gefgu/integration-workshop-3/docs/bench-protocol.md

# Protocolo app do professor ⇄ bancada

Este protocolo define como o app do professor no celular conversa com a bancada.
Ele cobre os requisitos SFR41, SFR43, SFR44, SFR45, SFR56, SFR57, SFR59 e SNFR8.

O código fica em dois lugares, com o mesmo enquadramento e as mesmas mensagens:

- [`protocol/bench.ts`](../protocol/bench.ts), em TypeScript, usado pelo app e pela UI da bancada.
- [`bench/service/protocol.py`](../bench/service/protocol.py), em Python, usado pelo serviço da bancada.

## Transportes

| Transporte | Onde | Status |
|---|---|---|
| **BLE GATT**: serviço `7e1d0001-7ed7-4b1c-9a6e-0c1e5f7a0000` | Bancada real (Raspberry Pi, BlueZ) | Pronto: periférico em [`bench_service/ble.py`](../bench/service/bench_service/ble.py) com `bless`; cliente no app com `react-native-ble-plx` (build de desenvolvimento). |
| **WebSocket** `ws://<bancada>:8765/ble` | Bancada simulada (`bench/service`) | Pronto. Usado no Expo Go e nos testes. |

As características do serviço GATT são estas:

| Característica | UUID | Direção | Propriedade |
|---|---|---|---|
| RX | `7e1d0002-…` | app → bancada | write (com resposta) |
| TX | `7e1d0003-…` | bancada → app | notify |

O nome anunciado é `TedTronics-<bench_id>`, e o anúncio traz o UUID do serviço (o app filtra a busca por ele).
Mantenha o `bench_id` curto (até ~18 caracteres): o nome vai na resposta de varredura, que tem 31 bytes.

Para ligar o BLE junto com o HTTP/WebSocket, no Raspberry Pi:

```
pip install -e '.[ble]'
python -m bench_service --db bench.sqlite3 --ble [--adapter hci0]
```

Os dois transportes rodam no mesmo processo e usam o mesmo `BenchStore`. Um `HELLO` por Bluetooth libera a tela da bancada, e os eventos são os mesmos nos dois caminhos.
Se o adaptador ou o BlueZ falharem, o serviço inteiro para com o erro, em vez de ficar no ar sem Bluetooth.

## Câmera (visão computacional)

O serviço também lê a placa pela câmera com o pacote [`visao/`](../visao/README.md) da Julia. A visão roda numa thread do próprio serviço, a 5 quadros por segundo:

```
pip install -e '.[vision]'
python -m bench_service --db bench.sqlite3 --camera 0            # câmera real
python -m bench_service --db bench.sqlite3 --vision-image foto.jpg  # demonstração com uma foto
```

| Rota | O que devolve |
|---|---|
| `GET /vision/state` | `available`, `valid`/`reason` (último quadro aproveitado ou por que foi descartado), `version` (sobe quando o circuito estável muda), `pieces` no formato de peças das lições e `unknown` (peças que a lição não consegue usar, com o motivo). |
| `GET /vision/frame.jpg` | O quadro da câmera com o desenho de depuração da visão (grade encontrada e peças lidas). |
| `POST /vision/recalibrate` | Recalibra a grade do zero. |

Com a visão ligada, a tela da bancada usa a placa real: o tabuleiro da lição mostra o que a câmera vê, sem a bandeja de peças, e cada mudança é validada como antes.
A tela **Câmera** mostra o quadro anotado e a lista de peças. Sem a visão, ela volta para a prévia da câmera do navegador.

A conversão da visão para as peças das lições fica em [`bench_service/vision.py`](../bench/service/bench_service/vision.py) (`to_pieces`). Limitações atuais:
- o resistor vira `resistor_220`, porque a câmera não lê o valor. Passos que conferem valores não passam;
- a peça vermelha de 2 furos vira a bateria, com o `+` na coluna da esquerda, porque a câmera não lê a polaridade;
- `led_ou_buzzer`, `resistor_ou_capacitor`, o potenciômetro de 3 furos e cores desconhecidas ficam em `unknown`.

## Quadros

Uma mensagem JSON pode passar do MTU. Por isso ela é dividida em quadros de texto ASCII:

```
<msgId>|<índice>|<total>|<fatia do JSON>
```

O JSON é serializado só com ASCII: todo caractere fora do ASCII vira `\uXXXX` (`ensure_ascii=True` no Python, `asciiJson()` no TypeScript).
Assim um caractere é um byte, e cada quadro carrega até 150 caracteres do JSON, o que cabe num MTU de 185 bytes (182 bytes úteis) junto com o cabeçalho.
Sem isso, um texto com acentos passaria de 182 bytes: a notificação seria cortada, e a escrita viraria uma escrita longa, que o `bless` não remonta.

No BLE, cada quadro do app é uma escrita com resposta na RX. A bancada responde com uma notificação na TX por quadro, na ordem.
O app pede MTU 185 ao conectar (`requestMTU`, no Android).
O WebSocket usa exatamente os mesmos quadros, então a demo exercita o mesmo código do BLE.
O receptor remonta a mensagem pelo `msgId`, e quadros de mensagens diferentes podem chegar intercalados.

## Mensagens

Toda mensagem do app traz um `id`. A resposta da bancada repete esse valor em `re`.

| App → bancada | Resposta | O que faz |
|---|---|---|
| `HELLO {token, protocol}` | `WELCOME {...status}` ou `ERROR bad_token` | O `token` vem de `POST /bench/session`: um HMAC assinado pelo servidor com o segredo compartilhado `TEDTRONICS_BENCH_SECRET`. A bancada confere a assinatura e a validade **offline**. Se estiver tudo certo, desbloqueia a sessão (SFR43, SFR57). |
| `STATUS` | `STATUS {...}` | Devolve `bench_id`, se a bancada está desbloqueada, o pacote carregado e quantos eventos estão pendentes. |
| `LOAD_PACKAGE {package}` | `PACKAGE_OK {version_id}` | Recebe o pacote de `GET /bench/package/{módulo}?class_id=`: módulo, documentos das lições com `lessonVersion` e alunos com tag. O pacote novo substitui o anterior. Sessões já abertas continuam na versão em que começaram (SFR58). |
| `PULL_EVENTS {max, after_seq?}` | `EVENTS {events, remaining}` | Devolve até `max` eventos pendentes com `seq > after_seq`, em ordem de `seq` (SFR44). Para paginar, o app envia como `after_seq` o `seq` do último evento recebido. |
| `ACK_EVENTS {event_ids}` | `ACKED {deleted, pending_events}` | A bancada apaga os eventos que o servidor já confirmou. |

Qualquer mensagem que não seja `HELLO`, enviada antes de um `HELLO` válido, recebe `ERROR locked`.

## Evento

```json
{"event_id": "uuid", "student_id": 3, "nfc_code": "TAG-1", "kind": "step_done",
 "seq": 17, "at": "2026-10-20T13:02:11Z", "lesson_id": "l1", "module_id": 2,
 "lesson_version": "a1b2…", "step_idx": 3, "score": null, "duration_s": null}
```

`kind` pode ser um destes valores:

| `kind` | Quando acontece |
|---|---|
| `session` | O aluno saiu. Traz `duration_s`. |
| `step_done` | Um passo foi concluído. |
| `lesson_done` | A lição foi concluída. Traz `duration_s`. |
| `quiz_answer` | O aluno respondeu um quiz. |
| `challenge_score` | O desafio terminou. Traz `score` e `duration_s`. |

Todo evento leva `student_id` **e** `nfc_code` juntos, nunca só a tag (SNFR8).

## Ciclo de sincronização

1. No app, o professor faz login. O app chama `POST /bench/session` e recebe o token da bancada.
2. O app conecta na bancada e envia `HELLO`. A bancada se desbloqueia.
3. O app envia `PULL_EVENTS` e guarda os eventos recebidos na fila local.
4. Com internet, o app envia a fila para `POST /bench/sync`. O servidor responde `acked`.
5. O app envia `ACK_EVENTS` com os ids confirmados. A bancada apaga esses eventos.
6. Sem internet, a fila fica marcada como "pendente" e o app tenta de novo quando a rede voltar (SFR45, SNFR9).
   A bancada só apaga um evento depois do `ACK_EVENTS`. Se a conexão cair no meio, o pior que acontece é reenviar eventos, e o servidor descarta as duplicatas pelo `event_id` (SFR59).
7. Se quiser, o professor escolhe um módulo e uma turma, e o app envia `LOAD_PACKAGE`.

## Physical controls on the bench screen

The student never touches the 7" screen: they build on the real protoboard (read by the camera, see above) and use
the bench's physical controls: an analog joystick (KY-023) and an Energizar push button, both on an ESP32 that talks
to the Pi over the GPIO serial port (`/dev/serial0`, 115200 8N1). The firmware is
[`firmware/esp32/bench_controls`](../firmware/esp32/bench_controls/README.md); the bench service reads the port
(`--controls /dev/serial0`, `bench_service/controls.py`) and pushes each press to the screen on
`ws://<bench>:8765/controls`, where it is replayed as a key press:

The screen is played like a game console (`teacher_authoring_app/src/bench/pad.ts`): each control is tagged
with what it means (`data-pad="item" | "next" | "back" | "step-back" | "energize"`), and the joystick acts on that
meaning instead of walking through every button. Screens only show Voltar, Próximo/Continuar, Pular and their
choices; sound, help, ranking, camera and leaving live in a game menu.

| Physical control | Serial line | Key | What it does on screen |
|---|---|---|---|
| Joystick right / up | `KEY <id> RIGHT` / `UP` | `ArrowRight` / `ArrowUp` | Forward: next step, or the next choice in a list |
| Joystick left / down | `KEY <id> LEFT` / `DOWN` | `ArrowLeft` / `ArrowDown` | Back: previous step (left also leaves the screen), or the previous choice |
| Joystick click | `KEY <id> OK` | Space | Confirm the selected choice (inside a lesson only the quiz uses it) |
| Joystick click held 0.8 s | `KEY <id> MENU` | `Escape` | Open / close the game menu (sound, help, ranking, camera, leave) |
| Energizar button | `KEY <id> ENERGIZAR` | `Enter` | Power the board on or off; for now the PC keyboard's Enter |

The Pi answers every `KEY` with `ACK <id>` and checks the link with `PING <n>` / `PONG <n>` every 2 s. A keyboard
still works the same way, so the screen can be tested without the hardware (`POST /dev/controls/<name>` in demo mode
simulates a serial line).

With the camera on, the lesson board only mirrors the real board (no dragging) and the tray lists the parts the
current step asks for; the other parts are greyed out. Without a camera the board falls back to on-screen dragging
(demo mode).
