gefgu/integration-workshop-3/docs/Budget.md

# BOM 💵

Bill of materials for TedTronics. Prices in BRL.

# Budget — Workshop 3

## Items

| Item | Quantity | Unit Price (R$) | Total Price (R$) | Description | Link |
| :--- | :---: | ---: | ---: | :--- | :--- |
| PLA 3D Prints | 2 | 75.00 | 150.00 | Material used to manufacture the modules, supports, and structural parts of the bench. | In-house fabrication |
| Raspberry Pi 3B | 1 | 136.87 | 136.87 | Main computer of the bench, responsible for the interface, processing, and execution of the system applications. | [AliExpress](https://pt.aliexpress.com/item/32947198819.html) |
| ESP32 38-Pin | 1 | 10.13 | 10.13 | Microcontroller responsible for controlling the switching matrix and communicating with the electronic circuits. | [AliExpress](https://pt.aliexpress.com/item/1005006984793820.html) |
| 7-Inch Display | 1 | 157.34 | 157.34 | Display used to show lessons, challenges, simulations, and information from the virtual tutor. | [AliExpress](https://pt.aliexpress.com/item/1005007432461342.html) |
| 1080p Webcam | 1 | 36.98 | 36.98 | Camera used to capture the student's assembly and enable visual identification of components and connections. | [Mercado Livre](https://www.mercadolivre.com.br/webcam-camera-full-hd-zoom-1080p-360-graus-videoconferencia-streamcam-web-cam-entrada-usb-20-com-microfone-goodvision/p/MLB46220824) |
| Push Buttons | 2 | 8.44 | 16.88 | Physical buttons used in the bench control interface. | [AliExpress](https://pt.aliexpress.com/item/1005006787416121.html) |
| Joystick | 1 | 8.44 | 8.44 | Navigation device used by the student to interact with the bench interface. | [AliExpress](https://pt.aliexpress.com/item/1005008093342854.html) |
| CH446Q | 5 | 7.83 | 39.15 | Analog switch matrix used to electronically create connections between the bench nodes. | [AliExpress](https://pt.aliexpress.com/item/1005009485681569.html) |
| Mini 3 W Speaker SP-301BK | 1 | 31.90 | Audio output used by the virtual tutor and the bench interface. | [Kalunga](https://www.kalunga.com.br/prod/caixa-de-som-3w-mini-sp-301bk-3040206201-c3tech-cx-1-un/145898) |
| PCB | 2 | 200.00 | 400.00 | Printed circuit boards for the bench contacts and for the electronic control and routing system. | - |
| Real Electronic Components | 1 | 50.00 | 50.00 | Set of LEDs, capacitors, buttons, buzzers, resistors, and other components used in the educational modules. | - |
| LM2596 Step-Down Voltage Regulator Module | 1 | 8.90 | 8.90 | Converter responsible for reducing 12 V to 5 V for the educational circuit. | [Eletrogate](https://www.eletrogate.com/modulo-regulador-de-tensao-step-down-lm2596) |
| MF-R050 Polyfuse | 1 | 1.26 | 1.26 | Resettable fuse used to protect the board against overcurrent. | [Mouser](https://br.mouser.com/pt/ProductDetail/Bourns/MF-R050?qs=A6omU7D3gEWzJRzbTsuTwA%3D%3D) |
| SS34 Schottky Diode | 1 | 9.60 | 9.60 | Diode used to protect the power input against reverse polarity. | [Mercado Livre](https://www.mercadolivre.com.br/10x-diodo-schottky-ss34-s4-14-smd-3amp-40v-smc-do214ab/p/MLB2062650491) |
| 100 nF Capacitor | 3 | 0.13 | 0.39 | Decoupling capacitors placed near integrated circuits to reduce power-supply noise. | [Baú da Eletrônica](https://www.baudaeletronica.com.br/produto/capacitor-ceramico-100nf-50v.html) |
| 1 µF Capacitor | 3 | 0.17 | 0.51 | Capacitors used for local filtering of the integrated circuits' power supply. | [Proesi](https://www.proesi.com.br/capacitor-ceramico-1uf-50v-0805-smd) |
| 100 µF / 25 V Capacitor | 1 | 0.20 | 0.20 | Capacitor used for main filtering of the 12 V power input. | [Baú da Eletrônica](https://www.baudaeletronica.com.br/produto/capacitor-eletrolitico-100uf-25v-105c.html) |
| 12 V Power Supply | 1 | 7.33 | 7.33 | Power supply used to power the CH446Q chips and the educational circuit power stage. | [Mercado Livre](https://www.mercadolivre.com.br/fonte-de-fita-led-alimentacao-2a-12v-bivolt/p/MLB2071189997) |
| DC-005 Female P4 Jack Connector | 1 | 0.60 | 0.60 | Input connector used to connect the external 12 V power supply to the electronic board. | [Eletrogate](https://www.eletrogate.com/conector-jack-p4-femea-j4-21mm) |
| **Total** |  |  | **1,066.48** |  |  |

---

## Budget Summary

| Metric | Amount (R$) |
| :--- | ---: |
| **Total Expenses** | **1,066.48** |
| **Available Budget** | **1,200.00** |
| **Remaining Available Budget** | **133.52** |
| **Maximum Budget** | **1,500.00** |
| **Remaining Margin to Maximum Budget** | **433.52** |
