gefgu/integration-workshop-3/eletronics/perfboard/cp00-first-light.md

# Historical checkpoint filename

New builds follow the [guided sequence](cp00.md) in the [assembly app](tscircuit/README.md). Existing project catalogs retain their old checkpoint meaning; this filename does not migrate their progress.
