gefgu/integration-workshop-3/eletronics/perfboard/cp00.md

# CP00 — First light

**Win:** ESP32 switches the real four-column LED loop.

Build the assigned functional groups in the [assembly app](tscircuit/README.md). Earlier soldered wiring stays fixed. Removable links and top-side kit arrangements may change.

## Link positions

- Prototype source only: positive C2 / ground C1; final supply and matrix disconnected.
- OLED uses ESP1 GPIO4 SDA / GPIO16 SCL at 3.3V. Remove diagnostic probes before ordinary operation.

## Guided actions

1. **Disconnect power and prepare:** Unplug USB and all educational sources before construction. Prototype source only: positive C2 / ground C1; final supply and matrix disconnected. OLED uses ESP1 GPIO4 SDA / GPIO16 SCL at 3.3V. Remove diagnostic probes before ordinary operation.
2. **Identify your hardware:** Confirm ESP32 DevKit model and labelled USB5V/3V3/GND/GPIO32 terminals. Identify the breadboard’s a–e / f–j connected rows and any broken supply rails. Measure actual pogo and adapter fit before permanent soldering.
3. **Place NODE00 — all 6 contacts:** Place every contact in this column at the TOP coordinates listed below. These contacts form one electrical node; keep neighbouring columns isolated.
4. **Inspect J_NODE00:** Power OFF: inspect every terminal, polarity, seating and solder joint. J_NODE00: node00; NODE00 — six contacts. Part of Educational contacts — one node per column. Mount on the top side; red pad identifies pin 1. Actual purchased dimensions must be measured before release.
5. **Place NODE01 — all 6 contacts:** Place every contact in this column at the TOP coordinates listed below. These contacts form one electrical node; keep neighbouring columns isolated.
6. **Inspect J_NODE01:** Power OFF: inspect every terminal, polarity, seating and solder joint. J_NODE01: node01; NODE01 — six contacts. Part of Educational contacts — one node per column. Mount on the top side; red pad identifies pin 1. Actual purchased dimensions must be measured before release.
7. **Place NODE02 — all 6 contacts:** Place every contact in this column at the TOP coordinates listed below. These contacts form one electrical node; keep neighbouring columns isolated.
8. **Inspect J_NODE02:** Power OFF: inspect every terminal, polarity, seating and solder joint. J_NODE02: node02; NODE02 — six contacts. Part of Educational contacts — one node per column. Mount on the top side; red pad identifies pin 1. Actual purchased dimensions must be measured before release.
9. **Place NODE03 — all 6 contacts:** Place every contact in this column at the TOP coordinates listed below. These contacts form one electrical node; keep neighbouring columns isolated.
10. **Inspect J_NODE03:** Power OFF: inspect every terminal, polarity, seating and solder joint. J_NODE03: node03; NODE03 — six contacts. Part of Educational contacts — one node per column. Mount on the top side; red pad identifies pin 1. Actual purchased dimensions must be measured before release.
11. **Place J_NODE:** J_NODE: node; NODE cable → matrix. Part of Capsule OLED service. Mount on the bottom side; red pad identifies pin 1. 
12. **Inspect J_NODE:** Power OFF: inspect every terminal, polarity, seating and solder joint. J_NODE: node; NODE cable → matrix. Part of Capsule OLED service. Mount on the bottom side; red pad identifies pin 1. 
13. **Connect W1 · NODE00:** Educational contact or routing bus; the wire joins only its listed terminals, not crossing wires. Connect J_NODE00.1 → J_NODE00.2. Hole path (4,9) → (4,13). Bare strap joins only this column.
14. **Verify W1 · NODE00:** Power disconnected: Educational contact or routing bus; the wire joins only its listed terminals, not crossing wires. Connect J_NODE00.1 → J_NODE00.2. Hole path (4,9) → (4,13). Bare strap joins only this column. Confirm endpoint continuity (<1Ω for a wire) and no adjacent-net bridge; isolate parallel paths before measuring.
15. **Connect W2 · NODE00:** Educational contact or routing bus; the wire joins only its listed terminals, not crossing wires. Connect J_NODE00.2 → J_NODE00.3. Hole path (4,13) → (4,17). Bare strap joins only this column.
16. **Verify W2 · NODE00:** Power disconnected: Educational contact or routing bus; the wire joins only its listed terminals, not crossing wires. Connect J_NODE00.2 → J_NODE00.3. Hole path (4,13) → (4,17). Bare strap joins only this column. Confirm endpoint continuity (<1Ω for a wire) and no adjacent-net bridge; isolate parallel paths before measuring.
17. **Connect W3 · NODE00:** Educational contact or routing bus; the wire joins only its listed terminals, not crossing wires. Connect J_NODE00.3 → J_NODE00.4. Hole path (4,17) → (4,21). Bare strap joins only this column.
18. **Verify W3 · NODE00:** Power disconnected: Educational contact or routing bus; the wire joins only its listed terminals, not crossing wires. Connect J_NODE00.3 → J_NODE00.4. Hole path (4,17) → (4,21). Bare strap joins only this column. Confirm endpoint continuity (<1Ω for a wire) and no adjacent-net bridge; isolate parallel paths before measuring.
19. **Connect W4 · NODE00:** Educational contact or routing bus; the wire joins only its listed terminals, not crossing wires. Connect J_NODE00.4 → J_NODE00.5. Hole path (4,21) → (4,25). Bare strap joins only this column.
20. **Verify W4 · NODE00:** Power disconnected: Educational contact or routing bus; the wire joins only its listed terminals, not crossing wires. Connect J_NODE00.4 → J_NODE00.5. Hole path (4,21) → (4,25). Bare strap joins only this column. Confirm endpoint continuity (<1Ω for a wire) and no adjacent-net bridge; isolate parallel paths before measuring.
21. **Connect W5 · NODE00:** Educational contact or routing bus; the wire joins only its listed terminals, not crossing wires. Connect J_NODE00.5 → J_NODE00.6. Hole path (4,25) → (4,29). Bare strap joins only this column.
22. **Verify W5 · NODE00:** Power disconnected: Educational contact or routing bus; the wire joins only its listed terminals, not crossing wires. Connect J_NODE00.5 → J_NODE00.6. Hole path (4,25) → (4,29). Bare strap joins only this column. Confirm endpoint continuity (<1Ω for a wire) and no adjacent-net bridge; isolate parallel paths before measuring.
23. **Connect W6 · NODE00:** Educational contact or routing bus; the wire joins only its listed terminals, not crossing wires. Connect J_NODE00.1 → J_NODE.1. Hole path (4,9) → (4,8.5) → (3.5,8.5) → (3.5,33.5) → (3,33.5) → (3,33). Insulate every crossing; solder only the two endpoints.
24. **Verify W6 · NODE00:** Power disconnected: Educational contact or routing bus; the wire joins only its listed terminals, not crossing wires. Connect J_NODE00.1 → J_NODE.1. Hole path (4,9) → (4,8.5) → (3.5,8.5) → (3.5,33.5) → (3,33.5) → (3,33). Insulate every crossing; solder only the two endpoints. Confirm endpoint continuity (<1Ω for a wire) and no adjacent-net bridge; isolate parallel paths before measuring.
25. **Connect W8 · NODE01:** Educational contact or routing bus; the wire joins only its listed terminals, not crossing wires. Connect J_NODE01.1 → J_NODE01.2. Hole path (11,9) → (11,13). Bare strap joins only this column.
26. **Verify W8 · NODE01:** Power disconnected: Educational contact or routing bus; the wire joins only its listed terminals, not crossing wires. Connect J_NODE01.1 → J_NODE01.2. Hole path (11,9) → (11,13). Bare strap joins only this column. Confirm endpoint continuity (<1Ω for a wire) and no adjacent-net bridge; isolate parallel paths before measuring.
27. **Connect W9 · NODE01:** Educational contact or routing bus; the wire joins only its listed terminals, not crossing wires. Connect J_NODE01.2 → J_NODE01.3. Hole path (11,13) → (11,17). Bare strap joins only this column.
28. **Verify W9 · NODE01:** Power disconnected: Educational contact or routing bus; the wire joins only its listed terminals, not crossing wires. Connect J_NODE01.2 → J_NODE01.3. Hole path (11,13) → (11,17). Bare strap joins only this column. Confirm endpoint continuity (<1Ω for a wire) and no adjacent-net bridge; isolate parallel paths before measuring.
29. **Connect W10 · NODE01:** Educational contact or routing bus; the wire joins only its listed terminals, not crossing wires. Connect J_NODE01.3 → J_NODE01.4. Hole path (11,17) → (11,21). Bare strap joins only this column.
30. **Verify W10 · NODE01:** Power disconnected: Educational contact or routing bus; the wire joins only its listed terminals, not crossing wires. Connect J_NODE01.3 → J_NODE01.4. Hole path (11,17) → (11,21). Bare strap joins only this column. Confirm endpoint continuity (<1Ω for a wire) and no adjacent-net bridge; isolate parallel paths before measuring.
31. **Connect W11 · NODE01:** Educational contact or routing bus; the wire joins only its listed terminals, not crossing wires. Connect J_NODE01.4 → J_NODE01.5. Hole path (11,21) → (11,25). Bare strap joins only this column.
32. **Verify W11 · NODE01:** Power disconnected: Educational contact or routing bus; the wire joins only its listed terminals, not crossing wires. Connect J_NODE01.4 → J_NODE01.5. Hole path (11,21) → (11,25). Bare strap joins only this column. Confirm endpoint continuity (<1Ω for a wire) and no adjacent-net bridge; isolate parallel paths before measuring.
33. **Connect W12 · NODE01:** Educational contact or routing bus; the wire joins only its listed terminals, not crossing wires. Connect J_NODE01.5 → J_NODE01.6. Hole path (11,25) → (11,29). Bare strap joins only this column.
34. **Verify W12 · NODE01:** Power disconnected: Educational contact or routing bus; the wire joins only its listed terminals, not crossing wires. Connect J_NODE01.5 → J_NODE01.6. Hole path (11,25) → (11,29). Bare strap joins only this column. Confirm endpoint continuity (<1Ω for a wire) and no adjacent-net bridge; isolate parallel paths before measuring.
35. **Connect W13 · NODE01:** Educational contact or routing bus; the wire joins only its listed terminals, not crossing wires. Connect J_NODE01.1 → J_NODE.3. Hole path (11,9) → (11,8.5) → (8,8.5) → (8,33.5) → (4,33.5) → (4,33). Insulate every crossing; solder only the two endpoints.
36. **Verify W13 · NODE01:** Power disconnected: Educational contact or routing bus; the wire joins only its listed terminals, not crossing wires. Connect J_NODE01.1 → J_NODE.3. Hole path (11,9) → (11,8.5) → (8,8.5) → (8,33.5) → (4,33.5) → (4,33). Insulate every crossing; solder only the two endpoints. Confirm endpoint continuity (<1Ω for a wire) and no adjacent-net bridge; isolate parallel paths before measuring.
37. **Connect W15 · NODE02:** Educational contact or routing bus; the wire joins only its listed terminals, not crossing wires. Connect J_NODE02.1 → J_NODE02.2. Hole path (18,9) → (18,13). Bare strap joins only this column.
38. **Verify W15 · NODE02:** Power disconnected: Educational contact or routing bus; the wire joins only its listed terminals, not crossing wires. Connect J_NODE02.1 → J_NODE02.2. Hole path (18,9) → (18,13). Bare strap joins only this column. Confirm endpoint continuity (<1Ω for a wire) and no adjacent-net bridge; isolate parallel paths before measuring.
39. **Connect W16 · NODE02:** Educational contact or routing bus; the wire joins only its listed terminals, not crossing wires. Connect J_NODE02.2 → J_NODE02.3. Hole path (18,13) → (18,17). Bare strap joins only this column.
40. **Verify W16 · NODE02:** Power disconnected: Educational contact or routing bus; the wire joins only its listed terminals, not crossing wires. Connect J_NODE02.2 → J_NODE02.3. Hole path (18,13) → (18,17). Bare strap joins only this column. Confirm endpoint continuity (<1Ω for a wire) and no adjacent-net bridge; isolate parallel paths before measuring.
41. **Connect W17 · NODE02:** Educational contact or routing bus; the wire joins only its listed terminals, not crossing wires. Connect J_NODE02.3 → J_NODE02.4. Hole path (18,17) → (18,21). Bare strap joins only this column.
42. **Verify W17 · NODE02:** Power disconnected: Educational contact or routing bus; the wire joins only its listed terminals, not crossing wires. Connect J_NODE02.3 → J_NODE02.4. Hole path (18,17) → (18,21). Bare strap joins only this column. Confirm endpoint continuity (<1Ω for a wire) and no adjacent-net bridge; isolate parallel paths before measuring.
43. **Connect W18 · NODE02:** Educational contact or routing bus; the wire joins only its listed terminals, not crossing wires. Connect J_NODE02.4 → J_NODE02.5. Hole path (18,21) → (18,25). Bare strap joins only this column.
44. **Verify W18 · NODE02:** Power disconnected: Educational contact or routing bus; the wire joins only its listed terminals, not crossing wires. Connect J_NODE02.4 → J_NODE02.5. Hole path (18,21) → (18,25). Bare strap joins only this column. Confirm endpoint continuity (<1Ω for a wire) and no adjacent-net bridge; isolate parallel paths before measuring.
45. **Connect W19 · NODE02:** Educational contact or routing bus; the wire joins only its listed terminals, not crossing wires. Connect J_NODE02.5 → J_NODE02.6. Hole path (18,25) → (18,29). Bare strap joins only this column.
46. **Verify W19 · NODE02:** Power disconnected: Educational contact or routing bus; the wire joins only its listed terminals, not crossing wires. Connect J_NODE02.5 → J_NODE02.6. Hole path (18,25) → (18,29). Bare strap joins only this column. Confirm endpoint continuity (<1Ω for a wire) and no adjacent-net bridge; isolate parallel paths before measuring.
47. **Connect W20 · NODE02:** Educational contact or routing bus; the wire joins only its listed terminals, not crossing wires. Connect J_NODE02.1 → J_NODE.5. Hole path (18,9) → (18,8.5) → (12.5,8.5) → (12.5,33.5) → (5,33.5) → (5,33). Insulate every crossing; solder only the two endpoints.
48. **Verify W20 · NODE02:** Power disconnected: Educational contact or routing bus; the wire joins only its listed terminals, not crossing wires. Connect J_NODE02.1 → J_NODE.5. Hole path (18,9) → (18,8.5) → (12.5,8.5) → (12.5,33.5) → (5,33.5) → (5,33). Insulate every crossing; solder only the two endpoints. Confirm endpoint continuity (<1Ω for a wire) and no adjacent-net bridge; isolate parallel paths before measuring.
49. **Connect W22 · NODE03:** Educational contact or routing bus; the wire joins only its listed terminals, not crossing wires. Connect J_NODE03.1 → J_NODE03.2. Hole path (25,9) → (25,13). Bare strap joins only this column.
50. **Verify W22 · NODE03:** Power disconnected: Educational contact or routing bus; the wire joins only its listed terminals, not crossing wires. Connect J_NODE03.1 → J_NODE03.2. Hole path (25,9) → (25,13). Bare strap joins only this column. Confirm endpoint continuity (<1Ω for a wire) and no adjacent-net bridge; isolate parallel paths before measuring.
51. **Connect W23 · NODE03:** Educational contact or routing bus; the wire joins only its listed terminals, not crossing wires. Connect J_NODE03.2 → J_NODE03.3. Hole path (25,13) → (25,17). Bare strap joins only this column.
52. **Verify W23 · NODE03:** Power disconnected: Educational contact or routing bus; the wire joins only its listed terminals, not crossing wires. Connect J_NODE03.2 → J_NODE03.3. Hole path (25,13) → (25,17). Bare strap joins only this column. Confirm endpoint continuity (<1Ω for a wire) and no adjacent-net bridge; isolate parallel paths before measuring.
53. **Connect W24 · NODE03:** Educational contact or routing bus; the wire joins only its listed terminals, not crossing wires. Connect J_NODE03.3 → J_NODE03.4. Hole path (25,17) → (25,21). Bare strap joins only this column.
54. **Verify W24 · NODE03:** Power disconnected: Educational contact or routing bus; the wire joins only its listed terminals, not crossing wires. Connect J_NODE03.3 → J_NODE03.4. Hole path (25,17) → (25,21). Bare strap joins only this column. Confirm endpoint continuity (<1Ω for a wire) and no adjacent-net bridge; isolate parallel paths before measuring.
55. **Connect W25 · NODE03:** Educational contact or routing bus; the wire joins only its listed terminals, not crossing wires. Connect J_NODE03.4 → J_NODE03.5. Hole path (25,21) → (25,25). Bare strap joins only this column.
56. **Verify W25 · NODE03:** Power disconnected: Educational contact or routing bus; the wire joins only its listed terminals, not crossing wires. Connect J_NODE03.4 → J_NODE03.5. Hole path (25,21) → (25,25). Bare strap joins only this column. Confirm endpoint continuity (<1Ω for a wire) and no adjacent-net bridge; isolate parallel paths before measuring.
57. **Connect W26 · NODE03:** Educational contact or routing bus; the wire joins only its listed terminals, not crossing wires. Connect J_NODE03.5 → J_NODE03.6. Hole path (25,25) → (25,29). Bare strap joins only this column.
58. **Verify W26 · NODE03:** Power disconnected: Educational contact or routing bus; the wire joins only its listed terminals, not crossing wires. Connect J_NODE03.5 → J_NODE03.6. Hole path (25,25) → (25,29). Bare strap joins only this column. Confirm endpoint continuity (<1Ω for a wire) and no adjacent-net bridge; isolate parallel paths before measuring.
59. **Connect W27 · NODE03:** Educational contact or routing bus; the wire joins only its listed terminals, not crossing wires. Connect J_NODE03.1 → J_NODE.7. Hole path (25,9) → (25,8.5) → (15.5,8.5) → (15.5,33.5) → (6,33.5) → (6,33). Insulate every crossing; solder only the two endpoints.
60. **Verify W27 · NODE03:** Power disconnected: Educational contact or routing bus; the wire joins only its listed terminals, not crossing wires. Connect J_NODE03.1 → J_NODE.7. Hole path (25,9) → (25,8.5) → (15.5,8.5) → (15.5,33.5) → (6,33.5) → (6,33). Insulate every crossing; solder only the two endpoints. Confirm endpoint continuity (<1Ω for a wire) and no adjacent-net bridge; isolate parallel paths before measuring.
61. **Place U_ESP1:** U_ESP1: esp1; ESP32 DevKitC-38 — router. Part of ESP1 and safe default routing control. Mount on the top side; red pad identifies pin 1. Actual purchased dimensions must be measured before release.
62. **Inspect U_ESP1:** Power OFF: inspect every terminal, polarity, seating and solder joint. U_ESP1: esp1; ESP32 DevKitC-38 — router. Part of ESP1 and safe default routing control. Mount on the top side; red pad identifies pin 1. Actual purchased dimensions must be measured before release.
63. **Place J_FIXTURE:** J_FIXTURE: fixture; manual continuity fixture; ESP1 GPIO4 SDA / GPIO16 SCL / GPIO25 stimulus. Part of ESP1 and safe default routing control. Mount on the top side; red pad identifies pin 1. 
64. **Inspect J_FIXTURE:** Power OFF: inspect every terminal, polarity, seating and solder joint. J_FIXTURE: fixture; manual continuity fixture; ESP1 GPIO4 SDA / GPIO16 SCL / GPIO25 stimulus. Part of ESP1 and safe default routing control. Mount on the top side; red pad identifies pin 1. 
65. **Place J_PROTOTYPE:** J_PROTOTYPE: prototype; USB breadboard prototype; remove before final rail connection. Part of ESP1 and safe default routing control. Mount on the top side; red pad identifies pin 1. 
66. **Inspect J_PROTOTYPE:** Power OFF: inspect every terminal, polarity, seating and solder joint. J_PROTOTYPE: prototype; USB breadboard prototype; remove before final rail connection. Part of ESP1 and safe default routing control. Mount on the top side; red pad identifies pin 1. 
67. **Connect W1 · USB_3V3:** 3.3-V electronics supply. USB and bench supply domains must not be bridged. Connect J_FIXTURE.1 → J_PROTOTYPE.2. Hole path (30,6) → (30,5.5) → (33.5,5.5) → (33.5,6.5) → (38,6.5) → (38,6). Insulate every crossing; solder only the two endpoints.
68. **Verify W1 · USB_3V3:** Power disconnected: 3.3-V electronics supply. USB and bench supply domains must not be bridged. Connect J_FIXTURE.1 → J_PROTOTYPE.2. Hole path (30,6) → (30,5.5) → (33.5,5.5) → (33.5,6.5) → (38,6.5) → (38,6). Insulate every crossing; solder only the two endpoints. Confirm endpoint continuity (<1Ω for a wire) and no adjacent-net bridge; isolate parallel paths before measuring.
69. **Connect W2 · USB_3V3:** 3.3-V electronics supply. USB and bench supply domains must not be bridged. Connect J_FIXTURE.1 → U_ESP1.1. Hole path (30,6) → (30,5.5) → (17.5,5.5) → (17.5,7.5) → (6,7.5) → (6,7). Insulate every crossing; solder only the two endpoints.
70. **Verify W2 · USB_3V3:** Power disconnected: 3.3-V electronics supply. USB and bench supply domains must not be bridged. Connect J_FIXTURE.1 → U_ESP1.1. Hole path (30,6) → (30,5.5) → (17.5,5.5) → (17.5,7.5) → (6,7.5) → (6,7). Insulate every crossing; solder only the two endpoints. Confirm endpoint continuity (<1Ω for a wire) and no adjacent-net bridge; isolate parallel paths before measuring.
71. **Connect W13 · GND:** Common electrical reference and return; keep student, USB and service ground identities consistent. Connect J_FIXTURE.2 → J_PROTOTYPE.3. Hole path (31,6) → (31,5.5) → (35,5.5) → (35,6.5) → (39,6.5) → (39,6). Insulate every crossing; solder only the two endpoints.
72. **Verify W13 · GND:** Power disconnected: Common electrical reference and return; keep student, USB and service ground identities consistent. Connect J_FIXTURE.2 → J_PROTOTYPE.3. Hole path (31,6) → (31,5.5) → (35,5.5) → (35,6.5) → (39,6.5) → (39,6). Insulate every crossing; solder only the two endpoints. Confirm endpoint continuity (<1Ω for a wire) and no adjacent-net bridge; isolate parallel paths before measuring.
73. **Connect W14 · GND:** Common electrical reference and return; keep student, USB and service ground identities consistent. Connect J_FIXTURE.2 → U_ESP1.14. Hole path (31,6) → (31,5.5) → (19,5.5) → (19,20.5) → (6,20.5) → (6,20). Insulate every crossing; solder only the two endpoints.
74. **Verify W14 · GND:** Power disconnected: Common electrical reference and return; keep student, USB and service ground identities consistent. Connect J_FIXTURE.2 → U_ESP1.14. Hole path (31,6) → (31,5.5) → (19,5.5) → (19,20.5) → (6,20.5) → (6,20). Insulate every crossing; solder only the two endpoints. Confirm endpoint continuity (<1Ω for a wire) and no adjacent-net bridge; isolate parallel paths before measuring.
75. **Connect W15 · GND:** Common electrical reference and return; keep student, USB and service ground identities consistent. Connect J_FIXTURE.2 → U_ESP1.20. Hole path (31,6) → (31,5.5) → (24,5.5) → (24,7.5) → (16,7.5) → (16,7). Insulate every crossing; solder only the two endpoints.
76. **Verify W15 · GND:** Power disconnected: Common electrical reference and return; keep student, USB and service ground identities consistent. Connect J_FIXTURE.2 → U_ESP1.20. Hole path (31,6) → (31,5.5) → (24,5.5) → (24,7.5) → (16,7.5) → (16,7). Insulate every crossing; solder only the two endpoints. Confirm endpoint continuity (<1Ω for a wire) and no adjacent-net bridge; isolate parallel paths before measuring.
77. **Connect W16 · GND:** Common electrical reference and return; keep student, USB and service ground identities consistent. Connect J_FIXTURE.2 → U_ESP1.26. Hole path (31,6) → (31,5.5) → (24,5.5) → (24,13.5) → (16,13.5) → (16,13). Insulate every crossing; solder only the two endpoints.
78. **Verify W16 · GND:** Power disconnected: Common electrical reference and return; keep student, USB and service ground identities consistent. Connect J_FIXTURE.2 → U_ESP1.26. Hole path (31,6) → (31,5.5) → (24,5.5) → (24,13.5) → (16,13.5) → (16,13). Insulate every crossing; solder only the two endpoints. Confirm endpoint continuity (<1Ω for a wire) and no adjacent-net bridge; isolate parallel paths before measuring.
79. **Connect W78 · EDU_PWR_EN:** Protection, reset or readiness control; its defined polarity must preserve OFF at startup and on faults. Connect J_PROTOTYPE.4 → U_ESP1.7. Hole path (40,6) → (40,5.5) → (22.5,5.5) → (22.5,13.5) → (6,13.5) → (6,13). Insulate every crossing; solder only the two endpoints.
80. **Verify W78 · EDU_PWR_EN:** Power disconnected: Protection, reset or readiness control; its defined polarity must preserve OFF at startup and on faults. Connect J_PROTOTYPE.4 → U_ESP1.7. Hole path (40,6) → (40,5.5) → (22.5,5.5) → (22.5,13.5) → (6,13.5) → (6,13). Insulate every crossing; solder only the two endpoints. Confirm endpoint continuity (<1Ω for a wire) and no adjacent-net bridge; isolate parallel paths before measuring.
81. **Connect W85 · FIX_SDA:** I2C service signal. Maintain separate per-position SDA paths and do not join buffer B sides. Connect J_FIXTURE.3 → U_ESP1.32. Hole path (32,6) → (32,5.5) → (24.5,5.5) → (24.5,19.5) → (16,19.5) → (16,19). Insulate every crossing; solder only the two endpoints.
82. **Verify W85 · FIX_SDA:** Power disconnected: I2C service signal. Maintain separate per-position SDA paths and do not join buffer B sides. Connect J_FIXTURE.3 → U_ESP1.32. Hole path (32,6) → (32,5.5) → (24.5,5.5) → (24.5,19.5) → (16,19.5) → (16,19). Insulate every crossing; solder only the two endpoints. Confirm endpoint continuity (<1Ω for a wire) and no adjacent-net bridge; isolate parallel paths before measuring.
83. **Connect W86 · FIX_SCL:** I2C service signal. Maintain separate per-position SDA paths and do not join buffer B sides. Connect J_FIXTURE.4 → U_ESP1.31. Hole path (33,6) → (33,5.5) → (24.5,5.5) → (24.5,18.5) → (16,18.5) → (16,18). Insulate every crossing; solder only the two endpoints.
84. **Verify W86 · FIX_SCL:** Power disconnected: I2C service signal. Maintain separate per-position SDA paths and do not join buffer B sides. Connect J_FIXTURE.4 → U_ESP1.31. Hole path (33,6) → (33,5.5) → (24.5,5.5) → (24.5,18.5) → (16,18.5) → (16,18). Insulate every crossing; solder only the two endpoints. Confirm endpoint continuity (<1Ω for a wire) and no adjacent-net bridge; isolate parallel paths before measuring.
85. **Connect W87 · FIX_STIM:** Manual continuity fixture connection; use only with student power OFF and disconnect stimulus before operation. Connect J_FIXTURE.5 → U_ESP1.9. Hole path (34,6) → (34,5.5) → (20,5.5) → (20,15.5) → (6,15.5) → (6,15). Insulate every crossing; solder only the two endpoints.
86. **Verify W87 · FIX_STIM:** Power disconnected: Manual continuity fixture connection; use only with student power OFF and disconnect stimulus before operation. Connect J_FIXTURE.5 → U_ESP1.9. Hole path (34,6) → (34,5.5) → (20,5.5) → (20,15.5) → (6,15.5) → (6,15). Insulate every crossing; solder only the two endpoints. Confirm endpoint continuity (<1Ω for a wire) and no adjacent-net bridge; isolate parallel paths before measuring.
87. **Connect W88 · USB_5V:** Logic supply or current-protection path; verify the named supply domain and current direction. Connect J_PROTOTYPE.1 → U_ESP1.19. Hole path (37,6) → (37,5.5) → (22.5,5.5) → (22.5,25.5) → (6,25.5) → (6,25). Insulate every crossing; solder only the two endpoints.
88. **Verify W88 · USB_5V:** Power disconnected: Logic supply or current-protection path; verify the named supply domain and current direction. Connect J_PROTOTYPE.1 → U_ESP1.19. Hole path (37,6) → (37,5.5) → (22.5,5.5) → (22.5,25.5) → (6,25.5) → (6,25). Insulate every crossing; solder only the two endpoints. Confirm endpoint continuity (<1Ω for a wire) and no adjacent-net bridge; isolate parallel paths before measuring.
89. **Place J_CONTROL:** J_CONTROL: control; Four individual flying leads from ESP1 prototype header. Part of Default-OFF USB switch and bounded LED test source. Mount on the top side; red pad identifies pin 1. Actual purchased dimensions must be measured before release. Breadboard terminals: USB_5V=j2, USB_3V3=j3, GND=j4, EDU_PWR_EN=j5. These are individual flying leads for headers, not a rigid plug.
90. **Inspect J_CONTROL:** Power OFF: inspect every terminal, polarity, seating and solder joint. J_CONTROL: control; Four individual flying leads from ESP1 prototype header. Part of Default-OFF USB switch and bounded LED test source. Mount on the top side; red pad identifies pin 1. Actual purchased dimensions must be measured before release. Breadboard terminals: USB_5V=j2, USB_3V3=j3, GND=j4, EDU_PWR_EN=j5. These are individual flying leads for headers, not a rigid plug.
91. **Place Q_PASS:** Q_PASS: pass; USB high-side switch. Part of Default-OFF USB switch and bounded LED test source. Mount on the top side; red pad identifies pin 1.  Breadboard terminals: G=a10, D=a11, S=a12. These are individual flying leads for headers, not a rigid plug.
92. **Inspect Q_PASS:** Power OFF: inspect every terminal, polarity, seating and solder joint. Q_PASS: pass; USB high-side switch. Part of Default-OFF USB switch and bounded LED test source. Mount on the top side; red pad identifies pin 1.  Breadboard terminals: G=a10, D=a11, S=a12. These are individual flying leads for headers, not a rigid plug.
93. **Place Q_ENABLE:** Q_ENABLE: enable; 3.3V gate-control transistor. Part of Default-OFF USB switch and bounded LED test source. Mount on the top side; red pad identifies pin 1.  Breadboard terminals: S=a17, G=a18, D=a19. These are individual flying leads for headers, not a rigid plug.
94. **Inspect Q_ENABLE:** Power OFF: inspect every terminal, polarity, seating and solder joint. Q_ENABLE: enable; 3.3V gate-control transistor. Part of Default-OFF USB switch and bounded LED test source. Mount on the top side; red pad identifies pin 1.  Breadboard terminals: S=a17, G=a18, D=a19. These are individual flying leads for headers, not a rigid plug.
95. **Place R_GATE_OFF:** R_GATE_OFF: gate off; 10kΩ makes the P-channel switch OFF. Part of Default-OFF USB switch and bounded LED test source. Mount on the top side; red pad identifies pin 1.  Breadboard terminals: 1=c10, 2=c14. These are individual flying leads for headers, not a rigid plug.
96. **Inspect R_GATE_OFF:** Power OFF: inspect every terminal, polarity, seating and solder joint. R_GATE_OFF: gate off; 10kΩ makes the P-channel switch OFF. Part of Default-OFF USB switch and bounded LED test source. Mount on the top side; red pad identifies pin 1.  Breadboard terminals: 1=c10, 2=c14. These are individual flying leads for headers, not a rigid plug.
97. **Place R_ENABLE_OFF:** R_ENABLE_OFF: enable off; 100kΩ holds enable LOW. Part of Default-OFF USB switch and bounded LED test source. Mount on the top side; red pad identifies pin 1.  Breadboard terminals: 1=e18, 2=e22. These are individual flying leads for headers, not a rigid plug.
98. **Inspect R_ENABLE_OFF:** Power OFF: inspect every terminal, polarity, seating and solder joint. R_ENABLE_OFF: enable off; 100kΩ holds enable LOW. Part of Default-OFF USB switch and bounded LED test source. Mount on the top side; red pad identifies pin 1.  Breadboard terminals: 1=e18, 2=e22. These are individual flying leads for headers, not a rigid plug.
99. **Place R_LIMIT:** R_LIMIT: limit; 560Ω ±1%, 0.25W; bounds every educational-source path. Part of Default-OFF USB switch and bounded LED test source. Mount on the top side; red pad identifies pin 1.  Breadboard terminals: 1=e11, 2=f11. These are individual flying leads for headers, not a rigid plug.
100. **Inspect R_LIMIT:** Power OFF: inspect every terminal, polarity, seating and solder joint. R_LIMIT: limit; 560Ω ±1%, 0.25W; bounds every educational-source path. Part of Default-OFF USB switch and bounded LED test source. Mount on the top side; red pad identifies pin 1.  Breadboard terminals: 1=e11, 2=f11. These are individual flying leads for headers, not a rigid plug.
101. **Place J_OUTPUT:** J_OUTPUT: output; Two flying leads: C2 positive / C1 return. Part of Default-OFF USB switch and bounded LED test source. Mount on the top side; red pad identifies pin 1. Actual purchased dimensions must be measured before release. Breadboard terminals: USB_TEST_LIMITED=j11, GND=j24. These are individual flying leads for headers, not a rigid plug.
102. **Inspect J_OUTPUT:** Power OFF: inspect every terminal, polarity, seating and solder joint. J_OUTPUT: output; Two flying leads: C2 positive / C1 return. Part of Default-OFF USB switch and bounded LED test source. Mount on the top side; red pad identifies pin 1. Actual purchased dimensions must be measured before release. Breadboard terminals: USB_TEST_LIMITED=j11, GND=j24. These are individual flying leads for headers, not a rigid plug.
103. **Place C_USB:** C_USB: usb; USB3V3 fixture decoupling. Part of Default-OFF USB switch and bounded LED test source. Mount on the top side; red pad identifies pin 1.  Breadboard terminals: 1=f3, 2=f4. These are individual flying leads for headers, not a rigid plug.
104. **Inspect C_USB:** Power OFF: inspect every terminal, polarity, seating and solder joint. C_USB: usb; USB3V3 fixture decoupling. Part of Default-OFF USB switch and bounded LED test source. Mount on the top side; red pad identifies pin 1.  Breadboard terminals: 1=f3, 2=f4. These are individual flying leads for headers, not a rigid plug.
105. **Connect W1 · USB_5V:** Logic supply or current-protection path; verify the named supply domain and current direction. Connect J_CONTROL.1 → Q_PASS.3. Use a removable jumper between j2 and a12; same-side row holes are already connected.
106. **Verify W1 · USB_5V:** Power disconnected: Logic supply or current-protection path; verify the named supply domain and current direction. Connect J_CONTROL.1 → Q_PASS.3. Use a removable jumper between j2 and a12; same-side row holes are already connected. Confirm endpoint continuity (<1Ω for a wire) and no adjacent-net bridge; isolate parallel paths before measuring.
107. **Connect W2 · USB_5V:** Logic supply or current-protection path; verify the named supply domain and current direction. Connect J_CONTROL.1 → R_GATE_OFF.2. Use a removable jumper between j2 and c14; same-side row holes are already connected.
108. **Verify W2 · USB_5V:** Power disconnected: Logic supply or current-protection path; verify the named supply domain and current direction. Connect J_CONTROL.1 → R_GATE_OFF.2. Use a removable jumper between j2 and c14; same-side row holes are already connected. Confirm endpoint continuity (<1Ω for a wire) and no adjacent-net bridge; isolate parallel paths before measuring.
109. **Verify W3 · USB_3V3:** Power disconnected: Inspect the built-in breadboard row connection C_USB.1 → J_CONTROL.2. No jumper is needed; confirm <1Ω with USB disconnected. Confirm endpoint continuity (<1Ω for a wire) and no adjacent-net bridge; isolate parallel paths before measuring.
110. **Verify W4 · GND:** Power disconnected: Inspect the built-in breadboard row connection C_USB.2 → J_CONTROL.3. No jumper is needed; confirm <1Ω with USB disconnected. Confirm endpoint continuity (<1Ω for a wire) and no adjacent-net bridge; isolate parallel paths before measuring.
111. **Connect W5 · GND:** Common electrical reference and return; keep student, USB and service ground identities consistent. Connect C_USB.2 → J_OUTPUT.2. Use a removable jumper between f4 and j24; same-side row holes are already connected.
112. **Verify W5 · GND:** Power disconnected: Common electrical reference and return; keep student, USB and service ground identities consistent. Connect C_USB.2 → J_OUTPUT.2. Use a removable jumper between f4 and j24; same-side row holes are already connected. Confirm endpoint continuity (<1Ω for a wire) and no adjacent-net bridge; isolate parallel paths before measuring.
113. **Connect W6 · GND:** Common electrical reference and return; keep student, USB and service ground identities consistent. Connect C_USB.2 → Q_ENABLE.1. Use a removable jumper between f4 and a17; same-side row holes are already connected.
114. **Verify W6 · GND:** Power disconnected: Common electrical reference and return; keep student, USB and service ground identities consistent. Connect C_USB.2 → Q_ENABLE.1. Use a removable jumper between f4 and a17; same-side row holes are already connected. Confirm endpoint continuity (<1Ω for a wire) and no adjacent-net bridge; isolate parallel paths before measuring.
115. **Connect W7 · GND:** Common electrical reference and return; keep student, USB and service ground identities consistent. Connect C_USB.2 → R_ENABLE_OFF.2. Use a removable jumper between f4 and e22; same-side row holes are already connected.
116. **Verify W7 · GND:** Power disconnected: Common electrical reference and return; keep student, USB and service ground identities consistent. Connect C_USB.2 → R_ENABLE_OFF.2. Use a removable jumper between f4 and e22; same-side row holes are already connected. Confirm endpoint continuity (<1Ω for a wire) and no adjacent-net bridge; isolate parallel paths before measuring.
117. **Connect W8 · EDU_PWR_EN:** Protection, reset or readiness control; its defined polarity must preserve OFF at startup and on faults. Connect J_CONTROL.4 → Q_ENABLE.2. Use a removable jumper between j5 and a18; same-side row holes are already connected.
118. **Verify W8 · EDU_PWR_EN:** Power disconnected: Protection, reset or readiness control; its defined polarity must preserve OFF at startup and on faults. Connect J_CONTROL.4 → Q_ENABLE.2. Use a removable jumper between j5 and a18; same-side row holes are already connected. Confirm endpoint continuity (<1Ω for a wire) and no adjacent-net bridge; isolate parallel paths before measuring.
119. **Connect W9 · EDU_PWR_EN:** Protection, reset or readiness control; its defined polarity must preserve OFF at startup and on faults. Connect J_CONTROL.4 → R_ENABLE_OFF.1. Use a removable jumper between j5 and e18; same-side row holes are already connected.
120. **Verify W9 · EDU_PWR_EN:** Power disconnected: Protection, reset or readiness control; its defined polarity must preserve OFF at startup and on faults. Connect J_CONTROL.4 → R_ENABLE_OFF.1. Use a removable jumper between j5 and e18; same-side row holes are already connected. Confirm endpoint continuity (<1Ω for a wire) and no adjacent-net bridge; isolate parallel paths before measuring.
121. **Connect W10 · PROTO_GATE:** Output switching or current-limiting control; default OFF and mutually exclusive source/sink states are required. Connect Q_ENABLE.3 → Q_PASS.1. Use a removable jumper between a19 and a10; same-side row holes are already connected.
122. **Verify W10 · PROTO_GATE:** Power disconnected: Output switching or current-limiting control; default OFF and mutually exclusive source/sink states are required. Connect Q_ENABLE.3 → Q_PASS.1. Use a removable jumper between a19 and a10; same-side row holes are already connected. Confirm endpoint continuity (<1Ω for a wire) and no adjacent-net bridge; isolate parallel paths before measuring.
123. **Connect W11 · PROTO_GATE:** Output switching or current-limiting control; default OFF and mutually exclusive source/sink states are required. Connect Q_ENABLE.3 → R_GATE_OFF.1. Use a removable jumper between a19 and c10; same-side row holes are already connected.
124. **Verify W11 · PROTO_GATE:** Power disconnected: Output switching or current-limiting control; default OFF and mutually exclusive source/sink states are required. Connect Q_ENABLE.3 → R_GATE_OFF.1. Use a removable jumper between a19 and c10; same-side row holes are already connected. Confirm endpoint continuity (<1Ω for a wire) and no adjacent-net bridge; isolate parallel paths before measuring.
125. **Verify W12 · PROTO_DRAIN:** Power disconnected: Inspect the built-in breadboard row connection Q_PASS.2 → R_LIMIT.1. No jumper is needed; confirm <1Ω with USB disconnected. Confirm endpoint continuity (<1Ω for a wire) and no adjacent-net bridge; isolate parallel paths before measuring.
126. **Verify W13 · USB_TEST_LIMITED:** Power disconnected: Inspect the built-in breadboard row connection J_OUTPUT.1 → R_LIMIT.2. No jumper is needed; confirm <1Ω with USB disconnected. Confirm endpoint continuity (<1Ω for a wire) and no adjacent-net bridge; isolate parallel paths before measuring.
127. **Fit USB_PROTOTYPE:** matrix.J_PROTOTYPE → usb-prototype.J_CONTROL; verify each conductor and pin1 with power OFF. Four individual flying leads, not an IDC cable. Disconnect before final supply operation.
128. **Inspect USB_PROTOTYPE:** Power OFF: matrix.J_PROTOTYPE → usb-prototype.J_CONTROL; verify each conductor and pin1 with power OFF. Four individual flying leads, not an IDC cable. Disconnect before final supply operation.
129. **Fit battery:** Proposed fake-battery contact row1 (TOP y9): negative C1 / positive C2; measure real body fit first; represents the external test source, not a GPIO supply.
130. **Inspect battery:** Power OFF: Proposed fake-battery contact row1 (TOP y9): negative C1 / positive C2; measure real body fit first; represents the external test source, not a GPIO supply.
131. **Fit kit-resistor:** Place the real 1kΩ resistor between C2 and C3 on contact row2 (TOP y13). Confirm its measured resistance before power.
132. **Inspect kit-resistor:** Power OFF: Place the real 1kΩ resistor between C2 and C3 on contact row2 (TOP y13). Confirm its measured resistance before power.
133. **Fit kit-led:** Place LED anode at C3 and cathode at C4 on contact row3 (TOP y17); inspect actual polarity.
134. **Inspect kit-led:** Power OFF: Place LED anode at C3 and cathode at C4 on contact row3 (TOP y17); inspect actual polarity.
135. **Fit kit-jumper:** Place the three-gap jumper C4→C1 on contact row4 (TOP y21).
136. **Inspect kit-jumper:** Power OFF: Place the three-gap jumper C4→C1 on contact row4 (TOP y21).
137. **Fit fixed-links:** USB prototype J_OUTPUT pin1→A1 J_NODE pin3 / C2; pin2→pin1 / C1. Final supply and matrix are disconnected.
138. **Inspect fixed-links:** Power OFF: USB prototype J_OUTPUT pin1→A1 J_NODE pin3 / C2; pin2→pin1 / C1. Final supply and matrix are disconnected.
139. **Check the firmware contract:** factory LED: GPIO32 defaults LOW; explicit enable/disable; GPIO25 stimulus LOW; all future routing/output controls LOW
140. **Measure and record:** Identify the exact classic ESP32 DevKit pinout, the USB-powered 5V output and 3V3 output. Identify actual pogo and adapter dimensions before soldering. Confirm the four kit pieces fit the selected rows.
141. **Measure and record:** Unpowered A1: all six contacts within each column <1Ω; different columns >10MΩ with external links isolated. Inspect pin1 and the NODE header mapping.
142. **Measure and record:** Prototype disconnected from A1: measure USB 5V ≤5.25V and 3V3 3.20–3.38V. R_LIMIT is 560Ω ±1%, ≥0.25W. With its output shorted, source current ≤9.5mA; remove short before connecting the kit.
143. **Measure and record:** Place fake battery negative C1 / positive C2, 1kΩ resistor C2–C3, LED anode C3 / cathode C4, and kit jumper C4–C1. Prototype J_OUTPUT pin1→A1 J_NODE pin3 and pin2→pin1. No final-power or matrix cable connected.
144. **Measure and record:** Compatible factory firmware: GPIO32 LOW/reset makes LED OFF; explicit enable lights LED; disable turns it OFF. Record USB-test-source voltage at C2 under load; it is intentionally unregulated and must not be called the final 5V rail.
145. **Film the win:** ESP32 switches the real four-column LED loop.
146. **Accept this checkpoint:** Verify the readings and construction, then accept CP00.

## Firmware contract (implementation pending)

factory LED: GPIO32 defaults LOW; explicit enable/disable; GPIO25 stimulus LOW; all future routing/output controls LOW

## Acceptance tests

1. Identify the exact classic ESP32 DevKit pinout, the USB-powered 5V output and 3V3 output. Identify actual pogo and adapter dimensions before soldering. Confirm the four kit pieces fit the selected rows.
2. Unpowered A1: all six contacts within each column <1Ω; different columns >10MΩ with external links isolated. Inspect pin1 and the NODE header mapping.
3. Prototype disconnected from A1: measure USB 5V ≤5.25V and 3V3 3.20–3.38V. R_LIMIT is 560Ω ±1%, ≥0.25W. With its output shorted, source current ≤9.5mA; remove short before connecting the kit.
4. Place fake battery negative C1 / positive C2, 1kΩ resistor C2–C3, LED anode C3 / cathode C4, and kit jumper C4–C1. Prototype J_OUTPUT pin1→A1 J_NODE pin3 and pin2→pin1. No final-power or matrix cable connected.
5. Compatible factory firmware: GPIO32 LOW/reset makes LED OFF; explicit enable lights LED; disable turns it OFF. Record USB-test-source voltage at C2 under load; it is intentionally unregulated and must not be called the final 5V rail.

## Film the win

Prototype source only: positive C2 / ground C1; final supply and matrix disconnected. OLED uses ESP1 GPIO4 SDA / GPIO16 SCL at 3.3V. Remove diagnostic probes before ordinary operation.

1. Show first light setup with power OFF and display firmware revision.
2. Demonstrate: ESP32 switches the real four-column LED loop.
3. Show the documented negative test and actual recorded readings.

**Negative example:** Disable or reset the ESP32: the LED must go dark without touching the kit.

Record readings and units, equipment, link positions, firmware revision and outcome. Firmware is a contract only; never film simulated readings as measured hardware evidence.
