gefgu/integration-workshop-3/eletronics/perfboard/cp01.md

# CP01 — Reject an open contact

**Win:** A lifted jumper contact is electronically rejected.

Build the assigned functional groups in the [assembly app](tscircuit/README.md). Earlier soldered wiring stays fixed. Removable links and top-side kit arrangements may change.

## Link positions

- USB test-source positive lead unplugged; final supply and matrix leads absent.
- TEST_A→A1 C4, TEST_B→C1; JP_RETURN fitted only during diagnostic test.
- Before LED enable: stimulus OFF, JP_RETURN/probes removed, prototype positive restored with power OFF.

## Guided actions

1. **Disconnect power and prepare:** Unplug USB and all educational sources before construction. USB test-source positive lead unplugged; final supply and matrix leads absent. TEST_A→A1 C4, TEST_B→C1; JP_RETURN fitted only during diagnostic test. Before LED enable: stimulus OFF, JP_RETURN/probes removed, prototype positive restored with power OFF.
2. **Place J_CONTROL:** J_CONTROL: control; from router J_FIXTURE. Part of USB-powered ESP1 interface and fixed test endpoints. Mount on the top side; red pad identifies pin 1. 
3. **Inspect J_CONTROL:** Power OFF: inspect every terminal, polarity, seating and solder joint. J_CONTROL: control; from router J_FIXTURE. Part of USB-powered ESP1 interface and fixed test endpoints. Mount on the top side; red pad identifies pin 1. 
4. **Place J_TEST:** J_TEST: test; removable sense leads: C4 / C1. Part of USB-powered ESP1 interface and fixed test endpoints. Mount on the top side; red pad identifies pin 1. 
5. **Inspect J_TEST:** Power OFF: inspect every terminal, polarity, seating and solder joint. J_TEST: test; removable sense leads: C4 / C1. Part of USB-powered ESP1 interface and fixed test endpoints. Mount on the top side; red pad identifies pin 1. 
6. **Place JP_RETURN:** JP_RETURN: return; fit only during supervised continuity test. Part of USB-powered ESP1 interface and fixed test endpoints. Mount on the top side; red pad identifies pin 1. 
7. **Inspect JP_RETURN:** Power OFF: inspect every terminal, polarity, seating and solder joint. JP_RETURN: return; fit only during supervised continuity test. Part of USB-powered ESP1 interface and fixed test endpoints. Mount on the top side; red pad identifies pin 1. 
8. **Place R_SDA:** R_SDA: sda; 4.7k. Part of USB-powered ESP1 interface and fixed test endpoints. Mount on the top side; red pad identifies pin 1. 
9. **Inspect R_SDA:** Power OFF: inspect every terminal, polarity, seating and solder joint. R_SDA: sda; 4.7k. Part of USB-powered ESP1 interface and fixed test endpoints. Mount on the top side; red pad identifies pin 1. 
10. **Place R_SCL:** R_SCL: scl; 4.7k. Part of USB-powered ESP1 interface and fixed test endpoints. Mount on the top side; red pad identifies pin 1. 
11. **Inspect R_SCL:** Power OFF: inspect every terminal, polarity, seating and solder joint. R_SCL: scl; 4.7k. Part of USB-powered ESP1 interface and fixed test endpoints. Mount on the top side; red pad identifies pin 1. 
12. **Place D_STIM:** D_STIM: stim; BAT85. Part of Default-off limited continuity stimulus. Mount on the top side; red pad identifies pin 1. 
13. **Inspect D_STIM:** Power OFF: inspect every terminal, polarity, seating and solder joint. D_STIM: stim; BAT85. Part of Default-off limited continuity stimulus. Mount on the top side; red pad identifies pin 1. 
14. **Place R_STIM:** R_STIM: stim; 10k. Part of Default-off limited continuity stimulus. Mount on the top side; red pad identifies pin 1. 
15. **Inspect R_STIM:** Power OFF: inspect every terminal, polarity, seating and solder joint. R_STIM: stim; 10k. Part of Default-off limited continuity stimulus. Mount on the top side; red pad identifies pin 1. 
16. **Place K_STIM:** K_STIM: stim; AQY212EH. Part of Default-off limited continuity stimulus. Mount on the top side; red pad identifies pin 1. 
17. **Inspect K_STIM:** Power OFF: inspect every terminal, polarity, seating and solder joint. K_STIM: stim; AQY212EH. Part of Default-off limited continuity stimulus. Mount on the top side; red pad identifies pin 1. 
18. **Place R_LED:** R_LED: led; 560. Part of Default-off limited continuity stimulus. Mount on the top side; red pad identifies pin 1. 
19. **Inspect R_LED:** Power OFF: inspect every terminal, polarity, seating and solder joint. R_LED: led; 560. Part of Default-off limited continuity stimulus. Mount on the top side; red pad identifies pin 1. 
20. **Place R_OFF:** R_OFF: off; 100k. Part of Default-off limited continuity stimulus. Mount on the top side; red pad identifies pin 1. 
21. **Inspect R_OFF:** Power OFF: inspect every terminal, polarity, seating and solder joint. R_OFF: off; 100k. Part of Default-off limited continuity stimulus. Mount on the top side; red pad identifies pin 1. 
22. **Place Q_STIM:** Q_STIM: stim; 2N7000. Part of Default-off limited continuity stimulus. Mount on the top side; red pad identifies pin 1. 
23. **Inspect Q_STIM:** Power OFF: inspect every terminal, polarity, seating and solder joint. Q_STIM: stim; 2N7000. Part of Default-off limited continuity stimulus. Mount on the top side; red pad identifies pin 1. 
24. **Place R_A_TOP:** R_A_TOP: a top; 1M. Part of Buffered fixed-pair differential measurement. Mount on the top side; red pad identifies pin 1. 
25. **Inspect R_A_TOP:** Power OFF: inspect every terminal, polarity, seating and solder joint. R_A_TOP: a top; 1M. Part of Buffered fixed-pair differential measurement. Mount on the top side; red pad identifies pin 1. 
26. **Place R_A_BOTTOM:** R_A_BOTTOM: a bottom; 1M. Part of Buffered fixed-pair differential measurement. Mount on the top side; red pad identifies pin 1. 
27. **Inspect R_A_BOTTOM:** Power OFF: inspect every terminal, polarity, seating and solder joint. R_A_BOTTOM: a bottom; 1M. Part of Buffered fixed-pair differential measurement. Mount on the top side; red pad identifies pin 1. 
28. **Place C_A:** C_A: a; 1nF. Part of Buffered fixed-pair differential measurement. Mount on the top side; red pad identifies pin 1. 
29. **Inspect C_A:** Power OFF: inspect every terminal, polarity, seating and solder joint. C_A: a; 1nF. Part of Buffered fixed-pair differential measurement. Mount on the top side; red pad identifies pin 1. 
30. **Place R_ADC_A:** R_ADC_A: adc a; 1k. Part of Buffered fixed-pair differential measurement. Mount on the top side; red pad identifies pin 1. 
31. **Inspect R_ADC_A:** Power OFF: inspect every terminal, polarity, seating and solder joint. R_ADC_A: adc a; 1k. Part of Buffered fixed-pair differential measurement. Mount on the top side; red pad identifies pin 1. 
32. **Place R_B_TOP:** R_B_TOP: b top; 1M. Part of Buffered fixed-pair differential measurement. Mount on the top side; red pad identifies pin 1. 
33. **Inspect R_B_TOP:** Power OFF: inspect every terminal, polarity, seating and solder joint. R_B_TOP: b top; 1M. Part of Buffered fixed-pair differential measurement. Mount on the top side; red pad identifies pin 1. 
34. **Place R_B_BOTTOM:** R_B_BOTTOM: b bottom; 1M. Part of Buffered fixed-pair differential measurement. Mount on the top side; red pad identifies pin 1. 
35. **Inspect R_B_BOTTOM:** Power OFF: inspect every terminal, polarity, seating and solder joint. R_B_BOTTOM: b bottom; 1M. Part of Buffered fixed-pair differential measurement. Mount on the top side; red pad identifies pin 1. 
36. **Place C_B:** C_B: b; 1nF. Part of Buffered fixed-pair differential measurement. Mount on the top side; red pad identifies pin 1. 
37. **Inspect C_B:** Power OFF: inspect every terminal, polarity, seating and solder joint. C_B: b; 1nF. Part of Buffered fixed-pair differential measurement. Mount on the top side; red pad identifies pin 1. 
38. **Place R_ADC_B:** R_ADC_B: adc b; 1k. Part of Buffered fixed-pair differential measurement. Mount on the top side; red pad identifies pin 1. 
39. **Inspect R_ADC_B:** Power OFF: inspect every terminal, polarity, seating and solder joint. R_ADC_B: adc b; 1k. Part of Buffered fixed-pair differential measurement. Mount on the top side; red pad identifies pin 1. 
40. **Place U_BUFFER:** U_BUFFER: buffer; OPA2333AID. Part of Buffered fixed-pair differential measurement. Install on SOIC8 to DIP8; verify manufacturer pin numbering. Mount on the top side; red pad identifies pin 1. 
41. **Inspect U_BUFFER:** Power OFF: inspect every terminal, polarity, seating and solder joint. U_BUFFER: buffer; OPA2333AID. Part of Buffered fixed-pair differential measurement. Install on SOIC8 to DIP8; verify manufacturer pin numbering. Mount on the top side; red pad identifies pin 1. 
42. **Place C_BUFFER:** C_BUFFER: buffer; 100nF. Part of Buffered fixed-pair differential measurement. Mount on the top side; red pad identifies pin 1. 
43. **Inspect C_BUFFER:** Power OFF: inspect every terminal, polarity, seating and solder joint. C_BUFFER: buffer; 100nF. Part of Buffered fixed-pair differential measurement. Mount on the top side; red pad identifies pin 1. 
44. **Place U_ADC:** U_ADC: adc; ADS1115IDGSR. Part of Buffered fixed-pair differential measurement. Install on VSSOP10 to numbered DIP10; verify manufacturer pin numbering. Mount on the top side; red pad identifies pin 1. 
45. **Inspect U_ADC:** Power OFF: inspect every terminal, polarity, seating and solder joint. U_ADC: adc; ADS1115IDGSR. Part of Buffered fixed-pair differential measurement. Install on VSSOP10 to numbered DIP10; verify manufacturer pin numbering. Mount on the top side; red pad identifies pin 1. 
46. **Place C_ADC:** C_ADC: adc; 100nF. Part of Buffered fixed-pair differential measurement. Mount on the top side; red pad identifies pin 1. 
47. **Inspect C_ADC:** Power OFF: inspect every terminal, polarity, seating and solder joint. C_ADC: adc; 100nF. Part of Buffered fixed-pair differential measurement. Mount on the top side; red pad identifies pin 1. 
48. **Connect W1 · USB_3V3:** 3.3-V electronics supply. USB and bench supply domains must not be bridged. Connect C_ADC.1 → C_BUFFER.1. Hole path (20,24) → (20,23.5) → (17.5,23.5) → (17.5,24.5) → (15,24.5) → (15,24). Insulate every crossing; solder only the two endpoints.
49. **Verify W1 · USB_3V3:** Power disconnected: 3.3-V electronics supply. USB and bench supply domains must not be bridged. Connect C_ADC.1 → C_BUFFER.1. Hole path (20,24) → (20,23.5) → (17.5,23.5) → (17.5,24.5) → (15,24.5) → (15,24). Insulate every crossing; solder only the two endpoints. Confirm endpoint continuity (<1Ω for a wire) and no adjacent-net bridge; isolate parallel paths before measuring.
50. **Connect W2 · USB_3V3:** 3.3-V electronics supply. USB and bench supply domains must not be bridged. Connect C_ADC.1 → D_STIM.1. Hole path (20,24) → (20,23.5) → (11.5,23.5) → (11.5,9.5) → (4,9.5) → (4,9). Insulate every crossing; solder only the two endpoints.
51. **Verify W2 · USB_3V3:** Power disconnected: 3.3-V electronics supply. USB and bench supply domains must not be bridged. Connect C_ADC.1 → D_STIM.1. Hole path (20,24) → (20,23.5) → (11.5,23.5) → (11.5,9.5) → (4,9.5) → (4,9). Insulate every crossing; solder only the two endpoints. Confirm endpoint continuity (<1Ω for a wire) and no adjacent-net bridge; isolate parallel paths before measuring.
52. **Connect W3 · USB_3V3:** 3.3-V electronics supply. USB and bench supply domains must not be bridged. Connect C_ADC.1 → J_CONTROL.1. Hole path (20,24) → (20,23.5) → (12.5,23.5) → (12.5,3.5) → (5,3.5) → (5,3). Insulate every crossing; solder only the two endpoints.
53. **Verify W3 · USB_3V3:** Power disconnected: 3.3-V electronics supply. USB and bench supply domains must not be bridged. Connect C_ADC.1 → J_CONTROL.1. Hole path (20,24) → (20,23.5) → (12.5,23.5) → (12.5,3.5) → (5,3.5) → (5,3). Insulate every crossing; solder only the two endpoints. Confirm endpoint continuity (<1Ω for a wire) and no adjacent-net bridge; isolate parallel paths before measuring.
54. **Connect W4 · USB_3V3:** 3.3-V electronics supply. USB and bench supply domains must not be bridged. Connect C_ADC.1 → R_LED.1. Hole path (20,24) → (20,23.5) → (22.5,23.5) → (22.5,9.5) → (25,9.5) → (25,9). Insulate every crossing; solder only the two endpoints.
55. **Verify W4 · USB_3V3:** Power disconnected: 3.3-V electronics supply. USB and bench supply domains must not be bridged. Connect C_ADC.1 → R_LED.1. Hole path (20,24) → (20,23.5) → (22.5,23.5) → (22.5,9.5) → (25,9.5) → (25,9). Insulate every crossing; solder only the two endpoints. Confirm endpoint continuity (<1Ω for a wire) and no adjacent-net bridge; isolate parallel paths before measuring.
56. **Connect W5 · USB_3V3:** 3.3-V electronics supply. USB and bench supply domains must not be bridged. Connect C_ADC.1 → R_SCL.1. Hole path (20,24) → (20,23.5) → (23.5,23.5) → (23.5,3.5) → (28,3.5) → (28,3). Insulate every crossing; solder only the two endpoints.
57. **Verify W5 · USB_3V3:** Power disconnected: 3.3-V electronics supply. USB and bench supply domains must not be bridged. Connect C_ADC.1 → R_SCL.1. Hole path (20,24) → (20,23.5) → (23.5,23.5) → (23.5,3.5) → (28,3.5) → (28,3). Insulate every crossing; solder only the two endpoints. Confirm endpoint continuity (<1Ω for a wire) and no adjacent-net bridge; isolate parallel paths before measuring.
58. **Connect W6 · USB_3V3:** 3.3-V electronics supply. USB and bench supply domains must not be bridged. Connect C_ADC.1 → R_SDA.1. Hole path (20,24) → (20,23.5) → (20.5,23.5) → (20.5,3.5) → (21,3.5) → (21,3). Insulate every crossing; solder only the two endpoints.
59. **Verify W6 · USB_3V3:** Power disconnected: 3.3-V electronics supply. USB and bench supply domains must not be bridged. Connect C_ADC.1 → R_SDA.1. Hole path (20,24) → (20,23.5) → (20.5,23.5) → (20.5,3.5) → (21,3.5) → (21,3). Insulate every crossing; solder only the two endpoints. Confirm endpoint continuity (<1Ω for a wire) and no adjacent-net bridge; isolate parallel paths before measuring.
60. **Connect W7 · USB_3V3:** 3.3-V electronics supply. USB and bench supply domains must not be bridged. Connect C_ADC.1 → U_ADC.8. Hole path (20,24) → (20,23.5) → (13.5,23.5) → (13.5,33.5) → (7,33.5) → (7,33). Insulate every crossing; solder only the two endpoints.
61. **Verify W7 · USB_3V3:** Power disconnected: 3.3-V electronics supply. USB and bench supply domains must not be bridged. Connect C_ADC.1 → U_ADC.8. Hole path (20,24) → (20,23.5) → (13.5,23.5) → (13.5,33.5) → (7,33.5) → (7,33). Insulate every crossing; solder only the two endpoints. Confirm endpoint continuity (<1Ω for a wire) and no adjacent-net bridge; isolate parallel paths before measuring.
62. **Connect W8 · USB_3V3:** 3.3-V electronics supply. USB and bench supply domains must not be bridged. Connect C_ADC.1 → U_BUFFER.8. Hole path (20,24) → (20,23.5) → (26.5,23.5) → (26.5,24.5) → (34,24.5) → (34,24). Insulate every crossing; solder only the two endpoints.
63. **Verify W8 · USB_3V3:** Power disconnected: 3.3-V electronics supply. USB and bench supply domains must not be bridged. Connect C_ADC.1 → U_BUFFER.8. Hole path (20,24) → (20,23.5) → (26.5,23.5) → (26.5,24.5) → (34,24.5) → (34,24). Insulate every crossing; solder only the two endpoints. Confirm endpoint continuity (<1Ω for a wire) and no adjacent-net bridge; isolate parallel paths before measuring.
64. **Connect W9 · GND:** Common electrical reference and return; keep student, USB and service ground identities consistent. Connect C_A.2 → C_ADC.2. Hole path (36,3) → (36,2.5) → (29,2.5) → (29,24.5) → (21,24.5) → (21,24). Insulate every crossing; solder only the two endpoints.
65. **Verify W9 · GND:** Power disconnected: Common electrical reference and return; keep student, USB and service ground identities consistent. Connect C_A.2 → C_ADC.2. Hole path (36,3) → (36,2.5) → (29,2.5) → (29,24.5) → (21,24.5) → (21,24). Insulate every crossing; solder only the two endpoints. Confirm endpoint continuity (<1Ω for a wire) and no adjacent-net bridge; isolate parallel paths before measuring.
66. **Connect W10 · GND:** Common electrical reference and return; keep student, USB and service ground identities consistent. Connect C_A.2 → C_B.2. Hole path (36,3) → (36,2.5) → (24,2.5) → (24,22.5) → (12,22.5) → (12,22). Insulate every crossing; solder only the two endpoints.
67. **Verify W10 · GND:** Power disconnected: Common electrical reference and return; keep student, USB and service ground identities consistent. Connect C_A.2 → C_B.2. Hole path (36,3) → (36,2.5) → (24,2.5) → (24,22.5) → (12,22.5) → (12,22). Insulate every crossing; solder only the two endpoints. Confirm endpoint continuity (<1Ω for a wire) and no adjacent-net bridge; isolate parallel paths before measuring.
68. **Connect W11 · GND:** Common electrical reference and return; keep student, USB and service ground identities consistent. Connect C_A.2 → C_BUFFER.2. Hole path (36,3) → (36,2.5) → (26,2.5) → (26,24.5) → (16,24.5) → (16,24). Insulate every crossing; solder only the two endpoints.
69. **Verify W11 · GND:** Power disconnected: Common electrical reference and return; keep student, USB and service ground identities consistent. Connect C_A.2 → C_BUFFER.2. Hole path (36,3) → (36,2.5) → (26,2.5) → (26,24.5) → (16,24.5) → (16,24). Insulate every crossing; solder only the two endpoints. Confirm endpoint continuity (<1Ω for a wire) and no adjacent-net bridge; isolate parallel paths before measuring.
70. **Connect W12 · GND:** Common electrical reference and return; keep student, USB and service ground identities consistent. Connect C_A.2 → J_CONTROL.2. Hole path (36,3) → (36,2.5) → (21,2.5) → (21,3.5) → (6,3.5) → (6,3). Insulate every crossing; solder only the two endpoints.
71. **Verify W12 · GND:** Power disconnected: Common electrical reference and return; keep student, USB and service ground identities consistent. Connect C_A.2 → J_CONTROL.2. Hole path (36,3) → (36,2.5) → (21,2.5) → (21,3.5) → (6,3.5) → (6,3). Insulate every crossing; solder only the two endpoints. Confirm endpoint continuity (<1Ω for a wire) and no adjacent-net bridge; isolate parallel paths before measuring.
72. **Connect W13 · GND:** Common electrical reference and return; keep student, USB and service ground identities consistent. Connect C_A.2 → JP_RETURN.2. Hole path (36,3) → (36,2.5) → (27,2.5) → (27,3.5) → (17,3.5) → (17,3). Insulate every crossing; solder only the two endpoints.
73. **Verify W13 · GND:** Power disconnected: Common electrical reference and return; keep student, USB and service ground identities consistent. Connect C_A.2 → JP_RETURN.2. Hole path (36,3) → (36,2.5) → (27,2.5) → (27,3.5) → (17,3.5) → (17,3). Insulate every crossing; solder only the two endpoints. Confirm endpoint continuity (<1Ω for a wire) and no adjacent-net bridge; isolate parallel paths before measuring.
74. **Connect W14 · GND:** Common electrical reference and return; keep student, USB and service ground identities consistent. Connect C_A.2 → Q_STIM.1. Hole path (36,3) → (36,2.5) → (20,2.5) → (20,16.5) → (4,16.5) → (4,16). Insulate every crossing; solder only the two endpoints.
75. **Verify W14 · GND:** Power disconnected: Common electrical reference and return; keep student, USB and service ground identities consistent. Connect C_A.2 → Q_STIM.1. Hole path (36,3) → (36,2.5) → (20,2.5) → (20,16.5) → (4,16.5) → (4,16). Insulate every crossing; solder only the two endpoints. Confirm endpoint continuity (<1Ω for a wire) and no adjacent-net bridge; isolate parallel paths before measuring.
76. **Connect W15 · GND:** Common electrical reference and return; keep student, USB and service ground identities consistent. Connect C_A.2 → R_A_BOTTOM.2. Hole path (36,3) → (36,2.5) → (33,2.5) → (33,16.5) → (29,16.5) → (29,16). Insulate every crossing; solder only the two endpoints.
77. **Verify W15 · GND:** Power disconnected: Common electrical reference and return; keep student, USB and service ground identities consistent. Connect C_A.2 → R_A_BOTTOM.2. Hole path (36,3) → (36,2.5) → (33,2.5) → (33,16.5) → (29,16.5) → (29,16). Insulate every crossing; solder only the two endpoints. Confirm endpoint continuity (<1Ω for a wire) and no adjacent-net bridge; isolate parallel paths before measuring.
78. **Connect W16 · GND:** Common electrical reference and return; keep student, USB and service ground identities consistent. Connect C_A.2 → R_B_BOTTOM.2. Hole path (36,3) → (36,2.5) → (22,2.5) → (22,22.5) → (8,22.5) → (8,22). Insulate every crossing; solder only the two endpoints.
79. **Verify W16 · GND:** Power disconnected: Common electrical reference and return; keep student, USB and service ground identities consistent. Connect C_A.2 → R_B_BOTTOM.2. Hole path (36,3) → (36,2.5) → (22,2.5) → (22,22.5) → (8,22.5) → (8,22). Insulate every crossing; solder only the two endpoints. Confirm endpoint continuity (<1Ω for a wire) and no adjacent-net bridge; isolate parallel paths before measuring.
80. **Connect W17 · GND:** Common electrical reference and return; keep student, USB and service ground identities consistent. Connect C_A.2 → R_OFF.2. Hole path (36,3) → (36,2.5) → (36,9.5) → (36,9). Insulate every crossing; solder only the two endpoints.
81. **Verify W17 · GND:** Power disconnected: Common electrical reference and return; keep student, USB and service ground identities consistent. Connect C_A.2 → R_OFF.2. Hole path (36,3) → (36,2.5) → (36,9.5) → (36,9). Insulate every crossing; solder only the two endpoints. Confirm endpoint continuity (<1Ω for a wire) and no adjacent-net bridge; isolate parallel paths before measuring.
82. **Connect W18 · GND:** Common electrical reference and return; keep student, USB and service ground identities consistent. Connect C_A.2 → U_ADC.1. Hole path (36,3) → (36,2.5) → (20,2.5) → (20,31.5) → (4,31.5) → (4,31). Insulate every crossing; solder only the two endpoints.
83. **Verify W18 · GND:** Power disconnected: Common electrical reference and return; keep student, USB and service ground identities consistent. Connect C_A.2 → U_ADC.1. Hole path (36,3) → (36,2.5) → (20,2.5) → (20,31.5) → (4,31.5) → (4,31). Insulate every crossing; solder only the two endpoints. Confirm endpoint continuity (<1Ω for a wire) and no adjacent-net bridge; isolate parallel paths before measuring.
84. **Connect W19 · GND:** Common electrical reference and return; keep student, USB and service ground identities consistent. Connect C_A.2 → U_ADC.3. Hole path (36,3) → (36,2.5) → (20,2.5) → (20,33.5) → (4,33.5) → (4,33). Insulate every crossing; solder only the two endpoints.
85. **Verify W19 · GND:** Power disconnected: Common electrical reference and return; keep student, USB and service ground identities consistent. Connect C_A.2 → U_ADC.3. Hole path (36,3) → (36,2.5) → (20,2.5) → (20,33.5) → (4,33.5) → (4,33). Insulate every crossing; solder only the two endpoints. Confirm endpoint continuity (<1Ω for a wire) and no adjacent-net bridge; isolate parallel paths before measuring.
86. **Connect W20 · GND:** Common electrical reference and return; keep student, USB and service ground identities consistent. Connect C_A.2 → U_ADC.6. Hole path (36,3) → (36,2.5) → (22,2.5) → (22,35.5) → (7,35.5) → (7,35). Insulate every crossing; solder only the two endpoints.
87. **Verify W20 · GND:** Power disconnected: Common electrical reference and return; keep student, USB and service ground identities consistent. Connect C_A.2 → U_ADC.6. Hole path (36,3) → (36,2.5) → (22,2.5) → (22,35.5) → (7,35.5) → (7,35). Insulate every crossing; solder only the two endpoints. Confirm endpoint continuity (<1Ω for a wire) and no adjacent-net bridge; isolate parallel paths before measuring.
88. **Connect W21 · GND:** Common electrical reference and return; keep student, USB and service ground identities consistent. Connect C_A.2 → U_ADC.7. Hole path (36,3) → (36,2.5) → (22,2.5) → (22,34.5) → (7,34.5) → (7,34). Insulate every crossing; solder only the two endpoints.
89. **Verify W21 · GND:** Power disconnected: Common electrical reference and return; keep student, USB and service ground identities consistent. Connect C_A.2 → U_ADC.7. Hole path (36,3) → (36,2.5) → (22,2.5) → (22,34.5) → (7,34.5) → (7,34). Insulate every crossing; solder only the two endpoints. Confirm endpoint continuity (<1Ω for a wire) and no adjacent-net bridge; isolate parallel paths before measuring.
90. **Connect W22 · GND:** Common electrical reference and return; keep student, USB and service ground identities consistent. Connect C_A.2 → U_BUFFER.4. Hole path (36,3) → (36,2.5) → (34,2.5) → (34,27.5) → (31,27.5) → (31,27). Insulate every crossing; solder only the two endpoints.
91. **Verify W22 · GND:** Power disconnected: Common electrical reference and return; keep student, USB and service ground identities consistent. Connect C_A.2 → U_BUFFER.4. Hole path (36,3) → (36,2.5) → (34,2.5) → (34,27.5) → (31,27.5) → (31,27). Insulate every crossing; solder only the two endpoints. Confirm endpoint continuity (<1Ω for a wire) and no adjacent-net bridge; isolate parallel paths before measuring.
92. **Connect W23 · FIX_SDA:** I2C service signal. Maintain separate per-position SDA paths and do not join buffer B sides. Connect J_CONTROL.3 → R_SDA.2. Hole path (7,3) → (7,2.5) → (16.5,2.5) → (16.5,3.5) → (25,3.5) → (25,3). Insulate every crossing; solder only the two endpoints.
93. **Verify W23 · FIX_SDA:** Power disconnected: I2C service signal. Maintain separate per-position SDA paths and do not join buffer B sides. Connect J_CONTROL.3 → R_SDA.2. Hole path (7,3) → (7,2.5) → (16.5,2.5) → (16.5,3.5) → (25,3.5) → (25,3). Insulate every crossing; solder only the two endpoints. Confirm endpoint continuity (<1Ω for a wire) and no adjacent-net bridge; isolate parallel paths before measuring.
94. **Connect W24 · FIX_SDA:** I2C service signal. Maintain separate per-position SDA paths and do not join buffer B sides. Connect J_CONTROL.3 → U_ADC.9. Hole path (7,3) → (7,2.5) → (7.5,2.5) → (7.5,32.5) → (7,32.5) → (7,32). Insulate every crossing; solder only the two endpoints.
95. **Verify W24 · FIX_SDA:** Power disconnected: I2C service signal. Maintain separate per-position SDA paths and do not join buffer B sides. Connect J_CONTROL.3 → U_ADC.9. Hole path (7,3) → (7,2.5) → (7.5,2.5) → (7.5,32.5) → (7,32.5) → (7,32). Insulate every crossing; solder only the two endpoints. Confirm endpoint continuity (<1Ω for a wire) and no adjacent-net bridge; isolate parallel paths before measuring.
96. **Connect W25 · FIX_SCL:** I2C service signal. Maintain separate per-position SDA paths and do not join buffer B sides. Connect J_CONTROL.4 → R_SCL.2. Hole path (8,3) → (8,2.5) → (19.5,2.5) → (19.5,3.5) → (32,3.5) → (32,3). Insulate every crossing; solder only the two endpoints.
97. **Verify W25 · FIX_SCL:** Power disconnected: I2C service signal. Maintain separate per-position SDA paths and do not join buffer B sides. Connect J_CONTROL.4 → R_SCL.2. Hole path (8,3) → (8,2.5) → (19.5,2.5) → (19.5,3.5) → (32,3.5) → (32,3). Insulate every crossing; solder only the two endpoints. Confirm endpoint continuity (<1Ω for a wire) and no adjacent-net bridge; isolate parallel paths before measuring.
98. **Connect W26 · FIX_SCL:** I2C service signal. Maintain separate per-position SDA paths and do not join buffer B sides. Connect J_CONTROL.4 → U_ADC.10. Hole path (8,3) → (8,2.5) → (7.5,2.5) → (7.5,31.5) → (7,31.5) → (7,31). Insulate every crossing; solder only the two endpoints.
99. **Verify W26 · FIX_SCL:** Power disconnected: I2C service signal. Maintain separate per-position SDA paths and do not join buffer B sides. Connect J_CONTROL.4 → U_ADC.10. Hole path (8,3) → (8,2.5) → (7.5,2.5) → (7.5,31.5) → (7,31.5) → (7,31). Insulate every crossing; solder only the two endpoints. Confirm endpoint continuity (<1Ω for a wire) and no adjacent-net bridge; isolate parallel paths before measuring.
100. **Connect W27 · FIX_STIM:** Manual continuity fixture connection; use only with student power OFF and disconnect stimulus before operation. Connect J_CONTROL.5 → Q_STIM.2. Hole path (9,3) → (9,2.5) → (7,2.5) → (7,16.5) → (5,16.5) → (5,16). Insulate every crossing; solder only the two endpoints.
101. **Verify W27 · FIX_STIM:** Power disconnected: Manual continuity fixture connection; use only with student power OFF and disconnect stimulus before operation. Connect J_CONTROL.5 → Q_STIM.2. Hole path (9,3) → (9,2.5) → (7,2.5) → (7,16.5) → (5,16.5) → (5,16). Insulate every crossing; solder only the two endpoints. Confirm endpoint continuity (<1Ω for a wire) and no adjacent-net bridge; isolate parallel paths before measuring.
102. **Connect W28 · FIX_STIM:** Manual continuity fixture connection; use only with student power OFF and disconnect stimulus before operation. Connect J_CONTROL.5 → R_OFF.1. Hole path (9,3) → (9,2.5) → (21,2.5) → (21,9.5) → (32,9.5) → (32,9). Insulate every crossing; solder only the two endpoints.
103. **Verify W28 · FIX_STIM:** Power disconnected: Manual continuity fixture connection; use only with student power OFF and disconnect stimulus before operation. Connect J_CONTROL.5 → R_OFF.1. Hole path (9,3) → (9,2.5) → (21,2.5) → (21,9.5) → (32,9.5) → (32,9). Insulate every crossing; solder only the two endpoints. Confirm endpoint continuity (<1Ω for a wire) and no adjacent-net bridge; isolate parallel paths before measuring.
104. **Connect W29 · TEST_A:** Manual continuity fixture connection; use only with student power OFF and disconnect stimulus before operation. Connect J_TEST.1 → K_STIM.4. Hole path (12,3) → (12,2.5) → (17.5,2.5) → (17.5,10.5) → (22,10.5) → (22,10). Insulate every crossing; solder only the two endpoints.
105. **Verify W29 · TEST_A:** Power disconnected: Manual continuity fixture connection; use only with student power OFF and disconnect stimulus before operation. Connect J_TEST.1 → K_STIM.4. Hole path (12,3) → (12,2.5) → (17.5,2.5) → (17.5,10.5) → (22,10.5) → (22,10). Insulate every crossing; solder only the two endpoints. Confirm endpoint continuity (<1Ω for a wire) and no adjacent-net bridge; isolate parallel paths before measuring.
106. **Connect W30 · TEST_A:** Manual continuity fixture connection; use only with student power OFF and disconnect stimulus before operation. Connect J_TEST.1 → R_A_TOP.1. Hole path (12,3) → (12,2.5) → (11.5,2.5) → (11.5,16.5) → (9,16.5) → (9,16). Insulate every crossing; solder only the two endpoints.
107. **Verify W30 · TEST_A:** Power disconnected: Manual continuity fixture connection; use only with student power OFF and disconnect stimulus before operation. Connect J_TEST.1 → R_A_TOP.1. Hole path (12,3) → (12,2.5) → (11.5,2.5) → (11.5,16.5) → (9,16.5) → (9,16). Insulate every crossing; solder only the two endpoints. Confirm endpoint continuity (<1Ω for a wire) and no adjacent-net bridge; isolate parallel paths before measuring.
108. **Connect W31 · TEST_B:** Manual continuity fixture connection; use only with student power OFF and disconnect stimulus before operation. Connect J_TEST.2 → JP_RETURN.1. Hole path (13,3) → (13,2.5) → (14.5,2.5) → (14.5,3.5) → (16,3.5) → (16,3). Insulate every crossing; solder only the two endpoints.
109. **Verify W31 · TEST_B:** Power disconnected: Manual continuity fixture connection; use only with student power OFF and disconnect stimulus before operation. Connect J_TEST.2 → JP_RETURN.1. Hole path (13,3) → (13,2.5) → (14.5,2.5) → (14.5,3.5) → (16,3.5) → (16,3). Insulate every crossing; solder only the two endpoints. Confirm endpoint continuity (<1Ω for a wire) and no adjacent-net bridge; isolate parallel paths before measuring.
110. **Connect W32 · TEST_B:** Manual continuity fixture connection; use only with student power OFF and disconnect stimulus before operation. Connect J_TEST.2 → R_B_TOP.1. Hole path (13,3) → (13,2.5) → (14.5,2.5) → (14.5,18.5) → (16,18.5) → (16,18). Insulate every crossing; solder only the two endpoints.
111. **Verify W32 · TEST_B:** Power disconnected: Manual continuity fixture connection; use only with student power OFF and disconnect stimulus before operation. Connect J_TEST.2 → R_B_TOP.1. Hole path (13,3) → (13,2.5) → (14.5,2.5) → (14.5,18.5) → (16,18.5) → (16,18). Insulate every crossing; solder only the two endpoints. Confirm endpoint continuity (<1Ω for a wire) and no adjacent-net bridge; isolate parallel paths before measuring.
112. **Connect W33 · STIM_FEED:** Manual continuity fixture connection; use only with student power OFF and disconnect stimulus before operation. Connect D_STIM.2 → R_STIM.1. Hole path (8,9) → (8,8.5) → (10,8.5) → (10,9.5) → (11,9.5) → (11,9). Insulate every crossing; solder only the two endpoints.
113. **Verify W33 · STIM_FEED:** Power disconnected: Manual continuity fixture connection; use only with student power OFF and disconnect stimulus before operation. Connect D_STIM.2 → R_STIM.1. Hole path (8,9) → (8,8.5) → (10,8.5) → (10,9.5) → (11,9.5) → (11,9). Insulate every crossing; solder only the two endpoints. Confirm endpoint continuity (<1Ω for a wire) and no adjacent-net bridge; isolate parallel paths before measuring.
114. **Connect W34 · STIM_LIMIT:** Manual continuity fixture connection; use only with student power OFF and disconnect stimulus before operation. Connect K_STIM.3 → R_STIM.2. Hole path (22,11) → (22,10.5) → (19.5,10.5) → (19.5,9.5) → (15,9.5) → (15,9). Insulate every crossing; solder only the two endpoints.
115. **Verify W34 · STIM_LIMIT:** Power disconnected: Manual continuity fixture connection; use only with student power OFF and disconnect stimulus before operation. Connect K_STIM.3 → R_STIM.2. Hole path (22,11) → (22,10.5) → (19.5,10.5) → (19.5,9.5) → (15,9.5) → (15,9). Insulate every crossing; solder only the two endpoints. Confirm endpoint continuity (<1Ω for a wire) and no adjacent-net bridge; isolate parallel paths before measuring.
116. **Connect W35 · STIM_LED_A:** Manual continuity fixture connection; use only with student power OFF and disconnect stimulus before operation. Connect K_STIM.1 → R_LED.2. Hole path (19,10) → (19,9.5) → (23.5,9.5) → (29,9.5) → (29,9). Insulate every crossing; solder only the two endpoints.
117. **Verify W35 · STIM_LED_A:** Power disconnected: Manual continuity fixture connection; use only with student power OFF and disconnect stimulus before operation. Connect K_STIM.1 → R_LED.2. Hole path (19,10) → (19,9.5) → (23.5,9.5) → (29,9.5) → (29,9). Insulate every crossing; solder only the two endpoints. Confirm endpoint continuity (<1Ω for a wire) and no adjacent-net bridge; isolate parallel paths before measuring.
118. **Connect W36 · STIM_LED_K:** Manual continuity fixture connection; use only with student power OFF and disconnect stimulus before operation. Connect K_STIM.2 → Q_STIM.3. Hole path (19,11) → (19,10.5) → (13,10.5) → (13,16.5) → (6,16.5) → (6,16). Insulate every crossing; solder only the two endpoints.
119. **Verify W36 · STIM_LED_K:** Power disconnected: Manual continuity fixture connection; use only with student power OFF and disconnect stimulus before operation. Connect K_STIM.2 → Q_STIM.3. Hole path (19,11) → (19,10.5) → (13,10.5) → (13,16.5) → (6,16.5) → (6,16). Insulate every crossing; solder only the two endpoints. Confirm endpoint continuity (<1Ω for a wire) and no adjacent-net bridge; isolate parallel paths before measuring.
120. **Connect W37 · DIV_A:** Analog measurement, feedback or reference path; inspect polarity and compare with the specified calibration. Connect C_A.1 → R_A_BOTTOM.1. Hole path (35,3) → (35,16) → (25,16). Insulate every crossing; solder only the two endpoints.
121. **Verify W37 · DIV_A:** Power disconnected: Analog measurement, feedback or reference path; inspect polarity and compare with the specified calibration. Connect C_A.1 → R_A_BOTTOM.1. Hole path (35,3) → (35,16) → (25,16). Insulate every crossing; solder only the two endpoints. Confirm endpoint continuity (<1Ω for a wire) and no adjacent-net bridge; isolate parallel paths before measuring.
122. **Connect W38 · DIV_A:** Analog measurement, feedback or reference path; inspect polarity and compare with the specified calibration. Connect C_A.1 → R_A_TOP.2. Hole path (35,3) → (35,16) → (13,16). Insulate every crossing; solder only the two endpoints.
123. **Verify W38 · DIV_A:** Power disconnected: Analog measurement, feedback or reference path; inspect polarity and compare with the specified calibration. Connect C_A.1 → R_A_TOP.2. Hole path (35,3) → (35,16) → (13,16). Insulate every crossing; solder only the two endpoints. Confirm endpoint continuity (<1Ω for a wire) and no adjacent-net bridge; isolate parallel paths before measuring.
124. **Connect W39 · DIV_A:** Analog measurement, feedback or reference path; inspect polarity and compare with the specified calibration. Connect C_A.1 → U_BUFFER.3. Hole path (35,3) → (35,26) → (31,26). Insulate every crossing; solder only the two endpoints.
125. **Verify W39 · DIV_A:** Power disconnected: Analog measurement, feedback or reference path; inspect polarity and compare with the specified calibration. Connect C_A.1 → U_BUFFER.3. Hole path (35,3) → (35,26) → (31,26). Insulate every crossing; solder only the two endpoints. Confirm endpoint continuity (<1Ω for a wire) and no adjacent-net bridge; isolate parallel paths before measuring.
126. **Connect W40 · BUF_A:** Analog measurement, feedback or reference path; inspect polarity and compare with the specified calibration. Connect R_ADC_A.1 → U_BUFFER.1. Hole path (32,16) → (32,24) → (31,24). Insulate every crossing; solder only the two endpoints.
127. **Verify W40 · BUF_A:** Power disconnected: Analog measurement, feedback or reference path; inspect polarity and compare with the specified calibration. Connect R_ADC_A.1 → U_BUFFER.1. Hole path (32,16) → (32,24) → (31,24). Insulate every crossing; solder only the two endpoints. Confirm endpoint continuity (<1Ω for a wire) and no adjacent-net bridge; isolate parallel paths before measuring.
128. **Connect W41 · BUF_A:** Analog measurement, feedback or reference path; inspect polarity and compare with the specified calibration. Connect R_ADC_A.1 → U_BUFFER.2. Hole path (32,16) → (32,25) → (31,25). Insulate every crossing; solder only the two endpoints.
129. **Verify W41 · BUF_A:** Power disconnected: Analog measurement, feedback or reference path; inspect polarity and compare with the specified calibration. Connect R_ADC_A.1 → U_BUFFER.2. Hole path (32,16) → (32,25) → (31,25). Insulate every crossing; solder only the two endpoints. Confirm endpoint continuity (<1Ω for a wire) and no adjacent-net bridge; isolate parallel paths before measuring.
130. **Connect W42 · ADC_A:** Analog measurement, feedback or reference path; inspect polarity and compare with the specified calibration. Connect R_ADC_A.2 → U_ADC.4. Hole path (36,16) → (36,34) → (4,34). Insulate every crossing; solder only the two endpoints.
131. **Verify W42 · ADC_A:** Power disconnected: Analog measurement, feedback or reference path; inspect polarity and compare with the specified calibration. Connect R_ADC_A.2 → U_ADC.4. Hole path (36,16) → (36,34) → (4,34). Insulate every crossing; solder only the two endpoints. Confirm endpoint continuity (<1Ω for a wire) and no adjacent-net bridge; isolate parallel paths before measuring.
132. **Connect W43 · DIV_B:** Analog measurement, feedback or reference path; inspect polarity and compare with the specified calibration. Connect C_B.1 → R_B_BOTTOM.1. Hole path (11,22) → (4,22). Insulate every crossing; solder only the two endpoints.
133. **Verify W43 · DIV_B:** Power disconnected: Analog measurement, feedback or reference path; inspect polarity and compare with the specified calibration. Connect C_B.1 → R_B_BOTTOM.1. Hole path (11,22) → (4,22). Insulate every crossing; solder only the two endpoints. Confirm endpoint continuity (<1Ω for a wire) and no adjacent-net bridge; isolate parallel paths before measuring.
134. **Connect W44 · DIV_B:** Analog measurement, feedback or reference path; inspect polarity and compare with the specified calibration. Connect C_B.1 → R_B_TOP.2. Hole path (11,22) → (11,18) → (20,18). Insulate every crossing; solder only the two endpoints.
135. **Verify W44 · DIV_B:** Power disconnected: Analog measurement, feedback or reference path; inspect polarity and compare with the specified calibration. Connect C_B.1 → R_B_TOP.2. Hole path (11,22) → (11,18) → (20,18). Insulate every crossing; solder only the two endpoints. Confirm endpoint continuity (<1Ω for a wire) and no adjacent-net bridge; isolate parallel paths before measuring.
136. **Connect W45 · DIV_B:** Analog measurement, feedback or reference path; inspect polarity and compare with the specified calibration. Connect C_B.1 → U_BUFFER.5. Hole path (11,22) → (11,27) → (34,27). Insulate every crossing; solder only the two endpoints.
137. **Verify W45 · DIV_B:** Power disconnected: Analog measurement, feedback or reference path; inspect polarity and compare with the specified calibration. Connect C_B.1 → U_BUFFER.5. Hole path (11,22) → (11,27) → (34,27). Insulate every crossing; solder only the two endpoints. Confirm endpoint continuity (<1Ω for a wire) and no adjacent-net bridge; isolate parallel paths before measuring.
138. **Connect W46 · BUF_B:** Analog measurement, feedback or reference path; inspect polarity and compare with the specified calibration. Connect R_ADC_B.1 → U_BUFFER.6. Hole path (24,22) → (24,26) → (34,26). Insulate every crossing; solder only the two endpoints.
139. **Verify W46 · BUF_B:** Power disconnected: Analog measurement, feedback or reference path; inspect polarity and compare with the specified calibration. Connect R_ADC_B.1 → U_BUFFER.6. Hole path (24,22) → (24,26) → (34,26). Insulate every crossing; solder only the two endpoints. Confirm endpoint continuity (<1Ω for a wire) and no adjacent-net bridge; isolate parallel paths before measuring.
140. **Connect W47 · BUF_B:** Analog measurement, feedback or reference path; inspect polarity and compare with the specified calibration. Connect R_ADC_B.1 → U_BUFFER.7. Hole path (24,22) → (24,25) → (34,25). Insulate every crossing; solder only the two endpoints.
141. **Verify W47 · BUF_B:** Power disconnected: Analog measurement, feedback or reference path; inspect polarity and compare with the specified calibration. Connect R_ADC_B.1 → U_BUFFER.7. Hole path (24,22) → (24,25) → (34,25). Insulate every crossing; solder only the two endpoints. Confirm endpoint continuity (<1Ω for a wire) and no adjacent-net bridge; isolate parallel paths before measuring.
142. **Connect W48 · ADC_B:** Analog measurement, feedback or reference path; inspect polarity and compare with the specified calibration. Connect R_ADC_B.2 → U_ADC.5. Hole path (28,22) → (28,35) → (4,35). Insulate every crossing; solder only the two endpoints.
143. **Verify W48 · ADC_B:** Power disconnected: Analog measurement, feedback or reference path; inspect polarity and compare with the specified calibration. Connect R_ADC_B.2 → U_ADC.5. Hole path (28,22) → (28,35) → (4,35). Insulate every crossing; solder only the two endpoints. Confirm endpoint continuity (<1Ω for a wire) and no adjacent-net bridge; isolate parallel paths before measuring.
144. **Fit FIXTURE_CONTROL:** matrix.J_FIXTURE → continuity-fixture.J_CONTROL; verify each conductor and pin1 with power OFF. Keep unused supply and signal pins isolated until their consumers are installed.
145. **Inspect FIXTURE_CONTROL:** Power OFF: matrix.J_FIXTURE → continuity-fixture.J_CONTROL; verify each conductor and pin1 with power OFF. Keep unused supply and signal pins isolated until their consumers are installed.
146. **Fit test-links:** Unplug prototype positive; TEST_A→C4 / TEST_B→C1; JP_RETURN only during test. Remove both probes and return link before enabling.
147. **Inspect test-links:** Power OFF: Unplug prototype positive; TEST_A→C4 / TEST_B→C1; JP_RETURN only during test. Remove both probes and return link before enabling.
148. **Check the firmware contract:** factory fixed-pair continuity: GPIO4 SDA,16 SCL,25 stimulus; ADS1115 0x48; manual source isolation; reject open/wrong/inconclusive, fresh test + explicit enable
149. **Measure and record:** Student supply OFF and positive fixed-battery lead unplugged. TEST_A→C4, TEST_B→C1; fit JP_RETURN only during test. Check stimulus current ≤0.34mA and educational contact voltages 0–5.25V.
150. **Measure and record:** Calibrate open, a known short and 1kΩ. Measure open stimulus voltage Vs with DMM; infer R=10k×V/(Vs−V), accounting for divider gain and input loading. Known short ≤20Ω; ≥100Ω rejected; 20–100Ω or saturated/unstable readings inconclusive and OFF. Compare inferred short with DMM continuity <1Ω.
151. **Measure and record:** Test the actual four-piece scene: correct C4–C1 kit jumper passes; one lifted contact and wrong-node placements fail. Include alternate paths through LED/resistor in calibration; no false pass through a component.
152. **Film the win:** A lifted jumper contact is electronically rejected.
153. **Accept this checkpoint:** Verify the readings and construction, then accept CP01.

## Firmware contract (implementation pending)

factory fixed-pair continuity: GPIO4 SDA,16 SCL,25 stimulus; ADS1115 0x48; manual source isolation; reject open/wrong/inconclusive, fresh test + explicit enable

## Acceptance tests

1. Student supply OFF and positive fixed-battery lead unplugged. TEST_A→C4, TEST_B→C1; fit JP_RETURN only during test. Check stimulus current ≤0.34mA and educational contact voltages 0–5.25V.
2. Calibrate open, a known short and 1kΩ. Measure open stimulus voltage Vs with DMM; infer R=10k×V/(Vs−V), accounting for divider gain and input loading. Known short ≤20Ω; ≥100Ω rejected; 20–100Ω or saturated/unstable readings inconclusive and OFF. Compare inferred short with DMM continuity <1Ω.
3. Test the actual four-piece scene: correct C4–C1 kit jumper passes; one lifted contact and wrong-node placements fail. Include alternate paths through LED/resistor in calibration; no false pass through a component.

## Film the win

USB test-source positive lead unplugged; final supply and matrix leads absent. TEST_A→A1 C4, TEST_B→C1; JP_RETURN fitted only during diagnostic test. Before LED enable: stimulus OFF, JP_RETURN/probes removed, prototype positive restored with power OFF.

1. Show reject an open contact setup with power OFF and display firmware revision.
2. Demonstrate: A lifted jumper contact is electronically rejected.
3. Show the documented negative test and actual recorded readings.

**Negative example:** Lift the return jumper while retaining its convincing visual position: the electronic test rejects it.

Record readings and units, equipment, link positions, firmware revision and outcome. Firmware is a contract only; never film simulated readings as measured hardware evidence.
