gefgu/integration-workshop-3/eletronics/perfboard/cp03.md

# CP03 — Correction needs a fresh test

**Win:** Correcting the jumper requires a fresh pass and a separate enable request.

Build the assigned functional groups in the [assembly app](tscircuit/README.md). Earlier soldered wiring stays fixed. Removable links and top-side kit arrangements may change.

## Link positions

- USB test-source positive lead unplugged; final supply and matrix leads absent.
- TEST_A→A1 C4, TEST_B→C1; JP_RETURN fitted only during diagnostic test.
- Before LED enable: stimulus OFF, JP_RETURN/probes removed, prototype positive restored with power OFF.

## Guided actions

1. **Disconnect power and prepare:** Unplug USB and all educational sources before construction. USB test-source positive lead unplugged; final supply and matrix leads absent. TEST_A→A1 C4, TEST_B→C1; JP_RETURN fitted only during diagnostic test. Before LED enable: stimulus OFF, JP_RETURN/probes removed, prototype positive restored with power OFF.
2. **Check the firmware contract:** factory fixed-pair continuity: GPIO4 SDA,16 SCL,25 stimulus; ADS1115 0x48; manual source isolation; reject open/wrong/inconclusive, fresh test + explicit enable
3. **Measure and record:** Before enable: stimulus OFF, JP_RETURN removed, test leads disconnected, fixed battery lead restored with power off. No automatic enable after a passing test.
4. **Measure and record:** Simulated camera approval + failed/inconclusive electrical result keeps student supply OFF. Correction requires a fresh electrical test and separate enable request.
5. **Film the win:** Correcting the jumper requires a fresh pass and a separate enable request.
6. **Accept this checkpoint:** Verify the readings and construction, then accept CP03.

## Firmware contract (implementation pending)

factory fixed-pair continuity: GPIO4 SDA,16 SCL,25 stimulus; ADS1115 0x48; manual source isolation; reject open/wrong/inconclusive, fresh test + explicit enable

## Acceptance tests

1. Before enable: stimulus OFF, JP_RETURN removed, test leads disconnected, fixed battery lead restored with power off. No automatic enable after a passing test.
2. Simulated camera approval + failed/inconclusive electrical result keeps student supply OFF. Correction requires a fresh electrical test and separate enable request.

## Film the win

USB test-source positive lead unplugged; final supply and matrix leads absent. TEST_A→A1 C4, TEST_B→C1; JP_RETURN fitted only during diagnostic test. Before LED enable: stimulus OFF, JP_RETURN/probes removed, prototype positive restored with power OFF.

1. Show correction needs a fresh test setup with power OFF and display firmware revision.
2. Demonstrate: Correcting the jumper requires a fresh pass and a separate enable request.
3. Show the documented negative test and actual recorded readings.

**Negative example:** Refit the correct jumper without a new test: it must remain OFF until a fresh pass and separate enable request.

Record readings and units, equipment, link positions, firmware revision and outcome. Firmware is a contract only; never film simulated readings as measured hardware evidence.
