gefgu/integration-workshop-3/eletronics/perfboard/cp05-matrix-board.md

# Historical checkpoint filename

New builds follow the [guided sequence](cp24.md) in the [assembly app](tscircuit/README.md). Existing project catalogs retain their old checkpoint meaning; this filename does not migrate their progress.
