gefgu/integration-workshop-3/eletronics/perfboard/cp07-modules-a2-a3.md

# Historical checkpoint filename

New builds follow the [guided sequence](cp27.md) in the [assembly app](tscircuit/README.md). Existing project catalogs retain their old checkpoint meaning; this filename does not migrate their progress.
