gefgu/integration-workshop-3/eletronics/perfboard/cp09.md

# CP09 — Regulated rails

**Win:** The isolated final regulators produce their specified voltages.

Build the assigned functional groups in the [assembly app](tscircuit/README.md). Earlier soldered wiring stays fixed. Removable links and top-side kit arrangements may change.

## Link positions

- USB prototype source and prototype 3V3 links removed before final supplies connect.
- Use checkpoint-specific bounded test loads; stop and isolate power before changing any link.

## Guided actions

1. **Disconnect power and prepare:** Unplug USB and all educational sources before construction. USB prototype source and prototype 3V3 links removed before final supplies connect. Use checkpoint-specific bounded test loads; stop and isolate power before changing any link.
2. **Place J_INPUT:** J_INPUT: input; 5.5x2.1 mm barrel pigtail, centre positive. Part of 12-V input and separately isolated regulator outputs. Mount on the top side; red pad identifies pin 1. 
3. **Inspect J_INPUT:** Power OFF: inspect every terminal, polarity, seating and solder joint. J_INPUT: input; 5.5x2.1 mm barrel pigtail, centre positive. Part of 12-V input and separately isolated regulator outputs. Mount on the top side; red pad identifies pin 1. 
4. **Place F_INPUT:** F_INPUT: input; 2A slow fuse. Part of 12-V input and separately isolated regulator outputs. Mount on the top side; red pad identifies pin 1. 
5. **Inspect F_INPUT:** Power OFF: inspect every terminal, polarity, seating and solder joint. F_INPUT: input; 2A slow fuse. Part of 12-V input and separately isolated regulator outputs. Mount on the top side; red pad identifies pin 1. 
6. **Place J_SW_MAIN:** J_SW_MAIN: sw main; latching switch, 3A at 12V DC. Part of 12-V input and separately isolated regulator outputs. Mount on the top side; red pad identifies pin 1. 
7. **Inspect J_SW_MAIN:** Power OFF: inspect every terminal, polarity, seating and solder joint. J_SW_MAIN: sw main; latching switch, 3A at 12V DC. Part of 12-V input and separately isolated regulator outputs. Mount on the top side; red pad identifies pin 1. 
8. **Place D_REVERSE:** D_REVERSE: reverse; 1N5822. Part of 12-V input and separately isolated regulator outputs. Mount on the top side; red pad identifies pin 1. 
9. **Inspect D_REVERSE:** Power OFF: inspect every terminal, polarity, seating and solder joint. D_REVERSE: reverse; 1N5822. Part of 12-V input and separately isolated regulator outputs. Mount on the top side; red pad identifies pin 1. 
10. **Place C_INPUT:** C_INPUT: input; 470uF. Part of 12-V input and separately isolated regulator outputs. Mount on the top side; red pad identifies pin 1. Polarized: verify POS/NEG. 
11. **Inspect C_INPUT:** Power OFF: inspect every terminal, polarity, seating and solder joint. C_INPUT: input; 470uF. Part of 12-V input and separately isolated regulator outputs. Mount on the top side; red pad identifies pin 1. Polarized: verify POS/NEG. 
12. **Place C_INPUT_HF:** C_INPUT_HF: input hf; 100nF. Part of 12-V input and separately isolated regulator outputs. Mount on the top side; red pad identifies pin 1. 
13. **Inspect C_INPUT_HF:** Power OFF: inspect every terminal, polarity, seating and solder joint. C_INPUT_HF: input hf; 100nF. Part of 12-V input and separately isolated regulator outputs. Mount on the top side; red pad identifies pin 1. 
14. **Place J_BUCK_5V:** J_BUCK_5V: buck 5v; Pigtail → external Pololu D24V22F5, fixed 5V. Part of 12-V input and separately isolated regulator outputs. Mount on the top side; red pad identifies pin 1. Actual purchased dimensions must be measured before release.
15. **Inspect J_BUCK_5V:** Power OFF: inspect every terminal, polarity, seating and solder joint. J_BUCK_5V: buck 5v; Pigtail → external Pololu D24V22F5, fixed 5V. Part of 12-V input and separately isolated regulator outputs. Mount on the top side; red pad identifies pin 1. Actual purchased dimensions must be measured before release.
16. **Place J_BUCK_3V3:** J_BUCK_3V3: buck 3v3; Pigtail → external Pololu D24V22F3, fixed 3.3V. Part of 12-V input and separately isolated regulator outputs. Mount on the top side; red pad identifies pin 1. Actual purchased dimensions must be measured before release.
17. **Inspect J_BUCK_3V3:** Power OFF: inspect every terminal, polarity, seating and solder joint. J_BUCK_3V3: buck 3v3; Pigtail → external Pololu D24V22F3, fixed 3.3V. Part of 12-V input and separately isolated regulator outputs. Mount on the top side; red pad identifies pin 1. Actual purchased dimensions must be measured before release.
18. **Place JP_LOGIC:** JP_LOGIC: logic; removable 5-V consumer link. Part of 12-V input and separately isolated regulator outputs. Mount on the top side; red pad identifies pin 1. 
19. **Inspect JP_LOGIC:** Power OFF: inspect every terminal, polarity, seating and solder joint. JP_LOGIC: logic; removable 5-V consumer link. Part of 12-V input and separately isolated regulator outputs. Mount on the top side; red pad identifies pin 1. 
20. **Place JP_3V3:** JP_3V3: 3v3; removable 3.3-V consumer link. Part of 12-V input and separately isolated regulator outputs. Mount on the top side; red pad identifies pin 1. 
21. **Inspect JP_3V3:** Power OFF: inspect every terminal, polarity, seating and solder joint. JP_3V3: 3v3; removable 3.3-V consumer link. Part of 12-V input and separately isolated regulator outputs. Mount on the top side; red pad identifies pin 1. 
22. **Place J_MATRIX:** J_MATRIX: matrix; POWER_MATRIX v2. Part of Keyed power/control cables and test points. Mount on the top side; red pad identifies pin 1. 
23. **Inspect J_MATRIX:** Power OFF: inspect every terminal, polarity, seating and solder joint. J_MATRIX: matrix; POWER_MATRIX v2. Part of Keyed power/control cables and test points. Mount on the top side; red pad identifies pin 1. 
24. **Place J_SMART:** J_SMART: smart; POWER_SMART v2. Part of Keyed power/control cables and test points. Mount on the top side; red pad identifies pin 1. 
25. **Inspect J_SMART:** Power OFF: inspect every terminal, polarity, seating and solder joint. J_SMART: smart; POWER_SMART v2. Part of Keyed power/control cables and test points. Mount on the top side; red pad identifies pin 1. 
26. **Place J_FIXED_BATTERY:** J_FIXED_BATTERY: fixed battery; fixed battery patch lead: C2 positive, C1 ground; unplug before matrix mode. Part of Keyed power/control cables and test points. Mount on the top side; red pad identifies pin 1. 
27. **Inspect J_FIXED_BATTERY:** Power OFF: inspect every terminal, polarity, seating and solder joint. J_FIXED_BATTERY: fixed battery; fixed battery patch lead: C2 positive, C1 ground; unplug before matrix mode. Part of Keyed power/control cables and test points. Mount on the top side; red pad identifies pin 1. 
28. **Place J_TEST:** J_TEST: test; scope / known load fixture. Part of Keyed power/control cables and test points. Mount on the top side; red pad identifies pin 1. 
29. **Inspect J_TEST:** Power OFF: inspect every terminal, polarity, seating and solder joint. J_TEST: test; scope / known load fixture. Part of Keyed power/control cables and test points. Mount on the top side; red pad identifies pin 1. 
30. **Connect W1 · 12V_IN:** Bench input or matrix supply; observe polarity and keep it away from educational contacts. Connect F_INPUT.1 → J_INPUT.1. Hole path (10,3) → (10,2.5) → (7.5,2.5) → (7.5,3.5) → (6,3.5) → (6,3). Insulate every crossing; solder only the two endpoints.
31. **Verify W1 · 12V_IN:** Power disconnected: Bench input or matrix supply; observe polarity and keep it away from educational contacts. Connect F_INPUT.1 → J_INPUT.1. Hole path (10,3) → (10,2.5) → (7.5,2.5) → (7.5,3.5) → (6,3.5) → (6,3). Insulate every crossing; solder only the two endpoints. Confirm endpoint continuity (<1Ω for a wire) and no adjacent-net bridge; isolate parallel paths before measuring.
32. **Connect W2 · GND:** Common electrical reference and return; keep student, USB and service ground identities consistent. Connect C_INPUT_HF.2 → C_INPUT.2. Hole path (34,3) → (34,2.5) → (32,2.5) → (32,3.5) → (30,3.5) → (30,3). Insulate every crossing; solder only the two endpoints.
33. **Verify W2 · GND:** Power disconnected: Common electrical reference and return; keep student, USB and service ground identities consistent. Connect C_INPUT_HF.2 → C_INPUT.2. Hole path (34,3) → (34,2.5) → (32,2.5) → (32,3.5) → (30,3.5) → (30,3). Insulate every crossing; solder only the two endpoints. Confirm endpoint continuity (<1Ω for a wire) and no adjacent-net bridge; isolate parallel paths before measuring.
34. **Connect W3 · GND:** Common electrical reference and return; keep student, USB and service ground identities consistent. Connect C_INPUT_HF.2 → J_BUCK_3V3.4. Hole path (34,3) → (34,2.5) → (25,2.5) → (25,8.5) → (15,8.5) → (15,8). Insulate every crossing; solder only the two endpoints.
35. **Verify W3 · GND:** Power disconnected: Common electrical reference and return; keep student, USB and service ground identities consistent. Connect C_INPUT_HF.2 → J_BUCK_3V3.4. Hole path (34,3) → (34,2.5) → (25,2.5) → (25,8.5) → (15,8.5) → (15,8). Insulate every crossing; solder only the two endpoints. Confirm endpoint continuity (<1Ω for a wire) and no adjacent-net bridge; isolate parallel paths before measuring.
36. **Connect W4 · GND:** Common electrical reference and return; keep student, USB and service ground identities consistent. Connect C_INPUT_HF.2 → J_BUCK_5V.4. Hole path (34,3) → (34,2.5) → (21,2.5) → (21,8.5) → (8,8.5) → (8,8). Insulate every crossing; solder only the two endpoints.
37. **Verify W4 · GND:** Power disconnected: Common electrical reference and return; keep student, USB and service ground identities consistent. Connect C_INPUT_HF.2 → J_BUCK_5V.4. Hole path (34,3) → (34,2.5) → (21,2.5) → (21,8.5) → (8,8.5) → (8,8). Insulate every crossing; solder only the two endpoints. Confirm endpoint continuity (<1Ω for a wire) and no adjacent-net bridge; isolate parallel paths before measuring.
38. **Connect W5 · GND:** Common electrical reference and return; keep student, USB and service ground identities consistent. Connect C_INPUT_HF.2 → J_FIXED_BATTERY.2. Hole path (34,3) → (34,2.5) → (36,2.5) → (36,66.5) → (37,66.5) → (37,66). Insulate every crossing; solder only the two endpoints.
39. **Verify W5 · GND:** Power disconnected: Common electrical reference and return; keep student, USB and service ground identities consistent. Connect C_INPUT_HF.2 → J_FIXED_BATTERY.2. Hole path (34,3) → (34,2.5) → (36,2.5) → (36,66.5) → (37,66.5) → (37,66). Insulate every crossing; solder only the two endpoints. Confirm endpoint continuity (<1Ω for a wire) and no adjacent-net bridge; isolate parallel paths before measuring.
40. **Connect W6 · GND:** Common electrical reference and return; keep student, USB and service ground identities consistent. Connect C_INPUT_HF.2 → J_INPUT.2. Hole path (34,3) → (34,2.5) → (21,2.5) → (21,3.5) → (7,3.5) → (7,3). Insulate every crossing; solder only the two endpoints.
41. **Verify W6 · GND:** Power disconnected: Common electrical reference and return; keep student, USB and service ground identities consistent. Connect C_INPUT_HF.2 → J_INPUT.2. Hole path (34,3) → (34,2.5) → (21,2.5) → (21,3.5) → (7,3.5) → (7,3). Insulate every crossing; solder only the two endpoints. Confirm endpoint continuity (<1Ω for a wire) and no adjacent-net bridge; isolate parallel paths before measuring.
42. **Connect W7 · GND:** Common electrical reference and return; keep student, USB and service ground identities consistent. Connect C_INPUT_HF.2 → J_MATRIX.2. Hole path (34,3) → (34,2.5) → (20,2.5) → (20,72.5) → (5,72.5) → (5,72). Insulate every crossing; solder only the two endpoints.
43. **Verify W7 · GND:** Power disconnected: Common electrical reference and return; keep student, USB and service ground identities consistent. Connect C_INPUT_HF.2 → J_MATRIX.2. Hole path (34,3) → (34,2.5) → (20,2.5) → (20,72.5) → (5,72.5) → (5,72). Insulate every crossing; solder only the two endpoints. Confirm endpoint continuity (<1Ω for a wire) and no adjacent-net bridge; isolate parallel paths before measuring.
44. **Connect W8 · GND:** Common electrical reference and return; keep student, USB and service ground identities consistent. Connect C_INPUT_HF.2 → J_SMART.2. Hole path (34,3) → (34,2.5) → (33,2.5) → (33,74.5) → (31,74.5) → (31,74). Insulate every crossing; solder only the two endpoints.
45. **Verify W8 · GND:** Power disconnected: Common electrical reference and return; keep student, USB and service ground identities consistent. Connect C_INPUT_HF.2 → J_SMART.2. Hole path (34,3) → (34,2.5) → (33,2.5) → (33,74.5) → (31,74.5) → (31,74). Insulate every crossing; solder only the two endpoints. Confirm endpoint continuity (<1Ω for a wire) and no adjacent-net bridge; isolate parallel paths before measuring.
46. **Connect W9 · GND:** Common electrical reference and return; keep student, USB and service ground identities consistent. Connect C_INPUT_HF.2 → J_SMART.4. Hole path (34,3) → (34,2.5) → (33,2.5) → (33,74.5) → (32,74.5) → (32,74). Insulate every crossing; solder only the two endpoints.
47. **Verify W9 · GND:** Power disconnected: Common electrical reference and return; keep student, USB and service ground identities consistent. Connect C_INPUT_HF.2 → J_SMART.4. Hole path (34,3) → (34,2.5) → (33,2.5) → (33,74.5) → (32,74.5) → (32,74). Insulate every crossing; solder only the two endpoints. Confirm endpoint continuity (<1Ω for a wire) and no adjacent-net bridge; isolate parallel paths before measuring.
48. **Connect W10 · GND:** Common electrical reference and return; keep student, USB and service ground identities consistent. Connect C_INPUT_HF.2 → J_SMART.6. Hole path (34,3) → (34,2.5) → (34,74.5) → (33,74.5) → (33,74). Insulate every crossing; solder only the two endpoints.
49. **Verify W10 · GND:** Power disconnected: Common electrical reference and return; keep student, USB and service ground identities consistent. Connect C_INPUT_HF.2 → J_SMART.6. Hole path (34,3) → (34,2.5) → (34,74.5) → (33,74.5) → (33,74). Insulate every crossing; solder only the two endpoints. Confirm endpoint continuity (<1Ω for a wire) and no adjacent-net bridge; isolate parallel paths before measuring.
50. **Connect W11 · GND:** Common electrical reference and return; keep student, USB and service ground identities consistent. Connect C_INPUT_HF.2 → J_TEST.2. Hole path (34,3) → (34,2.5) → (25,2.5) → (25,71.5) → (15,71.5) → (15,71). Insulate every crossing; solder only the two endpoints.
51. **Verify W11 · GND:** Power disconnected: Common electrical reference and return; keep student, USB and service ground identities consistent. Connect C_INPUT_HF.2 → J_TEST.2. Hole path (34,3) → (34,2.5) → (25,2.5) → (25,71.5) → (15,71.5) → (15,71). Insulate every crossing; solder only the two endpoints. Confirm endpoint continuity (<1Ω for a wire) and no adjacent-net bridge; isolate parallel paths before measuring.
52. **Connect W57 · 12V_FUSED:** Bench input or matrix supply; observe polarity and keep it away from educational contacts. Connect F_INPUT.2 → J_SW_MAIN.1. Hole path (14,3) → (14,2.5) → (16.5,2.5) → (16.5,3.5) → (17,3.5) → (17,3). Insulate every crossing; solder only the two endpoints.
53. **Verify W57 · 12V_FUSED:** Power disconnected: Bench input or matrix supply; observe polarity and keep it away from educational contacts. Connect F_INPUT.2 → J_SW_MAIN.1. Hole path (14,3) → (14,2.5) → (16.5,2.5) → (16.5,3.5) → (17,3.5) → (17,3). Insulate every crossing; solder only the two endpoints. Confirm endpoint continuity (<1Ω for a wire) and no adjacent-net bridge; isolate parallel paths before measuring.
54. **Connect W58 · 12V_SWITCHED:** Bench input or matrix supply; observe polarity and keep it away from educational contacts. Connect D_REVERSE.1 → J_SW_MAIN.2. Hole path (21,3) → (21,2.5) → (19.5,2.5) → (19.5,3.5) → (18,3.5) → (18,3). Insulate every crossing; solder only the two endpoints.
55. **Verify W58 · 12V_SWITCHED:** Power disconnected: Bench input or matrix supply; observe polarity and keep it away from educational contacts. Connect D_REVERSE.1 → J_SW_MAIN.2. Hole path (21,3) → (21,2.5) → (19.5,2.5) → (19.5,3.5) → (18,3.5) → (18,3). Insulate every crossing; solder only the two endpoints. Confirm endpoint continuity (<1Ω for a wire) and no adjacent-net bridge; isolate parallel paths before measuring.
56. **Connect W59 · 12V_SYS:** Bench input or matrix supply; observe polarity and keep it away from educational contacts. Connect C_INPUT_HF.1 → C_INPUT.1. Hole path (33,3) → (33,2.5) → (31,2.5) → (31,3.5) → (28,3.5) → (28,3). Insulate every crossing; solder only the two endpoints.
57. **Verify W59 · 12V_SYS:** Power disconnected: Bench input or matrix supply; observe polarity and keep it away from educational contacts. Connect C_INPUT_HF.1 → C_INPUT.1. Hole path (33,3) → (33,2.5) → (31,2.5) → (31,3.5) → (28,3.5) → (28,3). Insulate every crossing; solder only the two endpoints. Confirm endpoint continuity (<1Ω for a wire) and no adjacent-net bridge; isolate parallel paths before measuring.
58. **Connect W60 · 12V_SYS:** Bench input or matrix supply; observe polarity and keep it away from educational contacts. Connect C_INPUT_HF.1 → D_REVERSE.2. Hole path (33,3) → (33,2.5) → (29,2.5) → (29,3.5) → (25,3.5) → (25,3). Insulate every crossing; solder only the two endpoints.
59. **Verify W60 · 12V_SYS:** Power disconnected: Bench input or matrix supply; observe polarity and keep it away from educational contacts. Connect C_INPUT_HF.1 → D_REVERSE.2. Hole path (33,3) → (33,2.5) → (29,2.5) → (29,3.5) → (25,3.5) → (25,3). Insulate every crossing; solder only the two endpoints. Confirm endpoint continuity (<1Ω for a wire) and no adjacent-net bridge; isolate parallel paths before measuring.
60. **Connect W61 · 12V_SYS:** Bench input or matrix supply; observe polarity and keep it away from educational contacts. Connect C_INPUT_HF.1 → J_BUCK_3V3.3. Hole path (33,3) → (33,2.5) → (24,2.5) → (24,8.5) → (14,8.5) → (14,8). Insulate every crossing; solder only the two endpoints.
61. **Verify W61 · 12V_SYS:** Power disconnected: Bench input or matrix supply; observe polarity and keep it away from educational contacts. Connect C_INPUT_HF.1 → J_BUCK_3V3.3. Hole path (33,3) → (33,2.5) → (24,2.5) → (24,8.5) → (14,8.5) → (14,8). Insulate every crossing; solder only the two endpoints. Confirm endpoint continuity (<1Ω for a wire) and no adjacent-net bridge; isolate parallel paths before measuring.
62. **Connect W62 · 12V_SYS:** Bench input or matrix supply; observe polarity and keep it away from educational contacts. Connect C_INPUT_HF.1 → J_BUCK_5V.3. Hole path (33,3) → (33,2.5) → (20,2.5) → (20,8.5) → (7,8.5) → (7,8). Insulate every crossing; solder only the two endpoints.
63. **Verify W62 · 12V_SYS:** Power disconnected: Bench input or matrix supply; observe polarity and keep it away from educational contacts. Connect C_INPUT_HF.1 → J_BUCK_5V.3. Hole path (33,3) → (33,2.5) → (20,2.5) → (20,8.5) → (7,8.5) → (7,8). Insulate every crossing; solder only the two endpoints. Confirm endpoint continuity (<1Ω for a wire) and no adjacent-net bridge; isolate parallel paths before measuring.
64. **Connect W63 · 12V_SYS:** Bench input or matrix supply; observe polarity and keep it away from educational contacts. Connect C_INPUT_HF.1 → J_MATRIX.10. Hole path (33,3) → (33,2.5) → (21,2.5) → (21,72.5) → (9,72.5) → (9,72). Insulate every crossing; solder only the two endpoints.
65. **Verify W63 · 12V_SYS:** Power disconnected: Bench input or matrix supply; observe polarity and keep it away from educational contacts. Connect C_INPUT_HF.1 → J_MATRIX.10. Hole path (33,3) → (33,2.5) → (21,2.5) → (21,72.5) → (9,72.5) → (9,72). Insulate every crossing; solder only the two endpoints. Confirm endpoint continuity (<1Ω for a wire) and no adjacent-net bridge; isolate parallel paths before measuring.
66. **Connect W79 · 5V_SYS:** Logic supply or current-protection path; verify the named supply domain and current direction. Connect J_MATRIX.4 → J_SMART.1. Hole path (6,72) → (6,71.5) → (19.5,71.5) → (19.5,73.5) → (31,73.5) → (31,73). Insulate every crossing; solder only the two endpoints.
67. **Verify W79 · 5V_SYS:** Power disconnected: Logic supply or current-protection path; verify the named supply domain and current direction. Connect J_MATRIX.4 → J_SMART.1. Hole path (6,72) → (6,71.5) → (19.5,71.5) → (19.5,73.5) → (31,73.5) → (31,73). Insulate every crossing; solder only the two endpoints. Confirm endpoint continuity (<1Ω for a wire) and no adjacent-net bridge; isolate parallel paths before measuring.
68. **Connect W80 · 5V_SYS:** Logic supply or current-protection path; verify the named supply domain and current direction. Connect J_MATRIX.4 → JP_LOGIC.2. Hole path (6,72) → (6,71.5) → (13.5,71.5) → (13.5,8.5) → (20,8.5) → (20,8). Insulate every crossing; solder only the two endpoints.
69. **Verify W80 · 5V_SYS:** Power disconnected: Logic supply or current-protection path; verify the named supply domain and current direction. Connect J_MATRIX.4 → JP_LOGIC.2. Hole path (6,72) → (6,71.5) → (13.5,71.5) → (13.5,8.5) → (20,8.5) → (20,8). Insulate every crossing; solder only the two endpoints. Confirm endpoint continuity (<1Ω for a wire) and no adjacent-net bridge; isolate parallel paths before measuring.
70. **Connect W89 · 3V3_SYS:** 3.3-V electronics supply. USB and bench supply domains must not be bridged. Connect J_MATRIX.3 → J_SMART.5. Hole path (6,71) → (6,70.5) → (20,70.5) → (20,73.5) → (33,73.5) → (33,73). Insulate every crossing; solder only the two endpoints.
71. **Verify W89 · 3V3_SYS:** Power disconnected: 3.3-V electronics supply. USB and bench supply domains must not be bridged. Connect J_MATRIX.3 → J_SMART.5. Hole path (6,71) → (6,70.5) → (20,70.5) → (20,73.5) → (33,73.5) → (33,73). Insulate every crossing; solder only the two endpoints. Confirm endpoint continuity (<1Ω for a wire) and no adjacent-net bridge; isolate parallel paths before measuring.
72. **Connect W90 · 3V3_SYS:** 3.3-V electronics supply. USB and bench supply domains must not be bridged. Connect J_MATRIX.3 → JP_3V3.2. Hole path (6,71) → (6,70.5) → (15,70.5) → (15,8.5) → (24,8.5) → (24,8). Insulate every crossing; solder only the two endpoints.
73. **Verify W90 · 3V3_SYS:** Power disconnected: 3.3-V electronics supply. USB and bench supply domains must not be bridged. Connect J_MATRIX.3 → JP_3V3.2. Hole path (6,71) → (6,70.5) → (15,70.5) → (15,8.5) → (24,8.5) → (24,8). Insulate every crossing; solder only the two endpoints. Confirm endpoint continuity (<1Ω for a wire) and no adjacent-net bridge; isolate parallel paths before measuring.
74. **Connect W132 · 5V_EDU:** Protected student supply, enabled only by the fault latch, watchdog and an explicit valid request. Connect J_FIXED_BATTERY.1 → J_MATRIX.1. Hole path (36,66) → (36,65.5) → (20.5,65.5) → (20.5,71.5) → (5,71.5) → (5,71). Insulate every crossing; solder only the two endpoints.
75. **Verify W132 · 5V_EDU:** Power disconnected: Protected student supply, enabled only by the fault latch, watchdog and an explicit valid request. Connect J_FIXED_BATTERY.1 → J_MATRIX.1. Hole path (36,66) → (36,65.5) → (20.5,65.5) → (20.5,71.5) → (5,71.5) → (5,71). Insulate every crossing; solder only the two endpoints. Confirm endpoint continuity (<1Ω for a wire) and no adjacent-net bridge; isolate parallel paths before measuring.
76. **Connect W133 · 5V_EDU:** Protected student supply, enabled only by the fault latch, watchdog and an explicit valid request. Connect J_FIXED_BATTERY.1 → J_SMART.3. Hole path (36,66) → (36,65.5) → (33.5,65.5) → (33.5,73.5) → (32,73.5) → (32,73). Insulate every crossing; solder only the two endpoints.
77. **Verify W133 · 5V_EDU:** Power disconnected: Protected student supply, enabled only by the fault latch, watchdog and an explicit valid request. Connect J_FIXED_BATTERY.1 → J_SMART.3. Hole path (36,66) → (36,65.5) → (33.5,65.5) → (33.5,73.5) → (32,73.5) → (32,73). Insulate every crossing; solder only the two endpoints. Confirm endpoint continuity (<1Ω for a wire) and no adjacent-net bridge; isolate parallel paths before measuring.
78. **Connect W134 · 5V_EDU:** Protected student supply, enabled only by the fault latch, watchdog and an explicit valid request. Connect J_FIXED_BATTERY.1 → J_TEST.1. Hole path (36,66) → (36,65.5) → (24.5,65.5) → (24.5,71.5) → (14,71.5) → (14,71). Insulate every crossing; solder only the two endpoints.
79. **Verify W134 · 5V_EDU:** Power disconnected: Protected student supply, enabled only by the fault latch, watchdog and an explicit valid request. Connect J_FIXED_BATTERY.1 → J_TEST.1. Hole path (36,66) → (36,65.5) → (24.5,65.5) → (24.5,71.5) → (14,71.5) → (14,71). Insulate every crossing; solder only the two endpoints. Confirm endpoint continuity (<1Ω for a wire) and no adjacent-net bridge; isolate parallel paths before measuring.
80. **Connect W139 · CURRENT_SENSE:** Analog measurement, feedback or reference path; inspect polarity and compare with the specified calibration. Connect J_MATRIX.8 → J_TEST.4. Hole path (8,72) → (8,71) → (17,71). Insulate every crossing; solder only the two endpoints.
81. **Verify W139 · CURRENT_SENSE:** Power disconnected: Analog measurement, feedback or reference path; inspect polarity and compare with the specified calibration. Connect J_MATRIX.8 → J_TEST.4. Hole path (8,72) → (8,71) → (17,71). Insulate every crossing; solder only the two endpoints. Confirm endpoint continuity (<1Ω for a wire) and no adjacent-net bridge; isolate parallel paths before measuring.
82. **Connect W156 · EDU_FAULT:** Protection, reset or readiness control; its defined polarity must preserve OFF at startup and on faults. Connect J_MATRIX.6 → J_TEST.6. Hole path (7,72) → (7,71.5) → (13,71.5) → (19,71.5) → (19,71). Insulate every crossing; solder only the two endpoints.
83. **Verify W156 · EDU_FAULT:** Power disconnected: Protection, reset or readiness control; its defined polarity must preserve OFF at startup and on faults. Connect J_MATRIX.6 → J_TEST.6. Hole path (7,72) → (7,71.5) → (13,71.5) → (19,71.5) → (19,71). Insulate every crossing; solder only the two endpoints. Confirm endpoint continuity (<1Ω for a wire) and no adjacent-net bridge; isolate parallel paths before measuring.
84. **Fit buck5:** Pololu D24V22F5, external 12V source, consumer links open; measured fit and voltage required.
85. **Inspect buck5:** Power OFF: Pololu D24V22F5, external 12V source, consumer links open; measured fit and voltage required.
86. **Fit buck3:** Pololu D24V22F3, consumer links open; qualify source before connecting consumers.
87. **Inspect buck3:** Power OFF: Pololu D24V22F3, consumer links open; qualify source before connecting consumers.
88. **Check the firmware contract:** factory final-power qualification: explicit enable/reset; supervised ALIVE link only before CP13; no production authorization
89. **Measure and record:** Unpowered: every rail >1kΩ to GND after capacitor charging; no accidental node/service connection.
90. **Measure and record:** With links open: 5V buck 4.90–5.04V; 3.3V buck 3.20–3.38V. Current-limited 12V supply, 100mA initially.
91. **Film the win:** The isolated final regulators produce their specified voltages.
92. **Accept this checkpoint:** Verify the readings and construction, then accept CP09.

## Firmware contract (implementation pending)

factory final-power qualification: explicit enable/reset; supervised ALIVE link only before CP13; no production authorization

## Acceptance tests

1. Unpowered: every rail >1kΩ to GND after capacitor charging; no accidental node/service connection.
2. With links open: 5V buck 4.90–5.04V; 3.3V buck 3.20–3.38V. Current-limited 12V supply, 100mA initially.

## Film the win

USB prototype source and prototype 3V3 links removed before final supplies connect. Use checkpoint-specific bounded test loads; stop and isolate power before changing any link.

1. Show regulated rails setup with power OFF and display firmware revision.
2. Demonstrate: The isolated final regulators produce their specified voltages.
3. Show the documented negative test and actual recorded readings.

**Negative example:** Apply no input: outputs remain unpowered; never invent a regulator reading.

Record readings and units, equipment, link positions, firmware revision and outcome. Firmware is a contract only; never film simulated readings as measured hardware evidence.
