gefgu/integration-workshop-3/eletronics/perfboard/cp11.md

# CP11 — OFF at startup and reset

**Win:** The final student rail remains OFF at startup and reset.

Build the assigned functional groups in the [assembly app](tscircuit/README.md). Earlier soldered wiring stays fixed. Removable links and top-side kit arrangements may change.

## Link positions

- USB prototype source and prototype 3V3 links removed before final supplies connect.
- Use checkpoint-specific bounded test loads; stop and isolate power before changing any link.
- Factory ALIVE fixture is temporary: J_PROTOTYPE pin2 USB3V3→J_POWER pin9 only during supervised load qualification. LOW/open for startup/reset; remove permanently before CP13.

## Guided actions

1. **Disconnect power and prepare:** Unplug USB and all educational sources before construction. USB prototype source and prototype 3V3 links removed before final supplies connect. Use checkpoint-specific bounded test loads; stop and isolate power before changing any link. Factory ALIVE fixture is temporary: J_PROTOTYPE pin2 USB3V3→J_POWER pin9 only during supervised load qualification. LOW/open for startup/reset; remove permanently before CP13.
2. **Place F_EDU:** F_EDU: edu; MF-R050. Part of PTC, MOSFET and current sense. Mount on the top side; red pad identifies pin 1. 
3. **Inspect F_EDU:** Power OFF: inspect every terminal, polarity, seating and solder joint. F_EDU: edu; MF-R050. Part of PTC, MOSFET and current sense. Mount on the top side; red pad identifies pin 1. 
4. **Place Q_PASS:** Q_PASS: pass; NDP6020P. Part of PTC, MOSFET and current sense. Mount on the top side; red pad identifies pin 1. 
5. **Inspect Q_PASS:** Power OFF: inspect every terminal, polarity, seating and solder joint. Q_PASS: pass; NDP6020P. Part of PTC, MOSFET and current sense. Mount on the top side; red pad identifies pin 1. 
6. **Place R_GATE_OFF:** R_GATE_OFF: gate off; 10k. Part of PTC, MOSFET and current sense. Mount on the top side; red pad identifies pin 1. 
7. **Inspect R_GATE_OFF:** Power OFF: inspect every terminal, polarity, seating and solder joint. R_GATE_OFF: gate off; 10k. Part of PTC, MOSFET and current sense. Mount on the top side; red pad identifies pin 1. 
8. **Place Q_ENABLE:** Q_ENABLE: enable; 2N7000. Part of PTC, MOSFET and current sense. Mount on the top side; red pad identifies pin 1. 
9. **Inspect Q_ENABLE:** Power OFF: inspect every terminal, polarity, seating and solder joint. Q_ENABLE: enable; 2N7000. Part of PTC, MOSFET and current sense. Mount on the top side; red pad identifies pin 1. 
10. **Place R_SHUNT:** R_SHUNT: shunt; 10. Part of PTC, MOSFET and current sense. Mount on the top side; red pad identifies pin 1. 
11. **Inspect R_SHUNT:** Power OFF: inspect every terminal, polarity, seating and solder joint. R_SHUNT: shunt; 10. Part of PTC, MOSFET and current sense. Mount on the top side; red pad identifies pin 1. 
12. **Place C_EDU:** C_EDU: edu; 100nF. Part of PTC, MOSFET and current sense. Mount on the top side; red pad identifies pin 1. 
13. **Inspect C_EDU:** Power OFF: inspect every terminal, polarity, seating and solder joint. C_EDU: edu; 100nF. Part of PTC, MOSFET and current sense. Mount on the top side; red pad identifies pin 1. 
14. **Place U_SENSE:** U_SENSE: sense; INA180A1IDBVR. Part of PTC, MOSFET and current sense. Install on SOT23-5 to numbered single-row adapter; verify manufacturer pin numbering. Mount on the top side; red pad identifies pin 1. 
15. **Inspect U_SENSE:** Power OFF: inspect every terminal, polarity, seating and solder joint. U_SENSE: sense; INA180A1IDBVR. Part of PTC, MOSFET and current sense. Install on SOT23-5 to numbered single-row adapter; verify manufacturer pin numbering. Mount on the top side; red pad identifies pin 1. 
16. **Place C_SENSE:** C_SENSE: sense; 100nF. Part of PTC, MOSFET and current sense. Mount on the top side; red pad identifies pin 1. 
17. **Inspect C_SENSE:** Power OFF: inspect every terminal, polarity, seating and solder joint. C_SENSE: sense; 100nF. Part of PTC, MOSFET and current sense. Mount on the top side; red pad identifies pin 1. 
18. **Place U_REF:** U_REF: ref; TL431ACLP. Part of Precision trip reference and actual rail detection. Mount on the top side; red pad identifies pin 1. 
19. **Inspect U_REF:** Power OFF: inspect every terminal, polarity, seating and solder joint. U_REF: ref; TL431ACLP. Part of Precision trip reference and actual rail detection. Mount on the top side; red pad identifies pin 1. 
20. **Place R_REF_FEED:** R_REF_FEED: ref feed; 1k. Part of Precision trip reference and actual rail detection. Mount on the top side; red pad identifies pin 1. 
21. **Inspect R_REF_FEED:** Power OFF: inspect every terminal, polarity, seating and solder joint. R_REF_FEED: ref feed; 1k. Part of Precision trip reference and actual rail detection. Mount on the top side; red pad identifies pin 1. 
22. **Place R_TRIP_TOP:** R_TRIP_TOP: trip top; 5.11k. Part of Precision trip reference and actual rail detection. Mount on the top side; red pad identifies pin 1. 
23. **Inspect R_TRIP_TOP:** Power OFF: inspect every terminal, polarity, seating and solder joint. R_TRIP_TOP: trip top; 5.11k. Part of Precision trip reference and actual rail detection. Mount on the top side; red pad identifies pin 1. 
24. **Place R_TRIP_BOTTOM:** R_TRIP_BOTTOM: trip bottom; 46.4k. Part of Precision trip reference and actual rail detection. Mount on the top side; red pad identifies pin 1. 
25. **Inspect R_TRIP_BOTTOM:** Power OFF: inspect every terminal, polarity, seating and solder joint. R_TRIP_BOTTOM: trip bottom; 46.4k. Part of Precision trip reference and actual rail detection. Mount on the top side; red pad identifies pin 1. 
26. **Place R_EDU_TOP:** R_EDU_TOP: edu top; 47k. Part of Precision trip reference and actual rail detection. Mount on the top side; red pad identifies pin 1. 
27. **Inspect R_EDU_TOP:** Power OFF: inspect every terminal, polarity, seating and solder joint. R_EDU_TOP: edu top; 47k. Part of Precision trip reference and actual rail detection. Mount on the top side; red pad identifies pin 1. 
28. **Place R_EDU_BOTTOM:** R_EDU_BOTTOM: edu bottom; 47k. Part of Precision trip reference and actual rail detection. Mount on the top side; red pad identifies pin 1. 
29. **Inspect R_EDU_BOTTOM:** Power OFF: inspect every terminal, polarity, seating and solder joint. R_EDU_BOTTOM: edu bottom; 47k. Part of Precision trip reference and actual rail detection. Mount on the top side; red pad identifies pin 1. 
30. **Place U_TRIP:** U_TRIP: trip; LM393P. Part of Precision trip reference and actual rail detection. Mount on the top side; red pad identifies pin 1. 
31. **Inspect U_TRIP:** Power OFF: inspect every terminal, polarity, seating and solder joint. U_TRIP: trip; LM393P. Part of Precision trip reference and actual rail detection. Mount on the top side; red pad identifies pin 1. 
32. **Place C_TRIP:** C_TRIP: trip; 100nF. Part of Precision trip reference and actual rail detection. Mount on the top side; red pad identifies pin 1. 
33. **Inspect C_TRIP:** Power OFF: inspect every terminal, polarity, seating and solder joint. C_TRIP: trip; 100nF. Part of Precision trip reference and actual rail detection. Mount on the top side; red pad identifies pin 1. 
34. **Place R_PRESET:** R_PRESET: preset; 10k. Part of Precision trip reference and actual rail detection. Mount on the top side; red pad identifies pin 1. 
35. **Inspect R_PRESET:** Power OFF: inspect every terminal, polarity, seating and solder joint. R_PRESET: preset; 10k. Part of Precision trip reference and actual rail detection. Mount on the top side; red pad identifies pin 1. 
36. **Place R_EDU_ON:** R_EDU_ON: edu on; 10k. Part of Precision trip reference and actual rail detection. Mount on the top side; red pad identifies pin 1. 
37. **Inspect R_EDU_ON:** Power OFF: inspect every terminal, polarity, seating and solder joint. R_EDU_ON: edu on; 10k. Part of Precision trip reference and actual rail detection. Mount on the top side; red pad identifies pin 1. 
38. **Place U_POR:** U_POR: por; MCP130-300DI/TO. Part of Fault latch and simultaneous-reset interlock. Mount on the top side; red pad identifies pin 1. 
39. **Inspect U_POR:** Power OFF: inspect every terminal, polarity, seating and solder joint. U_POR: por; MCP130-300DI/TO. Part of Fault latch and simultaneous-reset interlock. Mount on the top side; red pad identifies pin 1. 
40. **Place U_FAULT:** U_FAULT: fault; SN74HC74N. Part of Fault latch and simultaneous-reset interlock. Mount on the top side; red pad identifies pin 1. 
41. **Inspect U_FAULT:** Power OFF: inspect every terminal, polarity, seating and solder joint. U_FAULT: fault; SN74HC74N. Part of Fault latch and simultaneous-reset interlock. Mount on the top side; red pad identifies pin 1. 
42. **Place C_FAULT:** C_FAULT: fault; 100nF. Part of Fault latch and simultaneous-reset interlock. Mount on the top side; red pad identifies pin 1. 
43. **Inspect C_FAULT:** Power OFF: inspect every terminal, polarity, seating and solder joint. C_FAULT: fault; 100nF. Part of Fault latch and simultaneous-reset interlock. Mount on the top side; red pad identifies pin 1. 
44. **Place U_RESET:** U_RESET: reset; SN74HC00N. Part of Fault latch and simultaneous-reset interlock. Mount on the top side; red pad identifies pin 1. 
45. **Inspect U_RESET:** Power OFF: inspect every terminal, polarity, seating and solder joint. U_RESET: reset; SN74HC00N. Part of Fault latch and simultaneous-reset interlock. Mount on the top side; red pad identifies pin 1. 
46. **Place C_RESET:** C_RESET: reset; 100nF. Part of Fault latch and simultaneous-reset interlock. Mount on the top side; red pad identifies pin 1. 
47. **Inspect C_RESET:** Power OFF: inspect every terminal, polarity, seating and solder joint. C_RESET: reset; 100nF. Part of Fault latch and simultaneous-reset interlock. Mount on the top side; red pad identifies pin 1. 
48. **Place U_ALLOW:** U_ALLOW: allow; SN74HC08N. Part of Fault latch and simultaneous-reset interlock. Mount on the top side; red pad identifies pin 1. 
49. **Inspect U_ALLOW:** Power OFF: inspect every terminal, polarity, seating and solder joint. U_ALLOW: allow; SN74HC08N. Part of Fault latch and simultaneous-reset interlock. Mount on the top side; red pad identifies pin 1. 
50. **Place C_ALLOW:** C_ALLOW: allow; 100nF. Part of Fault latch and simultaneous-reset interlock. Mount on the top side; red pad identifies pin 1. 
51. **Inspect C_ALLOW:** Power OFF: inspect every terminal, polarity, seating and solder joint. C_ALLOW: allow; 100nF. Part of Fault latch and simultaneous-reset interlock. Mount on the top side; red pad identifies pin 1. 
52. **Place R_EDU_PWR_EN_OFF:** R_EDU_PWR_EN_OFF: edu pwr en off; 100k. Part of Fault latch and simultaneous-reset interlock. Mount on the top side; red pad identifies pin 1. 
53. **Inspect R_EDU_PWR_EN_OFF:** Power OFF: inspect every terminal, polarity, seating and solder joint. R_EDU_PWR_EN_OFF: edu pwr en off; 100k. Part of Fault latch and simultaneous-reset interlock. Mount on the top side; red pad identifies pin 1. 
54. **Place R_EDU_FAULT_RESET_OFF:** R_EDU_FAULT_RESET_OFF: edu fault reset off; 100k. Part of Fault latch and simultaneous-reset interlock. Mount on the top side; red pad identifies pin 1. 
55. **Inspect R_EDU_FAULT_RESET_OFF:** Power OFF: inspect every terminal, polarity, seating and solder joint. R_EDU_FAULT_RESET_OFF: edu fault reset off; 100k. Part of Fault latch and simultaneous-reset interlock. Mount on the top side; red pad identifies pin 1. 
56. **Place R_ROUTER_ALIVE_OFF:** R_ROUTER_ALIVE_OFF: router alive off; 100k. Part of Fault latch and simultaneous-reset interlock. Mount on the top side; red pad identifies pin 1. 
57. **Inspect R_ROUTER_ALIVE_OFF:** Power OFF: inspect every terminal, polarity, seating and solder joint. R_ROUTER_ALIVE_OFF: router alive off; 100k. Part of Fault latch and simultaneous-reset interlock. Mount on the top side; red pad identifies pin 1. 
58. **Place R_BATTERY_LED:** R_BATTERY_LED: battery led; 2.2k. Part of Visible student battery state. Mount on the top side; red pad identifies pin 1. 
59. **Inspect R_BATTERY_LED:** Power OFF: inspect every terminal, polarity, seating and solder joint. R_BATTERY_LED: battery led; 2.2k. Part of Visible student battery state. Mount on the top side; red pad identifies pin 1. 
60. **Place LED_BATTERY:** LED_BATTERY: battery; red LED — actual student rail on. Part of Visible student battery state. Mount on the top side; red pad identifies pin 1. 
61. **Inspect LED_BATTERY:** Power OFF: inspect every terminal, polarity, seating and solder joint. LED_BATTERY: battery; red LED — actual student rail on. Part of Visible student battery state. Mount on the top side; red pad identifies pin 1. 
62. **Place Q_BATTERY_LED:** Q_BATTERY_LED: battery led; 2N7000. Part of Visible student battery state. Mount on the top side; red pad identifies pin 1. 
63. **Inspect Q_BATTERY_LED:** Power OFF: inspect every terminal, polarity, seating and solder joint. Q_BATTERY_LED: battery led; 2N7000. Part of Visible student battery state. Mount on the top side; red pad identifies pin 1. 
64. **Place R_LED_GATE_OFF:** R_LED_GATE_OFF: led gate off; 100k. Part of Visible student battery state. Mount on the top side; red pad identifies pin 1. 
65. **Inspect R_LED_GATE_OFF:** Power OFF: inspect every terminal, polarity, seating and solder joint. R_LED_GATE_OFF: led gate off; 100k. Part of Visible student battery state. Mount on the top side; red pad identifies pin 1. 
66. **Connect W22 · GND:** Common electrical reference and return; keep student, USB and service ground identities consistent. Connect C_INPUT_HF.2 → C_ALLOW.2. Hole path (34,3) → (34,2.5) → (20,2.5) → (20,55.5) → (6,55.5) → (6,55). Insulate every crossing; solder only the two endpoints.
67. **Verify W22 · GND:** Power disconnected: Common electrical reference and return; keep student, USB and service ground identities consistent. Connect C_INPUT_HF.2 → C_ALLOW.2. Hole path (34,3) → (34,2.5) → (20,2.5) → (20,55.5) → (6,55.5) → (6,55). Insulate every crossing; solder only the two endpoints. Confirm endpoint continuity (<1Ω for a wire) and no adjacent-net bridge; isolate parallel paths before measuring.
68. **Connect W23 · GND:** Common electrical reference and return; keep student, USB and service ground identities consistent. Connect C_INPUT_HF.2 → C_EDU.2. Hole path (34,3) → (34,2.5) → (35,2.5) → (35,29.5) → (35,29). Insulate every crossing; solder only the two endpoints.
69. **Verify W23 · GND:** Power disconnected: Common electrical reference and return; keep student, USB and service ground identities consistent. Connect C_INPUT_HF.2 → C_EDU.2. Hole path (34,3) → (34,2.5) → (35,2.5) → (35,29.5) → (35,29). Insulate every crossing; solder only the two endpoints. Confirm endpoint continuity (<1Ω for a wire) and no adjacent-net bridge; isolate parallel paths before measuring.
70. **Connect W24 · GND:** Common electrical reference and return; keep student, USB and service ground identities consistent. Connect C_INPUT_HF.2 → C_FAULT.2. Hole path (34,3) → (34,2.5) → (20,2.5) → (20,50.5) → (6,50.5) → (6,50). Insulate every crossing; solder only the two endpoints.
71. **Verify W24 · GND:** Power disconnected: Common electrical reference and return; keep student, USB and service ground identities consistent. Connect C_INPUT_HF.2 → C_FAULT.2. Hole path (34,3) → (34,2.5) → (20,2.5) → (20,50.5) → (6,50.5) → (6,50). Insulate every crossing; solder only the two endpoints. Confirm endpoint continuity (<1Ω for a wire) and no adjacent-net bridge; isolate parallel paths before measuring.
72. **Connect W25 · GND:** Common electrical reference and return; keep student, USB and service ground identities consistent. Connect C_INPUT_HF.2 → C_RESET.2. Hole path (34,3) → (34,2.5) → (30,2.5) → (30,52.5) → (25,52.5) → (25,52). Insulate every crossing; solder only the two endpoints.
73. **Verify W25 · GND:** Power disconnected: Common electrical reference and return; keep student, USB and service ground identities consistent. Connect C_INPUT_HF.2 → C_RESET.2. Hole path (34,3) → (34,2.5) → (30,2.5) → (30,52.5) → (25,52.5) → (25,52). Insulate every crossing; solder only the two endpoints. Confirm endpoint continuity (<1Ω for a wire) and no adjacent-net bridge; isolate parallel paths before measuring.
74. **Connect W26 · GND:** Common electrical reference and return; keep student, USB and service ground identities consistent. Connect C_INPUT_HF.2 → C_SENSE.2. Hole path (34,3) → (34,2.5) → (27,2.5) → (27,34.5) → (19,34.5) → (19,34). Insulate every crossing; solder only the two endpoints.
75. **Verify W26 · GND:** Power disconnected: Common electrical reference and return; keep student, USB and service ground identities consistent. Connect C_INPUT_HF.2 → C_SENSE.2. Hole path (34,3) → (34,2.5) → (27,2.5) → (27,34.5) → (19,34.5) → (19,34). Insulate every crossing; solder only the two endpoints. Confirm endpoint continuity (<1Ω for a wire) and no adjacent-net bridge; isolate parallel paths before measuring.
76. **Connect W27 · GND:** Common electrical reference and return; keep student, USB and service ground identities consistent. Connect C_INPUT_HF.2 → C_TRIP.2. Hole path (34,3) → (34,2.5) → (35,2.5) → (35,34.5) → (35,34). Insulate every crossing; solder only the two endpoints.
77. **Verify W27 · GND:** Power disconnected: Common electrical reference and return; keep student, USB and service ground identities consistent. Connect C_INPUT_HF.2 → C_TRIP.2. Hole path (34,3) → (34,2.5) → (35,2.5) → (35,34.5) → (35,34). Insulate every crossing; solder only the two endpoints. Confirm endpoint continuity (<1Ω for a wire) and no adjacent-net bridge; isolate parallel paths before measuring.
78. **Connect W28 · GND:** Common electrical reference and return; keep student, USB and service ground identities consistent. Connect C_INPUT_HF.2 → Q_BATTERY_LED.1. Hole path (34,3) → (34,2.5) → (33,2.5) → (33,66.5) → (31,66.5) → (31,66). Insulate every crossing; solder only the two endpoints.
79. **Verify W28 · GND:** Power disconnected: Common electrical reference and return; keep student, USB and service ground identities consistent. Connect C_INPUT_HF.2 → Q_BATTERY_LED.1. Hole path (34,3) → (34,2.5) → (33,2.5) → (33,66.5) → (31,66.5) → (31,66). Insulate every crossing; solder only the two endpoints. Confirm endpoint continuity (<1Ω for a wire) and no adjacent-net bridge; isolate parallel paths before measuring.
80. **Connect W29 · GND:** Common electrical reference and return; keep student, USB and service ground identities consistent. Connect C_INPUT_HF.2 → Q_ENABLE.1. Hole path (34,3) → (34,2.5) → (32,2.5) → (32,29.5) → (29,29.5) → (29,29). Insulate every crossing; solder only the two endpoints.
81. **Verify W29 · GND:** Power disconnected: Common electrical reference and return; keep student, USB and service ground identities consistent. Connect C_INPUT_HF.2 → Q_ENABLE.1. Hole path (34,3) → (34,2.5) → (32,2.5) → (32,29.5) → (29,29.5) → (29,29). Insulate every crossing; solder only the two endpoints. Confirm endpoint continuity (<1Ω for a wire) and no adjacent-net bridge; isolate parallel paths before measuring.
82. **Connect W30 · GND:** Common electrical reference and return; keep student, USB and service ground identities consistent. Connect C_INPUT_HF.2 → R_EDU_BOTTOM.2. Hole path (34,3) → (34,2.5) → (35,2.5) → (35,40.5) → (36,40.5) → (36,40). Insulate every crossing; solder only the two endpoints.
83. **Verify W30 · GND:** Power disconnected: Common electrical reference and return; keep student, USB and service ground identities consistent. Connect C_INPUT_HF.2 → R_EDU_BOTTOM.2. Hole path (34,3) → (34,2.5) → (35,2.5) → (35,40.5) → (36,40.5) → (36,40). Insulate every crossing; solder only the two endpoints. Confirm endpoint continuity (<1Ω for a wire) and no adjacent-net bridge; isolate parallel paths before measuring.
84. **Connect W31 · GND:** Common electrical reference and return; keep student, USB and service ground identities consistent. Connect C_INPUT_HF.2 → R_EDU_FAULT_RESET_OFF.2. Hole path (34,3) → (34,2.5) → (35,2.5) → (35,60.5) → (35,60). Insulate every crossing; solder only the two endpoints.
85. **Verify W31 · GND:** Power disconnected: Common electrical reference and return; keep student, USB and service ground identities consistent. Connect C_INPUT_HF.2 → R_EDU_FAULT_RESET_OFF.2. Hole path (34,3) → (34,2.5) → (35,2.5) → (35,60.5) → (35,60). Insulate every crossing; solder only the two endpoints. Confirm endpoint continuity (<1Ω for a wire) and no adjacent-net bridge; isolate parallel paths before measuring.
86. **Connect W32 · GND:** Common electrical reference and return; keep student, USB and service ground identities consistent. Connect C_INPUT_HF.2 → R_EDU_PWR_EN_OFF.2. Hole path (34,3) → (34,2.5) → (31,2.5) → (31,57.5) → (28,57.5) → (28,57). Insulate every crossing; solder only the two endpoints.
87. **Verify W32 · GND:** Power disconnected: Common electrical reference and return; keep student, USB and service ground identities consistent. Connect C_INPUT_HF.2 → R_EDU_PWR_EN_OFF.2. Hole path (34,3) → (34,2.5) → (31,2.5) → (31,57.5) → (28,57.5) → (28,57). Insulate every crossing; solder only the two endpoints. Confirm endpoint continuity (<1Ω for a wire) and no adjacent-net bridge; isolate parallel paths before measuring.
88. **Connect W33 · GND:** Common electrical reference and return; keep student, USB and service ground identities consistent. Connect C_INPUT_HF.2 → R_LED_GATE_OFF.2. Hole path (34,3) → (34,2.5) → (30,2.5) → (30,67.5) → (26,67.5) → (26,67). Insulate every crossing; solder only the two endpoints.
89. **Verify W33 · GND:** Power disconnected: Common electrical reference and return; keep student, USB and service ground identities consistent. Connect C_INPUT_HF.2 → R_LED_GATE_OFF.2. Hole path (34,3) → (34,2.5) → (30,2.5) → (30,67.5) → (26,67.5) → (26,67). Insulate every crossing; solder only the two endpoints. Confirm endpoint continuity (<1Ω for a wire) and no adjacent-net bridge; isolate parallel paths before measuring.
90. **Connect W34 · GND:** Common electrical reference and return; keep student, USB and service ground identities consistent. Connect C_INPUT_HF.2 → R_ROUTER_ALIVE_OFF.2. Hole path (34,3) → (34,2.5) → (31,2.5) → (31,62.5) → (28,62.5) → (28,62). Insulate every crossing; solder only the two endpoints.
91. **Verify W34 · GND:** Power disconnected: Common electrical reference and return; keep student, USB and service ground identities consistent. Connect C_INPUT_HF.2 → R_ROUTER_ALIVE_OFF.2. Hole path (34,3) → (34,2.5) → (31,2.5) → (31,62.5) → (28,62.5) → (28,62). Insulate every crossing; solder only the two endpoints. Confirm endpoint continuity (<1Ω for a wire) and no adjacent-net bridge; isolate parallel paths before measuring.
92. **Connect W35 · GND:** Common electrical reference and return; keep student, USB and service ground identities consistent. Connect C_INPUT_HF.2 → R_TRIP_BOTTOM.2. Hole path (34,3) → (34,2.5) → (28,2.5) → (28,40.5) → (22,40.5) → (22,40). Insulate every crossing; solder only the two endpoints.
93. **Verify W35 · GND:** Power disconnected: Common electrical reference and return; keep student, USB and service ground identities consistent. Connect C_INPUT_HF.2 → R_TRIP_BOTTOM.2. Hole path (34,3) → (34,2.5) → (28,2.5) → (28,40.5) → (22,40.5) → (22,40). Insulate every crossing; solder only the two endpoints. Confirm endpoint continuity (<1Ω for a wire) and no adjacent-net bridge; isolate parallel paths before measuring.
94. **Connect W36 · GND:** Common electrical reference and return; keep student, USB and service ground identities consistent. Connect C_INPUT_HF.2 → U_ALLOW.7. Hole path (34,3) → (34,2.5) → (22,2.5) → (22,62.5) → (9,62.5) → (9,62). Insulate every crossing; solder only the two endpoints.
95. **Verify W36 · GND:** Power disconnected: Common electrical reference and return; keep student, USB and service ground identities consistent. Connect C_INPUT_HF.2 → U_ALLOW.7. Hole path (34,3) → (34,2.5) → (22,2.5) → (22,62.5) → (9,62.5) → (9,62). Insulate every crossing; solder only the two endpoints. Confirm endpoint continuity (<1Ω for a wire) and no adjacent-net bridge; isolate parallel paths before measuring.
96. **Connect W37 · GND:** Common electrical reference and return; keep student, USB and service ground identities consistent. Connect C_INPUT_HF.2 → U_ALLOW.9. Hole path (34,3) → (34,2.5) → (23,2.5) → (23,61.5) → (12,61.5) → (12,61). Insulate every crossing; solder only the two endpoints.
97. **Verify W37 · GND:** Power disconnected: Common electrical reference and return; keep student, USB and service ground identities consistent. Connect C_INPUT_HF.2 → U_ALLOW.9. Hole path (34,3) → (34,2.5) → (23,2.5) → (23,61.5) → (12,61.5) → (12,61). Insulate every crossing; solder only the two endpoints. Confirm endpoint continuity (<1Ω for a wire) and no adjacent-net bridge; isolate parallel paths before measuring.
98. **Connect W38 · GND:** Common electrical reference and return; keep student, USB and service ground identities consistent. Connect C_INPUT_HF.2 → U_ALLOW.10. Hole path (34,3) → (34,2.5) → (23,2.5) → (23,60.5) → (12,60.5) → (12,60). Insulate every crossing; solder only the two endpoints.
99. **Verify W38 · GND:** Power disconnected: Common electrical reference and return; keep student, USB and service ground identities consistent. Connect C_INPUT_HF.2 → U_ALLOW.10. Hole path (34,3) → (34,2.5) → (23,2.5) → (23,60.5) → (12,60.5) → (12,60). Insulate every crossing; solder only the two endpoints. Confirm endpoint continuity (<1Ω for a wire) and no adjacent-net bridge; isolate parallel paths before measuring.
100. **Connect W39 · GND:** Common electrical reference and return; keep student, USB and service ground identities consistent. Connect C_INPUT_HF.2 → U_ALLOW.12. Hole path (34,3) → (34,2.5) → (23,2.5) → (23,58.5) → (12,58.5) → (12,58). Insulate every crossing; solder only the two endpoints.
101. **Verify W39 · GND:** Power disconnected: Common electrical reference and return; keep student, USB and service ground identities consistent. Connect C_INPUT_HF.2 → U_ALLOW.12. Hole path (34,3) → (34,2.5) → (23,2.5) → (23,58.5) → (12,58.5) → (12,58). Insulate every crossing; solder only the two endpoints. Confirm endpoint continuity (<1Ω for a wire) and no adjacent-net bridge; isolate parallel paths before measuring.
102. **Connect W40 · GND:** Common electrical reference and return; keep student, USB and service ground identities consistent. Connect C_INPUT_HF.2 → U_ALLOW.13. Hole path (34,3) → (34,2.5) → (23,2.5) → (23,57.5) → (12,57.5) → (12,57). Insulate every crossing; solder only the two endpoints.
103. **Verify W40 · GND:** Power disconnected: Common electrical reference and return; keep student, USB and service ground identities consistent. Connect C_INPUT_HF.2 → U_ALLOW.13. Hole path (34,3) → (34,2.5) → (23,2.5) → (23,57.5) → (12,57.5) → (12,57). Insulate every crossing; solder only the two endpoints. Confirm endpoint continuity (<1Ω for a wire) and no adjacent-net bridge; isolate parallel paths before measuring.
104. **Connect W41 · GND:** Common electrical reference and return; keep student, USB and service ground identities consistent. Connect C_INPUT_HF.2 → U_FAULT.2. Hole path (34,3) → (34,2.5) → (33,2.5) → (33,48.5) → (31,48.5) → (31,48). Insulate every crossing; solder only the two endpoints.
105. **Verify W41 · GND:** Power disconnected: Common electrical reference and return; keep student, USB and service ground identities consistent. Connect C_INPUT_HF.2 → U_FAULT.2. Hole path (34,3) → (34,2.5) → (33,2.5) → (33,48.5) → (31,48.5) → (31,48). Insulate every crossing; solder only the two endpoints. Confirm endpoint continuity (<1Ω for a wire) and no adjacent-net bridge; isolate parallel paths before measuring.
106. **Connect W42 · GND:** Common electrical reference and return; keep student, USB and service ground identities consistent. Connect C_INPUT_HF.2 → U_FAULT.3. Hole path (34,3) → (34,2.5) → (33,2.5) → (33,49.5) → (31,49.5) → (31,49). Insulate every crossing; solder only the two endpoints.
107. **Verify W42 · GND:** Power disconnected: Common electrical reference and return; keep student, USB and service ground identities consistent. Connect C_INPUT_HF.2 → U_FAULT.3. Hole path (34,3) → (34,2.5) → (33,2.5) → (33,49.5) → (31,49.5) → (31,49). Insulate every crossing; solder only the two endpoints. Confirm endpoint continuity (<1Ω for a wire) and no adjacent-net bridge; isolate parallel paths before measuring.
108. **Connect W43 · GND:** Common electrical reference and return; keep student, USB and service ground identities consistent. Connect C_INPUT_HF.2 → U_FAULT.7. Hole path (34,3) → (34,2.5) → (33,2.5) → (33,53.5) → (31,53.5) → (31,53). Insulate every crossing; solder only the two endpoints.
109. **Verify W43 · GND:** Power disconnected: Common electrical reference and return; keep student, USB and service ground identities consistent. Connect C_INPUT_HF.2 → U_FAULT.7. Hole path (34,3) → (34,2.5) → (33,2.5) → (33,53.5) → (31,53.5) → (31,53). Insulate every crossing; solder only the two endpoints. Confirm endpoint continuity (<1Ω for a wire) and no adjacent-net bridge; isolate parallel paths before measuring.
110. **Connect W44 · GND:** Common electrical reference and return; keep student, USB and service ground identities consistent. Connect C_INPUT_HF.2 → U_FAULT.11. Hole path (34,3) → (34,2.5) → (34,50.5) → (34,50). Insulate every crossing; solder only the two endpoints.
111. **Verify W44 · GND:** Power disconnected: Common electrical reference and return; keep student, USB and service ground identities consistent. Connect C_INPUT_HF.2 → U_FAULT.11. Hole path (34,3) → (34,2.5) → (34,50.5) → (34,50). Insulate every crossing; solder only the two endpoints. Confirm endpoint continuity (<1Ω for a wire) and no adjacent-net bridge; isolate parallel paths before measuring.
112. **Connect W45 · GND:** Common electrical reference and return; keep student, USB and service ground identities consistent. Connect C_INPUT_HF.2 → U_FAULT.12. Hole path (34,3) → (34,2.5) → (34,49.5) → (34,49). Insulate every crossing; solder only the two endpoints.
113. **Verify W45 · GND:** Power disconnected: Common electrical reference and return; keep student, USB and service ground identities consistent. Connect C_INPUT_HF.2 → U_FAULT.12. Hole path (34,3) → (34,2.5) → (34,49.5) → (34,49). Insulate every crossing; solder only the two endpoints. Confirm endpoint continuity (<1Ω for a wire) and no adjacent-net bridge; isolate parallel paths before measuring.
114. **Connect W46 · GND:** Common electrical reference and return; keep student, USB and service ground identities consistent. Connect C_INPUT_HF.2 → U_POR.3. Hole path (34,3) → (34,2.5) → (31,2.5) → (31,45.5) → (28,45.5) → (28,45). Insulate every crossing; solder only the two endpoints.
115. **Verify W46 · GND:** Power disconnected: Common electrical reference and return; keep student, USB and service ground identities consistent. Connect C_INPUT_HF.2 → U_POR.3. Hole path (34,3) → (34,2.5) → (31,2.5) → (31,45.5) → (28,45.5) → (28,45). Insulate every crossing; solder only the two endpoints. Confirm endpoint continuity (<1Ω for a wire) and no adjacent-net bridge; isolate parallel paths before measuring.
116. **Connect W47 · GND:** Common electrical reference and return; keep student, USB and service ground identities consistent. Connect C_INPUT_HF.2 → U_REF.2. Hole path (34,3) → (34,2.5) → (29,2.5) → (29,34.5) → (23,34.5) → (23,34). Insulate every crossing; solder only the two endpoints.
117. **Verify W47 · GND:** Power disconnected: Common electrical reference and return; keep student, USB and service ground identities consistent. Connect C_INPUT_HF.2 → U_REF.2. Hole path (34,3) → (34,2.5) → (29,2.5) → (29,34.5) → (23,34.5) → (23,34). Insulate every crossing; solder only the two endpoints. Confirm endpoint continuity (<1Ω for a wire) and no adjacent-net bridge; isolate parallel paths before measuring.
118. **Connect W48 · GND:** Common electrical reference and return; keep student, USB and service ground identities consistent. Connect C_INPUT_HF.2 → U_RESET.4. Hole path (34,3) → (34,2.5) → (26,2.5) → (26,55.5) → (18,55.5) → (18,55). Insulate every crossing; solder only the two endpoints.
119. **Verify W48 · GND:** Power disconnected: Common electrical reference and return; keep student, USB and service ground identities consistent. Connect C_INPUT_HF.2 → U_RESET.4. Hole path (34,3) → (34,2.5) → (26,2.5) → (26,55.5) → (18,55.5) → (18,55). Insulate every crossing; solder only the two endpoints. Confirm endpoint continuity (<1Ω for a wire) and no adjacent-net bridge; isolate parallel paths before measuring.
120. **Connect W49 · GND:** Common electrical reference and return; keep student, USB and service ground identities consistent. Connect C_INPUT_HF.2 → U_RESET.5. Hole path (34,3) → (34,2.5) → (26,2.5) → (26,56.5) → (18,56.5) → (18,56). Insulate every crossing; solder only the two endpoints.
121. **Verify W49 · GND:** Power disconnected: Common electrical reference and return; keep student, USB and service ground identities consistent. Connect C_INPUT_HF.2 → U_RESET.5. Hole path (34,3) → (34,2.5) → (26,2.5) → (26,56.5) → (18,56.5) → (18,56). Insulate every crossing; solder only the two endpoints. Confirm endpoint continuity (<1Ω for a wire) and no adjacent-net bridge; isolate parallel paths before measuring.
122. **Connect W50 · GND:** Common electrical reference and return; keep student, USB and service ground identities consistent. Connect C_INPUT_HF.2 → U_RESET.7. Hole path (34,3) → (34,2.5) → (26,2.5) → (26,58.5) → (18,58.5) → (18,58). Insulate every crossing; solder only the two endpoints.
123. **Verify W50 · GND:** Power disconnected: Common electrical reference and return; keep student, USB and service ground identities consistent. Connect C_INPUT_HF.2 → U_RESET.7. Hole path (34,3) → (34,2.5) → (26,2.5) → (26,58.5) → (18,58.5) → (18,58). Insulate every crossing; solder only the two endpoints. Confirm endpoint continuity (<1Ω for a wire) and no adjacent-net bridge; isolate parallel paths before measuring.
124. **Connect W51 · GND:** Common electrical reference and return; keep student, USB and service ground identities consistent. Connect C_INPUT_HF.2 → U_RESET.9. Hole path (34,3) → (34,2.5) → (28,2.5) → (28,57.5) → (21,57.5) → (21,57). Insulate every crossing; solder only the two endpoints.
125. **Verify W51 · GND:** Power disconnected: Common electrical reference and return; keep student, USB and service ground identities consistent. Connect C_INPUT_HF.2 → U_RESET.9. Hole path (34,3) → (34,2.5) → (28,2.5) → (28,57.5) → (21,57.5) → (21,57). Insulate every crossing; solder only the two endpoints. Confirm endpoint continuity (<1Ω for a wire) and no adjacent-net bridge; isolate parallel paths before measuring.
126. **Connect W52 · GND:** Common electrical reference and return; keep student, USB and service ground identities consistent. Connect C_INPUT_HF.2 → U_RESET.10. Hole path (34,3) → (34,2.5) → (28,2.5) → (28,56.5) → (21,56.5) → (21,56). Insulate every crossing; solder only the two endpoints.
127. **Verify W52 · GND:** Power disconnected: Common electrical reference and return; keep student, USB and service ground identities consistent. Connect C_INPUT_HF.2 → U_RESET.10. Hole path (34,3) → (34,2.5) → (28,2.5) → (28,56.5) → (21,56.5) → (21,56). Insulate every crossing; solder only the two endpoints. Confirm endpoint continuity (<1Ω for a wire) and no adjacent-net bridge; isolate parallel paths before measuring.
128. **Connect W53 · GND:** Common electrical reference and return; keep student, USB and service ground identities consistent. Connect C_INPUT_HF.2 → U_RESET.12. Hole path (34,3) → (34,2.5) → (28,2.5) → (28,54.5) → (21,54.5) → (21,54). Insulate every crossing; solder only the two endpoints.
129. **Verify W53 · GND:** Power disconnected: Common electrical reference and return; keep student, USB and service ground identities consistent. Connect C_INPUT_HF.2 → U_RESET.12. Hole path (34,3) → (34,2.5) → (28,2.5) → (28,54.5) → (21,54.5) → (21,54). Insulate every crossing; solder only the two endpoints. Confirm endpoint continuity (<1Ω for a wire) and no adjacent-net bridge; isolate parallel paths before measuring.
130. **Connect W54 · GND:** Common electrical reference and return; keep student, USB and service ground identities consistent. Connect C_INPUT_HF.2 → U_RESET.13. Hole path (34,3) → (34,2.5) → (28,2.5) → (28,53.5) → (21,53.5) → (21,53). Insulate every crossing; solder only the two endpoints.
131. **Verify W54 · GND:** Power disconnected: Common electrical reference and return; keep student, USB and service ground identities consistent. Connect C_INPUT_HF.2 → U_RESET.13. Hole path (34,3) → (34,2.5) → (28,2.5) → (28,53.5) → (21,53.5) → (21,53). Insulate every crossing; solder only the two endpoints. Confirm endpoint continuity (<1Ω for a wire) and no adjacent-net bridge; isolate parallel paths before measuring.
132. **Connect W55 · GND:** Common electrical reference and return; keep student, USB and service ground identities consistent. Connect C_INPUT_HF.2 → U_SENSE.2. Hole path (34,3) → (34,2.5) → (23,2.5) → (23,36.5) → (12,36.5) → (12,36). Insulate every crossing; solder only the two endpoints.
133. **Verify W55 · GND:** Power disconnected: Common electrical reference and return; keep student, USB and service ground identities consistent. Connect C_INPUT_HF.2 → U_SENSE.2. Hole path (34,3) → (34,2.5) → (23,2.5) → (23,36.5) → (12,36.5) → (12,36). Insulate every crossing; solder only the two endpoints. Confirm endpoint continuity (<1Ω for a wire) and no adjacent-net bridge; isolate parallel paths before measuring.
134. **Connect W56 · GND:** Common electrical reference and return; keep student, USB and service ground identities consistent. Connect C_INPUT_HF.2 → U_TRIP.4. Hole path (34,3) → (34,2.5) → (23,2.5) → (23,47.5) → (12,47.5) → (12,47). Insulate every crossing; solder only the two endpoints.
135. **Verify W56 · GND:** Power disconnected: Common electrical reference and return; keep student, USB and service ground identities consistent. Connect C_INPUT_HF.2 → U_TRIP.4. Hole path (34,3) → (34,2.5) → (23,2.5) → (23,47.5) → (12,47.5) → (12,47). Insulate every crossing; solder only the two endpoints. Confirm endpoint continuity (<1Ω for a wire) and no adjacent-net bridge; isolate parallel paths before measuring.
136. **Connect W81 · 5V_SYS:** Logic supply or current-protection path; verify the named supply domain and current direction. Connect J_MATRIX.4 → C_TRIP.1. Hole path (6,72) → (6,71.5) → (20.5,71.5) → (20.5,34.5) → (34,34.5) → (34,34). Insulate every crossing; solder only the two endpoints.
137. **Verify W81 · 5V_SYS:** Power disconnected: Logic supply or current-protection path; verify the named supply domain and current direction. Connect J_MATRIX.4 → C_TRIP.1. Hole path (6,72) → (6,71.5) → (20.5,71.5) → (20.5,34.5) → (34,34.5) → (34,34). Insulate every crossing; solder only the two endpoints. Confirm endpoint continuity (<1Ω for a wire) and no adjacent-net bridge; isolate parallel paths before measuring.
138. **Connect W82 · 5V_SYS:** Logic supply or current-protection path; verify the named supply domain and current direction. Connect J_MATRIX.4 → F_EDU.1. Hole path (6,72) → (6,71.5) → (8.5,71.5) → (8.5,29.5) → (10,29.5) → (10,29). Insulate every crossing; solder only the two endpoints.
139. **Verify W82 · 5V_SYS:** Power disconnected: Logic supply or current-protection path; verify the named supply domain and current direction. Connect J_MATRIX.4 → F_EDU.1. Hole path (6,72) → (6,71.5) → (8.5,71.5) → (8.5,29.5) → (10,29.5) → (10,29). Insulate every crossing; solder only the two endpoints. Confirm endpoint continuity (<1Ω for a wire) and no adjacent-net bridge; isolate parallel paths before measuring.
140. **Connect W83 · 5V_SYS:** Logic supply or current-protection path; verify the named supply domain and current direction. Connect J_MATRIX.4 → R_BATTERY_LED.1. Hole path (6,72) → (6,71.5) → (11.5,71.5) → (11.5,66.5) → (15,66.5) → (15,66). Insulate every crossing; solder only the two endpoints.
141. **Verify W83 · 5V_SYS:** Power disconnected: Logic supply or current-protection path; verify the named supply domain and current direction. Connect J_MATRIX.4 → R_BATTERY_LED.1. Hole path (6,72) → (6,71.5) → (11.5,71.5) → (11.5,66.5) → (15,66.5) → (15,66). Insulate every crossing; solder only the two endpoints. Confirm endpoint continuity (<1Ω for a wire) and no adjacent-net bridge; isolate parallel paths before measuring.
142. **Connect W84 · 5V_SYS:** Logic supply or current-protection path; verify the named supply domain and current direction. Connect J_MATRIX.4 → R_REF_FEED.1. Hole path (6,72) → (6,71.5) → (17.5,71.5) → (17.5,34.5) → (27,34.5) → (27,34). Insulate every crossing; solder only the two endpoints.
143. **Verify W84 · 5V_SYS:** Power disconnected: Logic supply or current-protection path; verify the named supply domain and current direction. Connect J_MATRIX.4 → R_REF_FEED.1. Hole path (6,72) → (6,71.5) → (17.5,71.5) → (17.5,34.5) → (27,34.5) → (27,34). Insulate every crossing; solder only the two endpoints. Confirm endpoint continuity (<1Ω for a wire) and no adjacent-net bridge; isolate parallel paths before measuring.
144. **Connect W85 · 5V_SYS:** Logic supply or current-protection path; verify the named supply domain and current direction. Connect J_MATRIX.4 → U_TRIP.8. Hole path (6,72) → (6,71.5) → (11.5,71.5) → (11.5,44.5) → (15,44.5) → (15,44). Insulate every crossing; solder only the two endpoints.
145. **Verify W85 · 5V_SYS:** Power disconnected: Logic supply or current-protection path; verify the named supply domain and current direction. Connect J_MATRIX.4 → U_TRIP.8. Hole path (6,72) → (6,71.5) → (11.5,71.5) → (11.5,44.5) → (15,44.5) → (15,44). Insulate every crossing; solder only the two endpoints. Confirm endpoint continuity (<1Ω for a wire) and no adjacent-net bridge; isolate parallel paths before measuring.
146. **Connect W91 · 3V3_SYS:** 3.3-V electronics supply. USB and bench supply domains must not be bridged. Connect J_MATRIX.3 → C_ALLOW.1. Hole path (6,71) → (6,70.5) → (6,55.5) → (5,55.5) → (5,55). Insulate every crossing; solder only the two endpoints.
147. **Verify W91 · 3V3_SYS:** Power disconnected: 3.3-V electronics supply. USB and bench supply domains must not be bridged. Connect J_MATRIX.3 → C_ALLOW.1. Hole path (6,71) → (6,70.5) → (6,55.5) → (5,55.5) → (5,55). Insulate every crossing; solder only the two endpoints. Confirm endpoint continuity (<1Ω for a wire) and no adjacent-net bridge; isolate parallel paths before measuring.
148. **Connect W92 · 3V3_SYS:** 3.3-V electronics supply. USB and bench supply domains must not be bridged. Connect J_MATRIX.3 → C_FAULT.1. Hole path (6,71) → (6,70.5) → (6,50.5) → (5,50.5) → (5,50). Insulate every crossing; solder only the two endpoints.
149. **Verify W92 · 3V3_SYS:** Power disconnected: 3.3-V electronics supply. USB and bench supply domains must not be bridged. Connect J_MATRIX.3 → C_FAULT.1. Hole path (6,71) → (6,70.5) → (6,50.5) → (5,50.5) → (5,50). Insulate every crossing; solder only the two endpoints. Confirm endpoint continuity (<1Ω for a wire) and no adjacent-net bridge; isolate parallel paths before measuring.
150. **Connect W93 · 3V3_SYS:** 3.3-V electronics supply. USB and bench supply domains must not be bridged. Connect J_MATRIX.3 → C_RESET.1. Hole path (6,71) → (6,70.5) → (15,70.5) → (15,52.5) → (24,52.5) → (24,52). Insulate every crossing; solder only the two endpoints.
151. **Verify W93 · 3V3_SYS:** Power disconnected: 3.3-V electronics supply. USB and bench supply domains must not be bridged. Connect J_MATRIX.3 → C_RESET.1. Hole path (6,71) → (6,70.5) → (15,70.5) → (15,52.5) → (24,52.5) → (24,52). Insulate every crossing; solder only the two endpoints. Confirm endpoint continuity (<1Ω for a wire) and no adjacent-net bridge; isolate parallel paths before measuring.
152. **Connect W94 · 3V3_SYS:** 3.3-V electronics supply. USB and bench supply domains must not be bridged. Connect J_MATRIX.3 → C_SENSE.1. Hole path (6,71) → (6,70.5) → (12,70.5) → (12,34.5) → (18,34.5) → (18,34). Insulate every crossing; solder only the two endpoints.
153. **Verify W94 · 3V3_SYS:** Power disconnected: 3.3-V electronics supply. USB and bench supply domains must not be bridged. Connect J_MATRIX.3 → C_SENSE.1. Hole path (6,71) → (6,70.5) → (12,70.5) → (12,34.5) → (18,34.5) → (18,34). Insulate every crossing; solder only the two endpoints. Confirm endpoint continuity (<1Ω for a wire) and no adjacent-net bridge; isolate parallel paths before measuring.
154. **Connect W95 · 3V3_SYS:** 3.3-V electronics supply. USB and bench supply domains must not be bridged. Connect J_MATRIX.3 → R_EDU_ON.1. Hole path (6,71) → (6,70.5) → (12,70.5) → (12,45.5) → (18,45.5) → (18,45). Insulate every crossing; solder only the two endpoints.
155. **Verify W95 · 3V3_SYS:** Power disconnected: 3.3-V electronics supply. USB and bench supply domains must not be bridged. Connect J_MATRIX.3 → R_EDU_ON.1. Hole path (6,71) → (6,70.5) → (12,70.5) → (12,45.5) → (18,45.5) → (18,45). Insulate every crossing; solder only the two endpoints. Confirm endpoint continuity (<1Ω for a wire) and no adjacent-net bridge; isolate parallel paths before measuring.
156. **Connect W96 · 3V3_SYS:** 3.3-V electronics supply. USB and bench supply domains must not be bridged. Connect J_MATRIX.3 → R_PRESET.1. Hole path (6,71) → (6,70.5) → (6,45.5) → (5,45.5) → (5,45). Insulate every crossing; solder only the two endpoints.
157. **Verify W96 · 3V3_SYS:** Power disconnected: 3.3-V electronics supply. USB and bench supply domains must not be bridged. Connect J_MATRIX.3 → R_PRESET.1. Hole path (6,71) → (6,70.5) → (6,45.5) → (5,45.5) → (5,45). Insulate every crossing; solder only the two endpoints. Confirm endpoint continuity (<1Ω for a wire) and no adjacent-net bridge; isolate parallel paths before measuring.
158. **Connect W97 · 3V3_SYS:** 3.3-V electronics supply. USB and bench supply domains must not be bridged. Connect J_MATRIX.3 → U_ALLOW.14. Hole path (6,71) → (6,70.5) → (9,70.5) → (9,56.5) → (12,56.5) → (12,56). Insulate every crossing; solder only the two endpoints.
159. **Verify W97 · 3V3_SYS:** Power disconnected: 3.3-V electronics supply. USB and bench supply domains must not be bridged. Connect J_MATRIX.3 → U_ALLOW.14. Hole path (6,71) → (6,70.5) → (9,70.5) → (9,56.5) → (12,56.5) → (12,56). Insulate every crossing; solder only the two endpoints. Confirm endpoint continuity (<1Ω for a wire) and no adjacent-net bridge; isolate parallel paths before measuring.
160. **Connect W98 · 3V3_SYS:** 3.3-V electronics supply. USB and bench supply domains must not be bridged. Connect J_MATRIX.3 → U_FAULT.10. Hole path (6,71) → (6,70.5) → (20,70.5) → (20,51.5) → (34,51.5) → (34,51). Insulate every crossing; solder only the two endpoints.
161. **Verify W98 · 3V3_SYS:** Power disconnected: 3.3-V electronics supply. USB and bench supply domains must not be bridged. Connect J_MATRIX.3 → U_FAULT.10. Hole path (6,71) → (6,70.5) → (20,70.5) → (20,51.5) → (34,51.5) → (34,51). Insulate every crossing; solder only the two endpoints. Confirm endpoint continuity (<1Ω for a wire) and no adjacent-net bridge; isolate parallel paths before measuring.
162. **Connect W99 · 3V3_SYS:** 3.3-V electronics supply. USB and bench supply domains must not be bridged. Connect J_MATRIX.3 → U_FAULT.13. Hole path (6,71) → (6,70.5) → (20,70.5) → (20,48.5) → (34,48.5) → (34,48). Insulate every crossing; solder only the two endpoints.
163. **Verify W99 · 3V3_SYS:** Power disconnected: 3.3-V electronics supply. USB and bench supply domains must not be bridged. Connect J_MATRIX.3 → U_FAULT.13. Hole path (6,71) → (6,70.5) → (20,70.5) → (20,48.5) → (34,48.5) → (34,48). Insulate every crossing; solder only the two endpoints. Confirm endpoint continuity (<1Ω for a wire) and no adjacent-net bridge; isolate parallel paths before measuring.
164. **Connect W100 · 3V3_SYS:** 3.3-V electronics supply. USB and bench supply domains must not be bridged. Connect J_MATRIX.3 → U_FAULT.14. Hole path (6,71) → (6,70.5) → (20,70.5) → (20,47.5) → (34,47.5) → (34,47). Insulate every crossing; solder only the two endpoints.
165. **Verify W100 · 3V3_SYS:** Power disconnected: 3.3-V electronics supply. USB and bench supply domains must not be bridged. Connect J_MATRIX.3 → U_FAULT.14. Hole path (6,71) → (6,70.5) → (20,70.5) → (20,47.5) → (34,47.5) → (34,47). Insulate every crossing; solder only the two endpoints. Confirm endpoint continuity (<1Ω for a wire) and no adjacent-net bridge; isolate parallel paths before measuring.
166. **Connect W101 · 3V3_SYS:** 3.3-V electronics supply. USB and bench supply domains must not be bridged. Connect J_MATRIX.3 → U_POR.2. Hole path (6,71) → (6,70.5) → (16,70.5) → (16,46.5) → (25,46.5) → (25,46). Insulate every crossing; solder only the two endpoints.
167. **Verify W101 · 3V3_SYS:** Power disconnected: 3.3-V electronics supply. USB and bench supply domains must not be bridged. Connect J_MATRIX.3 → U_POR.2. Hole path (6,71) → (6,70.5) → (16,70.5) → (16,46.5) → (25,46.5) → (25,46). Insulate every crossing; solder only the two endpoints. Confirm endpoint continuity (<1Ω for a wire) and no adjacent-net bridge; isolate parallel paths before measuring.
168. **Connect W102 · 3V3_SYS:** 3.3-V electronics supply. USB and bench supply domains must not be bridged. Connect J_MATRIX.3 → U_RESET.14. Hole path (6,71) → (6,70.5) → (14,70.5) → (14,52.5) → (21,52.5) → (21,52). Insulate every crossing; solder only the two endpoints.
169. **Verify W102 · 3V3_SYS:** Power disconnected: 3.3-V electronics supply. USB and bench supply domains must not be bridged. Connect J_MATRIX.3 → U_RESET.14. Hole path (6,71) → (6,70.5) → (14,70.5) → (14,52.5) → (21,52.5) → (21,52). Insulate every crossing; solder only the two endpoints. Confirm endpoint continuity (<1Ω for a wire) and no adjacent-net bridge; isolate parallel paths before measuring.
170. **Connect W103 · 3V3_SYS:** 3.3-V electronics supply. USB and bench supply domains must not be bridged. Connect J_MATRIX.3 → U_SENSE.5. Hole path (6,71) → (6,70.5) → (11,70.5) → (11,35.5) → (15,35.5) → (15,35). Insulate every crossing; solder only the two endpoints.
171. **Verify W103 · 3V3_SYS:** Power disconnected: 3.3-V electronics supply. USB and bench supply domains must not be bridged. Connect J_MATRIX.3 → U_SENSE.5. Hole path (6,71) → (6,70.5) → (11,70.5) → (11,35.5) → (15,35.5) → (15,35). Insulate every crossing; solder only the two endpoints. Confirm endpoint continuity (<1Ω for a wire) and no adjacent-net bridge; isolate parallel paths before measuring.
172. **Connect W110 · PRESET_N:** Protection, reset or readiness control; its defined polarity must preserve OFF at startup and on faults. Connect J_TEST.5 → R_PRESET.2. Hole path (18,71) → (18,70.5) → (14,70.5) → (14,45.5) → (9,45.5) → (9,45). Insulate every crossing; solder only the two endpoints.
173. **Verify W110 · PRESET_N:** Power disconnected: Protection, reset or readiness control; its defined polarity must preserve OFF at startup and on faults. Connect J_TEST.5 → R_PRESET.2. Hole path (18,71) → (18,70.5) → (14,70.5) → (14,45.5) → (9,45.5) → (9,45). Insulate every crossing; solder only the two endpoints. Confirm endpoint continuity (<1Ω for a wire) and no adjacent-net bridge; isolate parallel paths before measuring.
174. **Connect W111 · PRESET_N:** Protection, reset or readiness control; its defined polarity must preserve OFF at startup and on faults. Connect J_TEST.5 → U_FAULT.4. Hole path (18,71) → (18,70.5) → (25,70.5) → (25,50.5) → (31,50.5) → (31,50). Insulate every crossing; solder only the two endpoints.
175. **Verify W111 · PRESET_N:** Power disconnected: Protection, reset or readiness control; its defined polarity must preserve OFF at startup and on faults. Connect J_TEST.5 → U_FAULT.4. Hole path (18,71) → (18,70.5) → (25,70.5) → (25,50.5) → (31,50.5) → (31,50). Insulate every crossing; solder only the two endpoints. Confirm endpoint continuity (<1Ω for a wire) and no adjacent-net bridge; isolate parallel paths before measuring.
176. **Connect W112 · PRESET_N:** Protection, reset or readiness control; its defined polarity must preserve OFF at startup and on faults. Connect J_TEST.5 → U_POR.1. Hole path (18,71) → (18,70.5) → (22,70.5) → (22,45.5) → (25,45.5) → (25,45). Insulate every crossing; solder only the two endpoints.
177. **Verify W112 · PRESET_N:** Power disconnected: Protection, reset or readiness control; its defined polarity must preserve OFF at startup and on faults. Connect J_TEST.5 → U_POR.1. Hole path (18,71) → (18,70.5) → (22,70.5) → (22,45.5) → (25,45.5) → (25,45). Insulate every crossing; solder only the two endpoints. Confirm endpoint continuity (<1Ω for a wire) and no adjacent-net bridge; isolate parallel paths before measuring.
178. **Connect W113 · PRESET_N:** Protection, reset or readiness control; its defined polarity must preserve OFF at startup and on faults. Connect J_TEST.5 → U_RESET.2. Hole path (18,71) → (18,70.5) → (18,53.5) → (18,53). Insulate every crossing; solder only the two endpoints.
179. **Verify W113 · PRESET_N:** Power disconnected: Protection, reset or readiness control; its defined polarity must preserve OFF at startup and on faults. Connect J_TEST.5 → U_RESET.2. Hole path (18,71) → (18,70.5) → (18,53.5) → (18,53). Insulate every crossing; solder only the two endpoints. Confirm endpoint continuity (<1Ω for a wire) and no adjacent-net bridge; isolate parallel paths before measuring.
180. **Connect W114 · PRESET_N:** Protection, reset or readiness control; its defined polarity must preserve OFF at startup and on faults. Connect J_TEST.5 → U_TRIP.1. Hole path (18,71) → (18,70.5) → (15,70.5) → (15,44.5) → (12,44.5) → (12,44). Insulate every crossing; solder only the two endpoints.
181. **Verify W114 · PRESET_N:** Power disconnected: Protection, reset or readiness control; its defined polarity must preserve OFF at startup and on faults. Connect J_TEST.5 → U_TRIP.1. Hole path (18,71) → (18,70.5) → (15,70.5) → (15,44.5) → (12,44.5) → (12,44). Insulate every crossing; solder only the two endpoints. Confirm endpoint continuity (<1Ω for a wire) and no adjacent-net bridge; isolate parallel paths before measuring.
182. **Connect W125 · PTC_OUT:** Logic supply or current-protection path; verify the named supply domain and current direction. Connect F_EDU.2 → Q_PASS.3. Hole path (14,29) → (14,28.5) → (17.5,28.5) → (17.5,29.5) → (19,29.5) → (19,29). Insulate every crossing; solder only the two endpoints.
183. **Verify W125 · PTC_OUT:** Power disconnected: Logic supply or current-protection path; verify the named supply domain and current direction. Connect F_EDU.2 → Q_PASS.3. Hole path (14,29) → (14,28.5) → (17.5,28.5) → (17.5,29.5) → (19,29.5) → (19,29). Insulate every crossing; solder only the two endpoints. Confirm endpoint continuity (<1Ω for a wire) and no adjacent-net bridge; isolate parallel paths before measuring.
184. **Connect W126 · PTC_OUT:** Logic supply or current-protection path; verify the named supply domain and current direction. Connect F_EDU.2 → R_GATE_OFF.1. Hole path (14,29) → (14,28.5) → (18.5,28.5) → (18.5,29.5) → (22,29.5) → (22,29). Insulate every crossing; solder only the two endpoints.
185. **Verify W126 · PTC_OUT:** Power disconnected: Logic supply or current-protection path; verify the named supply domain and current direction. Connect F_EDU.2 → R_GATE_OFF.1. Hole path (14,29) → (14,28.5) → (18.5,28.5) → (18.5,29.5) → (22,29.5) → (22,29). Insulate every crossing; solder only the two endpoints. Confirm endpoint continuity (<1Ω for a wire) and no adjacent-net bridge; isolate parallel paths before measuring.
186. **Connect W127 · PASS_GATE:** Output switching or current-limiting control; default OFF and mutually exclusive source/sink states are required. Connect Q_ENABLE.3 → Q_PASS.1. Hole path (31,29) → (17,29). Insulate every crossing; solder only the two endpoints.
187. **Verify W127 · PASS_GATE:** Power disconnected: Output switching or current-limiting control; default OFF and mutually exclusive source/sink states are required. Connect Q_ENABLE.3 → Q_PASS.1. Hole path (31,29) → (17,29). Insulate every crossing; solder only the two endpoints. Confirm endpoint continuity (<1Ω for a wire) and no adjacent-net bridge; isolate parallel paths before measuring.
188. **Connect W128 · PASS_GATE:** Output switching or current-limiting control; default OFF and mutually exclusive source/sink states are required. Connect Q_ENABLE.3 → R_GATE_OFF.2. Hole path (31,29) → (26,29). Insulate every crossing; solder only the two endpoints.
189. **Verify W128 · PASS_GATE:** Power disconnected: Output switching or current-limiting control; default OFF and mutually exclusive source/sink states are required. Connect Q_ENABLE.3 → R_GATE_OFF.2. Hole path (31,29) → (26,29). Insulate every crossing; solder only the two endpoints. Confirm endpoint continuity (<1Ω for a wire) and no adjacent-net bridge; isolate parallel paths before measuring.
190. **Connect W129 · SHUNT_P:** Logic supply or current-protection path; verify the named supply domain and current direction. Connect Q_PASS.2 → R_SHUNT.1. Hole path (18,29) → (18,34) → (5,34). Insulate every crossing; solder only the two endpoints.
191. **Verify W129 · SHUNT_P:** Power disconnected: Logic supply or current-protection path; verify the named supply domain and current direction. Connect Q_PASS.2 → R_SHUNT.1. Hole path (18,29) → (18,34) → (5,34). Insulate every crossing; solder only the two endpoints. Confirm endpoint continuity (<1Ω for a wire) and no adjacent-net bridge; isolate parallel paths before measuring.
192. **Connect W130 · SHUNT_P:** Logic supply or current-protection path; verify the named supply domain and current direction. Connect Q_PASS.2 → U_SENSE.3. Hole path (18,29) → (18,37) → (12,37). Insulate every crossing; solder only the two endpoints.
193. **Verify W130 · SHUNT_P:** Power disconnected: Logic supply or current-protection path; verify the named supply domain and current direction. Connect Q_PASS.2 → U_SENSE.3. Hole path (18,29) → (18,37) → (12,37). Insulate every crossing; solder only the two endpoints. Confirm endpoint continuity (<1Ω for a wire) and no adjacent-net bridge; isolate parallel paths before measuring.
194. **Connect W131 · ALLOW_RAIL:** Protection, reset or readiness control; its defined polarity must preserve OFF at startup and on faults. Connect Q_ENABLE.2 → U_ALLOW.6. Hole path (30,29) → (30,28.5) → (20.5,28.5) → (20.5,61.5) → (9,61.5) → (9,61). Insulate every crossing; solder only the two endpoints.
195. **Verify W131 · ALLOW_RAIL:** Power disconnected: Protection, reset or readiness control; its defined polarity must preserve OFF at startup and on faults. Connect Q_ENABLE.2 → U_ALLOW.6. Hole path (30,29) → (30,28.5) → (20.5,28.5) → (20.5,61.5) → (9,61.5) → (9,61). Insulate every crossing; solder only the two endpoints. Confirm endpoint continuity (<1Ω for a wire) and no adjacent-net bridge; isolate parallel paths before measuring.
196. **Connect W135 · 5V_EDU:** Protected student supply, enabled only by the fault latch, watchdog and an explicit valid request. Connect J_FIXED_BATTERY.1 → C_EDU.1. Hole path (36,66) → (36,65.5) → (34.5,65.5) → (34.5,29.5) → (34,29.5) → (34,29). Insulate every crossing; solder only the two endpoints.
197. **Verify W135 · 5V_EDU:** Power disconnected: Protected student supply, enabled only by the fault latch, watchdog and an explicit valid request. Connect J_FIXED_BATTERY.1 → C_EDU.1. Hole path (36,66) → (36,65.5) → (34.5,65.5) → (34.5,29.5) → (34,29.5) → (34,29). Insulate every crossing; solder only the two endpoints. Confirm endpoint continuity (<1Ω for a wire) and no adjacent-net bridge; isolate parallel paths before measuring.
198. **Connect W136 · 5V_EDU:** Protected student supply, enabled only by the fault latch, watchdog and an explicit valid request. Connect J_FIXED_BATTERY.1 → R_EDU_TOP.1. Hole path (36,66) → (36,65.5) → (30.5,65.5) → (30.5,40.5) → (25,40.5) → (25,40). Insulate every crossing; solder only the two endpoints.
199. **Verify W136 · 5V_EDU:** Power disconnected: Protected student supply, enabled only by the fault latch, watchdog and an explicit valid request. Connect J_FIXED_BATTERY.1 → R_EDU_TOP.1. Hole path (36,66) → (36,65.5) → (30.5,65.5) → (30.5,40.5) → (25,40.5) → (25,40). Insulate every crossing; solder only the two endpoints. Confirm endpoint continuity (<1Ω for a wire) and no adjacent-net bridge; isolate parallel paths before measuring.
200. **Connect W137 · 5V_EDU:** Protected student supply, enabled only by the fault latch, watchdog and an explicit valid request. Connect J_FIXED_BATTERY.1 → R_SHUNT.2. Hole path (36,66) → (36,65.5) → (22.5,65.5) → (22.5,34.5) → (9,34.5) → (9,34). Insulate every crossing; solder only the two endpoints.
201. **Verify W137 · 5V_EDU:** Power disconnected: Protected student supply, enabled only by the fault latch, watchdog and an explicit valid request. Connect J_FIXED_BATTERY.1 → R_SHUNT.2. Hole path (36,66) → (36,65.5) → (22.5,65.5) → (22.5,34.5) → (9,34.5) → (9,34). Insulate every crossing; solder only the two endpoints. Confirm endpoint continuity (<1Ω for a wire) and no adjacent-net bridge; isolate parallel paths before measuring.
202. **Connect W138 · 5V_EDU:** Protected student supply, enabled only by the fault latch, watchdog and an explicit valid request. Connect J_FIXED_BATTERY.1 → U_SENSE.4. Hole path (36,66) → (36,65.5) → (25.5,65.5) → (25.5,36.5) → (15,36.5) → (15,36). Insulate every crossing; solder only the two endpoints.
203. **Verify W138 · 5V_EDU:** Power disconnected: Protected student supply, enabled only by the fault latch, watchdog and an explicit valid request. Connect J_FIXED_BATTERY.1 → U_SENSE.4. Hole path (36,66) → (36,65.5) → (25.5,65.5) → (25.5,36.5) → (15,36.5) → (15,36). Insulate every crossing; solder only the two endpoints. Confirm endpoint continuity (<1Ω for a wire) and no adjacent-net bridge; isolate parallel paths before measuring.
204. **Connect W140 · CURRENT_SENSE:** Analog measurement, feedback or reference path; inspect polarity and compare with the specified calibration. Connect J_MATRIX.8 → U_SENSE.1. Hole path (8,72) → (8,35) → (12,35). Insulate every crossing; solder only the two endpoints.
205. **Verify W140 · CURRENT_SENSE:** Power disconnected: Analog measurement, feedback or reference path; inspect polarity and compare with the specified calibration. Connect J_MATRIX.8 → U_SENSE.1. Hole path (8,72) → (8,35) → (12,35). Insulate every crossing; solder only the two endpoints. Confirm endpoint continuity (<1Ω for a wire) and no adjacent-net bridge; isolate parallel paths before measuring.
206. **Connect W141 · CURRENT_SENSE:** Analog measurement, feedback or reference path; inspect polarity and compare with the specified calibration. Connect J_MATRIX.8 → U_TRIP.2. Hole path (8,72) → (8,45) → (12,45). Insulate every crossing; solder only the two endpoints.
207. **Verify W141 · CURRENT_SENSE:** Power disconnected: Analog measurement, feedback or reference path; inspect polarity and compare with the specified calibration. Connect J_MATRIX.8 → U_TRIP.2. Hole path (8,72) → (8,45) → (12,45). Insulate every crossing; solder only the two endpoints. Confirm endpoint continuity (<1Ω for a wire) and no adjacent-net bridge; isolate parallel paths before measuring.
208. **Connect W142 · REF_2V495:** Analog measurement, feedback or reference path; inspect polarity and compare with the specified calibration. Connect R_REF_FEED.2 → R_TRIP_TOP.1. Hole path (31,34) → (31,40) → (5,40). Insulate every crossing; solder only the two endpoints.
209. **Verify W142 · REF_2V495:** Power disconnected: Analog measurement, feedback or reference path; inspect polarity and compare with the specified calibration. Connect R_REF_FEED.2 → R_TRIP_TOP.1. Hole path (31,34) → (31,40) → (5,40). Insulate every crossing; solder only the two endpoints. Confirm endpoint continuity (<1Ω for a wire) and no adjacent-net bridge; isolate parallel paths before measuring.
210. **Connect W143 · REF_2V495:** Analog measurement, feedback or reference path; inspect polarity and compare with the specified calibration. Connect R_REF_FEED.2 → U_REF.1. Hole path (31,34) → (22,34). Insulate every crossing; solder only the two endpoints.
211. **Verify W143 · REF_2V495:** Power disconnected: Analog measurement, feedback or reference path; inspect polarity and compare with the specified calibration. Connect R_REF_FEED.2 → U_REF.1. Hole path (31,34) → (22,34). Insulate every crossing; solder only the two endpoints. Confirm endpoint continuity (<1Ω for a wire) and no adjacent-net bridge; isolate parallel paths before measuring.
212. **Connect W144 · REF_2V495:** Analog measurement, feedback or reference path; inspect polarity and compare with the specified calibration. Connect R_REF_FEED.2 → U_REF.3. Hole path (31,34) → (24,34). Insulate every crossing; solder only the two endpoints.
213. **Verify W144 · REF_2V495:** Power disconnected: Analog measurement, feedback or reference path; inspect polarity and compare with the specified calibration. Connect R_REF_FEED.2 → U_REF.3. Hole path (31,34) → (24,34). Insulate every crossing; solder only the two endpoints. Confirm endpoint continuity (<1Ω for a wire) and no adjacent-net bridge; isolate parallel paths before measuring.
214. **Connect W145 · REF_TRIP:** Analog measurement, feedback or reference path; inspect polarity and compare with the specified calibration. Connect J_TEST.3 → R_TRIP_BOTTOM.1. Hole path (16,71) → (16,40) → (18,40). Insulate every crossing; solder only the two endpoints.
215. **Verify W145 · REF_TRIP:** Power disconnected: Analog measurement, feedback or reference path; inspect polarity and compare with the specified calibration. Connect J_TEST.3 → R_TRIP_BOTTOM.1. Hole path (16,71) → (16,40) → (18,40). Insulate every crossing; solder only the two endpoints. Confirm endpoint continuity (<1Ω for a wire) and no adjacent-net bridge; isolate parallel paths before measuring.
216. **Connect W146 · REF_TRIP:** Analog measurement, feedback or reference path; inspect polarity and compare with the specified calibration. Connect J_TEST.3 → R_TRIP_TOP.2. Hole path (16,71) → (16,40) → (9,40). Insulate every crossing; solder only the two endpoints.
217. **Verify W146 · REF_TRIP:** Power disconnected: Analog measurement, feedback or reference path; inspect polarity and compare with the specified calibration. Connect J_TEST.3 → R_TRIP_TOP.2. Hole path (16,71) → (16,40) → (9,40). Insulate every crossing; solder only the two endpoints. Confirm endpoint continuity (<1Ω for a wire) and no adjacent-net bridge; isolate parallel paths before measuring.
218. **Connect W147 · REF_TRIP:** Analog measurement, feedback or reference path; inspect polarity and compare with the specified calibration. Connect J_TEST.3 → U_TRIP.3. Hole path (16,71) → (16,46) → (12,46). Insulate every crossing; solder only the two endpoints.
219. **Verify W147 · REF_TRIP:** Power disconnected: Analog measurement, feedback or reference path; inspect polarity and compare with the specified calibration. Connect J_TEST.3 → U_TRIP.3. Hole path (16,71) → (16,46) → (12,46). Insulate every crossing; solder only the two endpoints. Confirm endpoint continuity (<1Ω for a wire) and no adjacent-net bridge; isolate parallel paths before measuring.
220. **Connect W148 · REF_TRIP:** Analog measurement, feedback or reference path; inspect polarity and compare with the specified calibration. Connect J_TEST.3 → U_TRIP.6. Hole path (16,71) → (16,46) → (15,46). Insulate every crossing; solder only the two endpoints.
221. **Verify W148 · REF_TRIP:** Power disconnected: Analog measurement, feedback or reference path; inspect polarity and compare with the specified calibration. Connect J_TEST.3 → U_TRIP.6. Hole path (16,71) → (16,46) → (15,46). Insulate every crossing; solder only the two endpoints. Confirm endpoint continuity (<1Ω for a wire) and no adjacent-net bridge; isolate parallel paths before measuring.
222. **Connect W149 · EDU_DIV:** Analog measurement, feedback or reference path; inspect polarity and compare with the specified calibration. Connect R_EDU_BOTTOM.1 → R_EDU_TOP.2. Hole path (32,40) → (29,40). Insulate every crossing; solder only the two endpoints.
223. **Verify W149 · EDU_DIV:** Power disconnected: Analog measurement, feedback or reference path; inspect polarity and compare with the specified calibration. Connect R_EDU_BOTTOM.1 → R_EDU_TOP.2. Hole path (32,40) → (29,40). Insulate every crossing; solder only the two endpoints. Confirm endpoint continuity (<1Ω for a wire) and no adjacent-net bridge; isolate parallel paths before measuring.
224. **Connect W150 · EDU_DIV:** Analog measurement, feedback or reference path; inspect polarity and compare with the specified calibration. Connect R_EDU_BOTTOM.1 → U_TRIP.5. Hole path (32,40) → (32,47) → (15,47). Insulate every crossing; solder only the two endpoints.
225. **Verify W150 · EDU_DIV:** Power disconnected: Analog measurement, feedback or reference path; inspect polarity and compare with the specified calibration. Connect R_EDU_BOTTOM.1 → U_TRIP.5. Hole path (32,40) → (32,47) → (15,47). Insulate every crossing; solder only the two endpoints. Confirm endpoint continuity (<1Ω for a wire) and no adjacent-net bridge; isolate parallel paths before measuring.
226. **Connect W151 · EDU_ON:** Named control/interconnect for edu on. Verify both pin functions against the schematic before soldering. Connect J_SMART.7 → Q_BATTERY_LED.2. Hole path (34,73) → (34,72.5) → (33.5,72.5) → (33.5,66.5) → (32,66.5) → (32,66). Insulate every crossing; solder only the two endpoints.
227. **Verify W151 · EDU_ON:** Power disconnected: Named control/interconnect for edu on. Verify both pin functions against the schematic before soldering. Connect J_SMART.7 → Q_BATTERY_LED.2. Hole path (34,73) → (34,72.5) → (33.5,72.5) → (33.5,66.5) → (32,66.5) → (32,66). Insulate every crossing; solder only the two endpoints. Confirm endpoint continuity (<1Ω for a wire) and no adjacent-net bridge; isolate parallel paths before measuring.
228. **Connect W152 · EDU_ON:** Named control/interconnect for edu on. Verify both pin functions against the schematic before soldering. Connect J_SMART.7 → R_EDU_ON.2. Hole path (34,73) → (34,72.5) → (28.5,72.5) → (28.5,45.5) → (22,45.5) → (22,45). Insulate every crossing; solder only the two endpoints.
229. **Verify W152 · EDU_ON:** Power disconnected: Named control/interconnect for edu on. Verify both pin functions against the schematic before soldering. Connect J_SMART.7 → R_EDU_ON.2. Hole path (34,73) → (34,72.5) → (28.5,72.5) → (28.5,45.5) → (22,45.5) → (22,45). Insulate every crossing; solder only the two endpoints. Confirm endpoint continuity (<1Ω for a wire) and no adjacent-net bridge; isolate parallel paths before measuring.
230. **Connect W153 · EDU_ON:** Named control/interconnect for edu on. Verify both pin functions against the schematic before soldering. Connect J_SMART.7 → R_LED_GATE_OFF.1. Hole path (34,73) → (34,72.5) → (28.5,72.5) → (28.5,67.5) → (22,67.5) → (22,67). Insulate every crossing; solder only the two endpoints.
231. **Verify W153 · EDU_ON:** Power disconnected: Named control/interconnect for edu on. Verify both pin functions against the schematic before soldering. Connect J_SMART.7 → R_LED_GATE_OFF.1. Hole path (34,73) → (34,72.5) → (28.5,72.5) → (28.5,67.5) → (22,67.5) → (22,67). Insulate every crossing; solder only the two endpoints. Confirm endpoint continuity (<1Ω for a wire) and no adjacent-net bridge; isolate parallel paths before measuring.
232. **Connect W154 · EDU_ON:** Named control/interconnect for edu on. Verify both pin functions against the schematic before soldering. Connect J_SMART.7 → U_TRIP.7. Hole path (34,73) → (34,72.5) → (25.5,72.5) → (25.5,45.5) → (15,45.5) → (15,45). Insulate every crossing; solder only the two endpoints.
233. **Verify W154 · EDU_ON:** Power disconnected: Named control/interconnect for edu on. Verify both pin functions against the schematic before soldering. Connect J_SMART.7 → U_TRIP.7. Hole path (34,73) → (34,72.5) → (25.5,72.5) → (25.5,45.5) → (15,45.5) → (15,45). Insulate every crossing; solder only the two endpoints. Confirm endpoint continuity (<1Ω for a wire) and no adjacent-net bridge; isolate parallel paths before measuring.
234. **Connect W155 · CLEAR_N:** Protection, reset or readiness control; its defined polarity must preserve OFF at startup and on faults. Connect U_FAULT.1 → U_RESET.3. Hole path (31,47) → (31,46.5) → (24.5,46.5) → (24.5,54.5) → (18,54.5) → (18,54). Insulate every crossing; solder only the two endpoints.
235. **Verify W155 · CLEAR_N:** Power disconnected: Protection, reset or readiness control; its defined polarity must preserve OFF at startup and on faults. Connect U_FAULT.1 → U_RESET.3. Hole path (31,47) → (31,46.5) → (24.5,46.5) → (24.5,54.5) → (18,54.5) → (18,54). Insulate every crossing; solder only the two endpoints. Confirm endpoint continuity (<1Ω for a wire) and no adjacent-net bridge; isolate parallel paths before measuring.
236. **Connect W157 · EDU_FAULT:** Protection, reset or readiness control; its defined polarity must preserve OFF at startup and on faults. Connect J_MATRIX.6 → U_FAULT.5. Hole path (7,72) → (7,71.5) → (19,71.5) → (19,51.5) → (31,51.5) → (31,51). Insulate every crossing; solder only the two endpoints.
237. **Verify W157 · EDU_FAULT:** Power disconnected: Protection, reset or readiness control; its defined polarity must preserve OFF at startup and on faults. Connect J_MATRIX.6 → U_FAULT.5. Hole path (7,72) → (7,71.5) → (19,71.5) → (19,51.5) → (31,51.5) → (31,51). Insulate every crossing; solder only the two endpoints. Confirm endpoint continuity (<1Ω for a wire) and no adjacent-net bridge; isolate parallel paths before measuring.
238. **Connect W158 · NOT_FAULT:** Protection, reset or readiness control; its defined polarity must preserve OFF at startup and on faults. Connect U_ALLOW.2 → U_FAULT.6. Hole path (9,57) → (9,56.5) → (20.5,56.5) → (20.5,52.5) → (31,52.5) → (31,52). Insulate every crossing; solder only the two endpoints.
239. **Verify W158 · NOT_FAULT:** Power disconnected: Protection, reset or readiness control; its defined polarity must preserve OFF at startup and on faults. Connect U_ALLOW.2 → U_FAULT.6. Hole path (9,57) → (9,56.5) → (20.5,56.5) → (20.5,52.5) → (31,52.5) → (31,52). Insulate every crossing; solder only the two endpoints. Confirm endpoint continuity (<1Ω for a wire) and no adjacent-net bridge; isolate parallel paths before measuring.
240. **Connect W159 · EDU_FAULT_RESET:** Protection, reset or readiness control; its defined polarity must preserve OFF at startup and on faults. Connect J_MATRIX.7 → R_EDU_FAULT_RESET_OFF.1. Hole path (8,71) → (8,70.5) → (19.5,70.5) → (19.5,60.5) → (31,60.5) → (31,60). Insulate every crossing; solder only the two endpoints.
241. **Verify W159 · EDU_FAULT_RESET:** Power disconnected: Protection, reset or readiness control; its defined polarity must preserve OFF at startup and on faults. Connect J_MATRIX.7 → R_EDU_FAULT_RESET_OFF.1. Hole path (8,71) → (8,70.5) → (19.5,70.5) → (19.5,60.5) → (31,60.5) → (31,60). Insulate every crossing; solder only the two endpoints. Confirm endpoint continuity (<1Ω for a wire) and no adjacent-net bridge; isolate parallel paths before measuring.
242. **Connect W160 · EDU_FAULT_RESET:** Protection, reset or readiness control; its defined polarity must preserve OFF at startup and on faults. Connect J_MATRIX.7 → U_RESET.1. Hole path (8,71) → (8,70.5) → (12.5,70.5) → (12.5,52.5) → (18,52.5) → (18,52). Insulate every crossing; solder only the two endpoints.
243. **Verify W160 · EDU_FAULT_RESET:** Power disconnected: Protection, reset or readiness control; its defined polarity must preserve OFF at startup and on faults. Connect J_MATRIX.7 → U_RESET.1. Hole path (8,71) → (8,70.5) → (12.5,70.5) → (12.5,52.5) → (18,52.5) → (18,52). Insulate every crossing; solder only the two endpoints. Confirm endpoint continuity (<1Ω for a wire) and no adjacent-net bridge; isolate parallel paths before measuring.
244. **Connect W161 · EDU_PWR_EN:** Protection, reset or readiness control; its defined polarity must preserve OFF at startup and on faults. Connect J_MATRIX.5 → R_EDU_PWR_EN_OFF.1. Hole path (7,71) → (7,70.5) → (16,70.5) → (16,57.5) → (24,57.5) → (24,57). Insulate every crossing; solder only the two endpoints.
245. **Verify W161 · EDU_PWR_EN:** Power disconnected: Protection, reset or readiness control; its defined polarity must preserve OFF at startup and on faults. Connect J_MATRIX.5 → R_EDU_PWR_EN_OFF.1. Hole path (7,71) → (7,70.5) → (16,70.5) → (16,57.5) → (24,57.5) → (24,57). Insulate every crossing; solder only the two endpoints. Confirm endpoint continuity (<1Ω for a wire) and no adjacent-net bridge; isolate parallel paths before measuring.
246. **Connect W162 · EDU_PWR_EN:** Protection, reset or readiness control; its defined polarity must preserve OFF at startup and on faults. Connect J_MATRIX.5 → U_ALLOW.1. Hole path (7,71) → (7,70.5) → (8,70.5) → (8,56.5) → (9,56.5) → (9,56). Insulate every crossing; solder only the two endpoints.
247. **Verify W162 · EDU_PWR_EN:** Power disconnected: Protection, reset or readiness control; its defined polarity must preserve OFF at startup and on faults. Connect J_MATRIX.5 → U_ALLOW.1. Hole path (7,71) → (7,70.5) → (8,70.5) → (8,56.5) → (9,56.5) → (9,56). Insulate every crossing; solder only the two endpoints. Confirm endpoint continuity (<1Ω for a wire) and no adjacent-net bridge; isolate parallel paths before measuring.
248. **Connect W163 · ENABLE_NO_FAULT:** Protection, reset or readiness control; its defined polarity must preserve OFF at startup and on faults. Connect U_ALLOW.3 → U_ALLOW.4. Hole path (9,58) → (9,57.5) → (9.5,57.5) → (9.5,59.5) → (9,59.5) → (9,59). Insulate every crossing; solder only the two endpoints.
249. **Verify W163 · ENABLE_NO_FAULT:** Power disconnected: Protection, reset or readiness control; its defined polarity must preserve OFF at startup and on faults. Connect U_ALLOW.3 → U_ALLOW.4. Hole path (9,58) → (9,57.5) → (9.5,57.5) → (9.5,59.5) → (9,59.5) → (9,59). Insulate every crossing; solder only the two endpoints. Confirm endpoint continuity (<1Ω for a wire) and no adjacent-net bridge; isolate parallel paths before measuring.
250. **Connect W164 · ROUTER_ALIVE:** Output switching or current-limiting control; default OFF and mutually exclusive source/sink states are required. Connect J_MATRIX.9 → R_ROUTER_ALIVE_OFF.1. Hole path (9,71) → (9,70.5) → (16.5,70.5) → (16.5,62.5) → (24,62.5) → (24,62). Insulate every crossing; solder only the two endpoints.
251. **Verify W164 · ROUTER_ALIVE:** Power disconnected: Output switching or current-limiting control; default OFF and mutually exclusive source/sink states are required. Connect J_MATRIX.9 → R_ROUTER_ALIVE_OFF.1. Hole path (9,71) → (9,70.5) → (16.5,70.5) → (16.5,62.5) → (24,62.5) → (24,62). Insulate every crossing; solder only the two endpoints. Confirm endpoint continuity (<1Ω for a wire) and no adjacent-net bridge; isolate parallel paths before measuring.
252. **Connect W165 · ROUTER_ALIVE:** Output switching or current-limiting control; default OFF and mutually exclusive source/sink states are required. Connect J_MATRIX.9 → U_ALLOW.5. Hole path (9,71) → (9,70.5) → (8.5,70.5) → (8.5,60.5) → (9,60.5) → (9,60). Insulate every crossing; solder only the two endpoints.
253. **Verify W165 · ROUTER_ALIVE:** Power disconnected: Output switching or current-limiting control; default OFF and mutually exclusive source/sink states are required. Connect J_MATRIX.9 → U_ALLOW.5. Hole path (9,71) → (9,70.5) → (8.5,70.5) → (8.5,60.5) → (9,60.5) → (9,60). Insulate every crossing; solder only the two endpoints. Confirm endpoint continuity (<1Ω for a wire) and no adjacent-net bridge; isolate parallel paths before measuring.
254. **Connect W166 · BATTERY_LED_A:** Named control/interconnect for battery led a. Verify both pin functions against the schematic before soldering. Connect LED_BATTERY.1 → R_BATTERY_LED.2. Hole path (5,60) → (5,59.5) → (12,59.5) → (12,66.5) → (19,66.5) → (19,66). Insulate every crossing; solder only the two endpoints.
255. **Verify W166 · BATTERY_LED_A:** Power disconnected: Named control/interconnect for battery led a. Verify both pin functions against the schematic before soldering. Connect LED_BATTERY.1 → R_BATTERY_LED.2. Hole path (5,60) → (5,59.5) → (12,59.5) → (12,66.5) → (19,66.5) → (19,66). Insulate every crossing; solder only the two endpoints. Confirm endpoint continuity (<1Ω for a wire) and no adjacent-net bridge; isolate parallel paths before measuring.
256. **Connect W167 · BATTERY_LED_K:** Named control/interconnect for battery led k. Verify both pin functions against the schematic before soldering. Connect LED_BATTERY.2 → Q_BATTERY_LED.3. Hole path (6,60) → (6,59.5) → (20.5,59.5) → (20.5,66.5) → (33,66.5) → (33,66). Insulate every crossing; solder only the two endpoints.
257. **Verify W167 · BATTERY_LED_K:** Power disconnected: Named control/interconnect for battery led k. Verify both pin functions against the schematic before soldering. Connect LED_BATTERY.2 → Q_BATTERY_LED.3. Hole path (6,60) → (6,59.5) → (20.5,59.5) → (20.5,66.5) → (33,66.5) → (33,66). Insulate every crossing; solder only the two endpoints. Confirm endpoint continuity (<1Ω for a wire) and no adjacent-net bridge; isolate parallel paths before measuring.
258. **Place J_POWER:** J_POWER: power; POWER_MATRIX v2. Part of ESP1 and safe default routing control. Mount on the top side; red pad identifies pin 1. 
259. **Inspect J_POWER:** Power OFF: inspect every terminal, polarity, seating and solder joint. J_POWER: power; POWER_MATRIX v2. Part of ESP1 and safe default routing control. Mount on the top side; red pad identifies pin 1. 
260. **Place U_FAULT_RETURN:** U_FAULT_RETURN: fault return; SN74LVC1G125DBVR. Part of Power-off isolated fault and current returns. Install on SOT23-5 to numbered adapter; verify manufacturer pin numbering. Mount on the top side; red pad identifies pin 1. 
261. **Inspect U_FAULT_RETURN:** Power OFF: inspect every terminal, polarity, seating and solder joint. U_FAULT_RETURN: fault return; SN74LVC1G125DBVR. Part of Power-off isolated fault and current returns. Install on SOT23-5 to numbered adapter; verify manufacturer pin numbering. Mount on the top side; red pad identifies pin 1. 
262. **Place C_RETURN:** C_RETURN: return; 100nF. Part of Power-off isolated fault and current returns. Mount on the top side; red pad identifies pin 1. 
263. **Inspect C_RETURN:** Power OFF: inspect every terminal, polarity, seating and solder joint. C_RETURN: return; 100nF. Part of Power-off isolated fault and current returns. Mount on the top side; red pad identifies pin 1. 
264. **Place K_ADC:** K_ADC: adc; AQY212EH. Part of Power-off isolated fault and current returns. Mount on the top side; red pad identifies pin 1. 
265. **Inspect K_ADC:** Power OFF: inspect every terminal, polarity, seating and solder joint. K_ADC: adc; AQY212EH. Part of Power-off isolated fault and current returns. Mount on the top side; red pad identifies pin 1. 
266. **Place R_KADC_LED:** R_KADC_LED: kadc led; 330. Part of Power-off isolated fault and current returns. Mount on the top side; red pad identifies pin 1. 
267. **Inspect R_KADC_LED:** Power OFF: inspect every terminal, polarity, seating and solder joint. R_KADC_LED: kadc led; 330. Part of Power-off isolated fault and current returns. Mount on the top side; red pad identifies pin 1. 
268. **Connect W3 · USB_3V3:** 3.3-V electronics supply. USB and bench supply domains must not be bridged. Connect J_FIXTURE.1 → C_RETURN.1. Hole path (30,6) → (30,5.5) → (28.5,5.5) → (28.5,34.5) → (28,34.5) → (28,34). Insulate every crossing; solder only the two endpoints.
269. **Verify W3 · USB_3V3:** Power disconnected: 3.3-V electronics supply. USB and bench supply domains must not be bridged. Connect J_FIXTURE.1 → C_RETURN.1. Hole path (30,6) → (30,5.5) → (28.5,5.5) → (28.5,34.5) → (28,34.5) → (28,34). Insulate every crossing; solder only the two endpoints. Confirm endpoint continuity (<1Ω for a wire) and no adjacent-net bridge; isolate parallel paths before measuring.
270. **Connect W4 · USB_3V3:** 3.3-V electronics supply. USB and bench supply domains must not be bridged. Connect J_FIXTURE.1 → R_KADC_LED.1. Hole path (30,6) → (30,5.5) → (26.5,5.5) → (26.5,53.5) → (23,53.5) → (23,53). Insulate every crossing; solder only the two endpoints.
271. **Verify W4 · USB_3V3:** Power disconnected: 3.3-V electronics supply. USB and bench supply domains must not be bridged. Connect J_FIXTURE.1 → R_KADC_LED.1. Hole path (30,6) → (30,5.5) → (26.5,5.5) → (26.5,53.5) → (23,53.5) → (23,53). Insulate every crossing; solder only the two endpoints. Confirm endpoint continuity (<1Ω for a wire) and no adjacent-net bridge; isolate parallel paths before measuring.
272. **Connect W5 · USB_3V3:** 3.3-V electronics supply. USB and bench supply domains must not be bridged. Connect J_FIXTURE.1 → U_FAULT_RETURN.5. Hole path (30,6) → (30,5.5) → (21.5,5.5) → (21.5,53.5) → (14,53.5) → (14,53). Insulate every crossing; solder only the two endpoints.
273. **Verify W5 · USB_3V3:** Power disconnected: 3.3-V electronics supply. USB and bench supply domains must not be bridged. Connect J_FIXTURE.1 → U_FAULT_RETURN.5. Hole path (30,6) → (30,5.5) → (21.5,5.5) → (21.5,53.5) → (14,53.5) → (14,53). Insulate every crossing; solder only the two endpoints. Confirm endpoint continuity (<1Ω for a wire) and no adjacent-net bridge; isolate parallel paths before measuring.
274. **Connect W17 · GND:** Common electrical reference and return; keep student, USB and service ground identities consistent. Connect J_FIXTURE.2 → C_RETURN.2. Hole path (31,6) → (31,5.5) → (30,5.5) → (30,34.5) → (29,34.5) → (29,34). Insulate every crossing; solder only the two endpoints.
275. **Verify W17 · GND:** Power disconnected: Common electrical reference and return; keep student, USB and service ground identities consistent. Connect J_FIXTURE.2 → C_RETURN.2. Hole path (31,6) → (31,5.5) → (30,5.5) → (30,34.5) → (29,34.5) → (29,34). Insulate every crossing; solder only the two endpoints. Confirm endpoint continuity (<1Ω for a wire) and no adjacent-net bridge; isolate parallel paths before measuring.
276. **Connect W18 · GND:** Common electrical reference and return; keep student, USB and service ground identities consistent. Connect J_FIXTURE.2 → J_POWER.2. Hole path (31,6) → (31,5.5) → (26,5.5) → (26,7.5) → (21,7.5) → (21,7). Insulate every crossing; solder only the two endpoints.
277. **Verify W18 · GND:** Power disconnected: Common electrical reference and return; keep student, USB and service ground identities consistent. Connect J_FIXTURE.2 → J_POWER.2. Hole path (31,6) → (31,5.5) → (26,5.5) → (26,7.5) → (21,7.5) → (21,7). Insulate every crossing; solder only the two endpoints. Confirm endpoint continuity (<1Ω for a wire) and no adjacent-net bridge; isolate parallel paths before measuring.
278. **Connect W19 · GND:** Common electrical reference and return; keep student, USB and service ground identities consistent. Connect J_FIXTURE.2 → K_ADC.2. Hole path (31,6) → (31,5.5) → (24,5.5) → (24,54.5) → (17,54.5) → (17,54). Insulate every crossing; solder only the two endpoints.
279. **Verify W19 · GND:** Power disconnected: Common electrical reference and return; keep student, USB and service ground identities consistent. Connect J_FIXTURE.2 → K_ADC.2. Hole path (31,6) → (31,5.5) → (24,5.5) → (24,54.5) → (17,54.5) → (17,54). Insulate every crossing; solder only the two endpoints. Confirm endpoint continuity (<1Ω for a wire) and no adjacent-net bridge; isolate parallel paths before measuring.
280. **Connect W20 · GND:** Common electrical reference and return; keep student, USB and service ground identities consistent. Connect J_FIXTURE.2 → U_FAULT_RETURN.1. Hole path (31,6) → (31,5.5) → (21,5.5) → (21,53.5) → (11,53.5) → (11,53). Insulate every crossing; solder only the two endpoints.
281. **Verify W20 · GND:** Power disconnected: Common electrical reference and return; keep student, USB and service ground identities consistent. Connect J_FIXTURE.2 → U_FAULT_RETURN.1. Hole path (31,6) → (31,5.5) → (21,5.5) → (21,53.5) → (11,53.5) → (11,53). Insulate every crossing; solder only the two endpoints. Confirm endpoint continuity (<1Ω for a wire) and no adjacent-net bridge; isolate parallel paths before measuring.
282. **Connect W21 · GND:** Common electrical reference and return; keep student, USB and service ground identities consistent. Connect J_FIXTURE.2 → U_FAULT_RETURN.3. Hole path (31,6) → (31,5.5) → (21,5.5) → (21,55.5) → (11,55.5) → (11,55). Insulate every crossing; solder only the two endpoints.
283. **Verify W21 · GND:** Power disconnected: Common electrical reference and return; keep student, USB and service ground identities consistent. Connect J_FIXTURE.2 → U_FAULT_RETURN.3. Hole path (31,6) → (31,5.5) → (21,5.5) → (21,55.5) → (11,55.5) → (11,55). Insulate every crossing; solder only the two endpoints. Confirm endpoint continuity (<1Ω for a wire) and no adjacent-net bridge; isolate parallel paths before measuring.
284. **Connect W79 · EDU_PWR_EN:** Protection, reset or readiness control; its defined polarity must preserve OFF at startup and on faults. Connect J_PROTOTYPE.4 → J_POWER.5. Hole path (40,6) → (40,5.5) → (31.5,5.5) → (31.5,6.5) → (23,6.5) → (23,6). Insulate every crossing; solder only the two endpoints.
285. **Verify W79 · EDU_PWR_EN:** Power disconnected: Protection, reset or readiness control; its defined polarity must preserve OFF at startup and on faults. Connect J_PROTOTYPE.4 → J_POWER.5. Hole path (40,6) → (40,5.5) → (31.5,5.5) → (31.5,6.5) → (23,6.5) → (23,6). Insulate every crossing; solder only the two endpoints. Confirm endpoint continuity (<1Ω for a wire) and no adjacent-net bridge; isolate parallel paths before measuring.
286. **Connect W80 · FAULT_USB:** Protection, reset or readiness control; its defined polarity must preserve OFF at startup and on faults. Connect U_ESP1.6 → U_FAULT_RETURN.4. Hole path (6,12) → (6,11.5) → (10,11.5) → (10,54.5) → (14,54.5) → (14,54). Insulate every crossing; solder only the two endpoints.
287. **Verify W80 · FAULT_USB:** Power disconnected: Protection, reset or readiness control; its defined polarity must preserve OFF at startup and on faults. Connect U_ESP1.6 → U_FAULT_RETURN.4. Hole path (6,12) → (6,11.5) → (10,11.5) → (10,54.5) → (14,54.5) → (14,54). Insulate every crossing; solder only the two endpoints. Confirm endpoint continuity (<1Ω for a wire) and no adjacent-net bridge; isolate parallel paths before measuring.
288. **Connect W81 · EDU_FAULT_RESET:** Protection, reset or readiness control; its defined polarity must preserve OFF at startup and on faults. Connect U_ESP1.30 → J_POWER.7. Hole path (16,17) → (16,16.5) → (20.5,16.5) → (20.5,6.5) → (24,6.5) → (24,6). Insulate every crossing; solder only the two endpoints.
289. **Verify W81 · EDU_FAULT_RESET:** Power disconnected: Protection, reset or readiness control; its defined polarity must preserve OFF at startup and on faults. Connect U_ESP1.30 → J_POWER.7. Hole path (16,17) → (16,16.5) → (20.5,16.5) → (20.5,6.5) → (24,6.5) → (24,6). Insulate every crossing; solder only the two endpoints. Confirm endpoint continuity (<1Ω for a wire) and no adjacent-net bridge; isolate parallel paths before measuring.
290. **Connect W82 · CURRENT_USB:** Protection, reset or readiness control; its defined polarity must preserve OFF at startup and on faults. Connect U_ESP1.5 → K_ADC.4. Hole path (6,11) → (6,10.5) → (12.5,10.5) → (12.5,53.5) → (20,53.5) → (20,53). Insulate every crossing; solder only the two endpoints.
291. **Verify W82 · CURRENT_USB:** Power disconnected: Protection, reset or readiness control; its defined polarity must preserve OFF at startup and on faults. Connect U_ESP1.5 → K_ADC.4. Hole path (6,11) → (6,10.5) → (12.5,10.5) → (12.5,53.5) → (20,53.5) → (20,53). Insulate every crossing; solder only the two endpoints. Confirm endpoint continuity (<1Ω for a wire) and no adjacent-net bridge; isolate parallel paths before measuring.
292. **Connect W102 · EDU_FAULT:** Protection, reset or readiness control; its defined polarity must preserve OFF at startup and on faults. Connect J_POWER.6 → U_FAULT_RETURN.2. Hole path (23,7) → (23,6.5) → (16.5,6.5) → (16.5,54.5) → (11,54.5) → (11,54). Insulate every crossing; solder only the two endpoints.
293. **Verify W102 · EDU_FAULT:** Power disconnected: Protection, reset or readiness control; its defined polarity must preserve OFF at startup and on faults. Connect J_POWER.6 → U_FAULT_RETURN.2. Hole path (23,7) → (23,6.5) → (16.5,6.5) → (16.5,54.5) → (11,54.5) → (11,54). Insulate every crossing; solder only the two endpoints. Confirm endpoint continuity (<1Ω for a wire) and no adjacent-net bridge; isolate parallel paths before measuring.
294. **Connect W103 · CURRENT_SENSE:** Analog measurement, feedback or reference path; inspect polarity and compare with the specified calibration. Connect J_POWER.8 → K_ADC.3. Hole path (24,7) → (24,54) → (20,54). Insulate every crossing; solder only the two endpoints.
295. **Verify W103 · CURRENT_SENSE:** Power disconnected: Analog measurement, feedback or reference path; inspect polarity and compare with the specified calibration. Connect J_POWER.8 → K_ADC.3. Hole path (24,7) → (24,54) → (20,54). Insulate every crossing; solder only the two endpoints. Confirm endpoint continuity (<1Ω for a wire) and no adjacent-net bridge; isolate parallel paths before measuring.
296. **Connect W187 · K_ADC_LED:** Analog measurement, feedback or reference path; inspect polarity and compare with the specified calibration. Connect K_ADC.1 → R_KADC_LED.2. Hole path (17,53) → (27,53). Insulate every crossing; solder only the two endpoints.
297. **Verify W187 · K_ADC_LED:** Power disconnected: Analog measurement, feedback or reference path; inspect polarity and compare with the specified calibration. Connect K_ADC.1 → R_KADC_LED.2. Hole path (17,53) → (27,53). Insulate every crossing; solder only the two endpoints. Confirm endpoint continuity (<1Ω for a wire) and no adjacent-net bridge; isolate parallel paths before measuring.
298. **Fit POWER_MATRIX:** power.J_MATRIX → matrix.J_POWER; verify each conductor and pin1 with power OFF. Keep unused supply and signal pins isolated until their consumers are installed.
299. **Inspect POWER_MATRIX:** Power OFF: power.J_MATRIX → matrix.J_POWER; verify each conductor and pin1 with power OFF. Keep unused supply and signal pins isolated until their consumers are installed.
300. **Fit final-source-transition:** USB prototype positive and both prototype 3V3 bridges removed. Final fixed source J_FIXED_BATTERY pin1→C2, pin2→C1. Never parallel sources.
301. **Inspect final-source-transition:** Power OFF: USB prototype positive and both prototype 3V3 bridges removed. Final fixed source J_FIXED_BATTERY pin1→C2, pin2→C1. Never parallel sources.
302. **Check the firmware contract:** factory final-power qualification: explicit enable/reset; supervised ALIVE link only before CP13; no production authorization
303. **Measure and record:** Prototype USB positive and 3V3 supply links are removed before connecting final consumer links. Only one educational source may be connected. Inspect all power-board blocks before enabling; the student latch must not be powered as an incomplete circuit.
304. **Measure and record:** Supervised factory qualification only: ALIVE is held LOW for startup/reset tests. All consumer links remain open until voltage guards pass. USB removal, held reset and a power cycle leave 5V_EDU OFF.
305. **Film the win:** The final student rail remains OFF at startup and reset.
306. **Accept this checkpoint:** Verify the readings and construction, then accept CP11.

## Firmware contract (implementation pending)

factory final-power qualification: explicit enable/reset; supervised ALIVE link only before CP13; no production authorization

## Acceptance tests

1. Prototype USB positive and 3V3 supply links are removed before connecting final consumer links. Only one educational source may be connected. Inspect all power-board blocks before enabling; the student latch must not be powered as an incomplete circuit.
2. Supervised factory qualification only: ALIVE is held LOW for startup/reset tests. All consumer links remain open until voltage guards pass. USB removal, held reset and a power cycle leave 5V_EDU OFF.

## Film the win

USB prototype source and prototype 3V3 links removed before final supplies connect. Use checkpoint-specific bounded test loads; stop and isolate power before changing any link. Factory ALIVE fixture is temporary: J_PROTOTYPE pin2 USB3V3→J_POWER pin9 only during supervised load qualification. LOW/open for startup/reset; remove permanently before CP13.

1. Show off at startup and reset setup with power OFF and display firmware revision.
2. Demonstrate: The final student rail remains OFF at startup and reset.
3. Show the documented negative test and actual recorded readings.

**Negative example:** Reset or reconnect USB with enable previously requested: startup remains OFF.

Record readings and units, equipment, link positions, firmware revision and outcome. Firmware is a contract only; never film simulated readings as measured hardware evidence.
