gefgu/integration-workshop-3/eletronics/perfboard/cp12.md

# CP12 — Overload trip and latch

**Win:** An overload shuts down and stays latched until a valid reset.

Build the assigned functional groups in the [assembly app](tscircuit/README.md). Earlier soldered wiring stays fixed. Removable links and top-side kit arrangements may change.

## Link positions

- USB prototype source and prototype 3V3 links removed before final supplies connect.
- Use checkpoint-specific bounded test loads; stop and isolate power before changing any link.
- Factory ALIVE fixture is temporary: J_PROTOTYPE pin2 USB3V3→J_POWER pin9 only during supervised load qualification. LOW/open for startup/reset; remove permanently before CP13.

## Guided actions

1. **Disconnect power and prepare:** Unplug USB and all educational sources before construction. USB prototype source and prototype 3V3 links removed before final supplies connect. Use checkpoint-specific bounded test loads; stop and isolate power before changing any link. Factory ALIVE fixture is temporary: J_PROTOTYPE pin2 USB3V3→J_POWER pin9 only during supervised load qualification. LOW/open for startup/reset; remove permanently before CP13.
2. **Check the firmware contract:** factory final-power qualification: explicit enable/reset; supervised ALIVE link only before CP13; no production authorization
3. **Measure and record:** 1kΩ and 470Ω rail loads remain enabled; 330Ω or 100Ω load trips and remains latched. At 10mA: 5V_EDU 4.75–5.25V.
4. **Measure and record:** Sweep load: trip threshold must be >10.6mA and ≤12mA; record REF_TRIP and CURRENT_SENSE.
5. **Measure and record:** Supervised factory load test only: with power OFF, USB3V3→matrix J_POWER pin9 holds ALIVE high until CP13 watchdog exists. Explicit enable applies the bounded load; reset under overload must not release the latch. Remove the factory ALIVE link or hold it LOW to simulate heartbeat loss and prove OFF. Remove this link permanently at CP13.
6. **Film the win:** An overload shuts down and stays latched until a valid reset.
7. **Accept this checkpoint:** Verify the readings and construction, then accept CP12.

## Firmware contract (implementation pending)

factory final-power qualification: explicit enable/reset; supervised ALIVE link only before CP13; no production authorization

## Acceptance tests

1. 1kΩ and 470Ω rail loads remain enabled; 330Ω or 100Ω load trips and remains latched. At 10mA: 5V_EDU 4.75–5.25V.
2. Sweep load: trip threshold must be >10.6mA and ≤12mA; record REF_TRIP and CURRENT_SENSE.
3. Supervised factory load test only: with power OFF, USB3V3→matrix J_POWER pin9 holds ALIVE high until CP13 watchdog exists. Explicit enable applies the bounded load; reset under overload must not release the latch. Remove the factory ALIVE link or hold it LOW to simulate heartbeat loss and prove OFF. Remove this link permanently at CP13.

## Film the win

USB prototype source and prototype 3V3 links removed before final supplies connect. Use checkpoint-specific bounded test loads; stop and isolate power before changing any link. Factory ALIVE fixture is temporary: J_PROTOTYPE pin2 USB3V3→J_POWER pin9 only during supervised load qualification. LOW/open for startup/reset; remove permanently before CP13.

1. Show overload trip and latch setup with power OFF and display firmware revision.
2. Demonstrate: An overload shuts down and stays latched until a valid reset.
3. Show the documented negative test and actual recorded readings.

**Negative example:** Apply the qualified overload: shutdown latches; clearing the fault does not re-enable.

Record readings and units, equipment, link positions, firmware revision and outcome. Firmware is a contract only; never film simulated readings as measured hardware evidence.
