gefgu/integration-workshop-3/eletronics/perfboard/cp15.md

# CP15 — Bounded source and sink

**Win:** Smart output drives valid levels and limits short-circuit current.

Build the assigned functional groups in the [assembly app](tscircuit/README.md). Earlier soldered wiring stays fixed. Removable links and top-side kit arrangements may change.

## Link positions

- USB prototype source and prototype 3V3 links removed before final supplies connect.
- Use checkpoint-specific bounded test loads; stop and isolate power before changing any link.
- For smart-mode bench fixtures, disconnect both fixed battery leads and remove the initial kit loop. Output load: P3→1kΩ→LED anode, LED cathode→GND through removable leads. Logic inputs: HIGH=qualified3V3_SYS through1kΩ; LOW=GND through1kΩ. AND/OR exercise00,01,10,11; NOT exercise0,1. Never parallel another source with P3. Current tests use a documented series path, never an ammeter across the supply.

## Guided actions

1. **Disconnect power and prepare:** Unplug USB and all educational sources before construction. USB prototype source and prototype 3V3 links removed before final supplies connect. Use checkpoint-specific bounded test loads; stop and isolate power before changing any link. For smart-mode bench fixtures, disconnect both fixed battery leads and remove the initial kit loop. Output load: P3→1kΩ→LED anode, LED cathode→GND through removable leads. Logic inputs: HIGH=qualified3V3_SYS through1kΩ; LOW=GND through1kΩ. AND/OR exercise00,01,10,11; NOT exercise0,1. Never parallel another source with P3. Current tests use a documented series path, never an ammeter across the supply.
2. **Place U_ESP2:** U_ESP2: esp2; ESP32 DevKitC-38 — smart controller. Part of ESP2 and USB supply. Mount on the top side; red pad identifies pin 1. Actual purchased dimensions must be measured before release.
3. **Inspect U_ESP2:** Power OFF: inspect every terminal, polarity, seating and solder joint. U_ESP2: esp2; ESP32 DevKitC-38 — smart controller. Part of ESP2 and USB supply. Mount on the top side; red pad identifies pin 1. Actual purchased dimensions must be measured before release.
4. **Place J_POWER:** J_POWER: power; J_POWER. Part of ESP2 and USB supply. Mount on the top side; red pad identifies pin 1. 
5. **Inspect J_POWER:** Power OFF: inspect every terminal, polarity, seating and solder joint. J_POWER: power; J_POWER. Part of ESP2 and USB supply. Mount on the top side; red pad identifies pin 1. 
6. **Place R_SCL_A:** R_SCL_A: scl a; 4.7k. Part of ESP2 and USB supply. Mount on the top side; red pad identifies pin 1. 
7. **Inspect R_SCL_A:** Power OFF: inspect every terminal, polarity, seating and solder joint. R_SCL_A: scl a; 4.7k. Part of ESP2 and USB supply. Mount on the top side; red pad identifies pin 1. 
8. **Place R_SDA_0:** R_SDA_0: sda 0; 4.7k. Part of ESP2 and USB supply. Mount on the top side; red pad identifies pin 1. 
9. **Inspect R_SDA_0:** Power OFF: inspect every terminal, polarity, seating and solder joint. R_SDA_0: sda 0; 4.7k. Part of ESP2 and USB supply. Mount on the top side; red pad identifies pin 1. 
10. **Place R_SDA_1:** R_SDA_1: sda 1; 4.7k. Part of ESP2 and USB supply. Mount on the top side; red pad identifies pin 1. 
11. **Inspect R_SDA_1:** Power OFF: inspect every terminal, polarity, seating and solder joint. R_SDA_1: sda 1; 4.7k. Part of ESP2 and USB supply. Mount on the top side; red pad identifies pin 1. 
12. **Place R_SDA_2:** R_SDA_2: sda 2; 4.7k. Part of ESP2 and USB supply. Mount on the top side; red pad identifies pin 1. 
13. **Inspect R_SDA_2:** Power OFF: inspect every terminal, polarity, seating and solder joint. R_SDA_2: sda 2; 4.7k. Part of ESP2 and USB supply. Mount on the top side; red pad identifies pin 1. 
14. **Place R_SDA_3:** R_SDA_3: sda 3; 4.7k. Part of ESP2 and USB supply. Mount on the top side; red pad identifies pin 1. 
15. **Inspect R_SDA_3:** Power OFF: inspect every terminal, polarity, seating and solder joint. R_SDA_3: sda 3; 4.7k. Part of ESP2 and USB supply. Mount on the top side; red pad identifies pin 1. 
16. **Place R_SDA_4:** R_SDA_4: sda 4; 4.7k. Part of ESP2 and USB supply. Mount on the top side; red pad identifies pin 1. 
17. **Inspect R_SDA_4:** Power OFF: inspect every terminal, polarity, seating and solder joint. R_SDA_4: sda 4; 4.7k. Part of ESP2 and USB supply. Mount on the top side; red pad identifies pin 1. 
18. **Place R_SDA_5:** R_SDA_5: sda 5; 4.7k. Part of ESP2 and USB supply. Mount on the top side; red pad identifies pin 1. 
19. **Inspect R_SDA_5:** Power OFF: inspect every terminal, polarity, seating and solder joint. R_SDA_5: sda 5; 4.7k. Part of ESP2 and USB supply. Mount on the top side; red pad identifies pin 1. 
20. **Place U_WATCH:** U_WATCH: watch; SN74HC123N. Part of Hardware expiry of valid configuration heartbeat. Mount on the top side; red pad identifies pin 1. 
21. **Inspect U_WATCH:** Power OFF: inspect every terminal, polarity, seating and solder joint. U_WATCH: watch; SN74HC123N. Part of Hardware expiry of valid configuration heartbeat. Mount on the top side; red pad identifies pin 1. 
22. **Place R_WATCH:** R_WATCH: watch; 680k. Part of Hardware expiry of valid configuration heartbeat. Mount on the top side; red pad identifies pin 1. 
23. **Inspect R_WATCH:** Power OFF: inspect every terminal, polarity, seating and solder joint. R_WATCH: watch; 680k. Part of Hardware expiry of valid configuration heartbeat. Mount on the top side; red pad identifies pin 1. 
24. **Place C_WATCH:** C_WATCH: watch; 1uF. Part of Hardware expiry of valid configuration heartbeat. Mount on the top side; red pad identifies pin 1. 
25. **Inspect C_WATCH:** Power OFF: inspect every terminal, polarity, seating and solder joint. C_WATCH: watch; 1uF. Part of Hardware expiry of valid configuration heartbeat. Mount on the top side; red pad identifies pin 1. 
26. **Place C_WATCH_VCC:** C_WATCH_VCC: watch vcc; 100nF. Part of Hardware expiry of valid configuration heartbeat. Mount on the top side; red pad identifies pin 1. 
27. **Inspect C_WATCH_VCC:** Power OFF: inspect every terminal, polarity, seating and solder joint. C_WATCH_VCC: watch vcc; 100nF. Part of Hardware expiry of valid configuration heartbeat. Mount on the top side; red pad identifies pin 1. 
28. **Place R_HEART:** R_HEART: heart; 100k. Part of Hardware expiry of valid configuration heartbeat. Mount on the top side; red pad identifies pin 1. 
29. **Inspect R_HEART:** Power OFF: inspect every terminal, polarity, seating and solder joint. R_HEART: heart; 100k. Part of Hardware expiry of valid configuration heartbeat. Mount on the top side; red pad identifies pin 1. 
30. **Place U_USB_POR:** U_USB_POR: usb por; MCP130-300DI/TO. Part of Hardware expiry of valid configuration heartbeat. Mount on the top side; red pad identifies pin 1. 
31. **Inspect U_USB_POR:** Power OFF: inspect every terminal, polarity, seating and solder joint. U_USB_POR: usb por; MCP130-300DI/TO. Part of Hardware expiry of valid configuration heartbeat. Mount on the top side; red pad identifies pin 1. 
32. **Place R_USB_POR:** R_USB_POR: usb por; 10k. Part of Hardware expiry of valid configuration heartbeat. Mount on the top side; red pad identifies pin 1. 
33. **Inspect R_USB_POR:** Power OFF: inspect every terminal, polarity, seating and solder joint. R_USB_POR: usb por; 10k. Part of Hardware expiry of valid configuration heartbeat. Mount on the top side; red pad identifies pin 1. 
34. **Place R_OE:** R_OE: oe; 10k. Part of Hardware expiry of valid configuration heartbeat. Mount on the top side; red pad identifies pin 1. 
35. **Inspect R_OE:** Power OFF: inspect every terminal, polarity, seating and solder joint. R_OE: oe; 10k. Part of Hardware expiry of valid configuration heartbeat. Mount on the top side; red pad identifies pin 1. 
36. **Place Q_ALIVE:** Q_ALIVE: alive; 2N7000. Part of Hardware expiry of valid configuration heartbeat. Mount on the top side; red pad identifies pin 1. 
37. **Inspect Q_ALIVE:** Power OFF: inspect every terminal, polarity, seating and solder joint. Q_ALIVE: alive; 2N7000. Part of Hardware expiry of valid configuration heartbeat. Mount on the top side; red pad identifies pin 1. 
38. **Place Q_RAIL:** Q_RAIL: rail; 2N7000. Part of Hardware expiry of valid configuration heartbeat. Mount on the top side; red pad identifies pin 1. 
39. **Inspect Q_RAIL:** Power OFF: inspect every terminal, polarity, seating and solder joint. Q_RAIL: rail; 2N7000. Part of Hardware expiry of valid configuration heartbeat. Mount on the top side; red pad identifies pin 1. 
40. **Place R_ALIVE_OFF:** R_ALIVE_OFF: alive off; 100k. Part of Hardware expiry of valid configuration heartbeat. Mount on the top side; red pad identifies pin 1. 
41. **Inspect R_ALIVE_OFF:** Power OFF: inspect every terminal, polarity, seating and solder joint. R_ALIVE_OFF: alive off; 100k. Part of Hardware expiry of valid configuration heartbeat. Mount on the top side; red pad identifies pin 1. 
42. **Place R_RAIL_OFF:** R_RAIL_OFF: rail off; 100k. Part of Hardware expiry of valid configuration heartbeat. Mount on the top side; red pad identifies pin 1. 
43. **Inspect R_RAIL_OFF:** Power OFF: inspect every terminal, polarity, seating and solder joint. R_RAIL_OFF: rail off; 100k. Part of Hardware expiry of valid configuration heartbeat. Mount on the top side; red pad identifies pin 1. 
44. **Place U_SR0:** U_SR0: sr0; SN74HCT595N. Part of 18 default-off relay requests. Mount on the top side; red pad identifies pin 1. 
45. **Inspect U_SR0:** Power OFF: inspect every terminal, polarity, seating and solder joint. U_SR0: sr0; SN74HCT595N. Part of 18 default-off relay requests. Mount on the top side; red pad identifies pin 1. 
46. **Place C_SR0:** C_SR0: sr0; 100nF. Part of 18 default-off relay requests. Mount on the top side; red pad identifies pin 1. 
47. **Inspect C_SR0:** Power OFF: inspect every terminal, polarity, seating and solder joint. C_SR0: sr0; 100nF. Part of 18 default-off relay requests. Mount on the top side; red pad identifies pin 1. 
48. **Place U_SR1:** U_SR1: sr1; SN74HCT595N. Part of 18 default-off relay requests. Mount on the top side; red pad identifies pin 1. 
49. **Inspect U_SR1:** Power OFF: inspect every terminal, polarity, seating and solder joint. U_SR1: sr1; SN74HCT595N. Part of 18 default-off relay requests. Mount on the top side; red pad identifies pin 1. 
50. **Place C_SR1:** C_SR1: sr1; 100nF. Part of 18 default-off relay requests. Mount on the top side; red pad identifies pin 1. 
51. **Inspect C_SR1:** Power OFF: inspect every terminal, polarity, seating and solder joint. C_SR1: sr1; 100nF. Part of 18 default-off relay requests. Mount on the top side; red pad identifies pin 1. 
52. **Place U_SR2:** U_SR2: sr2; SN74HCT595N. Part of 18 default-off relay requests. Mount on the top side; red pad identifies pin 1. 
53. **Inspect U_SR2:** Power OFF: inspect every terminal, polarity, seating and solder joint. U_SR2: sr2; SN74HCT595N. Part of 18 default-off relay requests. Mount on the top side; red pad identifies pin 1. 
54. **Place C_SR2:** C_SR2: sr2; 100nF. Part of 18 default-off relay requests. Mount on the top side; red pad identifies pin 1. 
55. **Inspect C_SR2:** Power OFF: inspect every terminal, polarity, seating and solder joint. C_SR2: sr2; 100nF. Part of 18 default-off relay requests. Mount on the top side; red pad identifies pin 1. 
56. **Place R_SR_SER_OFF:** R_SR_SER_OFF: sr ser off; 100k. Part of 18 default-off relay requests. Mount on the top side; red pad identifies pin 1. 
57. **Inspect R_SR_SER_OFF:** Power OFF: inspect every terminal, polarity, seating and solder joint. R_SR_SER_OFF: sr ser off; 100k. Part of 18 default-off relay requests. Mount on the top side; red pad identifies pin 1. 
58. **Place R_SR_SRCLK_OFF:** R_SR_SRCLK_OFF: sr srclk off; 100k. Part of 18 default-off relay requests. Mount on the top side; red pad identifies pin 1. 
59. **Inspect R_SR_SRCLK_OFF:** Power OFF: inspect every terminal, polarity, seating and solder joint. R_SR_SRCLK_OFF: sr srclk off; 100k. Part of 18 default-off relay requests. Mount on the top side; red pad identifies pin 1. 
60. **Place R_SR_RCLK_OFF:** R_SR_RCLK_OFF: sr rclk off; 100k. Part of 18 default-off relay requests. Mount on the top side; red pad identifies pin 1. 
61. **Inspect R_SR_RCLK_OFF:** Power OFF: inspect every terminal, polarity, seating and solder joint. R_SR_RCLK_OFF: sr rclk off; 100k. Part of 18 default-off relay requests. Mount on the top side; red pad identifies pin 1. 
62. **Place J_CH0:** J_CH0: ch0; CTRL v2 → channel 0. Part of Six identical smart cards. Mount on the top side; red pad identifies pin 1. 
63. **Inspect J_CH0:** Power OFF: inspect every terminal, polarity, seating and solder joint. J_CH0: ch0; CTRL v2 → channel 0. Part of Six identical smart cards. Mount on the top side; red pad identifies pin 1. 
64. **Place J_CH1:** J_CH1: ch1; CTRL v2 → channel 1. Part of Six identical smart cards. Mount on the top side; red pad identifies pin 1. 
65. **Inspect J_CH1:** Power OFF: inspect every terminal, polarity, seating and solder joint. J_CH1: ch1; CTRL v2 → channel 1. Part of Six identical smart cards. Mount on the top side; red pad identifies pin 1. 
66. **Place J_CH2:** J_CH2: ch2; CTRL v2 → channel 2. Part of Six identical smart cards. Mount on the top side; red pad identifies pin 1. 
67. **Inspect J_CH2:** Power OFF: inspect every terminal, polarity, seating and solder joint. J_CH2: ch2; CTRL v2 → channel 2. Part of Six identical smart cards. Mount on the top side; red pad identifies pin 1. 
68. **Place J_CH3:** J_CH3: ch3; CTRL v2 → channel 3. Part of Six identical smart cards. Mount on the top side; red pad identifies pin 1. 
69. **Inspect J_CH3:** Power OFF: inspect every terminal, polarity, seating and solder joint. J_CH3: ch3; CTRL v2 → channel 3. Part of Six identical smart cards. Mount on the top side; red pad identifies pin 1. 
70. **Place J_CH4:** J_CH4: ch4; CTRL v2 → channel 4. Part of Six identical smart cards. Mount on the top side; red pad identifies pin 1. 
71. **Inspect J_CH4:** Power OFF: inspect every terminal, polarity, seating and solder joint. J_CH4: ch4; CTRL v2 → channel 4. Part of Six identical smart cards. Mount on the top side; red pad identifies pin 1. 
72. **Place J_CH5:** J_CH5: ch5; CTRL v2 → channel 5. Part of Six identical smart cards. Mount on the top side; red pad identifies pin 1. 
73. **Inspect J_CH5:** Power OFF: inspect every terminal, polarity, seating and solder joint. J_CH5: ch5; CTRL v2 → channel 5. Part of Six identical smart cards. Mount on the top side; red pad identifies pin 1. 
74. **Connect W1 · USB_3V3:** 3.3-V electronics supply. USB and bench supply domains must not be bridged. Connect C_WATCH_VCC.1 → J_CH0.8. Hole path (19,28) → (19,27.5) → (19.5,27.5) → (19.5,63.5) → (20,63.5) → (20,63). Insulate every crossing; solder only the two endpoints.
75. **Verify W1 · USB_3V3:** Power disconnected: 3.3-V electronics supply. USB and bench supply domains must not be bridged. Connect C_WATCH_VCC.1 → J_CH0.8. Hole path (19,28) → (19,27.5) → (19.5,27.5) → (19.5,63.5) → (20,63.5) → (20,63). Insulate every crossing; solder only the two endpoints. Confirm endpoint continuity (<1Ω for a wire) and no adjacent-net bridge; isolate parallel paths before measuring.
76. **Connect W2 · USB_3V3:** 3.3-V electronics supply. USB and bench supply domains must not be bridged. Connect C_WATCH_VCC.1 → J_CH1.8. Hole path (19,28) → (19,27.5) → (13.5,27.5) → (13.5,64.5) → (8,64.5) → (8,64). Insulate every crossing; solder only the two endpoints.
77. **Verify W2 · USB_3V3:** Power disconnected: 3.3-V electronics supply. USB and bench supply domains must not be bridged. Connect C_WATCH_VCC.1 → J_CH1.8. Hole path (19,28) → (19,27.5) → (13.5,27.5) → (13.5,64.5) → (8,64.5) → (8,64). Insulate every crossing; solder only the two endpoints. Confirm endpoint continuity (<1Ω for a wire) and no adjacent-net bridge; isolate parallel paths before measuring.
78. **Connect W3 · USB_3V3:** 3.3-V electronics supply. USB and bench supply domains must not be bridged. Connect C_WATCH_VCC.1 → J_CH2.8. Hole path (19,28) → (19,27.5) → (24.5,27.5) → (24.5,64.5) → (30,64.5) → (30,64). Insulate every crossing; solder only the two endpoints.
79. **Verify W3 · USB_3V3:** Power disconnected: 3.3-V electronics supply. USB and bench supply domains must not be bridged. Connect C_WATCH_VCC.1 → J_CH2.8. Hole path (19,28) → (19,27.5) → (24.5,27.5) → (24.5,64.5) → (30,64.5) → (30,64). Insulate every crossing; solder only the two endpoints. Confirm endpoint continuity (<1Ω for a wire) and no adjacent-net bridge; isolate parallel paths before measuring.
80. **Connect W4 · USB_3V3:** 3.3-V electronics supply. USB and bench supply domains must not be bridged. Connect C_WATCH_VCC.1 → J_CH3.8. Hole path (19,28) → (19,27.5) → (18.5,27.5) → (18.5,72.5) → (18,72.5) → (18,72). Insulate every crossing; solder only the two endpoints.
81. **Verify W4 · USB_3V3:** Power disconnected: 3.3-V electronics supply. USB and bench supply domains must not be bridged. Connect C_WATCH_VCC.1 → J_CH3.8. Hole path (19,28) → (19,27.5) → (18.5,27.5) → (18.5,72.5) → (18,72.5) → (18,72). Insulate every crossing; solder only the two endpoints. Confirm endpoint continuity (<1Ω for a wire) and no adjacent-net bridge; isolate parallel paths before measuring.
82. **Connect W5 · USB_3V3:** 3.3-V electronics supply. USB and bench supply domains must not be bridged. Connect C_WATCH_VCC.1 → J_CH4.8. Hole path (19,28) → (19,27.5) → (13.5,27.5) → (13.5,74.5) → (8,74.5) → (8,74). Insulate every crossing; solder only the two endpoints.
83. **Verify W5 · USB_3V3:** Power disconnected: 3.3-V electronics supply. USB and bench supply domains must not be bridged. Connect C_WATCH_VCC.1 → J_CH4.8. Hole path (19,28) → (19,27.5) → (13.5,27.5) → (13.5,74.5) → (8,74.5) → (8,74). Insulate every crossing; solder only the two endpoints. Confirm endpoint continuity (<1Ω for a wire) and no adjacent-net bridge; isolate parallel paths before measuring.
84. **Connect W6 · USB_3V3:** 3.3-V electronics supply. USB and bench supply domains must not be bridged. Connect C_WATCH_VCC.1 → J_CH5.8. Hole path (19,28) → (19,27.5) → (23.5,27.5) → (23.5,74.5) → (28,74.5) → (28,74). Insulate every crossing; solder only the two endpoints.
85. **Verify W6 · USB_3V3:** Power disconnected: 3.3-V electronics supply. USB and bench supply domains must not be bridged. Connect C_WATCH_VCC.1 → J_CH5.8. Hole path (19,28) → (19,27.5) → (23.5,27.5) → (23.5,74.5) → (28,74.5) → (28,74). Insulate every crossing; solder only the two endpoints. Confirm endpoint continuity (<1Ω for a wire) and no adjacent-net bridge; isolate parallel paths before measuring.
86. **Connect W7 · USB_3V3:** 3.3-V electronics supply. USB and bench supply domains must not be bridged. Connect C_WATCH_VCC.1 → R_SCL_A.1. Hole path (19,28) → (19,27.5) → (24.5,27.5) → (24.5,6.5) → (30,6.5) → (30,6). Insulate every crossing; solder only the two endpoints.
87. **Verify W7 · USB_3V3:** Power disconnected: 3.3-V electronics supply. USB and bench supply domains must not be bridged. Connect C_WATCH_VCC.1 → R_SCL_A.1. Hole path (19,28) → (19,27.5) → (24.5,27.5) → (24.5,6.5) → (30,6.5) → (30,6). Insulate every crossing; solder only the two endpoints. Confirm endpoint continuity (<1Ω for a wire) and no adjacent-net bridge; isolate parallel paths before measuring.
88. **Connect W8 · USB_3V3:** 3.3-V electronics supply. USB and bench supply domains must not be bridged. Connect C_WATCH_VCC.1 → R_SDA_0.1. Hole path (19,28) → (19,27.5) → (24.5,27.5) → (24.5,11.5) → (30,11.5) → (30,11). Insulate every crossing; solder only the two endpoints.
89. **Verify W8 · USB_3V3:** Power disconnected: 3.3-V electronics supply. USB and bench supply domains must not be bridged. Connect C_WATCH_VCC.1 → R_SDA_0.1. Hole path (19,28) → (19,27.5) → (24.5,27.5) → (24.5,11.5) → (30,11.5) → (30,11). Insulate every crossing; solder only the two endpoints. Confirm endpoint continuity (<1Ω for a wire) and no adjacent-net bridge; isolate parallel paths before measuring.
90. **Connect W9 · USB_3V3:** 3.3-V electronics supply. USB and bench supply domains must not be bridged. Connect C_WATCH_VCC.1 → R_SDA_1.1. Hole path (19,28) → (19,27.5) → (18.5,27.5) → (18.5,14.5) → (19,14.5) → (19,14). Insulate every crossing; solder only the two endpoints.
91. **Verify W9 · USB_3V3:** Power disconnected: 3.3-V electronics supply. USB and bench supply domains must not be bridged. Connect C_WATCH_VCC.1 → R_SDA_1.1. Hole path (19,28) → (19,27.5) → (18.5,27.5) → (18.5,14.5) → (19,14.5) → (19,14). Insulate every crossing; solder only the two endpoints. Confirm endpoint continuity (<1Ω for a wire) and no adjacent-net bridge; isolate parallel paths before measuring.
92. **Connect W10 · USB_3V3:** 3.3-V electronics supply. USB and bench supply domains must not be bridged. Connect C_WATCH_VCC.1 → R_SDA_2.1. Hole path (19,28) → (19,27.5) → (22.5,27.5) → (22.5,15.5) → (26,15.5) → (26,15). Insulate every crossing; solder only the two endpoints.
93. **Verify W10 · USB_3V3:** Power disconnected: 3.3-V electronics supply. USB and bench supply domains must not be bridged. Connect C_WATCH_VCC.1 → R_SDA_2.1. Hole path (19,28) → (19,27.5) → (22.5,27.5) → (22.5,15.5) → (26,15.5) → (26,15). Insulate every crossing; solder only the two endpoints. Confirm endpoint continuity (<1Ω for a wire) and no adjacent-net bridge; isolate parallel paths before measuring.
94. **Connect W11 · USB_3V3:** 3.3-V electronics supply. USB and bench supply domains must not be bridged. Connect C_WATCH_VCC.1 → R_SDA_3.1. Hole path (19,28) → (19,27.5) → (25.5,27.5) → (25.5,15.5) → (33,15.5) → (33,15). Insulate every crossing; solder only the two endpoints.
95. **Verify W11 · USB_3V3:** Power disconnected: 3.3-V electronics supply. USB and bench supply domains must not be bridged. Connect C_WATCH_VCC.1 → R_SDA_3.1. Hole path (19,28) → (19,27.5) → (25.5,27.5) → (25.5,15.5) → (33,15.5) → (33,15). Insulate every crossing; solder only the two endpoints. Confirm endpoint continuity (<1Ω for a wire) and no adjacent-net bridge; isolate parallel paths before measuring.
96. **Connect W12 · USB_3V3:** 3.3-V electronics supply. USB and bench supply domains must not be bridged. Connect C_WATCH_VCC.1 → R_SDA_4.1. Hole path (19,28) → (19,27.5) → (18.5,27.5) → (18.5,19.5) → (19,19.5) → (19,19). Insulate every crossing; solder only the two endpoints.
97. **Verify W12 · USB_3V3:** Power disconnected: 3.3-V electronics supply. USB and bench supply domains must not be bridged. Connect C_WATCH_VCC.1 → R_SDA_4.1. Hole path (19,28) → (19,27.5) → (18.5,27.5) → (18.5,19.5) → (19,19.5) → (19,19). Insulate every crossing; solder only the two endpoints. Confirm endpoint continuity (<1Ω for a wire) and no adjacent-net bridge; isolate parallel paths before measuring.
98. **Connect W13 · USB_3V3:** 3.3-V electronics supply. USB and bench supply domains must not be bridged. Connect C_WATCH_VCC.1 → R_SDA_5.1. Hole path (19,28) → (19,27.5) → (22.5,27.5) → (22.5,20.5) → (26,20.5) → (26,20). Insulate every crossing; solder only the two endpoints.
99. **Verify W13 · USB_3V3:** Power disconnected: 3.3-V electronics supply. USB and bench supply domains must not be bridged. Connect C_WATCH_VCC.1 → R_SDA_5.1. Hole path (19,28) → (19,27.5) → (22.5,27.5) → (22.5,20.5) → (26,20.5) → (26,20). Insulate every crossing; solder only the two endpoints. Confirm endpoint continuity (<1Ω for a wire) and no adjacent-net bridge; isolate parallel paths before measuring.
100. **Connect W14 · USB_3V3:** 3.3-V electronics supply. USB and bench supply domains must not be bridged. Connect C_WATCH_VCC.1 → R_USB_POR.1. Hole path (19,28) → (19,27.5) → (21.5,27.5) → (21.5,34.5) → (25,34.5) → (25,34). Insulate every crossing; solder only the two endpoints.
101. **Verify W14 · USB_3V3:** Power disconnected: 3.3-V electronics supply. USB and bench supply domains must not be bridged. Connect C_WATCH_VCC.1 → R_USB_POR.1. Hole path (19,28) → (19,27.5) → (21.5,27.5) → (21.5,34.5) → (25,34.5) → (25,34). Insulate every crossing; solder only the two endpoints. Confirm endpoint continuity (<1Ω for a wire) and no adjacent-net bridge; isolate parallel paths before measuring.
102. **Connect W15 · USB_3V3:** 3.3-V electronics supply. USB and bench supply domains must not be bridged. Connect C_WATCH_VCC.1 → R_WATCH.1. Hole path (19,28) → (19,27.5) → (18.5,27.5) → (18.5,23.5) → (19,23.5) → (19,23). Insulate every crossing; solder only the two endpoints.
103. **Verify W15 · USB_3V3:** Power disconnected: 3.3-V electronics supply. USB and bench supply domains must not be bridged. Connect C_WATCH_VCC.1 → R_WATCH.1. Hole path (19,28) → (19,27.5) → (18.5,27.5) → (18.5,23.5) → (19,23.5) → (19,23). Insulate every crossing; solder only the two endpoints. Confirm endpoint continuity (<1Ω for a wire) and no adjacent-net bridge; isolate parallel paths before measuring.
104. **Connect W16 · USB_3V3:** 3.3-V electronics supply. USB and bench supply domains must not be bridged. Connect C_WATCH_VCC.1 → U_ESP2.1. Hole path (19,28) → (19,27.5) → (12.5,27.5) → (12.5,11.5) → (6,11.5) → (6,11). Insulate every crossing; solder only the two endpoints.
105. **Verify W16 · USB_3V3:** Power disconnected: 3.3-V electronics supply. USB and bench supply domains must not be bridged. Connect C_WATCH_VCC.1 → U_ESP2.1. Hole path (19,28) → (19,27.5) → (12.5,27.5) → (12.5,11.5) → (6,11.5) → (6,11). Insulate every crossing; solder only the two endpoints. Confirm endpoint continuity (<1Ω for a wire) and no adjacent-net bridge; isolate parallel paths before measuring.
106. **Connect W17 · USB_3V3:** 3.3-V electronics supply. USB and bench supply domains must not be bridged. Connect C_WATCH_VCC.1 → U_USB_POR.2. Hole path (19,28) → (19,27.5) → (18.5,27.5) → (18.5,36.5) → (19,36.5) → (19,36). Insulate every crossing; solder only the two endpoints.
107. **Verify W17 · USB_3V3:** Power disconnected: 3.3-V electronics supply. USB and bench supply domains must not be bridged. Connect C_WATCH_VCC.1 → U_USB_POR.2. Hole path (19,28) → (19,27.5) → (18.5,27.5) → (18.5,36.5) → (19,36.5) → (19,36). Insulate every crossing; solder only the two endpoints. Confirm endpoint continuity (<1Ω for a wire) and no adjacent-net bridge; isolate parallel paths before measuring.
108. **Connect W18 · USB_3V3:** 3.3-V electronics supply. USB and bench supply domains must not be bridged. Connect C_WATCH_VCC.1 → U_WATCH.16. Hole path (19,28) → (19,27.5) → (27.5,27.5) → (27.5,22.5) → (36,22.5) → (36,22). Insulate every crossing; solder only the two endpoints.
109. **Verify W18 · USB_3V3:** Power disconnected: 3.3-V electronics supply. USB and bench supply domains must not be bridged. Connect C_WATCH_VCC.1 → U_WATCH.16. Hole path (19,28) → (19,27.5) → (27.5,27.5) → (27.5,22.5) → (36,22.5) → (36,22). Insulate every crossing; solder only the two endpoints. Confirm endpoint continuity (<1Ω for a wire) and no adjacent-net bridge; isolate parallel paths before measuring.
110. **Connect W19 · GND:** Common electrical reference and return; keep student, USB and service ground identities consistent. Connect C_SR0.2 → C_SR1.2. Hole path (37,41) → (37,40.5) → (22,40.5) → (22,46.5) → (6,46.5) → (6,46). Insulate every crossing; solder only the two endpoints.
111. **Verify W19 · GND:** Power disconnected: Common electrical reference and return; keep student, USB and service ground identities consistent. Connect C_SR0.2 → C_SR1.2. Hole path (37,41) → (37,40.5) → (22,40.5) → (22,46.5) → (6,46.5) → (6,46). Insulate every crossing; solder only the two endpoints. Confirm endpoint continuity (<1Ω for a wire) and no adjacent-net bridge; isolate parallel paths before measuring.
112. **Connect W20 · GND:** Common electrical reference and return; keep student, USB and service ground identities consistent. Connect C_SR0.2 → C_SR2.2. Hole path (37,41) → (37,40.5) → (27,40.5) → (27,46.5) → (16,46.5) → (16,46). Insulate every crossing; solder only the two endpoints.
113. **Verify W20 · GND:** Power disconnected: Common electrical reference and return; keep student, USB and service ground identities consistent. Connect C_SR0.2 → C_SR2.2. Hole path (37,41) → (37,40.5) → (27,40.5) → (27,46.5) → (16,46.5) → (16,46). Insulate every crossing; solder only the two endpoints. Confirm endpoint continuity (<1Ω for a wire) and no adjacent-net bridge; isolate parallel paths before measuring.
114. **Connect W21 · GND:** Common electrical reference and return; keep student, USB and service ground identities consistent. Connect C_SR0.2 → C_WATCH_VCC.2. Hole path (37,41) → (37,40.5) → (29,40.5) → (29,28.5) → (20,28.5) → (20,28). Insulate every crossing; solder only the two endpoints.
115. **Verify W21 · GND:** Power disconnected: Common electrical reference and return; keep student, USB and service ground identities consistent. Connect C_SR0.2 → C_WATCH_VCC.2. Hole path (37,41) → (37,40.5) → (29,40.5) → (29,28.5) → (20,28.5) → (20,28). Insulate every crossing; solder only the two endpoints. Confirm endpoint continuity (<1Ω for a wire) and no adjacent-net bridge; isolate parallel paths before measuring.
116. **Connect W22 · GND:** Common electrical reference and return; keep student, USB and service ground identities consistent. Connect C_SR0.2 → J_CH0.4. Hole path (37,41) → (37,40.5) → (28,40.5) → (28,63.5) → (18,63.5) → (18,63). Insulate every crossing; solder only the two endpoints.
117. **Verify W22 · GND:** Power disconnected: Common electrical reference and return; keep student, USB and service ground identities consistent. Connect C_SR0.2 → J_CH0.4. Hole path (37,41) → (37,40.5) → (28,40.5) → (28,63.5) → (18,63.5) → (18,63). Insulate every crossing; solder only the two endpoints. Confirm endpoint continuity (<1Ω for a wire) and no adjacent-net bridge; isolate parallel paths before measuring.
118. **Connect W23 · GND:** Common electrical reference and return; keep student, USB and service ground identities consistent. Connect C_SR0.2 → J_CH1.4. Hole path (37,41) → (37,40.5) → (22,40.5) → (22,64.5) → (6,64.5) → (6,64). Insulate every crossing; solder only the two endpoints.
119. **Verify W23 · GND:** Power disconnected: Common electrical reference and return; keep student, USB and service ground identities consistent. Connect C_SR0.2 → J_CH1.4. Hole path (37,41) → (37,40.5) → (22,40.5) → (22,64.5) → (6,64.5) → (6,64). Insulate every crossing; solder only the two endpoints. Confirm endpoint continuity (<1Ω for a wire) and no adjacent-net bridge; isolate parallel paths before measuring.
120. **Connect W24 · GND:** Common electrical reference and return; keep student, USB and service ground identities consistent. Connect C_SR0.2 → J_CH2.4. Hole path (37,41) → (37,40.5) → (33,40.5) → (33,64.5) → (28,64.5) → (28,64). Insulate every crossing; solder only the two endpoints.
121. **Verify W24 · GND:** Power disconnected: Common electrical reference and return; keep student, USB and service ground identities consistent. Connect C_SR0.2 → J_CH2.4. Hole path (37,41) → (37,40.5) → (33,40.5) → (33,64.5) → (28,64.5) → (28,64). Insulate every crossing; solder only the two endpoints. Confirm endpoint continuity (<1Ω for a wire) and no adjacent-net bridge; isolate parallel paths before measuring.
122. **Connect W25 · GND:** Common electrical reference and return; keep student, USB and service ground identities consistent. Connect C_SR0.2 → J_CH3.4. Hole path (37,41) → (37,40.5) → (27,40.5) → (27,72.5) → (16,72.5) → (16,72). Insulate every crossing; solder only the two endpoints.
123. **Verify W25 · GND:** Power disconnected: Common electrical reference and return; keep student, USB and service ground identities consistent. Connect C_SR0.2 → J_CH3.4. Hole path (37,41) → (37,40.5) → (27,40.5) → (27,72.5) → (16,72.5) → (16,72). Insulate every crossing; solder only the two endpoints. Confirm endpoint continuity (<1Ω for a wire) and no adjacent-net bridge; isolate parallel paths before measuring.
124. **Connect W26 · GND:** Common electrical reference and return; keep student, USB and service ground identities consistent. Connect C_SR0.2 → J_CH4.4. Hole path (37,41) → (37,40.5) → (22,40.5) → (22,74.5) → (6,74.5) → (6,74). Insulate every crossing; solder only the two endpoints.
125. **Verify W26 · GND:** Power disconnected: Common electrical reference and return; keep student, USB and service ground identities consistent. Connect C_SR0.2 → J_CH4.4. Hole path (37,41) → (37,40.5) → (22,40.5) → (22,74.5) → (6,74.5) → (6,74). Insulate every crossing; solder only the two endpoints. Confirm endpoint continuity (<1Ω for a wire) and no adjacent-net bridge; isolate parallel paths before measuring.
126. **Connect W27 · GND:** Common electrical reference and return; keep student, USB and service ground identities consistent. Connect C_SR0.2 → J_CH5.4. Hole path (37,41) → (37,40.5) → (32,40.5) → (32,74.5) → (26,74.5) → (26,74). Insulate every crossing; solder only the two endpoints.
127. **Verify W27 · GND:** Power disconnected: Common electrical reference and return; keep student, USB and service ground identities consistent. Connect C_SR0.2 → J_CH5.4. Hole path (37,41) → (37,40.5) → (32,40.5) → (32,74.5) → (26,74.5) → (26,74). Insulate every crossing; solder only the two endpoints. Confirm endpoint continuity (<1Ω for a wire) and no adjacent-net bridge; isolate parallel paths before measuring.
128. **Connect W28 · GND:** Common electrical reference and return; keep student, USB and service ground identities consistent. Connect C_SR0.2 → J_POWER.2. Hole path (37,41) → (37,40.5) → (29,40.5) → (29,7.5) → (21,7.5) → (21,7). Insulate every crossing; solder only the two endpoints.
129. **Verify W28 · GND:** Power disconnected: Common electrical reference and return; keep student, USB and service ground identities consistent. Connect C_SR0.2 → J_POWER.2. Hole path (37,41) → (37,40.5) → (29,40.5) → (29,7.5) → (21,7.5) → (21,7). Insulate every crossing; solder only the two endpoints. Confirm endpoint continuity (<1Ω for a wire) and no adjacent-net bridge; isolate parallel paths before measuring.
130. **Connect W29 · GND:** Common electrical reference and return; keep student, USB and service ground identities consistent. Connect C_SR0.2 → J_POWER.4. Hole path (37,41) → (37,40.5) → (30,40.5) → (30,7.5) → (22,7.5) → (22,7). Insulate every crossing; solder only the two endpoints.
131. **Verify W29 · GND:** Power disconnected: Common electrical reference and return; keep student, USB and service ground identities consistent. Connect C_SR0.2 → J_POWER.4. Hole path (37,41) → (37,40.5) → (30,40.5) → (30,7.5) → (22,7.5) → (22,7). Insulate every crossing; solder only the two endpoints. Confirm endpoint continuity (<1Ω for a wire) and no adjacent-net bridge; isolate parallel paths before measuring.
132. **Connect W30 · GND:** Common electrical reference and return; keep student, USB and service ground identities consistent. Connect C_SR0.2 → J_POWER.6. Hole path (37,41) → (37,40.5) → (30,40.5) → (30,7.5) → (23,7.5) → (23,7). Insulate every crossing; solder only the two endpoints.
133. **Verify W30 · GND:** Power disconnected: Common electrical reference and return; keep student, USB and service ground identities consistent. Connect C_SR0.2 → J_POWER.6. Hole path (37,41) → (37,40.5) → (30,40.5) → (30,7.5) → (23,7.5) → (23,7). Insulate every crossing; solder only the two endpoints. Confirm endpoint continuity (<1Ω for a wire) and no adjacent-net bridge; isolate parallel paths before measuring.
134. **Connect W31 · GND:** Common electrical reference and return; keep student, USB and service ground identities consistent. Connect C_SR0.2 → Q_RAIL.1. Hole path (37,41) → (37,40.5) → (21,40.5) → (21,41.5) → (5,41.5) → (5,41). Insulate every crossing; solder only the two endpoints.
135. **Verify W31 · GND:** Power disconnected: Common electrical reference and return; keep student, USB and service ground identities consistent. Connect C_SR0.2 → Q_RAIL.1. Hole path (37,41) → (37,40.5) → (21,40.5) → (21,41.5) → (5,41.5) → (5,41). Insulate every crossing; solder only the two endpoints. Confirm endpoint continuity (<1Ω for a wire) and no adjacent-net bridge; isolate parallel paths before measuring.
136. **Connect W32 · GND:** Common electrical reference and return; keep student, USB and service ground identities consistent. Connect C_SR0.2 → R_ALIVE_OFF.2. Hole path (37,41) → (37,40.5) → (26,40.5) → (26,41.5) → (14,41.5) → (14,41). Insulate every crossing; solder only the two endpoints.
137. **Verify W32 · GND:** Power disconnected: Common electrical reference and return; keep student, USB and service ground identities consistent. Connect C_SR0.2 → R_ALIVE_OFF.2. Hole path (37,41) → (37,40.5) → (26,40.5) → (26,41.5) → (14,41.5) → (14,41). Insulate every crossing; solder only the two endpoints. Confirm endpoint continuity (<1Ω for a wire) and no adjacent-net bridge; isolate parallel paths before measuring.
138. **Connect W33 · GND:** Common electrical reference and return; keep student, USB and service ground identities consistent. Connect C_SR0.2 → R_HEART.2. Hole path (37,41) → (37,40.5) → (32,40.5) → (32,30.5) → (27,30.5) → (27,30). Insulate every crossing; solder only the two endpoints.
139. **Verify W33 · GND:** Power disconnected: Common electrical reference and return; keep student, USB and service ground identities consistent. Connect C_SR0.2 → R_HEART.2. Hole path (37,41) → (37,40.5) → (32,40.5) → (32,30.5) → (27,30.5) → (27,30). Insulate every crossing; solder only the two endpoints. Confirm endpoint continuity (<1Ω for a wire) and no adjacent-net bridge; isolate parallel paths before measuring.
140. **Connect W34 · GND:** Common electrical reference and return; keep student, USB and service ground identities consistent. Connect C_SR0.2 → R_RAIL_OFF.2. Hole path (37,41) → (37,40.5) → (29,40.5) → (29,41.5) → (21,41.5) → (21,41). Insulate every crossing; solder only the two endpoints.
141. **Verify W34 · GND:** Power disconnected: Common electrical reference and return; keep student, USB and service ground identities consistent. Connect C_SR0.2 → R_RAIL_OFF.2. Hole path (37,41) → (37,40.5) → (29,40.5) → (29,41.5) → (21,41.5) → (21,41). Insulate every crossing; solder only the two endpoints. Confirm endpoint continuity (<1Ω for a wire) and no adjacent-net bridge; isolate parallel paths before measuring.
142. **Connect W35 · GND:** Common electrical reference and return; keep student, USB and service ground identities consistent. Connect C_SR0.2 → R_SR_RCLK_OFF.2. Hole path (37,41) → (37,40.5) → (36,40.5) → (36,57.5) → (34,57.5) → (34,57). Insulate every crossing; solder only the two endpoints.
143. **Verify W35 · GND:** Power disconnected: Common electrical reference and return; keep student, USB and service ground identities consistent. Connect C_SR0.2 → R_SR_RCLK_OFF.2. Hole path (37,41) → (37,40.5) → (36,40.5) → (36,57.5) → (34,57.5) → (34,57). Insulate every crossing; solder only the two endpoints. Confirm endpoint continuity (<1Ω for a wire) and no adjacent-net bridge; isolate parallel paths before measuring.
144. **Connect W36 · GND:** Common electrical reference and return; keep student, USB and service ground identities consistent. Connect C_SR0.2 → R_SR_SER_OFF.2. Hole path (37,41) → (37,40.5) → (28,40.5) → (28,50.5) → (19,50.5) → (19,50). Insulate every crossing; solder only the two endpoints.
145. **Verify W36 · GND:** Power disconnected: Common electrical reference and return; keep student, USB and service ground identities consistent. Connect C_SR0.2 → R_SR_SER_OFF.2. Hole path (37,41) → (37,40.5) → (28,40.5) → (28,50.5) → (19,50.5) → (19,50). Insulate every crossing; solder only the two endpoints. Confirm endpoint continuity (<1Ω for a wire) and no adjacent-net bridge; isolate parallel paths before measuring.
146. **Connect W37 · GND:** Common electrical reference and return; keep student, USB and service ground identities consistent. Connect C_SR0.2 → R_SR_SRCLK_OFF.2. Hole path (37,41) → (37,40.5) → (28,40.5) → (28,55.5) → (19,55.5) → (19,55). Insulate every crossing; solder only the two endpoints.
147. **Verify W37 · GND:** Power disconnected: Common electrical reference and return; keep student, USB and service ground identities consistent. Connect C_SR0.2 → R_SR_SRCLK_OFF.2. Hole path (37,41) → (37,40.5) → (28,40.5) → (28,55.5) → (19,55.5) → (19,55). Insulate every crossing; solder only the two endpoints. Confirm endpoint continuity (<1Ω for a wire) and no adjacent-net bridge; isolate parallel paths before measuring.
148. **Connect W38 · GND:** Common electrical reference and return; keep student, USB and service ground identities consistent. Connect C_SR0.2 → U_ESP2.14. Hole path (37,41) → (37,40.5) → (22,40.5) → (22,24.5) → (6,24.5) → (6,24). Insulate every crossing; solder only the two endpoints.
149. **Verify W38 · GND:** Power disconnected: Common electrical reference and return; keep student, USB and service ground identities consistent. Connect C_SR0.2 → U_ESP2.14. Hole path (37,41) → (37,40.5) → (22,40.5) → (22,24.5) → (6,24.5) → (6,24). Insulate every crossing; solder only the two endpoints. Confirm endpoint continuity (<1Ω for a wire) and no adjacent-net bridge; isolate parallel paths before measuring.
150. **Connect W39 · GND:** Common electrical reference and return; keep student, USB and service ground identities consistent. Connect C_SR0.2 → U_ESP2.20. Hole path (37,41) → (37,40.5) → (27,40.5) → (27,11.5) → (16,11.5) → (16,11). Insulate every crossing; solder only the two endpoints.
151. **Verify W39 · GND:** Power disconnected: Common electrical reference and return; keep student, USB and service ground identities consistent. Connect C_SR0.2 → U_ESP2.20. Hole path (37,41) → (37,40.5) → (27,40.5) → (27,11.5) → (16,11.5) → (16,11). Insulate every crossing; solder only the two endpoints. Confirm endpoint continuity (<1Ω for a wire) and no adjacent-net bridge; isolate parallel paths before measuring.
152. **Connect W40 · GND:** Common electrical reference and return; keep student, USB and service ground identities consistent. Connect C_SR0.2 → U_ESP2.26. Hole path (37,41) → (37,40.5) → (27,40.5) → (27,17.5) → (16,17.5) → (16,17). Insulate every crossing; solder only the two endpoints.
153. **Verify W40 · GND:** Power disconnected: Common electrical reference and return; keep student, USB and service ground identities consistent. Connect C_SR0.2 → U_ESP2.26. Hole path (37,41) → (37,40.5) → (27,40.5) → (27,17.5) → (16,17.5) → (16,17). Insulate every crossing; solder only the two endpoints. Confirm endpoint continuity (<1Ω for a wire) and no adjacent-net bridge; isolate parallel paths before measuring.
154. **Connect W41 · GND:** Common electrical reference and return; keep student, USB and service ground identities consistent. Connect C_SR0.2 → U_SR0.8. Hole path (37,41) → (37,40.5) → (34,40.5) → (34,50.5) → (30,50.5) → (30,50). Insulate every crossing; solder only the two endpoints.
155. **Verify W41 · GND:** Power disconnected: Common electrical reference and return; keep student, USB and service ground identities consistent. Connect C_SR0.2 → U_SR0.8. Hole path (37,41) → (37,40.5) → (34,40.5) → (34,50.5) → (30,50.5) → (30,50). Insulate every crossing; solder only the two endpoints. Confirm endpoint continuity (<1Ω for a wire) and no adjacent-net bridge; isolate parallel paths before measuring.
156. **Connect W42 · GND:** Common electrical reference and return; keep student, USB and service ground identities consistent. Connect C_SR0.2 → U_SR1.8. Hole path (37,41) → (37,40.5) → (31,40.5) → (31,53.5) → (24,53.5) → (24,53). Insulate every crossing; solder only the two endpoints.
157. **Verify W42 · GND:** Power disconnected: Common electrical reference and return; keep student, USB and service ground identities consistent. Connect C_SR0.2 → U_SR1.8. Hole path (37,41) → (37,40.5) → (31,40.5) → (31,53.5) → (24,53.5) → (24,53). Insulate every crossing; solder only the two endpoints. Confirm endpoint continuity (<1Ω for a wire) and no adjacent-net bridge; isolate parallel paths before measuring.
158. **Connect W43 · GND:** Common electrical reference and return; keep student, USB and service ground identities consistent. Connect C_SR0.2 → U_SR2.8. Hole path (37,41) → (37,40.5) → (23,40.5) → (23,55.5) → (9,55.5) → (9,55). Insulate every crossing; solder only the two endpoints.
159. **Verify W43 · GND:** Power disconnected: Common electrical reference and return; keep student, USB and service ground identities consistent. Connect C_SR0.2 → U_SR2.8. Hole path (37,41) → (37,40.5) → (23,40.5) → (23,55.5) → (9,55.5) → (9,55). Insulate every crossing; solder only the two endpoints. Confirm endpoint continuity (<1Ω for a wire) and no adjacent-net bridge; isolate parallel paths before measuring.
160. **Connect W44 · GND:** Common electrical reference and return; keep student, USB and service ground identities consistent. Connect C_SR0.2 → U_USB_POR.3. Hole path (37,41) → (37,40.5) → (30,40.5) → (30,35.5) → (22,35.5) → (22,35). Insulate every crossing; solder only the two endpoints.
161. **Verify W44 · GND:** Power disconnected: Common electrical reference and return; keep student, USB and service ground identities consistent. Connect C_SR0.2 → U_USB_POR.3. Hole path (37,41) → (37,40.5) → (30,40.5) → (30,35.5) → (22,35.5) → (22,35). Insulate every crossing; solder only the two endpoints. Confirm endpoint continuity (<1Ω for a wire) and no adjacent-net bridge; isolate parallel paths before measuring.
162. **Connect W45 · GND:** Common electrical reference and return; keep student, USB and service ground identities consistent. Connect C_SR0.2 → U_WATCH.1. Hole path (37,41) → (37,40.5) → (35,40.5) → (35,22.5) → (33,22.5) → (33,22). Insulate every crossing; solder only the two endpoints.
163. **Verify W45 · GND:** Power disconnected: Common electrical reference and return; keep student, USB and service ground identities consistent. Connect C_SR0.2 → U_WATCH.1. Hole path (37,41) → (37,40.5) → (35,40.5) → (35,22.5) → (33,22.5) → (33,22). Insulate every crossing; solder only the two endpoints. Confirm endpoint continuity (<1Ω for a wire) and no adjacent-net bridge; isolate parallel paths before measuring.
164. **Connect W46 · GND:** Common electrical reference and return; keep student, USB and service ground identities consistent. Connect C_SR0.2 → U_WATCH.8. Hole path (37,41) → (37,40.5) → (35,40.5) → (35,29.5) → (33,29.5) → (33,29). Insulate every crossing; solder only the two endpoints.
165. **Verify W46 · GND:** Power disconnected: Common electrical reference and return; keep student, USB and service ground identities consistent. Connect C_SR0.2 → U_WATCH.8. Hole path (37,41) → (37,40.5) → (35,40.5) → (35,29.5) → (33,29.5) → (33,29). Insulate every crossing; solder only the two endpoints. Confirm endpoint continuity (<1Ω for a wire) and no adjacent-net bridge; isolate parallel paths before measuring.
166. **Connect W47 · GND:** Common electrical reference and return; keep student, USB and service ground identities consistent. Connect C_SR0.2 → U_WATCH.9. Hole path (37,41) → (37,40.5) → (37,29.5) → (36,29.5) → (36,29). Insulate every crossing; solder only the two endpoints.
167. **Verify W47 · GND:** Power disconnected: Common electrical reference and return; keep student, USB and service ground identities consistent. Connect C_SR0.2 → U_WATCH.9. Hole path (37,41) → (37,40.5) → (37,29.5) → (36,29.5) → (36,29). Insulate every crossing; solder only the two endpoints. Confirm endpoint continuity (<1Ω for a wire) and no adjacent-net bridge; isolate parallel paths before measuring.
168. **Connect W48 · GND:** Common electrical reference and return; keep student, USB and service ground identities consistent. Connect C_SR0.2 → U_WATCH.10. Hole path (37,41) → (37,40.5) → (37,28.5) → (36,28.5) → (36,28). Insulate every crossing; solder only the two endpoints.
169. **Verify W48 · GND:** Power disconnected: Common electrical reference and return; keep student, USB and service ground identities consistent. Connect C_SR0.2 → U_WATCH.10. Hole path (37,41) → (37,40.5) → (37,28.5) → (36,28.5) → (36,28). Insulate every crossing; solder only the two endpoints. Confirm endpoint continuity (<1Ω for a wire) and no adjacent-net bridge; isolate parallel paths before measuring.
170. **Connect W49 · GND:** Common electrical reference and return; keep student, USB and service ground identities consistent. Connect C_SR0.2 → U_WATCH.11. Hole path (37,41) → (37,40.5) → (37,27.5) → (36,27.5) → (36,27). Insulate every crossing; solder only the two endpoints.
171. **Verify W49 · GND:** Power disconnected: Common electrical reference and return; keep student, USB and service ground identities consistent. Connect C_SR0.2 → U_WATCH.11. Hole path (37,41) → (37,40.5) → (37,27.5) → (36,27.5) → (36,27). Insulate every crossing; solder only the two endpoints. Confirm endpoint continuity (<1Ω for a wire) and no adjacent-net bridge; isolate parallel paths before measuring.
172. **Connect W50 · SR_SRCLK:** Named control/interconnect for sr srclk. Verify both pin functions against the schematic before soldering. Connect R_SR_SRCLK_OFF.1 → U_ESP2.9. Hole path (15,55) → (15,54.5) → (11.5,54.5) → (11.5,19.5) → (6,19.5) → (6,19). Insulate every crossing; solder only the two endpoints.
173. **Verify W50 · SR_SRCLK:** Power disconnected: Named control/interconnect for sr srclk. Verify both pin functions against the schematic before soldering. Connect R_SR_SRCLK_OFF.1 → U_ESP2.9. Hole path (15,55) → (15,54.5) → (11.5,54.5) → (11.5,19.5) → (6,19.5) → (6,19). Insulate every crossing; solder only the two endpoints. Confirm endpoint continuity (<1Ω for a wire) and no adjacent-net bridge; isolate parallel paths before measuring.
174. **Connect W51 · SR_SRCLK:** Named control/interconnect for sr srclk. Verify both pin functions against the schematic before soldering. Connect R_SR_SRCLK_OFF.1 → U_SR0.11. Hole path (15,55) → (15,54.5) → (24.5,54.5) → (24.5,48.5) → (33,48.5) → (33,48). Insulate every crossing; solder only the two endpoints.
175. **Verify W51 · SR_SRCLK:** Power disconnected: Named control/interconnect for sr srclk. Verify both pin functions against the schematic before soldering. Connect R_SR_SRCLK_OFF.1 → U_SR0.11. Hole path (15,55) → (15,54.5) → (24.5,54.5) → (24.5,48.5) → (33,48.5) → (33,48). Insulate every crossing; solder only the two endpoints. Confirm endpoint continuity (<1Ω for a wire) and no adjacent-net bridge; isolate parallel paths before measuring.
176. **Connect W52 · SR_SRCLK:** Named control/interconnect for sr srclk. Verify both pin functions against the schematic before soldering. Connect R_SR_SRCLK_OFF.1 → U_SR1.11. Hole path (15,55) → (15,54.5) → (21.5,54.5) → (21.5,51.5) → (27,51.5) → (27,51). Insulate every crossing; solder only the two endpoints.
177. **Verify W52 · SR_SRCLK:** Power disconnected: Named control/interconnect for sr srclk. Verify both pin functions against the schematic before soldering. Connect R_SR_SRCLK_OFF.1 → U_SR1.11. Hole path (15,55) → (15,54.5) → (21.5,54.5) → (21.5,51.5) → (27,51.5) → (27,51). Insulate every crossing; solder only the two endpoints. Confirm endpoint continuity (<1Ω for a wire) and no adjacent-net bridge; isolate parallel paths before measuring.
178. **Connect W53 · SR_SRCLK:** Named control/interconnect for sr srclk. Verify both pin functions against the schematic before soldering. Connect R_SR_SRCLK_OFF.1 → U_SR2.11. Hole path (15,55) → (15,54.5) → (14.5,54.5) → (14.5,53.5) → (12,53.5) → (12,53). Insulate every crossing; solder only the two endpoints.
179. **Verify W53 · SR_SRCLK:** Power disconnected: Named control/interconnect for sr srclk. Verify both pin functions against the schematic before soldering. Connect R_SR_SRCLK_OFF.1 → U_SR2.11. Hole path (15,55) → (15,54.5) → (14.5,54.5) → (14.5,53.5) → (12,53.5) → (12,53). Insulate every crossing; solder only the two endpoints. Confirm endpoint continuity (<1Ω for a wire) and no adjacent-net bridge; isolate parallel paths before measuring.
180. **Connect W54 · SR_RCLK:** Named control/interconnect for sr rclk. Verify both pin functions against the schematic before soldering. Connect R_SR_RCLK_OFF.1 → U_ESP2.10. Hole path (30,57) → (30,56.5) → (17.5,56.5) → (17.5,20.5) → (6,20.5) → (6,20). Insulate every crossing; solder only the two endpoints.
181. **Verify W54 · SR_RCLK:** Power disconnected: Named control/interconnect for sr rclk. Verify both pin functions against the schematic before soldering. Connect R_SR_RCLK_OFF.1 → U_ESP2.10. Hole path (30,57) → (30,56.5) → (17.5,56.5) → (17.5,20.5) → (6,20.5) → (6,20). Insulate every crossing; solder only the two endpoints. Confirm endpoint continuity (<1Ω for a wire) and no adjacent-net bridge; isolate parallel paths before measuring.
182. **Connect W55 · SR_RCLK:** Named control/interconnect for sr rclk. Verify both pin functions against the schematic before soldering. Connect R_SR_RCLK_OFF.1 → U_SR0.12. Hole path (30,57) → (30,56.5) → (31.5,56.5) → (31.5,47.5) → (33,47.5) → (33,47). Insulate every crossing; solder only the two endpoints.
183. **Verify W55 · SR_RCLK:** Power disconnected: Named control/interconnect for sr rclk. Verify both pin functions against the schematic before soldering. Connect R_SR_RCLK_OFF.1 → U_SR0.12. Hole path (30,57) → (30,56.5) → (31.5,56.5) → (31.5,47.5) → (33,47.5) → (33,47). Insulate every crossing; solder only the two endpoints. Confirm endpoint continuity (<1Ω for a wire) and no adjacent-net bridge; isolate parallel paths before measuring.
184. **Connect W56 · SR_RCLK:** Named control/interconnect for sr rclk. Verify both pin functions against the schematic before soldering. Connect R_SR_RCLK_OFF.1 → U_SR1.12. Hole path (30,57) → (30,56.5) → (28.5,56.5) → (28.5,50.5) → (27,50.5) → (27,50). Insulate every crossing; solder only the two endpoints.
185. **Verify W56 · SR_RCLK:** Power disconnected: Named control/interconnect for sr rclk. Verify both pin functions against the schematic before soldering. Connect R_SR_RCLK_OFF.1 → U_SR1.12. Hole path (30,57) → (30,56.5) → (28.5,56.5) → (28.5,50.5) → (27,50.5) → (27,50). Insulate every crossing; solder only the two endpoints. Confirm endpoint continuity (<1Ω for a wire) and no adjacent-net bridge; isolate parallel paths before measuring.
186. **Connect W57 · SR_RCLK:** Named control/interconnect for sr rclk. Verify both pin functions against the schematic before soldering. Connect R_SR_RCLK_OFF.1 → U_SR2.12. Hole path (30,57) → (30,56.5) → (20.5,56.5) → (20.5,52.5) → (12,52.5) → (12,52). Insulate every crossing; solder only the two endpoints.
187. **Verify W57 · SR_RCLK:** Power disconnected: Named control/interconnect for sr rclk. Verify both pin functions against the schematic before soldering. Connect R_SR_RCLK_OFF.1 → U_SR2.12. Hole path (30,57) → (30,56.5) → (20.5,56.5) → (20.5,52.5) → (12,52.5) → (12,52). Insulate every crossing; solder only the two endpoints. Confirm endpoint continuity (<1Ω for a wire) and no adjacent-net bridge; isolate parallel paths before measuring.
188. **Connect W58 · SR_SER:** Named control/interconnect for sr ser. Verify both pin functions against the schematic before soldering. Connect R_SR_SER_OFF.1 → U_ESP2.11. Hole path (15,50) → (15,49.5) → (11,49.5) → (11,21.5) → (6,21.5) → (6,21). Insulate every crossing; solder only the two endpoints.
189. **Verify W58 · SR_SER:** Power disconnected: Named control/interconnect for sr ser. Verify both pin functions against the schematic before soldering. Connect R_SR_SER_OFF.1 → U_ESP2.11. Hole path (15,50) → (15,49.5) → (11,49.5) → (11,21.5) → (6,21.5) → (6,21). Insulate every crossing; solder only the two endpoints. Confirm endpoint continuity (<1Ω for a wire) and no adjacent-net bridge; isolate parallel paths before measuring.
190. **Connect W59 · SR_SER:** Named control/interconnect for sr ser. Verify both pin functions against the schematic before soldering. Connect R_SR_SER_OFF.1 → U_SR0.14. Hole path (15,50) → (15,49.5) → (24,49.5) → (24,45.5) → (33,45.5) → (33,45). Insulate every crossing; solder only the two endpoints.
191. **Verify W59 · SR_SER:** Power disconnected: Named control/interconnect for sr ser. Verify both pin functions against the schematic before soldering. Connect R_SR_SER_OFF.1 → U_SR0.14. Hole path (15,50) → (15,49.5) → (24,49.5) → (24,45.5) → (33,45.5) → (33,45). Insulate every crossing; solder only the two endpoints. Confirm endpoint continuity (<1Ω for a wire) and no adjacent-net bridge; isolate parallel paths before measuring.
192. **Connect W60 · HEARTBEAT:** Protection, reset or readiness control; its defined polarity must preserve OFF at startup and on faults. Connect R_HEART.1 → U_ESP2.15. Hole path (23,30) → (23,29.5) → (15.5,29.5) → (15.5,25.5) → (6,25.5) → (6,25). Insulate every crossing; solder only the two endpoints.
193. **Verify W60 · HEARTBEAT:** Power disconnected: Protection, reset or readiness control; its defined polarity must preserve OFF at startup and on faults. Connect R_HEART.1 → U_ESP2.15. Hole path (23,30) → (23,29.5) → (15.5,29.5) → (15.5,25.5) → (6,25.5) → (6,25). Insulate every crossing; solder only the two endpoints. Confirm endpoint continuity (<1Ω for a wire) and no adjacent-net bridge; isolate parallel paths before measuring.
194. **Connect W61 · HEARTBEAT:** Protection, reset or readiness control; its defined polarity must preserve OFF at startup and on faults. Connect R_HEART.1 → U_WATCH.2. Hole path (23,30) → (23,29.5) → (28.5,29.5) → (28.5,23.5) → (33,23.5) → (33,23). Insulate every crossing; solder only the two endpoints.
195. **Verify W61 · HEARTBEAT:** Power disconnected: Protection, reset or readiness control; its defined polarity must preserve OFF at startup and on faults. Connect R_HEART.1 → U_WATCH.2. Hole path (23,30) → (23,29.5) → (28.5,29.5) → (28.5,23.5) → (33,23.5) → (33,23). Insulate every crossing; solder only the two endpoints. Confirm endpoint continuity (<1Ω for a wire) and no adjacent-net bridge; isolate parallel paths before measuring.
196. **Connect W62 · SCL_A:** I2C service signal. Maintain separate per-position SDA paths and do not join buffer B sides. Connect J_CH0.9 → J_CH1.9. Hole path (21,62) → (21,61.5) → (14.5,61.5) → (14.5,63.5) → (9,63.5) → (9,63). Insulate every crossing; solder only the two endpoints.
197. **Verify W62 · SCL_A:** Power disconnected: I2C service signal. Maintain separate per-position SDA paths and do not join buffer B sides. Connect J_CH0.9 → J_CH1.9. Hole path (21,62) → (21,61.5) → (14.5,61.5) → (14.5,63.5) → (9,63.5) → (9,63). Insulate every crossing; solder only the two endpoints. Confirm endpoint continuity (<1Ω for a wire) and no adjacent-net bridge; isolate parallel paths before measuring.
198. **Connect W63 · SCL_A:** I2C service signal. Maintain separate per-position SDA paths and do not join buffer B sides. Connect J_CH0.9 → J_CH2.9. Hole path (21,62) → (21,61.5) → (25.5,61.5) → (25.5,63.5) → (31,63.5) → (31,63). Insulate every crossing; solder only the two endpoints.
199. **Verify W63 · SCL_A:** Power disconnected: I2C service signal. Maintain separate per-position SDA paths and do not join buffer B sides. Connect J_CH0.9 → J_CH2.9. Hole path (21,62) → (21,61.5) → (25.5,61.5) → (25.5,63.5) → (31,63.5) → (31,63). Insulate every crossing; solder only the two endpoints. Confirm endpoint continuity (<1Ω for a wire) and no adjacent-net bridge; isolate parallel paths before measuring.
200. **Connect W64 · SCL_A:** I2C service signal. Maintain separate per-position SDA paths and do not join buffer B sides. Connect J_CH0.9 → J_CH3.9. Hole path (21,62) → (21,61.5) → (19.5,61.5) → (19.5,71.5) → (19,71.5) → (19,71). Insulate every crossing; solder only the two endpoints.
201. **Verify W64 · SCL_A:** Power disconnected: I2C service signal. Maintain separate per-position SDA paths and do not join buffer B sides. Connect J_CH0.9 → J_CH3.9. Hole path (21,62) → (21,61.5) → (19.5,61.5) → (19.5,71.5) → (19,71.5) → (19,71). Insulate every crossing; solder only the two endpoints. Confirm endpoint continuity (<1Ω for a wire) and no adjacent-net bridge; isolate parallel paths before measuring.
202. **Connect W65 · SCL_A:** I2C service signal. Maintain separate per-position SDA paths and do not join buffer B sides. Connect J_CH0.9 → J_CH4.9. Hole path (21,62) → (21,61.5) → (14.5,61.5) → (14.5,73.5) → (9,73.5) → (9,73). Insulate every crossing; solder only the two endpoints.
203. **Verify W65 · SCL_A:** Power disconnected: I2C service signal. Maintain separate per-position SDA paths and do not join buffer B sides. Connect J_CH0.9 → J_CH4.9. Hole path (21,62) → (21,61.5) → (14.5,61.5) → (14.5,73.5) → (9,73.5) → (9,73). Insulate every crossing; solder only the two endpoints. Confirm endpoint continuity (<1Ω for a wire) and no adjacent-net bridge; isolate parallel paths before measuring.
204. **Connect W66 · SCL_A:** I2C service signal. Maintain separate per-position SDA paths and do not join buffer B sides. Connect J_CH0.9 → J_CH5.9. Hole path (21,62) → (21,61.5) → (24.5,61.5) → (24.5,73.5) → (29,73.5) → (29,73). Insulate every crossing; solder only the two endpoints.
205. **Verify W66 · SCL_A:** Power disconnected: I2C service signal. Maintain separate per-position SDA paths and do not join buffer B sides. Connect J_CH0.9 → J_CH5.9. Hole path (21,62) → (21,61.5) → (24.5,61.5) → (24.5,73.5) → (29,73.5) → (29,73). Insulate every crossing; solder only the two endpoints. Confirm endpoint continuity (<1Ω for a wire) and no adjacent-net bridge; isolate parallel paths before measuring.
206. **Connect W67 · SCL_A:** I2C service signal. Maintain separate per-position SDA paths and do not join buffer B sides. Connect J_CH0.9 → R_SCL_A.2. Hole path (21,62) → (21,61.5) → (27.5,61.5) → (27.5,6.5) → (34,6.5) → (34,6). Insulate every crossing; solder only the two endpoints.
207. **Verify W67 · SCL_A:** Power disconnected: I2C service signal. Maintain separate per-position SDA paths and do not join buffer B sides. Connect J_CH0.9 → R_SCL_A.2. Hole path (21,62) → (21,61.5) → (27.5,61.5) → (27.5,6.5) → (34,6.5) → (34,6). Insulate every crossing; solder only the two endpoints. Confirm endpoint continuity (<1Ω for a wire) and no adjacent-net bridge; isolate parallel paths before measuring.
208. **Connect W68 · SCL_A:** I2C service signal. Maintain separate per-position SDA paths and do not join buffer B sides. Connect J_CH0.9 → U_ESP2.22. Hole path (21,62) → (21,61.5) → (18.5,61.5) → (18.5,13.5) → (16,13.5) → (16,13). Insulate every crossing; solder only the two endpoints.
209. **Verify W68 · SCL_A:** Power disconnected: I2C service signal. Maintain separate per-position SDA paths and do not join buffer B sides. Connect J_CH0.9 → U_ESP2.22. Hole path (21,62) → (21,61.5) → (18.5,61.5) → (18.5,13.5) → (16,13.5) → (16,13). Insulate every crossing; solder only the two endpoints. Confirm endpoint continuity (<1Ω for a wire) and no adjacent-net bridge; isolate parallel paths before measuring.
210. **Connect W69 · SDA_0:** I2C service signal. Maintain separate per-position SDA paths and do not join buffer B sides. Connect J_CH0.7 → R_SDA_0.2. Hole path (20,62) → (20,61.5) → (27,61.5) → (27,11.5) → (34,11.5) → (34,11). Insulate every crossing; solder only the two endpoints.
211. **Verify W69 · SDA_0:** Power disconnected: I2C service signal. Maintain separate per-position SDA paths and do not join buffer B sides. Connect J_CH0.7 → R_SDA_0.2. Hole path (20,62) → (20,61.5) → (27,61.5) → (27,11.5) → (34,11.5) → (34,11). Insulate every crossing; solder only the two endpoints. Confirm endpoint continuity (<1Ω for a wire) and no adjacent-net bridge; isolate parallel paths before measuring.
212. **Connect W70 · SDA_0:** I2C service signal. Maintain separate per-position SDA paths and do not join buffer B sides. Connect J_CH0.7 → U_ESP2.32. Hole path (20,62) → (20,61.5) → (18,61.5) → (18,23.5) → (16,23.5) → (16,23). Insulate every crossing; solder only the two endpoints.
213. **Verify W70 · SDA_0:** Power disconnected: I2C service signal. Maintain separate per-position SDA paths and do not join buffer B sides. Connect J_CH0.7 → U_ESP2.32. Hole path (20,62) → (20,61.5) → (18,61.5) → (18,23.5) → (16,23.5) → (16,23). Insulate every crossing; solder only the two endpoints. Confirm endpoint continuity (<1Ω for a wire) and no adjacent-net bridge; isolate parallel paths before measuring.
214. **Connect W71 · SDA_1:** I2C service signal. Maintain separate per-position SDA paths and do not join buffer B sides. Connect J_CH1.7 → R_SDA_1.2. Hole path (8,63) → (8,62.5) → (16.5,62.5) → (16.5,14.5) → (23,14.5) → (23,14). Insulate every crossing; solder only the two endpoints.
215. **Verify W71 · SDA_1:** Power disconnected: I2C service signal. Maintain separate per-position SDA paths and do not join buffer B sides. Connect J_CH1.7 → R_SDA_1.2. Hole path (8,63) → (8,62.5) → (16.5,62.5) → (16.5,14.5) → (23,14.5) → (23,14). Insulate every crossing; solder only the two endpoints. Confirm endpoint continuity (<1Ω for a wire) and no adjacent-net bridge; isolate parallel paths before measuring.
216. **Connect W72 · SDA_1:** I2C service signal. Maintain separate per-position SDA paths and do not join buffer B sides. Connect J_CH1.7 → U_ESP2.25. Hole path (8,63) → (8,62.5) → (12.5,62.5) → (12.5,16.5) → (16,16.5) → (16,16). Insulate every crossing; solder only the two endpoints.
217. **Verify W72 · SDA_1:** Power disconnected: I2C service signal. Maintain separate per-position SDA paths and do not join buffer B sides. Connect J_CH1.7 → U_ESP2.25. Hole path (8,63) → (8,62.5) → (12.5,62.5) → (12.5,16.5) → (16,16.5) → (16,16). Insulate every crossing; solder only the two endpoints. Confirm endpoint continuity (<1Ω for a wire) and no adjacent-net bridge; isolate parallel paths before measuring.
218. **Connect W73 · SDA_2:** I2C service signal. Maintain separate per-position SDA paths and do not join buffer B sides. Connect J_CH2.7 → R_SDA_2.2. Hole path (30,63) → (30,62.5) → (29.5,62.5) → (29.5,15.5) → (30,15.5) → (30,15). Insulate every crossing; solder only the two endpoints.
219. **Verify W73 · SDA_2:** Power disconnected: I2C service signal. Maintain separate per-position SDA paths and do not join buffer B sides. Connect J_CH2.7 → R_SDA_2.2. Hole path (30,63) → (30,62.5) → (29.5,62.5) → (29.5,15.5) → (30,15.5) → (30,15). Insulate every crossing; solder only the two endpoints. Confirm endpoint continuity (<1Ω for a wire) and no adjacent-net bridge; isolate parallel paths before measuring.
220. **Connect W74 · SDA_2:** I2C service signal. Maintain separate per-position SDA paths and do not join buffer B sides. Connect J_CH2.7 → U_ESP2.27. Hole path (30,63) → (30,62.5) → (22.5,62.5) → (22.5,18.5) → (16,18.5) → (16,18). Insulate every crossing; solder only the two endpoints.
221. **Verify W74 · SDA_2:** Power disconnected: I2C service signal. Maintain separate per-position SDA paths and do not join buffer B sides. Connect J_CH2.7 → U_ESP2.27. Hole path (30,63) → (30,62.5) → (22.5,62.5) → (22.5,18.5) → (16,18.5) → (16,18). Insulate every crossing; solder only the two endpoints. Confirm endpoint continuity (<1Ω for a wire) and no adjacent-net bridge; isolate parallel paths before measuring.
222. **Connect W75 · SDA_3:** I2C service signal. Maintain separate per-position SDA paths and do not join buffer B sides. Connect J_CH3.7 → R_SDA_3.2. Hole path (18,71) → (18,70.5) → (28,70.5) → (28,15.5) → (37,15.5) → (37,15). Insulate every crossing; solder only the two endpoints.
223. **Verify W75 · SDA_3:** Power disconnected: I2C service signal. Maintain separate per-position SDA paths and do not join buffer B sides. Connect J_CH3.7 → R_SDA_3.2. Hole path (18,71) → (18,70.5) → (28,70.5) → (28,15.5) → (37,15.5) → (37,15). Insulate every crossing; solder only the two endpoints. Confirm endpoint continuity (<1Ω for a wire) and no adjacent-net bridge; isolate parallel paths before measuring.
224. **Connect W76 · SDA_3:** I2C service signal. Maintain separate per-position SDA paths and do not join buffer B sides. Connect J_CH3.7 → U_ESP2.28. Hole path (18,71) → (18,70.5) → (17,70.5) → (17,19.5) → (16,19.5) → (16,19). Insulate every crossing; solder only the two endpoints.
225. **Verify W76 · SDA_3:** Power disconnected: I2C service signal. Maintain separate per-position SDA paths and do not join buffer B sides. Connect J_CH3.7 → U_ESP2.28. Hole path (18,71) → (18,70.5) → (17,70.5) → (17,19.5) → (16,19.5) → (16,19). Insulate every crossing; solder only the two endpoints. Confirm endpoint continuity (<1Ω for a wire) and no adjacent-net bridge; isolate parallel paths before measuring.
226. **Connect W77 · SDA_4:** I2C service signal. Maintain separate per-position SDA paths and do not join buffer B sides. Connect J_CH4.7 → R_SDA_4.2. Hole path (8,73) → (8,72.5) → (16.5,72.5) → (16.5,19.5) → (23,19.5) → (23,19). Insulate every crossing; solder only the two endpoints.
227. **Verify W77 · SDA_4:** Power disconnected: I2C service signal. Maintain separate per-position SDA paths and do not join buffer B sides. Connect J_CH4.7 → R_SDA_4.2. Hole path (8,73) → (8,72.5) → (16.5,72.5) → (16.5,19.5) → (23,19.5) → (23,19). Insulate every crossing; solder only the two endpoints. Confirm endpoint continuity (<1Ω for a wire) and no adjacent-net bridge; isolate parallel paths before measuring.
228. **Connect W78 · SDA_4:** I2C service signal. Maintain separate per-position SDA paths and do not join buffer B sides. Connect J_CH4.7 → U_ESP2.30. Hole path (8,73) → (8,72.5) → (12.5,72.5) → (12.5,21.5) → (16,21.5) → (16,21). Insulate every crossing; solder only the two endpoints.
229. **Verify W78 · SDA_4:** Power disconnected: I2C service signal. Maintain separate per-position SDA paths and do not join buffer B sides. Connect J_CH4.7 → U_ESP2.30. Hole path (8,73) → (8,72.5) → (12.5,72.5) → (12.5,21.5) → (16,21.5) → (16,21). Insulate every crossing; solder only the two endpoints. Confirm endpoint continuity (<1Ω for a wire) and no adjacent-net bridge; isolate parallel paths before measuring.
230. **Connect W79 · SDA_5:** I2C service signal. Maintain separate per-position SDA paths and do not join buffer B sides. Connect J_CH5.7 → R_SDA_5.2. Hole path (28,73) → (28,72.5) → (28.5,72.5) → (28.5,20.5) → (30,20.5) → (30,20). Insulate every crossing; solder only the two endpoints.
231. **Verify W79 · SDA_5:** Power disconnected: I2C service signal. Maintain separate per-position SDA paths and do not join buffer B sides. Connect J_CH5.7 → R_SDA_5.2. Hole path (28,73) → (28,72.5) → (28.5,72.5) → (28.5,20.5) → (30,20.5) → (30,20). Insulate every crossing; solder only the two endpoints. Confirm endpoint continuity (<1Ω for a wire) and no adjacent-net bridge; isolate parallel paths before measuring.
232. **Connect W80 · SDA_5:** I2C service signal. Maintain separate per-position SDA paths and do not join buffer B sides. Connect J_CH5.7 → U_ESP2.31. Hole path (28,73) → (28,72.5) → (21.5,72.5) → (21.5,22.5) → (16,22.5) → (16,22). Insulate every crossing; solder only the two endpoints.
233. **Verify W80 · SDA_5:** Power disconnected: I2C service signal. Maintain separate per-position SDA paths and do not join buffer B sides. Connect J_CH5.7 → U_ESP2.31. Hole path (28,73) → (28,72.5) → (21.5,72.5) → (21.5,22.5) → (16,22.5) → (16,22). Insulate every crossing; solder only the two endpoints. Confirm endpoint continuity (<1Ω for a wire) and no adjacent-net bridge; isolate parallel paths before measuring.
234. **Connect W81 · 5V_SYS:** Logic supply or current-protection path; verify the named supply domain and current direction. Connect C_SR0.1 → C_SR1.1. Hole path (36,41) → (36,40.5) → (21,40.5) → (21,46.5) → (5,46.5) → (5,46). Insulate every crossing; solder only the two endpoints.
235. **Verify W81 · 5V_SYS:** Power disconnected: Logic supply or current-protection path; verify the named supply domain and current direction. Connect C_SR0.1 → C_SR1.1. Hole path (36,41) → (36,40.5) → (21,40.5) → (21,46.5) → (5,46.5) → (5,46). Insulate every crossing; solder only the two endpoints. Confirm endpoint continuity (<1Ω for a wire) and no adjacent-net bridge; isolate parallel paths before measuring.
236. **Connect W82 · 5V_SYS:** Logic supply or current-protection path; verify the named supply domain and current direction. Connect C_SR0.1 → C_SR2.1. Hole path (36,41) → (36,40.5) → (26,40.5) → (26,46.5) → (15,46.5) → (15,46). Insulate every crossing; solder only the two endpoints.
237. **Verify W82 · 5V_SYS:** Power disconnected: Logic supply or current-protection path; verify the named supply domain and current direction. Connect C_SR0.1 → C_SR2.1. Hole path (36,41) → (36,40.5) → (26,40.5) → (26,46.5) → (15,46.5) → (15,46). Insulate every crossing; solder only the two endpoints. Confirm endpoint continuity (<1Ω for a wire) and no adjacent-net bridge; isolate parallel paths before measuring.
238. **Connect W83 · 5V_SYS:** Logic supply or current-protection path; verify the named supply domain and current direction. Connect C_SR0.1 → J_CH0.5. Hole path (36,41) → (36,40.5) → (28,40.5) → (28,62.5) → (19,62.5) → (19,62). Insulate every crossing; solder only the two endpoints.
239. **Verify W83 · 5V_SYS:** Power disconnected: Logic supply or current-protection path; verify the named supply domain and current direction. Connect C_SR0.1 → J_CH0.5. Hole path (36,41) → (36,40.5) → (28,40.5) → (28,62.5) → (19,62.5) → (19,62). Insulate every crossing; solder only the two endpoints. Confirm endpoint continuity (<1Ω for a wire) and no adjacent-net bridge; isolate parallel paths before measuring.
240. **Connect W84 · 5V_SYS:** Logic supply or current-protection path; verify the named supply domain and current direction. Connect C_SR0.1 → J_CH1.5. Hole path (36,41) → (36,40.5) → (22,40.5) → (22,63.5) → (7,63.5) → (7,63). Insulate every crossing; solder only the two endpoints.
241. **Verify W84 · 5V_SYS:** Power disconnected: Logic supply or current-protection path; verify the named supply domain and current direction. Connect C_SR0.1 → J_CH1.5. Hole path (36,41) → (36,40.5) → (22,40.5) → (22,63.5) → (7,63.5) → (7,63). Insulate every crossing; solder only the two endpoints. Confirm endpoint continuity (<1Ω for a wire) and no adjacent-net bridge; isolate parallel paths before measuring.
242. **Connect W85 · 5V_SYS:** Logic supply or current-protection path; verify the named supply domain and current direction. Connect C_SR0.1 → J_CH2.5. Hole path (36,41) → (36,40.5) → (33,40.5) → (33,63.5) → (29,63.5) → (29,63). Insulate every crossing; solder only the two endpoints.
243. **Verify W85 · 5V_SYS:** Power disconnected: Logic supply or current-protection path; verify the named supply domain and current direction. Connect C_SR0.1 → J_CH2.5. Hole path (36,41) → (36,40.5) → (33,40.5) → (33,63.5) → (29,63.5) → (29,63). Insulate every crossing; solder only the two endpoints. Confirm endpoint continuity (<1Ω for a wire) and no adjacent-net bridge; isolate parallel paths before measuring.
244. **Connect W86 · 5V_SYS:** Logic supply or current-protection path; verify the named supply domain and current direction. Connect C_SR0.1 → J_CH3.5. Hole path (36,41) → (36,40.5) → (27,40.5) → (27,71.5) → (17,71.5) → (17,71). Insulate every crossing; solder only the two endpoints.
245. **Verify W86 · 5V_SYS:** Power disconnected: Logic supply or current-protection path; verify the named supply domain and current direction. Connect C_SR0.1 → J_CH3.5. Hole path (36,41) → (36,40.5) → (27,40.5) → (27,71.5) → (17,71.5) → (17,71). Insulate every crossing; solder only the two endpoints. Confirm endpoint continuity (<1Ω for a wire) and no adjacent-net bridge; isolate parallel paths before measuring.
246. **Connect W87 · 5V_SYS:** Logic supply or current-protection path; verify the named supply domain and current direction. Connect C_SR0.1 → J_CH4.5. Hole path (36,41) → (36,40.5) → (22,40.5) → (22,73.5) → (7,73.5) → (7,73). Insulate every crossing; solder only the two endpoints.
247. **Verify W87 · 5V_SYS:** Power disconnected: Logic supply or current-protection path; verify the named supply domain and current direction. Connect C_SR0.1 → J_CH4.5. Hole path (36,41) → (36,40.5) → (22,40.5) → (22,73.5) → (7,73.5) → (7,73). Insulate every crossing; solder only the two endpoints. Confirm endpoint continuity (<1Ω for a wire) and no adjacent-net bridge; isolate parallel paths before measuring.
248. **Connect W88 · 5V_SYS:** Logic supply or current-protection path; verify the named supply domain and current direction. Connect C_SR0.1 → J_CH5.5. Hole path (36,41) → (36,40.5) → (32,40.5) → (32,73.5) → (27,73.5) → (27,73). Insulate every crossing; solder only the two endpoints.
249. **Verify W88 · 5V_SYS:** Power disconnected: Logic supply or current-protection path; verify the named supply domain and current direction. Connect C_SR0.1 → J_CH5.5. Hole path (36,41) → (36,40.5) → (32,40.5) → (32,73.5) → (27,73.5) → (27,73). Insulate every crossing; solder only the two endpoints. Confirm endpoint continuity (<1Ω for a wire) and no adjacent-net bridge; isolate parallel paths before measuring.
250. **Connect W89 · 5V_SYS:** Logic supply or current-protection path; verify the named supply domain and current direction. Connect C_SR0.1 → J_POWER.1. Hole path (36,41) → (36,40.5) → (29,40.5) → (29,6.5) → (21,6.5) → (21,6). Insulate every crossing; solder only the two endpoints.
251. **Verify W89 · 5V_SYS:** Power disconnected: Logic supply or current-protection path; verify the named supply domain and current direction. Connect C_SR0.1 → J_POWER.1. Hole path (36,41) → (36,40.5) → (29,40.5) → (29,6.5) → (21,6.5) → (21,6). Insulate every crossing; solder only the two endpoints. Confirm endpoint continuity (<1Ω for a wire) and no adjacent-net bridge; isolate parallel paths before measuring.
252. **Connect W90 · 5V_SYS:** Logic supply or current-protection path; verify the named supply domain and current direction. Connect C_SR0.1 → R_OE.1. Hole path (36,41) → (36,40.5) → (34,40.5) → (34,36.5) → (32,36.5) → (32,36). Insulate every crossing; solder only the two endpoints.
253. **Verify W90 · 5V_SYS:** Power disconnected: Logic supply or current-protection path; verify the named supply domain and current direction. Connect C_SR0.1 → R_OE.1. Hole path (36,41) → (36,40.5) → (34,40.5) → (34,36.5) → (32,36.5) → (32,36). Insulate every crossing; solder only the two endpoints. Confirm endpoint continuity (<1Ω for a wire) and no adjacent-net bridge; isolate parallel paths before measuring.
254. **Connect W91 · 5V_SYS:** Logic supply or current-protection path; verify the named supply domain and current direction. Connect C_SR0.1 → U_SR0.10. Hole path (36,41) → (36,40.5) → (35,40.5) → (35,49.5) → (33,49.5) → (33,49). Insulate every crossing; solder only the two endpoints.
255. **Verify W91 · 5V_SYS:** Power disconnected: Logic supply or current-protection path; verify the named supply domain and current direction. Connect C_SR0.1 → U_SR0.10. Hole path (36,41) → (36,40.5) → (35,40.5) → (35,49.5) → (33,49.5) → (33,49). Insulate every crossing; solder only the two endpoints. Confirm endpoint continuity (<1Ω for a wire) and no adjacent-net bridge; isolate parallel paths before measuring.
256. **Connect W92 · 5V_SYS:** Logic supply or current-protection path; verify the named supply domain and current direction. Connect C_SR0.1 → U_SR0.16. Hole path (36,41) → (36,40.5) → (35,40.5) → (35,43.5) → (33,43.5) → (33,43). Insulate every crossing; solder only the two endpoints.
257. **Verify W92 · 5V_SYS:** Power disconnected: Logic supply or current-protection path; verify the named supply domain and current direction. Connect C_SR0.1 → U_SR0.16. Hole path (36,41) → (36,40.5) → (35,40.5) → (35,43.5) → (33,43.5) → (33,43). Insulate every crossing; solder only the two endpoints. Confirm endpoint continuity (<1Ω for a wire) and no adjacent-net bridge; isolate parallel paths before measuring.
258. **Connect W93 · 5V_SYS:** Logic supply or current-protection path; verify the named supply domain and current direction. Connect C_SR0.1 → U_SR1.10. Hole path (36,41) → (36,40.5) → (32,40.5) → (32,52.5) → (27,52.5) → (27,52). Insulate every crossing; solder only the two endpoints.
259. **Verify W93 · 5V_SYS:** Power disconnected: Logic supply or current-protection path; verify the named supply domain and current direction. Connect C_SR0.1 → U_SR1.10. Hole path (36,41) → (36,40.5) → (32,40.5) → (32,52.5) → (27,52.5) → (27,52). Insulate every crossing; solder only the two endpoints. Confirm endpoint continuity (<1Ω for a wire) and no adjacent-net bridge; isolate parallel paths before measuring.
260. **Connect W94 · 5V_SYS:** Logic supply or current-protection path; verify the named supply domain and current direction. Connect C_SR0.1 → U_SR1.16. Hole path (36,41) → (36,40.5) → (32,40.5) → (32,46.5) → (27,46.5) → (27,46). Insulate every crossing; solder only the two endpoints.
261. **Verify W94 · 5V_SYS:** Power disconnected: Logic supply or current-protection path; verify the named supply domain and current direction. Connect C_SR0.1 → U_SR1.16. Hole path (36,41) → (36,40.5) → (32,40.5) → (32,46.5) → (27,46.5) → (27,46). Insulate every crossing; solder only the two endpoints. Confirm endpoint continuity (<1Ω for a wire) and no adjacent-net bridge; isolate parallel paths before measuring.
262. **Connect W95 · 5V_SYS:** Logic supply or current-protection path; verify the named supply domain and current direction. Connect C_SR0.1 → U_SR2.10. Hole path (36,41) → (36,40.5) → (24,40.5) → (24,54.5) → (12,54.5) → (12,54). Insulate every crossing; solder only the two endpoints.
263. **Verify W95 · 5V_SYS:** Power disconnected: Logic supply or current-protection path; verify the named supply domain and current direction. Connect C_SR0.1 → U_SR2.10. Hole path (36,41) → (36,40.5) → (24,40.5) → (24,54.5) → (12,54.5) → (12,54). Insulate every crossing; solder only the two endpoints. Confirm endpoint continuity (<1Ω for a wire) and no adjacent-net bridge; isolate parallel paths before measuring.
264. **Connect W96 · 5V_SYS:** Logic supply or current-protection path; verify the named supply domain and current direction. Connect C_SR0.1 → U_SR2.16. Hole path (36,41) → (36,40.5) → (24,40.5) → (24,48.5) → (12,48.5) → (12,48). Insulate every crossing; solder only the two endpoints.
265. **Verify W96 · 5V_SYS:** Power disconnected: Logic supply or current-protection path; verify the named supply domain and current direction. Connect C_SR0.1 → U_SR2.16. Hole path (36,41) → (36,40.5) → (24,40.5) → (24,48.5) → (12,48.5) → (12,48). Insulate every crossing; solder only the two endpoints. Confirm endpoint continuity (<1Ω for a wire) and no adjacent-net bridge; isolate parallel paths before measuring.
266. **Connect W97 · 5V_EDU:** Protected student supply, enabled only by the fault latch, watchdog and an explicit valid request. Connect J_CH0.10 → J_CH1.10. Hole path (21,63) → (21,62.5) → (15.5,62.5) → (15.5,64.5) → (9,64.5) → (9,64). Insulate every crossing; solder only the two endpoints.
267. **Verify W97 · 5V_EDU:** Power disconnected: Protected student supply, enabled only by the fault latch, watchdog and an explicit valid request. Connect J_CH0.10 → J_CH1.10. Hole path (21,63) → (21,62.5) → (15.5,62.5) → (15.5,64.5) → (9,64.5) → (9,64). Insulate every crossing; solder only the two endpoints. Confirm endpoint continuity (<1Ω for a wire) and no adjacent-net bridge; isolate parallel paths before measuring.
268. **Connect W98 · 5V_EDU:** Protected student supply, enabled only by the fault latch, watchdog and an explicit valid request. Connect J_CH0.10 → J_CH2.10. Hole path (21,63) → (21,62.5) → (26.5,62.5) → (26.5,64.5) → (31,64.5) → (31,64). Insulate every crossing; solder only the two endpoints.
269. **Verify W98 · 5V_EDU:** Power disconnected: Protected student supply, enabled only by the fault latch, watchdog and an explicit valid request. Connect J_CH0.10 → J_CH2.10. Hole path (21,63) → (21,62.5) → (26.5,62.5) → (26.5,64.5) → (31,64.5) → (31,64). Insulate every crossing; solder only the two endpoints. Confirm endpoint continuity (<1Ω for a wire) and no adjacent-net bridge; isolate parallel paths before measuring.
270. **Connect W99 · 5V_EDU:** Protected student supply, enabled only by the fault latch, watchdog and an explicit valid request. Connect J_CH0.10 → J_CH3.10. Hole path (21,63) → (21,62.5) → (20.5,62.5) → (20.5,72.5) → (19,72.5) → (19,72). Insulate every crossing; solder only the two endpoints.
271. **Verify W99 · 5V_EDU:** Power disconnected: Protected student supply, enabled only by the fault latch, watchdog and an explicit valid request. Connect J_CH0.10 → J_CH3.10. Hole path (21,63) → (21,62.5) → (20.5,62.5) → (20.5,72.5) → (19,72.5) → (19,72). Insulate every crossing; solder only the two endpoints. Confirm endpoint continuity (<1Ω for a wire) and no adjacent-net bridge; isolate parallel paths before measuring.
272. **Connect W100 · 5V_EDU:** Protected student supply, enabled only by the fault latch, watchdog and an explicit valid request. Connect J_CH0.10 → J_CH4.10. Hole path (21,63) → (21,62.5) → (15.5,62.5) → (15.5,74.5) → (9,74.5) → (9,74). Insulate every crossing; solder only the two endpoints.
273. **Verify W100 · 5V_EDU:** Power disconnected: Protected student supply, enabled only by the fault latch, watchdog and an explicit valid request. Connect J_CH0.10 → J_CH4.10. Hole path (21,63) → (21,62.5) → (15.5,62.5) → (15.5,74.5) → (9,74.5) → (9,74). Insulate every crossing; solder only the two endpoints. Confirm endpoint continuity (<1Ω for a wire) and no adjacent-net bridge; isolate parallel paths before measuring.
274. **Connect W101 · 5V_EDU:** Protected student supply, enabled only by the fault latch, watchdog and an explicit valid request. Connect J_CH0.10 → J_CH5.10. Hole path (21,63) → (21,62.5) → (25.5,62.5) → (25.5,74.5) → (29,74.5) → (29,74). Insulate every crossing; solder only the two endpoints.
275. **Verify W101 · 5V_EDU:** Power disconnected: Protected student supply, enabled only by the fault latch, watchdog and an explicit valid request. Connect J_CH0.10 → J_CH5.10. Hole path (21,63) → (21,62.5) → (25.5,62.5) → (25.5,74.5) → (29,74.5) → (29,74). Insulate every crossing; solder only the two endpoints. Confirm endpoint continuity (<1Ω for a wire) and no adjacent-net bridge; isolate parallel paths before measuring.
276. **Connect W102 · 5V_EDU:** Protected student supply, enabled only by the fault latch, watchdog and an explicit valid request. Connect J_CH0.10 → J_POWER.3. Hole path (21,63) → (21,62.5) → (22.5,62.5) → (22.5,6.5) → (22,6.5) → (22,6). Insulate every crossing; solder only the two endpoints.
277. **Verify W102 · 5V_EDU:** Power disconnected: Protected student supply, enabled only by the fault latch, watchdog and an explicit valid request. Connect J_CH0.10 → J_POWER.3. Hole path (21,63) → (21,62.5) → (22.5,62.5) → (22.5,6.5) → (22,6.5) → (22,6). Insulate every crossing; solder only the two endpoints. Confirm endpoint continuity (<1Ω for a wire) and no adjacent-net bridge; isolate parallel paths before measuring.
278. **Connect W103 · 3V3_SYS:** 3.3-V electronics supply. USB and bench supply domains must not be bridged. Connect J_CH0.6 → J_CH1.6. Hole path (19,63) → (19,62.5) → (12.5,62.5) → (12.5,64.5) → (7,64.5) → (7,64). Insulate every crossing; solder only the two endpoints.
279. **Verify W103 · 3V3_SYS:** Power disconnected: 3.3-V electronics supply. USB and bench supply domains must not be bridged. Connect J_CH0.6 → J_CH1.6. Hole path (19,63) → (19,62.5) → (12.5,62.5) → (12.5,64.5) → (7,64.5) → (7,64). Insulate every crossing; solder only the two endpoints. Confirm endpoint continuity (<1Ω for a wire) and no adjacent-net bridge; isolate parallel paths before measuring.
280. **Connect W104 · 3V3_SYS:** 3.3-V electronics supply. USB and bench supply domains must not be bridged. Connect J_CH0.6 → J_CH2.6. Hole path (19,63) → (19,62.5) → (23.5,62.5) → (23.5,64.5) → (29,64.5) → (29,64). Insulate every crossing; solder only the two endpoints.
281. **Verify W104 · 3V3_SYS:** Power disconnected: 3.3-V electronics supply. USB and bench supply domains must not be bridged. Connect J_CH0.6 → J_CH2.6. Hole path (19,63) → (19,62.5) → (23.5,62.5) → (23.5,64.5) → (29,64.5) → (29,64). Insulate every crossing; solder only the two endpoints. Confirm endpoint continuity (<1Ω for a wire) and no adjacent-net bridge; isolate parallel paths before measuring.
282. **Connect W105 · 3V3_SYS:** 3.3-V electronics supply. USB and bench supply domains must not be bridged. Connect J_CH0.6 → J_CH3.6. Hole path (19,63) → (19,62.5) → (17.5,62.5) → (17.5,72.5) → (17,72.5) → (17,72). Insulate every crossing; solder only the two endpoints.
283. **Verify W105 · 3V3_SYS:** Power disconnected: 3.3-V electronics supply. USB and bench supply domains must not be bridged. Connect J_CH0.6 → J_CH3.6. Hole path (19,63) → (19,62.5) → (17.5,62.5) → (17.5,72.5) → (17,72.5) → (17,72). Insulate every crossing; solder only the two endpoints. Confirm endpoint continuity (<1Ω for a wire) and no adjacent-net bridge; isolate parallel paths before measuring.
284. **Connect W106 · 3V3_SYS:** 3.3-V electronics supply. USB and bench supply domains must not be bridged. Connect J_CH0.6 → J_CH4.6. Hole path (19,63) → (19,62.5) → (12.5,62.5) → (12.5,74.5) → (7,74.5) → (7,74). Insulate every crossing; solder only the two endpoints.
285. **Verify W106 · 3V3_SYS:** Power disconnected: 3.3-V electronics supply. USB and bench supply domains must not be bridged. Connect J_CH0.6 → J_CH4.6. Hole path (19,63) → (19,62.5) → (12.5,62.5) → (12.5,74.5) → (7,74.5) → (7,74). Insulate every crossing; solder only the two endpoints. Confirm endpoint continuity (<1Ω for a wire) and no adjacent-net bridge; isolate parallel paths before measuring.
286. **Connect W107 · 3V3_SYS:** 3.3-V electronics supply. USB and bench supply domains must not be bridged. Connect J_CH0.6 → J_CH5.6. Hole path (19,63) → (19,62.5) → (22.5,62.5) → (22.5,74.5) → (27,74.5) → (27,74). Insulate every crossing; solder only the two endpoints.
287. **Verify W107 · 3V3_SYS:** Power disconnected: 3.3-V electronics supply. USB and bench supply domains must not be bridged. Connect J_CH0.6 → J_CH5.6. Hole path (19,63) → (19,62.5) → (22.5,62.5) → (22.5,74.5) → (27,74.5) → (27,74). Insulate every crossing; solder only the two endpoints. Confirm endpoint continuity (<1Ω for a wire) and no adjacent-net bridge; isolate parallel paths before measuring.
288. **Connect W108 · 3V3_SYS:** 3.3-V electronics supply. USB and bench supply domains must not be bridged. Connect J_CH0.6 → J_POWER.5. Hole path (19,63) → (19,62.5) → (20.5,62.5) → (20.5,6.5) → (23,6.5) → (23,6). Insulate every crossing; solder only the two endpoints.
289. **Verify W108 · 3V3_SYS:** Power disconnected: 3.3-V electronics supply. USB and bench supply domains must not be bridged. Connect J_CH0.6 → J_POWER.5. Hole path (19,63) → (19,62.5) → (20.5,62.5) → (20.5,6.5) → (23,6.5) → (23,6). Insulate every crossing; solder only the two endpoints. Confirm endpoint continuity (<1Ω for a wire) and no adjacent-net bridge; isolate parallel paths before measuring.
290. **Connect W109 · EDU_ON:** Named control/interconnect for edu on. Verify both pin functions against the schematic before soldering. Connect J_POWER.7 → Q_RAIL.2. Hole path (24,6) → (24,5.5) → (15,5.5) → (15,41.5) → (6,41.5) → (6,41). Insulate every crossing; solder only the two endpoints.
291. **Verify W109 · EDU_ON:** Power disconnected: Named control/interconnect for edu on. Verify both pin functions against the schematic before soldering. Connect J_POWER.7 → Q_RAIL.2. Hole path (24,6) → (24,5.5) → (15,5.5) → (15,41.5) → (6,41.5) → (6,41). Insulate every crossing; solder only the two endpoints. Confirm endpoint continuity (<1Ω for a wire) and no adjacent-net bridge; isolate parallel paths before measuring.
292. **Connect W110 · EDU_ON:** Named control/interconnect for edu on. Verify both pin functions against the schematic before soldering. Connect J_POWER.7 → R_RAIL_OFF.1. Hole path (24,6) → (24,5.5) → (21,5.5) → (21,41.5) → (17,41.5) → (17,41). Insulate every crossing; solder only the two endpoints.
293. **Verify W110 · EDU_ON:** Power disconnected: Named control/interconnect for edu on. Verify both pin functions against the schematic before soldering. Connect J_POWER.7 → R_RAIL_OFF.1. Hole path (24,6) → (24,5.5) → (21,5.5) → (21,41.5) → (17,41.5) → (17,41). Insulate every crossing; solder only the two endpoints. Confirm endpoint continuity (<1Ω for a wire) and no adjacent-net bridge; isolate parallel paths before measuring.
294. **Connect W111 · USB_RESET_N:** Protection, reset or readiness control; its defined polarity must preserve OFF at startup and on faults. Connect R_USB_POR.2 → U_USB_POR.1. Hole path (29,34) → (29,33.5) → (24.5,33.5) → (24.5,35.5) → (19,35.5) → (19,35). Insulate every crossing; solder only the two endpoints.
295. **Verify W111 · USB_RESET_N:** Power disconnected: Protection, reset or readiness control; its defined polarity must preserve OFF at startup and on faults. Connect R_USB_POR.2 → U_USB_POR.1. Hole path (29,34) → (29,33.5) → (24.5,33.5) → (24.5,35.5) → (19,35.5) → (19,35). Insulate every crossing; solder only the two endpoints. Confirm endpoint continuity (<1Ω for a wire) and no adjacent-net bridge; isolate parallel paths before measuring.
296. **Connect W112 · USB_RESET_N:** Protection, reset or readiness control; its defined polarity must preserve OFF at startup and on faults. Connect R_USB_POR.2 → U_WATCH.3. Hole path (29,34) → (29,33.5) → (31.5,33.5) → (31.5,24.5) → (33,24.5) → (33,24). Insulate every crossing; solder only the two endpoints.
297. **Verify W112 · USB_RESET_N:** Power disconnected: Protection, reset or readiness control; its defined polarity must preserve OFF at startup and on faults. Connect R_USB_POR.2 → U_WATCH.3. Hole path (29,34) → (29,33.5) → (31.5,33.5) → (31.5,24.5) → (33,24.5) → (33,24). Insulate every crossing; solder only the two endpoints. Confirm endpoint continuity (<1Ω for a wire) and no adjacent-net bridge; isolate parallel paths before measuring.
298. **Connect W113 · ALIVE:** Protection, reset or readiness control; its defined polarity must preserve OFF at startup and on faults. Connect Q_ALIVE.2 → R_ALIVE_OFF.1. Hole path (26,39) → (26,38.5) → (17.5,38.5) → (17.5,41.5) → (10,41.5) → (10,41). Insulate every crossing; solder only the two endpoints.
299. **Verify W113 · ALIVE:** Power disconnected: Protection, reset or readiness control; its defined polarity must preserve OFF at startup and on faults. Connect Q_ALIVE.2 → R_ALIVE_OFF.1. Hole path (26,39) → (26,38.5) → (17.5,38.5) → (17.5,41.5) → (10,41.5) → (10,41). Insulate every crossing; solder only the two endpoints. Confirm endpoint continuity (<1Ω for a wire) and no adjacent-net bridge; isolate parallel paths before measuring.
300. **Connect W114 · ALIVE:** Protection, reset or readiness control; its defined polarity must preserve OFF at startup and on faults. Connect Q_ALIVE.2 → U_WATCH.13. Hole path (26,39) → (26,38.5) → (30.5,38.5) → (30.5,25.5) → (36,25.5) → (36,25). Insulate every crossing; solder only the two endpoints.
301. **Verify W114 · ALIVE:** Power disconnected: Protection, reset or readiness control; its defined polarity must preserve OFF at startup and on faults. Connect Q_ALIVE.2 → U_WATCH.13. Hole path (26,39) → (26,38.5) → (30.5,38.5) → (30.5,25.5) → (36,25.5) → (36,25). Insulate every crossing; solder only the two endpoints. Confirm endpoint continuity (<1Ω for a wire) and no adjacent-net bridge; isolate parallel paths before measuring.
302. **Connect W115 · WATCH_CX:** Named control/interconnect for watch cx. Verify both pin functions against the schematic before soldering. Connect C_WATCH.2 → U_WATCH.14. Hole path (27,25) → (27,24.5) → (32,24.5) → (36,24.5) → (36,24). Insulate every crossing; solder only the two endpoints.
303. **Verify W115 · WATCH_CX:** Power disconnected: Named control/interconnect for watch cx. Verify both pin functions against the schematic before soldering. Connect C_WATCH.2 → U_WATCH.14. Hole path (27,25) → (27,24.5) → (32,24.5) → (36,24.5) → (36,24). Insulate every crossing; solder only the two endpoints. Confirm endpoint continuity (<1Ω for a wire) and no adjacent-net bridge; isolate parallel paths before measuring.
304. **Connect W116 · WATCH_RX:** Named control/interconnect for watch rx. Verify both pin functions against the schematic before soldering. Connect C_WATCH.1 → R_WATCH.2. Hole path (26,25) → (26,24.5) → (25.5,24.5) → (25.5,23.5) → (23,23.5) → (23,23). Insulate every crossing; solder only the two endpoints.
305. **Verify W116 · WATCH_RX:** Power disconnected: Named control/interconnect for watch rx. Verify both pin functions against the schematic before soldering. Connect C_WATCH.1 → R_WATCH.2. Hole path (26,25) → (26,24.5) → (25.5,24.5) → (25.5,23.5) → (23,23.5) → (23,23). Insulate every crossing; solder only the two endpoints. Confirm endpoint continuity (<1Ω for a wire) and no adjacent-net bridge; isolate parallel paths before measuring.
306. **Connect W117 · WATCH_RX:** Named control/interconnect for watch rx. Verify both pin functions against the schematic before soldering. Connect C_WATCH.1 → U_WATCH.15. Hole path (26,25) → (26,24.5) → (31.5,24.5) → (31.5,23.5) → (36,23.5) → (36,23). Insulate every crossing; solder only the two endpoints.
307. **Verify W117 · WATCH_RX:** Power disconnected: Named control/interconnect for watch rx. Verify both pin functions against the schematic before soldering. Connect C_WATCH.1 → U_WATCH.15. Hole path (26,25) → (26,24.5) → (31.5,24.5) → (31.5,23.5) → (36,23.5) → (36,23). Insulate every crossing; solder only the two endpoints. Confirm endpoint continuity (<1Ω for a wire) and no adjacent-net bridge; isolate parallel paths before measuring.
308. **Connect W118 · SR_OE_N:** Named control/interconnect for sr oe n. Verify both pin functions against the schematic before soldering. Connect Q_ALIVE.3 → R_OE.2. Hole path (27,39) → (27,38.5) → (31.5,38.5) → (31.5,36.5) → (36,36.5) → (36,36). Insulate every crossing; solder only the two endpoints.
309. **Verify W118 · SR_OE_N:** Power disconnected: Named control/interconnect for sr oe n. Verify both pin functions against the schematic before soldering. Connect Q_ALIVE.3 → R_OE.2. Hole path (27,39) → (27,38.5) → (31.5,38.5) → (31.5,36.5) → (36,36.5) → (36,36). Insulate every crossing; solder only the two endpoints. Confirm endpoint continuity (<1Ω for a wire) and no adjacent-net bridge; isolate parallel paths before measuring.
310. **Connect W119 · SR_OE_N:** Named control/interconnect for sr oe n. Verify both pin functions against the schematic before soldering. Connect Q_ALIVE.3 → U_SR0.13. Hole path (27,39) → (27,38.5) → (29.5,38.5) → (29.5,46.5) → (33,46.5) → (33,46). Insulate every crossing; solder only the two endpoints.
311. **Verify W119 · SR_OE_N:** Power disconnected: Named control/interconnect for sr oe n. Verify both pin functions against the schematic before soldering. Connect Q_ALIVE.3 → U_SR0.13. Hole path (27,39) → (27,38.5) → (29.5,38.5) → (29.5,46.5) → (33,46.5) → (33,46). Insulate every crossing; solder only the two endpoints. Confirm endpoint continuity (<1Ω for a wire) and no adjacent-net bridge; isolate parallel paths before measuring.
312. **Connect W120 · SR_OE_N:** Named control/interconnect for sr oe n. Verify both pin functions against the schematic before soldering. Connect Q_ALIVE.3 → U_SR1.13. Hole path (27,39) → (27,38.5) → (26.5,38.5) → (26.5,49.5) → (27,49.5) → (27,49). Insulate every crossing; solder only the two endpoints.
313. **Verify W120 · SR_OE_N:** Power disconnected: Named control/interconnect for sr oe n. Verify both pin functions against the schematic before soldering. Connect Q_ALIVE.3 → U_SR1.13. Hole path (27,39) → (27,38.5) → (26.5,38.5) → (26.5,49.5) → (27,49.5) → (27,49). Insulate every crossing; solder only the two endpoints. Confirm endpoint continuity (<1Ω for a wire) and no adjacent-net bridge; isolate parallel paths before measuring.
314. **Connect W121 · SR_OE_N:** Named control/interconnect for sr oe n. Verify both pin functions against the schematic before soldering. Connect Q_ALIVE.3 → U_SR2.13. Hole path (27,39) → (27,38.5) → (19.5,38.5) → (19.5,51.5) → (12,51.5) → (12,51). Insulate every crossing; solder only the two endpoints.
315. **Verify W121 · SR_OE_N:** Power disconnected: Named control/interconnect for sr oe n. Verify both pin functions against the schematic before soldering. Connect Q_ALIVE.3 → U_SR2.13. Hole path (27,39) → (27,38.5) → (19.5,38.5) → (19.5,51.5) → (12,51.5) → (12,51). Insulate every crossing; solder only the two endpoints. Confirm endpoint continuity (<1Ω for a wire) and no adjacent-net bridge; isolate parallel paths before measuring.
316. **Connect W122 · OE_MID:** Named control/interconnect for oe mid. Verify both pin functions against the schematic before soldering. Connect Q_ALIVE.1 → Q_RAIL.3. Hole path (25,39) → (25,38.5) → (16,38.5) → (16,41.5) → (7,41.5) → (7,41). Insulate every crossing; solder only the two endpoints.
317. **Verify W122 · OE_MID:** Power disconnected: Named control/interconnect for oe mid. Verify both pin functions against the schematic before soldering. Connect Q_ALIVE.1 → Q_RAIL.3. Hole path (25,39) → (25,38.5) → (16,38.5) → (16,41.5) → (7,41.5) → (7,41). Insulate every crossing; solder only the two endpoints. Confirm endpoint continuity (<1Ω for a wire) and no adjacent-net bridge; isolate parallel paths before measuring.
318. **Connect W123 · SR_CHAIN_1:** Named control/interconnect for sr chain 1. Verify both pin functions against the schematic before soldering. Connect U_SR0.9 → U_SR1.14. Hole path (33,50) → (33,49.5) → (30.5,49.5) → (30.5,48.5) → (27,48.5) → (27,48). Insulate every crossing; solder only the two endpoints.
319. **Verify W123 · SR_CHAIN_1:** Power disconnected: Named control/interconnect for sr chain 1. Verify both pin functions against the schematic before soldering. Connect U_SR0.9 → U_SR1.14. Hole path (33,50) → (33,49.5) → (30.5,49.5) → (30.5,48.5) → (27,48.5) → (27,48). Insulate every crossing; solder only the two endpoints. Confirm endpoint continuity (<1Ω for a wire) and no adjacent-net bridge; isolate parallel paths before measuring.
320. **Connect W124 · RELAY_0:** Output switching or current-limiting control; default OFF and mutually exclusive source/sink states are required. Connect J_CH0.1 → U_SR0.15. Hole path (17,62) → (17,61.5) → (24.5,61.5) → (24.5,44.5) → (33,44.5) → (33,44). Insulate every crossing; solder only the two endpoints.
321. **Verify W124 · RELAY_0:** Power disconnected: Output switching or current-limiting control; default OFF and mutually exclusive source/sink states are required. Connect J_CH0.1 → U_SR0.15. Hole path (17,62) → (17,61.5) → (24.5,61.5) → (24.5,44.5) → (33,44.5) → (33,44). Insulate every crossing; solder only the two endpoints. Confirm endpoint continuity (<1Ω for a wire) and no adjacent-net bridge; isolate parallel paths before measuring.
322. **Connect W125 · RELAY_1:** Output switching or current-limiting control; default OFF and mutually exclusive source/sink states are required. Connect J_CH0.2 → U_SR0.1. Hole path (17,63) → (17,62.5) → (24,62.5) → (24,43.5) → (30,43.5) → (30,43). Insulate every crossing; solder only the two endpoints.
323. **Verify W125 · RELAY_1:** Power disconnected: Output switching or current-limiting control; default OFF and mutually exclusive source/sink states are required. Connect J_CH0.2 → U_SR0.1. Hole path (17,63) → (17,62.5) → (24,62.5) → (24,43.5) → (30,43.5) → (30,43). Insulate every crossing; solder only the two endpoints. Confirm endpoint continuity (<1Ω for a wire) and no adjacent-net bridge; isolate parallel paths before measuring.
324. **Connect W126 · RELAY_2:** Output switching or current-limiting control; default OFF and mutually exclusive source/sink states are required. Connect J_CH0.3 → U_SR0.2. Hole path (18,62) → (18,61.5) → (24.5,61.5) → (24.5,44.5) → (30,44.5) → (30,44). Insulate every crossing; solder only the two endpoints.
325. **Verify W126 · RELAY_2:** Power disconnected: Output switching or current-limiting control; default OFF and mutually exclusive source/sink states are required. Connect J_CH0.3 → U_SR0.2. Hole path (18,62) → (18,61.5) → (24.5,61.5) → (24.5,44.5) → (30,44.5) → (30,44). Insulate every crossing; solder only the two endpoints. Confirm endpoint continuity (<1Ω for a wire) and no adjacent-net bridge; isolate parallel paths before measuring.
326. **Connect W127 · RELAY_3:** Output switching or current-limiting control; default OFF and mutually exclusive source/sink states are required. Connect J_CH1.1 → U_SR0.3. Hole path (5,63) → (5,62.5) → (17.5,62.5) → (17.5,45.5) → (30,45.5) → (30,45). Insulate every crossing; solder only the two endpoints.
327. **Verify W127 · RELAY_3:** Power disconnected: Output switching or current-limiting control; default OFF and mutually exclusive source/sink states are required. Connect J_CH1.1 → U_SR0.3. Hole path (5,63) → (5,62.5) → (17.5,62.5) → (17.5,45.5) → (30,45.5) → (30,45). Insulate every crossing; solder only the two endpoints. Confirm endpoint continuity (<1Ω for a wire) and no adjacent-net bridge; isolate parallel paths before measuring.
328. **Connect W128 · RELAY_4:** Output switching or current-limiting control; default OFF and mutually exclusive source/sink states are required. Connect J_CH1.2 → U_SR0.4. Hole path (5,64) → (5,63.5) → (18,63.5) → (18,46.5) → (30,46.5) → (30,46). Insulate every crossing; solder only the two endpoints.
329. **Verify W128 · RELAY_4:** Power disconnected: Output switching or current-limiting control; default OFF and mutually exclusive source/sink states are required. Connect J_CH1.2 → U_SR0.4. Hole path (5,64) → (5,63.5) → (18,63.5) → (18,46.5) → (30,46.5) → (30,46). Insulate every crossing; solder only the two endpoints. Confirm endpoint continuity (<1Ω for a wire) and no adjacent-net bridge; isolate parallel paths before measuring.
330. **Connect W129 · RELAY_5:** Output switching or current-limiting control; default OFF and mutually exclusive source/sink states are required. Connect J_CH1.3 → U_SR0.5. Hole path (6,63) → (6,62.5) → (18.5,62.5) → (18.5,47.5) → (30,47.5) → (30,47). Insulate every crossing; solder only the two endpoints.
331. **Verify W129 · RELAY_5:** Power disconnected: Output switching or current-limiting control; default OFF and mutually exclusive source/sink states are required. Connect J_CH1.3 → U_SR0.5. Hole path (6,63) → (6,62.5) → (18.5,62.5) → (18.5,47.5) → (30,47.5) → (30,47). Insulate every crossing; solder only the two endpoints. Confirm endpoint continuity (<1Ω for a wire) and no adjacent-net bridge; isolate parallel paths before measuring.
332. **Connect W130 · RELAY_6:** Output switching or current-limiting control; default OFF and mutually exclusive source/sink states are required. Connect J_CH2.1 → U_SR0.6. Hole path (27,63) → (27,62.5) → (28.5,62.5) → (28.5,48.5) → (30,48.5) → (30,48). Insulate every crossing; solder only the two endpoints.
333. **Verify W130 · RELAY_6:** Power disconnected: Output switching or current-limiting control; default OFF and mutually exclusive source/sink states are required. Connect J_CH2.1 → U_SR0.6. Hole path (27,63) → (27,62.5) → (28.5,62.5) → (28.5,48.5) → (30,48.5) → (30,48). Insulate every crossing; solder only the two endpoints. Confirm endpoint continuity (<1Ω for a wire) and no adjacent-net bridge; isolate parallel paths before measuring.
334. **Connect W131 · RELAY_7:** Output switching or current-limiting control; default OFF and mutually exclusive source/sink states are required. Connect J_CH2.2 → U_SR0.7. Hole path (27,64) → (27,63.5) → (29,63.5) → (29,49.5) → (30,49.5) → (30,49). Insulate every crossing; solder only the two endpoints.
335. **Verify W131 · RELAY_7:** Power disconnected: Output switching or current-limiting control; default OFF and mutually exclusive source/sink states are required. Connect J_CH2.2 → U_SR0.7. Hole path (27,64) → (27,63.5) → (29,63.5) → (29,49.5) → (30,49.5) → (30,49). Insulate every crossing; solder only the two endpoints. Confirm endpoint continuity (<1Ω for a wire) and no adjacent-net bridge; isolate parallel paths before measuring.
336. **Connect W132 · SR_CHAIN_2:** Named control/interconnect for sr chain 2. Verify both pin functions against the schematic before soldering. Connect U_SR1.9 → U_SR2.14. Hole path (27,53) → (27,52.5) → (20.5,52.5) → (20.5,50.5) → (12,50.5) → (12,50). Insulate every crossing; solder only the two endpoints.
337. **Verify W132 · SR_CHAIN_2:** Power disconnected: Named control/interconnect for sr chain 2. Verify both pin functions against the schematic before soldering. Connect U_SR1.9 → U_SR2.14. Hole path (27,53) → (27,52.5) → (20.5,52.5) → (20.5,50.5) → (12,50.5) → (12,50). Insulate every crossing; solder only the two endpoints. Confirm endpoint continuity (<1Ω for a wire) and no adjacent-net bridge; isolate parallel paths before measuring.
338. **Connect W133 · RELAY_8:** Output switching or current-limiting control; default OFF and mutually exclusive source/sink states are required. Connect J_CH2.3 → U_SR1.15. Hole path (28,63) → (28,62.5) → (27.5,62.5) → (27.5,47.5) → (27,47.5) → (27,47). Insulate every crossing; solder only the two endpoints.
339. **Verify W133 · RELAY_8:** Power disconnected: Output switching or current-limiting control; default OFF and mutually exclusive source/sink states are required. Connect J_CH2.3 → U_SR1.15. Hole path (28,63) → (28,62.5) → (27.5,62.5) → (27.5,47.5) → (27,47.5) → (27,47). Insulate every crossing; solder only the two endpoints. Confirm endpoint continuity (<1Ω for a wire) and no adjacent-net bridge; isolate parallel paths before measuring.
340. **Connect W134 · RELAY_9:** Output switching or current-limiting control; default OFF and mutually exclusive source/sink states are required. Connect J_CH3.1 → U_SR1.1. Hole path (15,71) → (15,70.5) → (20,70.5) → (20,46.5) → (24,46.5) → (24,46). Insulate every crossing; solder only the two endpoints.
341. **Verify W134 · RELAY_9:** Power disconnected: Output switching or current-limiting control; default OFF and mutually exclusive source/sink states are required. Connect J_CH3.1 → U_SR1.1. Hole path (15,71) → (15,70.5) → (20,70.5) → (20,46.5) → (24,46.5) → (24,46). Insulate every crossing; solder only the two endpoints. Confirm endpoint continuity (<1Ω for a wire) and no adjacent-net bridge; isolate parallel paths before measuring.
342. **Connect W135 · RELAY_10:** Output switching or current-limiting control; default OFF and mutually exclusive source/sink states are required. Connect J_CH3.2 → U_SR1.2. Hole path (15,72) → (15,71.5) → (20.5,71.5) → (20.5,47.5) → (24,47.5) → (24,47). Insulate every crossing; solder only the two endpoints.
343. **Verify W135 · RELAY_10:** Power disconnected: Output switching or current-limiting control; default OFF and mutually exclusive source/sink states are required. Connect J_CH3.2 → U_SR1.2. Hole path (15,72) → (15,71.5) → (20.5,71.5) → (20.5,47.5) → (24,47.5) → (24,47). Insulate every crossing; solder only the two endpoints. Confirm endpoint continuity (<1Ω for a wire) and no adjacent-net bridge; isolate parallel paths before measuring.
344. **Connect W136 · RELAY_11:** Output switching or current-limiting control; default OFF and mutually exclusive source/sink states are required. Connect J_CH3.3 → U_SR1.3. Hole path (16,71) → (16,70.5) → (19.5,70.5) → (19.5,48.5) → (24,48.5) → (24,48). Insulate every crossing; solder only the two endpoints.
345. **Verify W136 · RELAY_11:** Power disconnected: Output switching or current-limiting control; default OFF and mutually exclusive source/sink states are required. Connect J_CH3.3 → U_SR1.3. Hole path (16,71) → (16,70.5) → (19.5,70.5) → (19.5,48.5) → (24,48.5) → (24,48). Insulate every crossing; solder only the two endpoints. Confirm endpoint continuity (<1Ω for a wire) and no adjacent-net bridge; isolate parallel paths before measuring.
346. **Connect W137 · RELAY_12:** Output switching or current-limiting control; default OFF and mutually exclusive source/sink states are required. Connect J_CH4.1 → U_SR1.4. Hole path (5,73) → (5,72.5) → (15,72.5) → (15,49.5) → (24,49.5) → (24,49). Insulate every crossing; solder only the two endpoints.
347. **Verify W137 · RELAY_12:** Power disconnected: Output switching or current-limiting control; default OFF and mutually exclusive source/sink states are required. Connect J_CH4.1 → U_SR1.4. Hole path (5,73) → (5,72.5) → (15,72.5) → (15,49.5) → (24,49.5) → (24,49). Insulate every crossing; solder only the two endpoints. Confirm endpoint continuity (<1Ω for a wire) and no adjacent-net bridge; isolate parallel paths before measuring.
348. **Connect W138 · RELAY_13:** Output switching or current-limiting control; default OFF and mutually exclusive source/sink states are required. Connect J_CH4.2 → U_SR1.5. Hole path (5,74) → (5,73.5) → (15.5,73.5) → (15.5,50.5) → (24,50.5) → (24,50). Insulate every crossing; solder only the two endpoints.
349. **Verify W138 · RELAY_13:** Power disconnected: Output switching or current-limiting control; default OFF and mutually exclusive source/sink states are required. Connect J_CH4.2 → U_SR1.5. Hole path (5,74) → (5,73.5) → (15.5,73.5) → (15.5,50.5) → (24,50.5) → (24,50). Insulate every crossing; solder only the two endpoints. Confirm endpoint continuity (<1Ω for a wire) and no adjacent-net bridge; isolate parallel paths before measuring.
350. **Connect W139 · RELAY_14:** Output switching or current-limiting control; default OFF and mutually exclusive source/sink states are required. Connect J_CH4.3 → U_SR1.6. Hole path (6,73) → (6,72.5) → (14.5,72.5) → (14.5,51.5) → (24,51.5) → (24,51). Insulate every crossing; solder only the two endpoints.
351. **Verify W139 · RELAY_14:** Power disconnected: Output switching or current-limiting control; default OFF and mutually exclusive source/sink states are required. Connect J_CH4.3 → U_SR1.6. Hole path (6,73) → (6,72.5) → (14.5,72.5) → (14.5,51.5) → (24,51.5) → (24,51). Insulate every crossing; solder only the two endpoints. Confirm endpoint continuity (<1Ω for a wire) and no adjacent-net bridge; isolate parallel paths before measuring.
352. **Connect W140 · RELAY_15:** Output switching or current-limiting control; default OFF and mutually exclusive source/sink states are required. Connect J_CH5.1 → U_SR1.7. Hole path (25,73) → (25,72.5) → (25,52.5) → (24,52.5) → (24,52). Insulate every crossing; solder only the two endpoints.
353. **Verify W140 · RELAY_15:** Power disconnected: Output switching or current-limiting control; default OFF and mutually exclusive source/sink states are required. Connect J_CH5.1 → U_SR1.7. Hole path (25,73) → (25,72.5) → (25,52.5) → (24,52.5) → (24,52). Insulate every crossing; solder only the two endpoints. Confirm endpoint continuity (<1Ω for a wire) and no adjacent-net bridge; isolate parallel paths before measuring.
354. **Connect W141 · RELAY_16:** Output switching or current-limiting control; default OFF and mutually exclusive source/sink states are required. Connect J_CH5.2 → U_SR2.15. Hole path (25,74) → (25,73.5) → (18.5,73.5) → (18.5,49.5) → (12,49.5) → (12,49). Insulate every crossing; solder only the two endpoints.
355. **Verify W141 · RELAY_16:** Power disconnected: Output switching or current-limiting control; default OFF and mutually exclusive source/sink states are required. Connect J_CH5.2 → U_SR2.15. Hole path (25,74) → (25,73.5) → (18.5,73.5) → (18.5,49.5) → (12,49.5) → (12,49). Insulate every crossing; solder only the two endpoints. Confirm endpoint continuity (<1Ω for a wire) and no adjacent-net bridge; isolate parallel paths before measuring.
356. **Connect W142 · RELAY_17:** Output switching or current-limiting control; default OFF and mutually exclusive source/sink states are required. Connect J_CH5.3 → U_SR2.1. Hole path (26,73) → (26,72.5) → (18,72.5) → (18,48.5) → (9,48.5) → (9,48). Insulate every crossing; solder only the two endpoints.
357. **Verify W142 · RELAY_17:** Power disconnected: Output switching or current-limiting control; default OFF and mutually exclusive source/sink states are required. Connect J_CH5.3 → U_SR2.1. Hole path (26,73) → (26,72.5) → (18,72.5) → (18,48.5) → (9,48.5) → (9,48). Insulate every crossing; solder only the two endpoints. Confirm endpoint continuity (<1Ω for a wire) and no adjacent-net bridge; isolate parallel paths before measuring.
358. **Place R_HI_TOP:** R_HI_TOP: hi top; 1k. Part of Precision source and sink current regulators. Mount on the top side; red pad identifies pin 1. 
359. **Inspect R_HI_TOP:** Power OFF: inspect every terminal, polarity, seating and solder joint. R_HI_TOP: hi top; 1k. Part of Precision source and sink current regulators. Mount on the top side; red pad identifies pin 1. 
360. **Place R_HI_BOTTOM:** R_HI_BOTTOM: hi bottom; 49.9k. Part of Precision source and sink current regulators. Mount on the top side; red pad identifies pin 1. 
361. **Inspect R_HI_BOTTOM:** Power OFF: inspect every terminal, polarity, seating and solder joint. R_HI_BOTTOM: hi bottom; 49.9k. Part of Precision source and sink current regulators. Mount on the top side; red pad identifies pin 1. 
362. **Place R_LO_TOP:** R_LO_TOP: lo top; 49.9k. Part of Precision source and sink current regulators. Mount on the top side; red pad identifies pin 1. 
363. **Inspect R_LO_TOP:** Power OFF: inspect every terminal, polarity, seating and solder joint. R_LO_TOP: lo top; 49.9k. Part of Precision source and sink current regulators. Mount on the top side; red pad identifies pin 1. 
364. **Place R_LO_BOTTOM:** R_LO_BOTTOM: lo bottom; 1k. Part of Precision source and sink current regulators. Mount on the top side; red pad identifies pin 1. 
365. **Inspect R_LO_BOTTOM:** Power OFF: inspect every terminal, polarity, seating and solder joint. R_LO_BOTTOM: lo bottom; 1k. Part of Precision source and sink current regulators. Mount on the top side; red pad identifies pin 1. 
366. **Place C_REFHI:** C_REFHI: refhi; 100nF. Part of Precision source and sink current regulators. Mount on the top side; red pad identifies pin 1. 
367. **Inspect C_REFHI:** Power OFF: inspect every terminal, polarity, seating and solder joint. C_REFHI: refhi; 100nF. Part of Precision source and sink current regulators. Mount on the top side; red pad identifies pin 1. 
368. **Place C_REFLO:** C_REFLO: reflo; 100nF. Part of Precision source and sink current regulators. Mount on the top side; red pad identifies pin 1. 
369. **Inspect C_REFLO:** Power OFF: inspect every terminal, polarity, seating and solder joint. C_REFLO: reflo; 100nF. Part of Precision source and sink current regulators. Mount on the top side; red pad identifies pin 1. 
370. **Place R_SOURCE_SENSE:** R_SOURCE_SENSE: source sense; 10. Part of Precision source and sink current regulators. Mount on the top side; red pad identifies pin 1. 
371. **Inspect R_SOURCE_SENSE:** Power OFF: inspect every terminal, polarity, seating and solder joint. R_SOURCE_SENSE: source sense; 10. Part of Precision source and sink current regulators. Mount on the top side; red pad identifies pin 1. 
372. **Place R_SINK_SENSE:** R_SINK_SENSE: sink sense; 10. Part of Precision source and sink current regulators. Mount on the top side; red pad identifies pin 1. 
373. **Inspect R_SINK_SENSE:** Power OFF: inspect every terminal, polarity, seating and solder joint. R_SINK_SENSE: sink sense; 10. Part of Precision source and sink current regulators. Mount on the top side; red pad identifies pin 1. 
374. **Place U_LIMIT:** U_LIMIT: limit; OPA2333AID. Part of Precision source and sink current regulators. Install on SOIC8 to DIP8; verify manufacturer pin numbering. Mount on the top side; red pad identifies pin 1. 
375. **Inspect U_LIMIT:** Power OFF: inspect every terminal, polarity, seating and solder joint. U_LIMIT: limit; OPA2333AID. Part of Precision source and sink current regulators. Install on SOIC8 to DIP8; verify manufacturer pin numbering. Mount on the top side; red pad identifies pin 1. 
376. **Place C_LIMIT:** C_LIMIT: limit; 100nF. Part of Precision source and sink current regulators. Mount on the top side; red pad identifies pin 1. 
377. **Inspect C_LIMIT:** Power OFF: inspect every terminal, polarity, seating and solder joint. C_LIMIT: limit; 100nF. Part of Precision source and sink current regulators. Mount on the top side; red pad identifies pin 1. 
378. **Place R_HI_GATE:** R_HI_GATE: hi gate; 1k. Part of Precision source and sink current regulators. Mount on the top side; red pad identifies pin 1. 
379. **Inspect R_HI_GATE:** Power OFF: inspect every terminal, polarity, seating and solder joint. R_HI_GATE: hi gate; 1k. Part of Precision source and sink current regulators. Mount on the top side; red pad identifies pin 1. 
380. **Place R_LO_GATE:** R_LO_GATE: lo gate; 1k. Part of Precision source and sink current regulators. Mount on the top side; red pad identifies pin 1. 
381. **Inspect R_LO_GATE:** Power OFF: inspect every terminal, polarity, seating and solder joint. R_LO_GATE: lo gate; 1k. Part of Precision source and sink current regulators. Mount on the top side; red pad identifies pin 1. 
382. **Place C_HI_COMP:** C_HI_COMP: hi comp; 1nF. Part of Precision source and sink current regulators. Mount on the top side; red pad identifies pin 1. 
383. **Inspect C_HI_COMP:** Power OFF: inspect every terminal, polarity, seating and solder joint. C_HI_COMP: hi comp; 1nF. Part of Precision source and sink current regulators. Mount on the top side; red pad identifies pin 1. 
384. **Place C_LO_COMP:** C_LO_COMP: lo comp; 1nF. Part of Precision source and sink current regulators. Mount on the top side; red pad identifies pin 1. 
385. **Inspect C_LO_COMP:** Power OFF: inspect every terminal, polarity, seating and solder joint. C_LO_COMP: lo comp; 1nF. Part of Precision source and sink current regulators. Mount on the top side; red pad identifies pin 1. 
386. **Place Q_HIGH:** Q_HIGH: high; BSS84. Part of Precision source and sink current regulators. Install on SOT23 to numbered 3-pin adapter; verify manufacturer pin numbering. Mount on the top side; red pad identifies pin 1. 
387. **Inspect Q_HIGH:** Power OFF: inspect every terminal, polarity, seating and solder joint. Q_HIGH: high; BSS84. Part of Precision source and sink current regulators. Install on SOT23 to numbered 3-pin adapter; verify manufacturer pin numbering. Mount on the top side; red pad identifies pin 1. 
388. **Place Q_LOW:** Q_LOW: low; 2N7000. Part of Precision source and sink current regulators. Mount on the top side; red pad identifies pin 1. 
389. **Inspect Q_LOW:** Power OFF: inspect every terminal, polarity, seating and solder joint. Q_LOW: low; 2N7000. Part of Precision source and sink current regulators. Mount on the top side; red pad identifies pin 1. 
390. **Place K_HIGH:** K_HIGH: high; AQY212EH. Part of P3 switched source/sink — both off means high impedance. Mount on the top side; red pad identifies pin 1. 
391. **Inspect K_HIGH:** Power OFF: inspect every terminal, polarity, seating and solder joint. K_HIGH: high; AQY212EH. Part of P3 switched source/sink — both off means high impedance. Mount on the top side; red pad identifies pin 1. 
392. **Place R_K_HIGH_LED:** R_K_HIGH_LED: k high led; 560. Part of P3 switched source/sink — both off means high impedance. Mount on the top side; red pad identifies pin 1. 
393. **Inspect R_K_HIGH_LED:** Power OFF: inspect every terminal, polarity, seating and solder joint. R_K_HIGH_LED: k high led; 560. Part of P3 switched source/sink — both off means high impedance. Mount on the top side; red pad identifies pin 1. 
394. **Place R_K_HIGH_OFF:** R_K_HIGH_OFF: k high off; 100k. Part of P3 switched source/sink — both off means high impedance. Mount on the top side; red pad identifies pin 1. 
395. **Inspect R_K_HIGH_OFF:** Power OFF: inspect every terminal, polarity, seating and solder joint. R_K_HIGH_OFF: k high off; 100k. Part of P3 switched source/sink — both off means high impedance. Mount on the top side; red pad identifies pin 1. 
396. **Place Q_K_HIGH:** Q_K_HIGH: k high; 2N7000. Part of P3 switched source/sink — both off means high impedance. Mount on the top side; red pad identifies pin 1. 
397. **Inspect Q_K_HIGH:** Power OFF: inspect every terminal, polarity, seating and solder joint. Q_K_HIGH: k high; 2N7000. Part of P3 switched source/sink — both off means high impedance. Mount on the top side; red pad identifies pin 1. 
398. **Place K_LOW:** K_LOW: low; AQY212EH. Part of P3 switched source/sink — both off means high impedance. Mount on the top side; red pad identifies pin 1. 
399. **Inspect K_LOW:** Power OFF: inspect every terminal, polarity, seating and solder joint. K_LOW: low; AQY212EH. Part of P3 switched source/sink — both off means high impedance. Mount on the top side; red pad identifies pin 1. 
400. **Place R_K_LOW_LED:** R_K_LOW_LED: k low led; 560. Part of P3 switched source/sink — both off means high impedance. Mount on the top side; red pad identifies pin 1. 
401. **Inspect R_K_LOW_LED:** Power OFF: inspect every terminal, polarity, seating and solder joint. R_K_LOW_LED: k low led; 560. Part of P3 switched source/sink — both off means high impedance. Mount on the top side; red pad identifies pin 1. 
402. **Place R_K_LOW_OFF:** R_K_LOW_OFF: k low off; 100k. Part of P3 switched source/sink — both off means high impedance. Mount on the top side; red pad identifies pin 1. 
403. **Inspect R_K_LOW_OFF:** Power OFF: inspect every terminal, polarity, seating and solder joint. R_K_LOW_OFF: k low off; 100k. Part of P3 switched source/sink — both off means high impedance. Mount on the top side; red pad identifies pin 1. 
404. **Place Q_K_LOW:** Q_K_LOW: k low; 2N7000. Part of P3 switched source/sink — both off means high impedance. Mount on the top side; red pad identifies pin 1. 
405. **Inspect Q_K_LOW:** Power OFF: inspect every terminal, polarity, seating and solder joint. Q_K_LOW: k low; 2N7000. Part of P3 switched source/sink — both off means high impedance. Mount on the top side; red pad identifies pin 1. 
406. **Connect W20 · GND:** Common electrical reference and return; keep student, USB and service ground identities consistent. Connect C_ADC.2 → C_LIMIT.2. Hole path (26,22) → (26,21.5) → (30,21.5) → (30,41.5) → (33,41.5) → (33,41). Insulate every crossing; solder only the two endpoints.
407. **Verify W20 · GND:** Power disconnected: Common electrical reference and return; keep student, USB and service ground identities consistent. Connect C_ADC.2 → C_LIMIT.2. Hole path (26,22) → (26,21.5) → (30,21.5) → (30,41.5) → (33,41.5) → (33,41). Insulate every crossing; solder only the two endpoints. Confirm endpoint continuity (<1Ω for a wire) and no adjacent-net bridge; isolate parallel paths before measuring.
408. **Connect W21 · GND:** Common electrical reference and return; keep student, USB and service ground identities consistent. Connect C_ADC.2 → C_REFHI.2. Hole path (26,22) → (26,21.5) → (16,21.5) → (16,39.5) → (5,39.5) → (5,39). Insulate every crossing; solder only the two endpoints.
409. **Verify W21 · GND:** Power disconnected: Common electrical reference and return; keep student, USB and service ground identities consistent. Connect C_ADC.2 → C_REFHI.2. Hole path (26,22) → (26,21.5) → (16,21.5) → (16,39.5) → (5,39.5) → (5,39). Insulate every crossing; solder only the two endpoints. Confirm endpoint continuity (<1Ω for a wire) and no adjacent-net bridge; isolate parallel paths before measuring.
410. **Connect W22 · GND:** Common electrical reference and return; keep student, USB and service ground identities consistent. Connect C_ADC.2 → C_REFLO.2. Hole path (26,22) → (26,21.5) → (18,21.5) → (18,41.5) → (9,41.5) → (9,41). Insulate every crossing; solder only the two endpoints.
411. **Verify W22 · GND:** Power disconnected: Common electrical reference and return; keep student, USB and service ground identities consistent. Connect C_ADC.2 → C_REFLO.2. Hole path (26,22) → (26,21.5) → (18,21.5) → (18,41.5) → (9,41.5) → (9,41). Insulate every crossing; solder only the two endpoints. Confirm endpoint continuity (<1Ω for a wire) and no adjacent-net bridge; isolate parallel paths before measuring.
412. **Connect W23 · GND:** Common electrical reference and return; keep student, USB and service ground identities consistent. Connect C_ADC.2 → Q_K_HIGH.1. Hole path (26,22) → (26,21.5) → (28,21.5) → (28,49.5) → (29,49.5) → (29,49). Insulate every crossing; solder only the two endpoints.
413. **Verify W23 · GND:** Power disconnected: Common electrical reference and return; keep student, USB and service ground identities consistent. Connect C_ADC.2 → Q_K_HIGH.1. Hole path (26,22) → (26,21.5) → (28,21.5) → (28,49.5) → (29,49.5) → (29,49). Insulate every crossing; solder only the two endpoints. Confirm endpoint continuity (<1Ω for a wire) and no adjacent-net bridge; isolate parallel paths before measuring.
414. **Connect W24 · GND:** Common electrical reference and return; keep student, USB and service ground identities consistent. Connect C_ADC.2 → Q_K_LOW.1. Hole path (26,22) → (26,21.5) → (30,21.5) → (30,49.5) → (34,49.5) → (34,49). Insulate every crossing; solder only the two endpoints.
415. **Verify W24 · GND:** Power disconnected: Common electrical reference and return; keep student, USB and service ground identities consistent. Connect C_ADC.2 → Q_K_LOW.1. Hole path (26,22) → (26,21.5) → (30,21.5) → (30,49.5) → (34,49.5) → (34,49). Insulate every crossing; solder only the two endpoints. Confirm endpoint continuity (<1Ω for a wire) and no adjacent-net bridge; isolate parallel paths before measuring.
416. **Connect W25 · GND:** Common electrical reference and return; keep student, USB and service ground identities consistent. Connect C_ADC.2 → R_HI_BOTTOM.2. Hole path (26,22) → (26,21.5) → (24,21.5) → (24,37.5) → (22,37.5) → (22,37). Insulate every crossing; solder only the two endpoints.
417. **Verify W25 · GND:** Power disconnected: Common electrical reference and return; keep student, USB and service ground identities consistent. Connect C_ADC.2 → R_HI_BOTTOM.2. Hole path (26,22) → (26,21.5) → (24,21.5) → (24,37.5) → (22,37.5) → (22,37). Insulate every crossing; solder only the two endpoints. Confirm endpoint continuity (<1Ω for a wire) and no adjacent-net bridge; isolate parallel paths before measuring.
418. **Connect W26 · GND:** Common electrical reference and return; keep student, USB and service ground identities consistent. Connect C_ADC.2 → R_K_HIGH_OFF.2. Hole path (26,22) → (26,21.5) → (26,49.5) → (26,49). Insulate every crossing; solder only the two endpoints.
419. **Verify W26 · GND:** Power disconnected: Common electrical reference and return; keep student, USB and service ground identities consistent. Connect C_ADC.2 → R_K_HIGH_OFF.2. Hole path (26,22) → (26,21.5) → (26,49.5) → (26,49). Insulate every crossing; solder only the two endpoints. Confirm endpoint continuity (<1Ω for a wire) and no adjacent-net bridge; isolate parallel paths before measuring.
420. **Connect W27 · GND:** Common electrical reference and return; keep student, USB and service ground identities consistent. Connect C_ADC.2 → R_K_LOW_OFF.2. Hole path (26,22) → (26,21.5) → (29,21.5) → (29,54.5) → (32,54.5) → (32,54). Insulate every crossing; solder only the two endpoints.
421. **Verify W27 · GND:** Power disconnected: Common electrical reference and return; keep student, USB and service ground identities consistent. Connect C_ADC.2 → R_K_LOW_OFF.2. Hole path (26,22) → (26,21.5) → (29,21.5) → (29,54.5) → (32,54.5) → (32,54). Insulate every crossing; solder only the two endpoints. Confirm endpoint continuity (<1Ω for a wire) and no adjacent-net bridge; isolate parallel paths before measuring.
422. **Connect W28 · GND:** Common electrical reference and return; keep student, USB and service ground identities consistent. Connect C_ADC.2 → R_LO_BOTTOM.2. Hole path (26,22) → (26,21.5) → (31,21.5) → (31,37.5) → (36,37.5) → (36,37). Insulate every crossing; solder only the two endpoints.
423. **Verify W28 · GND:** Power disconnected: Common electrical reference and return; keep student, USB and service ground identities consistent. Connect C_ADC.2 → R_LO_BOTTOM.2. Hole path (26,22) → (26,21.5) → (31,21.5) → (31,37.5) → (36,37.5) → (36,37). Insulate every crossing; solder only the two endpoints. Confirm endpoint continuity (<1Ω for a wire) and no adjacent-net bridge; isolate parallel paths before measuring.
424. **Connect W29 · GND:** Common electrical reference and return; keep student, USB and service ground identities consistent. Connect C_ADC.2 → R_SINK_SENSE.2. Hole path (26,22) → (26,21.5) → (25,21.5) → (25,41.5) → (23,41.5) → (23,41). Insulate every crossing; solder only the two endpoints.
425. **Verify W29 · GND:** Power disconnected: Common electrical reference and return; keep student, USB and service ground identities consistent. Connect C_ADC.2 → R_SINK_SENSE.2. Hole path (26,22) → (26,21.5) → (25,21.5) → (25,41.5) → (23,41.5) → (23,41). Insulate every crossing; solder only the two endpoints. Confirm endpoint continuity (<1Ω for a wire) and no adjacent-net bridge; isolate parallel paths before measuring.
426. **Connect W30 · GND:** Common electrical reference and return; keep student, USB and service ground identities consistent. Connect C_ADC.2 → U_LIMIT.4. Hole path (26,22) → (26,21.5) → (26,44.5) → (26,44). Insulate every crossing; solder only the two endpoints.
427. **Verify W30 · GND:** Power disconnected: Common electrical reference and return; keep student, USB and service ground identities consistent. Connect C_ADC.2 → U_LIMIT.4. Hole path (26,22) → (26,21.5) → (26,44.5) → (26,44). Insulate every crossing; solder only the two endpoints. Confirm endpoint continuity (<1Ω for a wire) and no adjacent-net bridge; isolate parallel paths before measuring.
428. **Connect W41 · P3_RAW:** Educational contact or routing bus; the wire joins only its listed terminals, not crossing wires. Connect J_MODULE.5 → K_HIGH.4. Hole path (9,6) → (9,5.5) → (10.5,5.5) → (10.5,50.5) → (12,50.5) → (12,50). Insulate every crossing; solder only the two endpoints.
429. **Verify W41 · P3_RAW:** Power disconnected: Educational contact or routing bus; the wire joins only its listed terminals, not crossing wires. Connect J_MODULE.5 → K_HIGH.4. Hole path (9,6) → (9,5.5) → (10.5,5.5) → (10.5,50.5) → (12,50.5) → (12,50). Insulate every crossing; solder only the two endpoints. Confirm endpoint continuity (<1Ω for a wire) and no adjacent-net bridge; isolate parallel paths before measuring.
430. **Connect W42 · P3_RAW:** Educational contact or routing bus; the wire joins only its listed terminals, not crossing wires. Connect J_MODULE.5 → K_LOW.3. Hole path (9,6) → (9,5.5) → (13.5,5.5) → (13.5,55.5) → (18,55.5) → (18,55). Insulate every crossing; solder only the two endpoints.
431. **Verify W42 · P3_RAW:** Power disconnected: Educational contact or routing bus; the wire joins only its listed terminals, not crossing wires. Connect J_MODULE.5 → K_LOW.3. Hole path (9,6) → (9,5.5) → (13.5,5.5) → (13.5,55.5) → (18,55.5) → (18,55). Insulate every crossing; solder only the two endpoints. Confirm endpoint continuity (<1Ω for a wire) and no adjacent-net bridge; isolate parallel paths before measuring.
432. **Connect W62 · HIGH_REQ:** Output switching or current-limiting control; default OFF and mutually exclusive source/sink states are required. Connect J_CONTROL.1 → Q_K_HIGH.2. Hole path (17,6) → (17,5.5) → (24,5.5) → (24,49.5) → (30,49.5) → (30,49). Insulate every crossing; solder only the two endpoints.
433. **Verify W62 · HIGH_REQ:** Power disconnected: Output switching or current-limiting control; default OFF and mutually exclusive source/sink states are required. Connect J_CONTROL.1 → Q_K_HIGH.2. Hole path (17,6) → (17,5.5) → (24,5.5) → (24,49.5) → (30,49.5) → (30,49). Insulate every crossing; solder only the two endpoints. Confirm endpoint continuity (<1Ω for a wire) and no adjacent-net bridge; isolate parallel paths before measuring.
434. **Connect W63 · HIGH_REQ:** Output switching or current-limiting control; default OFF and mutually exclusive source/sink states are required. Connect J_CONTROL.1 → R_K_HIGH_OFF.1. Hole path (17,6) → (17,5.5) → (20,5.5) → (20,49.5) → (22,49.5) → (22,49). Insulate every crossing; solder only the two endpoints.
435. **Verify W63 · HIGH_REQ:** Power disconnected: Output switching or current-limiting control; default OFF and mutually exclusive source/sink states are required. Connect J_CONTROL.1 → R_K_HIGH_OFF.1. Hole path (17,6) → (17,5.5) → (20,5.5) → (20,49.5) → (22,49.5) → (22,49). Insulate every crossing; solder only the two endpoints. Confirm endpoint continuity (<1Ω for a wire) and no adjacent-net bridge; isolate parallel paths before measuring.
436. **Connect W64 · LOW_REQ:** Output switching or current-limiting control; default OFF and mutually exclusive source/sink states are required. Connect J_CONTROL.2 → Q_K_LOW.2. Hole path (17,7) → (17,6.5) → (26.5,6.5) → (26.5,49.5) → (35,49.5) → (35,49). Insulate every crossing; solder only the two endpoints.
437. **Verify W64 · LOW_REQ:** Power disconnected: Output switching or current-limiting control; default OFF and mutually exclusive source/sink states are required. Connect J_CONTROL.2 → Q_K_LOW.2. Hole path (17,7) → (17,6.5) → (26.5,6.5) → (26.5,49.5) → (35,49.5) → (35,49). Insulate every crossing; solder only the two endpoints. Confirm endpoint continuity (<1Ω for a wire) and no adjacent-net bridge; isolate parallel paths before measuring.
438. **Connect W65 · LOW_REQ:** Output switching or current-limiting control; default OFF and mutually exclusive source/sink states are required. Connect J_CONTROL.2 → R_K_LOW_OFF.1. Hole path (17,7) → (17,6.5) → (23.5,6.5) → (23.5,54.5) → (28,54.5) → (28,54). Insulate every crossing; solder only the two endpoints.
439. **Verify W65 · LOW_REQ:** Power disconnected: Output switching or current-limiting control; default OFF and mutually exclusive source/sink states are required. Connect J_CONTROL.2 → R_K_LOW_OFF.1. Hole path (17,7) → (17,6.5) → (23.5,6.5) → (23.5,54.5) → (28,54.5) → (28,54). Insulate every crossing; solder only the two endpoints. Confirm endpoint continuity (<1Ω for a wire) and no adjacent-net bridge; isolate parallel paths before measuring.
440. **Connect W70 · 5V_SYS:** Logic supply or current-protection path; verify the named supply domain and current direction. Connect J_CONTROL.5 → C_LIMIT.1. Hole path (19,6) → (19,5.5) → (26,5.5) → (26,41.5) → (32,41.5) → (32,41). Insulate every crossing; solder only the two endpoints.
441. **Verify W70 · 5V_SYS:** Power disconnected: Logic supply or current-protection path; verify the named supply domain and current direction. Connect J_CONTROL.5 → C_LIMIT.1. Hole path (19,6) → (19,5.5) → (26,5.5) → (26,41.5) → (32,41.5) → (32,41). Insulate every crossing; solder only the two endpoints. Confirm endpoint continuity (<1Ω for a wire) and no adjacent-net bridge; isolate parallel paths before measuring.
442. **Connect W71 · 5V_SYS:** Logic supply or current-protection path; verify the named supply domain and current direction. Connect J_CONTROL.5 → R_K_HIGH_LED.1. Hole path (19,6) → (19,5.5) → (17,5.5) → (17,49.5) → (15,49.5) → (15,49). Insulate every crossing; solder only the two endpoints.
443. **Verify W71 · 5V_SYS:** Power disconnected: Logic supply or current-protection path; verify the named supply domain and current direction. Connect J_CONTROL.5 → R_K_HIGH_LED.1. Hole path (19,6) → (19,5.5) → (17,5.5) → (17,49.5) → (15,49.5) → (15,49). Insulate every crossing; solder only the two endpoints. Confirm endpoint continuity (<1Ω for a wire) and no adjacent-net bridge; isolate parallel paths before measuring.
444. **Connect W72 · 5V_SYS:** Logic supply or current-protection path; verify the named supply domain and current direction. Connect J_CONTROL.5 → R_K_LOW_LED.1. Hole path (19,6) → (19,5.5) → (20,5.5) → (20,54.5) → (21,54.5) → (21,54). Insulate every crossing; solder only the two endpoints.
445. **Verify W72 · 5V_SYS:** Power disconnected: Logic supply or current-protection path; verify the named supply domain and current direction. Connect J_CONTROL.5 → R_K_LOW_LED.1. Hole path (19,6) → (19,5.5) → (20,5.5) → (20,54.5) → (21,54.5) → (21,54). Insulate every crossing; solder only the two endpoints. Confirm endpoint continuity (<1Ω for a wire) and no adjacent-net bridge; isolate parallel paths before measuring.
446. **Connect W73 · 5V_SYS:** Logic supply or current-protection path; verify the named supply domain and current direction. Connect J_CONTROL.5 → U_LIMIT.8. Hole path (19,6) → (19,5.5) → (24,5.5) → (24,41.5) → (29,41.5) → (29,41). Insulate every crossing; solder only the two endpoints.
447. **Verify W73 · 5V_SYS:** Power disconnected: Logic supply or current-protection path; verify the named supply domain and current direction. Connect J_CONTROL.5 → U_LIMIT.8. Hole path (19,6) → (19,5.5) → (24,5.5) → (24,41.5) → (29,41.5) → (29,41). Insulate every crossing; solder only the two endpoints. Confirm endpoint continuity (<1Ω for a wire) and no adjacent-net bridge; isolate parallel paths before measuring.
448. **Connect W81 · 5V_EDU:** Protected student supply, enabled only by the fault latch, watchdog and an explicit valid request. Connect J_CONTROL.10 → R_HI_TOP.1. Hole path (21,7) → (21,6.5) → (16.5,6.5) → (16.5,37.5) → (11,37.5) → (11,37). Insulate every crossing; solder only the two endpoints.
449. **Verify W81 · 5V_EDU:** Power disconnected: Protected student supply, enabled only by the fault latch, watchdog and an explicit valid request. Connect J_CONTROL.10 → R_HI_TOP.1. Hole path (21,7) → (21,6.5) → (16.5,6.5) → (16.5,37.5) → (11,37.5) → (11,37). Insulate every crossing; solder only the two endpoints. Confirm endpoint continuity (<1Ω for a wire) and no adjacent-net bridge; isolate parallel paths before measuring.
450. **Connect W82 · 5V_EDU:** Protected student supply, enabled only by the fault latch, watchdog and an explicit valid request. Connect J_CONTROL.10 → R_LO_TOP.1. Hole path (21,7) → (21,6.5) → (23.5,6.5) → (23.5,37.5) → (25,37.5) → (25,37). Insulate every crossing; solder only the two endpoints.
451. **Verify W82 · 5V_EDU:** Power disconnected: Protected student supply, enabled only by the fault latch, watchdog and an explicit valid request. Connect J_CONTROL.10 → R_LO_TOP.1. Hole path (21,7) → (21,6.5) → (23.5,6.5) → (23.5,37.5) → (25,37.5) → (25,37). Insulate every crossing; solder only the two endpoints. Confirm endpoint continuity (<1Ω for a wire) and no adjacent-net bridge; isolate parallel paths before measuring.
452. **Connect W83 · 5V_EDU:** Protected student supply, enabled only by the fault latch, watchdog and an explicit valid request. Connect J_CONTROL.10 → R_SOURCE_SENSE.1. Hole path (21,7) → (21,6.5) → (17.5,6.5) → (17.5,41.5) → (12,41.5) → (12,41). Insulate every crossing; solder only the two endpoints.
453. **Verify W83 · 5V_EDU:** Power disconnected: Protected student supply, enabled only by the fault latch, watchdog and an explicit valid request. Connect J_CONTROL.10 → R_SOURCE_SENSE.1. Hole path (21,7) → (21,6.5) → (17.5,6.5) → (17.5,41.5) → (12,41.5) → (12,41). Insulate every crossing; solder only the two endpoints. Confirm endpoint continuity (<1Ω for a wire) and no adjacent-net bridge; isolate parallel paths before measuring.
454. **Connect W104 · REF_HI:** Analog measurement, feedback or reference path; inspect polarity and compare with the specified calibration. Connect C_REFHI.1 → R_HI_BOTTOM.1. Hole path (4,39) → (4,37) → (18,37). Insulate every crossing; solder only the two endpoints.
455. **Verify W104 · REF_HI:** Power disconnected: Analog measurement, feedback or reference path; inspect polarity and compare with the specified calibration. Connect C_REFHI.1 → R_HI_BOTTOM.1. Hole path (4,39) → (4,37) → (18,37). Insulate every crossing; solder only the two endpoints. Confirm endpoint continuity (<1Ω for a wire) and no adjacent-net bridge; isolate parallel paths before measuring.
456. **Connect W105 · REF_HI:** Analog measurement, feedback or reference path; inspect polarity and compare with the specified calibration. Connect C_REFHI.1 → R_HI_TOP.2. Hole path (4,39) → (4,37) → (15,37). Insulate every crossing; solder only the two endpoints.
457. **Verify W105 · REF_HI:** Power disconnected: Analog measurement, feedback or reference path; inspect polarity and compare with the specified calibration. Connect C_REFHI.1 → R_HI_TOP.2. Hole path (4,39) → (4,37) → (15,37). Insulate every crossing; solder only the two endpoints. Confirm endpoint continuity (<1Ω for a wire) and no adjacent-net bridge; isolate parallel paths before measuring.
458. **Connect W106 · REF_HI:** Analog measurement, feedback or reference path; inspect polarity and compare with the specified calibration. Connect C_REFHI.1 → U_LIMIT.3. Hole path (4,39) → (4,43) → (26,43). Insulate every crossing; solder only the two endpoints.
459. **Verify W106 · REF_HI:** Power disconnected: Analog measurement, feedback or reference path; inspect polarity and compare with the specified calibration. Connect C_REFHI.1 → U_LIMIT.3. Hole path (4,39) → (4,43) → (26,43). Insulate every crossing; solder only the two endpoints. Confirm endpoint continuity (<1Ω for a wire) and no adjacent-net bridge; isolate parallel paths before measuring.
460. **Connect W107 · REF_LO:** Analog measurement, feedback or reference path; inspect polarity and compare with the specified calibration. Connect C_REFLO.1 → R_LO_BOTTOM.1. Hole path (8,41) → (8,37) → (32,37). Insulate every crossing; solder only the two endpoints.
461. **Verify W107 · REF_LO:** Power disconnected: Analog measurement, feedback or reference path; inspect polarity and compare with the specified calibration. Connect C_REFLO.1 → R_LO_BOTTOM.1. Hole path (8,41) → (8,37) → (32,37). Insulate every crossing; solder only the two endpoints. Confirm endpoint continuity (<1Ω for a wire) and no adjacent-net bridge; isolate parallel paths before measuring.
462. **Connect W108 · REF_LO:** Analog measurement, feedback or reference path; inspect polarity and compare with the specified calibration. Connect C_REFLO.1 → R_LO_TOP.2. Hole path (8,41) → (8,37) → (29,37). Insulate every crossing; solder only the two endpoints.
463. **Verify W108 · REF_LO:** Power disconnected: Analog measurement, feedback or reference path; inspect polarity and compare with the specified calibration. Connect C_REFLO.1 → R_LO_TOP.2. Hole path (8,41) → (8,37) → (29,37). Insulate every crossing; solder only the two endpoints. Confirm endpoint continuity (<1Ω for a wire) and no adjacent-net bridge; isolate parallel paths before measuring.
464. **Connect W109 · REF_LO:** Analog measurement, feedback or reference path; inspect polarity and compare with the specified calibration. Connect C_REFLO.1 → U_LIMIT.5. Hole path (8,41) → (8,44) → (29,44). Insulate every crossing; solder only the two endpoints.
465. **Verify W109 · REF_LO:** Power disconnected: Analog measurement, feedback or reference path; inspect polarity and compare with the specified calibration. Connect C_REFLO.1 → U_LIMIT.5. Hole path (8,41) → (8,44) → (29,44). Insulate every crossing; solder only the two endpoints. Confirm endpoint continuity (<1Ω for a wire) and no adjacent-net bridge; isolate parallel paths before measuring.
466. **Connect W110 · SOURCE_SENSE:** Analog measurement, feedback or reference path; inspect polarity and compare with the specified calibration. Connect C_HI_COMP.2 → Q_HIGH.2. Hole path (19,45) → (33,45). Insulate every crossing; solder only the two endpoints.
467. **Verify W110 · SOURCE_SENSE:** Power disconnected: Analog measurement, feedback or reference path; inspect polarity and compare with the specified calibration. Connect C_HI_COMP.2 → Q_HIGH.2. Hole path (19,45) → (33,45). Insulate every crossing; solder only the two endpoints. Confirm endpoint continuity (<1Ω for a wire) and no adjacent-net bridge; isolate parallel paths before measuring.
468. **Connect W111 · SOURCE_SENSE:** Analog measurement, feedback or reference path; inspect polarity and compare with the specified calibration. Connect C_HI_COMP.2 → R_SOURCE_SENSE.2. Hole path (19,45) → (19,41) → (16,41). Insulate every crossing; solder only the two endpoints.
469. **Verify W111 · SOURCE_SENSE:** Power disconnected: Analog measurement, feedback or reference path; inspect polarity and compare with the specified calibration. Connect C_HI_COMP.2 → R_SOURCE_SENSE.2. Hole path (19,45) → (19,41) → (16,41). Insulate every crossing; solder only the two endpoints. Confirm endpoint continuity (<1Ω for a wire) and no adjacent-net bridge; isolate parallel paths before measuring.
470. **Connect W112 · SOURCE_SENSE:** Analog measurement, feedback or reference path; inspect polarity and compare with the specified calibration. Connect C_HI_COMP.2 → U_LIMIT.2. Hole path (19,45) → (19,42) → (26,42). Insulate every crossing; solder only the two endpoints.
471. **Verify W112 · SOURCE_SENSE:** Power disconnected: Analog measurement, feedback or reference path; inspect polarity and compare with the specified calibration. Connect C_HI_COMP.2 → U_LIMIT.2. Hole path (19,45) → (19,42) → (26,42). Insulate every crossing; solder only the two endpoints. Confirm endpoint continuity (<1Ω for a wire) and no adjacent-net bridge; isolate parallel paths before measuring.
472. **Connect W113 · SINK_SENSE:** Analog measurement, feedback or reference path; inspect polarity and compare with the specified calibration. Connect C_LO_COMP.2 → Q_LOW.1. Hole path (23,45) → (23,49) → (4,49). Insulate every crossing; solder only the two endpoints.
473. **Verify W113 · SINK_SENSE:** Power disconnected: Analog measurement, feedback or reference path; inspect polarity and compare with the specified calibration. Connect C_LO_COMP.2 → Q_LOW.1. Hole path (23,45) → (23,49) → (4,49). Insulate every crossing; solder only the two endpoints. Confirm endpoint continuity (<1Ω for a wire) and no adjacent-net bridge; isolate parallel paths before measuring.
474. **Connect W114 · SINK_SENSE:** Analog measurement, feedback or reference path; inspect polarity and compare with the specified calibration. Connect C_LO_COMP.2 → R_SINK_SENSE.1. Hole path (23,45) → (23,41) → (19,41). Insulate every crossing; solder only the two endpoints.
475. **Verify W114 · SINK_SENSE:** Power disconnected: Analog measurement, feedback or reference path; inspect polarity and compare with the specified calibration. Connect C_LO_COMP.2 → R_SINK_SENSE.1. Hole path (23,45) → (23,41) → (19,41). Insulate every crossing; solder only the two endpoints. Confirm endpoint continuity (<1Ω for a wire) and no adjacent-net bridge; isolate parallel paths before measuring.
476. **Connect W115 · SINK_SENSE:** Analog measurement, feedback or reference path; inspect polarity and compare with the specified calibration. Connect C_LO_COMP.2 → U_LIMIT.6. Hole path (23,45) → (23,43) → (29,43). Insulate every crossing; solder only the two endpoints.
477. **Verify W115 · SINK_SENSE:** Power disconnected: Analog measurement, feedback or reference path; inspect polarity and compare with the specified calibration. Connect C_LO_COMP.2 → U_LIMIT.6. Hole path (23,45) → (23,43) → (29,43). Insulate every crossing; solder only the two endpoints. Confirm endpoint continuity (<1Ω for a wire) and no adjacent-net bridge; isolate parallel paths before measuring.
478. **Connect W116 · HI_GATE_DRIVE:** Output switching or current-limiting control; default OFF and mutually exclusive source/sink states are required. Connect C_HI_COMP.1 → R_HI_GATE.1. Hole path (18,45) → (4,45). Insulate every crossing; solder only the two endpoints.
479. **Verify W116 · HI_GATE_DRIVE:** Power disconnected: Output switching or current-limiting control; default OFF and mutually exclusive source/sink states are required. Connect C_HI_COMP.1 → R_HI_GATE.1. Hole path (18,45) → (4,45). Insulate every crossing; solder only the two endpoints. Confirm endpoint continuity (<1Ω for a wire) and no adjacent-net bridge; isolate parallel paths before measuring.
480. **Connect W117 · HI_GATE_DRIVE:** Output switching or current-limiting control; default OFF and mutually exclusive source/sink states are required. Connect C_HI_COMP.1 → U_LIMIT.1. Hole path (18,45) → (18,41) → (26,41). Insulate every crossing; solder only the two endpoints.
481. **Verify W117 · HI_GATE_DRIVE:** Power disconnected: Output switching or current-limiting control; default OFF and mutually exclusive source/sink states are required. Connect C_HI_COMP.1 → U_LIMIT.1. Hole path (18,45) → (18,41) → (26,41). Insulate every crossing; solder only the two endpoints. Confirm endpoint continuity (<1Ω for a wire) and no adjacent-net bridge; isolate parallel paths before measuring.
482. **Connect W118 · LO_GATE_DRIVE:** Output switching or current-limiting control; default OFF and mutually exclusive source/sink states are required. Connect C_LO_COMP.1 → R_LO_GATE.1. Hole path (22,45) → (11,45). Insulate every crossing; solder only the two endpoints.
483. **Verify W118 · LO_GATE_DRIVE:** Power disconnected: Output switching or current-limiting control; default OFF and mutually exclusive source/sink states are required. Connect C_LO_COMP.1 → R_LO_GATE.1. Hole path (22,45) → (11,45). Insulate every crossing; solder only the two endpoints. Confirm endpoint continuity (<1Ω for a wire) and no adjacent-net bridge; isolate parallel paths before measuring.
484. **Connect W119 · LO_GATE_DRIVE:** Output switching or current-limiting control; default OFF and mutually exclusive source/sink states are required. Connect C_LO_COMP.1 → U_LIMIT.7. Hole path (22,45) → (22,42) → (29,42). Insulate every crossing; solder only the two endpoints.
485. **Verify W119 · LO_GATE_DRIVE:** Power disconnected: Output switching or current-limiting control; default OFF and mutually exclusive source/sink states are required. Connect C_LO_COMP.1 → U_LIMIT.7. Hole path (22,45) → (22,42) → (29,42). Insulate every crossing; solder only the two endpoints. Confirm endpoint continuity (<1Ω for a wire) and no adjacent-net bridge; isolate parallel paths before measuring.
486. **Connect W120 · HI_GATE:** Output switching or current-limiting control; default OFF and mutually exclusive source/sink states are required. Connect Q_HIGH.1 → R_HI_GATE.2. Hole path (32,45) → (8,45). Insulate every crossing; solder only the two endpoints.
487. **Verify W120 · HI_GATE:** Power disconnected: Output switching or current-limiting control; default OFF and mutually exclusive source/sink states are required. Connect Q_HIGH.1 → R_HI_GATE.2. Hole path (32,45) → (8,45). Insulate every crossing; solder only the two endpoints. Confirm endpoint continuity (<1Ω for a wire) and no adjacent-net bridge; isolate parallel paths before measuring.
488. **Connect W121 · LO_GATE:** Output switching or current-limiting control; default OFF and mutually exclusive source/sink states are required. Connect Q_LOW.2 → R_LO_GATE.2. Hole path (5,49) → (5,45) → (15,45). Insulate every crossing; solder only the two endpoints.
489. **Verify W121 · LO_GATE:** Power disconnected: Output switching or current-limiting control; default OFF and mutually exclusive source/sink states are required. Connect Q_LOW.2 → R_LO_GATE.2. Hole path (5,49) → (5,45) → (15,45). Insulate every crossing; solder only the two endpoints. Confirm endpoint continuity (<1Ω for a wire) and no adjacent-net bridge; isolate parallel paths before measuring.
490. **Connect W122 · SOURCE_OUT:** Output switching or current-limiting control; default OFF and mutually exclusive source/sink states are required. Connect K_HIGH.3 → Q_HIGH.3. Hole path (12,51) → (12,50.5) → (23.5,50.5) → (23.5,45.5) → (34,45.5) → (34,45). Insulate every crossing; solder only the two endpoints.
491. **Verify W122 · SOURCE_OUT:** Power disconnected: Output switching or current-limiting control; default OFF and mutually exclusive source/sink states are required. Connect K_HIGH.3 → Q_HIGH.3. Hole path (12,51) → (12,50.5) → (23.5,50.5) → (23.5,45.5) → (34,45.5) → (34,45). Insulate every crossing; solder only the two endpoints. Confirm endpoint continuity (<1Ω for a wire) and no adjacent-net bridge; isolate parallel paths before measuring.
492. **Connect W123 · SINK_IN:** Named control/interconnect for sink in. Verify both pin functions against the schematic before soldering. Connect K_LOW.4 → Q_LOW.3. Hole path (18,54) → (18,53.5) → (11.5,53.5) → (11.5,49.5) → (6,49.5) → (6,49). Insulate every crossing; solder only the two endpoints.
493. **Verify W123 · SINK_IN:** Power disconnected: Named control/interconnect for sink in. Verify both pin functions against the schematic before soldering. Connect K_LOW.4 → Q_LOW.3. Hole path (18,54) → (18,53.5) → (11.5,53.5) → (11.5,49.5) → (6,49.5) → (6,49). Insulate every crossing; solder only the two endpoints. Confirm endpoint continuity (<1Ω for a wire) and no adjacent-net bridge; isolate parallel paths before measuring.
494. **Connect W124 · K_HIGH_LED:** Named control/interconnect for k high led. Verify both pin functions against the schematic before soldering. Connect K_HIGH.1 → R_K_HIGH_LED.2. Hole path (9,50) → (9,49.5) → (14,49.5) → (19,49.5) → (19,49). Insulate every crossing; solder only the two endpoints.
495. **Verify W124 · K_HIGH_LED:** Power disconnected: Named control/interconnect for k high led. Verify both pin functions against the schematic before soldering. Connect K_HIGH.1 → R_K_HIGH_LED.2. Hole path (9,50) → (9,49.5) → (14,49.5) → (19,49.5) → (19,49). Insulate every crossing; solder only the two endpoints. Confirm endpoint continuity (<1Ω for a wire) and no adjacent-net bridge; isolate parallel paths before measuring.
496. **Connect W125 · K_HIGH_CATHODE:** Named control/interconnect for k high cathode. Verify both pin functions against the schematic before soldering. Connect K_HIGH.2 → Q_K_HIGH.3. Hole path (9,51) → (9,50.5) → (20.5,50.5) → (20.5,49.5) → (31,49.5) → (31,49). Insulate every crossing; solder only the two endpoints.
497. **Verify W125 · K_HIGH_CATHODE:** Power disconnected: Named control/interconnect for k high cathode. Verify both pin functions against the schematic before soldering. Connect K_HIGH.2 → Q_K_HIGH.3. Hole path (9,51) → (9,50.5) → (20.5,50.5) → (20.5,49.5) → (31,49.5) → (31,49). Insulate every crossing; solder only the two endpoints. Confirm endpoint continuity (<1Ω for a wire) and no adjacent-net bridge; isolate parallel paths before measuring.
498. **Connect W126 · K_LOW_LED:** Named control/interconnect for k low led. Verify both pin functions against the schematic before soldering. Connect K_LOW.1 → R_K_LOW_LED.2. Hole path (15,54) → (15,53.5) → (19.5,53.5) → (19.5,54.5) → (25,54.5) → (25,54). Insulate every crossing; solder only the two endpoints.
499. **Verify W126 · K_LOW_LED:** Power disconnected: Named control/interconnect for k low led. Verify both pin functions against the schematic before soldering. Connect K_LOW.1 → R_K_LOW_LED.2. Hole path (15,54) → (15,53.5) → (19.5,53.5) → (19.5,54.5) → (25,54.5) → (25,54). Insulate every crossing; solder only the two endpoints. Confirm endpoint continuity (<1Ω for a wire) and no adjacent-net bridge; isolate parallel paths before measuring.
500. **Connect W127 · K_LOW_CATHODE:** Named control/interconnect for k low cathode. Verify both pin functions against the schematic before soldering. Connect K_LOW.2 → Q_K_LOW.3. Hole path (15,55) → (15,54.5) → (26,54.5) → (26,49.5) → (36,49.5) → (36,49). Insulate every crossing; solder only the two endpoints.
501. **Verify W127 · K_LOW_CATHODE:** Power disconnected: Named control/interconnect for k low cathode. Verify both pin functions against the schematic before soldering. Connect K_LOW.2 → Q_K_LOW.3. Hole path (15,55) → (15,54.5) → (26,54.5) → (26,49.5) → (36,49.5) → (36,49). Insulate every crossing; solder only the two endpoints. Confirm endpoint continuity (<1Ω for a wire) and no adjacent-net bridge; isolate parallel paths before measuring.
502. **Fit CTRL_0:** smart-controller.J_CH0 → smart-channel:0.J_CONTROL; verify each conductor and pin1 with power OFF. Keep unused supply and signal pins isolated until their consumers are installed.
503. **Inspect CTRL_0:** Power OFF: smart-controller.J_CH0 → smart-channel:0.J_CONTROL; verify each conductor and pin1 with power OFF. Keep unused supply and signal pins isolated until their consumers are installed.
504. **Fit POWER_SMART:** power.J_SMART → smart-controller.J_POWER; verify each conductor and pin1 with power OFF. Keep unused supply and signal pins isolated until their consumers are installed.
505. **Inspect POWER_SMART:** Power OFF: power.J_SMART → smart-controller.J_POWER; verify each conductor and pin1 with power OFF. Keep unused supply and signal pins isolated until their consumers are installed.
506. **Fit final-smart-transition:** Remove ESP1 temporary smart-card bus/power bridges. Attach qualified POWER_SMART and CTRL_0; OLED/ADC now operate on ESP2 isolated A1 service bus.
507. **Inspect final-smart-transition:** Power OFF: Remove ESP1 temporary smart-card bus/power bridges. Attach qualified POWER_SMART and CTRL_0; OLED/ADC now operate on ESP2 isolated A1 service bus.
508. **Check the firmware contract:** smart factory mode on ESP2: migrate OLED/ADC service to its isolated position bus; register outputs OFF until qualified; valid heartbeat required
509. **Measure and record:** P3 low ≤0.5V and high ≥3.5V with measured 2mA load. Short to GND and separately to 5.25V: ≤12mA; scope transient and regulator oscillation.
510. **Measure and record:** Pulse 0.5/1/10Hz and duty 25/50/75%: frequency ±5%; duty ±5 percentage points; measure at the physical node.
511. **Film the win:** Smart output drives valid levels and limits short-circuit current.
512. **Accept this checkpoint:** Verify the readings and construction, then accept CP15.

## Firmware contract (implementation pending)

smart factory mode on ESP2: migrate OLED/ADC service to its isolated position bus; register outputs OFF until qualified; valid heartbeat required

## Acceptance tests

1. P3 low ≤0.5V and high ≥3.5V with measured 2mA load. Short to GND and separately to 5.25V: ≤12mA; scope transient and regulator oscillation.
2. Pulse 0.5/1/10Hz and duty 25/50/75%: frequency ±5%; duty ±5 percentage points; measure at the physical node.

## Film the win

USB prototype source and prototype 3V3 links removed before final supplies connect. Use checkpoint-specific bounded test loads; stop and isolate power before changing any link. For smart-mode bench fixtures, disconnect both fixed battery leads and remove the initial kit loop. Output load: P3→1kΩ→LED anode, LED cathode→GND through removable leads. Logic inputs: HIGH=qualified3V3_SYS through1kΩ; LOW=GND through1kΩ. AND/OR exercise00,01,10,11; NOT exercise0,1. Never parallel another source with P3. Current tests use a documented series path, never an ammeter across the supply.

1. Show bounded source and sink setup with power OFF and display firmware revision.
2. Demonstrate: Smart output drives valid levels and limits short-circuit current.
3. Show the documented negative test and actual recorded readings.

**Negative example:** Use the qualified bounded short test: hardware clamps current and remains within limits.

Record readings and units, equipment, link positions, firmware revision and outcome. Firmware is a contract only; never film simulated readings as measured hardware evidence.
