gefgu/integration-workshop-3/eletronics/perfboard/cp18.md

# CP18 — AND gate

**Win:** The LED follows the AND truth table.

Build the assigned functional groups in the [assembly app](tscircuit/README.md). Earlier soldered wiring stays fixed. Removable links and top-side kit arrangements may change.

## Link positions

- USB prototype source and prototype 3V3 links removed before final supplies connect.
- Use checkpoint-specific bounded test loads; stop and isolate power before changing any link.
- For smart-mode bench fixtures, disconnect both fixed battery leads and remove the initial kit loop. Output load: P3→1kΩ→LED anode, LED cathode→GND through removable leads. Logic inputs: HIGH=qualified3V3_SYS through1kΩ; LOW=GND through1kΩ. AND/OR exercise00,01,10,11; NOT exercise0,1. Never parallel another source with P3. Current tests use a documented series path, never an ammeter across the supply.

## Guided actions

1. **Disconnect power and prepare:** Unplug USB and all educational sources before construction. USB prototype source and prototype 3V3 links removed before final supplies connect. Use checkpoint-specific bounded test loads; stop and isolate power before changing any link. For smart-mode bench fixtures, disconnect both fixed battery leads and remove the initial kit loop. Output load: P3→1kΩ→LED anode, LED cathode→GND through removable leads. Logic inputs: HIGH=qualified3V3_SYS through1kΩ; LOW=GND through1kΩ. AND/OR exercise00,01,10,11; NOT exercise0,1. Never parallel another source with P3. Current tests use a documented series path, never an ammeter across the supply.
2. **Check the firmware contract:** smart factory mode on ESP2: migrate OLED/ADC service to its isolated position bus; register outputs OFF until qualified; valid heartbeat required
3. **Measure and record:** Test each selected gate truth table using protected input levels. Require 20ms stable input and ≤100ms output response. Confirm open inputs read LOW.
4. **Measure and record:** Record all four AND input combinations using bounded removable links and DMM-confirmed input levels.
5. **Film the win:** The LED follows the AND truth table.
6. **Accept this checkpoint:** Verify the readings and construction, then accept CP18.

## Firmware contract (implementation pending)

smart factory mode on ESP2: migrate OLED/ADC service to its isolated position bus; register outputs OFF until qualified; valid heartbeat required

## Acceptance tests

1. Test each selected gate truth table using protected input levels. Require 20ms stable input and ≤100ms output response. Confirm open inputs read LOW.
2. Record all four AND input combinations using bounded removable links and DMM-confirmed input levels.

## Film the win

USB prototype source and prototype 3V3 links removed before final supplies connect. Use checkpoint-specific bounded test loads; stop and isolate power before changing any link. For smart-mode bench fixtures, disconnect both fixed battery leads and remove the initial kit loop. Output load: P3→1kΩ→LED anode, LED cathode→GND through removable leads. Logic inputs: HIGH=qualified3V3_SYS through1kΩ; LOW=GND through1kΩ. AND/OR exercise00,01,10,11; NOT exercise0,1. Never parallel another source with P3. Current tests use a documented series path, never an ammeter across the supply.

1. Show and gate setup with power OFF and display firmware revision.
2. Demonstrate: The LED follows the AND truth table.
3. Show the documented negative test and actual recorded readings.

**Negative example:** AND inputs01,10 and00 must remain LOW; only11 may be HIGH.

Record readings and units, equipment, link positions, firmware revision and outcome. Firmware is a contract only; never film simulated readings as measured hardware evidence.
