gefgu/integration-workshop-3/eletronics/perfboard/cp21.md

# CP21 — SR memory

**Win:** Set persists, and reset wins.

Build the assigned functional groups in the [assembly app](tscircuit/README.md). Earlier soldered wiring stays fixed. Removable links and top-side kit arrangements may change.

## Link positions

- USB prototype source and prototype 3V3 links removed before final supplies connect.
- Use checkpoint-specific bounded test loads; stop and isolate power before changing any link.
- For smart-mode bench fixtures, disconnect both fixed battery leads and remove the initial kit loop. Output load: P3→1kΩ→LED anode, LED cathode→GND through removable leads. Logic inputs: HIGH=qualified3V3_SYS through1kΩ; LOW=GND through1kΩ. AND/OR exercise00,01,10,11; NOT exercise0,1. Never parallel another source with P3. Current tests use a documented series path, never an ammeter across the supply.

## Guided actions

1. **Disconnect power and prepare:** Unplug USB and all educational sources before construction. USB prototype source and prototype 3V3 links removed before final supplies connect. Use checkpoint-specific bounded test loads; stop and isolate power before changing any link. For smart-mode bench fixtures, disconnect both fixed battery leads and remove the initial kit loop. Output load: P3→1kΩ→LED anode, LED cathode→GND through removable leads. Logic inputs: HIGH=qualified3V3_SYS through1kΩ; LOW=GND through1kΩ. AND/OR exercise00,01,10,11; NOT exercise0,1. Never parallel another source with P3. Current tests use a documented series path, never an ammeter across the supply.
2. **Check the firmware contract:** smart factory mode on ESP2: migrate OLED/ADC service to its isolated position bus; register outputs OFF until qualified; valid heartbeat required
3. **Measure and record:** Set output, remove the set input and verify retained state. Reset clears it. Simultaneous set/reset resolves to zero.
4. **Measure and record:** Restart, rail OFF or configuration loss clears memory and leaves output disabled.
5. **Film the win:** Set persists, and reset wins.
6. **Accept this checkpoint:** Verify the readings and construction, then accept CP21.

## Firmware contract (implementation pending)

smart factory mode on ESP2: migrate OLED/ADC service to its isolated position bus; register outputs OFF until qualified; valid heartbeat required

## Acceptance tests

1. Set output, remove the set input and verify retained state. Reset clears it. Simultaneous set/reset resolves to zero.
2. Restart, rail OFF or configuration loss clears memory and leaves output disabled.

## Film the win

USB prototype source and prototype 3V3 links removed before final supplies connect. Use checkpoint-specific bounded test loads; stop and isolate power before changing any link. For smart-mode bench fixtures, disconnect both fixed battery leads and remove the initial kit loop. Output load: P3→1kΩ→LED anode, LED cathode→GND through removable leads. Logic inputs: HIGH=qualified3V3_SYS through1kΩ; LOW=GND through1kΩ. AND/OR exercise00,01,10,11; NOT exercise0,1. Never parallel another source with P3. Current tests use a documented series path, never an ammeter across the supply.

1. Show sr memory setup with power OFF and display firmware revision.
2. Demonstrate: Set persists, and reset wins.
3. Show the documented negative test and actual recorded readings.

**Negative example:** Assert set and reset together: reset wins; rail-off loses the stored state.

Record readings and units, equipment, link positions, firmware revision and outcome. Firmware is a contract only; never film simulated readings as measured hardware evidence.
