gefgu/integration-workshop-3/eletronics/perfboard/cp24.md

# CP24 — Route one LED loop

**Win:** The matrix completes one bounded LED loop.

Build the assigned functional groups in the [assembly app](tscircuit/README.md). Earlier soldered wiring stays fixed. Removable links and top-side kit arrangements may change.

## Link positions

- USB prototype source and prototype 3V3 links removed before final supplies connect.
- Use checkpoint-specific bounded test loads; stop and isolate power before changing any link.
- Remove all fixed source patch leads before matrix routing. Source node selection now belongs to the qualified matrix topology.

## Guided actions

1. **Disconnect power and prepare:** Unplug USB and all educational sources before construction. USB prototype source and prototype 3V3 links removed before final supplies connect. Use checkpoint-specific bounded test loads; stop and isolate power before changing any link. Remove all fixed source patch leads before matrix routing. Source node selection now belongs to the qualified matrix topology.
2. **Place U_ADDR:** U_ADDR: addr; SN74HCT595N. Part of 5-V serial address latch and tri-state strobes. Mount on the top side; red pad identifies pin 1. 
3. **Inspect U_ADDR:** Power OFF: inspect every terminal, polarity, seating and solder joint. U_ADDR: addr; SN74HCT595N. Part of 5-V serial address latch and tri-state strobes. Mount on the top side; red pad identifies pin 1. 
4. **Place C_ADDR:** C_ADDR: addr; 100nF. Part of 5-V serial address latch and tri-state strobes. Mount on the top side; red pad identifies pin 1. 
5. **Inspect C_ADDR:** Power OFF: inspect every terminal, polarity, seating and solder joint. C_ADDR: addr; 100nF. Part of 5-V serial address latch and tri-state strobes. Mount on the top side; red pad identifies pin 1. 
6. **Place U_BUFFER:** U_BUFFER: buffer; SN74HCT125N. Part of 5-V serial address latch and tri-state strobes. Mount on the top side; red pad identifies pin 1. 
7. **Inspect U_BUFFER:** Power OFF: inspect every terminal, polarity, seating and solder joint. U_BUFFER: buffer; SN74HCT125N. Part of 5-V serial address latch and tri-state strobes. Mount on the top side; red pad identifies pin 1. 
8. **Place C_BUFFER:** C_BUFFER: buffer; 100nF. Part of 5-V serial address latch and tri-state strobes. Mount on the top side; red pad identifies pin 1. 
9. **Inspect C_BUFFER:** Power OFF: inspect every terminal, polarity, seating and solder joint. C_BUFFER: buffer; 100nF. Part of 5-V serial address latch and tri-state strobes. Mount on the top side; red pad identifies pin 1.
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
