gefgu/integration-workshop-3/docs/d5-figuras/app-02-tour.png

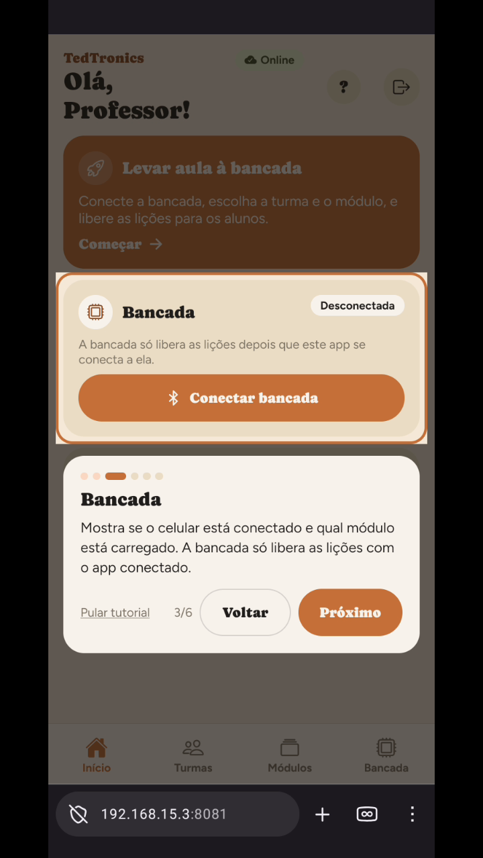
docs/d5-figuras/app-02-tour.png
