gefgu/integration-workshop-3/docs/d5-figuras/app-03-modulos.png

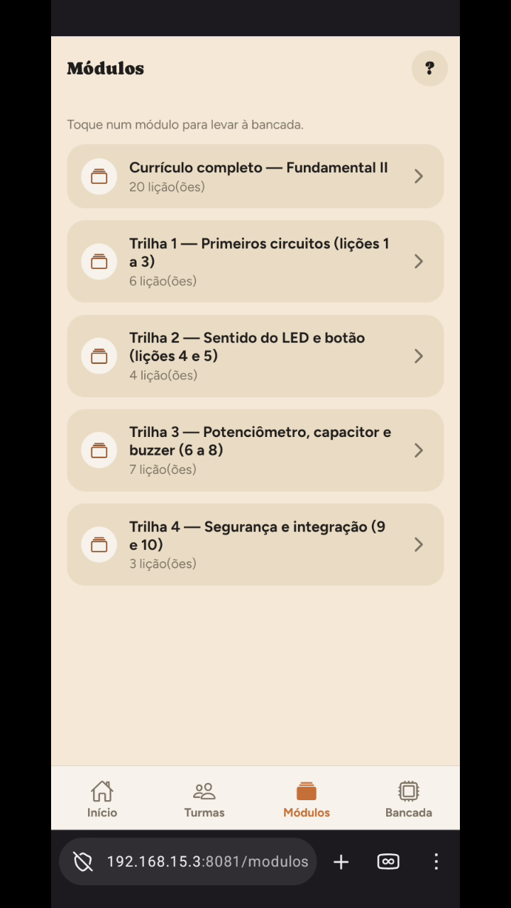
docs/d5-figuras/app-03-modulos.png
