gefgu/integration-workshop-3/docs/d5-figuras/app-04-turma.png

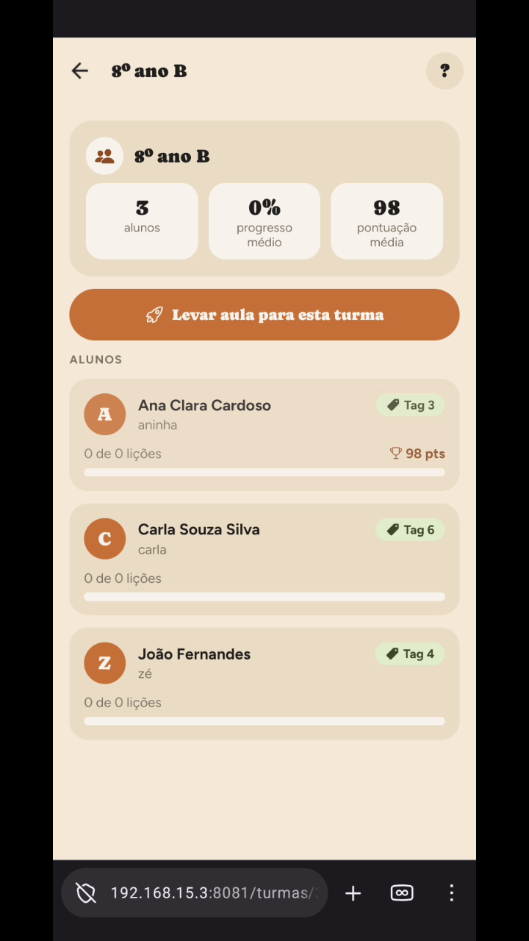
docs/d5-figuras/app-04-turma.png
