gefgu/integration-workshop-3/docs/d5-figuras/app-05-conectar.png

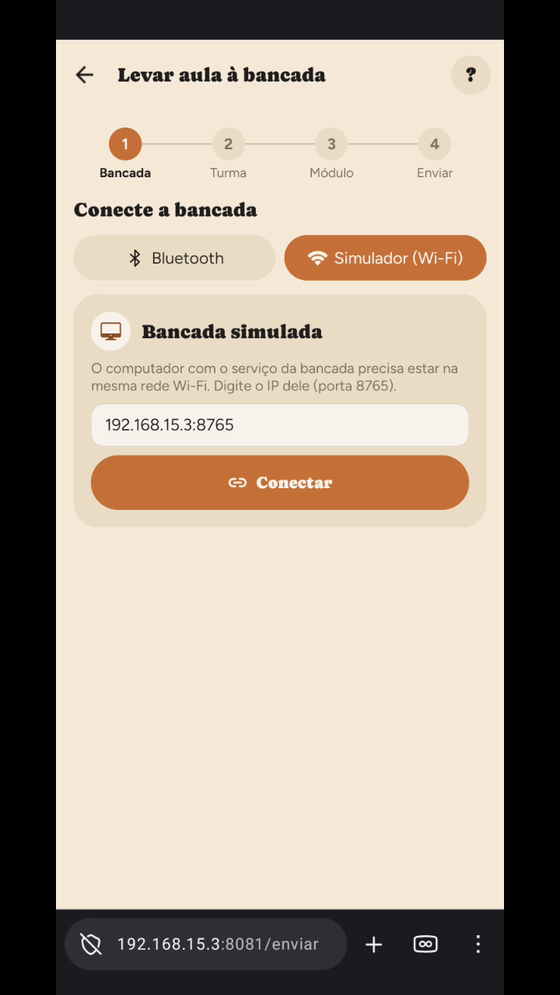
docs/d5-figuras/app-05-conectar.png
