gefgu/integration-workshop-3/docs/d5-figuras/app-08-sincronizado.png

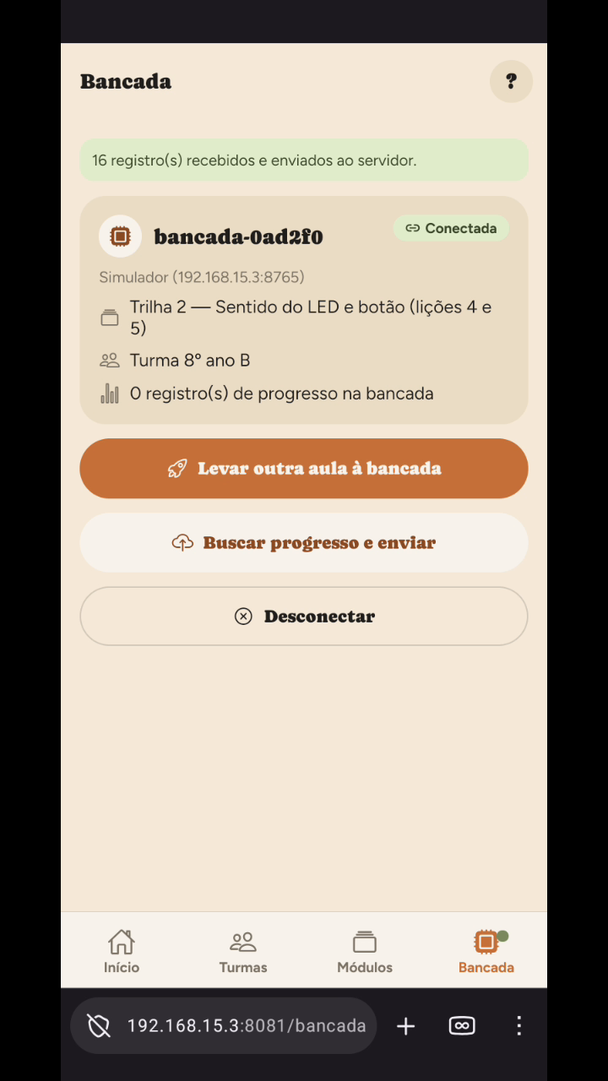
docs/d5-figuras/app-08-sincronizado.png
