gefgu/integration-workshop-3/docs/d5-figuras/bancada-01-bloqueada.png

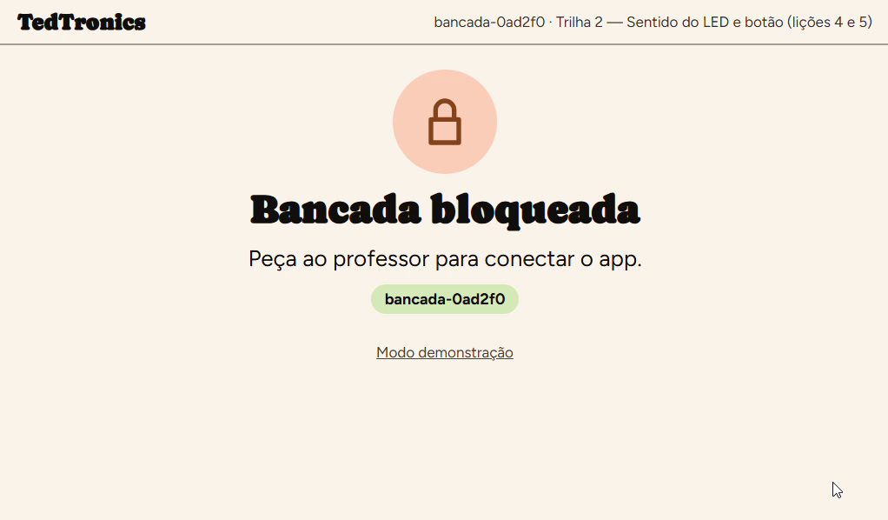
docs/d5-figuras/bancada-01-bloqueada.png
