gefgu/integration-workshop-3/docs/d5-figuras/bancada-02-tag.png

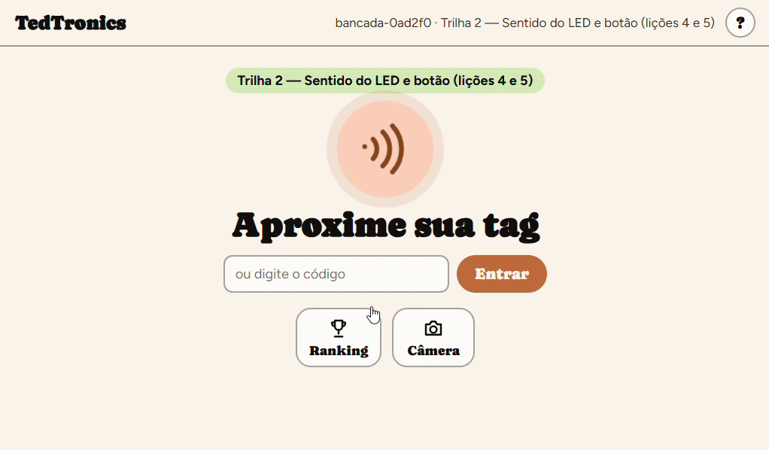
docs/d5-figuras/bancada-02-tag.png
