gefgu/integration-workshop-3/docs/d5-figuras/bancada-04-abertura-licao.png

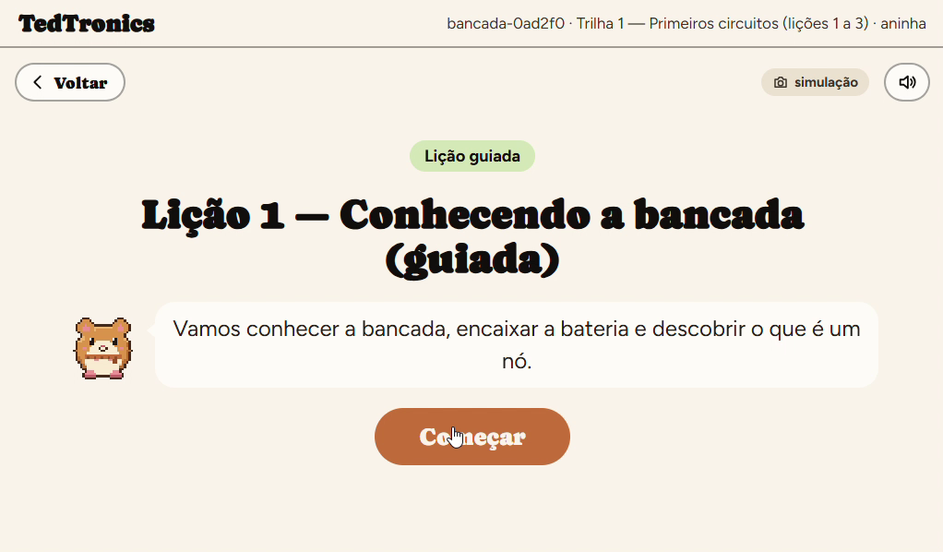
docs/d5-figuras/bancada-04-abertura-licao.png
