gefgu/integration-workshop-3/docs/d5-figuras/bancada-10-pontuacao.png

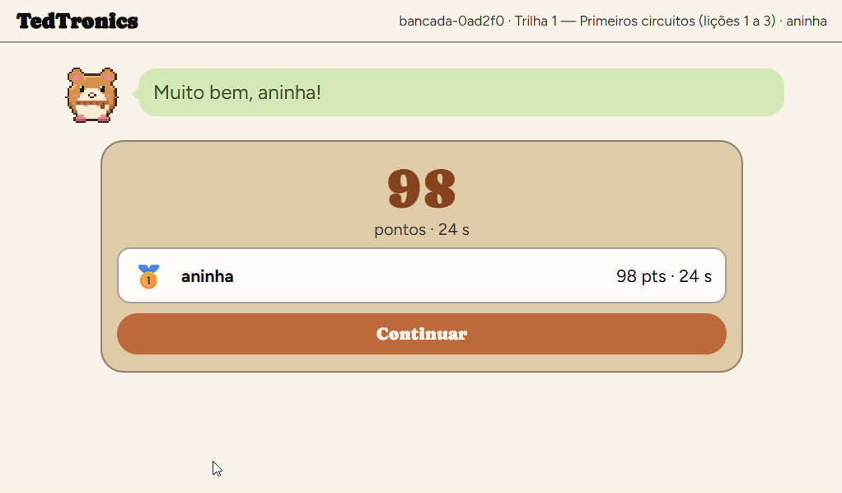
docs/d5-figuras/bancada-10-pontuacao.png
