gefgu/integration-workshop-3/docs/d5-figuras/bancada-11-ranking.png

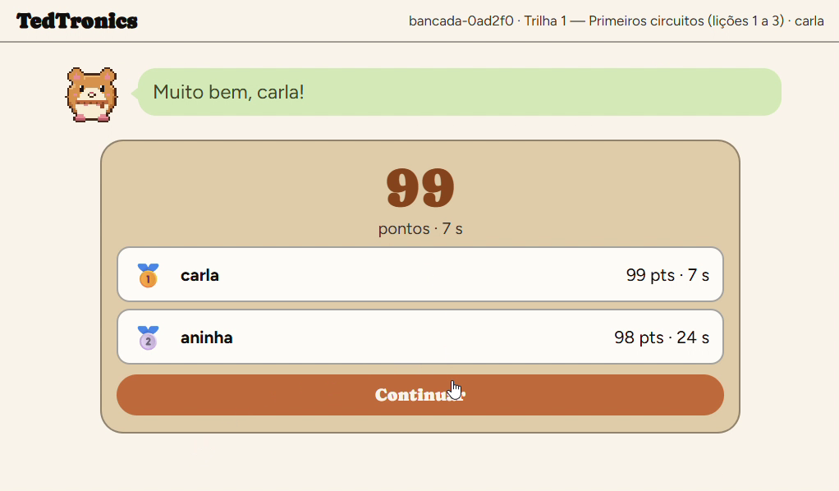
docs/d5-figuras/bancada-11-ranking.png
