gefgu/integration-workshop-3/docs/d5-figuras/bancada-12-licao4.png

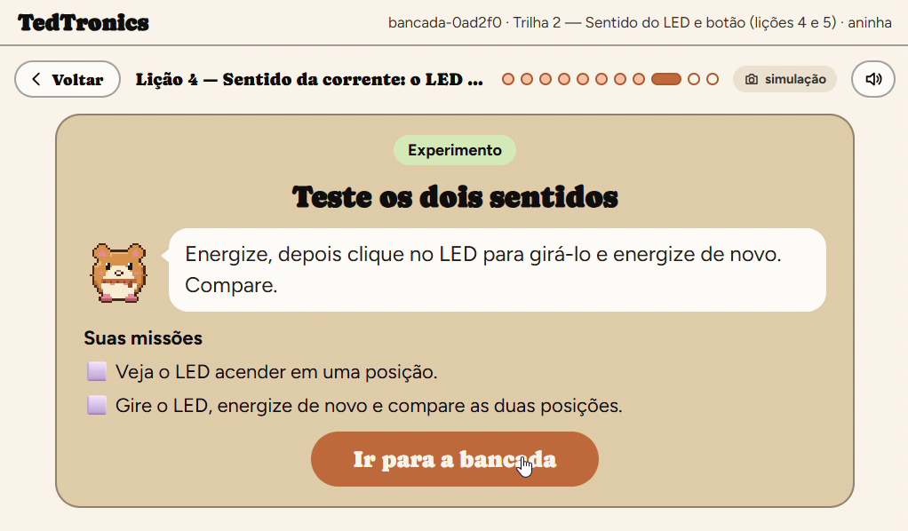
docs/d5-figuras/bancada-12-licao4.png
