gefgu/integration-workshop-3/docs/d5-figuras/site-02-editor-protoboard.png

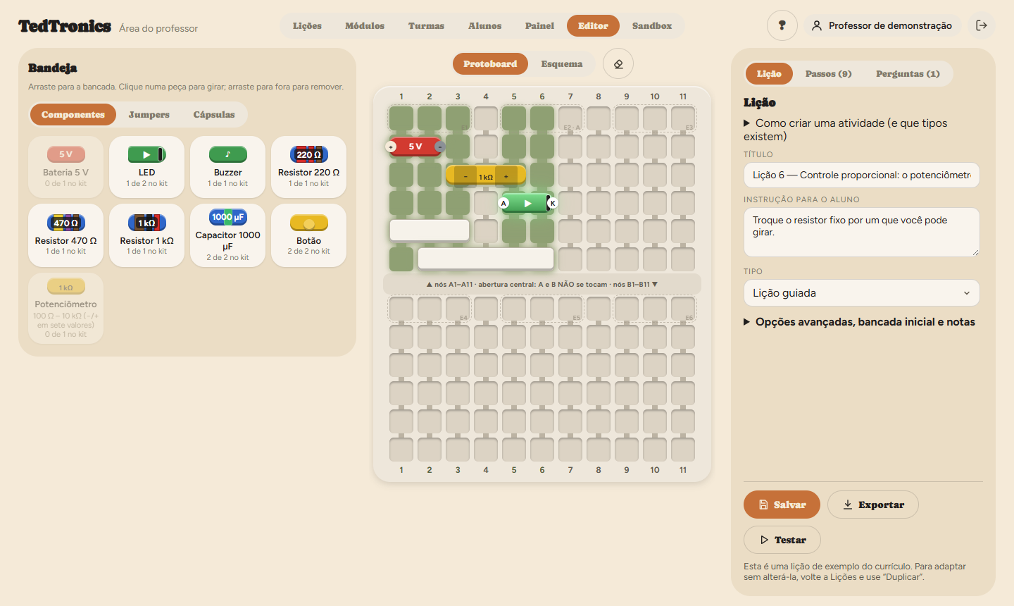
docs/d5-figuras/site-02-editor-protoboard.png
