gefgu/integration-workshop-3/docs/d5-figuras/site-06-turma.png

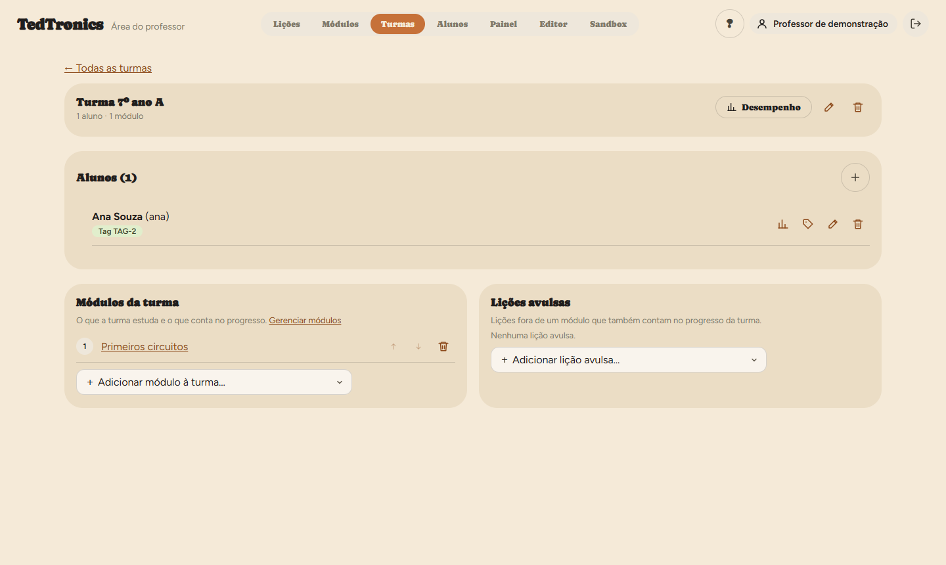
docs/d5-figuras/site-06-turma.png
