gefgu/integration-workshop-3/docs/d5-figuras/site-07-alunos.png

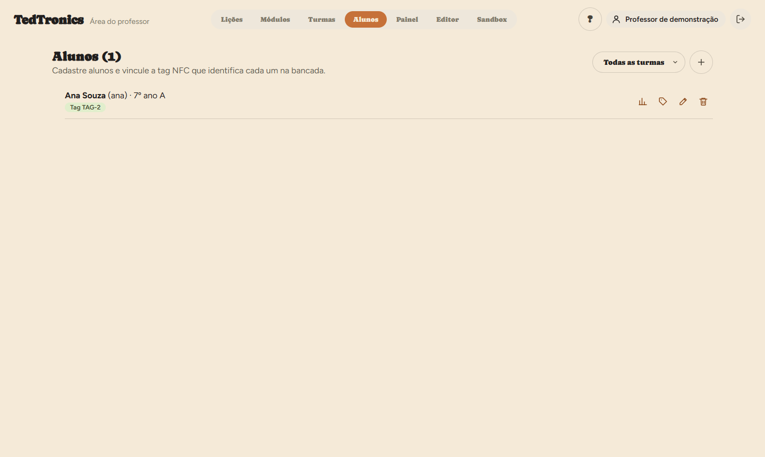
docs/d5-figuras/site-07-alunos.png
