gefgu/integration-workshop-3/docs/d5-figuras/site-10-sandbox-esquema.png

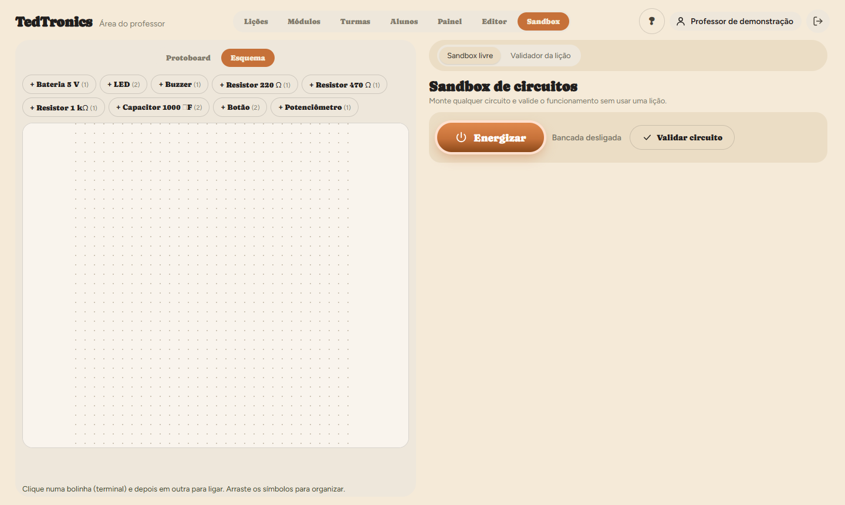
docs/d5-figuras/site-10-sandbox-esquema.png
