gefgu/integration-workshop-3/docs/deliverables/d1_images/bateria.jpeg

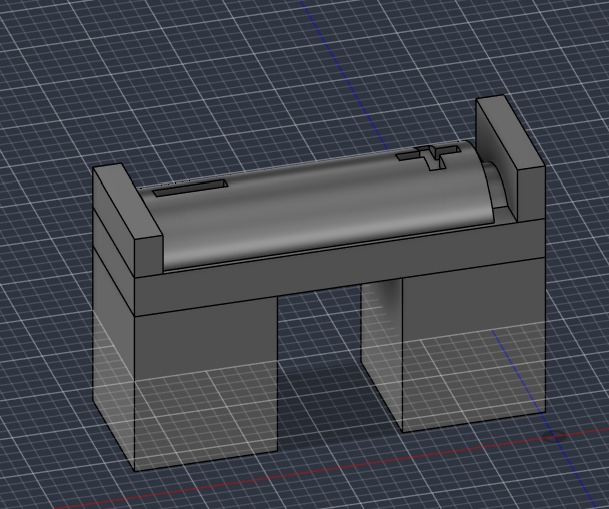
docs/deliverables/d1_images/bateria.jpeg
