gefgu/integration-workshop-3/docs/deliverables/d1_images/botao.jpeg

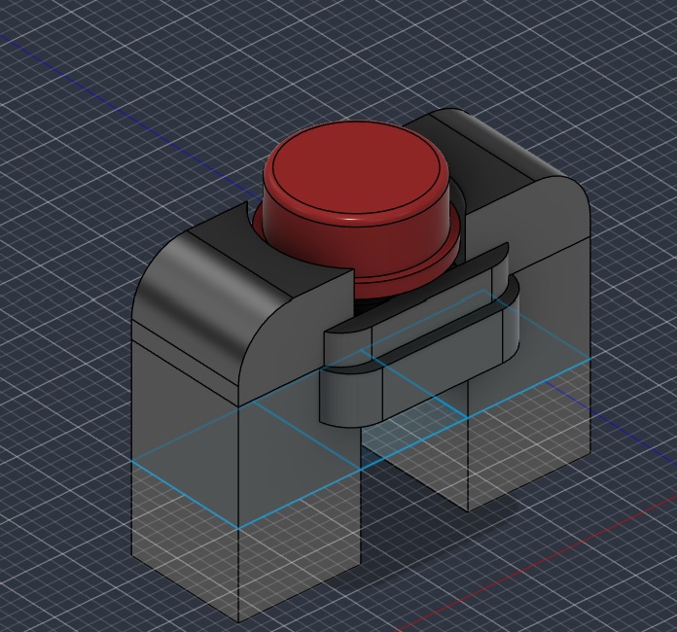
docs/deliverables/d1_images/botao.jpeg
