gefgu/integration-workshop-3/docs/deliverables/d1_images/componente_inteligente.jpeg

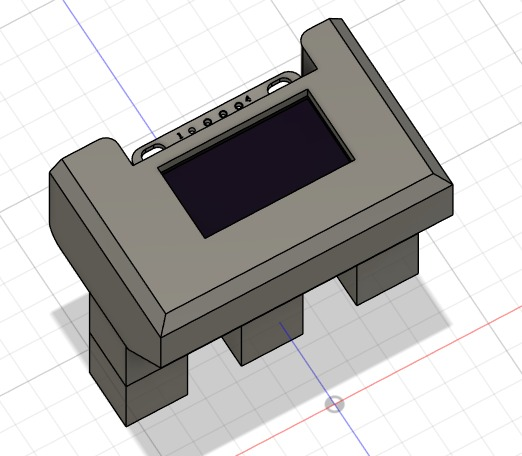
docs/deliverables/d1_images/componente_inteligente.jpeg
