gefgu/integration-workshop-3/docs/deliverables/d1_images/resistor.jpeg

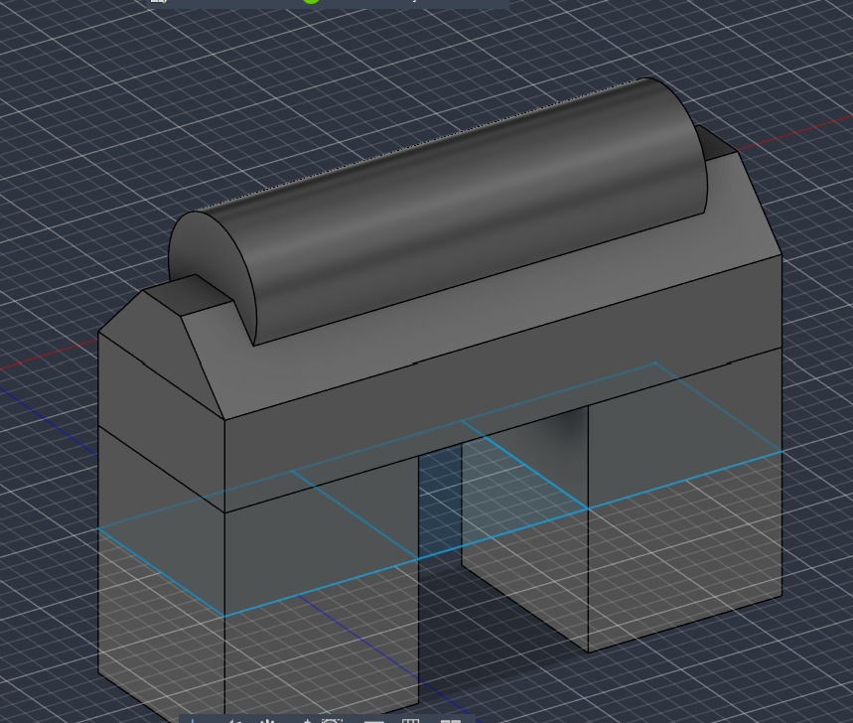
docs/deliverables/d1_images/resistor.jpeg
