gefgu/integration-workshop-3/docs/deliverables/d3/eletronic_images/everything_fits.jpeg

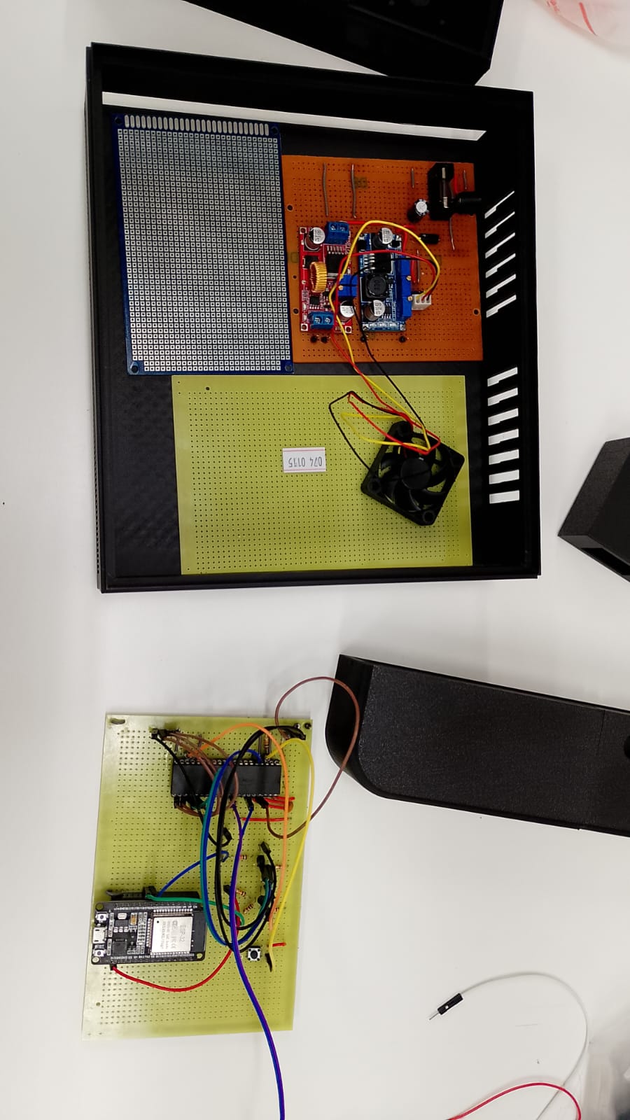
docs/deliverables/d3/eletronic_images/everything_fits.jpeg
