gefgu/integration-workshop-3/docs/deliverables/d3/eletronic_images/routing_board_working.jpeg

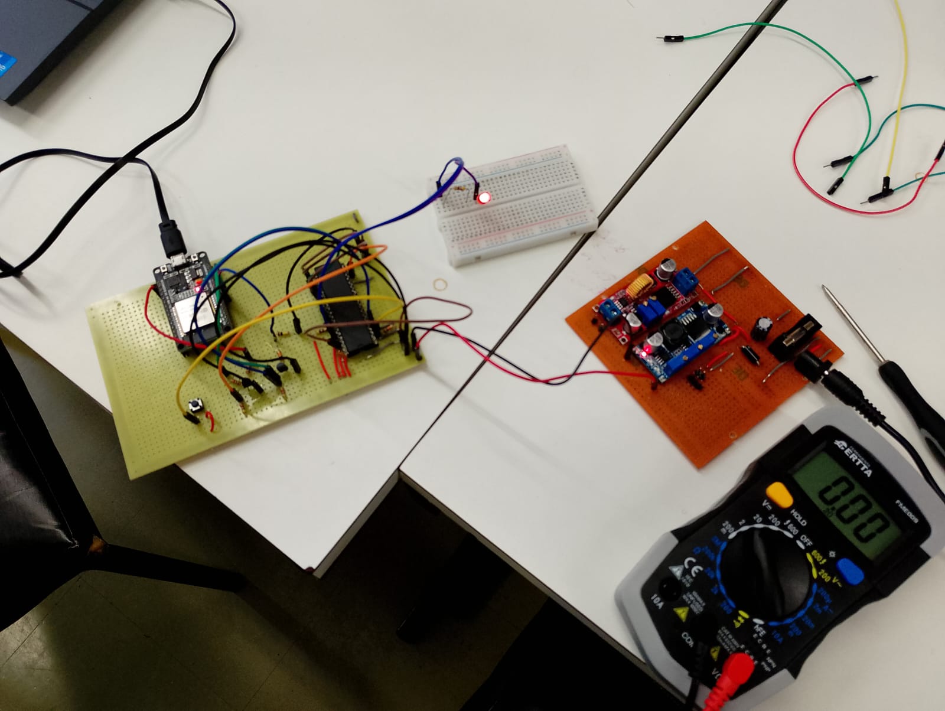
docs/deliverables/d3/eletronic_images/routing_board_working.jpeg
