gefgu/integration-workshop-3/docs/deliverables/d3/mechanic_images/side-compartment-removable-cover.jpeg

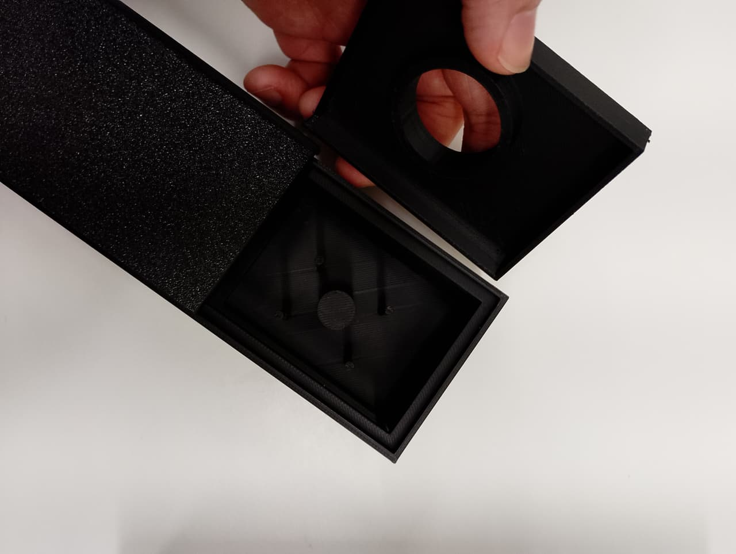
docs/deliverables/d3/mechanic_images/side-compartment-removable-cover.jpeg
