gefgu/integration-workshop-3/docs/deliverables/d3/mechanic_images/side-cover-two-hole-panel.jpeg

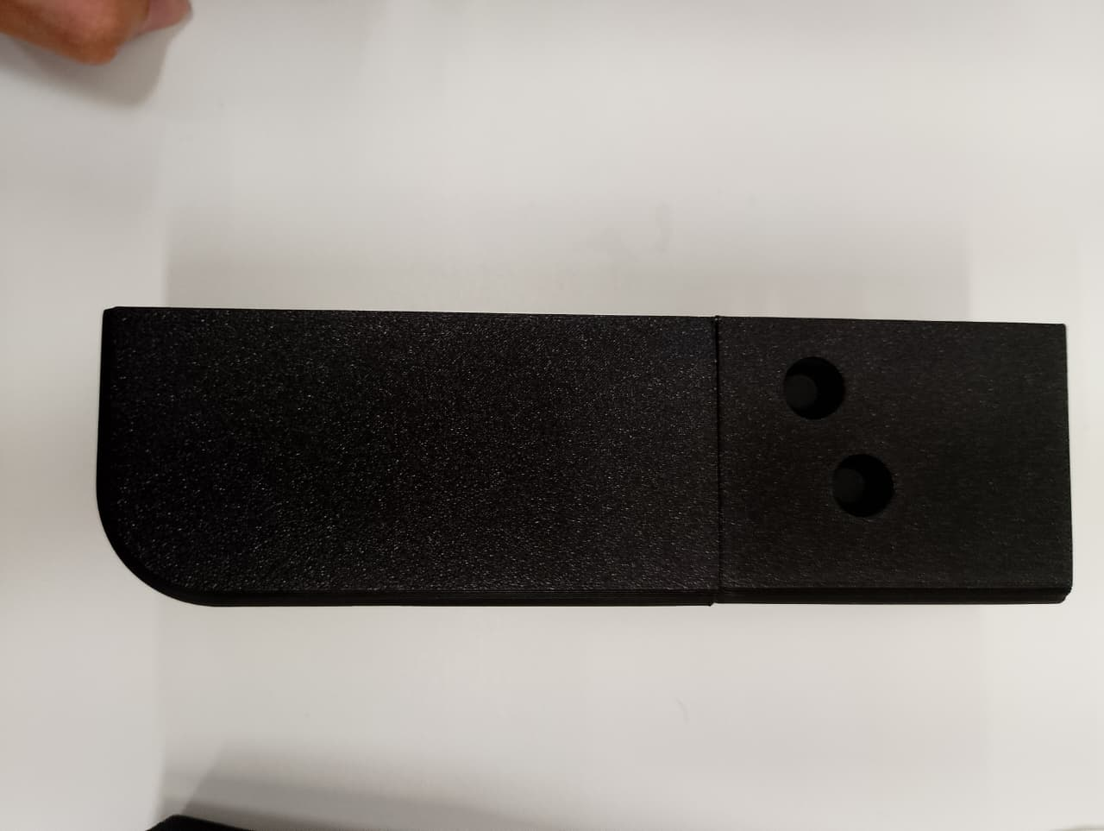
docs/deliverables/d3/mechanic_images/side-cover-two-hole-panel.jpeg
