gefgu/integration-workshop-3/docs/deliverables/d3/mechanic_images/support-rod-threaded-end-close-up.jpeg

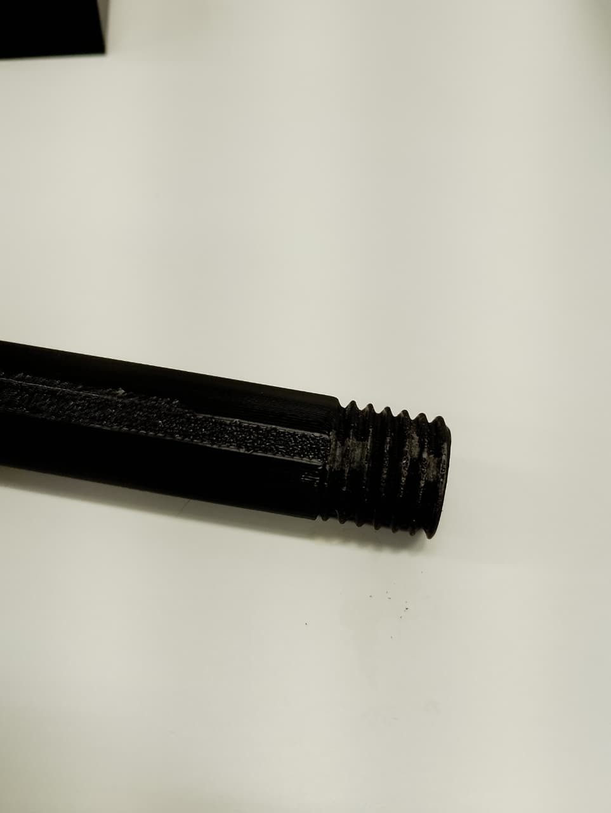
docs/deliverables/d3/mechanic_images/support-rod-threaded-end-close-up.jpeg
