gefgu/integration-workshop-3/docs/deliverables/d3/notion_media/5v_regulated.jpeg

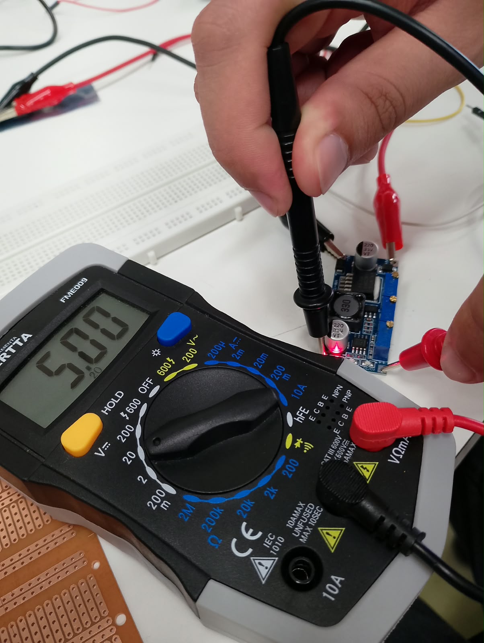
docs/deliverables/d3/notion_media/5v_regulated.jpeg
