gefgu/integration-workshop-3/docs/deliverables/d3/notion_media/software-architecture-overview.png

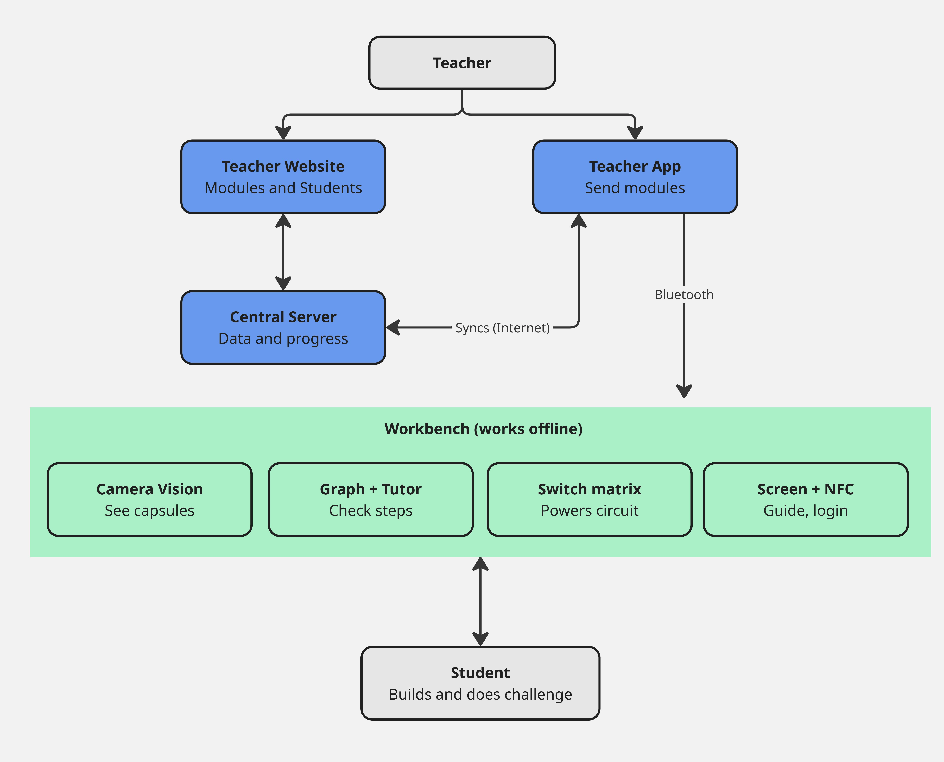
docs/deliverables/d3/notion_media/software-architecture-overview.png
