gefgu/integration-workshop-3/docs/deliverables/d3/software_design_images/activities_diagram.png

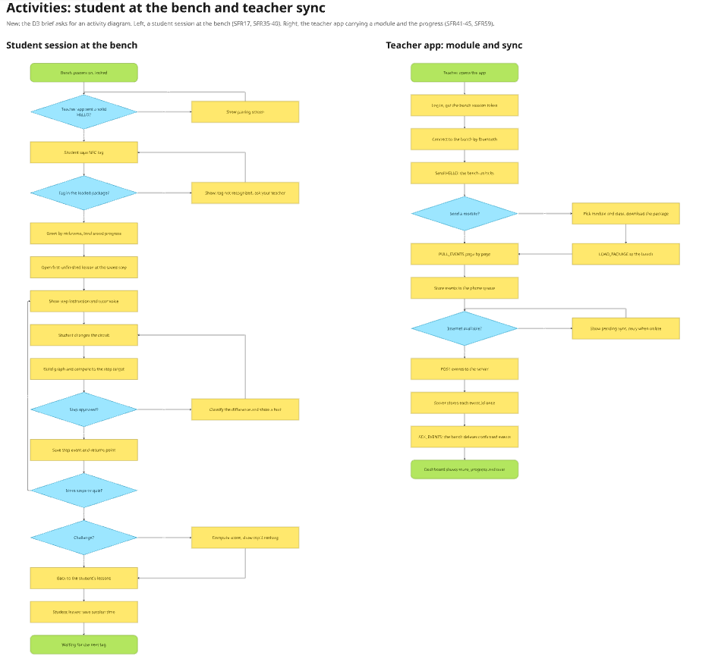
docs/deliverables/d3/software_design_images/activities_diagram.png
