gefgu/integration-workshop-3/docs/deliverables/d3/software_design_images/bench_screen_2.png

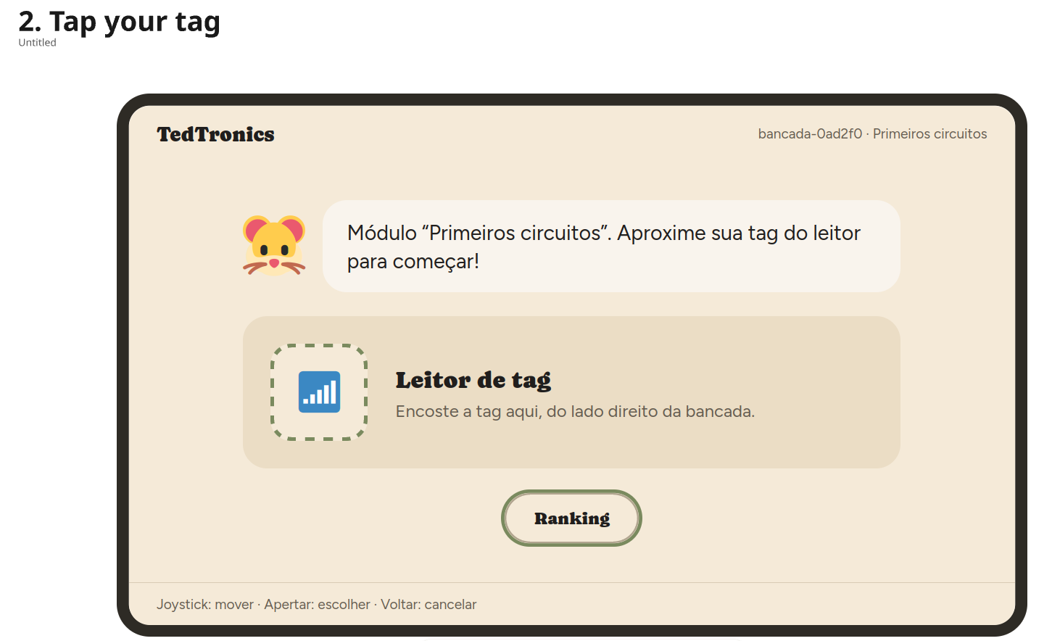
docs/deliverables/d3/software_design_images/bench_screen_2.png
