gefgu/integration-workshop-3/docs/deliverables/d3/software_design_images/firmware_diagram_4.png

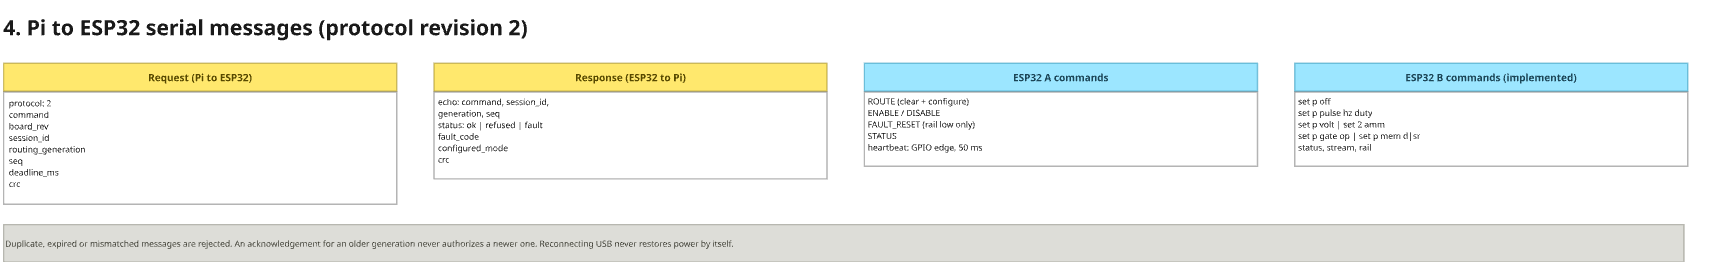
docs/deliverables/d3/software_design_images/firmware_diagram_4.png
