gefgu/integration-workshop-3/docs/deliverables/d3/software_design_images/firmware_smart_capsule.png

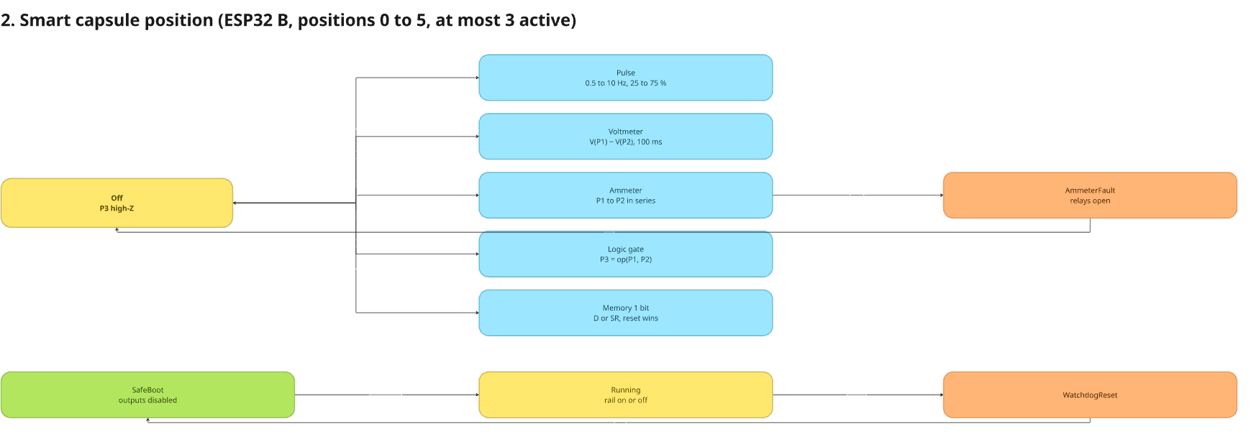
docs/deliverables/d3/software_design_images/firmware_smart_capsule.png
