gefgu/integration-workshop-3/docs/deliverables/d3/software_design_images/sequence_diagram_3.png

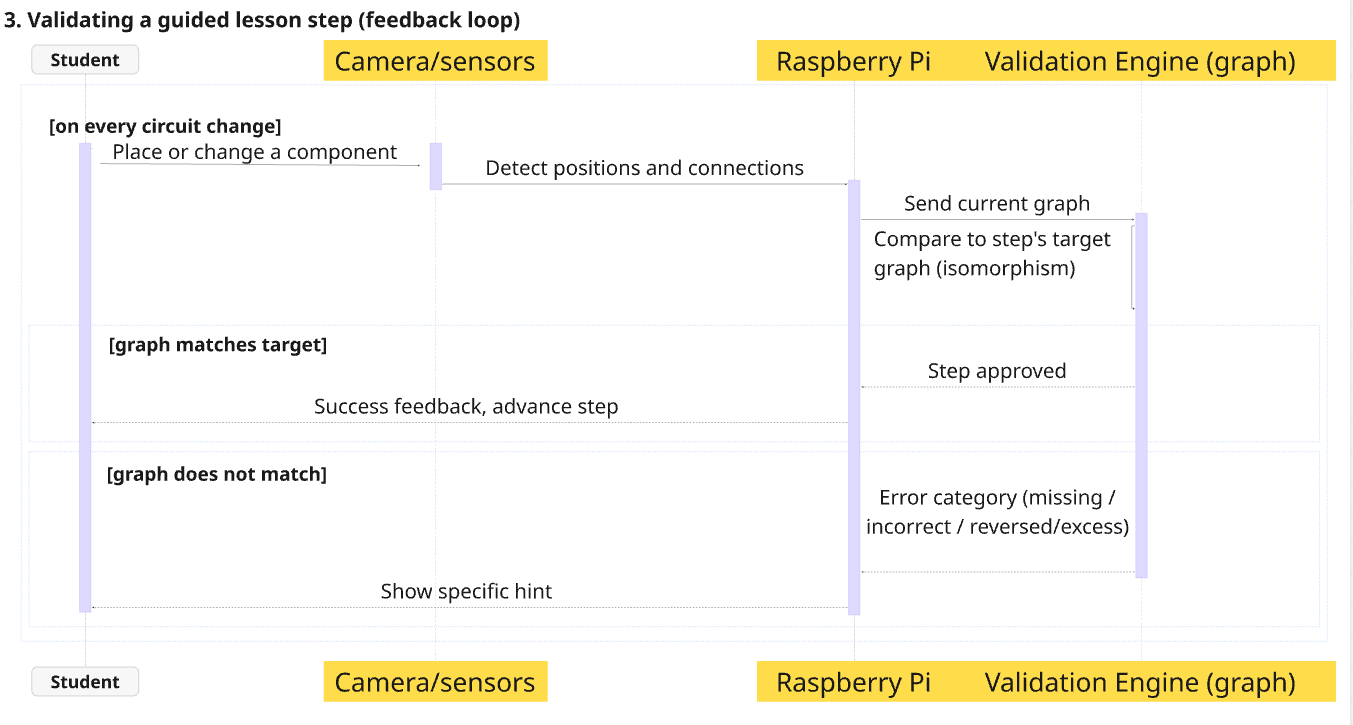
docs/deliverables/d3/software_design_images/sequence_diagram_3.png
