gefgu/integration-workshop-3/docs/deliverables/d3/software_design_images/teacher_screen_3.png

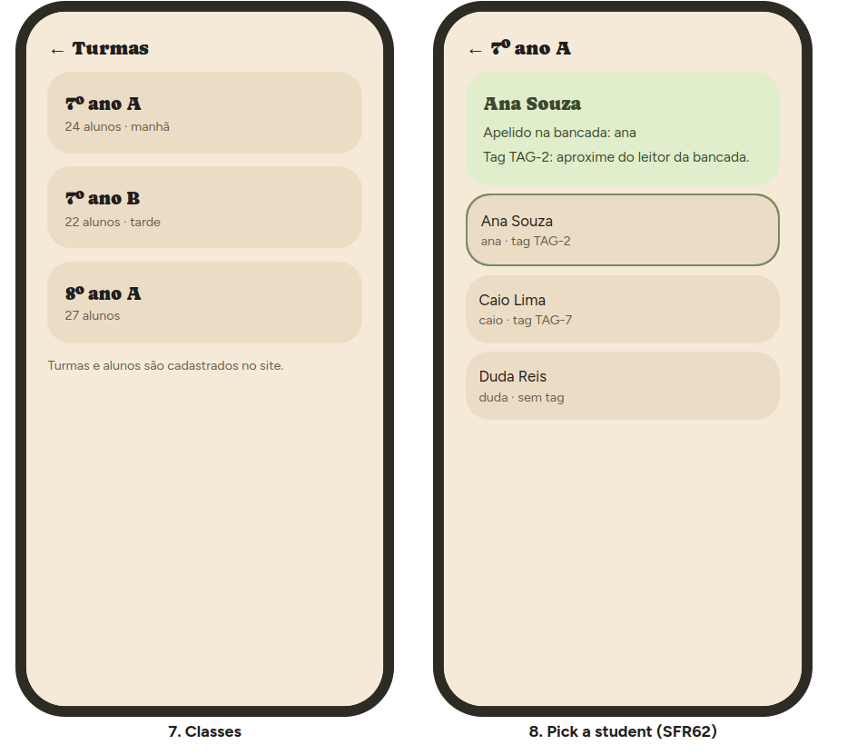
docs/deliverables/d3/software_design_images/teacher_screen_3.png
