gefgu/integration-workshop-3/docs/deliverables/d3/software_design_images/UI_final.png

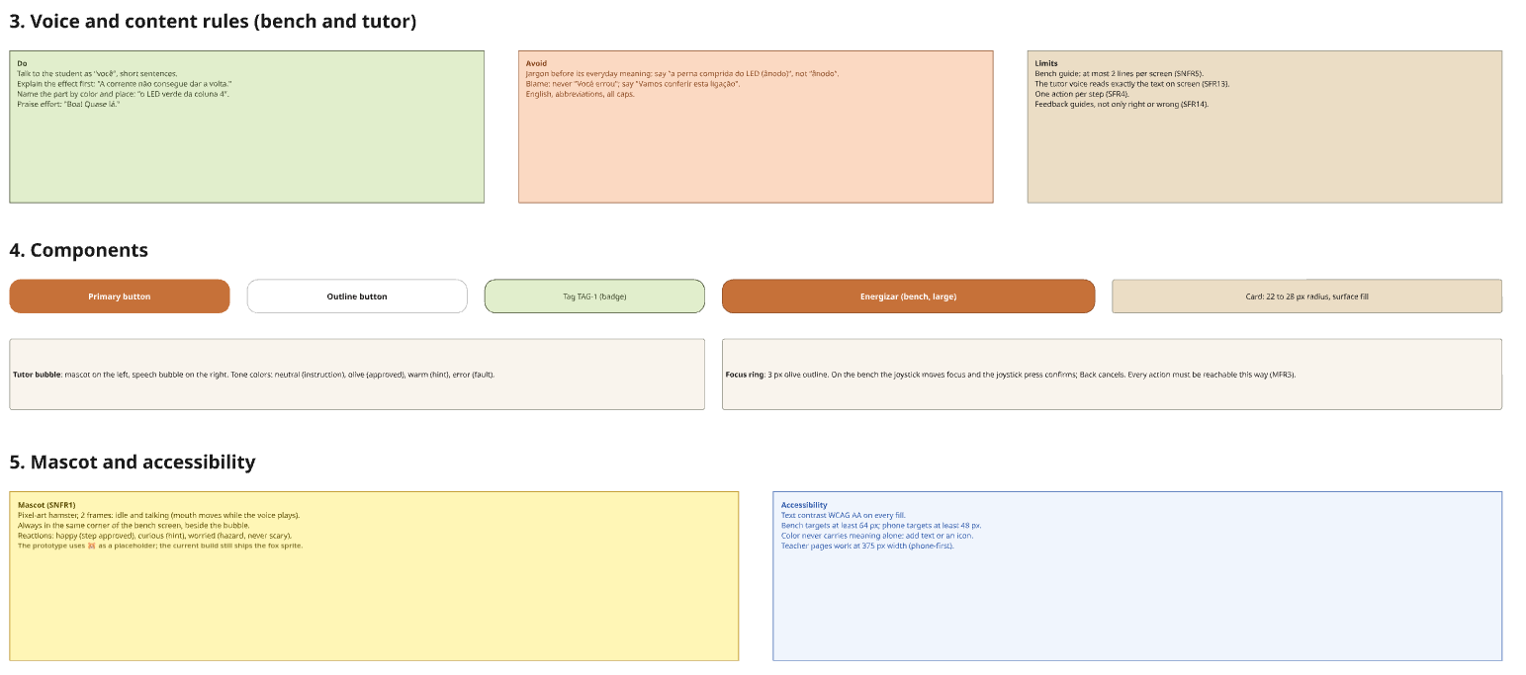
docs/deliverables/d3/software_design_images/UI_final.png
