gefgu/integration-workshop-3/docs/deliverables/d3/software_design_images/UI_typography.png

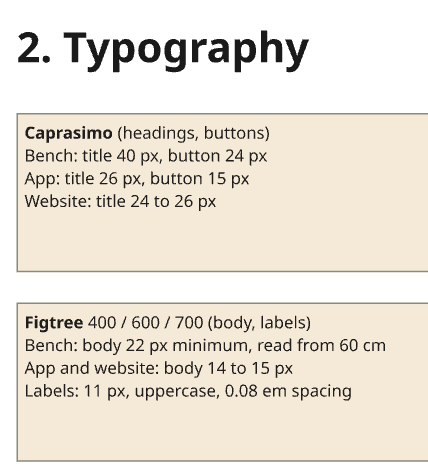
docs/deliverables/d3/software_design_images/UI_typography.png
