gefgu/integration-workshop-3/docs/deliverables/d3/software_design_images/web_screen_2_3_5_6.png

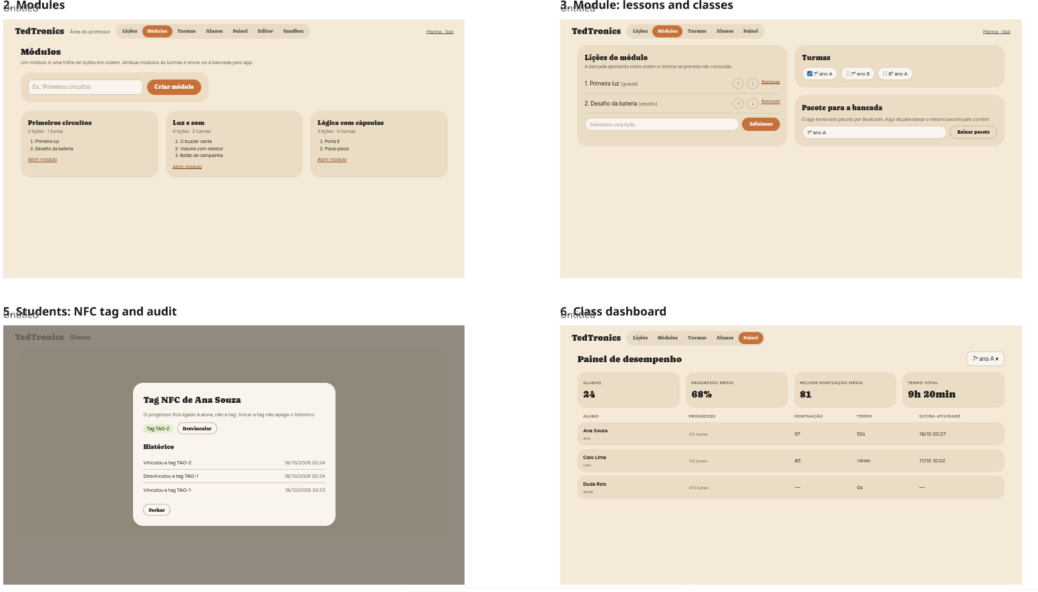
docs/deliverables/d3/software_design_images/web_screen_2_3_5_6.png
