gefgu/integration-workshop-3/docs/deliverables/d3/software_design_images/web_screen_4_5_7_8.png

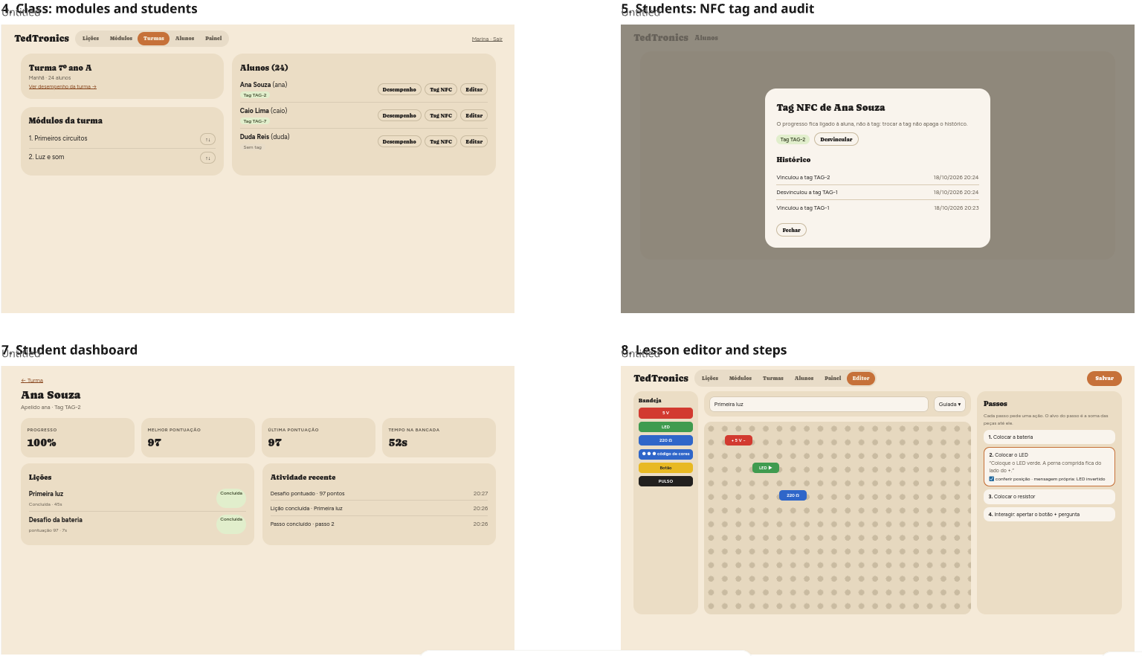
docs/deliverables/d3/software_design_images/web_screen_4_5_7_8.png
