gefgu/integration-workshop-3/docs/deliverables/d4_images/board_perfboard_fits.jpeg

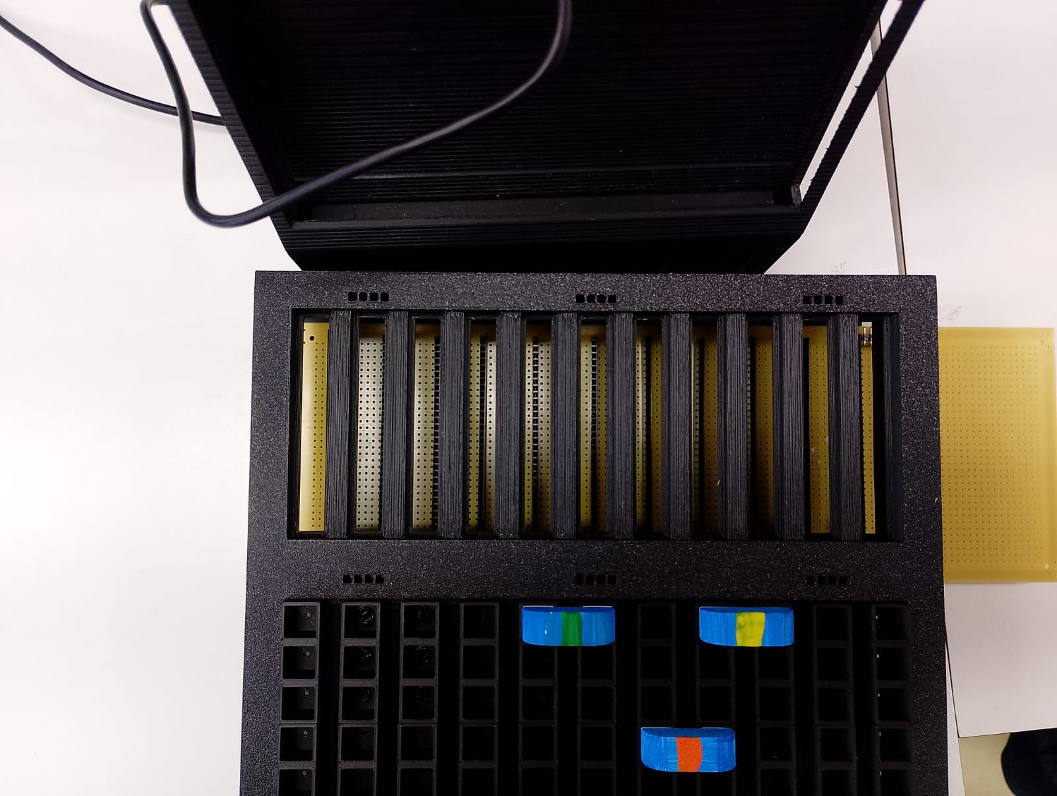
docs/deliverables/d4_images/board_perfboard_fits.jpeg
