gefgu/integration-workshop-3/docs/deliverables/d4_images/board_perfobard_plain.jpeg

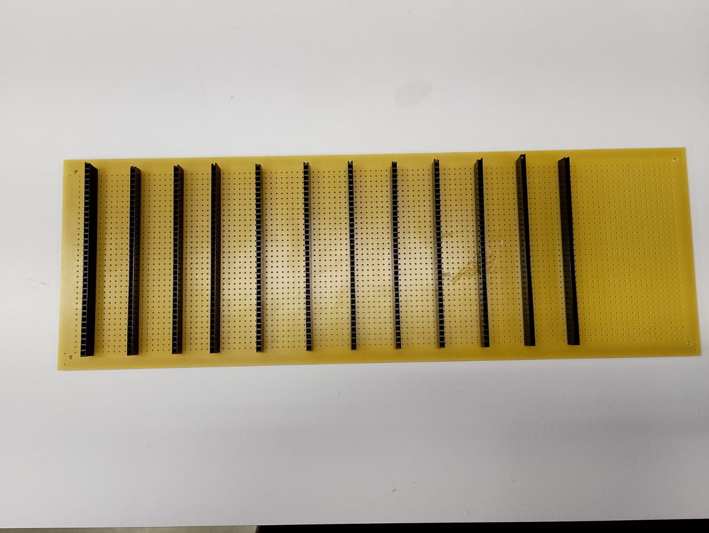
docs/deliverables/d4_images/board_perfobard_plain.jpeg
