gefgu/integration-workshop-3/docs/deliverables/d4_images/board_working_bare.jpeg

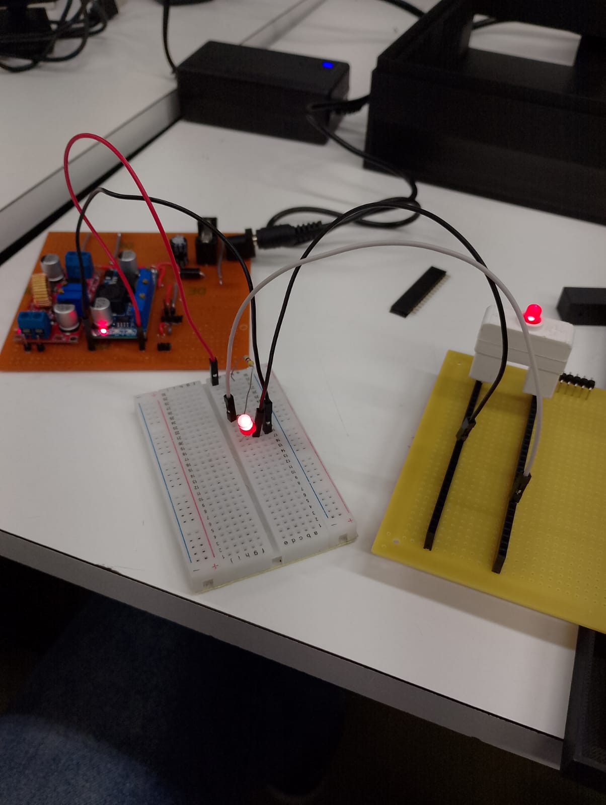
docs/deliverables/d4_images/board_working_bare.jpeg
