gefgu/integration-workshop-3/docs/deliverables/d4_images/camera_working_image.jpeg

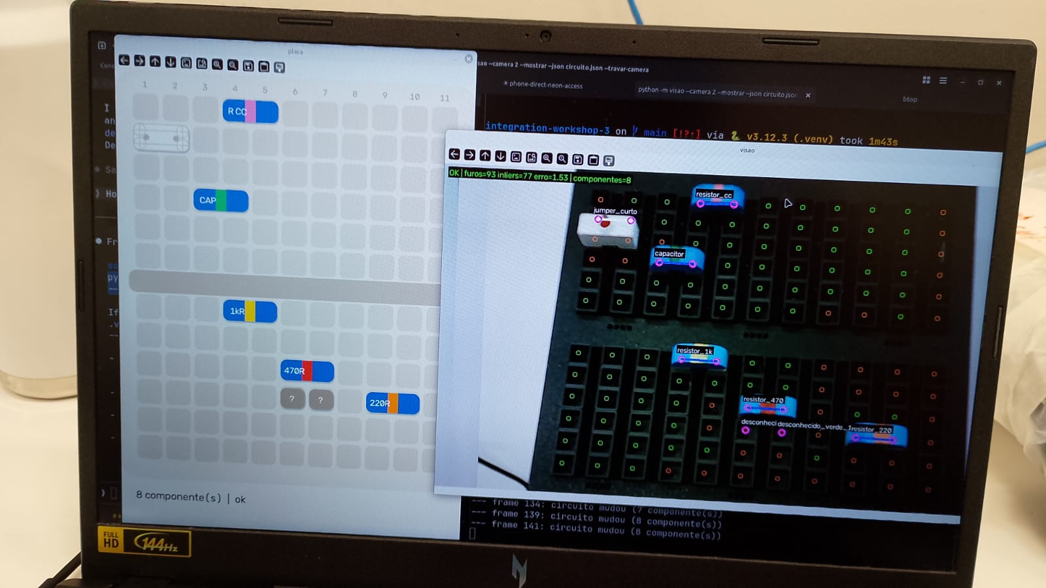
docs/deliverables/d4_images/camera_working_image.jpeg
