gefgu/integration-workshop-3/docs/deliverables/d4_images/mobile_app_class.jpeg

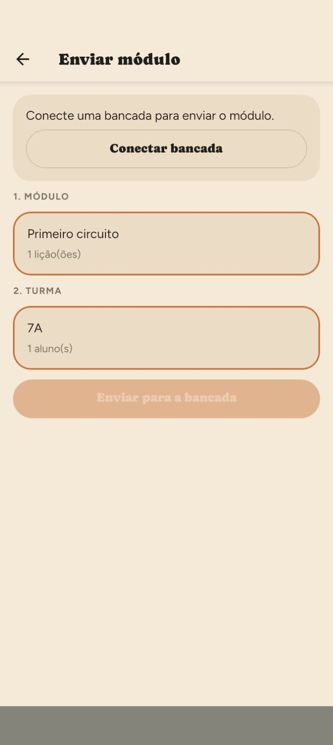
docs/deliverables/d4_images/mobile_app_class.jpeg
