gefgu/integration-workshop-3/docs/modules_plan/images/esquematico_modulo_05_desafio.png

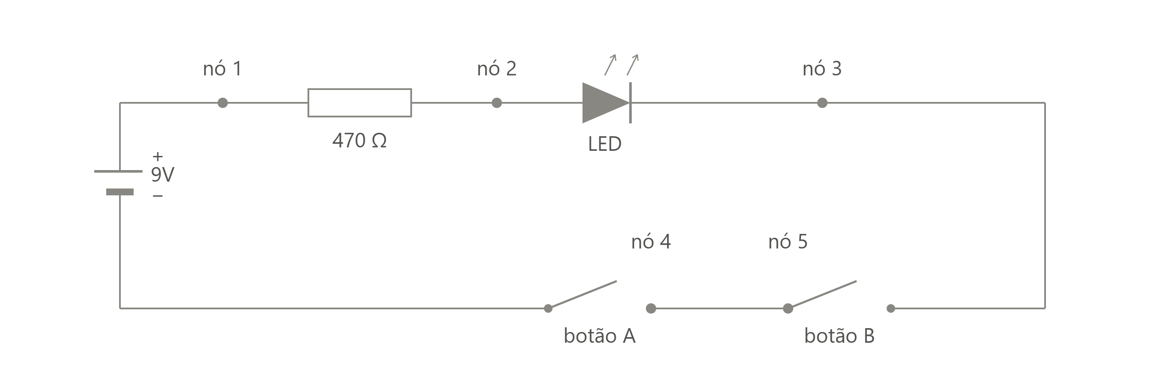
docs/modules_plan/images/esquematico_modulo_05_desafio.png
