gefgu/integration-workshop-3/docs/modules_plan/images/esquematico_modulo_10.png

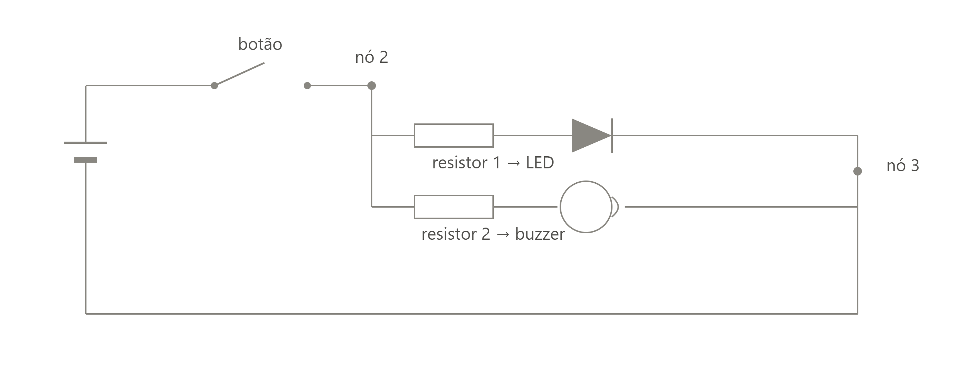
docs/modules_plan/images/esquematico_modulo_10.png
