gefgu/integration-workshop-3/docs/modules_plan/images/image 9.png

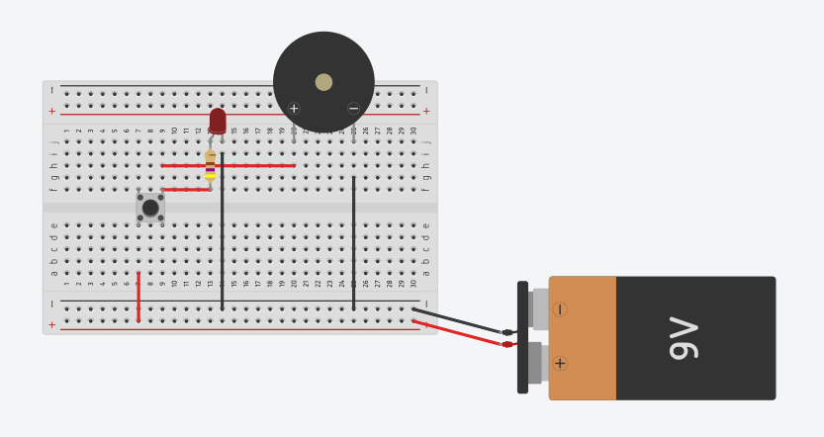
docs/modules_plan/images/image 9.png
