gefgu/integration-workshop-3/eletronics/perfboard/tscircuit/__snapshots__/cp00-first-light.circuit-3d.snap.png

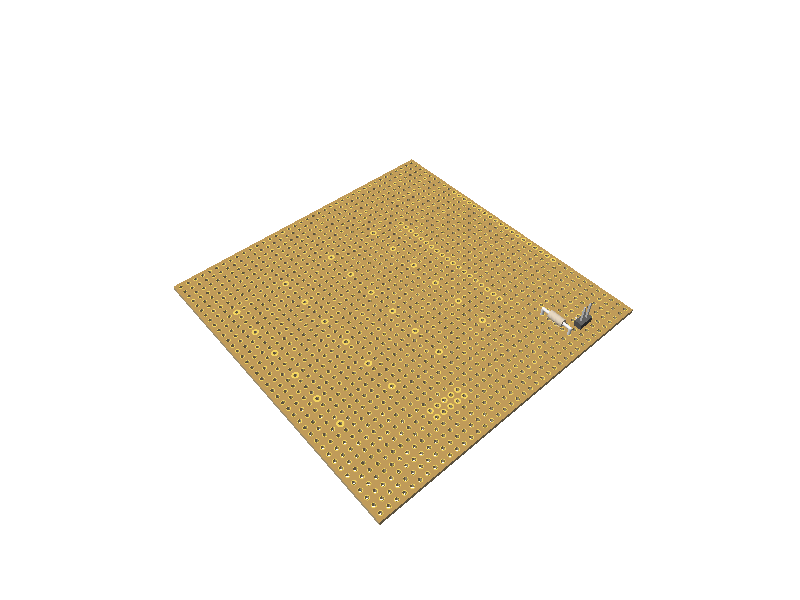
eletronics/perfboard/tscircuit/__snapshots__/cp00-first-light.circuit-3d.snap.png
