gefgu/integration-workshop-3/firmware/esp32/uml/1-state-system.png

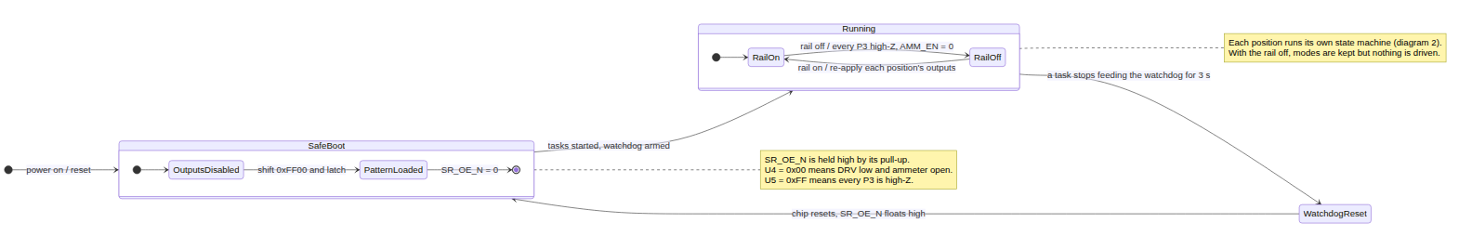
firmware/esp32/uml/1-state-system.png
