gefgu/integration-workshop-3/firmware/esp32/uml/4-seq-set-volt.png

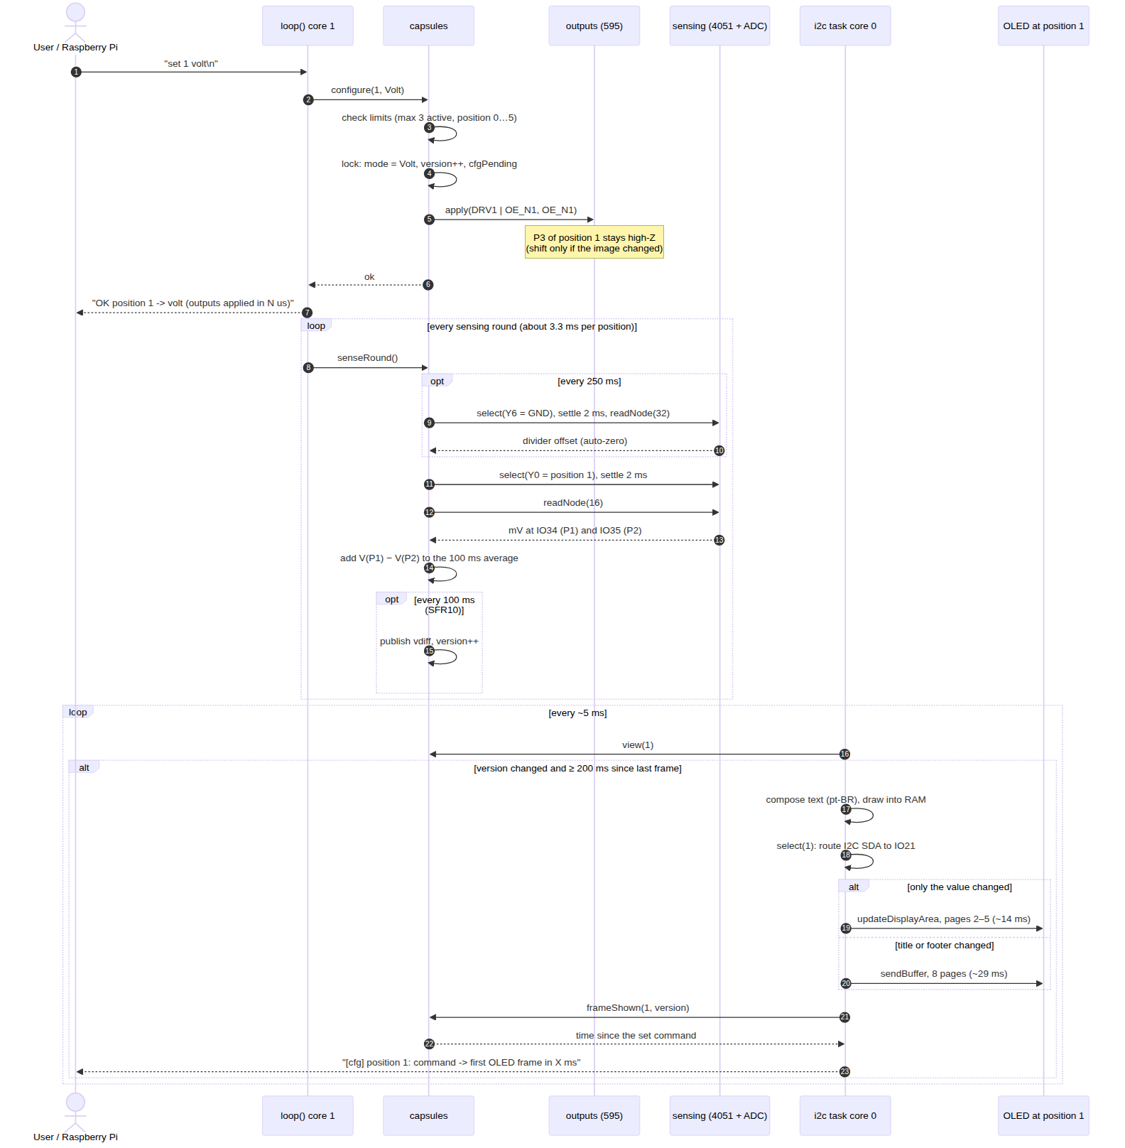
firmware/esp32/uml/4-seq-set-volt.png
