gefgu/integration-workshop-3/firmware/esp32/uml/5-seq-pulse-gate.png

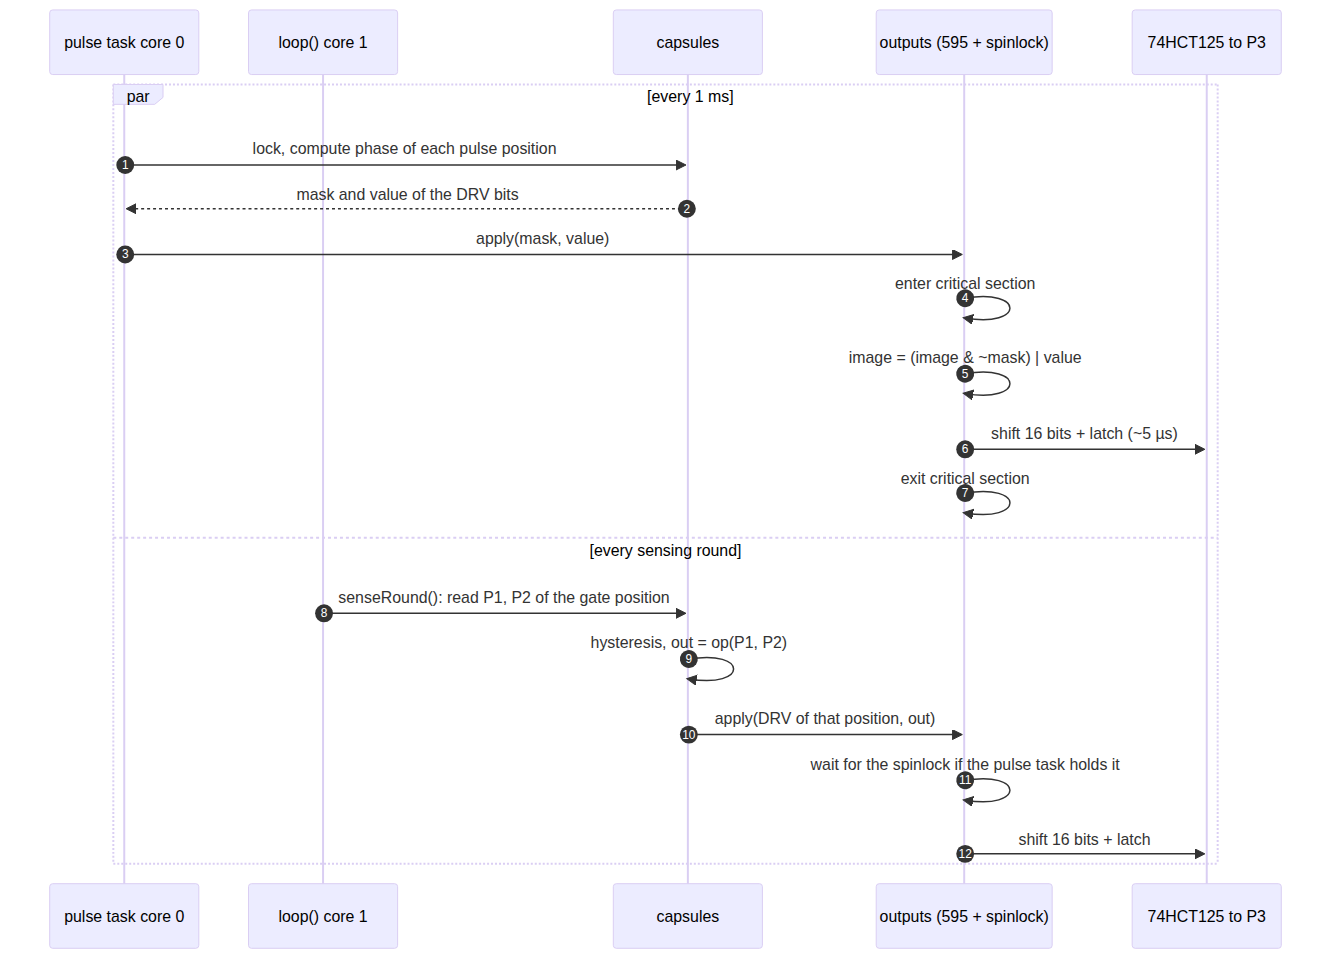
firmware/esp32/uml/5-seq-pulse-gate.png
