gefgu/integration-workshop-3/real_img/foto2.jpg

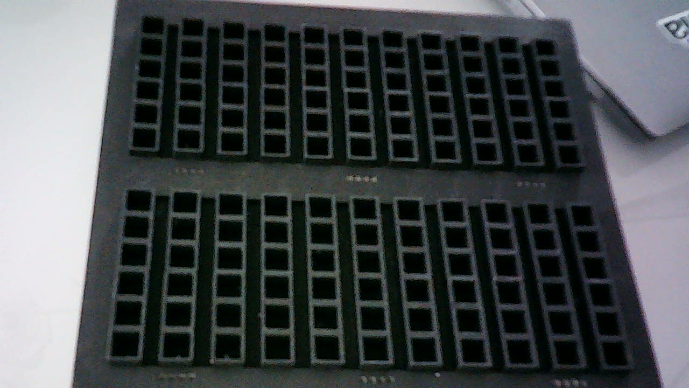
real_img/foto2.jpg
