gefgu/integration-workshop-3/visao/fixtures/current/annotated/frame-01.jpg

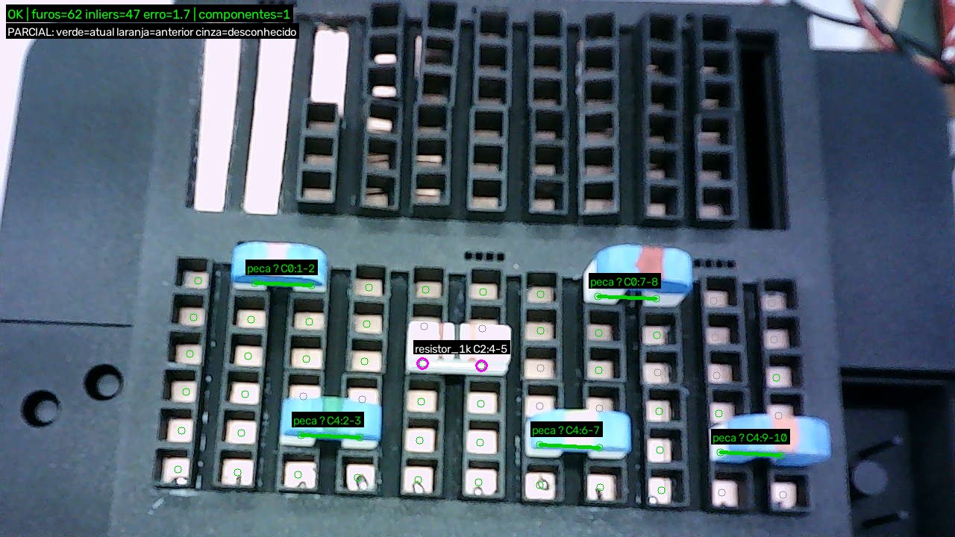
visao/fixtures/current/annotated/frame-01.jpg
