gefgu/integration-workshop-3/visao/fixtures/current/band-crops-2026-11-12/470-frame00.png

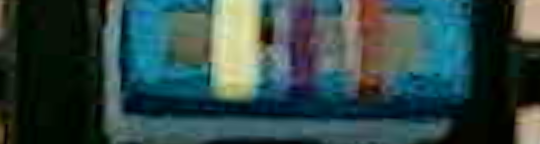
visao/fixtures/current/band-crops-2026-11-12/470-frame00.png
