gefgu/integration-workshop-3/visao/fixtures/current/band-crops-2026-11-12/1000-frame09.png

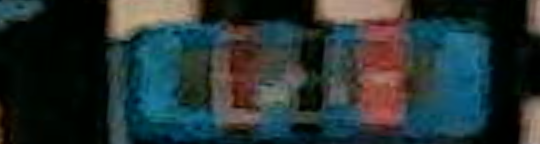
visao/fixtures/current/band-crops-2026-11-12/1000-frame09.png
