gefgu/integration-workshop-3/visao/fixtures/current/bands-2026-11-11-1.jpg

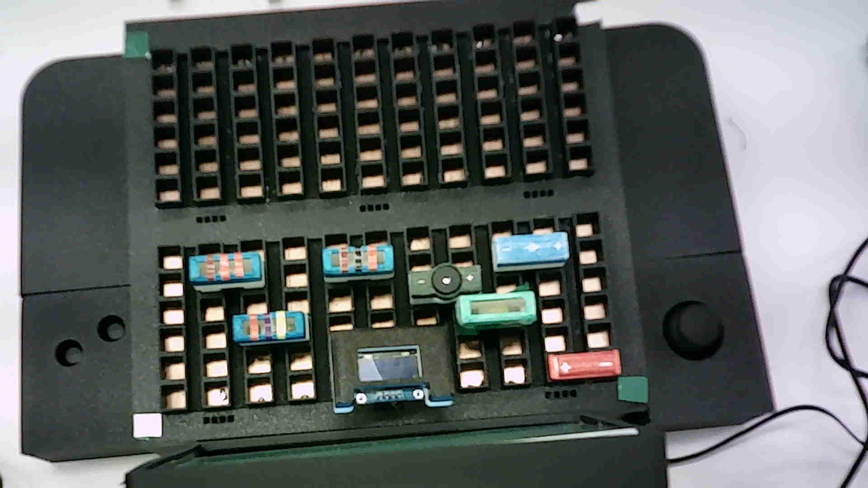
visao/fixtures/current/bands-2026-11-11-1.jpg
