gefgu/integration-workshop-3/visao/fixtures/current/bench-2026-11-11/bands-a-exp600.jpg

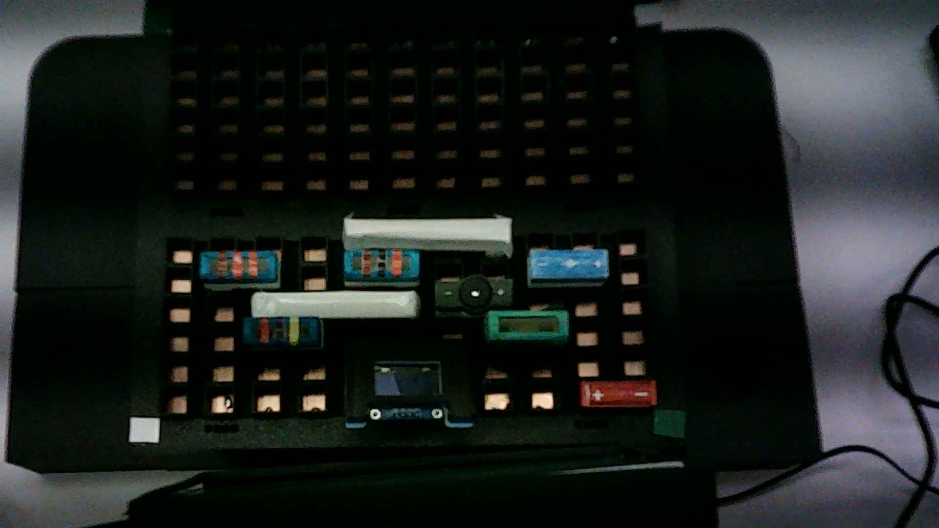
visao/fixtures/current/bench-2026-11-11/bands-a-exp600.jpg
