gefgu/integration-workshop-3/visao/fixtures/current/bench-2026-11-11/bands-a-exp800.jpg

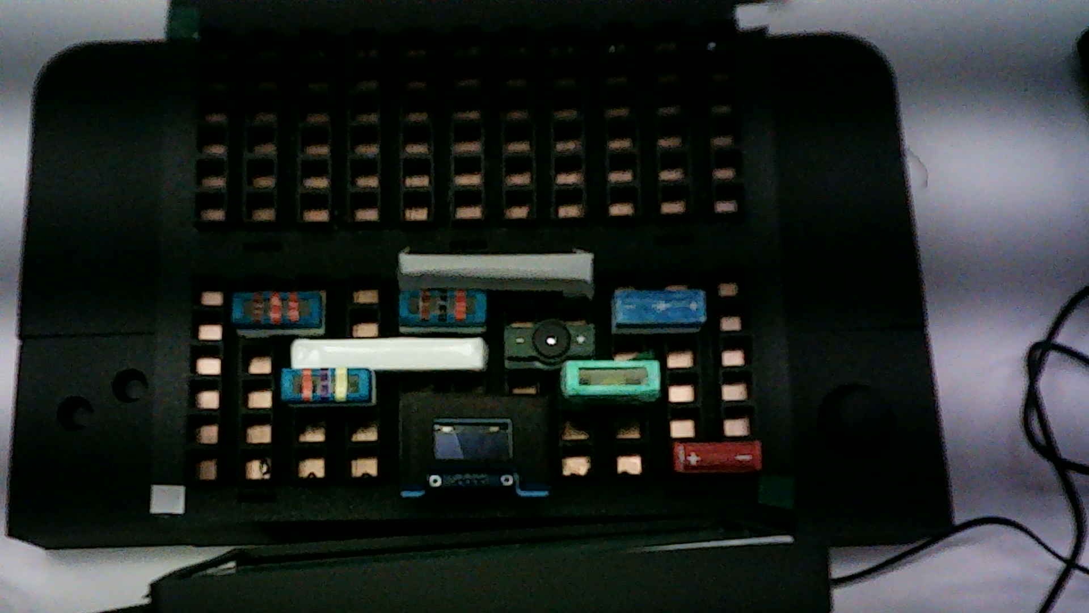
visao/fixtures/current/bench-2026-11-11/bands-a-exp800.jpg
