gefgu/integration-workshop-3/visao/fixtures/current/bench-2026-11-11/normal-1.jpg

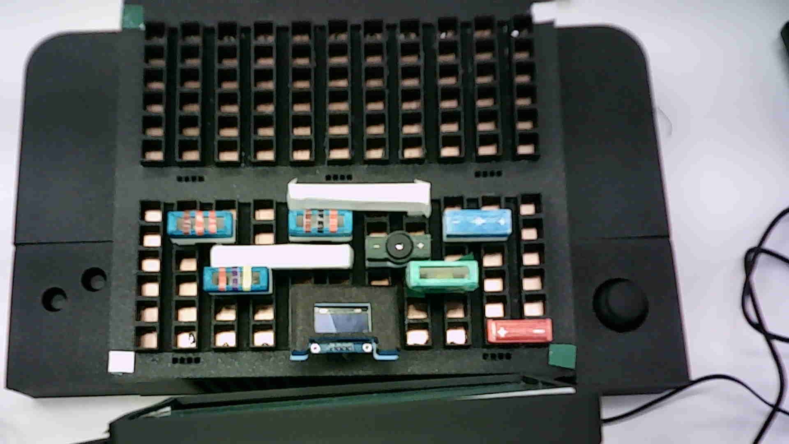
visao/fixtures/current/bench-2026-11-11/normal-1.jpg
