gefgu/integration-workshop-3/visao/fixtures/current/buzzer-2026-11-11.jpg

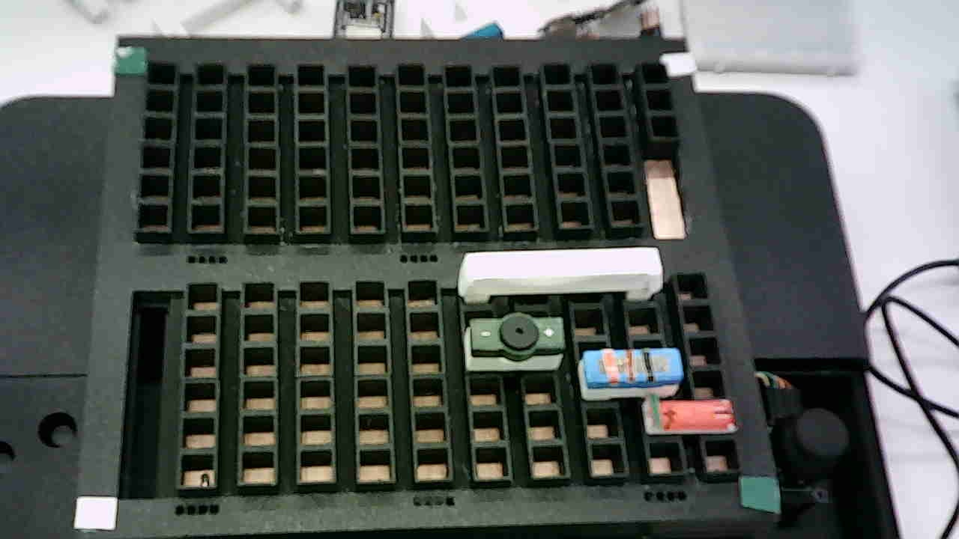
visao/fixtures/current/buzzer-2026-11-11.jpg
