gefgu/integration-workshop-3/visao/fixtures/current/buzzer-smart-2026-11-11.jpg

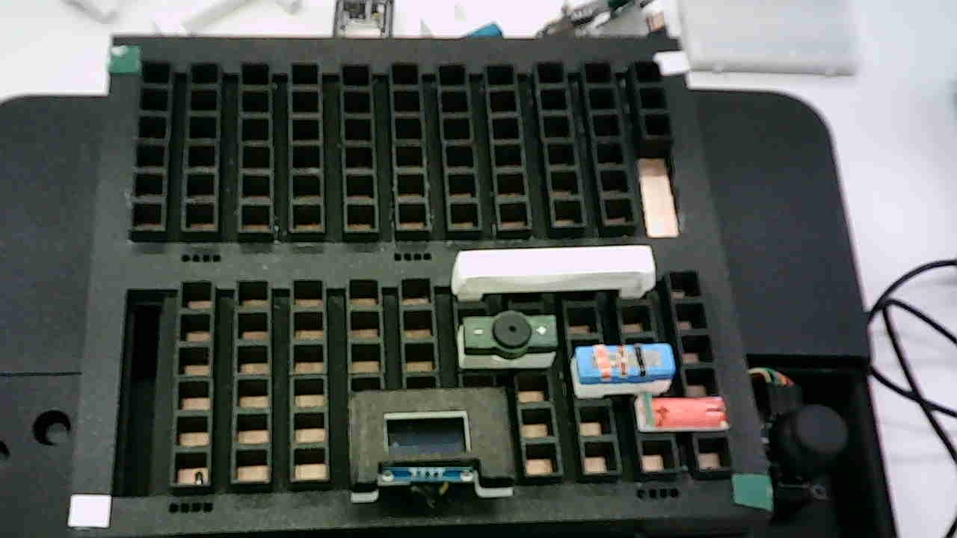
visao/fixtures/current/buzzer-smart-2026-11-11.jpg
