gefgu/integration-workshop-3/visao/fixtures/current/buzzer-smart-frame-2.jpg

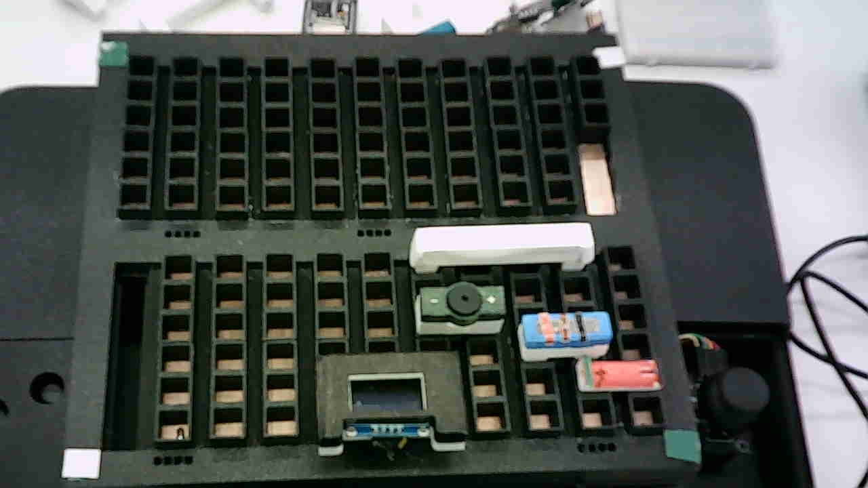
visao/fixtures/current/buzzer-smart-frame-2.jpg
