gefgu/integration-workshop-3/visao/fixtures/current/crowded-cropped-0.jpg

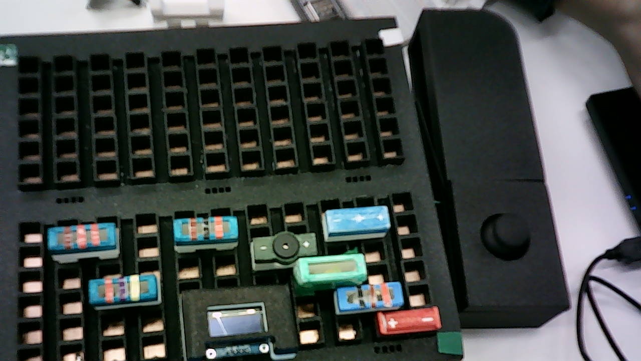
visao/fixtures/current/crowded-cropped-0.jpg
