gefgu/integration-workshop-3/visao/fixtures/current/crowded-cropped-5.jpg

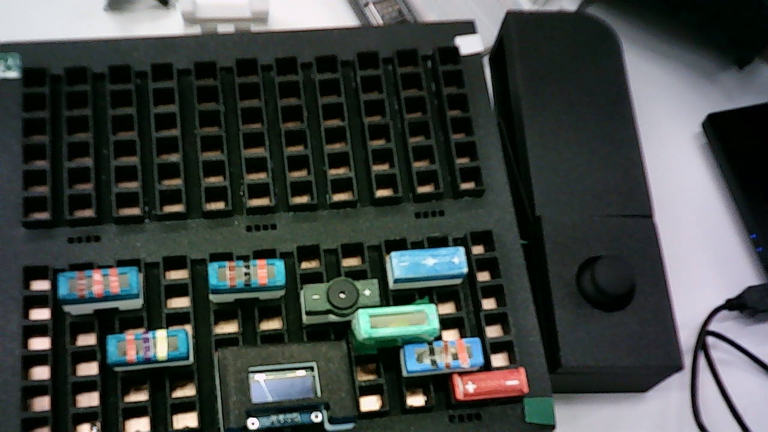
visao/fixtures/current/crowded-cropped-5.jpg
