gefgu/integration-workshop-3/visao/fixtures/current/edge-occluded-0.jpg

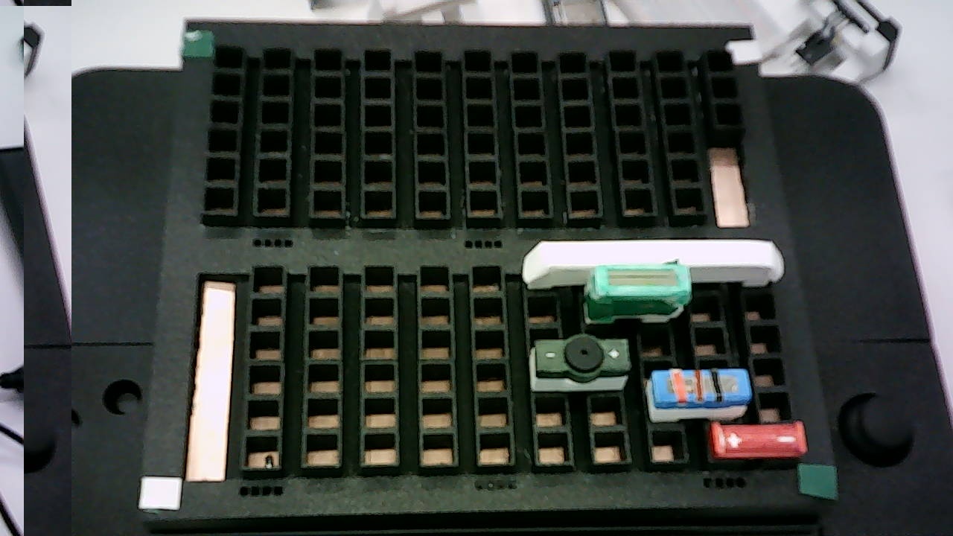
visao/fixtures/current/edge-occluded-0.jpg
