gefgu/integration-workshop-3/visao/fixtures/current/led-buzzer-smart-2026-11-11.jpg

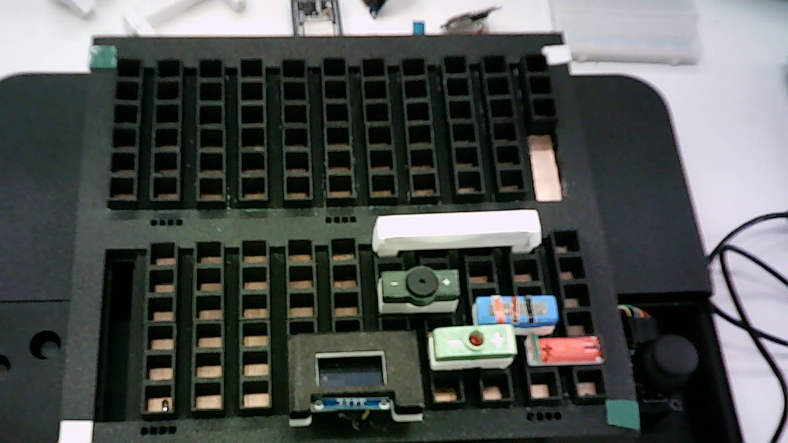
visao/fixtures/current/led-buzzer-smart-2026-11-11.jpg
