gefgu/integration-workshop-3/visao/fixtures/current/lesson-2026-11-12-1k-at-C3-8/frame-00000340.jpg

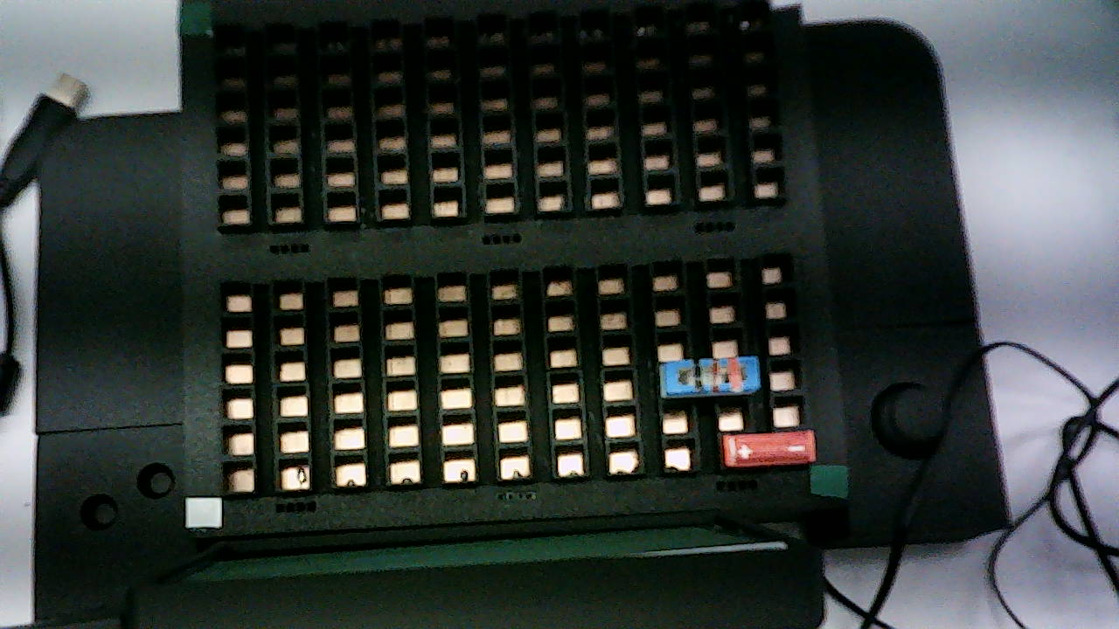
visao/fixtures/current/lesson-2026-11-12-1k-at-C3-8/frame-00000340.jpg
