gefgu/integration-workshop-3/visao/fixtures/current/live-2026-11-09/frame-01.png

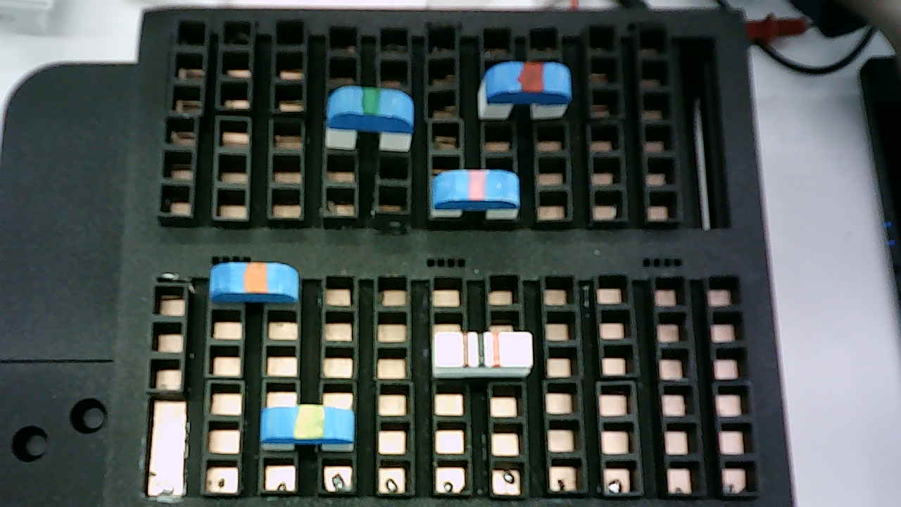
visao/fixtures/current/live-2026-11-09/frame-01.png
