gefgu/integration-workshop-3/visao/fixtures/current/live-2026-11-09/frame-later.png

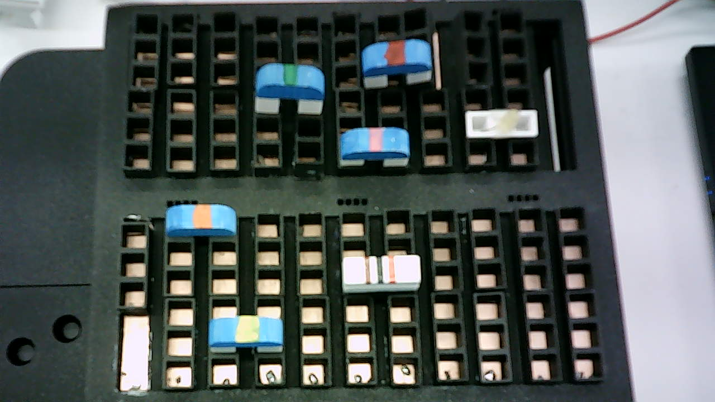
visao/fixtures/current/live-2026-11-09/frame-later.png
