gefgu/integration-workshop-3/visao/fixtures/current/live-2026-11-12/frame-00000000.jpg

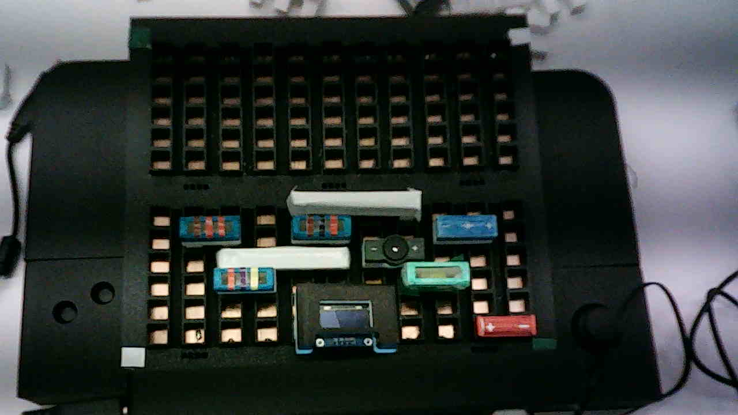
visao/fixtures/current/live-2026-11-12/frame-00000000.jpg
