gefgu/integration-workshop-3/visao/fixtures/current/live-2026-11-12/frame-00000089.jpg

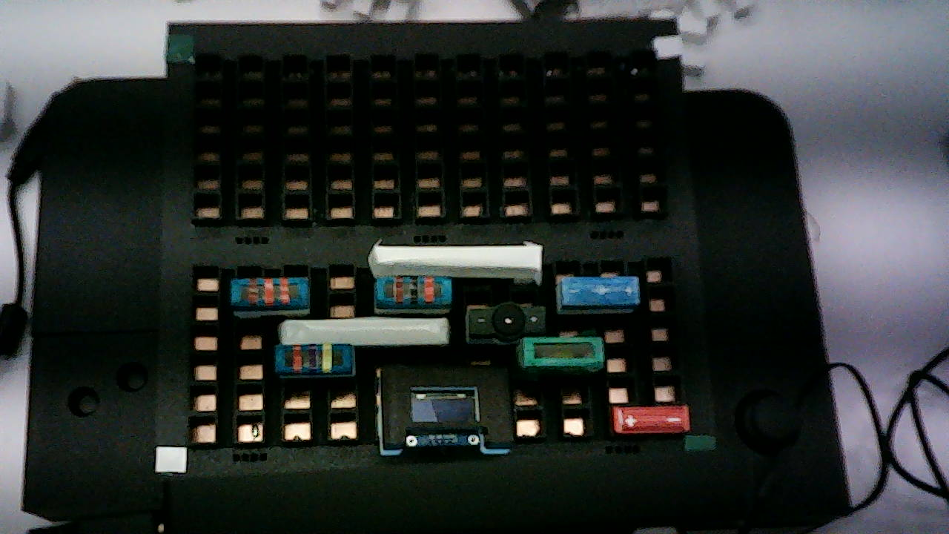
visao/fixtures/current/live-2026-11-12/frame-00000089.jpg
