gefgu/integration-workshop-3/visao/fixtures/current/live-2026-11-12/sweep/exp1000-0.jpg

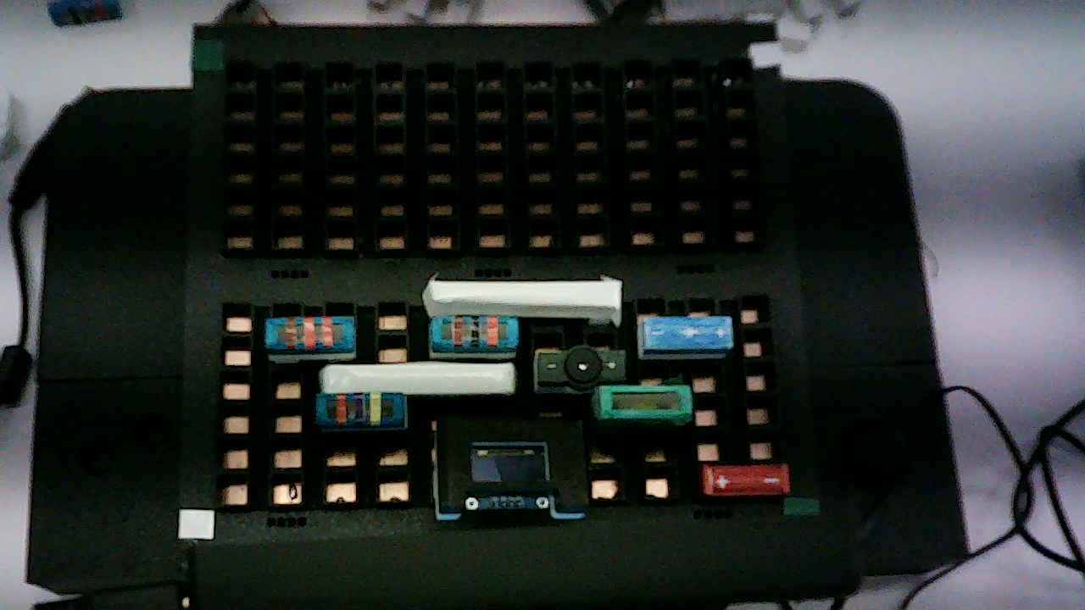
visao/fixtures/current/live-2026-11-12/sweep/exp1000-0.jpg
