gefgu/integration-workshop-3/visao/fixtures/current/live-2026-11-12/sweep/exp1900-2.jpg

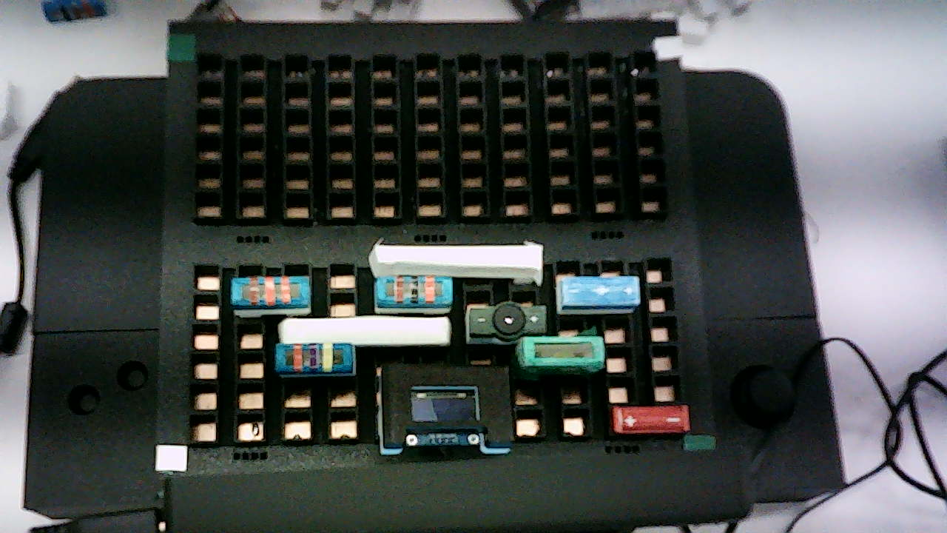
visao/fixtures/current/live-2026-11-12/sweep/exp1900-2.jpg
