gefgu/integration-workshop-3/visao/fixtures/current/live-2026-11-12/sweep/exp3400-1.jpg

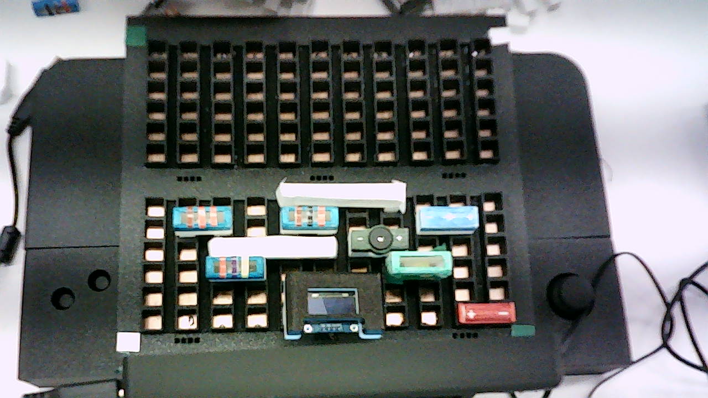
visao/fixtures/current/live-2026-11-12/sweep/exp3400-1.jpg
