gefgu/integration-workshop-3/visao/fixtures/current/marked-bright-strip-2026-11-11.jpg

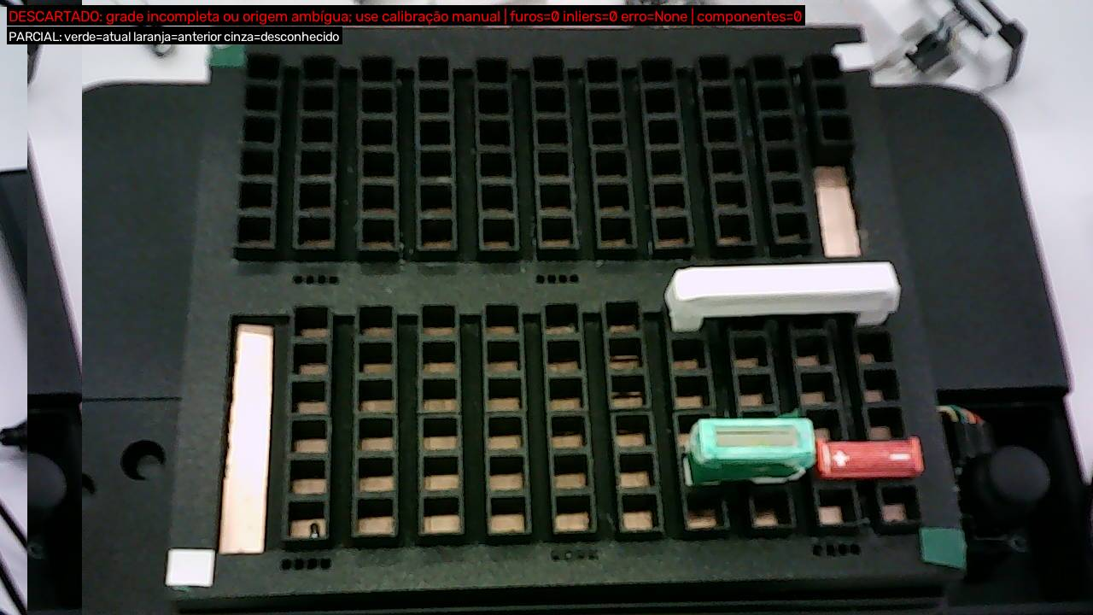
visao/fixtures/current/marked-bright-strip-2026-11-11.jpg
