gefgu/integration-workshop-3/visao/fixtures/current/marked-empty-2026-11-11.jpg

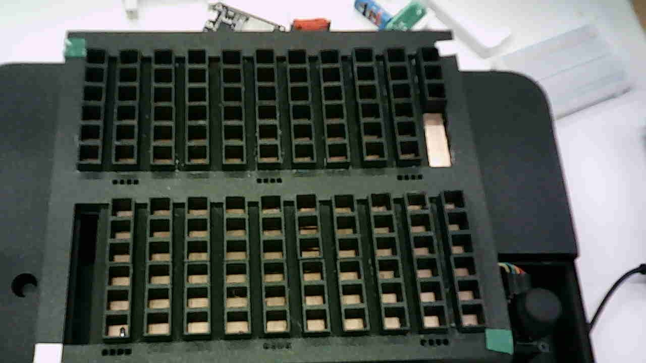
visao/fixtures/current/marked-empty-2026-11-11.jpg
