gefgu/integration-workshop-3/visao/fixtures/current/reference-completed.jpg

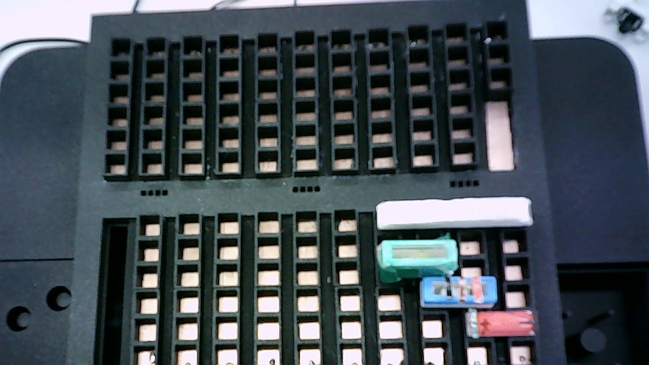
visao/fixtures/current/reference-completed.jpg
