gefgu/integration-workshop-3/visao/images/img_iluminada.jpeg

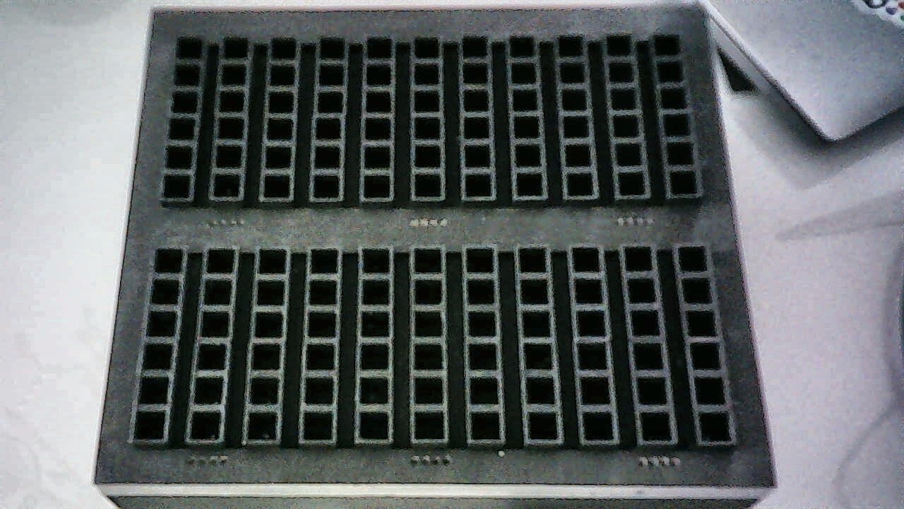
visao/images/img_iluminada.jpeg
