gefgu/integration-workshop-3/eletronics/perfboard/tscircuit/smart-perfboard/simplified-final/bom.csv

Ref | Value | MPN | Section | Tolerance | Notes
J_ESP_L |  | 61201021621 | Existing |  | Generic body envelope; actual fit pending
J_ESP_R |  | 61201021621 | Existing |  | Generic body envelope; actual fit pending
J_POWER |  | 61201021621 | Existing |  | Generic body envelope; actual fit pending
JP_EXT |  | 61201021621 | Existing |  | Generic body envelope; actual fit pending
J_UART |  | 61201021621 | Existing |  | Generic body envelope; actual fit pending
J_JOY |  | 61201021621 | Existing |  | Generic body envelope; actual fit pending
J_OLED0 |  | 61201021621 | Existing |  | Generic body envelope; actual fit pending
J_OLED1 |  | 61201021621 | Existing |  | Generic body envelope; actual fit pending
J_OLED2 |  | 61201021621 | Existing |  | Generic body envelope; actual fit pending
J_OLED3 |  | 61201021621 | Existing |  | Generic body envelope; actual fit pending
J_OLED4 |  | 61201021621 | Existing |  | Generic body envelope; actual fit pending
J_OLED5 |  | 61201021621 | Existing |  | Generic body envelope; actual fit pending
C_BULK | 47uF | 47UF-RADIAL-VERIFY | Existing |  | Generic body envelope; actual fit pending
C_LOCAL | 100nF | 100NF-RADIAL-VERIFY | Existing |  | Generic body envelope; actual fit pending
J_ROUTER | 4 pinos | 61201021621 | Router |  | Generic body envelope; actual fit pending
J_NFC | 7 pinos | 61201021621 | NFC |  | Generic body envelope; actual fit pending
R_A_TOP | 10k | RES-10k-VERIFY | Voltage | 1% | Generic body envelope; actual fit pending
R_A_BOT | 10k | RES-10k-VERIFY | Voltage | 1% | Generic body envelope; actual fit pending
R_A_ADC | 1k | RES-1k-VERIFY | Voltage | 1% | Generic body envelope; actual fit pending
C_A_ADC | 100nF | 100NF-RADIAL-VERIFY | Voltage |  | Generic body envelope; actual fit pending
R_B_TOP | 10k | RES-10k-VERIFY | Voltage | 1% | Generic body envelope; actual fit pending
R_B_BOT | 10k | RES-10k-VERIFY | Voltage | 1% | Generic body envelope; actual fit pending
R_B_ADC | 1k | RES-1k-VERIFY | Voltage | 1% | Generic body envelope; actual fit pending
C_B_ADC | 100nF | 100NF-RADIAL-VERIFY | Voltage |  | Generic body envelope; actual fit pending
