gefgu/integration-workshop-3/eletronics/perfboard/tscircuit/smart-perfboard/final/bom.csv

Ref | Value | MPN | Section | Tolerance | Notes
J_CTRL | 10 pins | 61201021621 | Interfaces |  | Generic body envelope; actual fit pending
J_POWER | 4 pins | 61201021621 | Interfaces |  | Generic body envelope; actual fit pending
J_ROUTER | 7 pins | 61201021621 | Interfaces |  | Generic body envelope; actual fit pending
R_BIAS_TOP | 5.62k | MFR-25FBF52-5.62k | Voltage | 1% | Generic body envelope; actual fit pending
R_BIAS_BOT | 1k | MFR-25FBF52-1k | Voltage | 1% | Generic body envelope; actual fit pending
C_BIAS | 100nF | RADIAL-100nF | Voltage |  | Generic body envelope; actual fit pending
R_A_TOP | 1M | MFR-25FBF52-1M | Voltage | 0.1% | Generic body envelope; actual fit pending
R_A_BOT | 1M | MFR-25FBF52-1M | Voltage | 0.1% | Generic body envelope; actual fit pending
C_A_DIV | 1nF | RADIAL-1nF | Voltage |  | Generic body envelope; actual fit pending
R_A_ADC | 1k | MFR-25FBF52-1k | Voltage | 1% | Generic body envelope; actual fit pending
C_A_ADC | 10nF | RADIAL-10nF | Voltage |  | Generic body envelope; actual fit pending
R_B_TOP | 1M | MFR-25FBF52-1M | Voltage | 0.1% | Generic body envelope; actual fit pending
R_B_BOT | 1M | MFR-25FBF52-1M | Voltage | 0.1% | Generic body envelope; actual fit pending
C_B_DIV | 1nF | RADIAL-1nF | Voltage |  | Generic body envelope; actual fit pending
R_B_ADC | 1k | MFR-25FBF52-1k | Voltage | 1% | Generic body envelope; actual fit pending
C_B_ADC | 10nF | RADIAL-10nF | Voltage |  | Generic body envelope; actual fit pending
U_BUF | MCP6002-I/P | MCP6002-I/P | Voltage |  | Generic body envelope; actual fit pending
C_BUF | 100nF | RADIAL-100nF | Voltage |  | Generic body envelope; actual fit pending
U_WATCH | CD74HC123E | CD74HC123E | Watchdog |  | Generic body envelope; actual fit pending
R_WATCH | 680k | MFR-25FBF52-680k | Watchdog | 1% | Generic body envelope; actual fit pending
C_WATCH | 1uF | RADIAL-1uF | Watchdog |  | Generic body envelope; actual fit pending
C_WATCH_VCC | 100nF | RADIAL-100nF | Watchdog |  | Generic body envelope; actual fit pending
R_PD_ARM | 100k | MFR-25FBF52-100k | Watchdog | 1% | Generic body envelope; actual fit pending
R_PD_HB | 100k | MFR-25FBF52-100k | Watchdog | 1% | Generic body envelope; actual fit pending
R_PD_MODE_A | 100k | MFR-25FBF52-100k | Watchdog | 1% | Generic body envelope; actual fit pending
R_PD_MODE_B | 100k | MFR-25FBF52-100k | Watchdog | 1% | Generic body envelope; actual fit pending
R_PD_MODE_C | 100k | MFR-25FBF52-100k | Watchdog | 1% | Generic body envelope; actual fit pending
R_PD_EDU_ON | 100k | MFR-25FBF52-100k | Watchdog | 1% | Generic body envelope; actual fit pending
R_PD_EDU_OFF_OK | 100k | MFR-25FBF52-100k | Watchdog | 1% | Generic body envelope; actual fit pending
U_MODE | CD74HC238E | CD74HC238E | Mode |  | Generic body envelope; actual fit pending
C_MODE | 100nF | RADIAL-100nF | Mode |  | Generic body envelope; actual fit pending
U_GATE | CD74HC08E | CD74HC08E | Mode |  | Generic body envelope; actual fit pending
C_GATE | 100nF | RADIAL-100nF | Mode |  | Generic body envelope; actual fit pending
R_REF_H_TOP | 1k | MFR-25FBF52-1k | Limits | 1% | Generic body envelope; actual fit pending
R_REF_H_BOT | 49.9k | MFR-25FBF52-49.9k | Limits | 1% | Generic body envelope; actual fit pending
R_REF_L_TOP | 49.9k | MFR-25FBF52-49.9k | Limits | 1% | Generic body envelope; actual fit pending
R_REF_L_BOT | 1k | MFR-25FBF52-1k | Limits | 1% | Generic body envelope; actual fit pending
C_REF_H | 100nF | RADIAL-100nF | Limits |  | Generic body envelope; actual fit pending
C_REF_L | 100nF | RADIAL-100nF | Limits |  | Generic body envelope; actual fit pending
R_H_SENSE | 10 | MFR-25FBF52-10 | Limits | 1% | Generic body envelope; actual fit pending
R_L_SENSE | 10 | MFR-25FBF52-10 | Limits | 1% | Generic body envelope; actual fit pending
R_IN_H_N | 47k | MFR-25FBF52-47k | Limits | 1% | Generic body envelope; actual fit pending
R_IN_H_P | 47k | MFR-25FBF52-47k | Limits | 1% | Generic body envelope; actual fit pending
R_IN_L_P | 47k | MFR-25FBF52-47k | Limits | 1% | Generic body envelope; actual fit pending
R_IN_L_N | 47k | MFR-25FBF52-47k | Limits | 1% | Generic body envelope; actual fit pending
U_LIMIT | MCP6002-I/P | MCP6002-I/P | Limits |  | Generic body envelope; actual fit pending
C_LIMIT | 100nF | RADIAL-100nF | Limits |  | Generic body envelope; actual fit pending
R_H_GATE | 1k | MFR-25FBF52-1k | Limits | 1% | Generic body envelope; actual fit pending
R_L_GATE | 1k | MFR-25FBF52-1k | Limits | 1% | Generic body envelope; actual fit pending
R_H_OFF | 100k | MFR-25FBF52-100k | Limits | 1% | Generic body envelope; actual fit pending
R_L_OFF | 100k | MFR-25FBF52-100k | Limits | 1% | Generic body envelope; actual fit pending
C_H_COMP | 1nF | RADIAL-1nF | Limits |  | Generic body envelope; actual fit pending
C_L_COMP | 1nF | RADIAL-1nF | Limits |  | Generic body envelope; actual fit pending
Q_H_ADAPTER | BSS84 on D-S-G adapter | BSS84 | Limits |  | SOT23-to-3-pin adapter, verify actual mapping; body not measured
Q_LOW | 2N7000 on D-S-G adapter | 2N7000 | Limits |  | Generic body envelope; actual fit pending
U_SSR_HIGH | AQY212EH | AQY212EH | Pulse |  | Generic body envelope; actual fit pending
R_U_SSR_HIGH_LED | 270 | MFR-25FBF52-270 | Pulse | 1% | Generic body envelope; actual fit pending
R_U_SSR_HIGH_BASE | 4.7k | MFR-25FBF52-4.7k | Pulse | 1% | Generic body envelope; actual fit pending
R_U_SSR_HIGH_OFF | 100k | MFR-25FBF52-100k | Pulse | 1% | Generic body envelope; actual fit pending
Q_U_SSR_HIGH | BC548B | BC548B | Pulse |  | Generic body envelope; actual fit pending
U_SSR_LOW | AQY212EH | AQY212EH | Pulse |  | Generic body envelope; actual fit pending
R_U_SSR_LOW_LED | 270 | MFR-25FBF52-270 | Pulse | 1% | Generic body envelope; actual fit pending
R_U_SSR_LOW_BASE | 4.7k | MFR-25FBF52-4.7k | Pulse | 1% | Generic body envelope; actual fit pending
R_U_SSR_LOW_OFF | 100k | MFR-25FBF52-100k | Pulse | 1% | Generic body envelope; actual fit pending
Q_U_SSR_LOW | BC548B | BC548B | Pulse |  | Generic body envelope; actual fit pending
D_STIM | 1N4148 | 1N4148 | Diagnostic |  | Generic body envelope; actual fit pending
R_STIM | 11k | MFR-25FBF52-11k | Diagnostic | 1% | Generic body envelope; actual fit pending
U_SSR_STIM | AQY212EH | AQY212EH | Diagnostic |  | Generic body envelope; actual fit pending
R_U_SSR_STIM_LED | 270 | MFR-25FBF52-270 | Diagnostic | 1% | Generic body envelope; actual fit pending
R_U_SSR_STIM_BASE | 4.7k | MFR-25FBF52-4.7k | Diagnostic | 1% | Generic body envelope; actual fit pending
R_U_SSR_STIM_OFF | 100k | MFR-25FBF52-100k | Diagnostic | 1% | Generic body envelope; actual fit pending
Q_U_SSR_STIM | BC548B | BC548B | Diagnostic |  | Generic body envelope; actual fit pending
U_SSR_RETURN | AQY212EH | AQY212EH | Diagnostic |  | Generic body envelope; actual fit pending
R_U_SSR_RETURN_LED | 270 | MFR-25FBF52-270 | Diagnostic | 1% | Generic body envelope; actual fit pending
R_U_SSR_RETURN_BASE | 4.7k | MFR-25FBF52-4.7k | Diagnostic | 1% | Generic body envelope; actual fit pending
R_U_SSR_RETURN_OFF | 100k | MFR-25FBF52-100k | Diagnostic | 1% | Generic body envelope; actual fit pending
Q_U_SSR_RETURN | BC548B | BC548B | Diagnostic |  | Generic body envelope; actual fit pending
