gefgu/integration-workshop-3/eletronics/perfboard/tscircuit/routing-next/guia-perfboard/experimento-percursos/crossings.csv

ID | Tipo | Por_baixo | Por_cima | Coordenadas_TOP | Acao
X001 | crossing | W027 | W041 | C13/R40 | Manter isolado; não soldar no cruzamento
X002 | crossing | W022 | W043 | C19.25/R40 | Manter isolado; não soldar no cruzamento
X003 | crossing | W002 | W050 | C17.75/R7 | Manter isolado; não soldar no cruzamento
X004 | crossing | W052 | W015 | C24.625/R48.125 | Manter isolado; não soldar no cruzamento
X005 | crossing | W052 | W022 | C20/R40 | Manter isolado; não soldar no cruzamento
X006 | crossing | W052 | W043 | C25.25/R32 | Manter isolado; não soldar no cruzamento
X007 | crossing | W052 | W046 | C26/R32 | Manter isolado; não soldar no cruzamento
X008 | crossing | W053 | W014 | C31/R45 | Manter isolado; não soldar no cruzamento
X009 | crossing | W013 | W054 | C23/R42 | Manter isolado; não soldar no cruzamento
X010 | crossing | W041 | W054 | C15/R42 | Manter isolado; não soldar no cruzamento
X011 | crossing | W043 | W054 | C19.25/R42 | Manter isolado; não soldar no cruzamento
X012 | crossing | W055 | W034 | C9.75/R43 | Manter isolado; não soldar no cruzamento
X013 | crossing | W030 | W056 | C5/R32 | Manter isolado; não soldar no cruzamento
X014 | crossing | W040 | W056 | C3/R32.25 | Manter isolado; não soldar no cruzamento
X015 | crossing | W015 | W057 | C24.75/R49.5 | Manter isolado; não soldar no cruzamento
X016 | crossing | W034 | W057 | C9.75/R46 | Manter isolado; não soldar no cruzamento
X017 | crossing | W057 | W048 | C15/R49 | Manter isolado; não soldar no cruzamento
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
X680 | crossing | W104 | W150 | C10.25/R53.5 | Manter isolado; não soldar no cruzamento
X681 | crossing | W105 | W150 | C10.25/R54.5 | Manter isolado; não soldar no cruzamento
X682 | crossing | W106 | W150 | C8.75/R59.25 | Manter isolado; não soldar no cruzamento
X683 | crossing | W107 | W150 | C8.75/R64.5 | Manter isolado; não soldar no cruzamento
X684 | crossing | W137 | W150 | C9.5/R56.25 | Manter isolado; não soldar no cruzamento
X685 | crossing | W146 | W150 | C8.75/R64.75 | Manter isolado; não soldar no cruzamento
P001 | parallel overlap | W062 | W060 | C5/R35.25 → C5/R35.75 | Manter isolado; não soldar no cruzamento
P002 | parallel overlap | W062 | W060 | C4.25/R39.5 → C4.25/R42 | Manter isolado; não soldar no cruzamento
P003 | parallel overlap | W102 | W058 | C1/R47.25 → C1/R60.75 | Manter isolado; não soldar no cruzamento
P004 | parallel overlap | W104 | W060 | C4.25/R47.5 → C4.25/R44 | Manter isolado; não soldar no cruzamento
P005 | parallel overlap | W106 | W060 | C4.25/R65 → C5/R65.75 | Manter isolado; não soldar no cruzamento
P006 | parallel overlap | W106 | W060 | C5/R65.75 → C6.5/R65.75 | Manter isolado; não soldar no cruzamento
P007 | parallel overlap | W114 | W079 | C33.75/R50 → C33.75/R52 | Manter isolado; não soldar no cruzamento
P008 | parallel overlap | W118 | W079 | C33.75/R53.5 → C33.75/R56 | Manter isolado; não soldar no cruzamento
P009 | parallel overlap | W116 | W119 | C37/R53.25 → C37/R57.75 | Manter isolado; não soldar no cruzamento
P010 | parallel overlap | W120 | W079 | C34/R65 → C34/R66 | Manter isolado; não soldar no cruzamento
P011 | parallel overlap | W120 | W079 | C34/R66 → C33.5/R66.5 | Manter isolado; não soldar no cruzamento
