gefgu/integration-workshop-3/docs/deliverables/d3/eletronic_images/voltmeter_proto_test_for_smart_components.jpeg

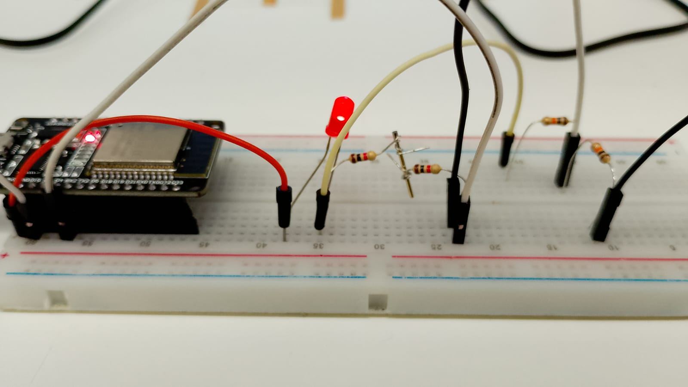
docs/deliverables/d3/eletronic_images/voltmeter_proto_test_for_smart_components.jpeg
