gefgu/integration-workshop-3/docs/deliverables/d3/mechanic_images/components_sideview_on_the_board.jpeg

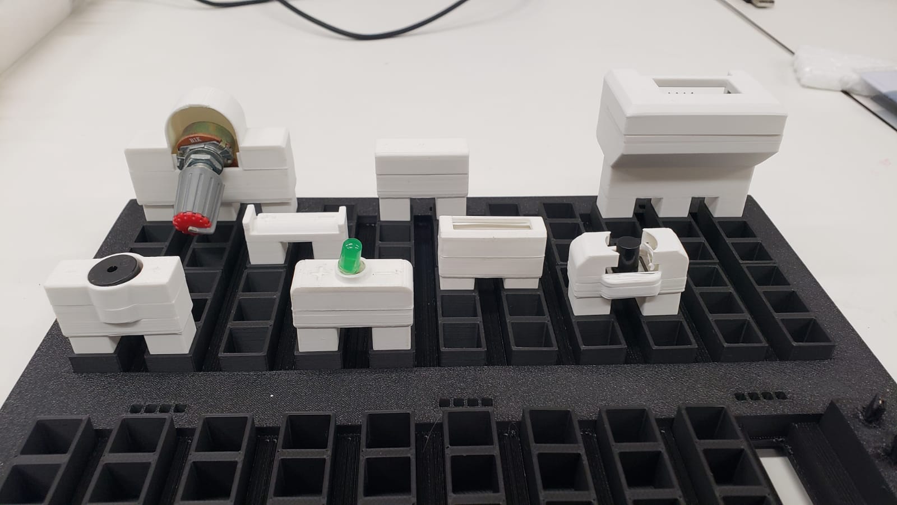
docs/deliverables/d3/mechanic_images/components_sideview_on_the_board.jpeg
