gefgu/integration-workshop-3/docs/deliverables/d4_images/board_of_componentes_working.jpeg

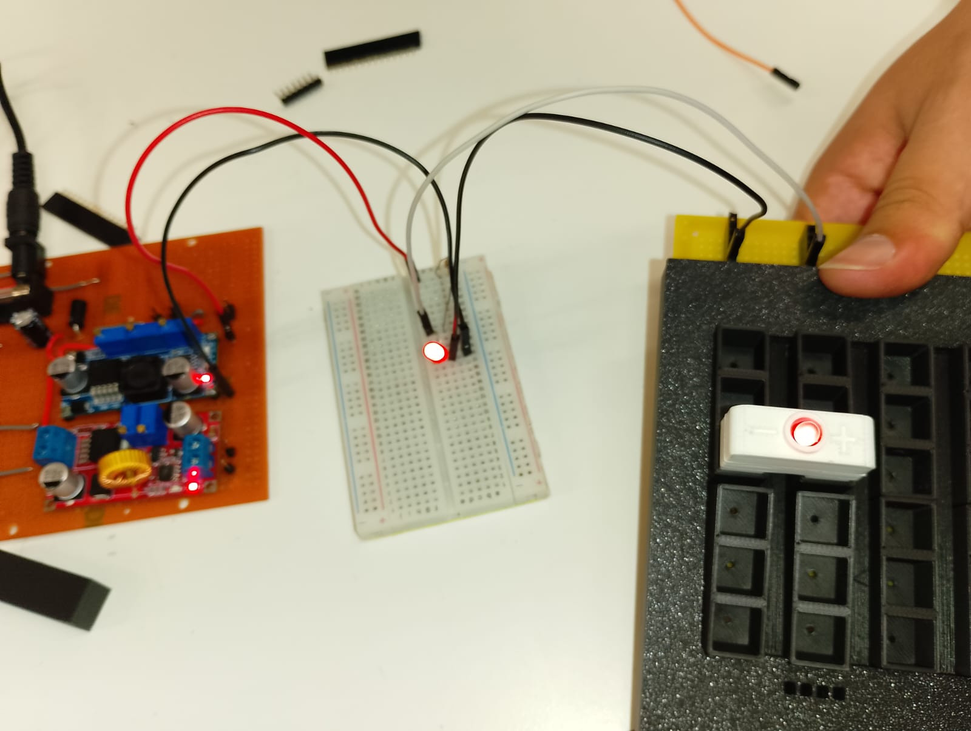
docs/deliverables/d4_images/board_of_componentes_working.jpeg
