gefgu/integration-workshop-3/eletronics/perfboard/tscircuit/guidelines.md

# TedTronics perfboard design rules

These rules govern the electronics sources, exports, assembly instructions and checkpoint contracts. Read [AUDIT.md](AUDIT.md), [firmware-contract.md](firmware-contract.md) and [assembly/index.html](assembly/index.html) together.

## Revision 7 — testable perfboards

- Revision 7 keeps revision 6's four boards, functional parts, nets and install phases. It changes wiring and adds test aids only. Read [revision7/README.md](revision7/README.md) and [revision7/selftest.md](revision7/selftest.md). `npm run build:revision7` regenerates it; revision 5 and 6 and the shared `design/model.mjs` / `design/boards.mjs` must stay byte-identical (revision 7 forks them as `model7.mjs` and `place7.mjs`).
- **Bare bus bars are allowed on the underside of the two lower boards for ground only** (this relaxes the earlier rule that only node-column straps are bare). A bar runs along a free row, touches only its own pads, keeps one hole clear of any bar of another net, and every insulated wire that crosses it gets a sleeve. Student rail, buck outputs and the separate Pi supply never use bars.
- Every lower board carries the standard 1×8 probe header `J_PROBE` (GND, 5V, 3V3, 12V, SIG1, SIG2, TRIG, FAULT) and rail/status LEDs. Test points are designated existing pads; do not bring a sensitive analogue net (divider, buffer, ADC, sense, reference, gate-drive, shunt, watchdog RC) out to an edge pad or a link.
- A removable link may only split a net whose loaded side is held OFF when the link is open (an existing or added pull-down). The build fails a link without a fail-safe, on a sensitive net, or whose pull-down is missing.
- The student-rail current trip stays at the CP12 bound (above about 10.6 mA, at most 12 mA); it is set by the MT8816 analog-pin rating and the clamps. Do not replace it with an eFuse module without redesigning the matrix and the clamps.
- Generated tables, drawings and self-test logs are not measured evidence. Release gates are unchanged.

## Revision 8 — contact-board simplification discussion

- Revision8 is a preview workspace for three grouped 4-pin NODE connectors on each contact board (4, 4 and 3 signals). Revision7 remains the current testable candidate; do not treat revision8 drawings as soldering instructions or measured hardware evidence.
- Align each compact 1×5 SMART signal connector with its NODE group in row 8, at pin columns 9–13, 37–41 and 65–69. Pins 1/3/5 carry that group's three NODE signals, pin 2 its position-specific SCL and pin 4 its position-specific SDA; this interleaves the local NODE routes and service leads. Put GND and 3V3 on a single shared 1×2 connector per contact board, at columns 34–35, row 2 above the SMART connectors; it feeds the existing service rail chain, and a separate off-board harness branches power to the three smart components. All layout elements except this shared connector were shifted down one row. This is a proposed cable arrangement, not a released interface. Keep each position's SCL/SDA buffer B-side nets separate.
- Place the three 4-pin NODE connectors beneath their signal groups at columns 13–16, 41–44 and 65–68, row 36 on both boards. Contact B uses the same contact-row orientation and connector positions as Contact A while retaining B's NODE net identities. Route leads from the bottom pogo of each contact bus.
- Regenerate the contact-board views with `npm exec -- bun revision8/build-contact-boards.tsx` from the `tscircuit` directory. The underside route builder snaps paths to the 2.54 mm hole grid and reserves component pins and the gold NODE contact buses. If crossings are necessary, only shared GND/3V3 wires may cross other nets; those insulated crossings are marked with bridges and do not indicate electrical junctions. NODE, SDA and SCL routes remain crossing-free.
- Reserve red for power and black for ground. Use blue, white, yellow and green for signal wires. Gold lines represent the proposed continuous NODE contact solder runs, not fabricated copper. SMART branches leave the top pogo of a NODE bus; matrix leads leave its bottom pogo. Connector clearances, routing, parts and assembly remain proposals until physically measured and reviewed.

## Revision 6 — four-perfboard hybrid evaluation

- The latest accepted architecture targets **four permanent 10×20 cm isolated-pad perfboards**: two continuous contact banks, one power/protection board and one router/matrix/peripheral board. This supersedes the 7×10-only preference for this candidate; revision5 stays intact as the electrical baseline. Read [revision6/README.md](revision6/README.md) and [revision6/firmware.md](revision6/firmware.md).
- Two lower boards are mandatory and mount on a removable tray. A failed fit/access assessment must report minimum PCB consolidation, not add another lower board. Include measured buck, socket, adapter, cable and smart-PCB envelopes; pad packing is not physical fit.
- Complete smart electronics move to PCBs. The twelve inherited smart layouts in revision6 are electrical reference contracts, not twelve required PCBs, extra perfboards or manufacturing files. Retain independent position protection and isolated service buses.
- CP00–CP36 identifiers, functional parts, net identities and installation phases remain compatible with the baseline. Freeze new permanent placements before construction; do not retrofit accepted builds or migrate SQLite records. Use the endpoint crosswalk and explicit temporary-link transitions.
- Separate temporary prototype from permanent boards. The full inherited one-position support fails 7×10 packing; the reduced direct-voltage reference omits the bank mux/bus isolation and uses external diagnostic stimulus. GPIO26 is a temporary stimulus profile and returns to final latch control only after its lead is removed. Repeat final-board acceptance; do not transfer prototype passes.
- `npm run build:revision6` regenerates checks, net-preservation audit, TOP/MIRRORED UNDERSIDE drawings, true-size templates, CSVs and PDFs. Mechanical measurements/manual reviews are preserved; acceptance templates are not acceptance records. No generated pass is measured evidence. PCB fabrication and powered qualification remain separate release gates.

## Revision 5 — current construction redesign

- New hardware work uses [revision5](revision5/README.md), `design/revision5.mjs`, its [firmware handoff](revision5/firmware.md), native checks and A4-landscape PDFs. The legacy app/catalog remains pinned; do not migrate its SQLite progress or overwrite its drawings with this hardware revision. The user has requested PDF work, not app development.
- Revision5 is an implemented **engineering prototype**, not a soldering release. Its 27 stock boards replace larger legacy outlines; reduced adapter/component counts do not establish a minimum-work optimum. Consult the complete counts, including distribution posts and harnesses, before promising assembly savings.
- Keep precision first-pair diagnostics, buffered voltage multiplexing, independent per-position source/sink clamps and current-path isolation. Sharing support circuits does not authorize sharing protection switches. Every position supports every mode; only three capsules may be active.
- Socket through-hole ICs. ADC/current modules use explicit labelled pigtail interfaces and external measured mounting envelopes; never draw a bare-IC footprint as the purchased module. Inspect INA226 onboard-shunt removal, factory VBUS routing, address straps and pull-ups. Never ground a VBUS pad tied to an input.
- ESP1 owns routing and rail enable; ESP2 owns smart scans, mux selectors and ADC1 joystick inputs. Keep their USB3V3/watchdog domains distinct. GPIO numbers are not DevKit physical pin numbers. Use the purchased RC522/MIFARE tags for this revision; PN532 instructions below apply only to the legacy catalog.
- Before committing permanent placements, measure actual stock grid/plating, pogo/socket/carrier bodies and board-to-board mounting offsets. Contact-board origins are 71.12mm apart, referenced to contact centres rather than 70mm edges. Existing150 purchased pogo pins are six short of156 bench contacts before spares.
- Build native source, pin, netlist, schematic and **complete-board** placement checks; functional sheets alone cannot detect cross-section collisions. Retain pad/copper checks, while clearly stating that no routed copper exists and these do not verify hand wires. Validate physical harness endpoints and every partial-state net separately. `npm run build:revision5` regenerates the independent export.
- Keep TOP and MIRRORED UNDERSIDE together. Put part numbers in evenly spaced badge/table references and keep terminal-post labels outside coordinate labels. Show at most ten added wires per printed wiring view. All diagrams retain full net membership through named boundary ports.
- CP00 has the bounded USB LED source and contacts only; no protected-power or matrix board. CP01 reuses the precision bank-A ADC. Remove temporary sense/bus/supply links at their explicit phases. Later stages add hardware without moving earlier permanent work; physical tests and firmware implementation remain release gates.

## Construction simplification proposal

- The user's latest stock choice is **only 7×10 cm double-sided fiberglass isolated-pad perfboards, purchased in ten-board kits**. This supersedes the discussed 5×7, 3×7 and 7×9 alternatives for new permanent designs. Keep temporary solderless test fixtures distinct from permanent perfboards.
- Read [the construction audit](construction-audit/README.md) and [CP00–CP08 proposal](construction-audit/early-checkpoints.md) before redesigning construction. Prioritize fewer solder operations, adapters and inter-board wires; board count alone is not the objective. Retain six interchangeable positions, every mode at every position and at most three active capsules.
- Audit artifacts are separate proposals. The current seventeen-board catalog and its verified software reports remain historical/current build references until a replacement hardware revision is explicitly implemented. Do not reinterpret their larger outlines as instructions for the selected stock.
- The proposed 26×38 hole grid is unverified. Confirm the actual kit grid, pad connectivity, plating, body envelopes and contact fit before construction release. Never represent approximate placement or capacity packing as measured fit, validated circuitry or prescribed wiring.
- Firmware implementation belongs to the user's friends. Maintain explicit electrical interfaces, phase transitions, measurement criteria and filmable wins for their handoff. Hardware changes require a separate app catalog/build revision; preserve SQLite progress and pinned assets.

## Hardware and checkpoints

- Build incrementally through CP00–CP36. Plan all permanent board placements before construction; install complete safe functional groups at their assigned checkpoint. Later stages add hardware without moving, replacing or desoldering earlier permanent work. Removable links/test leads and top-side kit arrangements may change. Repair a failed stage and repeat its acceptance before proceeding.
- CP00 lights a real four-piece kit loop using fixed battery patch links; CP01 uses fixed-position diagnostics with no matrix dependency (revision5 reuses its precision voltage channel; the legacy design has a separate fixture). The USB prototype has a hardware 560Ω current bound; final power construction starts at CP09, and matrix chips first enter at CP24. Breadboard fixtures are allowed. Simulated camera approval is never electrical evidence.
- Six interchangeable smart positions; at most three active capsules. Every position supports voltage, current, gates, pulse and memory. NFC uses a PN532 SPI carrier. The Pi has a separate supply. Configurable resistance is excluded.
- Record the explicitly accepted MT8816/CH446Q and six-position/three-position deviations. Do not silently rewrite the requirements source.
- Bench tests are release gates. A successful build, a drawing or an unchecked checklist is not evidence of measured electrical performance.

## Single source of truth

- `design/boards.mjs` and `design/model.mjs` define actual manufacturer pin numbers, nets, board dimensions, component placement and prescribed hand wiring. `boards/*.circuit.tsx` renders those descriptors.
- Regenerate exports after every change. Never hand-edit generated SVG, CSV or Circuit JSON. Keep board instances and cable pin mappings in sync.
- Use role names such as `R_P1_TOP`, `U_CURRENT`, `5V_EDU`, `HIGH_REQ` and `PRESET_N`. A component's description explains its function and its selected MPN. State polarity, adapter and rating.
- MOSFET footprint children are ordered drain/source/gate to match native symbol ports, while their physical coordinates and assembly numbers follow the manufacturer. Core canonical numbers are not manufacturer lead numbers. Connect by role; validate physical pad transforms and reject merged terminals.
- An SMD adapter must preserve the manufacturer's numbering. Adapters, carrier boards and pigtails have their own physical interfaces; never substitute a bare IC footprint for a module.

## Schematics

- Teaching schematics show continuous wires within the current functional block, supply/ground symbols, and named ports to other blocks. List every port destination and derive membership from the complete electrical model. Keep the complete schematic available separately; never remove a connection from the underlying model to simplify a picture.
- Group related components closely inside clearly titled functional boundaries; label pins by their functions and retain their manufacturer numbers. Place decoupling with its powered IC. Keep symbols, pin labels, section titles and wires clear of each other.
- Prefer native `schematicsheet`/`schematicsection`. Core 0.0.2121 repacks manually assigned sections and labels their boundary connections; this version uses explicit `schematicrect`/`schematictext` boundaries instead. A version-checked compatibility patch uses tscircuit's existing line renderer when `schTraceAutoLabelEnabled=false`. It does not remove diagnostics or implement a custom router.
- Use the default A4 sheet and run schematic-placement checks. Review the SVG visually as well as checking diagnostics. Connections crossing without a junction are separate nets.

## Manual assembly authority

- **The numbered 2D assembly drawing and pin/wire tables are authoritative.** Use the mirrored underside while soldering. Coordinates always retain top-side numbering; never renumber the underside.
- Board pitch is 2.54 mm, isolated pads. Show every hole, mounting hole, cut boundary, pin 1 and mounted side. Node contacts remain 17.78 mm apart horizontally and 10.16 mm vertically. Bank B mirrors the row direction. Capsules retain the same orientation and provide service contacts on both edges (user-confirmed); service pin order remains SCL, SDA, GND, 3V3 and P1/P3 are not exchanged.
- All hook-up wires go underneath. Only node-column straps are bare. Use insulated 24 AWG signal wire, strip only endpoints and sleeve crossings. A bend is not a solder joint; a crossing is not a connection. Do not copy a dense overview without selecting one net and consulting its endpoint table.
- Drill keyed IDC positions to 1.2 mm before assembly; other holes are nominal 1 mm. Check the remaining isolated-pad annulus and the actual stock board.
- No generated PCB copper: `routingDisabled` and drawing annotations describe insulated hand wiring. Copper DRC cannot verify these wires; the assembly validator checks their endpoints and connectivity separately.
- Leave clearance for adapter bodies, socket extraction, cable plugs and strain relief. Cut and drill before soldering. Test continuity after each net.
- The 3D view is a placement companion. Primitive bodies show side, orientation and approximate envelope; pin-1 markers identify IC orientation. Insulated hook-up wires, sockets and off-board modules are not detailed solid models. Exact dimensions of purchased pogo pins, adapters and DevKits must be measured against the drawing before release. The user has ordered pogo pins but does not yet know their part number; keep this and the adapter dimensions marked pending.

## Electrical and verification rules

- During USB-only supervised prototype checkpoints, student LED current comes through the 560Ω ±1% test-source limiter, with USB voltage measured ≤5.25V and source current ≤9.5mA. This is not the final regulated rail. Final student current comes from the monitored `5V_EDU` rail. Relay LEDs and controller logic use `5V_SYS`; they must not consume the student current budget. Hardware limits are independent of firmware commands.
- Never join I2C buffer B sides. Six A-side SDA channels share SCL; each buffer's B side is local to one capsule position. Power-off leakage must be measured in every USB/bench-power combination.
- Observe the **MT8816 analog-pin** current limit, including shared Y buses. Reserve margin below its absolute maximum; summed currents matter. Tools and student operation are mutually exclusive. Never use a bare GPIO as an educational battery.
- Re-run source, pin specification, netlist, schematic placement, PCB placement, shorts and PCB style checks, then assembly validation. Fix actionable findings; record tool limitations explicitly. Do not suppress or delete warnings to claim a pass.
- Preserve measured results with equipment, supply, fixture, firmware revision, board revision, waveform and pass/fail. Run negative tests for stale acknowledgements, invalid topology, communication loss, reset, overload and disconnected power.

## Wire colours

| Colour | Use |
|---|---|
| Red | 5 V |
| Orange | 3.3 V / USB 3.3 V |
| Brown | 12 V |
| Black | Ground |
| Blue | Educational nodes / buses |
| Green | Analog sense / reference |
| Yellow | Digital control |
| White, drawn grey | I2C |
| Light grey | Bare node straps |

## Assembly app and revisions

Use `npm run assembly:app` and http://127.0.0.1:8080. SQLite saves separate projects and physical board instances; never use browser checkboxes as authoritative progress. Keep explicit stable part/wire IDs, install phases and endpoint dependencies. Freeze each project's catalog and drawings; regeneration creates a new revision and does not upgrade a build silently. Each checkpoint needs a filmable win, actual manual acceptance readings, and a firmware contract. Reworking inspected hardware invalidates dependent checkpoint acceptance and requires fresh measurements; notes alone do not. Unused signal terminals remain open until their internal consumers arrive; factory firmware holds future outputs LOW. Partial-state checks must list these terminals. Never exempt an IC supply or ground requirement. No firmware or live USB is delivered by the assembly app.

Component identifiers are shown in numbered, evenly spaced legend gutters rather than overlapping body labels. Prescribed insulated wire fanouts use half-hole bends, not extra solder joints. Sensitive measurement/feedback paths remain direct. Follow the listed physical paths and endpoints; crossings can still require stacked insulated wire. Use the selected group/wire view when assembling.

## Guided construction

The default app is an English, one-component-or-wire-per-screen guide with thirty-seven checkpoints in chapters. Every action specifies its materials, physical endpoints, reason, expected result and notes. Installation, inspection, firmware availability and measured acceptance are distinct states. Keep TOP and MIRRORED UNDERSIDE visible together; highlight the current component/wire while fitting the full board by default. Mouse-wheel zoom follows the pointer; drag pans and Fit board restores context. Place all contacts of one node column together with a coordinate table; keep inspection separate. Next step saves construction without a confirmation checkbox; measured results and checkpoint acceptance remain independently gated. A temporary breadboard has a separate TOP drawing showing actual five-hole row ties; do not call its backside a soldering guide.

Save the current step and unfinished notes in SQLite. New builds use catalog schema2; existing schema1 builds retain their original catalog and workspace. Renumbering checkpoints never migrates their acceptance. Reworking inspected hardware invalidates dependent guided actions and measurements. Firmware remains a contract only; unavailable firmware or measurement equipment leaves the corresponding step pending.

USB test-source and temporary smart-card power links must be disconnected before final regulated supplies connect. The temporary factory ALIVE link is only for isolated CP11/12 load qualification and is removed permanently at CP13. Matrix mode requires fixed source leads removed. Never parallel the prototype and final educational sources.

Node-column schematic symbols show all six contacts on a single side, matching the physical column. Keep wire paths outside component reference labels and pin text.

Grouping contacts is a presentation change: retain original step IDs and save the entire placement group in one SQLite transaction. Existing builds may explicitly adopt refreshed drawings only when the catalog matches after excluding rendering hashes and schematic positions; preserve measured records and log the revision change. Hardware, pin, net, phase or checkpoint changes require a separate build.
