gefgu/integration-workshop-3/eletronics/perfboard/tscircuit/construction-audit/baseline.md

# Construction baseline

Derived from current circuit descriptors. Permanent quantities include six smart-channel copies. No physical work has been verified.

| Design | Quantity | Outline mm | Parts each | Pins each | Adapters each | Wires each | Solder operations estimate each | Max wire attachments at one pin |
|---|---:|---|---:|---:|---:|---:|---:|---:|
| a1 | 1 | 71.1×100 | 7 | 48 | 0 | 33 | 114 | 3 |
| a2 | 1 | 71.1×100 | 7 | 48 | 0 | 33 | 114 | 3 |
| a3 | 1 | 53.34×100 | 6 | 42 | 0 | 27 | 96 | 3 |
| b1 | 1 | 71.1×100 | 7 | 48 | 0 | 33 | 114 | 3 |
| b2 | 1 | 71.1×100 | 7 | 48 | 0 | 33 | 114 | 3 |
| b3 | 1 | 53.34×100 | 6 | 42 | 0 | 27 | 96 | 3 |
| power | 1 | 100×200 | 64 | 220 | 7 | 167 | 554 | 55 |
| smart-controller | 1 | 100×200 | 36 | 223 | 0 | 142 | 507 | 31 |
| smart-channel | 6 | 100×150 | 54 | 170 | 6 | 127 | 424 | 36 |
| matrix | 1 | 150×150 | 55 | 338 | 2 | 187 | 712 | 51 |
| integration | 1 | 100×100 | 9 | 59 | 0 | 19 | 97 | 6 |
| continuity-fixture | 1 | 100×100 | 23 | 66 | 2 | 48 | 162 | 14 |
| usb-prototype | 1 | 54×82 | 8 | 20 | 0 | 9 | 0 | 4 |

## Permanent totals

- quantity: 17
- parts: 551
- installedPins: 2202
- adapterParts: 47
- connectorPins: 495
- wireSegments: 1511
- wireEndpoints: 3022
- bareSegments: 110
- estimatedSolderOperations: 5224
- cables: 22
- cableConductors: 209

Solder-operation estimate = installed part pins + two ends per prescribed wire segment. Several ends may share a joint; this is work accounting, not an exact count of unique solder joints. Excludes adapter soldering, socket pins, external modules, cable termination and strain relief; cable conductors include reserved NC conductors. Breadboard ties are excluded from wire-segment counts. No time estimate is inferred from these counts.

Most original permanent outlines exceed the selected 70×100 mm stock; the original A3/B3 outlines fit nominally. Component fit still needs review. Merely repacking does not prove a reduction in construction work.
