gefgu/integration-workshop-3/eletronics/perfboard/tscircuit/routing-next/pcb-singleface-v2/assembly-audit.txt

{
  "independentOfSourceTraceMetadata": true,
  "checkedPthPads": 372,
  "checkedCopperTraces": 198,
  "checkedInsulatedWireBridges": 59,
  "unintendedNetMerges": [],
  "openNetsAfterBridges": {},
  "oneCopperFaceOnly": true,
  "pcbVias": 0,
  "missingBridgeMutationDetected": "JP01",
  "wrongNetBridgeMutationDetected": true,
  "hardwareMeasured": false
}
