gefgu/integration-workshop-3/eletronics/perfboard/tscircuit/construction-audit/index.html

Construction audit · separate proposal · no saved build changes

# Build fewer difficult connections

Stock-board fit studies and CP00–CP08 instructions. Firmware is supplied by your team.

Not released for soldering. The illustrative grid, module bodies and purchased contact dimensions are unverified. Drawings retain source pin identities; endpoint lines are not prescribed wire routes. Contact support fits the reference grid only; mounting and purchased parts need measurement.

## Review a checkpoint

Checkpoint Board Fit boardShow schematic alongside

Highlight

### TOP — component placement

### MIRRORED UNDERSIDE — same TOP coordinates

## Existing native functional schematic

Electrical reference from the current design, not a new proposal circuit or wiring route.

## Current group: placement, then inspection

Place one component or entire node column; inspect separately. Wire actions remain individual. All coordinates are provisional TOP column,row, including in the mirrored view.

### Endpoint studies

Only endpoints assigned to this checkpoint or earlier are included. Cross-board links require a later harness design, strain relief and electrical review.

## Acceptance and filming

## Measured construction baseline

Solder estimate = part pins + two ends per wire. Shared joints can combine ends; sockets, adapter soldering and external assemblies add work. These are descriptor-derived construction counts, not measured hardware results.

Audit findings and architecture recommendation · Detailed early construction proposal · Baseline · Endpoint CSV · Proposal data
