gefgu/integration-workshop-3/eletronics/perfboard/tscircuit/assembly/index.html

# TedTronics — perfboard assembly

For checkpoints and SQLite progress, start the assembly app: npm run assembly:app, then open http://127.0.0.1:8080. This page is the static reference export.

Prototype design. Bench results and physical fit remain pending. Read the audit before soldering. Build hardware in CP00–CP13 functional groups. Later stages add hardware without relocating or replacing earlier permanent wiring.

Use the numbered, mirrored underside view while wiring. Hole coordinates always retain the top-side numbering. Select a net to avoid hiding wire endpoints in a crowded overview. Wires are insulated except the explicitly listed node straps; strip and solder only the two endpoints.

## Module A1 — position 0

Pogo side faces capsules. All headers and insulated wires are underneath. Pogo dimensions remain provisional: replace the mounting adapter after measuring the ordered part. Revision 2 SMART cable uses raw P1/P2/P3; do not attach the old 10k/470-ohm frontend.

Top SVG · Mirrored underside SVG · Pin table · Wire table · Named netlist · Schematic · 3D placement

Show net

Wire-by-wire checklist (33)

Done | Wire / signal | From | To | Hole path
| W1 NODE00 | J_NODE00.1 | J_NODE00.2 | (4,9) → (4,13)
| W2 NODE00 | J_NODE00.2 | J_NODE00.3 | (4,13) → (4,17)
| W3 NODE00 | J_NODE00.3 | J_NODE00.4 | (4,17) → (4,21)
| W4 NODE00 | J_NODE00.4 | J_NODE00.5 | (4,21) → (4,25)
| W5 NODE00 | J_NODE00.5 | J_NODE00.6 | (4,25) → (4,29)
| W6 NODE00 | J_NODE00.1 | J_NODE.1 | (4,9) → (4,8.5) → (3.5,8.5) → (3.5,33.5) → (3,33.5) → (3,33)
| W7 NODE00 | J_NODE00.1 | J_SMART.1 | (4,9) → (4,8.5) → (11.5,8.5) → (11.5,33.5) → (20,33.5) → (20,33)
| W8 NODE01 | J_NODE01.1 | J_NODE01.2 | (11,9) → (11,13)
| W9 NODE01 | J_NODE01.2 | J_NODE01.3 | (11,13) → (11,17)
| W10 NODE01 | J_NODE01.3 | J_NODE01.4 | (11,17) → (11,21)
| W11 NODE01 | J_NODE01.4 | J_NODE01.5 | (11,21) → (11,25)
| W12 NODE01 | J_NODE01.5 | J_NODE01.6 | (11,25) → (11,29)
| W13 NODE01 | J_NODE01.1 | J_NODE.3 | (11,9) → (11,8.5) → (8,8.5) → (8,33.5) → (4,33.5) → (4,33)
| W14 NODE01 | J_NODE01.1 | J_SMART.3 | (11,9) → (11,8.5) → (16,8.5) → (16,33.5) → (21,33.5) → (21,33)
| W15 NODE02 | J_NODE02.1 | J_NODE02.2 | (18,9) → (18,13)
| W16 NODE02 | J_NODE02.2 | J_NODE02.3 | (18,13) → (18,17)
| W17 NODE02 | J_NODE02.3 | J_NODE02.4 | (18,17) → (18,21)
| W18 NODE02 | J_NODE02.4 | J_NODE02.5 | (18,21) → (18,25)
| W19 NODE02 | J_NODE02.5 | J_NODE02.6 | (18,25) → (18,29)
| W20 NODE02 | J_NODE02.1 | J_NODE.5 | (18,9) → (18,8.5) → (12.5,8.5) → (12.5,33.5) → (5,33.5) → (5,33)
| W21 NODE02 | J_NODE02.1 | J_SMART.5 | (18,9) → (18,8.5) → (20.5,8.5) → (20.5,33.5) → (22,33.5) → (22,33)
| W22 NODE03 | J_NODE03.1 | J_NODE03.2 | (25,9) → (25,13)
| W23 NODE03 | J_NODE03.2 | J_NODE03.3 | (25,13) → (25,17)
| W24 NODE03 | J_NODE03.3 | J_NODE03.4 | (25,17) → (25,21)
| W25 NODE03 | J_NODE03.4 | J_NODE03.5 | (25,21) → (25,25)
| W26 NODE03 | J_NODE03.5 | J_NODE03.6 | (25,25) → (25,29)
| W27 NODE03 | J_NODE03.1 | J_NODE.7 | (25,9) → (25,8.5) → (15.5,8.5) → (15.5,33.5) → (6,33.5) → (6,33)
| W28 SCL_0 | J_SERVICE.1 | J_SMART.9 | (10,3) → (10,2.5) → (17,2.5) → (17,33.5) → (24,33.5) → (24,33)
| W29 SDA_0 | J_SERVICE.2 | J_SMART.7 | (11,3) → (11,2.5) → (17.5,2.5) → (17.5,33.5) → (23,33.5) → (23,33)
| W30 GND | J_SERVICE.3 | J_SMART.2 | (12,3) → (12,2.5) → (15.5,2.5) → (15.5,34.5) → (20,34.5) → (20,34)
| W31 GND | J_SERVICE.3 | J_SMART.4 | (12,3) → (12,2.5) → (16.5,2.5) → (16.5,34.5) → (21,34.5) → (21,34)
| W32 GND | J_SERVICE.3 | J_SMART.6 | (12,3) → (12,2.5) → (16.5,2.5) → (16.5,34.5) → (22,34.5) → (22,34)
| W33 3V3_SYS | J_SERVICE.4 | J_SMART.8 | (13,3) → (13,2.5) → (18,2.5) → (18,34.5) → (23,34.5) → (23,34)

## Module A2 — position 1

Pogo side faces capsules. All headers and insulated wires are underneath. Pogo dimensions remain provisional: replace the mounting adapter after measuring the ordered part. Revision 2 SMART cable uses raw P1/P2/P3; do not attach the old 10k/470-ohm frontend.

Top SVG · Mirrored underside SVG · Pin table · Wire table · Named netlist · Schematic · 3D placement

Show net

Wire-by-wire checklist (33)

Done | Wire / signal | From | To | Hole path
| W1 NODE04 | J_NODE04.1 | J_NODE04.2 | (4,9) → (4,13)
| W2 NODE04 | J_NODE04.2 | J_NODE04.3 | (4,13) → (4,17)
| W3 NODE04 | J_NODE04.3 | J_NODE04.4 | (4,17) → (4,21)
| W4 NODE04 | J_NODE04.4 | J_NODE04.5 | (4,21) → (4,25)
| W5 NODE04 | J_NODE04.5 | J_NODE04.6 | (4,25) → (4,29)
| W6 NODE04 | J_NODE04.1 | J_NODE.1 | (4,9) → (4,8.5) → (3.5,8.5) → (3.5,33.5) → (3,33.5) → (3,33)
| W7 NODE04 | J_NODE04.1 | J_SMART.1 | (4,9) → (4,8.5) → (11.5,8.5) → (11.5,33.5) → (20,33.5) → (20,33)
| W8 NODE05 | J_NODE05.1 | J_NODE05.2 | (11,9) → (11,13)
| W9 NODE05 | J_NODE05.2 | J_NODE05.3 | (11,13) → (11,17)
| W10 NODE05 | J_NODE05.3 | J_NODE05.4 | (11,17) → (11,21)
| W11 NODE05 | J_NODE05.4 | J_NODE05.5 | (11,21) → (11,25)
| W12 NODE05 | J_NODE05.5 | J_NODE05.6 | (11,25) → (11,29)
| W13 NODE05 | J_NODE05.1 | J_NODE.3 | (11,9) → (11,8.5) → (8,8.5) → (8,33.5) → (4,33.5) → (4,33)
| W14 NODE05 | J_NODE05.1 | J_SMART.3 | (11,9) → (11,8.5) → (16,8.5) → (16,33.5) → (21,33.5) → (21,33)
| W15 NODE06 | J_NODE06.1 | J_NODE06.2 | (18,9) → (18,13)
| W16 NODE06 | J_NODE06.2 | J_NODE06.3 | (18,13) → (18,17)
| W17 NODE06 | J_NODE06.3 | J_NODE06.4 | (18,17) → (18,21)
| W18 NODE06 | J_NODE06.4 | J_NODE06.5 | (18,21) → (18,25)
| W19 NODE06 | J_NODE06.5 | J_NODE06.6 | (18,25) → (18,29)
| W20 NODE06 | J_NODE06.1 | J_NODE.5 | (18,9) → (18,8.5) → (12.5,8.5) → (12.5,33.5) → (5,33.5) → (5,33)
| W21 NODE06 | J_NODE06.1 | J_SMART.5 | (18,9) → (18,8.5) → (20.5,8.5) → (20.5,33.5) → (22,33.5) → (22,33)
| W22 NODE07 | J_NODE07.1 | J_NODE07.2 | (25,9) → (25,13)
| W23 NODE07 | J_NODE07.2 | J_NODE07.3 | (25,13) → (25,17)
| W24 NODE07 | J_NODE07.3 | J_NODE07.4 | (25,17) → (25,21)
| W25 NODE07 | J_NODE07.4 | J_NODE07.5 | (25,21) → (25,25)
| W26 NODE07 | J_NODE07.5 | J_NODE07.6 | (25,25) → (25,29)
| W27 NODE07 | J_NODE07.1 | J_NODE.7 | (25,9) → (25,8.5) → (15.5,8.5) → (15.5,33.5) → (6,33.5) → (6,33)
| W28 SCL_1 | J_SERVICE.1 | J_SMART.9 | (10,3) → (10,2.5) → (17,2.5) → (17,33.5) → (24,33.5) → (24,33)
| W29 SDA_1 | J_SERVICE.2 | J_SMART.7 | (11,3) → (11,2.5) → (17.5,2.5) → (17.5,33.5) → (23,33.5) → (23,33)
| W30 GND | J_SERVICE.3 | J_SMART.2 | (12,3) → (12,2.5) → (15.5,2.5) → (15.5,34.5) → (20,34.5) → (20,34)
| W31 GND | J_SERVICE.3 | J_SMART.4 | (12,3) → (12,2.5) → (16.5,2.5) → (16.5,34.5) → (21,34.5) → (21,34)
| W32 GND | J_SERVICE.3 | J_SMART.6 | (12,3) → (12,2.5) → (16.5,2.5) → (16.5,34.5) → (22,34.5) → (22,34)
| W33 3V3_SYS | J_SERVICE.4 | J_SMART.8 | (13,3) → (13,2.5) → (18,2.5) → (18,34.5) → (23,34.5) → (23,34)

## Module A3 — position 2

Pogo side faces capsules. All headers and insulated wires are underneath. Pogo dimensions remain provisional: replace the mounting adapter after measuring the ordered part. Revision 2 SMART cable uses raw P1/P2/P3; do not attach the old 10k/470-ohm frontend.

Top SVG · Mirrored underside SVG · Pin table · Wire table · Named netlist · Schematic · 3D placement

Show net

Wire-by-wire checklist (27)

Done | Wire / signal | From | To | Hole path
| W1 NODE08 | J_NODE08.1 | J_NODE08.2 | (4,9) → (4,13)
| W2 NODE08 | J_NODE08.2 | J_NODE08.3 | (4,13) → (4,17)
| W3 NODE08 | J_NODE08.3 | J_NODE08.4 | (4,17) → (4,21)
| W4 NODE08 | J_NODE08.4 | J_NODE08.5 | (4,21) → (4,25)
| W5 NODE08 | J_NODE08.5 | J_NODE08.6 | (4,25) → (4,29)
| W6 NODE08 | J_NODE08.1 | J_NODE.1 | (4,9) → (4,8.5) → (3.5,8.5) → (3.5,33.5) → (3,33.5) → (3,33)
| W7 NODE08 | J_NODE08.1 | J_SMART.1 | (4,9) → (4,8.5) → (8.5,8.5) → (8.5,33.5) → (13,33.5) → (13,33)
| W8 NODE09 | J_NODE09.1 | J_NODE09.2 | (11,9) → (11,13)
| W9 NODE09 | J_NODE09.2 | J_NODE09.3 | (11,13) → (11,17)
| W10 NODE09 | J_NODE09.3 | J_NODE09.4 | (11,17) → (11,21)
| W11 NODE09 | J_NODE09.4 | J_NODE09.5 | (11,21) → (11,25)
| W12 NODE09 | J_NODE09.5 | J_NODE09.6 | (11,25) → (11,29)
| W13 NODE09 | J_NODE09.1 | J_NODE.3 | (11,9) → (11,8.5) → (8,8.5) → (8,33.5) → (4,33.5) → (4,33)
| W14 NODE09 | J_NODE09.1 | J_SMART.3 | (11,9) → (11,8.5) → (13,8.5) → (13,33.5) → (14,33.5) → (14,33)
| W15 NODE10 | J_NODE10.1 | J_NODE10.2 | (18,9) → (18,13)
| W16 NODE10 | J_NODE10.2 | J_NODE10.3 | (18,13) → (18,17)
| W17 NODE10 | J_NODE10.3 | J_NODE10.4 | (18,17) → (18,21)
| W18 NODE10 | J_NODE10.4 | J_NODE10.5 | (18,21) → (18,25)
| W19 NODE10 | J_NODE10.5 | J_NODE10.6 | (18,25) → (18,29)
| W20 NODE10 | J_NODE10.1 | J_NODE.5 | (18,9) → (18,8.5) → (12.5,8.5) → (12.5,33.5) → (5,33.5) → (5,33)
| W21 NODE10 | J_NODE10.1 | J_SMART.5 | (18,9) → (18,8.5) → (17.5,8.5) → (17.5,33.5) → (15,33.5) → (15,33)
| W22 SCL_2 | J_SERVICE.1 | J_SMART.9 | (10,3) → (10,2.5) → (13.5,2.5) → (13.5,33.5) → (17,33.5) → (17,33)
| W23 SDA_2 | J_SERVICE.2 | J_SMART.7 | (11,3) → (11,2.5) → (14,2.5) → (14,33.5) → (16,33.5) → (16,33)
| W24 GND | J_SERVICE.3 | J_SMART.2 | (12,3) → (12,2.5) → (13.5,2.5) → (13.5,34.5) → (13,34.5) → (13,34)
| W25 GND | J_SERVICE.3 | J_SMART.4 | (12,3) → (12,2.5) → (13.5,2.5) → (13.5,34.5) → (14,34.5) → (14,34)
| W26 GND | J_SERVICE.3 | J_SMART.6 | (12,3) → (12,2.5) → (14.5,2.5) → (14.5,34.5) → (15,34.5) → (15,34)
| W27 3V3_SYS | J_SERVICE.4 | J_SMART.8 | (13,3) → (13,2.5) → (14.5,2.5) → (14.5,34.5) → (16,34.5) → (16,34)

## Module B1 — position 3

Pogo side faces capsules. All headers and insulated wires are underneath. Pogo dimensions remain provisional: replace the mounting adapter after measuring the ordered part. Revision 2 SMART cable uses raw P1/P2/P3; do not attach the old 10k/470-ohm frontend.

Top SVG · Mirrored underside SVG · Pin table · Wire table · Named netlist · Schematic · 3D placement

Show net

Wire-by-wire checklist (33)

Done | Wire / signal | From | To | Hole path
| W1 NODE11 | J_NODE11.1 | J_NODE11.2 | (4,30) → (4,26)
| W2 NODE11 | J_NODE11.2 | J_NODE11.3 | (4,26) → (4,22)
| W3 NODE11 | J_NODE11.3 | J_NODE11.4 | (4,22) → (4,18)
| W4 NODE11 | J_NODE11.4 | J_NODE11.5 | (4,18) → (4,14)
| W5 NODE11 | J_NODE11.5 | J_NODE11.6 | (4,14) → (4,10)
| W6 NODE11 | J_NODE11.1 | J_NODE.1 | (4,30) → (4,29.5) → (3.5,29.5) → (3.5,4.5) → (3,4.5) → (3,4)
| W7 NODE11 | J_NODE11.1 | J_SMART.1 | (4,30) → (4,29.5) → (11.5,29.5) → (11.5,4.5) → (20,4.5) → (20,4)
| W8 NODE12 | J_NODE12.1 | J_NODE12.2 | (11,30) → (11,26)
| W9 NODE12 | J_NODE12.2 | J_NODE12.3 | (11,26) → (11,22)
| W10 NODE12 | J_NODE12.3 | J_NODE12.4 | (11,22) → (11,18)
| W11 NODE12 | J_NODE12.4 | J_NODE12.5 | (11,18) → (11,14)
| W12 NODE12 | J_NODE12.5 | J_NODE12.6 | (11,14) → (11,10)
| W13 NODE12 | J_NODE12.1 | J_NODE.3 | (11,30) → (11,29.5) → (8,29.5) → (8,4.5) → (4,4.5) → (4,4)
| W14 NODE12 | J_NODE12.1 | J_SMART.3 | (11,30) → (11,29.5) → (16,29.5) → (16,4.5) → (21,4.5) → (21,4)
| W15 NODE13 | J_NODE13.1 | J_NODE13.2 | (18,30) → (18,26)
| W16 NODE13 | J_NODE13.2 | J_NODE13.3 | (18,26) → (18,22)
| W17 NODE13 | J_NODE13.3 | J_NODE13.4 | (18,22) → (18,18)
| W18 NODE13 | J_NODE13.4 | J_NODE13.5 | (18,18) → (18,14)
| W19 NODE13 | J_NODE13.5 | J_NODE13.6 | (18,14) → (18,10)
| W20 NODE13 | J_NODE13.1 | J_NODE.5 | (18,30) → (18,29.5) → (12.5,29.5) → (12.5,4.5) → (5,4.5) → (5,4)
| W21 NODE13 | J_NODE13.1 | J_SMART.5 | (18,30) → (18,29.5) → (20.5,29.5) → (20.5,4.5) → (22,4.5) → (22,4)
| W22 NODE14 | J_NODE14.1 | J_NODE14.2 | (25,30) → (25,26)
| W23 NODE14 | J_NODE14.2 | J_NODE14.3 | (25,26) → (25,22)
| W24 NODE14 | J_NODE14.3 | J_NODE14.4 | (25,22) → (25,18)
| W25 NODE14 | J_NODE14.4 | J_NODE14.5 | (25,18) → (25,14)
| W26 NODE14 | J_NODE14.5 | J_NODE14.6 | (25,14) → (25,10)
| W27 NODE14 | J_NODE14.1 | J_NODE.7 | (25,30) → (25,29.5) → (15.5,29.5) → (15.5,4.5) → (6,4.5) → (6,4)
| W28 SCL_3 | J_SERVICE.1 | J_SMART.9 | (10,36) → (10,35.5) → (17,35.5) → (17,4.5) → (24,4.5) → (24,4)
| W29 SDA_3 | J_SERVICE.2 | J_SMART.7 | (11,36) → (11,35.5) → (17.5,35.5) → (17.5,4.5) → (23,4.5) → (23,4)
| W30 GND | J_SERVICE.3 | J_SMART.2 | (12,36) → (12,35.5) → (15.5,35.5) → (15.5,5.5) → (20,5.5) → (20,5)
| W31 GND | J_SERVICE.3 | J_SMART.4 | (12,36) → (12,35.5) → (16.5,35.5) → (16.5,5.5) → (21,5.5) → (21,5)
| W32 GND | J_SERVICE.3 | J_SMART.6 | (12,36) → (12,35.5) → (16.5,35.5) → (16.5,5.5) → (22,5.5) → (22,5)
| W33 3V3_SYS | J_SERVICE.4 | J_SMART.8 | (13,36) → (13,35.5) → (18,35.5) → (18,5.5) → (23,5.5) → (23,5)

## Module B2 — position 4

Pogo side faces capsules. All headers and insulated wires are underneath. Pogo dimensions remain provisional: replace the mounting adapter after measuring the ordered part. Revision 2 SMART cable uses raw P1/P2/P3; do not attach the old 10k/470-ohm frontend.

Top SVG · Mirrored underside SVG · Pin table · Wire table · Named netlist · Schematic · 3D placement

Show net

Wire-by-wire checklist (33)

Done | Wire / signal | From | To | Hole path
| W1 NODE15 | J_NODE15.1 | J_NODE15.2 | (4,30) → (4,26)
| W2 NODE15 | J_NODE15.2 | J_NODE15.3 | (4,26) → (4,22)
| W3 NODE15 | J_NODE15.3 | J_NODE15.4 | (4,22) → (4,18)
| W4 NODE15 | J_NODE15.4 | J_NODE15.5 | (4,18) → (4,14)
| W5 NODE15 | J_NODE15.5 | J_NODE15.6 | (4,14) → (4,10)
| W6 NODE15 | J_NODE15.1 | J_NODE.1 | (4,30) → (4,29.5) → (3.5,29.5) → (3.5,4.5) → (3,4.5) → (3,4)
| W7 NODE15 | J_NODE15.1 | J_SMART.1 | (4,30) → (4,29.5) → (11.5,29.5) → (11.5,4.5) → (20,4.5) → (20,4)
| W8 NODE16 | J_NODE16.1 | J_NODE16.2 | (11,30) → (11,26)
| W9 NODE16 | J_NODE16.2 | J_NODE16.3 | (11,26) → (11,22)
| W10 NODE16 | J_NODE16.3 | J_NODE16.4 | (11,22) → (11,18)
| W11 NODE16 | J_NODE16.4 | J_NODE16.5 | (11,18) → (11,14)
| W12 NODE16 | J_NODE16.5 | J_NODE16.6 | (11,14) → (11,10)
| W13 NODE16 | J_NODE16.1 | J_NODE.3 | (11,30) → (11,29.5) → (8,29.5) → (8,4.5) → (4,4.5) → (4,4)
| W14 NODE16 | J_NODE16.1 | J_SMART.3 | (11,30) → (11,29.5) → (16,29.5) → (16,4.5) → (21,4.5) → (21,4)
| W15 NODE17 | J_NODE17.1 | J_NODE17.2 | (18,30) → (18,26)
| W16 NODE17 | J_NODE17.2 | J_NODE17.3 | (18,26) → (18,22)
| W17 NODE17 | J_NODE17.3 | J_NODE17.4 | (18,22) → (18,18)
| W18 NODE17 | J_NODE17.4 | J_NODE17.5 | (18,18) → (18,14)
| W19 NODE17 | J_NODE17.5 | J_NODE17.6 | (18,14) → (18,10)
| W20 NODE17 | J_NODE17.1 | J_NODE.5 | (18,30) → (18,29.5) → (12.5,29.5) → (12.5,4.5) → (5,4.5) → (5,4)
| W21 NODE17 | J_NODE17.1 | J_SMART.5 | (18,30) → (18,29.5) → (20.5,29.5) → (20.5,4.5) → (22,4.5) → (22,4)
| W22 NODE18 | J_NODE18.1 | J_NODE18.2 | (25,30) → (25,26)
| W23 NODE18 | J_NODE18.2 | J_NODE18.3 | (25,26) → (25,22)
| W24 NODE18 | J_NODE18.3 | J_NODE18.4 | (25,22) → (25,18)
| W25 NODE18 | J_NODE18.4 | J_NODE18.5 | (25,18) → (25,14)
| W26 NODE18 | J_NODE18.5 | J_NODE18.6 | (25,14) → (25,10)
| W27 NODE18 | J_NODE18.1 | J_NODE.7 | (25,30) → (25,29.5) → (15.5,29.5) → (15.5,4.5) → (6,4.5) → (6,4)
| W28 SCL_4 | J_SERVICE.1 | J_SMART.9 | (10,36) → (10,35.5) → (17,35.5) → (17,4.5) → (24,4.5) → (24,4)
| W29 SDA_4 | J_SERVICE.2 | J_SMART.7 | (11,36) → (11,35.5) → (17.5,35.5) → (17.5,4.5) → (23,4.5) → (23,4)
| W30 GND | J_SERVICE.3 | J_SMART.2 | (12,36) → (12,35.5) → (15.5,35.5) → (15.5,5.5) → (20,5.5) → (20,5)
| W31 GND | J_SERVICE.3 | J_SMART.4 | (12,36) → (12,35.5) → (16.5,35.5) → (16.5,5.5) → (21,5.5) → (21,5)
| W32 GND | J_SERVICE.3 | J_SMART.6 | (12,36) → (12,35.5) → (16.5,35.5) → (16.5,5.5) → (22,5.5) → (22,5)
| W33 3V3_SYS | J_SERVICE.4 | J_SMART.8 | (13,36) → (13,35.5) → (18,35.5) → (18,5.5) → (23,5.5) → (23,5)

## Module B3 — position 5

Pogo side faces capsules. All headers and insulated wires are underneath. Pogo dimensions remain provisional: replace the mounting adapter after measuring the ordered part. Revision 2 SMART cable uses raw P1/P2/P3; do not attach the old 10k/470-ohm frontend.

Top SVG · Mirrored underside SVG · Pin table · Wire table · Named netlist · Schematic · 3D placement

Show net

Wire-by-wire checklist (27)

Done | Wire / signal | From | To | Hole path
| W1 NODE19 | J_NODE19.1 | J_NODE19.2 | (4,30) → (4,26)
| W2 NODE19 | J_NODE19.2 | J_NODE19.3 | (4,26) → (4,22)
| W3 NODE19 | J_NODE19.3 | J_NODE19.4 | (4,22) → (4,18)
| W4 NODE19 | J_NODE19.4 | J_NODE19.5 | (4,18) → (4,14)
| W5 NODE19 | J_NODE19.5 | J_NODE19.6 | (4,14) → (4,10)
| W6 NODE19 | J_NODE19.1 | J_NODE.1 | (4,30) → (4,29.5) → (3.5,29.5) → (3.5,4.5) → (3,4.5) → (3,4)
| W7 NODE19 | J_NODE19.1 | J_SMART.1 | (4,30) → (4,29.5) → (8.5,29.5) → (8.5,4.5) → (13,4.5) → (13,4)
| W8 NODE20 | J_NODE20.1 | J_NODE20.2 | (11,30) → (11,26)
| W9 NODE20 | J_NODE20.2 | J_NODE20.3 | (11,26) → (11,22)
| W10 NODE20 | J_NODE20.3 | J_NODE20.4 | (11,22) → (11,18)
| W11 NODE20 | J_NODE20.4 | J_NODE20.5 | (11,18) → (11,14)
| W12 NODE20 | J_NODE20.5 | J_NODE20.6 | (11,14) → (11,10)
| W13 NODE20 | J_NODE20.1 | J_NODE.3 | (11,30) → (11,29.5) → (8,29.5) → (8,4.5) → (4,4.5) → (4,4)
| W14 NODE20 | J_NODE20.1 | J_SMART.3 | (11,30) → (11,29.5) → (13,29.5) → (13,4.5) → (14,4.5) → (14,4)
| W15 NODE21 | J_NODE21.1 | J_NODE21.2 | (18,30) → (18,26)
| W16 NODE21 | J_NODE21.2 | J_NODE21.3 | (18,26) → (18,22)
| W17 NODE21 | J_NODE21.3 | J_NODE21.4 | (18,22) → (18,18)
| W18 NODE21 | J_NODE21.4 | J_NODE21.5 | (18,18) → (18,14)
| W19 NODE21 | J_NODE21.5 | J_NODE21.6 | (18,14) → (18,10)
| W20 NODE21 | J_NODE21.1 | J_NODE.5 | (18,30) → (18,29.5) → (12.5,29.5) → (12.5,4.5) → (5,4.5) → (5,4)
| W21 NODE21 | J_NODE21.1 | J_SMART.5 | (18,30) → (18,29.5) → (17.5,29.5) → (17.5,4.5) → (15,4.5) → (15,4)
| W22 SCL_5 | J_SERVICE.1 | J_SMART.9 | (10,36) → (10,35.5) → (13.5,35.5) → (13.5,4.5) → (17,4.5) → (17,4)
| W23 SDA_5 | J_SERVICE.2 | J_SMART.7 | (11,36) → (11,35.5) → (14,35.5) → (14,4.5) → (16,4.5) → (16,4)
| W24 GND | J_SERVICE.3 | J_SMART.2 | (12,36) → (12,35.5) → (13.5,35.5) → (13.5,5.5) → (13,5.5) → (13,5)
| W25 GND | J_SERVICE.3 | J_SMART.4 | (12,36) → (12,35.5) → (13.5,35.5) → (13.5,5.5) → (14,5.5) → (14,5)
| W26 GND | J_SERVICE.3 | J_SMART.6 | (12,36) → (12,35.5) → (14.5,35.5) → (14.5,5.5) → (15,5.5) → (15,5)
| W27 3V3_SYS | J_SERVICE.4 | J_SMART.8 | (13,36) → (13,35.5) → (14.5,35.5) → (14.5,5.5) → (16,5.5) → (16,5)

## Power board — hardware latch and student rail

Set both buck modules with their output jumpers OPEN before connecting consumers. Independent comparator/latch protection is a prototype pending oscilloscope acceptance. Do not power the Pi from this board.

Top SVG · Mirrored underside SVG · Pin table · Wire table · Named netlist · Schematic · 3D placement

Show net

Wire-by-wire checklist (167)

Done | Wire / signal | From | To | Hole path
| W1 12V_IN | F_INPUT.1 | J_INPUT.1 | (10,3) → (10,2.5) → (7.5,2.5) → (7.5,3.5) → (6,3.5) → (6,3)
| W2 GND | C_INPUT_HF.2 | C_INPUT.2 | (34,3) → (34,2.5) → (32,2.5) → (32,3.5) → (30,3.5) → (30,3)
| W3 GND | C_INPUT_HF.2 | J_BUCK_3V3.4 | (34,3) → (34,2.5) → (25,2.5) → (25,8.5) → (15,8.5) → (15,8)
| W4 GND | C_INPUT_HF.2 | J_BUCK_5V.4 | (34,3) → (34,2.5) → (21,2.5) → (21,8.5) → (8,8.5) → (8,8)
| W5 GND | C_INPUT_HF.2 | J_FIXED_BATTERY.2 | (34,3) → (34,2.5) → (36,2.5) → (36,66.5) → (37,66.5) → (37,66)
| W6 GND | C_INPUT_HF.2 | J_INPUT.2 | (34,3) → (34,2.5) → (21,2.5) → (21,3.5) → (7,3.5) → (7,3)
| W7 GND | C_INPUT_HF.2 | J_MATRIX.2 | (34,3) → (34,2.5) → (20,2.5) → (20,72.5) → (5,72.5) → (5,72)
| W8 GND | C_INPUT_HF.2 | J_SMART.2 | (34,3) → (34,2.5) → (33,2.5) → (33,74.5) → (31,74.5) → (31,74)
| W9 GND | C_INPUT_HF.2 | J_SMART.4 | (34,3) → (34,2.5) → (33,2.5) → (33,74.5) → (32,74.5) → (32,74)
| W10 GND | C_INPUT_HF.2 | J_SMART.6 | (34,3) → (34,2.5) → (34,74.5) → (33,74.5) → (33,74)
| W11 GND | C_INPUT_HF.2 | J_TEST.2 | (34,3) → (34,2.5) → (25,2.5) → (25,71.5) → (15,71.5) → (15,71)
| W12 GND | C_INPUT_HF.2 | C_OV_3V3_IN.2 | (34,3) → (34,2.5) → (35,2.5) → (35,24.5) → (36,24.5) → (36,24)
| W13 GND | C_INPUT_HF.2 | C_OV_3V3_OUT.2 | (34,3) → (34,2.5) → (21,2.5) → (21,29.5) → (7,29.5) → (7,29)
| W14 GND | C_INPUT_HF.2 | C_OV_5V_IN.2 | (34,3) → (34,2.5) → (23,2.5) → (23,19.5) → (11,19.5) → (11,19)
| W15 GND | C_INPUT_HF.2 | C_OV_5V_OUT.2 | (34,3) → (34,2.5) → (25,2.5) → (25,19.5) → (16,19.5) → (16,19)
| W16 GND | C_INPUT_HF.2 | R_OV_3V3_BOTTOM.2 | (34,3) → (34,2.5) → (35,2.5) → (35,19.5) → (36,19.5) → (36,19)
| W17 GND | C_INPUT_HF.2 | R_OV_5V_BOTTOM.2 | (34,3) → (34,2.5) → (22,2.5) → (22,14.5) → (9,14.5) → (9,14)
| W18 GND | C_INPUT_HF.2 | R_UV_3V3_BOTTOM.2 | (34,3) → (34,2.5) → (25,2.5) → (25,24.5) → (16,24.5) → (16,24)
| W19 GND | C_INPUT_HF.2 | R_UV_5V_BOTTOM.2 | (34,3) → (34,2.5) → (29,2.5) → (29,14.5) → (23,14.5) → (23,14)
| W20 GND | C_INPUT_HF.2 | U_OV_3V3.4 | (34,3) → (34,2.5) → (27,2.5) → (27,23.5) → (19,23.5) → (19,23)
| W21 GND | C_INPUT_HF.2 | U_OV_5V.4 | (34,3) → (34,2.5) → (31,2.5) → (31,12.5) → (27,12.5) → (27,12)
| W22 GND | C_INPUT_HF.2 | C_ALLOW.2 | (34,3) → (34,2.5) → (20,2.5) → (20,55.5) → (6,55.5) → (6,55)
| W23 GND | C_INPUT_HF.2 | C_EDU.2 | (34,3) → (34,2.5) → (35,2.5) → (35,29.5) → (35,29)
| W24 GND | C_INPUT_HF.2 | C_FAULT.2 | (34,3) → (34,2.5) → (20,2.5) → (20,50.5) → (6,50.5) → (6,50)
| W25 GND | C_INPUT_HF.2 | C_RESET.2 | (34,3) → (34,2.5) → (30,2.5) → (30,52.5) → (25,52.5) → (25,52)
| W26 GND | C_INPUT_HF.2 | C_SENSE.2 | (34,3) → (34,2.5) → (27,2.5) → (27,34.5) → (19,34.5) → (19,34)
| W27 GND | C_INPUT_HF.2 | C_TRIP.2 | (34,3) → (34,2.5) → (35,2.5) → (35,34.5) → (35,34)
| W28 GND | C_INPUT_HF.2 | Q_BATTERY_LED.1 | (34,3) → (34,2.5) → (33,2.5) → (33,66.5) → (31,66.5) → (31,66)
| W29 GND | C_INPUT_HF.2 | Q_ENABLE.1 | (34,3) → (34,2.5) → (32,2.5) → (32,29.5) → (29,29.5) → (29,29)
| W30 GND | C_INPUT_HF.2 | R_EDU_BOTTOM.2 | (34,3) → (34,2.5) → (35,2.5) → (35,40.5) → (36,40.5) → (36,40)
| W31 GND | C_INPUT_HF.2 | R_EDU_FAULT_RESET_OFF.2 | (34,3) → (34,2.5) → (35,2.5) → (35,60.5) → (35,60)
| W32 GND | C_INPUT_HF.2 | R_EDU_PWR_EN_OFF.2 | (34,3) → (34,2.5) → (31,2.5) → (31,57.5) → (28,57.5) → (28,57)
| W33 GND | C_INPUT_HF.2 | R_LED_GATE_OFF.2 | (34,3) → (34,2.5) → (30,2.5) → (30,67.5) → (26,67.5) → (26,67)
| W34 GND | C_INPUT_HF.2 | R_ROUTER_ALIVE_OFF.2 | (34,3) → (34,2.5) → (31,2.5) → (31,62.5) → (28,62.5) → (28,62)
| W35 GND | C_INPUT_HF.2 | R_TRIP_BOTTOM.2 | (34,3) → (34,2.5) → (28,2.5) → (28,40.5) → (22,40.5) → (22,40)
| W36 GND | C_INPUT_HF.2 | U_ALLOW.7 | (34,3) → (34,2.5) → (22,2.5) → (22,62.5) → (9,62.5) → (9,62)
| W37 GND | C_INPUT_HF.2 | U_ALLOW.9 | (34,3) → (34,2.5) → (23,2.5) → (23,61.5) → (12,61.5) → (12,61)
| W38 GND | C_INPUT_HF.2 | U_ALLOW.10 | (34,3) → (34,2.5) → (23,2.5) → (23,60.5) → (12,60.5) → (12,60)
| W39 GND | C_INPUT_HF.2 | U_ALLOW.12 | (34,3) → (34,2.5) → (23,2.5) → (23,58.5) → (12,58.5) → (12,58)
| W40 GND | C_INPUT_HF.2 | U_ALLOW.13 | (34,3) → (34,2.5) → (23,2.5) → (23,57.5) → (12,57.5) → (12,57)
| W41 GND | C_INPUT_HF.2 | U_FAULT.2 | (34,3) → (34,2.5) → (33,2.5) → (33,48.5) → (31,48.5) → (31,48)
| W42 GND | C_INPUT_HF.2 | U_FAULT.3 | (34,3) → (34,2.5) → (33,2.5) → (33,49.5) → (31,49.5) → (31,49)
| W43 GND | C_INPUT_HF.2 | U_FAULT.7 | (34,3) → (34,2.5) → (33,2.5) → (33,53.5) → (31,53.5) → (31,53)
| W44 GND | C_INPUT_HF.2 | U_FAULT.11 | (34,3) → (34,2.5) → (34,50.5) → (34,50)
| W45 GND | C_INPUT_HF.2 | U_FAULT.12 | (34,3) → (34,2.5) → (34,49.5) → (34,49)
| W46 GND | C_INPUT_HF.2 | U_POR.3 | (34,3) → (34,2.5) → (31,2.5) → (31,45.5) → (28,45.5) → (28,45)
| W47 GND | C_INPUT_HF.2 | U_REF.2 | (34,3) → (34,2.5) → (29,2.5) → (29,34.5) → (23,34.5) → (23,34)
| W48 GND | C_INPUT_HF.2 | U_RESET.4 | (34,3) → (34,2.5) → (26,2.5) → (26,55.5) → (18,55.5) → (18,55)
| W49 GND | C_INPUT_HF.2 | U_RESET.5 | (34,3) → (34,2.5) → (26,2.5) → (26,56.5) → (18,56.5) → (18,56)
| W50 GND | C_INPUT_HF.2 | U_RESET.7 | (34,3) → (34,2.5) → (26,2.5) → (26,58.5) → (18,58.5) → (18,58)
| W51 GND | C_INPUT_HF.2 | U_RESET.9 | (34,3) → (34,2.5) → (28,2.5) → (28,57.5) → (21,57.5) → (21,57)
| W52 GND | C_INPUT_HF.2 | U_RESET.10 | (34,3) → (34,2.5) → (28,2.5) → (28,56.5) → (21,56.5) → (21,56)
| W53 GND | C_INPUT_HF.2 | U_RESET.12 | (34,3) → (34,2.5) → (28,2.5) → (28,54.5) → (21,54.5) → (21,54)
| W54 GND | C_INPUT_HF.2 | U_RESET.13 | (34,3) → (34,2.5) → (28,2.5) → (28,53.5) → (21,53.5) → (21,53)
| W55 GND | C_INPUT_HF.2 | U_SENSE.2 | (34,3) → (34,2.5) → (23,2.5) → (23,36.5) → (12,36.5) → (12,36)
| W56 GND | C_INPUT_HF.2 | U_TRIP.4 | (34,3) → (34,2.5) → (23,2.5) → (23,47.5) → (12,47.5) → (12,47)
| W57 12V_FUSED | F_INPUT.2 | J_SW_MAIN.1 | (14,3) → (14,2.5) → (16.5,2.5) → (16.5,3.5) → (17,3.5) → (17,3)
| W58 12V_SWITCHED | D_REVERSE.1 | J_SW_MAIN.2 | (21,3) → (21,2.5) → (19.5,2.5) → (19.5,3.5) → (18,3.5) → (18,3)
| W59 12V_SYS | C_INPUT_HF.1 | C_INPUT.1 | (33,3) → (33,2.5) → (31,2.5) → (31,3.5) → (28,3.5) → (28,3)
| W60 12V_SYS | C_INPUT_HF.1 | D_REVERSE.2 | (33,3) → (33,2.5) → (29,2.5) → (29,3.5) → (25,3.5) → (25,3)
| W61 12V_SYS | C_INPUT_HF.1 | J_BUCK_3V3.3 | (33,3) → (33,2.5) → (24,2.5) → (24,8.5) → (14,8.5) → (14,8)
| W62 12V_SYS | C_INPUT_HF.1 | J_BUCK_5V.3 | (33,3) → (33,2.5) → (20,2.5) → (20,8.5) → (7,8.5) → (7,8)
| W63 12V_SYS | C_INPUT_HF.1 | J_MATRIX.10 | (33,3) → (33,2.5) → (21,2.5) → (21,72.5) → (9,72.5) → (9,72)
| W64 BUCK_5V | J_BUCK_5V.5 | C_OV_5V_IN.1 | (9,8) → (9,7.5) → (10.5,7.5) → (10.5,19.5) → (10,19.5) → (10,19)
| W65 BUCK_5V | J_BUCK_5V.5 | Q_OV_5V_IN.3 | (9,8) → (9,7.5) → (22.5,7.5) → (22.5,14.5) → (35,14.5) → (35,14)
| W66 BUCK_5V | J_BUCK_5V.5 | R_OV_5V_TOP.1 | (9,8) → (9,7.5) → (21.5,7.5) → (21.5,8.5) → (33,8.5) → (33,8)
| W67 BUCK_5V | J_BUCK_5V.5 | R_UV_5V_TOP.1 | (9,8) → (9,7.5) → (11.5,7.5) → (11.5,14.5) → (12,14.5) → (12,14)
| W68 BUCK_5V | J_BUCK_5V.5 | U_OV_5V.1 | (9,8) → (9,7.5) → (18.5,7.5) → (18.5,9.5) → (27,9.5) → (27,9)
| W69 BUCK_5V | J_BUCK_5V.5 | U_OV_5V.5 | (9,8) → (9,7.5) → (20.5,7.5) → (20.5,12.5) → (30,12.5) → (30,12)
| W70 BUCK_3V3 | J_BUCK_3V3.5 | C_OV_3V3_IN.1 | (16,8) → (16,7.5) → (25.5,7.5) → (25.5,24.5) → (35,24.5) → (35,24)
| W71 BUCK_3V3 | J_BUCK_3V3.5 | Q_OV_3V3_IN.3 | (16,8) → (16,7.5) → (21.5,7.5) → (21.5,24.5) → (27,24.5) → (27,24)
| W72 BUCK_3V3 | J_BUCK_3V3.5 | R_OV_3V3_TOP.1 | (16,8) → (16,7.5) → (20.5,7.5) → (20.5,19.5) → (25,19.5) → (25,19)
| W73 BUCK_3V3 | J_BUCK_3V3.5 | R_UV_3V3_TOP.1 | (16,8) → (16,7.5) → (10.5,7.5) → (10.5,24.5) → (5,24.5) → (5,24)
| W74 BUCK_3V3 | J_BUCK_3V3.5 | U_OV_3V3.1 | (16,8) → (16,7.5) → (17.5,7.5) → (17.5,20.5) → (19,20.5) → (19,20)
| W75 BUCK_3V3 | J_BUCK_3V3.5 | U_OV_3V3.5 | (16,8) → (16,7.5) → (18.5,7.5) → (18.5,23.5) → (22,23.5) → (22,23)
| W76 SAFE_5V | JP_LOGIC.1 | C_OV_5V_OUT.1 | (19,8) → (19,7.5) → (17,7.5) → (17,19.5) → (14,19.5) → (14,19)
| W77 SAFE_5V | JP_LOGIC.1 | Q_OV_5V_OUT.3 | (19,8) → (19,7.5) → (13,7.5) → (13,19.5) → (7,19.5) → (7,19)
| W78 SAFE_5V | JP_LOGIC.1 | U_OV_5V.7 | (19,8) → (19,7.5) → (25,7.5) → (25,10.5) → (30,10.5) → (30,10)
| W79 5V_SYS | J_MATRIX.4 | J_SMART.1 | (6,72) → (6,71.5) → (19.5,71.5) → (19.5,73.5) → (31,73.5) → (31,73)
| W80 5V_SYS | J_MATRIX.4 | JP_LOGIC.2 | (6,72) → (6,71.5) → (13.5,71.5) → (13.5,8.5) → (20,8.5) → (20,8)
| W81 5V_SYS | J_MATRIX.4 | C_TRIP.1 | (6,72) → (6,71.5) → (20.5,71.5) → (20.5,34.5) → (34,34.5) → (34,34)
| W82 5V_SYS | J_MATRIX.4 | F_EDU.1 | (6,72) → (6,71.5) → (8.5,71.5) → (8.5,29.5) → (10,29.5) → (10,29)
| W83 5V_SYS | J_MATRIX.4 | R_BATTERY_LED.1 | (6,72) → (6,71.5) → (11.5,71.5) → (11.5,66.5) → (15,66.5) → (15,66)
| W84 5V_SYS | J_MATRIX.4 | R_REF_FEED.1 | (6,72) → (6,71.5) → (17.5,71.5) → (17.5,34.5) → (27,34.5) → (27,34)
| W85 5V_SYS | J_MATRIX.4 | U_TRIP.8 | (6,72) → (6,71.5) → (11.5,71.5) → (11.5,44.5) → (15,44.5) → (15,44)
| W86 SAFE_3V3 | JP_3V3.1 | C_OV_3V3_OUT.1 | (23,8) → (23,7.5) → (13.5,7.5) → (13.5,29.5) → (5,29.5) → (5,29)
| W87 SAFE_3V3 | JP_3V3.1 | Q_OV_3V3_OUT.3 | (23,8) → (23,7.5) → (27.5,7.5) → (27.5,24.5) → (32,24.5) → (32,24)
| W88 SAFE_3V3 | JP_3V3.1 | U_OV_3V3.7 | (23,8) → (23,7.5) → (22.5,7.5) → (22.5,21.5) → (22,21.5) → (22,21)
| W89 3V3_SYS | J_MATRIX.3 | J_SMART.5 | (6,71) → (6,70.5) → (20,70.5) → (20,73.5) → (33,73.5) → (33,73)
| W90 3V3_SYS | J_MATRIX.3 | JP_3V3.2 | (6,71) → (6,70.5) → (15,70.5) → (15,8.5) → (24,8.5) → (24,8)
| W91 3V3_SYS | J_MATRIX.3 | C_ALLOW.1 | (6,71) → (6,70.5) → (6,55.5) → (5,55.5) → (5,55)
| W92 3V3_SYS | J_MATRIX.3 | C_FAULT.1 | (6,71) → (6,70.5) → (6,50.5) → (5,50.5) → (5,50)
| W93 3V3_SYS | J_MATRIX.3 | C_RESET.1 | (6,71) → (6,70.5) → (15,70.5) → (15,52.5) → (24,52.5) → (24,52)
| W94 3V3_SYS | J_MATRIX.3 | C_SENSE.1 | (6,71) → (6,70.5) → (12,70.5) → (12,34.5) → (18,34.5) → (18,34)
| W95 3V3_SYS | J_MATRIX.3 | R_EDU_ON.1 | (6,71) → (6,70.5) → (12,70.5) → (12,45.5) → (18,45.5) → (18,45)
| W96 3V3_SYS | J_MATRIX.3 | R_PRESET.1 | (6,71) → (6,70.5) → (6,45.5) → (5,45.5) → (5,45)
| W97 3V3_SYS | J_MATRIX.3 | U_ALLOW.14 | (6,71) → (6,70.5) → (9,70.5) → (9,56.5) → (12,56.5) → (12,56)
| W98 3V3_SYS | J_MATRIX.3 | U_FAULT.10 | (6,71) → (6,70.5) → (20,70.5) → (20,51.5) → (34,51.5) → (34,51)
| W99 3V3_SYS | J_MATRIX.3 | U_FAULT.13 | (6,71) → (6,70.5) → (20,70.5) → (20,48.5) → (34,48.5) → (34,48)
| W100 3V3_SYS | J_MATRIX.3 | U_FAULT.14 | (6,71) → (6,70.5) → (20,70.5) → (20,47.5) → (34,47.5) → (34,47)
| W101 3V3_SYS | J_MATRIX.3 | U_POR.2 | (6,71) → (6,70.5) → (16,70.5) → (16,46.5) → (25,46.5) → (25,46)
| W102 3V3_SYS | J_MATRIX.3 | U_RESET.14 | (6,71) → (6,70.5) → (14,70.5) → (14,52.5) → (21,52.5) → (21,52)
| W103 3V3_SYS | J_MATRIX.3 | U_SENSE.5 | (6,71) → (6,70.5) → (11,70.5) → (11,35.5) → (15,35.5) → (15,35)
| W104 UV_5V | R_UV_5V_BOTTOM.1 | R_UV_5V_TOP.2 | (19,14) → (19,13.5) → (18.5,13.5) → (18.5,14.5) → (16,14.5) → (16,14)
| W105 UV_5V | R_UV_5V_BOTTOM.1 | U_OV_5V.2 | (19,14) → (19,13.5) → (23.5,13.5) → (23.5,10.5) → (27,10.5) → (27,10)
| W106 OV_5V | R_OV_5V_BOTTOM.1 | R_OV_5V_TOP.2 | (5,14) → (5,13.5) → (20.5,13.5) → (20.5,8.5) → (37,8.5) → (37,8)
| W107 OV_5V | R_OV_5V_BOTTOM.1 | U_OV_5V.3 | (5,14) → (5,13.5) → (15.5,13.5) → (15.5,11.5) → (27,11.5) → (27,11)
| W108 PRESET_N | J_TEST.5 | U_OV_3V3.6 | (18,71) → (18,70.5) → (20,70.5) → (20,22.5) → (22,22.5) → (22,22)
| W109 PRESET_N | J_TEST.5 | U_OV_5V.6 | (18,71) → (18,70.5) → (24,70.5) → (24,11.5) → (30,11.5) → (30,11)
| W110 PRESET_N | J_TEST.5 | R_PRESET.2 | (18,71) → (18,70.5) → (14,70.5) → (14,45.5) → (9,45.5) → (9,45)
| W111 PRESET_N | J_TEST.5 | U_FAULT.4 | (18,71) → (18,70.5) → (25,70.5) → (25,50.5) → (31,50.5) → (31,50)
| W112 PRESET_N | J_TEST.5 | U_POR.1 | (18,71) → (18,70.5) → (22,70.5) → (22,45.5) → (25,45.5) → (25,45)
| W113 PRESET_N | J_TEST.5 | U_RESET.2 | (18,71) → (18,70.5) → (18,53.5) → (18,53)
| W114 PRESET_N | J_TEST.5 | U_TRIP.1 | (18,71) → (18,70.5) → (15,70.5) → (15,44.5) → (12,44.5) → (12,44)
| W115 OV_GATE_5V | Q_OV_5V_IN.1 | Q_OV_5V_OUT.1 | (33,14) → (33,19) → (5,19)
| W116 OV_GATE_5V | Q_OV_5V_IN.1 | U_OV_5V.8 | (33,14) → (33,9) → (30,9)
| W117 OV_MID_5V | Q_OV_5V_IN.2 | Q_OV_5V_OUT.2 | (34,14) → (34,13.5) → (19.5,13.5) → (19.5,19.5) → (6,19.5) → (6,19)
| W118 UV_3V3 | R_UV_3V3_BOTTOM.1 | R_UV_3V3_TOP.2 | (12,24) → (12,23.5) → (11,23.5) → (11,24.5) → (9,24.5) → (9,24)
| W119 UV_3V3 | R_UV_3V3_BOTTOM.1 | U_OV_3V3.2 | (12,24) → (12,23.5) → (16,23.5) → (16,21.5) → (19,21.5) → (19,21)
| W120 OV_3V3 | R_OV_3V3_BOTTOM.1 | R_OV_3V3_TOP.2 | (32,19) → (32,18.5) → (31.5,18.5) → (31.5,19.5) → (29,19.5) → (29,19)
| W121 OV_3V3 | R_OV_3V3_BOTTOM.1 | U_OV_3V3.3 | (32,19) → (32,18.5) → (26.5,18.5) → (26.5,22.5) → (19,22.5) → (19,22)
| W122 OV_GATE_3V3 | Q_OV_3V3_IN.1 | Q_OV_3V3_OUT.1 | (25,24) → (30,24)
| W123 OV_GATE_3V3 | Q_OV_3V3_IN.1 | U_OV_3V3.8 | (25,24) → (25,20) → (22,20)
| W124 OV_MID_3V3 | Q_OV_3V3_IN.2 | Q_OV_3V3_OUT.2 | (26,24) → (26,23.5) → (29,23.5) → (29,24.5) → (31,24.5) → (31,24)
| W125 PTC_OUT | F_EDU.2 | Q_PASS.3 | (14,29) → (14,28.5) → (17.5,28.5) → (17.5,29.5) → (19,29.5) → (19,29)
| W126 PTC_OUT | F_EDU.2 | R_GATE_OFF.1 | (14,29) → (14,28.5) → (18.5,28.5) → (18.5,29.5) → (22,29.5) → (22,29)
| W127 PASS_GATE | Q_ENABLE.3 | Q_PASS.1 | (31,29) → (17,29)
| W128 PASS_GATE | Q_ENABLE.3 | R_GATE_OFF.2 | (31,29) → (26,29)
| W129 SHUNT_P | Q_PASS.2 | R_SHUNT.1 | (18,29) → (18,34) → (5,34)
| W130 SHUNT_P | Q_PASS.2 | U_SENSE.3 | (18,29) → (18,37) → (12,37)
| W131 ALLOW_RAIL | Q_ENABLE.2 | U_ALLOW.6 | (30,29) → (30,28.5) → (20.5,28.5) → (20.5,61.5) → (9,61.5) → (9,61)
| W132 5V_EDU | J_FIXED_BATTERY.1 | J_MATRIX.1 | (36,66) → (36,65.5) → (20.5,65.5) → (20.5,71.5) → (5,71.5) → (5,71)
| W133 5V_EDU | J_FIXED_BATTERY.1 | J_SMART.3 | (36,66) → (36,65.5) → (33.5,65.5) → (33.5,73.5) → (32,73.5) → (32,73)
| W134 5V_EDU | J_FIXED_BATTERY.1 | J_TEST.1 | (36,66) → (36,65.5) → (24.5,65.5) → (24.5,71.5) → (14,71.5) → (14,71)
| W135 5V_EDU | J_FIXED_BATTERY.1 | C_EDU.1 | (36,66) → (36,65.5) → (34.5,65.5) → (34.5,29.5) → (34,29.5) → (34,29)
| W136 5V_EDU | J_FIXED_BATTERY.1 | R_EDU_TOP.1 | (36,66) → (36,65.5) → (30.5,65.5) → (30.5,40.5) → (25,40.5) → (25,40)
| W137 5V_EDU | J_FIXED_BATTERY.1 | R_SHUNT.2 | (36,66) → (36,65.5) → (22.5,65.5) → (22.5,34.5) → (9,34.5) → (9,34)
| W138 5V_EDU | J_FIXED_BATTERY.1 | U_SENSE.4 | (36,66) → (36,65.5) → (25.5,65.5) → (25.5,36.5) → (15,36.5) → (15,36)
| W139 CURRENT_SENSE | J_MATRIX.8 | J_TEST.4 | (8,72) → (8,71) → (17,71)
| W140 CURRENT_SENSE | J_MATRIX.8 | U_SENSE.1 | (8,72) → (8,35) → (12,35)
| W141 CURRENT_SENSE | J_MATRIX.8 | U_TRIP.2 | (8,72) → (8,45) → (12,45)
| W142 REF_2V495 | R_REF_FEED.2 | R_TRIP_TOP.1 | (31,34) → (31,40) → (5,40)
| W143 REF_2V495 | R_REF_FEED.2 | U_REF.1 | (31,34) → (22,34)
| W144 REF_2V495 | R_REF_FEED.2 | U_REF.3 | (31,34) → (24,34)
| W145 REF_TRIP | J_TEST.3 | R_TRIP_BOTTOM.1 | (16,71) → (16,40) → (18,40)
| W146 REF_TRIP | J_TEST.3 | R_TRIP_TOP.2 | (16,71) → (16,40) → (9,40)
| W147 REF_TRIP | J_TEST.3 | U_TRIP.3 | (16,71) → (16,46) → (12,46)
| W148 REF_TRIP | J_TEST.3 | U_TRIP.6 | (16,71) → (16,46) → (15,46)
| W149 EDU_DIV | R_EDU_BOTTOM.1 | R_EDU_TOP.2 | (32,40) → (29,40)
| W150 EDU_DIV | R_EDU_BOTTOM.1 | U_TRIP.5 | (32,40) → (32,47) → (15,47)
| W151 EDU_ON | J_SMART.7 | Q_BATTERY_LED.2 | (34,73) → (34,72.5) → (33.5,72.5) → (33.5,66.5) → (32,66.5) → (32,66)
| W152 EDU_ON | J_SMART.7 | R_EDU_ON.2 | (34,73) → (34,72.5) → (28.5,72.5) → (28.5,45.5) → (22,45.5) → (22,45)
| W153 EDU_ON | J_SMART.7 | R_LED_GATE_OFF.1 | (34,73) → (34,72.5) → (28.5,72.5) → (28.5,67.5) → (22,67.5) → (22,67)
| W154 EDU_ON | J_SMART.7 | U_TRIP.7 | (34,73) → (34,72.5) → (25.5,72.5) → (25.5,45.5) → (15,45.5) → (15,45)
| W155 CLEAR_N | U_FAULT.1 | U_RESET.3 | (31,47) → (31,46.5) → (24.5,46.5) → (24.5,54.5) → (18,54.5) → (18,54)
| W156 EDU_FAULT | J_MATRIX.6 | J_TEST.6 | (7,72) → (7,71.5) → (13,71.5) → (19,71.5) → (19,71)
| W157 EDU_FAULT | J_MATRIX.6 | U_FAULT.5 | (7,72) → (7,71.5) → (19,71.5) → (19,51.5) → (31,51.5) → (31,51)
| W158 NOT_FAULT | U_ALLOW.2 | U_FAULT.6 | (9,57) → (9,56.5) → (20.5,56.5) → (20.5,52.5) → (31,52.5) → (31,52)
| W159 EDU_FAULT_RESET | J_MATRIX.7 | R_EDU_FAULT_RESET_OFF.1 | (8,71) → (8,70.5) → (19.5,70.5) → (19.5,60.5) → (31,60.5) → (31,60)
| W160 EDU_FAULT_RESET | J_MATRIX.7 | U_RESET.1 | (8,71) → (8,70.5) → (12.5,70.5) → (12.5,52.5) → (18,52.5) → (18,52)
| W161 EDU_PWR_EN | J_MATRIX.5 | R_EDU_PWR_EN_OFF.1 | (7,71) → (7,70.5) → (16,70.5) → (16,57.5) → (24,57.5) → (24,57)
| W162 EDU_PWR_EN | J_MATRIX.5 | U_ALLOW.1 | (7,71) → (7,70.5) → (8,70.5) → (8,56.5) → (9,56.5) → (9,56)
| W163 ENABLE_NO_FAULT | U_ALLOW.3 | U_ALLOW.4 | (9,58) → (9,57.5) → (9.5,57.5) → (9.5,59.5) → (9,59.5) → (9,59)
| W164 ROUTER_ALIVE | J_MATRIX.9 | R_ROUTER_ALIVE_OFF.1 | (9,71) → (9,70.5) → (16.5,70.5) → (16.5,62.5) → (24,62.5) → (24,62)
| W165 ROUTER_ALIVE | J_MATRIX.9 | U_ALLOW.5 | (9,71) → (9,70.5) → (8.5,70.5) → (8.5,60.5) → (9,60.5) → (9,60)
| W166 BATTERY_LED_A | LED_BATTERY.1 | R_BATTERY_LED.2 | (5,60) → (5,59.5) → (12,59.5) → (12,66.5) → (19,66.5) → (19,66)
| W167 BATTERY_LED_K | LED_BATTERY.2 | Q_BATTERY_LED.3 | (6,60) → (6,59.5) → (20.5,59.5) → (20.5,66.5) → (33,66.5) → (33,66)

## Smart controller — ESP2, relay register and watchdog

Three HCT595 registers provide 18 relay controls. No 5-V pull-up reaches an ESP pin. Each channel has its own service bus after its TCA9517; never join the buffer B sides.

Top SVG · Mirrored underside SVG · Pin table · Wire table · Named netlist · Schematic · 3D placement

Show net

Wire-by-wire checklist (142)

Done | Wire / signal | From | To | Hole path
| W1 USB_3V3 | C_WATCH_VCC.1 | J_CH0.8 | (19,28) → (19,27.5) → (19.5,27.5) → (19.5,63.5) → (20,63.5) → (20,63)
| W2 USB_3V3 | C_WATCH_VCC.1 | J_CH1.8 | (19,28) → (19,27.5) → (13.5,27.5) → (13.5,64.5) → (8,64.5) → (8,64)
| W3 USB_3V3 | C_WATCH_VCC.1 | J_CH2.8 | (19,28) → (19,27.5) → (24.5,27.5) → (24.5,64.5) → (30,64.5) → (30,64)
| W4 USB_3V3 | C_WATCH_VCC.1 | J_CH3.8 | (19,28) → (19,27.5) → (18.5,27.5) → (18.5,72.5) → (18,72.5) → (18,72)
| W5 USB_3V3 | C_WATCH_VCC.1 | J_CH4.8 | (19,28) → (19,27.5) → (13.5,27.5) → (13.5,74.5) → (8,74.5) → (8,74)
| W6 USB_3V3 | C_WATCH_VCC.1 | J_CH5.8 | (19,28) → (19,27.5) → (23.5,27.5) → (23.5,74.5) → (28,74.5) → (28,74)
| W7 USB_3V3 | C_WATCH_VCC.1 | R_SCL_A.1 | (19,28) → (19,27.5) → (24.5,27.5) → (24.5,6.5) → (30,6.5) → (30,6)
| W8 USB_3V3 | C_WATCH_VCC.1 | R_SDA_0.1 | (19,28) → (19,27.5) → (24.5,27.5) → (24.5,11.5) → (30,11.5) → (30,11)
| W9 USB_3V3 | C_WATCH_VCC.1 | R_SDA_1.1 | (19,28) → (19,27.5) → (18.5,27.5) → (18.5,14.5) → (19,14.5) → (19,14)
| W10 USB_3V3 | C_WATCH_VCC.1 | R_SDA_2.1 | (19,28) → (19,27.5) → (22.5,27.5) → (22.5,15.5) → (26,15.5) → (26,15)
| W11 USB_3V3 | C_WATCH_VCC.1 | R_SDA_3.1 | (19,28) → (19,27.5) → (25.5,27.5) → (25.5,15.5) → (33,15.5) → (33,15)
| W12 USB_3V3 | C_WATCH_VCC.1 | R_SDA_4.1 | (19,28) → (19,27.5) → (18.5,27.5) → (18.5,19.5) → (19,19.5) → (19,19)
| W13 USB_3V3 | C_WATCH_VCC.1 | R_SDA_5.1 | (19,28) → (19,27.5) → (22.5,27.5) → (22.5,20.5) → (26,20.5) → (26,20)
| W14 USB_3V3 | C_WATCH_VCC.1 | R_USB_POR.1 | (19,28) → (19,27.5) → (21.5,27.5) → (21.5,34.5) → (25,34.5) → (25,34)
| W15 USB_3V3 | C_WATCH_VCC.1 | R_WATCH.1 | (19,28) → (19,27.5) → (18.5,27.5) → (18.5,23.5) → (19,23.5) → (19,23)
| W16 USB_3V3 | C_WATCH_VCC.1 | U_ESP2.1 | (19,28) → (19,27.5) → (12.5,27.5) → (12.5,11.5) → (6,11.5) → (6,11)
| W17 USB_3V3 | C_WATCH_VCC.1 | U_USB_POR.2 | (19,28) → (19,27.5) → (18.5,27.5) → (18.5,36.5) → (19,36.5) → (19,36)
| W18 USB_3V3 | C_WATCH_VCC.1 | U_WATCH.16 | (19,28) → (19,27.5) → (27.5,27.5) → (27.5,22.5) → (36,22.5) → (36,22)
| W19 GND | C_SR0.2 | C_SR1.2 | (37,41) → (37,40.5) → (22,40.5) → (22,46.5) → (6,46.5) → (6,46)
| W20 GND | C_SR0.2 | C_SR2.2 | (37,41) → (37,40.5) → (27,40.5) → (27,46.5) → (16,46.5) → (16,46)
| W21 GND | C_SR0.2 | C_WATCH_VCC.2 | (37,41) → (37,40.5) → (29,40.5) → (29,28.5) → (20,28.5) → (20,28)
| W22 GND | C_SR0.2 | J_CH0.4 | (37,41) → (37,40.5) → (28,40.5) → (28,63.5) → (18,63.5) → (18,63)
| W23 GND | C_SR0.2 | J_CH1.4 | (37,41) → (37,40.5) → (22,40.5) → (22,64.5) → (6,64.5) → (6,64)
| W24 GND | C_SR0.2 | J_CH2.4 | (37,41) → (37,40.5) → (33,40.5) → (33,64.5) → (28,64.5) → (28,64)
| W25 GND | C_SR0.2 | J_CH3.4 | (37,41) → (37,40.5) → (27,40.5) → (27,72.5) → (16,72.5) → (16,72)
| W26 GND | C_SR0.2 | J_CH4.4 | (37,41) → (37,40.5) → (22,40.5) → (22,74.5) → (6,74.5) → (6,74)
| W27 GND | C_SR0.2 | J_CH5.4 | (37,41) → (37,40.5) → (32,40.5) → (32,74.5) → (26,74.5) → (26,74)
| W28 GND | C_SR0.2 | J_POWER.2 | (37,41) → (37,40.5) → (29,40.5) → (29,7.5) → (21,7.5) → (21,7)
| W29 GND | C_SR0.2 | J_POWER.4 | (37,41) → (37,40.5) → (30,40.5) → (30,7.5) → (22,7.5) → (22,7)
| W30 GND | C_SR0.2 | J_POWER.6 | (37,41) → (37,40.5) → (30,40.5) → (30,7.5) → (23,7.5) → (23,7)
| W31 GND | C_SR0.2 | Q_RAIL.1 | (37,41) → (37,40.5) → (21,40.5) → (21,41.5) → (5,41.5) → (5,41)
| W32 GND | C_SR0.2 | R_ALIVE_OFF.2 | (37,41) → (37,40.5) → (26,40.5) → (26,41.5) → (14,41.5) → (14,41)
| W33 GND | C_SR0.2 | R_HEART.2 | (37,41) → (37,40.5) → (32,40.5) → (32,30.5) → (27,30.5) → (27,30)
| W34 GND | C_SR0.2 | R_RAIL_OFF.2 | (37,41) → (37,40.5) → (29,40.5) → (29,41.5) → (21,41.5) → (21,41)
| W35 GND | C_SR0.2 | R_SR_RCLK_OFF.2 | (37,41) → (37,40.5) → (36,40.5) → (36,57.5) → (34,57.5) → (34,57)
| W36 GND | C_SR0.2 | R_SR_SER_OFF.2 | (37,41) → (37,40.5) → (28,40.5) → (28,50.5) → (19,50.5) → (19,50)
| W37 GND | C_SR0.2 | R_SR_SRCLK_OFF.2 | (37,41) → (37,40.5) → (28,40.5) → (28,55.5) → (19,55.5) → (19,55)
| W38 GND | C_SR0.2 | U_ESP2.14 | (37,41) → (37,40.5) → (22,40.5) → (22,24.5) → (6,24.5) → (6,24)
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
| W136 RELAY_11 | J_CH3.3 | U_SR1.3 | (16,71) → (16,70.5) → (19.5,70.5) → (19.5,48.5) → (24,48.5) → (24,48)
| W137 RELAY_12 | J_CH4.1 | U_SR1.4 | (5,73) → (5,72.5) → (15,72.5) → (15,49.5) → (24,49.5) → (24,49)
| W138 RELAY_13 | J_CH4.2 | U_SR1.5 | (5,74) → (5,73.5) → (15.5,73.5) → (15.5,50.5) → (24,50.5) → (24,50)
| W139 RELAY_14 | J_CH4.3 | U_SR1.6 | (6,73) → (6,72.5) → (14.5,72.5) → (14.5,51.5) → (24,51.5) → (24,51)
| W140 RELAY_15 | J_CH5.1 | U_SR1.7 | (25,73) → (25,72.5) → (25,52.5) → (24,52.5) → (24,52)
| W141 RELAY_16 | J_CH5.2 | U_SR2.15 | (25,74) → (25,73.5) → (18.5,73.5) → (18.5,49.5) → (12,49.5) → (12,49)
| W142 RELAY_17 | J_CH5.3 | U_SR2.1 | (26,73) → (26,72.5) → (18,72.5) → (18,48.5) → (9,48.5) → (9,48)

## Smart channel — build six identical cards

Fit SOIC/MSOP parts to numbered DIP adapters before installing them. Adapter pin numbers must preserve the IC numbering. Two 10-ohm current regulators replace the old 470-ohm output resistor. Scope verification of loop stability and short transients is required.

Top SVG · Mirrored underside SVG · Pin table · Wire table · Named netlist · Schematic · 3D placement

Show net

Wire-by-wire checklist (127)

Done | Wire / signal | From | To | Hole path
| W1 P1_RAW | J_MODULE.1 | R_P1_TOP.1 | (7,6) → (7,5.5) → (12.5,5.5) → (12.5,12.5) → (18,12.5) → (18,12)
| W2 P1_RAW | J_MODULE.1 | K_AMM_P.3 | (7,6) → (7,5.5) → (15.5,5.5) → (15.5,28.5) → (24,28.5) → (24,28)
| W3 GND | C_ADC.2 | C_BUS_A.2 | (26,22) → (26,21.5) → (30,21.5) → (30,5.5) → (33,5.5) → (33,5)
| W4 GND | C_ADC.2 | C_BUS_B.2 | (26,22) → (26,21.5) → (30,21.5) → (30,10.5) → (33,10.5) → (33,10)
| W5 GND | C_ADC.2 | C_P1.2 | (26,22) → (26,21.5) → (19,21.5) → (19,17.5) → (12,17.5) → (12,17)
| W6 GND | C_ADC.2 | C_P2.2 | (26,22) → (26,21.5) → (21,21.5) → (21,17.5) → (16,17.5) → (16,17)
| W7 GND | C_ADC.2 | C_VBUF.2 | (26,22) → (26,21.5) → (26,18.5) → (26,18)
| W8 GND | C_ADC.2 | J_CONTROL.4 | (26,22) → (26,21.5) → (22,21.5) → (22,7.5) → (18,7.5) → (18,7)
| W9 GND | C_ADC.2 | J_MODULE.2 | (26,22) → (26,21.5) → (17,21.5) → (17,7.5) → (7,7.5) → (7,7)
| W10 GND | C_ADC.2 | J_MODULE.4 | (26,22) → (26,21.5) → (17,21.5) → (17,7.5) → (8,7.5) → (8,7)
| W11 GND | C_ADC.2 | J_MODULE.6 | (26,22) → (26,21.5) → (18,21.5) → (18,7.5) → (9,7.5) → (9,7)
| W12 GND | C_ADC.2 | R_P1_BOTTOM.2 | (26,22) → (26,21.5) → (28,21.5) → (28,14.5) → (29,14.5) → (29,14)
| W13 GND | C_ADC.2 | R_P2_BOTTOM.2 | (26,22) → (26,21.5) → (17,21.5) → (17,17.5) → (8,17.5) → (8,17)
| W14 GND | C_ADC.2 | U_ADC.1 | (26,22) → (26,21.5) → (19,21.5) → (19,22.5) → (11,22.5) → (11,22)
| W15 GND | C_ADC.2 | U_ADC.3 | (26,22) → (26,21.5) → (19,21.5) → (19,24.5) → (11,24.5) → (11,24)
| W16 GND | C_ADC.2 | U_ADC.6 | (26,22) → (26,21.5) → (20,21.5) → (20,26.5) → (14,26.5) → (14,26)
| W17 GND | C_ADC.2 | U_ADC.7 | (26,22) → (26,21.5) → (20,21.5) → (20,25.5) → (14,25.5) → (14,25)
| W18 GND | C_ADC.2 | U_BUS.4 | (26,22) → (26,21.5) → (26,9.5) → (26,9)
| W19 GND | C_ADC.2 | U_VBUF.4 | (26,22) → (26,21.5) → (23,21.5) → (23,20.5) → (19,20.5) → (19,20)
| W20 GND | C_ADC.2 | C_LIMIT.2 | (26,22) → (26,21.5) → (30,21.5) → (30,41.5) → (33,41.5) → (33,41)
| W21 GND | C_ADC.2 | C_REFHI.2 | (26,22) → (26,21.5) → (16,21.5) → (16,39.5) → (5,39.5) → (5,39)
| W22 GND | C_ADC.2 | C_REFLO.2 | (26,22) → (26,21.5) → (18,21.5) → (18,41.5) → (9,41.5) → (9,41)
| W23 GND | C_ADC.2 | Q_K_HIGH.1 | (26,22) → (26,21.5) → (28,21.5) → (28,49.5) → (29,49.5) → (29,49)
| W24 GND | C_ADC.2 | Q_K_LOW.1 | (26,22) → (26,21.5) → (30,21.5) → (30,49.5) → (34,49.5) → (34,49)
| W25 GND | C_ADC.2 | R_HI_BOTTOM.2 | (26,22) → (26,21.5) → (24,21.5) → (24,37.5) → (22,37.5) → (22,37)
| W26 GND | C_ADC.2 | R_K_HIGH_OFF.2 | (26,22) → (26,21.5) → (26,49.5) → (26,49)
| W27 GND | C_ADC.2 | R_K_LOW_OFF.2 | (26,22) → (26,21.5) → (29,21.5) → (29,54.5) → (32,54.5) → (32,54)
| W28 GND | C_ADC.2 | R_LO_BOTTOM.2 | (26,22) → (26,21.5) → (31,21.5) → (31,37.5) → (36,37.5) → (36,37)
| W29 GND | C_ADC.2 | R_SINK_SENSE.2 | (26,22) → (26,21.5) → (25,21.5) → (25,41.5) → (23,41.5) → (23,41)
| W30 GND | C_ADC.2 | U_LIMIT.4 | (26,22) → (26,21.5) → (26,44.5) → (26,44)
| W31 GND | C_ADC.2 | C_CURRENT.2 | (26,22) → (26,21.5) → (22,21.5) → (22,25.5) → (18,25.5) → (18,25)
| W32 GND | C_ADC.2 | Q_K_AMM_N.1 | (26,22) → (26,21.5) → (30,21.5) → (30,31.5) → (33,31.5) → (33,31)
| W33 GND | C_ADC.2 | Q_K_AMM_P.1 | (26,22) → (26,21.5) → (30,21.5) → (30,27.5) → (34,27.5) → (34,27)
| W34 GND | C_ADC.2 | R_K_AMM_N_OFF.2 | (26,22) → (26,21.5) → (17,21.5) → (17,35.5) → (8,35.5) → (8,35)
| W35 GND | C_ADC.2 | R_K_AMM_P_OFF.2 | (26,22) → (26,21.5) → (20,21.5) → (20,31.5) → (14,31.5) → (14,31)
| W36 GND | C_ADC.2 | U_CURRENT.3 | (26,22) → (26,21.5) → (15,21.5) → (15,28.5) → (4,28.5) → (4,28)
| W37 GND | C_ADC.2 | U_CURRENT.7 | (26,22) → (26,21.5) → (17,21.5) → (17,27.5) → (7,27.5) → (7,27)
| W38 GND | C_ADC.2 | U_CURRENT.8 | (26,22) → (26,21.5) → (17,21.5) → (17,26.5) → (7,26.5) → (7,26)
| W39 P2_RAW | J_MODULE.3 | R_P2_TOP.1 | (8,6) → (8,5.5) → (20.5,5.5) → (20.5,14.5) → (32,14.5) → (32,14)
| W40 P2_RAW | J_MODULE.3 | K_AMM_N.4 | (8,6) → (8,5.5) → (19.5,5.5) → (19.5,31.5) → (30,31.5) → (30,31)
| W41 P3_RAW | J_MODULE.5 | K_HIGH.4 | (9,6) → (9,5.5) → (10.5,5.5) → (10.5,50.5) → (12,50.5) → (12,50)
| W42 P3_RAW | J_MODULE.5 | K_LOW.3 | (9,6) → (9,5.5) → (13.5,5.5) → (13.5,55.5) → (18,55.5) → (18,55)
| W43 SDA_B | J_MODULE.7 | R_SDA.1 | (10,6) → (10,5.5) → (7,5.5) → (7,12.5) → (4,12.5) → (4,12)
| W44 SDA_B | J_MODULE.7 | U_ADC.9 | (10,6) → (10,5.5) → (12,5.5) → (12,23.5) → (14,23.5) → (14,23)
| W45 SDA_B | J_MODULE.7 | U_BUS.6 | (10,6) → (10,5.5) → (20,5.5) → (20,8.5) → (29,8.5) → (29,8)
| W46 SDA_B | J_MODULE.7 | U_CURRENT.6 | (10,6) → (10,5.5) → (9,5.5) → (9,28.5) → (7,28.5) → (7,28)
| W47 3V3_SYS | C_ADC.1 | C_BUS_B.1 | (25,22) → (25,21.5) → (29.5,21.5) → (29.5,10.5) → (32,10.5) → (32,10)
| W48 3V3_SYS | C_ADC.1 | C_VBUF.1 | (25,22) → (25,21.5) → (25.5,21.5) → (25.5,18.5) → (25,18.5) → (25,18)
| W49 3V3_SYS | C_ADC.1 | J_CONTROL.6 | (25,22) → (25,21.5) → (22.5,21.5) → (22.5,7.5) → (19,7.5) → (19,7)
| W50 3V3_SYS | C_ADC.1 | J_MODULE.8 | (25,22) → (25,21.5) → (18.5,21.5) → (18.5,7.5) → (10,7.5) → (10,7)
| W51 3V3_SYS | C_ADC.1 | R_SCL.2 | (25,22) → (25,21.5) → (20.5,21.5) → (20.5,12.5) → (15,12.5) → (15,12)
| W52 3V3_SYS | C_ADC.1 | R_SDA.2 | (25,22) → (25,21.5) → (17.5,21.5) → (17.5,12.5) → (8,12.5) → (8,12)
| W53 3V3_SYS | C_ADC.1 | U_ADC.8 | (25,22) → (25,21.5) → (20.5,21.5) → (20.5,24.5) → (14,24.5) → (14,24)
| W54 3V3_SYS | C_ADC.1 | U_BUS.8 | (25,22) → (25,21.5) → (27.5,21.5) → (27.5,6.5) → (29,6.5) → (29,6)
| W55 3V3_SYS | C_ADC.1 | U_VBUF.8 | (25,22) → (25,21.5) → (24.5,21.5) → (24.5,17.5) → (22,17.5) → (22,17)
| W56 3V3_SYS | C_ADC.1 | C_CURRENT.1 | (25,22) → (25,21.5) → (21.5,21.5) → (21.5,25.5) → (17,25.5) → (17,25)
| W57 3V3_SYS | C_ADC.1 | U_CURRENT.4 | (25,22) → (25,21.5) → (15.5,21.5) → (15.5,29.5) → (4,29.5) → (4,29)
| W58 SCL_B | J_MODULE.9 | R_SCL.1 | (11,6) → (11,5.5) → (10.5,5.5) → (10.5,12.5) → (11,12.5) → (11,12)
| W59 SCL_B | J_MODULE.9 | U_ADC.10 | (11,6) → (11,5.5) → (12.5,5.5) → (12.5,22.5) → (14,22.5) → (14,22)
| W60 SCL_B | J_MODULE.9 | U_BUS.7 | (11,6) → (11,5.5) → (19.5,5.5) → (19.5,7.5) → (29,7.5) → (29,7)
| W61 SCL_B | J_MODULE.9 | U_CURRENT.5 | (11,6) → (11,5.5) → (8.5,5.5) → (8.5,29.5) → (7,29.5) → (7,29)
| W62 HIGH_REQ | J_CONTROL.1 | Q_K_HIGH.2 | (17,6) → (17,5.5) → (24,5.5) → (24,49.5) → (30,49.5) → (30,49)
| W63 HIGH_REQ | J_CONTROL.1 | R_K_HIGH_OFF.1 | (17,6) → (17,5.5) → (20,5.5) → (20,49.5) → (22,49.5) → (22,49)
| W64 LOW_REQ | J_CONTROL.2 | Q_K_LOW.2 | (17,7) → (17,6.5) → (26.5,6.5) → (26.5,49.5) → (35,49.5) → (35,49)
| W65 LOW_REQ | J_CONTROL.2 | R_K_LOW_OFF.1 | (17,7) → (17,6.5) → (23.5,6.5) → (23.5,54.5) → (28,54.5) → (28,54)
| W66 AMM_REQ | J_CONTROL.3 | Q_K_AMM_N.2 | (18,6) → (18,5.5) → (25.5,5.5) → (25.5,31.5) → (34,31.5) → (34,31)
| W67 AMM_REQ | J_CONTROL.3 | Q_K_AMM_P.2 | (18,6) → (18,5.5) → (26.5,5.5) → (26.5,27.5) → (35,27.5) → (35,27)
| W68 AMM_REQ | J_CONTROL.3 | R_K_AMM_N_OFF.1 | (18,6) → (18,5.5) → (10.5,5.5) → (10.5,35.5) → (4,35.5) → (4,35)
| W69 AMM_REQ | J_CONTROL.3 | R_K_AMM_P_OFF.1 | (18,6) → (18,5.5) → (13.5,5.5) → (13.5,31.5) → (10,31.5) → (10,31)
| W70 5V_SYS | J_CONTROL.5 | C_LIMIT.1 | (19,6) → (19,5.5) → (26,5.5) → (26,41.5) → (32,41.5) → (32,41)
| W71 5V_SYS | J_CONTROL.5 | R_K_HIGH_LED.1 | (19,6) → (19,5.5) → (17,5.5) → (17,49.5) → (15,49.5) → (15,49)
| W72 5V_SYS | J_CONTROL.5 | R_K_LOW_LED.1 | (19,6) → (19,5.5) → (20,5.5) → (20,54.5) → (21,54.5) → (21,54)
| W73 5V_SYS | J_CONTROL.5 | U_LIMIT.8 | (19,6) → (19,5.5) → (24,5.5) → (24,41.5) → (29,41.5) → (29,41)
| W74 5V_SYS | J_CONTROL.5 | R_K_AMM_N_LED.1 | (19,6) → (19,5.5) → (18,5.5) → (18,32.5) → (17,32.5) → (17,32)
| W75 5V_SYS | J_CONTROL.5 | R_K_AMM_P_LED.1 | (19,6) → (19,5.5) → (23,5.5) → (23,27.5) → (27,27.5) → (27,27)
| W76 SDA_A | J_CONTROL.7 | U_BUS.3 | (20,6) → (20,5.5) → (23.5,5.5) → (23.5,8.5) → (26,8.5) → (26,8)
| W77 USB_3V3 | C_BUS_A.1 | J_CONTROL.8 | (32,5) → (32,4.5) → (25.5,4.5) → (25.5,7.5) → (20,7.5) → (20,7)
| W78 USB_3V3 | C_BUS_A.1 | U_BUS.1 | (32,5) → (32,4.5) → (28.5,4.5) → (28.5,6.5) → (26,6.5) → (26,6)
| W79 USB_3V3 | C_BUS_A.1 | U_BUS.5 | (32,5) → (32,4.5) → (30.5,4.5) → (30.5,9.5) → (29,9.5) → (29,9)
| W80 SCL_A | J_CONTROL.9 | U_BUS.2 | (21,6) → (21,5.5) → (24,5.5) → (24,7.5) → (26,7.5) → (26,7)
| W81 5V_EDU | J_CONTROL.10 | R_HI_TOP.1 | (21,7) → (21,6.5) → (16.5,6.5) → (16.5,37.5) → (11,37.5) → (11,37)
| W82 5V_EDU | J_CONTROL.10 | R_LO_TOP.1 | (21,7) → (21,6.5) → (23.5,6.5) → (23.5,37.5) → (25,37.5) → (25,37)
| W83 5V_EDU | J_CONTROL.10 | R_SOURCE_SENSE.1 | (21,7) → (21,6.5) → (17.5,6.5) → (17.5,41.5) → (12,41.5) → (12,41)
| W84 DIV_P1 | C_P1.1 | R_P1_BOTTOM.1 | (11,17) → (11,14) → (25,14)
| W85 DIV_P1 | C_P1.1 | R_P1_TOP.2 | (11,17) → (11,12) → (22,12)
| W86 DIV_P1 | C_P1.1 | U_VBUF.3 | (11,17) → (11,19) → (19,19)
| W87 DIV_P2 | C_P2.1 | R_P2_BOTTOM.1 | (15,17) → (4,17)
| W88 DIV_P2 | C_P2.1 | R_P2_TOP.2 | (15,17) → (15,14) → (36,14)
| W89 DIV_P2 | C_P2.1 | U_VBUF.5 | (15,17) → (15,20) → (22,20)
| W90 BUFFER_P1 | R_ADC1.1 | U_VBUF.1 | (29,18) → (29,17) → (19,17)
| W91 BUFFER_P1 | R_ADC1.1 | U_VBUF.2 | (29,18) → (19,18)
| W92 BUFFER_P2 | R_ADC2.1 | U_VBUF.6 | (4,21) → (4,19) → (22,19)
| W93 BUFFER_P2 | R_ADC2.1 | U_VBUF.7 | (4,21) → (4,18) → (22,18)
| W94 ADC_P1 | R_ADC1.2 | U_ADC.4 | (33,18) → (33,25) → (11,25)
| W95 ADC_P2 | R_ADC2.2 | U_ADC.5 | (8,21) → (8,26) → (11,26)
| W96 SHUNT_P | K_AMM_P.4 | R_SHUNT.1 | (24,27) → (24,22) → (29,22)
| W97 SHUNT_P | K_AMM_P.4 | U_CURRENT.1 | (24,27) → (24,26) → (4,26)
| W98 SHUNT_N | K_AMM_N.3 | R_SHUNT.2 | (30,32) → (30,22) → (33,22)
| W99 SHUNT_N | K_AMM_N.3 | U_CURRENT.2 | (30,32) → (30,27) → (4,27)
| W100 K_AMM_P_LED | K_AMM_P.1 | R_K_AMM_P_LED.2 | (21,27) → (21,26.5) → (26.5,26.5) → (26.5,27.5) → (31,27.5) → (31,27)
| W101 K_AMM_P_CATHODE | K_AMM_P.2 | Q_K_AMM_P.3 | (21,28) → (21,27.5) → (28.5,27.5) → (36,27.5) → (36,27)
| W102 K_AMM_N_LED | K_AMM_N.1 | R_K_AMM_N_LED.2 | (27,31) → (27,30.5) → (24,30.5) → (24,32.5) → (21,32.5) → (21,32)
| W103 K_AMM_N_CATHODE | K_AMM_N.2 | Q_K_AMM_N.3 | (27,32) → (27,31.5) → (31.5,31.5) → (35,31.5) → (35,31)
| W104 REF_HI | C_REFHI.1 | R_HI_BOTTOM.1 | (4,39) → (4,37) → (18,37)
| W105 REF_HI | C_REFHI.1 | R_HI_TOP.2 | (4,39) → (4,37) → (15,37)
| W106 REF_HI | C_REFHI.1 | U_LIMIT.3 | (4,39) → (4,43) → (26,43)
| W107 REF_LO | C_REFLO.1 | R_LO_BOTTOM.1 | (8,41) → (8,37) → (32,37)
| W108 REF_LO | C_REFLO.1 | R_LO_TOP.2 | (8,41) → (8,37) → (29,37)
| W109 REF_LO | C_REFLO.1 | U_LIMIT.5 | (8,41) → (8,44) → (29,44)
| W110 SOURCE_SENSE | C_HI_COMP.2 | Q_HIGH.2 | (19,45) → (33,45)
| W111 SOURCE_SENSE | C_HI_COMP.2 | R_SOURCE_SENSE.2 | (19,45) → (19,41) → (16,41)
| W112 SOURCE_SENSE | C_HI_COMP.2 | U_LIMIT.2 | (19,45) → (19,42) → (26,42)
| W113 SINK_SENSE | C_LO_COMP.2 | Q_LOW.1 | (23,45) → (23,49) → (4,49)
| W114 SINK_SENSE | C_LO_COMP.2 | R_SINK_SENSE.1 | (23,45) → (23,41) → (19,41)
| W115 SINK_SENSE | C_LO_COMP.2 | U_LIMIT.6 | (23,45) → (23,43) → (29,43)
| W116 HI_GATE_DRIVE | C_HI_COMP.1 | R_HI_GATE.1 | (18,45) → (4,45)
| W117 HI_GATE_DRIVE | C_HI_COMP.1 | U_LIMIT.1 | (18,45) → (18,41) → (26,41)
| W118 LO_GATE_DRIVE | C_LO_COMP.1 | R_LO_GATE.1 | (22,45) → (11,45)
| W119 LO_GATE_DRIVE | C_LO_COMP.1 | U_LIMIT.7 | (22,45) → (22,42) → (29,42)
| W120 HI_GATE | Q_HIGH.1 | R_HI_GATE.2 | (32,45) → (8,45)
| W121 LO_GATE | Q_LOW.2 | R_LO_GATE.2 | (5,49) → (5,45) → (15,45)
| W122 SOURCE_OUT | K_HIGH.3 | Q_HIGH.3 | (12,51) → (12,50.5) → (23.5,50.5) → (23.5,45.5) → (34,45.5) → (34,45)
| W123 SINK_IN | K_LOW.4 | Q_LOW.3 | (18,54) → (18,53.5) → (11.5,53.5) → (11.5,49.5) → (6,49.5) → (6,49)
| W124 K_HIGH_LED | K_HIGH.1 | R_K_HIGH_LED.2 | (9,50) → (9,49.5) → (14,49.5) → (19,49.5) → (19,49)
| W125 K_HIGH_CATHODE | K_HIGH.2 | Q_K_HIGH.3 | (9,51) → (9,50.5) → (20.5,50.5) → (20.5,49.5) → (31,49.5) → (31,49)
| W126 K_LOW_LED | K_LOW.1 | R_K_LOW_LED.2 | (15,54) → (15,53.5) → (19.5,53.5) → (19.5,54.5) → (25,54.5) → (25,54)
| W127 K_LOW_CATHODE | K_LOW.2 | Q_K_LOW.3 | (15,55) → (15,54.5) → (26,54.5) → (26,49.5) → (36,49.5) → (36,49)

## Matrix board — 22 nodes, shared buses and test tools

12V_SYS must remain within 10.0–12.6V at the MT8816 pins. VSS and VEE are ground. 12mA limit applies to every analog pin, including a shared Y bus, not just an individual crosspoint.

Top SVG · Mirrored underside SVG · Pin table · Wire table · Named netlist · Schematic · 3D placement

Show net

Wire-by-wire checklist (187)

Done | Wire / signal | From | To | Hole path
| W1 USB_3V3 | J_FIXTURE.1 | J_PROTOTYPE.2 | (30,6) → (30,5.5) → (33.5,5.5) → (33.5,6.5) → (38,6.5) → (38,6)
| W2 USB_3V3 | J_FIXTURE.1 | U_ESP1.1 | (30,6) → (30,5.5) → (17.5,5.5) → (17.5,7.5) → (6,7.5) → (6,7)
| W3 USB_3V3 | J_FIXTURE.1 | C_RETURN.1 | (30,6) → (30,5.5) → (28.5,5.5) → (28.5,34.5) → (28,34.5) → (28,34)
| W4 USB_3V3 | J_FIXTURE.1 | R_KADC_LED.1 | (30,6) → (30,5.5) → (26.5,5.5) → (26.5,53.5) → (23,53.5) → (23,53)
| W5 USB_3V3 | J_FIXTURE.1 | U_FAULT_RETURN.5 | (30,6) → (30,5.5) → (21.5,5.5) → (21.5,53.5) → (14,53.5) → (14,53)
| W6 USB_3V3 | J_FIXTURE.1 | C_WATCH_VCC.1 | (30,6) → (30,5.5) → (29.5,5.5) → (29.5,9.5) → (30,9.5) → (30,9)
| W7 USB_3V3 | J_FIXTURE.1 | R_USB_POR.1 | (30,6) → (30,5.5) → (24.5,5.5) → (24.5,12.5) → (19,12.5) → (19,12)
| W8 USB_3V3 | J_FIXTURE.1 | R_WATCH.1 | (30,6) → (30,5.5) → (39.5,5.5) → (39.5,6.5) → (49,6.5) → (49,6)
| W9 USB_3V3 | J_FIXTURE.1 | U_USB_POR.2 | (30,6) → (30,5.5) → (39.5,5.5) → (39.5,10.5) → (49,10.5) → (49,10)
| W10 USB_3V3 | J_FIXTURE.1 | U_WATCH.16 | (30,6) → (30,5.5) → (37.5,5.5) → (37.5,6.5) → (46,6.5) → (46,6)
| W11 USB_3V3 | J_FIXTURE.1 | C_DIAG_VCC.1 | (30,6) → (30,5.5) → (21.5,5.5) → (21.5,32.5) → (14,32.5) → (14,32)
| W12 USB_3V3 | J_FIXTURE.1 | U_DIAG.8 | (30,6) → (30,5.5) → (18.5,5.5) → (18.5,53.5) → (8,53.5) → (8,53)
| W13 GND | J_FIXTURE.2 | J_PROTOTYPE.3 | (31,6) → (31,5.5) → (35,5.5) → (35,6.5) → (39,6.5) → (39,6)
| W14 GND | J_FIXTURE.2 | U_ESP1.14 | (31,6) → (31,5.5) → (19,5.5) → (19,20.5) → (6,20.5) → (6,20)
| W15 GND | J_FIXTURE.2 | U_ESP1.20 | (31,6) → (31,5.5) → (24,5.5) → (24,7.5) → (16,7.5) → (16,7)
| W16 GND | J_FIXTURE.2 | U_ESP1.26 | (31,6) → (31,5.5) → (24,5.5) → (24,13.5) → (16,13.5) → (16,13)
| W17 GND | J_FIXTURE.2 | C_RETURN.2 | (31,6) → (31,5.5) → (30,5.5) → (30,34.5) → (29,34.5) → (29,34)
| W18 GND | J_FIXTURE.2 | J_POWER.2 | (31,6) → (31,5.5) → (26,5.5) → (26,7.5) → (21,7.5) → (21,7)
| W19 GND | J_FIXTURE.2 | K_ADC.2 | (31,6) → (31,5.5) → (24,5.5) → (24,54.5) → (17,54.5) → (17,54)
| W20 GND | J_FIXTURE.2 | U_FAULT_RETURN.1 | (31,6) → (31,5.5) → (21,5.5) → (21,53.5) → (11,53.5) → (11,53)
| W21 GND | J_FIXTURE.2 | U_FAULT_RETURN.3 | (31,6) → (31,5.5) → (21,5.5) → (21,55.5) → (11,55.5) → (11,55)
| W22 GND | J_FIXTURE.2 | C_WATCH_VCC.2 | (31,6) → (31,5.5) → (31,9.5) → (31,9)
| W23 GND | J_FIXTURE.2 | Q_BUF.1 | (31,6) → (31,5.5) → (43,5.5) → (43,11.5) → (55,11.5) → (55,11)
| W24 GND | J_FIXTURE.2 | R_ALIVE_OFF.2 | (31,6) → (31,5.5) → (34,5.5) → (34,13.5) → (37,13.5) → (37,13)
| W25 GND | J_FIXTURE.2 | R_HEART.2 | (31,6) → (31,5.5) → (35,5.5) → (35,9.5) → (38,9.5) → (38,9)
| W26 GND | J_FIXTURE.2 | U_USB_POR.3 | (31,6) → (31,5.5) → (42,5.5) → (42,9.5) → (52,9.5) → (52,9)
| W27 GND | J_FIXTURE.2 | U_WATCH.1 | (31,6) → (31,5.5) → (37,5.5) → (37,6.5) → (43,6.5) → (43,6)
| W28 GND | J_FIXTURE.2 | U_WATCH.8 | (31,6) → (31,5.5) → (37,5.5) → (37,13.5) → (43,13.5) → (43,13)
| W29 GND | J_FIXTURE.2 | U_WATCH.9 | (31,6) → (31,5.5) → (39,5.5) → (39,13.5) → (46,13.5) → (46,13)
| W30 GND | J_FIXTURE.2 | U_WATCH.10 | (31,6) → (31,5.5) → (39,5.5) → (39,12.5) → (46,12.5) → (46,12)
| W31 GND | J_FIXTURE.2 | U_WATCH.11 | (31,6) → (31,5.5) → (39,5.5) → (39,11.5) → (46,11.5) → (46,11)
| W32 GND | J_FIXTURE.2 | C_ADDR.2 | (31,6) → (31,5.5) → (44,5.5) → (44,14.5) → (56,14.5) → (56,14)
| W33 GND | J_FIXTURE.2 | C_BUFFER.2 | (31,6) → (31,5.5) → (29,5.5) → (29,16.5) → (26,16.5) → (26,16)
| W34 GND | J_FIXTURE.2 | C_DIAG_VCC.2 | (31,6) → (31,5.5) → (23,5.5) → (23,32.5) → (15,32.5) → (15,32)
| W35 GND | J_FIXTURE.2 | C_DIAG.2 | (31,6) → (31,5.5) → (30,5.5) → (30,30.5) → (29,30.5) → (29,30)
| W36 GND | J_FIXTURE.2 | C_MT0_BULK.2 | (31,6) → (31,5.5) → (30,5.5) → (30,27.5) → (29,27.5) → (29,27)
| W37 GND | J_FIXTURE.2 | C_MT0.2 | (31,6) → (31,5.5) → (44,5.5) → (44,25.5) → (56,25.5) → (56,25)
| W38 GND | J_FIXTURE.2 | C_MT1_BULK.2 | (31,6) → (31,5.5) → (43,5.5) → (43,28.5) → (54,28.5) → (54,28)
| W39 GND | J_FIXTURE.2 | C_MT1.2 | (31,6) → (31,5.5) → (37,5.5) → (37,27.5) → (42,27.5) → (42,27)
| W40 GND | J_FIXTURE.2 | Q_RESET_ALIVE.1 | (31,6) → (31,5.5) → (43,5.5) → (43,21.5) → (55,21.5) → (55,21)
| W41 GND | J_FIXTURE.2 | R_CAL.2 | (31,6) → (31,5.5) → (44,5.5) → (44,46.5) → (56,46.5) → (56,46)
| W42 GND | J_FIXTURE.2 | R_DIAG_BOTTOM.2 | (31,6) → (31,5.5) → (38,5.5) → (38,51.5) → (45,51.5) → (45,51)
| W43 GND | J_FIXTURE.2 | R_DISCHARGE.2 | (31,6) → (31,5.5) → (44,5.5) → (44,42.5) → (56,42.5) → (56,42)
| W44 GND | J_FIXTURE.2 | R_RST_RELEASE_OFF.2 | (31,6) → (31,5.5) → (30,5.5) → (30,23.5) → (29,23.5) → (29,23)
| W45 GND | J_FIXTURE.2 | R_STB_A_IN_OFF.2 | (31,6) → (31,5.5) → (34,5.5) → (34,20.5) → (36,20.5) → (36,20)
| W46 GND | J_FIXTURE.2 | R_STB_B_IN_OFF.2 | (31,6) → (31,5.5) → (37,5.5) → (37,20.5) → (43,20.5) → (43,20)
| W47 GND | J_FIXTURE.2 | R_STBA_OFF.2 | (31,6) → (31,5.5) → (37,5.5) → (37,23.5) → (43,23.5) → (43,23)
| W48 GND | J_FIXTURE.2 | R_STBB_OFF.2 | (31,6) → (31,5.5) → (41,5.5) → (41,26.5) → (50,26.5) → (50,26)
| W49 GND | J_FIXTURE.2 | R_XBAR_CLK_OFF.2 | (31,6) → (31,5.5) → (36,5.5) → (36,16.5) → (40,16.5) → (40,16)
| W50 GND | J_FIXTURE.2 | R_XBAR_DAT_OFF.2 | (31,6) → (31,5.5) → (32,5.5) → (32,16.5) → (33,16.5) → (33,16)
| W51 GND | J_FIXTURE.2 | R_XBAR_LATCH_OFF.2 | (31,6) → (31,5.5) → (30,5.5) → (30,20.5) → (29,20.5) → (29,20)
| W52 GND | J_FIXTURE.2 | U_ADDR.8 | (31,6) → (31,5.5) → (40,5.5) → (40,22.5) → (49,22.5) → (49,22)
| W53 GND | J_FIXTURE.2 | U_BUFFER.7 | (31,6) → (31,5.5) → (25,5.5) → (25,22.5) → (19,22.5) → (19,22)
| W54 GND | J_FIXTURE.2 | U_BUFFER.9 | (31,6) → (31,5.5) → (27,5.5) → (27,21.5) → (22,21.5) → (22,21)
| W55 GND | J_FIXTURE.2 | U_BUFFER.12 | (31,6) → (31,5.5) → (27,5.5) → (27,18.5) → (22,18.5) → (22,18)
| W56 GND | J_FIXTURE.2 | U_DIAG.4 | (31,6) → (31,5.5) → (18,5.5) → (18,56.5) → (5,56.5) → (5,56)
| W57 GND | J_FIXTURE.2 | U_DIAG.5 | (31,6) → (31,5.5) → (20,5.5) → (20,56.5) → (8,56.5) → (8,56)
| W58 GND | J_FIXTURE.2 | U_MT_A.16 | (31,6) → (31,5.5) → (25,5.5) → (25,43.5) → (19,43.5) → (19,43)
| W59 GND | J_FIXTURE.2 | U_MT_A.20 | (31,6) → (31,5.5) → (25,5.5) → (25,47.5) → (19,47.5) → (19,47)
| W60 GND | J_FIXTURE.2 | U_MT_A.35 | (31,6) → (31,5.5) → (28,5.5) → (28,33.5) → (25,33.5) → (25,33)
| W61 GND | J_FIXTURE.2 | U_MT_B.16 | (31,6) → (31,5.5) → (32,5.5) → (32,43.5) → (32,43)
| W62 GND | J_FIXTURE.2 | U_MT_B.20 | (31,6) → (31,5.5) → (32,5.5) → (32,47.5) → (32,47)
| W63 GND | J_FIXTURE.2 | U_MT_B.35 | (31,6) → (31,5.5) → (35,5.5) → (35,33.5) → (38,33.5) → (38,33)
| W64 XBAR_DAT | U_ESP1.21 | R_XBAR_DAT_OFF.1 | (16,8) → (16,7.5) → (23.5,7.5) → (23.5,16.5) → (29,16.5) → (29,16)
| W65 XBAR_DAT | U_ESP1.21 | U_ADDR.14 | (16,8) → (16,7.5) → (34.5,7.5) → (34.5,17.5) → (52,17.5) → (52,17)
| W66 XBAR_CLK | U_ESP1.28 | R_XBAR_CLK_OFF.1 | (16,15) → (16,14.5) → (25.5,14.5) → (25.5,16.5) → (36,16.5) → (36,16)
| W67 XBAR_CLK | U_ESP1.28 | U_ADDR.11 | (16,15) → (16,14.5) → (33.5,14.5) → (33.5,20.5) → (52,20.5) → (52,20)
| W68 XBAR_LATCH | U_ESP1.22 | R_XBAR_LATCH_OFF.1 | (16,9) → (16,8.5) → (21,8.5) → (21,20.5) → (25,20.5) → (25,20)
| W69 XBAR_LATCH | U_ESP1.22 | U_ADDR.12 | (16,9) → (16,8.5) → (34,8.5) → (34,19.5) → (52,19.5) → (52,19)
| W70 STB_A_IN | U_ESP1.27 | R_STB_A_IN_OFF.1 | (16,14) → (16,13.5) → (24.5,13.5) → (24.5,20.5) → (32,20.5) → (32,20)
| W71 STB_A_IN | U_ESP1.27 | U_BUFFER.2 | (16,14) → (16,13.5) → (18.5,13.5) → (18.5,17.5) → (19,17.5) → (19,17)
| W72 STB_B_IN | U_ESP1.25 | R_STB_B_IN_OFF.1 | (16,12) → (16,11.5) → (27.5,11.5) → (27.5,20.5) → (39,20.5) → (39,20)
| W73 STB_B_IN | U_ESP1.25 | U_BUFFER.5 | (16,12) → (16,11.5) → (17.5,11.5) → (17.5,20.5) → (19,20.5) → (19,20)
| W74 RST_RELEASE | U_ESP1.11 | Q_RESET_RELEASE.2 | (6,17) → (6,16.5) → (31,16.5) → (31,18.5) → (56,18.5) → (56,18)
| W75 RST_RELEASE | U_ESP1.11 | R_RST_RELEASE_OFF.1 | (6,17) → (6,16.5) → (16,16.5) → (16,23.5) → (25,23.5) → (25,23)
| W76 HEARTBEAT | U_ESP1.8 | R_HEART.1 | (6,14) → (6,13.5) → (20.5,13.5) → (20.5,9.5) → (34,9.5) → (34,9)
| W77 HEARTBEAT | U_ESP1.8 | U_WATCH.2 | (6,14) → (6,13.5) → (25.5,13.5) → (25.5,7.5) → (43,7.5) → (43,7)
| W78 EDU_PWR_EN | J_PROTOTYPE.4 | U_ESP1.7 | (40,6) → (40,5.5) → (22.5,5.5) → (22.5,13.5) → (6,13.5) → (6,13)
| W79 EDU_PWR_EN | J_PROTOTYPE.4 | J_POWER.5 | (40,6) → (40,5.5) → (31.5,5.5) → (31.5,6.5) → (23,6.5) → (23,6)
| W80 FAULT_USB | U_ESP1.6 | U_FAULT_RETURN.4 | (6,12) → (6,11.5) → (10,11.5) → (10,54.5) → (14,54.5) → (14,54)
| W81 EDU_FAULT_RESET | U_ESP1.30 | J_POWER.7 | (16,17) → (16,16.5) → (20.5,16.5) → (20.5,6.5) → (24,6.5) → (24,6)
| W82 CURRENT_USB | U_ESP1.5 | K_ADC.4 | (6,11) → (6,10.5) → (12.5,10.5) → (12.5,53.5) → (20,53.5) → (20,53)
| W83 DIAG_ADC | U_ESP1.3 | U_DIAG.1 | (6,9) → (6,53) → (5,53)
| W84 DIAG_ADC | U_ESP1.3 | U_DIAG.2 | (6,9) → (6,54) → (5,54)
| W85 FIX_SDA | J_FIXTURE.3 | U_ESP1.32 | (32,6) → (32,5.5) → (24.5,5.5) → (24.5,19.5) → (16,19.5) → (16,19)
| W86 FIX_SCL | J_FIXTURE.4 | U_ESP1.31 | (33,6) → (33,5.5) → (24.5,5.5) → (24.5,18.5) → (16,18.5) → (16,18)
| W87 FIX_STIM | J_FIXTURE.5 | U_ESP1.9 | (34,6) → (34,5.5) → (20,5.5) → (20,15.5) → (6,15.5) → (6,15)
| W88 USB_5V | J_PROTOTYPE.1 | U_ESP1.19 | (37,6) → (37,5.5) → (22.5,5.5) → (22.5,25.5) → (6,25.5) → (6,25)
| W89 5V_EDU | J_POWER.1 | U_MT_A.37 | (21,6) → (21,5.5) → (22.5,5.5) → (22.5,31.5) → (25,31.5) → (25,31)
| W90 5V_EDU | J_POWER.1 | U_MT_B.37 | (21,6) → (21,5.5) → (29.5,5.5) → (29.5,31.5) → (38,31.5) → (38,31)
| W91 3V3_SYS | J_POWER.3 | D_SOURCE.1 | (22,6) → (22,5.5) → (37,5.5) → (37,32.5) → (52,32.5) → (52,32)
| W92 5V_SYS | J_POWER.4 | R_BUF_OE.1 | (22,7) → (22,6.5) → (24.5,6.5) → (24.5,13.5) → (26,13.5) → (26,13)
| W93 5V_SYS | J_POWER.4 | C_ADDR.1 | (22,7) → (22,6.5) → (39.5,6.5) → (39.5,14.5) → (55,14.5) → (55,14)
| W94 5V_SYS | J_POWER.4 | C_BUFFER.1 | (22,7) → (22,6.5) → (24.5,6.5) → (24.5,16.5) → (25,16.5) → (25,16)
| W95 5V_SYS | J_POWER.4 | U_ADDR.10 | (22,7) → (22,6.5) → (37.5,6.5) → (37.5,21.5) → (52,21.5) → (52,21)
| W96 5V_SYS | J_POWER.4 | U_ADDR.16 | (22,7) → (22,6.5) → (37.5,6.5) → (37.5,15.5) → (52,15.5) → (52,15)
| W97 5V_SYS | J_POWER.4 | U_BUFFER.10 | (22,7) → (22,6.5) → (22.5,6.5) → (22.5,20.5) → (22,20.5) → (22,20)
| W98 5V_SYS | J_POWER.4 | U_BUFFER.13 | (22,7) → (22,6.5) → (22.5,6.5) → (22.5,17.5) → (22,17.5) → (22,17)
| W99 5V_SYS | J_POWER.4 | U_BUFFER.14 | (22,7) → (22,6.5) → (22.5,6.5) → (22.5,16.5) → (22,16.5) → (22,16)
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
| W140 STROBE_A | R_STBA_OFF.1 | U_BUFFER.3 | (39,23) → (39,22.5) → (29,22.5) → (29,18.5) → (19,18.5) → (19,18)
| W141 STROBE_A | R_STBA_OFF.1 | U_MT_A.18 | (39,23) → (39,22.5) → (29,22.5) → (29,45.5) → (19,45.5) → (19,45)
| W142 STROBE_B | R_STBB_OFF.1 | U_BUFFER.6 | (46,26) → (46,25.5) → (33.5,25.5) → (33.5,21.5) → (19,21.5) → (19,21)
| W143 STROBE_B | R_STBB_OFF.1 | U_MT_B.18 | (46,26) → (46,25.5) → (39.5,25.5) → (39.5,45.5) → (32,45.5) → (32,45)
| W144 XBAR_RESET | Q_RESET_RELEASE.3 | R_RESET_ON.2 | (57,18) → (57,17.5) → (46.5,17.5) → (46.5,23.5) → (36,23.5) → (36,23)
| W145 XBAR_RESET | Q_RESET_RELEASE.3 | U_MT_A.3 | (57,18) → (57,17.5) → (37.5,17.5) → (37.5,30.5) → (19,30.5) → (19,30)
| W146 XBAR_RESET | Q_RESET_RELEASE.3 | U_MT_B.3 | (57,18) → (57,17.5) → (44.5,17.5) → (44.5,30.5) → (32,30.5) → (32,30)
| W147 RESET_MID | Q_RESET_ALIVE.3 | Q_RESET_RELEASE.1 | (57,21) → (57,20.5) → (56,20.5) → (56,18.5) → (55,18.5) → (55,18)
| W148 NODE00 | J_A1.1 | U_MT_A.33 | (43,32) → (43,31.5) → (34.5,31.5) → (34.5,35.5) → (25,35.5) → (25,35)
| W149 NODE01 | J_A1.3 | U_MT_A.32 | (44,32) → (44,31.5) → (34.5,31.5) → (34.5,36.5) → (25,36.5) → (25,36)
| W150 NODE02 | J_A1.5 | U_MT_A.31 | (45,32) → (45,31.5) → (35,31.5) → (35,37.5) → (25,37.5) → (25,37)
| W151 NODE03 | J_A1.7 | U_MT_A.30 | (46,32) → (46,31.5) → (36.5,31.5) → (36.5,38.5) → (25,38.5) → (25,38)
| W152 NODE04 | J_A2.1 | U_MT_A.29 | (5,33) → (5,32.5) → (14.5,32.5) → (14.5,39.5) → (25,39.5) → (25,39)
| W153 NODE05 | J_A2.3 | U_MT_A.28 | (6,33) → (6,32.5) → (16,32.5) → (16,40.5) → (25,40.5) → (25,40)
| W154 NODE06 | J_A2.5 | U_MT_A.8 | (7,33) → (7,32.5) → (13.5,32.5) → (13.5,35.5) → (19,35.5) → (19,35)
| W155 NODE07 | J_A2.7 | U_MT_A.9 | (8,33) → (8,32.5) → (13.5,32.5) → (13.5,36.5) → (19,36.5) → (19,36)
| W156 NODE08 | J_A3.1 | U_MT_A.10 | (43,39) → (43,38.5) → (31,38.5) → (31,37.5) → (19,37.5) → (19,37)
| W157 NODE09 | J_A3.3 | U_MT_A.11 | (44,39) → (44,38.5) → (32.5,38.5) → (19,38.5) → (19,38)
| W158 NODE10 | J_A3.5 | U_MT_A.12 | (45,39) → (45,38.5) → (31.5,38.5) → (31.5,39.5) → (19,39.5) → (19,39)
| W159 BUS2 | U_MT_A.39 | U_MT_B.39 | (25,29) → (25,28.5) → (32,28.5) → (32,29.5) → (38,29.5) → (38,29)
| W160 BUS3 | U_MT_A.1 | U_MT_B.1 | (19,28) → (19,27.5) → (26.5,27.5) → (26.5,28.5) → (32,28.5) → (32,28)
| W161 BUS4 | U_MT_A.21 | U_MT_B.21 | (25,47) → (25,46.5) → (31.5,46.5) → (31.5,47.5) → (38,47.5) → (38,47)
| W162 BUS5 | U_MT_A.19 | U_MT_B.19 | (19,46) → (19,45.5) → (26,45.5) → (26,46.5) → (32,46.5) → (32,46)
| W163 BUS6 | U_MT_A.17 | U_MT_B.17 | (19,44) → (19,43.5) → (26.5,43.5) → (26.5,44.5) → (32,44.5) → (32,44)
| W164 BUS7 | U_MT_A.15 | U_MT_B.15 | (19,42) → (19,41.5) → (25.5,41.5) → (25.5,42.5) → (32,42.5) → (32,42)
| W165 SOURCE_HI | R_SOURCE_HI.2 | U_MT_A.13 | (56,35) → (56,34.5) → (38,34.5) → (38,40.5) → (19,40.5) → (19,40)
| W166 SOURCE_LO | R_SOURCE_LO.2 | U_MT_A.27 | (56,39) → (56,38.5) → (41.5,38.5) → (41.5,41.5) → (25,41.5) → (25,41)
| W167 DIAG_NODE | R_DIAG_TOP.1 | U_MT_A.26 | (52,49) → (52,48.5) → (38.5,48.5) → (38.5,42.5) → (25,42.5) → (25,42)
| W168 DISCHARGE | R_DISCHARGE.1 | U_MT_A.6 | (52,42) → (52,41.5) → (36,41.5) → (36,33.5) → (19,33.5) → (19,33)
| W169 CAL_LOAD | R_CAL.1 | U_MT_A.7 | (52,46) → (52,45.5) → (36.5,45.5) → (36.5,34.5) → (19,34.5) → (19,34)
| W170 NODE11 | J_B1.1 | U_MT_B.33 | (5,40) → (5,39.5) → (21.5,39.5) → (21.5,35.5) → (38,35.5) → (38,35)
| W171 NODE12 | J_B1.3 | U_MT_B.32 | (6,40) → (6,39.5) → (22,39.5) → (22,36.5) → (38,36.5) → (38,36)
| W172 NODE13 | J_B1.5 | U_MT_B.31 | (7,40) → (7,39.5) → (23.5,39.5) → (23.5,37.5) → (38,37.5) → (38,37)
| W173 NODE14 | J_B1.7 | U_MT_B.30 | (8,40) → (8,39.5) → (22.5,39.5) → (22.5,38.5) → (38,38.5) → (38,38)
| W174 NODE15 | J_B2.1 | U_MT_B.29 | (43,46) → (43,45.5) → (41,45.5) → (41,39.5) → (38,39.5) → (38,39)
| W175 NODE16 | J_B2.3 | U_MT_B.28 | (44,46) → (44,45.5) → (41.5,45.5) → (41.5,40.5) → (38,40.5) → (38,40)
| W176 NODE17 | J_B2.5 | U_MT_B.8 | (45,46) → (45,45.5) → (38.5,45.5) → (38.5,35.5) → (32,35.5) → (32,35)
| W177 NODE18 | J_B2.7 | U_MT_B.9 | (46,46) → (46,45.5) → (39,45.5) → (39,36.5) → (32,36.5) → (32,36)
| W178 NODE19 | J_B3.1 | U_MT_B.10 | (5,47) → (5,46.5) → (19.5,46.5) → (19.5,37.5) → (32,37.5) → (32,37)
| W179 NODE20 | J_B3.3 | U_MT_B.11 | (6,47) → (6,46.5) → (18.5,46.5) → (18.5,38.5) → (32,38.5) → (32,38)
| W180 NODE21 | J_B3.5 | U_MT_B.12 | (7,47) → (7,46.5) → (20,46.5) → (20,39.5) → (32,39.5) → (32,39)
| W181 SOURCE_FEED | D_SOURCE.2 | R_SOURCE_HI.1 | (56,32) → (56,31.5) → (54.5,31.5) → (54.5,35.5) → (52,35.5) → (52,35)
| W182 SOURCE_FEED | D_SOURCE.2 | R_SOURCE_LO.1 | (56,32) → (56,31.5) → (54.5,31.5) → (54.5,39.5) → (52,39.5) → (52,39)
| W183 DIAG_DIV | C_DIAG.1 | R_DIAG_BOTTOM.1 | (28,30) → (28,51) → (41,51)
| W184 DIAG_DIV | C_DIAG.1 | R_DIAG_TOP.2 | (28,30) → (28,49) → (56,49)
| W185 DIAG_DIV | C_DIAG.1 | U_DIAG.3 | (28,30) → (28,55) → (5,55)
| W186 DIAG_UNUSED | U_DIAG.6 | U_DIAG.7 | (8,55) → (8,54.5) → (8,54)
| W187 K_ADC_LED | K_ADC.1 | R_KADC_LED.2 | (17,53) → (27,53)

## Pi buttons and PN532 SPI harness

Pi uses its own rated USB supply. This harness shares ground, never a 5-V supply. PN532 carrier is Adafruit product 364; interface switches select SPI. Mount it with standoffs and use its labelled connector.

Top SVG · Mirrored underside SVG · Pin table · Wire table · Named netlist · Schematic · 3D placement

Show net

Wire-by-wire checklist (19)

Done | Wire / signal | From | To | Hole path
| W1 PI_3V3 | J_PI.1 | R_BACK.1 | (4,11) → (4,10.5) → (17.5,10.5) → (17.5,5.5) → (32,5.5) → (32,5)
| W2 PI_3V3 | J_PI.1 | R_ENERGIZE.1 | (4,11) → (4,10.5) → (14.5,10.5) → (14.5,3.5) → (25,3.5) → (25,3)
| W3 PI_3V3 | J_PI.1 | J_NFC.1 | (4,11) → (4,10.5) → (5.5,10.5) → (5.5,3.5) → (8,3.5) → (8,3)
| W4 GND | C_BACK.2 | C_ENERGIZE.2 | (13,8) → (13,7.5) → (11,7.5) → (11,8.5) → (9,8.5) → (9,8)
| W5 GND | C_BACK.2 | J_GROUND.1 | (13,8) → (13,7.5) → (15,7.5) → (15,8.5) → (16,8.5) → (16,8)
| W6 GND | C_BACK.2 | J_PI.6 | (13,8) → (13,7.5) → (9,7.5) → (9,13.5) → (5,13.5) → (5,13)
| W7 GND | C_BACK.2 | J_SW_BACK.2 | (13,8) → (13,7.5) → (18,7.5) → (18,3.5) → (22,3.5) → (22,3)
| W8 GND | C_BACK.2 | J_SW_ENERGIZE.2 | (13,8) → (13,7.5) → (15,7.5) → (15,3.5) → (17,3.5) → (17,3)
| W9 GND | C_BACK.2 | J_NFC.2 | (13,8) → (13,7.5) → (11,7.5) → (11,3.5) → (9,3.5) → (9,3)
| W10 MOSI | J_PI.19 | J_NFC.4 | (4,20) → (4,19.5) → (8.5,19.5) → (8.5,3.5) → (11,3.5) → (11,3)
| W11 MISO | J_PI.21 | J_NFC.5 | (4,21) → (4,20.5) → (7.5,20.5) → (7.5,3.5) → (12,3.5) → (12,3)
| W12 SCLK | J_PI.23 | J_NFC.3 | (4,22) → (4,21.5) → (7,21.5) → (7,3.5) → (10,3.5) → (10,3)
| W13 CE0_N | J_PI.24 | J_NFC.6 | (5,22) → (5,21.5) → (9.5,21.5) → (9.5,3.5) → (13,3.5) → (13,3)
| W14 ENERGIZE_N | C_ENERGIZE.1 | J_PI.29 | (8,8) → (8,7.5) → (5.5,7.5) → (5.5,25.5) → (4,25.5) → (4,25)
| W15 ENERGIZE_N | C_ENERGIZE.1 | J_SW_ENERGIZE.1 | (8,8) → (8,7.5) → (11.5,7.5) → (11.5,3.5) → (16,3.5) → (16,3)
| W16 ENERGIZE_N | C_ENERGIZE.1 | R_ENERGIZE.2 | (8,8) → (8,7.5) → (18.5,7.5) → (18.5,3.5) → (29,3.5) → (29,3)
| W17 BACK_N | C_BACK.1 | J_PI.31 | (12,8) → (12,7.5) → (8,7.5) → (8,26.5) → (4,26.5) → (4,26)
| W18 BACK_N | C_BACK.1 | J_SW_BACK.1 | (12,8) → (12,7.5) → (17,7.5) → (17,3.5) → (21,3.5) → (21,3)
| W19 BACK_N | C_BACK.1 | R_BACK.2 | (12,8) → (12,7.5) → (24,7.5) → (24,5.5) → (36,5.5) → (36,5)

## Manual continuity fixture — no matrix required

Connect TEST_A to A1 C4 and TEST_B to A1 C1 using removable test leads. Student supply stays OFF. Stimulus is limited by 10kΩ and isolated by a PhotoMOS switch. Unplug educational leads before ordinary operation.

Top SVG · Mirrored underside SVG · Pin table · Wire table · Named netlist · Schematic · 3D placement

Show net

Wire-by-wire checklist (48)

Done | Wire / signal | From | To | Hole path
| W1 USB_3V3 | C_ADC.1 | C_BUFFER.1 | (20,24) → (20,23.5) → (17.5,23.5) → (17.5,24.5) → (15,24.5) → (15,24)
| W2 USB_3V3 | C_ADC.1 | D_STIM.1 | (20,24) → (20,23.5) → (11.5,23.5) → (11.5,9.5) → (4,9.5) → (4,9)
| W3 USB_3V3 | C_ADC.1 | J_CONTROL.1 | (20,24) → (20,23.5) → (12.5,23.5) → (12.5,3.5) → (5,3.5) → (5,3)
| W4 USB_3V3 | C_ADC.1 | R_LED.1 | (20,24) → (20,23.5) → (22.5,23.5) → (22.5,9.5) → (25,9.5) → (25,9)
| W5 USB_3V3 | C_ADC.1 | R_SCL.1 | (20,24) → (20,23.5) → (23.5,23.5) → (23.5,3.5) → (28,3.5) → (28,3)
| W6 USB_3V3 | C_ADC.1 | R_SDA.1 | (20,24) → (20,23.5) → (20.5,23.5) → (20.5,3.5) → (21,3.5) → (21,3)
| W7 USB_3V3 | C_ADC.1 | U_ADC.8 | (20,24) → (20,23.5) → (13.5,23.5) → (13.5,33.5) → (7,33.5) → (7,33)
| W8 USB_3V3 | C_ADC.1 | U_BUFFER.8 | (20,24) → (20,23.5) → (26.5,23.5) → (26.5,24.5) → (34,24.5) → (34,24)
| W9 GND | C_A.2 | C_ADC.2 | (36,3) → (36,2.5) → (29,2.5) → (29,24.5) → (21,24.5) → (21,24)
| W10 GND | C_A.2 | C_B.2 | (36,3) → (36,2.5) → (24,2.5) → (24,22.5) → (12,22.5) → (12,22)
| W11 GND | C_A.2 | C_BUFFER.2 | (36,3) → (36,2.5) → (26,2.5) → (26,24.5) → (16,24.5) → (16,24)
| W12 GND | C_A.2 | J_CONTROL.2 | (36,3) → (36,2.5) → (21,2.5) → (21,3.5) → (6,3.5) → (6,3)
| W13 GND | C_A.2 | JP_RETURN.2 | (36,3) → (36,2.5) → (27,2.5) → (27,3.5) → (17,3.5) → (17,3)
| W14 GND | C_A.2 | Q_STIM.1 | (36,3) → (36,2.5) → (20,2.5) → (20,16.5) → (4,16.5) → (4,16)
| W15 GND | C_A.2 | R_A_BOTTOM.2 | (36,3) → (36,2.5) → (33,2.5) → (33,16.5) → (29,16.5) → (29,16)
| W16 GND | C_A.2 | R_B_BOTTOM.2 | (36,3) → (36,2.5) → (22,2.5) → (22,22.5) → (8,22.5) → (8,22)
| W17 GND | C_A.2 | R_OFF.2 | (36,3) → (36,2.5) → (36,9.5) → (36,9)
| W18 GND | C_A.2 | U_ADC.1 | (36,3) → (36,2.5) → (20,2.5) → (20,31.5) → (4,31.5) → (4,31)
| W19 GND | C_A.2 | U_ADC.3 | (36,3) → (36,2.5) → (20,2.5) → (20,33.5) → (4,33.5) → (4,33)
| W20 GND | C_A.2 | U_ADC.6 | (36,3) → (36,2.5) → (22,2.5) → (22,35.5) → (7,35.5) → (7,35)
| W21 GND | C_A.2 | U_ADC.7 | (36,3) → (36,2.5) → (22,2.5) → (22,34.5) → (7,34.5) → (7,34)
| W22 GND | C_A.2 | U_BUFFER.4 | (36,3) → (36,2.5) → (34,2.5) → (34,27.5) → (31,27.5) → (31,27)
| W23 FIX_SDA | J_CONTROL.3 | R_SDA.2 | (7,3) → (7,2.5) → (16.5,2.5) → (16.5,3.5) → (25,3.5) → (25,3)
| W24 FIX_SDA | J_CONTROL.3 | U_ADC.9 | (7,3) → (7,2.5) → (7.5,2.5) → (7.5,32.5) → (7,32.5) → (7,32)
| W25 FIX_SCL | J_CONTROL.4 | R_SCL.2 | (8,3) → (8,2.5) → (19.5,2.5) → (19.5,3.5) → (32,3.5) → (32,3)
| W26 FIX_SCL | J_CONTROL.4 | U_ADC.10 | (8,3) → (8,2.5) → (7.5,2.5) → (7.5,31.5) → (7,31.5) → (7,31)
| W27 FIX_STIM | J_CONTROL.5 | Q_STIM.2 | (9,3) → (9,2.5) → (7,2.5) → (7,16.5) → (5,16.5) → (5,16)
| W28 FIX_STIM | J_CONTROL.5 | R_OFF.1 | (9,3) → (9,2.5) → (21,2.5) → (21,9.5) → (32,9.5) → (32,9)
| W29 TEST_A | J_TEST.1 | K_STIM.4 | (12,3) → (12,2.5) → (17.5,2.5) → (17.5,10.5) → (22,10.5) → (22,10)
| W30 TEST_A | J_TEST.1 | R_A_TOP.1 | (12,3) → (12,2.5) → (11.5,2.5) → (11.5,16.5) → (9,16.5) → (9,16)
| W31 TEST_B | J_TEST.2 | JP_RETURN.1 | (13,3) → (13,2.5) → (14.5,2.5) → (14.5,3.5) → (16,3.5) → (16,3)
| W32 TEST_B | J_TEST.2 | R_B_TOP.1 | (13,3) → (13,2.5) → (14.5,2.5) → (14.5,18.5) → (16,18.5) → (16,18)
| W33 STIM_FEED | D_STIM.2 | R_STIM.1 | (8,9) → (8,8.5) → (10,8.5) → (10,9.5) → (11,9.5) → (11,9)
| W34 STIM_LIMIT | K_STIM.3 | R_STIM.2 | (22,11) → (22,10.5) → (19.5,10.5) → (19.5,9.5) → (15,9.5) → (15,9)
| W35 STIM_LED_A | K_STIM.1 | R_LED.2 | (19,10) → (19,9.5) → (23.5,9.5) → (29,9.5) → (29,9)
| W36 STIM_LED_K | K_STIM.2 | Q_STIM.3 | (19,11) → (19,10.5) → (13,10.5) → (13,16.5) → (6,16.5) → (6,16)
| W37 DIV_A | C_A.1 | R_A_BOTTOM.1 | (35,3) → (35,16) → (25,16)
| W38 DIV_A | C_A.1 | R_A_TOP.2 | (35,3) → (35,16) → (13,16)
| W39 DIV_A | C_A.1 | U_BUFFER.3 | (35,3) → (35,26) → (31,26)
| W40 BUF_A | R_ADC_A.1 | U_BUFFER.1 | (32,16) → (32,24) → (31,24)
| W41 BUF_A | R_ADC_A.1 | U_BUFFER.2 | (32,16) → (32,25) → (31,25)
| W42 ADC_A | R_ADC_A.2 | U_ADC.4 | (36,16) → (36,34) → (4,34)
| W43 DIV_B | C_B.1 | R_B_BOTTOM.1 | (11,22) → (4,22)
| W44 DIV_B | C_B.1 | R_B_TOP.2 | (11,22) → (11,18) → (20,18)
| W45 DIV_B | C_B.1 | U_BUFFER.5 | (11,22) → (11,27) → (34,27)
| W46 BUF_B | R_ADC_B.1 | U_BUFFER.6 | (24,22) → (24,26) → (34,26)
| W47 BUF_B | R_ADC_B.1 | U_BUFFER.7 | (24,22) → (24,25) → (34,25)
| W48 ADC_B | R_ADC_B.2 | U_ADC.5 | (28,22) → (28,35) → (4,35)

## USB test-source breadboard

Temporary 400-tie breadboard fixture; identify its actual row and rail breaks before wiring. Only the switch GPIO is a control signal. Educational power comes from USB through a 560Ω hardware limiter. Disconnect this source before installing the final supply. Never connect two sources to the same bank.

Top SVG · Mirrored underside SVG · Pin table · Wire table · Named netlist · Schematic · 3D placement

Show net

Wire-by-wire checklist (13)

Done | Wire / signal | From | To | Hole path
| W1 USB_5V | J_CONTROL.1 | Q_PASS.3 | (13,2) → (13,1.5) → (7.5,1.5) → (7.5,12.5) → (2,12.5) → (2,12)
| W2 USB_5V | J_CONTROL.1 | R_GATE_OFF.2 | (13,2) → (13,1.5) → (8.5,1.5) → (8.5,14.5) → (4,14.5) → (4,14)
| W3 USB_3V3 | C_USB.1 | J_CONTROL.2 | (9,3) → (9,2.5) → (11,2.5) → (11,3.5) → (13,3.5) → (13,3)
| W4 GND | C_USB.2 | J_CONTROL.3 | (9,4) → (9,3.5) → (11.5,3.5) → (11.5,4.5) → (13,4.5) → (13,4)
| W5 GND | C_USB.2 | J_OUTPUT.2 | (9,4) → (9,3.5) → (11.5,3.5) → (11.5,24.5) → (13,24.5) → (13,24)
| W6 GND | C_USB.2 | Q_ENABLE.1 | (9,4) → (9,3.5) → (6.5,3.5) → (6.5,17.5) → (2,17.5) → (2,17)
| W7 GND | C_USB.2 | R_ENABLE_OFF.2 | (9,4) → (9,3.5) → (8.5,3.5) → (8.5,22.5) → (6,22.5) → (6,22)
| W8 EDU_PWR_EN | J_CONTROL.4 | Q_ENABLE.2 | (13,5) → (13,4.5) → (7.5,4.5) → (7.5,18.5) → (2,18.5) → (2,18)
| W9 EDU_PWR_EN | J_CONTROL.4 | R_ENABLE_OFF.1 | (13,5) → (13,4.5) → (9.5,4.5) → (9.5,18.5) → (6,18.5) → (6,18)
| W10 PROTO_GATE | Q_ENABLE.3 | Q_PASS.1 | (2,19) → (2,10)
| W11 PROTO_GATE | Q_ENABLE.3 | R_GATE_OFF.1 | (2,19) → (2,10) → (4,10)
| W12 PROTO_DRAIN | Q_PASS.2 | R_LIMIT.1 | (2,11) → (2,10.5) → (4.5,10.5) → (4.5,11.5) → (6,11.5) → (6,11)
| W13 USB_TEST_LIMITED | J_OUTPUT.1 | R_LIMIT.2 | (13,11) → (13,10.5) → (10.5,10.5) → (10.5,11.5) → (9,11.5) → (9,11)

Cable pin mappings · External interfaces · Immutable hardware inventory · Adapter quantities · Software verification
