gefgu/integration-workshop-3/eletronics/perfboard/field-guide/cp00-field-guide.pdf

## CP00 — First light

85

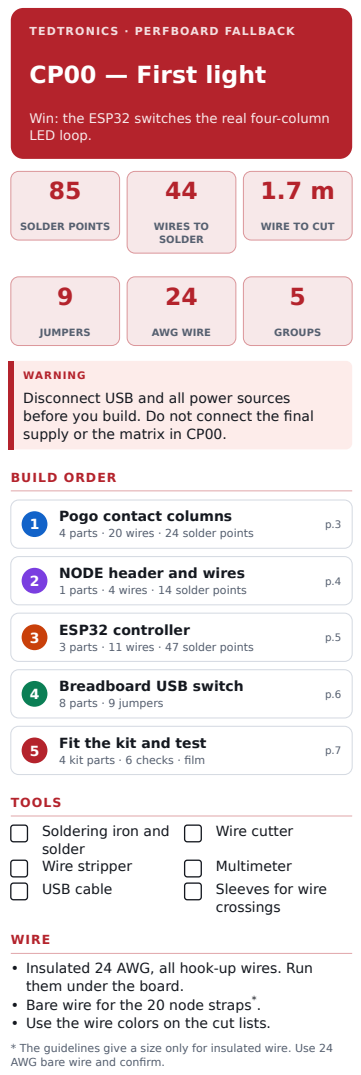
[picture p123: page 1]
SOLDER POINTS; WIRES TO SOLDER; JUMPERS; AWG WIRE; GROUPS; BUILD ORDER; TOOLS; Wire cutter; Wire stripper; Multimeter; USB cable; Sleeves for wire; crossings; WIRE

TEDTRON ICS · PERFBOARD FALLBACK

Win: the ESP32 switches the real four-column
LED loop.

WIRE TO CUT

WARN ING
Disconnect USB and all power sources
before you build. Do not connect the final
supply or the matrix in CP00.

Pogo contact columns
4 parts · 20 wires · 24 solder points

NODE header and wires
1 parts · 4 wires · 14 solder points

ESP32 controller
3 parts · 11 wires · 47 solder points

Breadboard USB switch
8 parts · 9 jumpers

Fit the kit and test
4 kit parts · 6 checks · film

Soldering iron and
solder

• Insulated 24 AWG, all hook-up wires. Run
them under the board.
• Bare wire for the 20 node straps*
• Use the wire colors on the cut lists.

* The guidelines give a size only for insulated wire. Use 24
AWG bare wire and confirm.

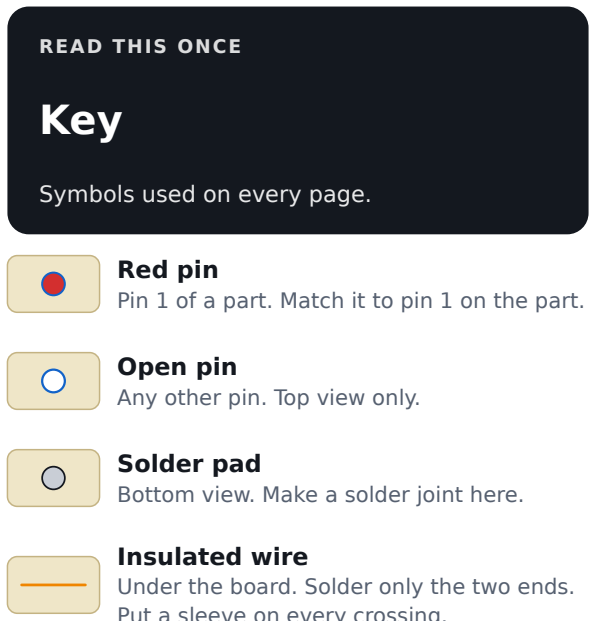
[picture p124: figure]
READ TH IS ONCE; Key; Symbols used on every page.; Red pin; Open pin Any other pin. Top view only.; Solder pad Bottom view. Make a solder joint here.; Insulated wire

Pin 1 of a part. Match it to pin 1 on the part.

Under the board. Solder only the two ends. Put a sleeve on every crossing.

Bare strap
Joins the pins of one column. Touch no other column.

Part body
Top view. Colored = this group. Dashed gray = built earlier.

Row tie
Breadboard. The row already joins these holes. Add no jumper.

TWO VIEWS OF A PERFBOARD

Numbers on the edges are the top hole numbers. They are the same on both views.

- TOP: look at the part side.
- BOTTOM (mirrored): turn the board over left-to-right. Column 1 is now on the right.

WORDS

WARN ING
A warning tells you about a risk to people or to the board. Read it first.

CAUT ION
A caution tells you about a risk to a part or to a measurement.

NOTE
A note gives extra information.

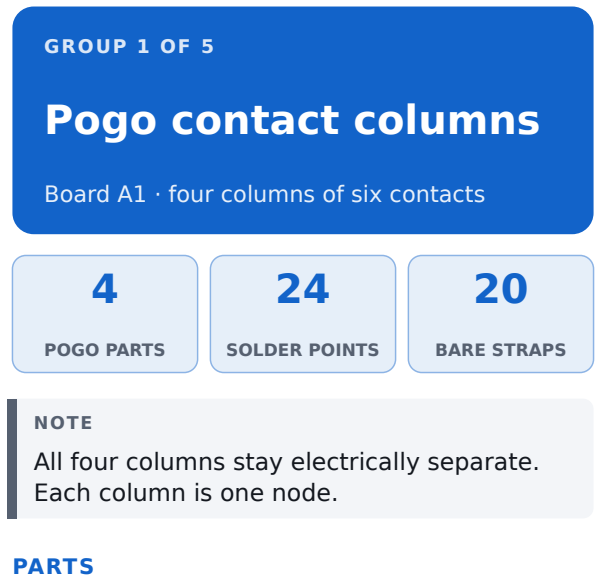
[picture p125: figure]
GROUP 1 OF 5; Pogo contact columns; Board A1 · four columns of six contacts; POGO PARTS; SOLDER POINTS; BARE STRAPS; NOTE; Each column is one node.; PARTS

All four columns stay electrically separate.

REF | PART | PINS
J_NODE00 NODE00 — six contacts | 6
J_NODE01 NODE01 — six contacts | 6
J_NODE02 NODE02 — six contacts | 6
J_NODE03 NODE03 — six contacts | 6

CUT LIST

20 × 17 mm

Bare wire, 24 AWG. 4 pad gaps (10.2 mm) plus 6 mm for the ends.

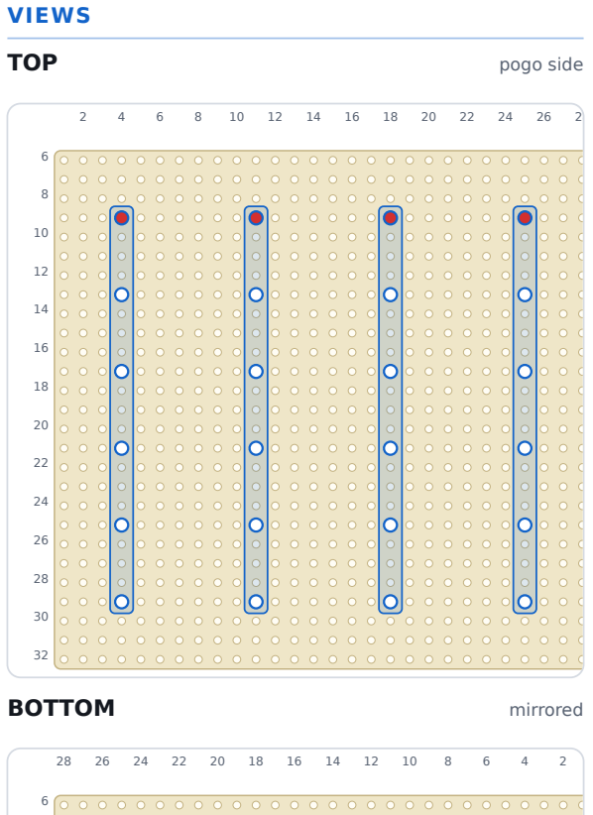
[picture p126: figure]
VIEWS; TOP; pogo side; BOTTOM; mirrored
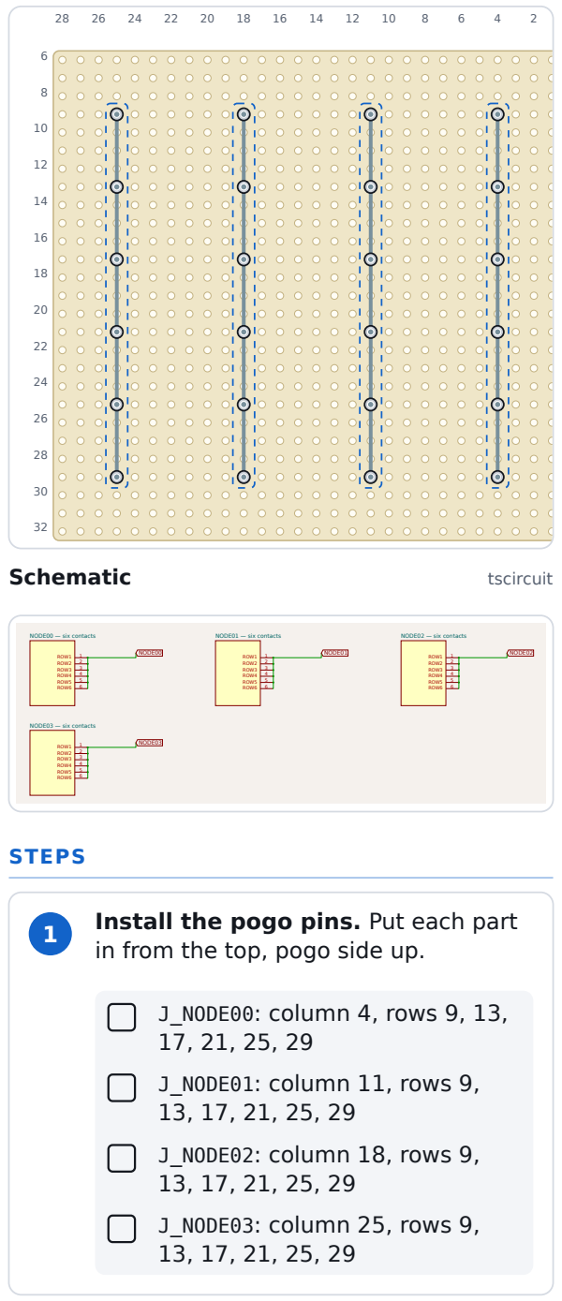
[picture p127: figure]
Schematic; tscircuit; NODE00 — six contacts; 1 ROW1 2 ROW2 3 ROW3 4 ROW4 5 ROW5 6 ROW6; NODE01 — six contacts; NODE02 — six contacts; NODE03 — six contacts; NODE00; NODE01; NODE02; NODE03; STEPS; Install the pogo pins. Put each part in from the top, pogo side up.; J_NODE00: column 4, rows 9, 13, 17, 21, 25, 29; J_NODE01: column 11, rows 9, 13, 17, 21, 25, 29; J_NODE02: column 18, rows 9, 13, 17, 21, 25, 29; J_NODE03: column 25, rows 9, 13, 17, 21, 25, 29
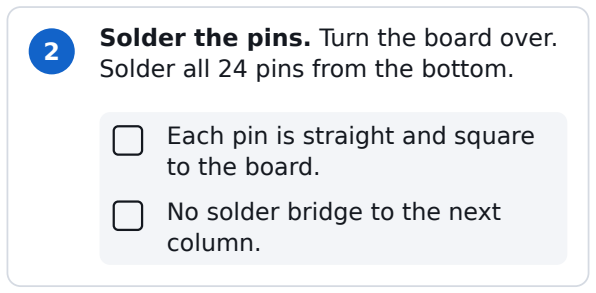
[picture p128: figure]
Solder the pins. Turn the board over. Solder all 24 pins from the bottom.; Each pin is straight and square to the board.; No solder bridge to the next column.

3

Cut 20 bare straps, each 17 mm.

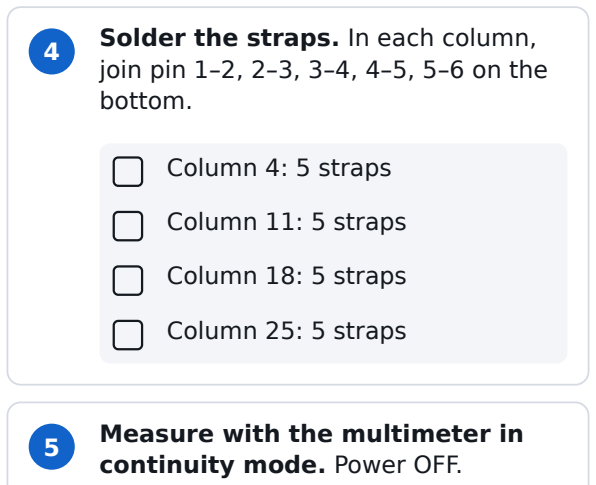
[picture p129: figure]
Solder the straps. In each column, join pin 1–2, 2–3, 3–4, 4–5, 5–6 on the bottom.; Column 4: 5 straps; Column 11: 5 straps; Column 18: 5 straps; Column 25: 5 straps; Measure with the multimeter in continuity mode. Power OFF.
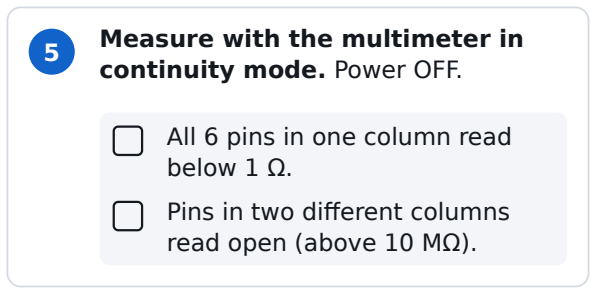
[picture p130: figure]
All 6 pins in one column read below 1 Ω.; Pins in two different columns read open (above 10 MΩ).

## NODE header and wires

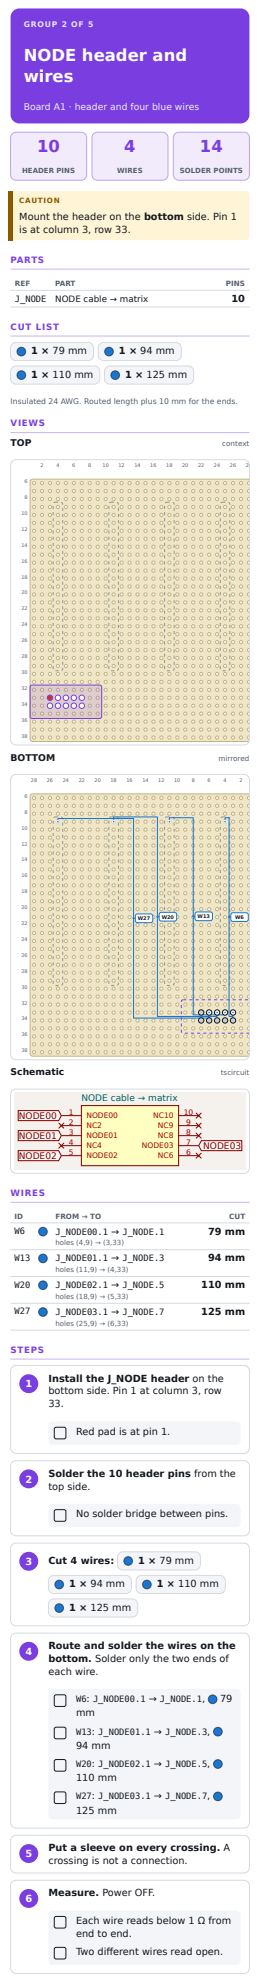
[picture p131: page 4]
GROUP 2 OF 5; HEADER PINS; WIRES; SOLDER POINTS; PARTS; REF; PART; PINS; J_NODE NODE cable → matrix; CUT LIST; VIEWS; TOP; context; BOTTOM; mirrored; Schematic; tscircuit; NODE00; NODE01; NODE02; 7 NODE03; 10 NODE00; NODE03; FROM → TO; CUT; J_NODE00.1 → J_NODE.1; holes (4,9) → (3,33); J_NODE01.1 → J_NODE.3; holes (11,9) → (4,33); J_NODE02.1 → J_NODE.5; holes (18,9) → (5,33); J_NODE03.1 → J_NODE.7; holes (25,9) → (6,33); STEPS; Cut 4 wires:; W6: J_NODE00.1 → J_NODE.1,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

Board A1 · header and four blue wires

CAUT ION
Mount the header on the bottom side. Pin 1
is at column 3, row 33.

Insulated 24 AWG. Routed length plus 10 mm for the ends.

NODE cable → matrix

Install the J_NODE header on the
bottom side. Pin 1 at column 3, row

Red pad is at pin 1.

Solder the 10 header pins from the
top side.

No solder bridge between pins.

Route and solder the wires on the
bottom. Solder only the two ends of
each wire.

Put a sleeve on every crossing. A
crossing is not a connection.

Measure. Power OFF.

Each wire reads below 1 Ω from
end to end.
Two different wires read open.

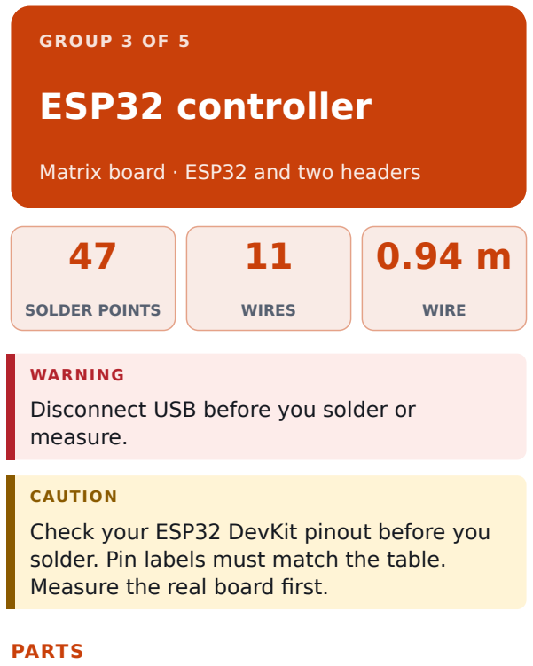
[picture p132: figure]
GROUP 3 OF 5; ESP32 controller; Matrix board · ESP32 and two headers; SOLDER POINTS; WIRES; WIRE; WARN ING; Disconnect USB before you solder or measure.; CAUT ION; Measure the real board first.; PARTS

Check your ESP32 DevKit pinout before you solder. Pin labels must match the table.

REF | PART | PINS
U_ESP1 | ESP32 DevKitC-38 — router ESP32-DevKitC V4 ESP32-WROOM-32E
38

J_FIXTURE manual continuity fixture;
ESP1 GPIO4 SDA / GPIO16
SCL / GPIO25 stimulus

5

J_PROTOTYPE USB breadboard prototype; remove before final rail
connection

4

CUT LIST

1 × 36 mm | 1 × 36 mm
1 × 56 mm | 1 × 71 mm
1 × 79 mm | 2 × 89 mm
1 × 110 mm | 1 × 115 mm
1 × 120 mm | 1 × 143 mm

Insulated 24 AWG. Routed length plus 10 mm for the ends.

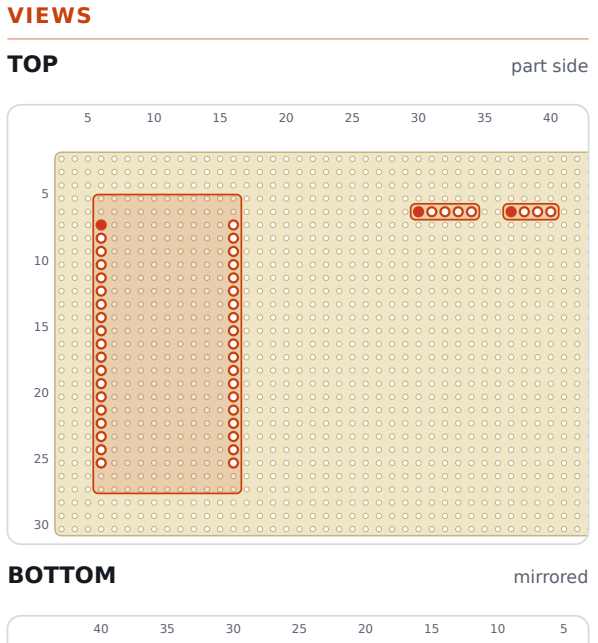
[picture p133: figure]
VIEWS; TOP; part side; BOTTOM; mirrored
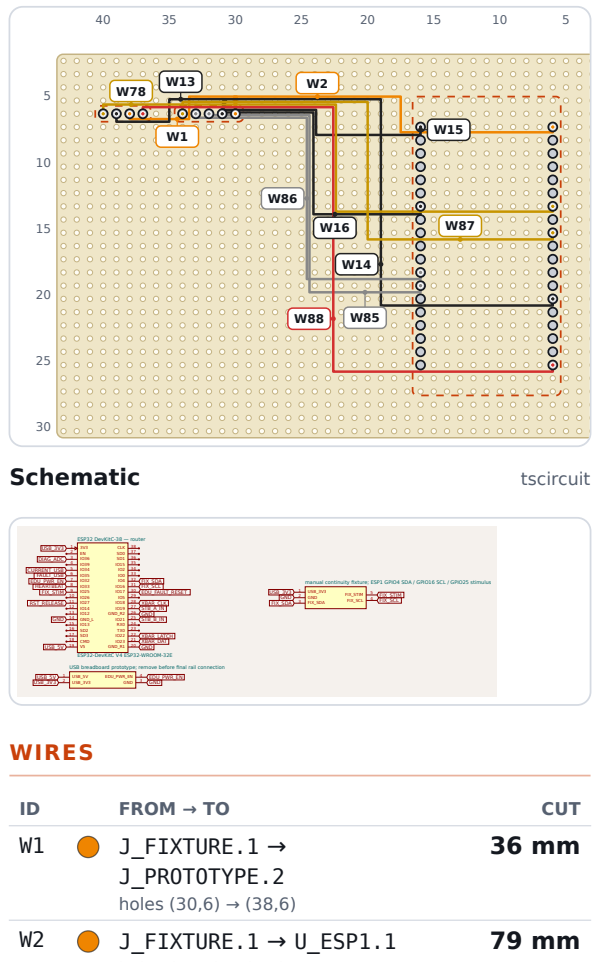
[picture p134: figure]
Schematic; tscircuit; ESP32-DevKitC V4 ESP32-WROOM-32E; ESP32 DevKitC-38 — router 1; GND_L 15; CMD; 20 GND_R1; 26 GND_R2; 38 CLK; GND; FIX_SDA; 4 FIX_SCL; 5 FIX_STIM; USB_5V; USB_3V3; 3 GND; 4 EDU_PWR_EN; XBAR_DAT; XBAR_CLK; XBAR_LATCH; STB_A_IN; STB_B_IN; RST_RELEASE; HEARTBEAT EDU_PWR_EN; EDU_PWR_EN; FAULT_USB; EDU_FAULT_RESET; CURRENT_USB; DIAG_ADC; FIX_SCL; FIX_STIM; WIRES; FROM → TO; CUT; J_FIXTURE.1 →; J_PROTOTYPE.2; holes (30,6) → (38,6); J_FIXTURE.1 → U_ESP1.1

manual continuity fixture; ESP1 GPIO4 SDA / GPIO16 SCL / GPIO25 stimulus 1 USB_3V3

USB breadboard prototype; remove before final rail connection

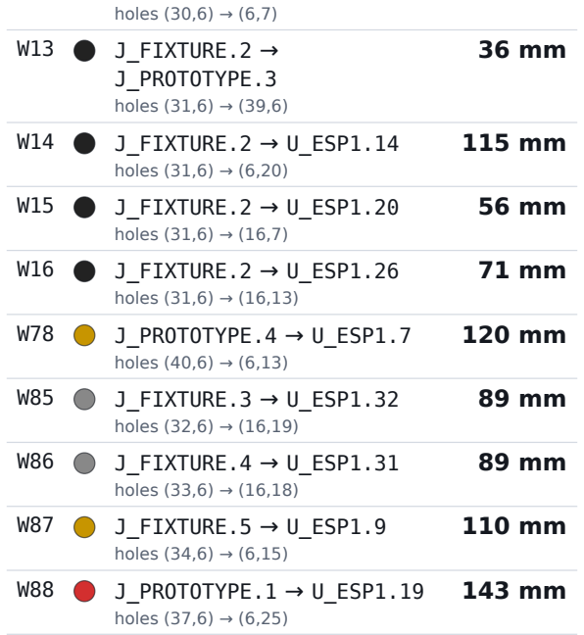
[picture p135: figure]
holes (30,6) → (6,7); J_FIXTURE.2 →; J_PROTOTYPE.3; holes (31,6) → (39,6); J_FIXTURE.2 → U_ESP1.14; holes (31,6) → (6,20); J_FIXTURE.2 → U_ESP1.20; holes (31,6) → (16,7); J_FIXTURE.2 → U_ESP1.26; holes (31,6) → (16,13); J_PROTOTYPE.4 → U_ESP1.7; holes (40,6) → (6,13); J_FIXTURE.3 → U_ESP1.32; holes (32,6) → (16,19); J_FIXTURE.4 → U_ESP1.31; holes (33,6) → (16,18); J_FIXTURE.5 → U_ESP1.9; holes (34,6) → (6,15); J_PROTOTYPE.1 → U_ESP1.19; holes (37,6) → (6,25)

STEPS

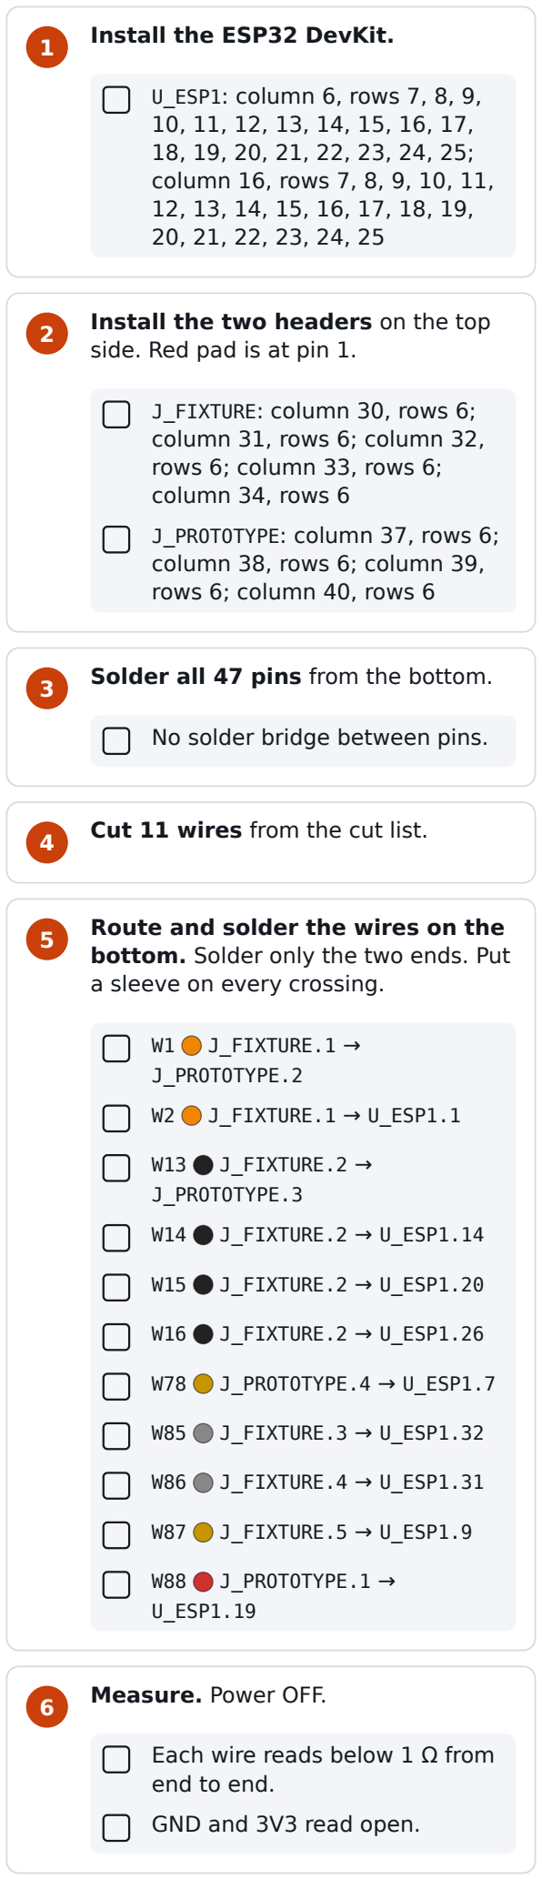
[picture p136: figure]
Install the ESP32 DevKit.; U_ESP1: column 6, rows 7, 8, 9, 10, 11, 12, 13, 14, 15, 16, 17, 18, 19, 20, 21, 22, 23, 24, 25; column 16, rows 7, 8, 9, 10, 11, 12, 13, 14, 15, 16, 17, 18, 19, 20, 21, 22, 23, 24, 25; Install the two headers on the top side. Red pad is at pin 1.; J_FIXTURE: column 30, rows 6; column 31, rows 6; column 32, rows 6; column 33, rows 6; column 34, rows 6; J_PROTOTYPE: column 37, rows 6; column 38, rows 6; column 39, rows 6; column 40, rows 6; Solder all 47 pins from the bottom.; No solder bridge between pins.; Cut 11 wires from the cut list.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

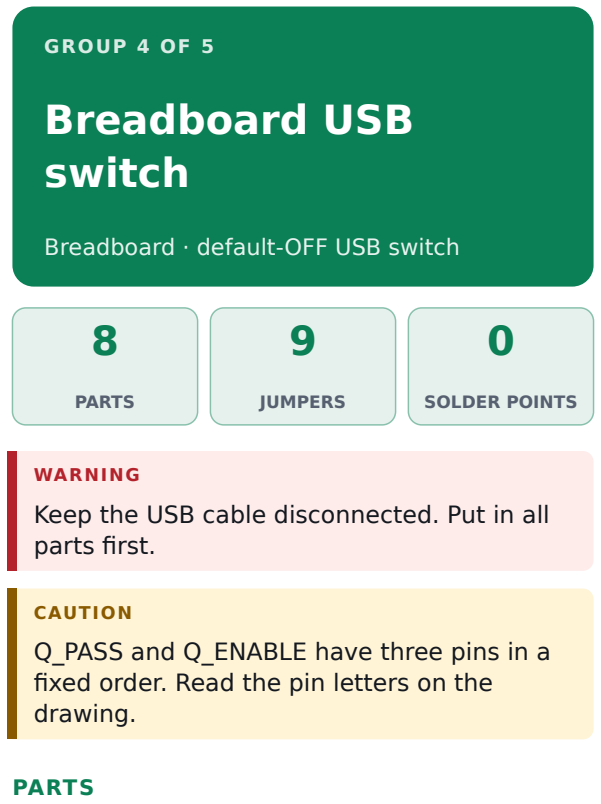
[picture p137: figure]
GROUP 4 OF 5; Breadboard USB switch; Breadboard · default-OFF USB switch; PARTS; JUMPERS; SOLDER POINTS; WARN ING; parts first.; CAUT ION; drawing.

Keep the USB cable disconnected. Put in all

Q_PASS and Q_ENABLE have three pins in a fixed order. Read the pin letters on the

REF | PART | PINS
J_CONTROL | Four individual flying leads
from ESP1 prototype header

4

Q_PASS | USB high-side switch NDP6020P
3
Q_ENABLE | 3.3V gate-control transistor 2N7000
3

R_GATE_OFF 10kΩ makes the P-channel switch OFF · 10k

| MFR-25FBF52-10K

2

R_ENABLE_OFF 100kΩ holds enable LOW · 100k

MFR-25FBF52-100K

2

R_LIMIT | 560Ω ±1%, 0.25W; bounds every educational-source path · 560 MFR-25FBF52-560R
2
J_OUTPUT | Two flying leads: C2 positive / C1 return
2
C_USB | USB3V3 fixture decoupling ·
100nF
| C315C104K5R5TA

2

TOP VIEW

BREADBOARD | rows a–e and f–j are joined

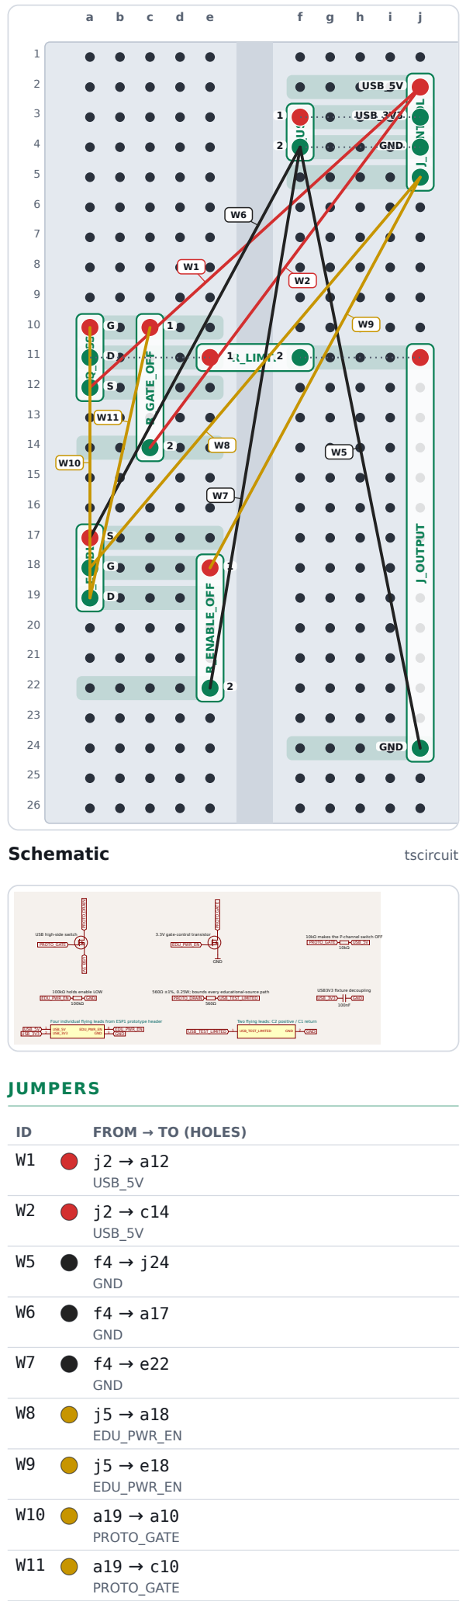
[picture p138: figure]
J_CONTROL; USB_5V; USB_3V3; GND; Q_PASS; Q_ENABLE; R_GATE_OFF; R_ENABLE_OFF; 1R_LIMIT²; J_OUTPUT; C_USB; Schematic; tscircuit; 3 GND; 4 EDU_PWR_EN; 100kΩ holds enable LOW; USB_TEST_LIMITED; 2 GND; USB3V3 fixture decoupling; EDU_PWR_EN; PROTO_GATE; PROTO_DRAIN; JUMPERS; FROM → TO (HOLES)

Four individual flying leads from ESP1 prototype header 1 | USB_5V
USB high-side switch | 3.3V gate-control transistor | 10kΩ makes the P-channel switch OFF

560Ω ±1%, 0.25W; bounds every educational-source path

Two flying leads: C2 positive / C1 return

No jumper for 4 row ties. The breadboard rows already join them.

STEPS

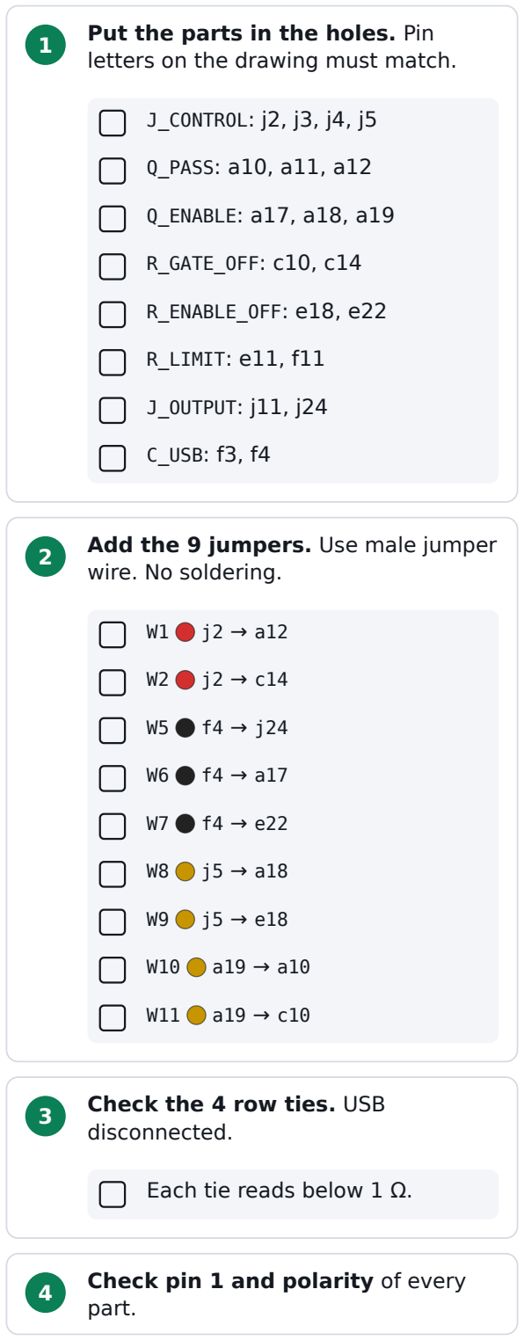
[picture p139: figure]
Put the parts in the holes. Pin letters on the drawing must match.; J_CONTROL: j2, j3, j4, j5; Q_PASS: a10, a11, a12; Q_ENABLE: a17, a18, a19; R_GATE_OFF: c10, c14; R_ENABLE_OFF: e18, e22; R_LIMIT: e11, f11; J_OUTPUT: j11, j24; C_USB: f3, f4; Add the 9 jumpers. Use male jumper wire. No soldering.; Check the 4 row ties. USB disconnected.; Each tie reads below 1 Ω.; Check pin 1 and polarity of every part.

## Fit the kit and test

1

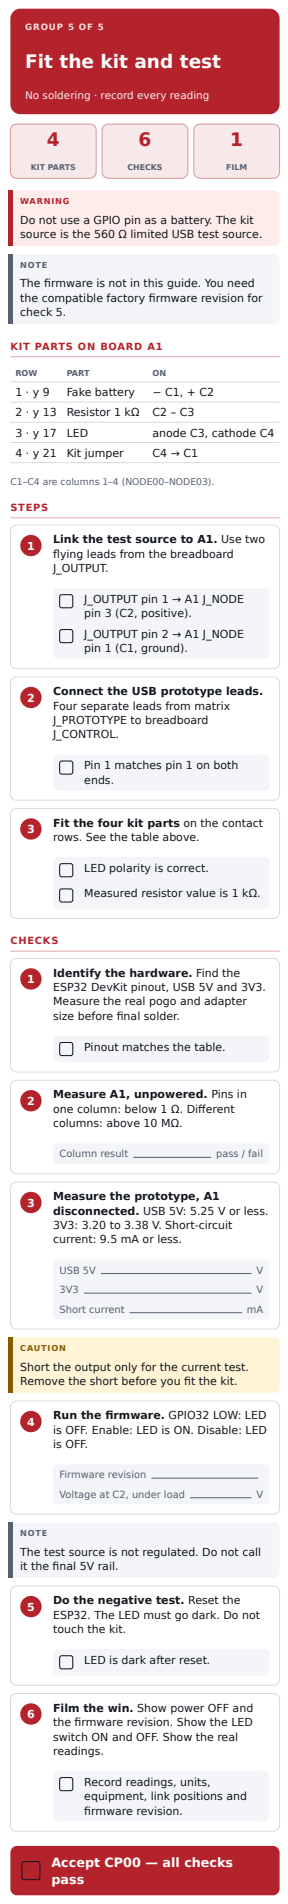
[picture p140: page 7]
GROUP 5 OF 5; KIT PARTS; CHECKS; FILM; ROW; PART; Fake battery; 2 · y 13 Resistor 1 kΩ C2 – C3; 3 · y 17 LED; anode C3, cathode C4; 4 · y 21 Kit jumper; C1–C4 are columns 1–4 (NODE00–NODE03).; STEPS; J_OUTPUT pin 1 → A1 J_NODE pin 3 (C2, positive).; J_OUTPUT pin 2 → A1 J_NODE pin 1 (C1, ground).; Column result; pass / fail; USB 5V; Short current; Firmware revision; Voltage at C2, under load

No soldering · record every reading

WARN ING
Do not use a GPIO pin as a battery. The kit
source is the 560 Ω limited USB test source.

NOTE
The firmware is not in this guide. You need
the compatible factory firmware revision for
check 5.

KIT PARTS ON BOARD A1

Link the test source to A1. Use two
flying leads from the breadboard
J_OUTPUT.

Connect the USB prototype leads.
Four separate leads from matrix
J_PROTOTYPE to breadboard
J_CONTROL.

Pin 1 matches pin 1 on both
ends.

Fit the four kit parts on the contact
rows. See the table above.

LED polarity is correct.

Measured resistor value is 1 kΩ.

Identify the hardware. Find the
ESP32 DevKit pinout, USB 5V and 3V3.
Measure the real pogo and adapter
size before final solder.

Pinout matches the table.

Measure A1, unpowered. Pins in
one column: below 1 Ω. Different
columns: above 10 MΩ.

Measure the prototype, A1
disconnected. USB 5V: 5.25 V or less.
3V3: 3.20 to 3.38 V. Short-circuit
current: 9.5 mA or less.

CAUT ION
Short the output only for the current test.
Remove the short before you fit the kit.

Run the firmware. GPIO32 LOW: LED
is OFF. Enable: LED is ON. Disable: LED
is OFF.

The test source is not regulated. Do not call
it the final 5V rail.

Do the negative test. Reset the
ESP32. The LED must go dark. Do not
touch the kit.

LED is dark after reset.

Film the win. Show power OFF and
the firmware revision. Show the LED
switch ON and OFF. Show the real
readings.

Record readings, units,
equipment, link positions and
firmware revision.

Accept CP00 — all checks
pass
