gefgu/integration-workshop-3/eletronics/perfboard/tscircuit/smart-perfboard/wiring-guide-historico-antes-RC522.pdf

## Wiring group 1/31: V3V3_EXT

Insulated underside wires only. TOP coordinates are retained in the mirrored view. Dashed guides identify endpoints, not qualified physical routes. Crossings are not joints.

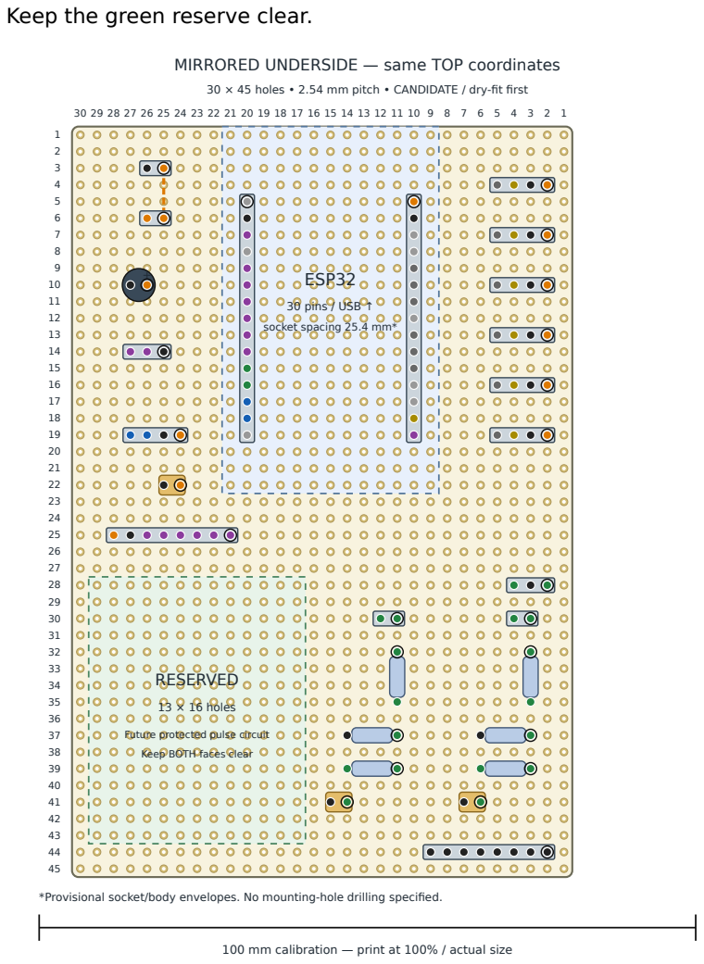
[picture p141: figure]
Keep the green reserve clear.; ESP32; 30 pins / USB ↑; socket spacing 25.4 mm*; RESERVED; 13 × 16 holes; Future protected pulse circuit; Keep BOTH faces clear

MIRRORED UNDERSIDE — same TOP coordinates

30 × 45 holes • 2.54 mm pitch • CANDIDATE / dry-fit first

30 29 28 27 26 25 24 23 22 21 20 19 18 17 16 15 14 13 12 11 10 9 8 7 6 5 4 3 2 1

*Provisional socket/body envelopes. No mounting-hole drilling specified.

100 mm calibration — print at 100% / actual size

Wire / net | From | To
W001 / V3V3_EXT | J_POWER.1 C25, R3 | JP_EXT.1 C25, R6

## Wiring group 2/31: V3V3_BOARD 1

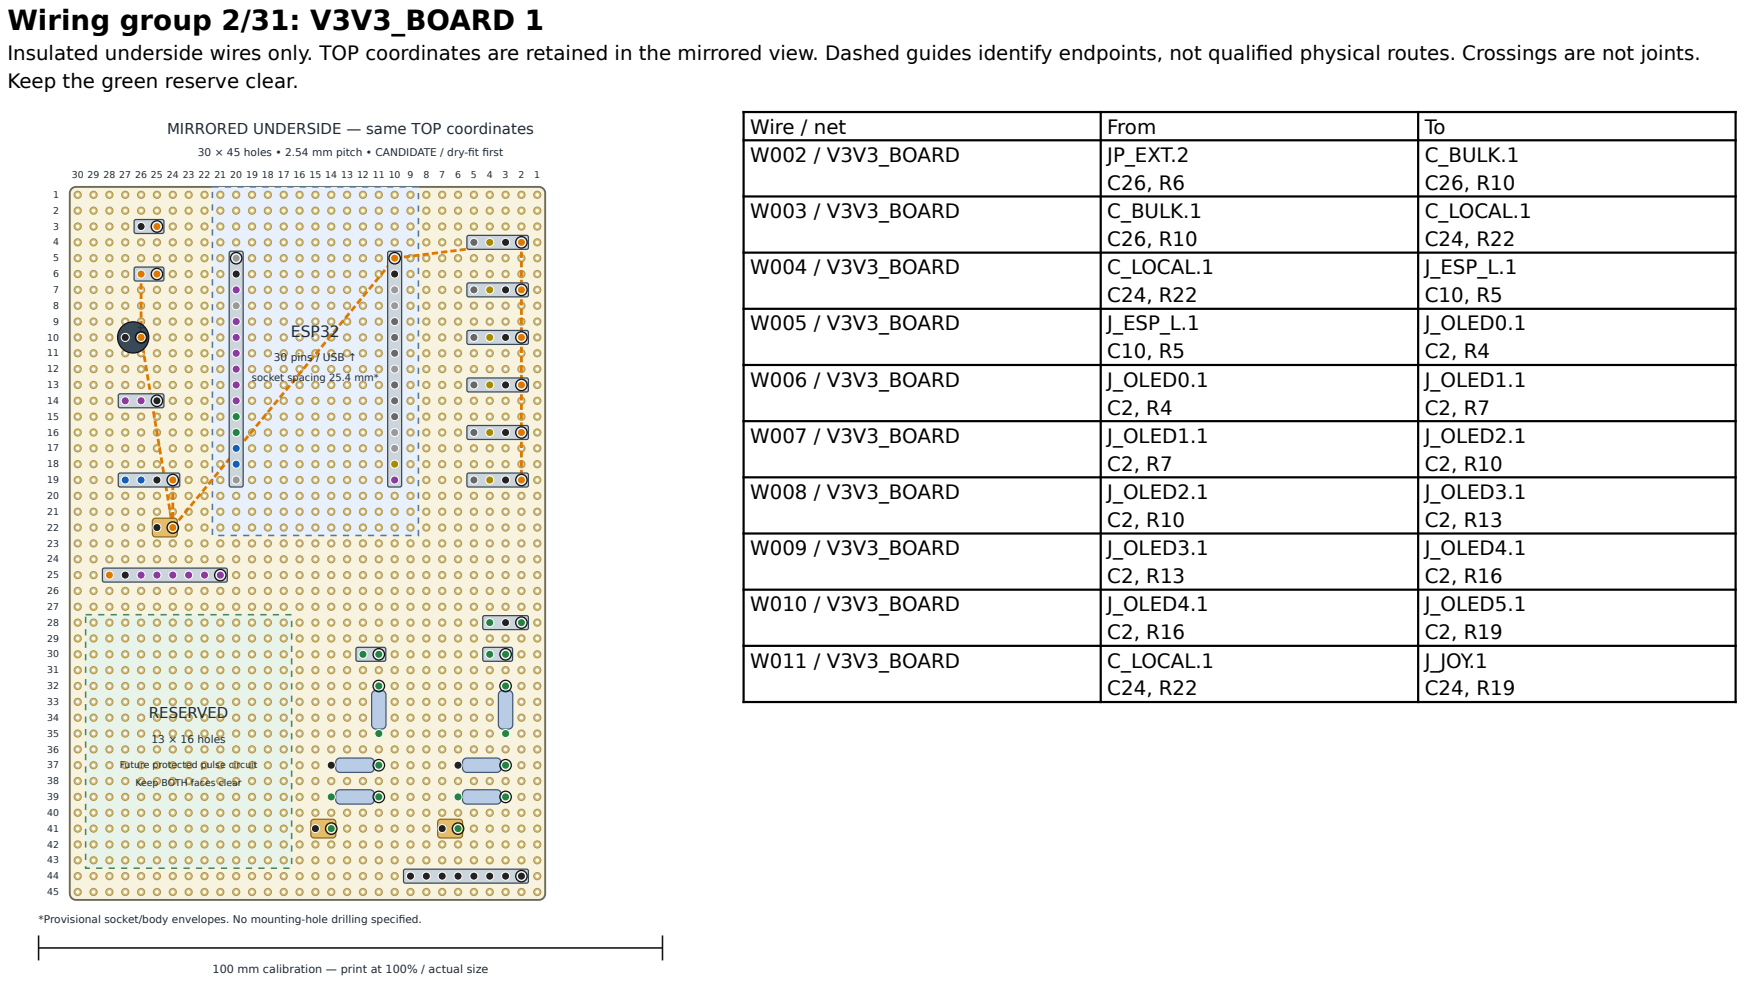
[picture p142: page 2]

Insulated underside wires only. TOP coordinates are retained in the mirrored view. Dashed guides identify endpoints, not qualified physical routes. Crossings are not joints.
Keep the green reserve clear.

MIRRORED UNDERSIDE — same TOP coordinates

Wire / net | From | To
W002 / V3V3_BOARD | JP_EXT.2 C26, R6 | C_BULK.1 C26, R10

30 × 45 holes • 2.54 mm pitch • CANDIDATE / dry-fit first

W003 / V3V3_BOARD | C_BULK.1 C26, R10 | C_LOCAL.1 C24, R22

W004 / V3V3_BOARD | C_LOCAL.1 C24, R22 | J_ESP_L.1 C10, R5

W005 / V3V3_BOARD | J_ESP_L.1 C10, R5 | J_OLED0.1 C2, R4

W006 / V3V3_BOARD | J_OLED0.1 C2, R4 | J_OLED1.1 C2, R7

W007 / V3V3_BOARD | J_OLED1.1 C2, R7 | J_OLED2.1 C2, R10

W008 / V3V3_BOARD | J_OLED2.1 C2, R10 | J_OLED3.1 C2, R13

W009 / V3V3_BOARD | J_OLED3.1 C2, R13 | J_OLED4.1 C2, R16

W010 / V3V3_BOARD | J_OLED4.1 C2, R16 | J_OLED5.1 C2, R19

W011 / V3V3_BOARD | C_LOCAL.1 C24, R22 | J_JOY.1 C24, R19

Future protected pulse circuit

Keep BOTH faces clear

*Provisional socket/body envelopes. No mounting-hole drilling specified.

100 mm calibration — print at 100% / actual size

## Wiring group 3/31: V3V3_BOARD 2

Insulated underside wires only. TOP coordinates are retained in the mirrored view. Dashed guides identify endpoints, not qualified physical routes. Crossings are not joints.

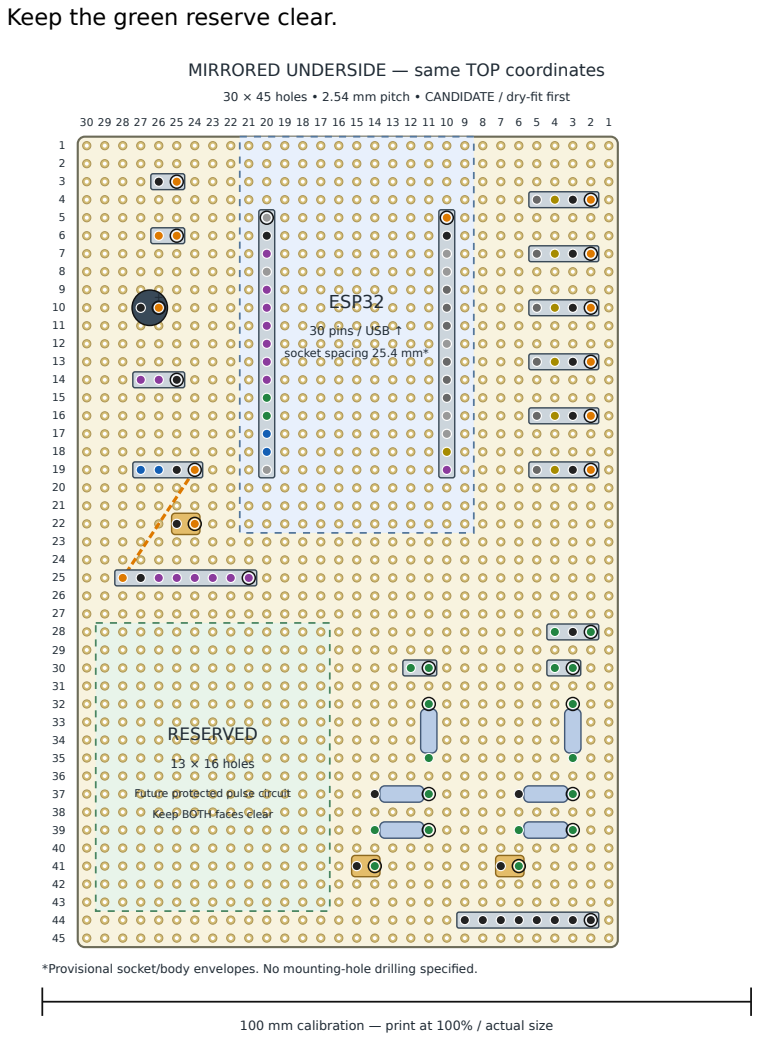
[picture p143: figure]
Keep the green reserve clear.; ESP32; 30 pins / USB ↑; socket spacing 25.4 mm*; RESERVED; 13 × 16 holes; Future protected pulse circuit; Keep BOTH faces clear

MIRRORED UNDERSIDE — same TOP coordinates

30 × 45 holes • 2.54 mm pitch • CANDIDATE / dry-fit first

30 29 28 27 26 25 24 23 22 21 20 19 18 17 16 15 14 13 12 11 10 9 8 7 6 5 4 3 2 1

*Provisional socket/body envelopes. No mounting-hole drilling specified.

100 mm calibration — print at 100% / actual size

Wire / net | From | To
W012 / V3V3_BOARD | J_JOY.1 C24, R19 | J_EXP.8 C28, R25

## Wiring group 4/31: GND 1

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

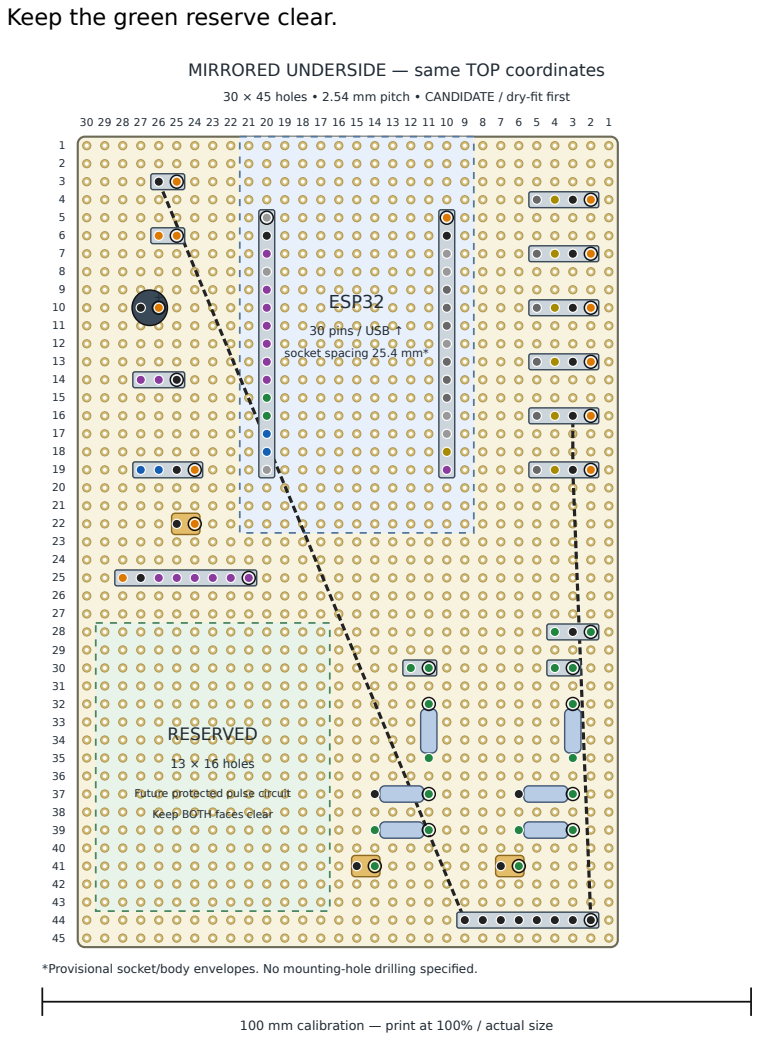
[picture p144: figure]
Keep the green reserve clear.; ESP32; 30 pins / USB ↑; socket spacing 25.4 mm*; RESERVED; 13 × 16 holes; Future protected pulse circuit; Keep BOTH faces clear

MIRRORED UNDERSIDE — same TOP coordinates

30 × 45 holes • 2.54 mm pitch • CANDIDATE / dry-fit first

30 29 28 27 26 25 24 23 22 21 20 19 18 17 16 15 14 13 12 11 10 9 8 7 6 5 4 3 2 1

*Provisional socket/body envelopes. No mounting-hole drilling specified.

100 mm calibration — print at 100% / actual size

Wire / net | From | To
W013 / GND | J_GND.1 C2, R44 | J_GND.2 C3, R44
W014 / GND | J_GND.2 C3, R44 | J_GND.3 C4, R44
W015 / GND | J_GND.3 C4, R44 | J_GND.4 C5, R44
W016 / GND | J_GND.4 C5, R44 | J_GND.5 C6, R44
W017 / GND | J_GND.5 C6, R44 | J_GND.6 C7, R44
W018 / GND | J_GND.6 C7, R44 | J_GND.7 C8, R44
W019 / GND | J_GND.7 C8, R44 | J_GND.8 C9, R44
W020 / GND | J_POWER.2 C26, R3 | J_GND.8 C9, R44
W021 / GND | J_GND.1 C2, R44 | J_OLED5.2 C3, R19
W022 / GND | J_OLED5.2 C3, R19 | J_OLED4.2 C3, R16

## Wiring group 5/31: GND 2

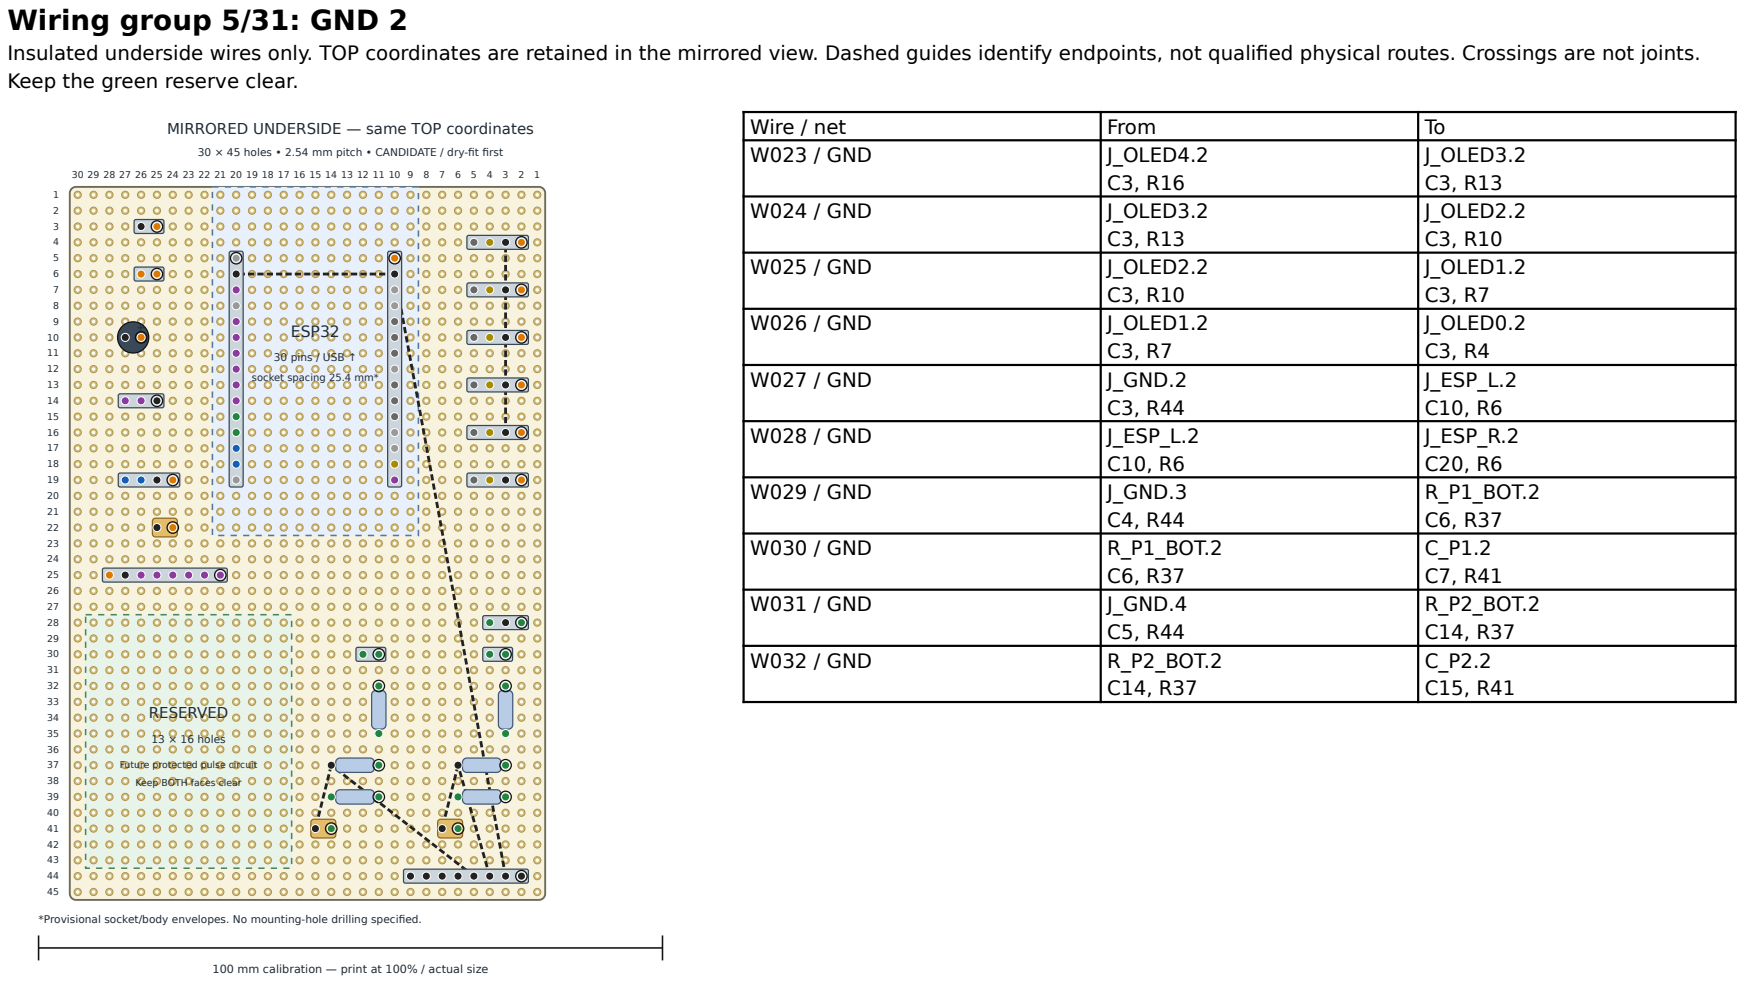
[picture p145: page 5]

Insulated underside wires only. TOP coordinates are retained in the mirrored view. Dashed guides identify endpoints, not qualified physical routes. Crossings are not joints.
Keep the green reserve clear.

MIRRORED UNDERSIDE — same TOP coordinates

Wire / net | From | To
W023 / GND | J_OLED4.2 C3, R16 | J_OLED3.2 C3, R13

30 × 45 holes • 2.54 mm pitch • CANDIDATE / dry-fit first

W024 / GND | J_OLED3.2 C3, R13 | J_OLED2.2 C3, R10

W025 / GND | J_OLED2.2 C3, R10 | J_OLED1.2 C3, R7

W026 / GND | J_OLED1.2 C3, R7 | J_OLED0.2 C3, R4

W027 / GND | J_GND.2 C3, R44 | J_ESP_L.2 C10, R6

W028 / GND | J_ESP_L.2 C10, R6 | J_ESP_R.2 C20, R6

W029 / GND | J_GND.3 C4, R44 | R_P1_BOT.2 C6, R37

W030 / GND | R_P1_BOT.2 C6, R37 | C_P1.2 C7, R41

W031 / GND | J_GND.4 C5, R44 | R_P2_BOT.2 C14, R37

W032 / GND | R_P2_BOT.2 C14, R37 | C_P2.2 C15, R41

Future protected pulse circuit

Keep BOTH faces clear

*Provisional socket/body envelopes. No mounting-hole drilling specified.

100 mm calibration — print at 100% / actual size

## Wiring group 6/31: GND 3

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

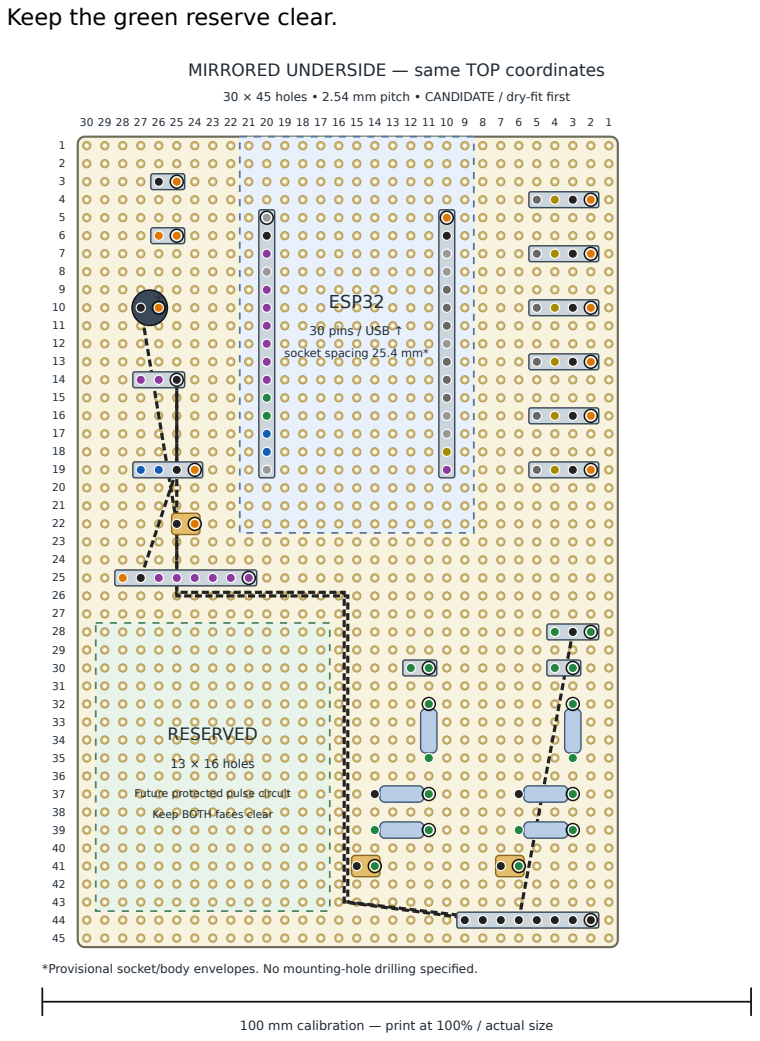
[picture p146: figure]
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

MIRRORED UNDERSIDE — same TOP coordinates

30 × 45 holes • 2.54 mm pitch • CANDIDATE / dry-fit first

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

*Provisional socket/body envelopes. No mounting-hole drilling specified.

100 mm calibration — print at 100% / actual size

Wire / net | From | To
W033 / GND | J_GND.5 C6, R44 | J_SENSE.2 C3, R28
W034 / GND | J_GND.6 C7, R44 | C_LOCAL.2 C25, R22
W035 / GND | C_LOCAL.2 C25, R22 | C_BULK.2 C27, R10
W036 / GND | J_GND.7 C8, R44 | J_UART.1 C25, R14
W037 / GND | J_UART.1 C25, R14 | J_JOY.2 C25, R19
W038 / GND | J_JOY.2 C25, R19 | J_EXP.7 C27, R25

## Wiring group 7/31: SCL

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

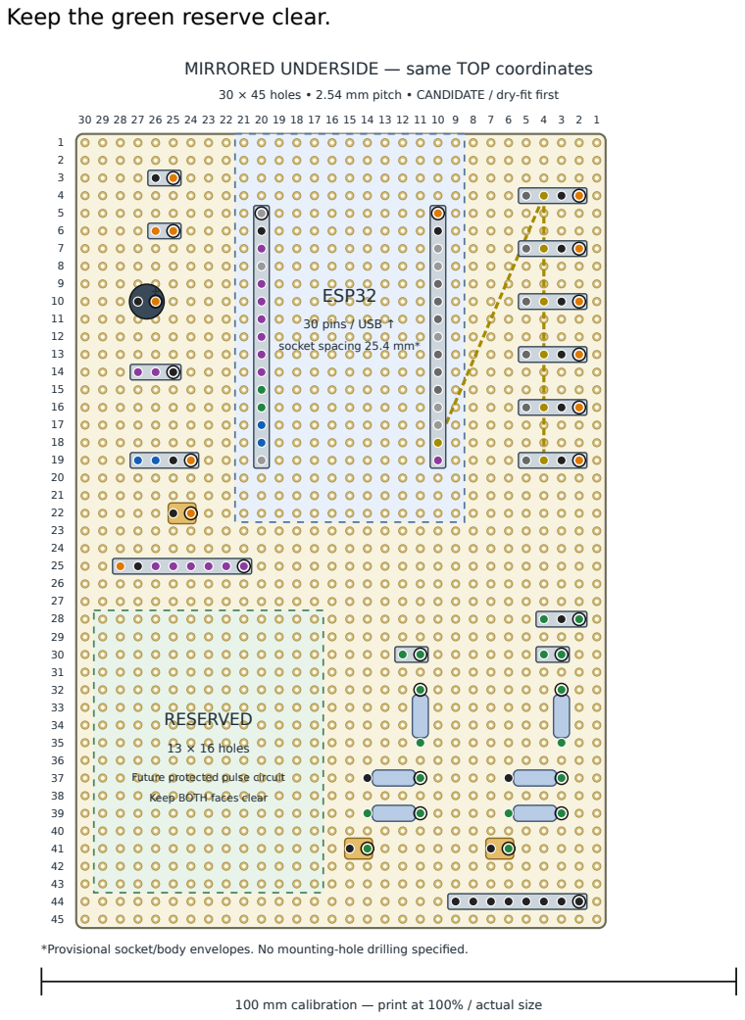
[picture p147: figure]
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

MIRRORED UNDERSIDE — same TOP coordinates

30 × 45 holes • 2.54 mm pitch • CANDIDATE / dry-fit first

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

*Provisional socket/body envelopes. No mounting-hole drilling specified.

100 mm calibration — print at 100% / actual size

Wire / net | From | To
W039 / SCL | J_ESP_L.14 C10, R18 | J_OLED0.3 C4, R4
W040 / SCL | J_OLED0.3 C4, R4 | J_OLED1.3 C4, R7
W041 / SCL | J_OLED1.3 C4, R7 | J_OLED2.3 C4, R10
W042 / SCL | J_OLED2.3 C4, R10 | J_OLED3.3 C4, R13
W043 / SCL | J_OLED3.3 C4, R13 | J_OLED4.3 C4, R16
W044 / SCL | J_OLED4.3 C4, R16 | J_OLED5.3 C4, R19

## Wiring group 8/31: SDA_0

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

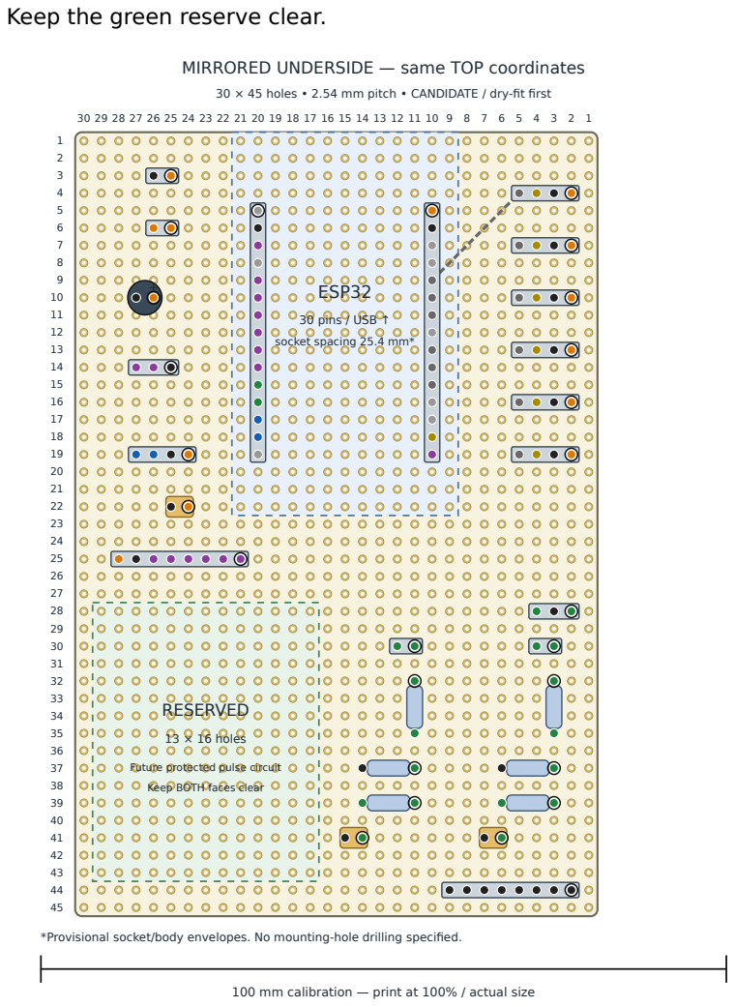
[picture p148: figure]
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

MIRRORED UNDERSIDE — same TOP coordinates

30 × 45 holes • 2.54 mm pitch • CANDIDATE / dry-fit first

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

*Provisional socket/body envelopes. No mounting-hole drilling specified.

100 mm calibration — print at 100% / actual size

Wire / net | From | To
W045 / SDA_0 | J_ESP_L.5 C10, R9 | J_OLED0.4 C5, R4

## Wiring group 9/31: SDA_1

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

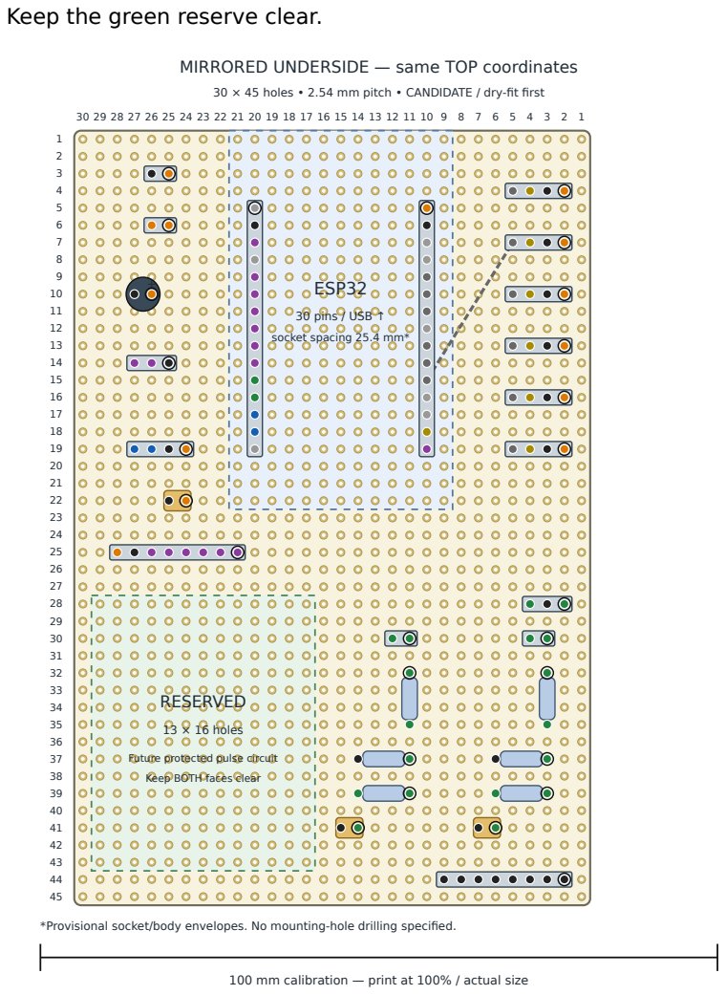
[picture p149: figure]
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

MIRRORED UNDERSIDE — same TOP coordinates

30 × 45 holes • 2.54 mm pitch • CANDIDATE / dry-fit first

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

*Provisional socket/body envelopes. No mounting-hole drilling specified.

100 mm calibration — print at 100% / actual size

Wire / net | From | To
W046 / SDA_1 | J_ESP_L.11 C10, R15 | J_OLED1.4 C5, R7

## Wiring group 10/31: SDA_2

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

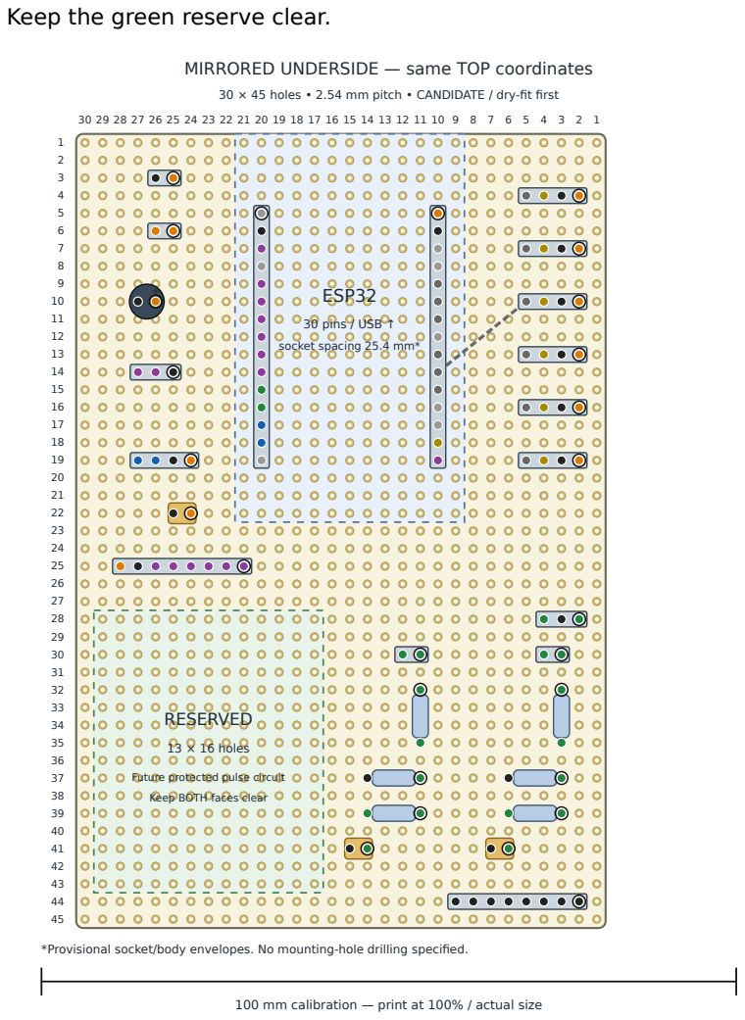
[picture p150: figure]
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

MIRRORED UNDERSIDE — same TOP coordinates

30 × 45 holes • 2.54 mm pitch • CANDIDATE / dry-fit first

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

*Provisional socket/body envelopes. No mounting-hole drilling specified.

100 mm calibration — print at 100% / actual size

Wire / net | From | To
W047 / SDA_2 | J_ESP_L.10 C10, R14 | J_OLED2.4 C5, R10

## Wiring group 11/31: SDA_3

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

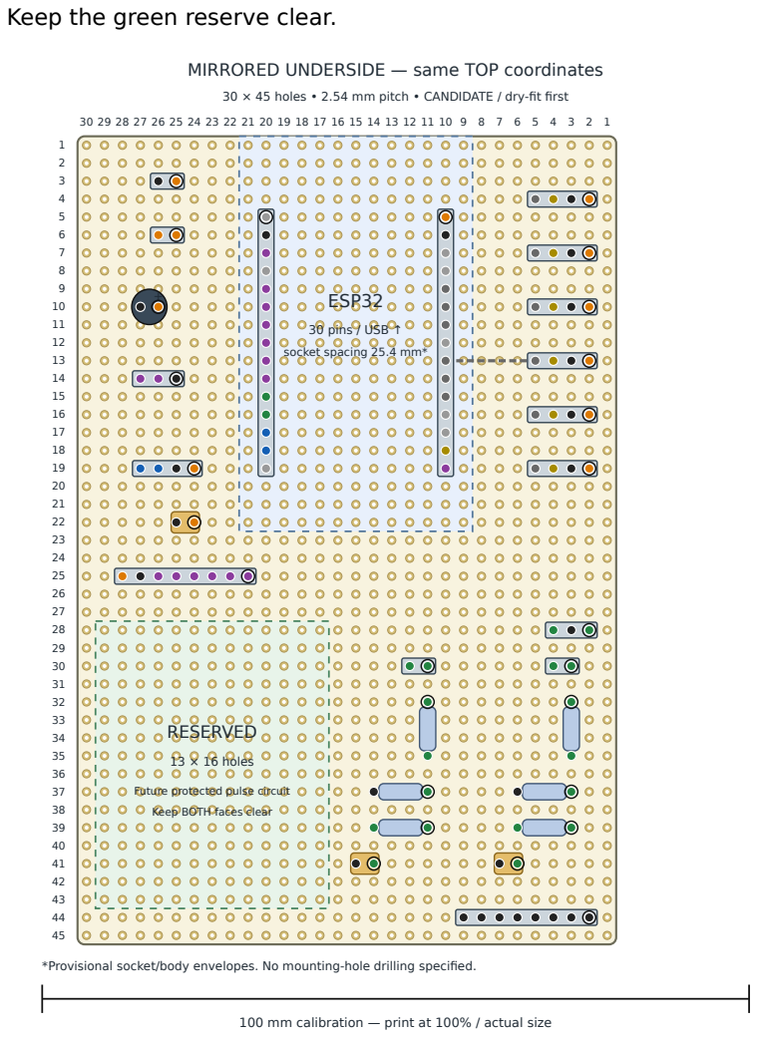
[picture p151: figure]
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

MIRRORED UNDERSIDE — same TOP coordinates

30 × 45 holes • 2.54 mm pitch • CANDIDATE / dry-fit first

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

*Provisional socket/body envelopes. No mounting-hole drilling specified.

100 mm calibration — print at 100% / actual size

Wire / net | From | To
W048 / SDA_3 | J_ESP_L.9 C10, R13 | J_OLED3.4 C5, R13

## Wiring group 12/31: SDA_4

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

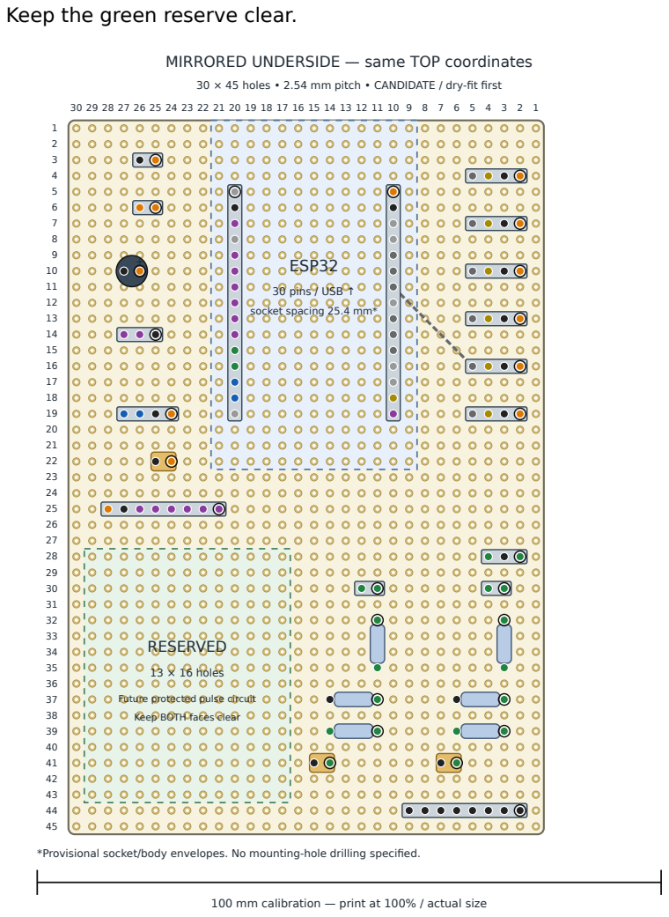
[picture p152: figure]
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

MIRRORED UNDERSIDE — same TOP coordinates

30 × 45 holes • 2.54 mm pitch • CANDIDATE / dry-fit first

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

*Provisional socket/body envelopes. No mounting-hole drilling specified.

100 mm calibration — print at 100% / actual size

Wire / net | From | To
W049 / SDA_4 | J_ESP_L.7 C10, R11 | J_OLED4.4 C5, R16

## Wiring group 13/31: SDA_5

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

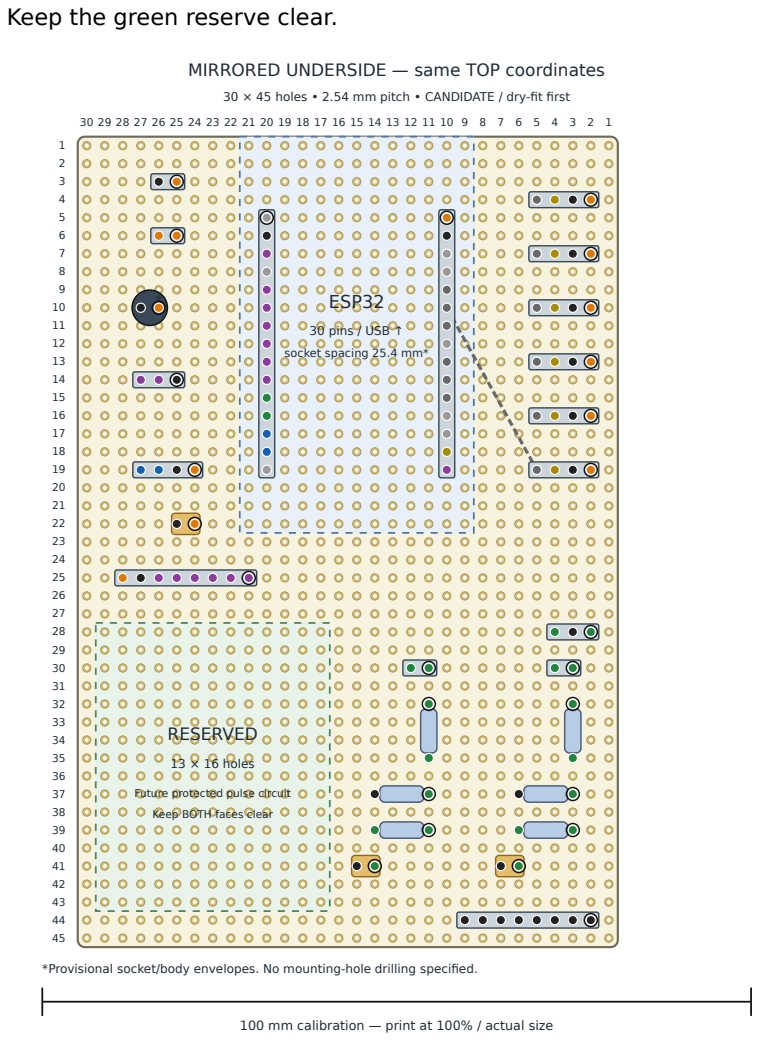
[picture p153: figure]
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

MIRRORED UNDERSIDE — same TOP coordinates

30 × 45 holes • 2.54 mm pitch • CANDIDATE / dry-fit first

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

*Provisional socket/body envelopes. No mounting-hole drilling specified.

100 mm calibration — print at 100% / actual size

Wire / net | From | To
W050 / SDA_5 | J_ESP_L.6 C10, R10 | J_OLED5.4 C5, R19

## Wiring group 14/31: JOY_X

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

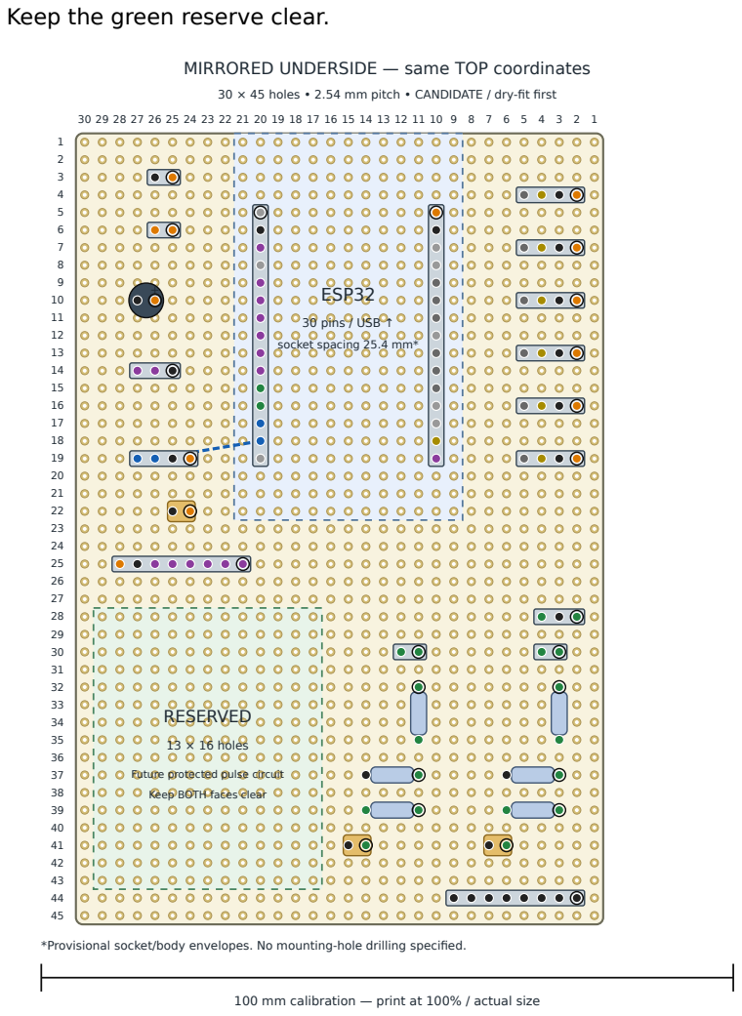
[picture p154: figure]
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

MIRRORED UNDERSIDE — same TOP coordinates

30 × 45 holes • 2.54 mm pitch • CANDIDATE / dry-fit first

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

*Provisional socket/body envelopes. No mounting-hole drilling specified.

100 mm calibration — print at 100% / actual size

Wire / net | From | To
W051 / JOY_X | J_ESP_R.14 C20, R18 | J_JOY.3 C26, R19

## Wiring group 15/31: JOY_Y

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

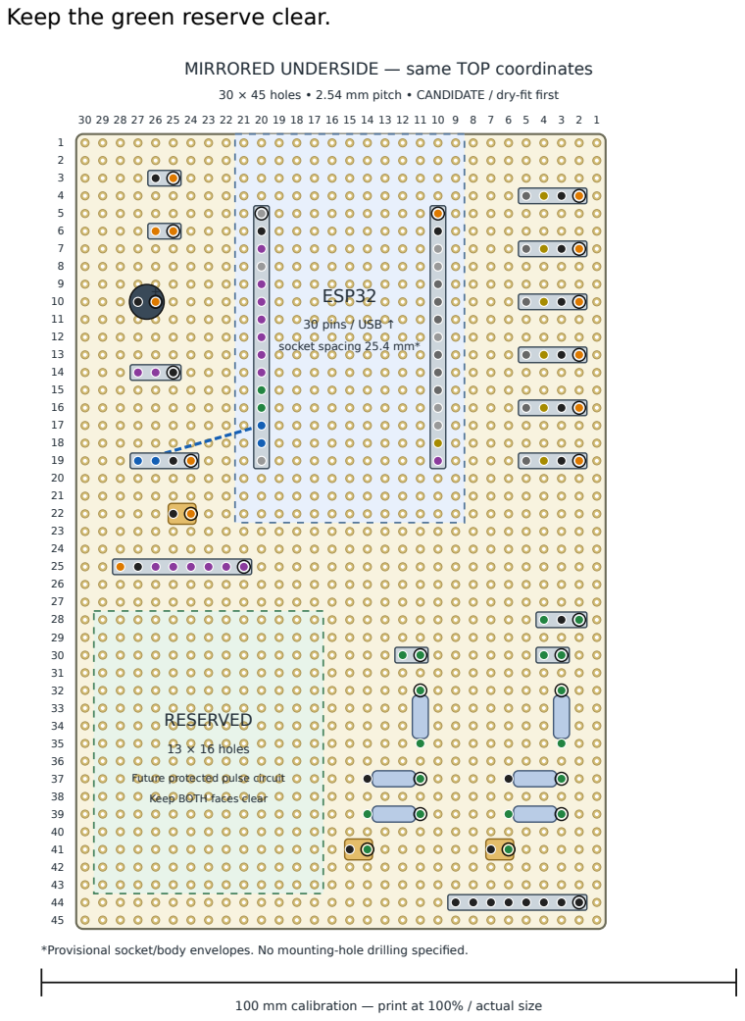
[picture p155: figure]
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

MIRRORED UNDERSIDE — same TOP coordinates

30 × 45 holes • 2.54 mm pitch • CANDIDATE / dry-fit first

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

*Provisional socket/body envelopes. No mounting-hole drilling specified.

100 mm calibration — print at 100% / actual size

Wire / net | From | To
W052 / JOY_Y | J_ESP_R.13 C20, R17 | J_JOY.4 C27, R19

## Wiring group 16/31: UART_TX

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

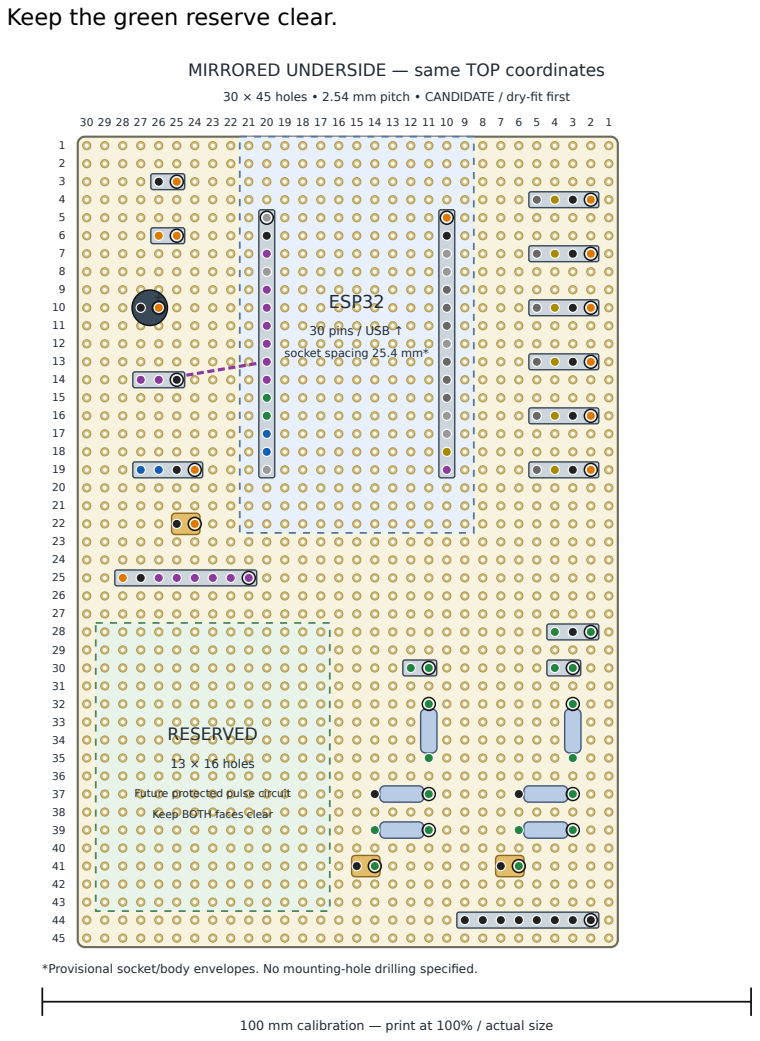
[picture p156: figure]
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

MIRRORED UNDERSIDE — same TOP coordinates

30 × 45 holes • 2.54 mm pitch • CANDIDATE / dry-fit first

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

*Provisional socket/body envelopes. No mounting-hole drilling specified.

100 mm calibration — print at 100% / actual size

Wire / net | From | To
W053 / UART_TX | J_ESP_R.9 C20, R13 | J_UART.2 C26, R14

## Wiring group 17/31: UART_RX

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

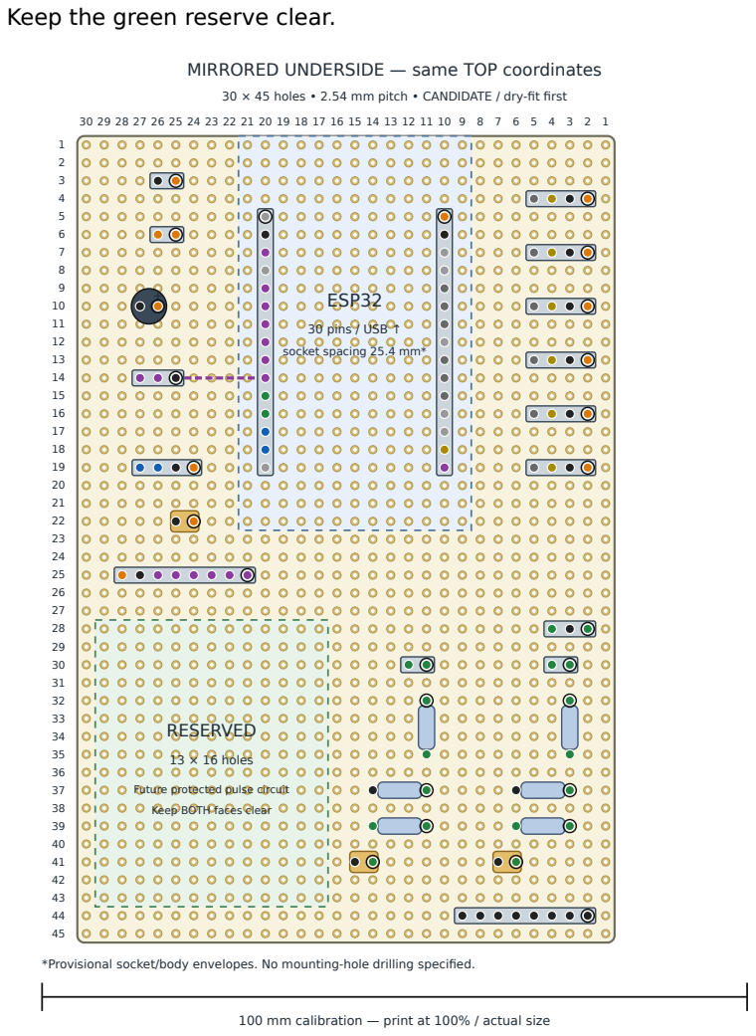
[picture p157: figure]
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

MIRRORED UNDERSIDE — same TOP coordinates

30 × 45 holes • 2.54 mm pitch • CANDIDATE / dry-fit first

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

*Provisional socket/body envelopes. No mounting-hole drilling specified.

100 mm calibration — print at 100% / actual size

Wire / net | From | To
W054 / UART_RX | J_ESP_R.10 C20, R14 | J_UART.3 C27, R14

## Wiring group 18/31: P1_RAW

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

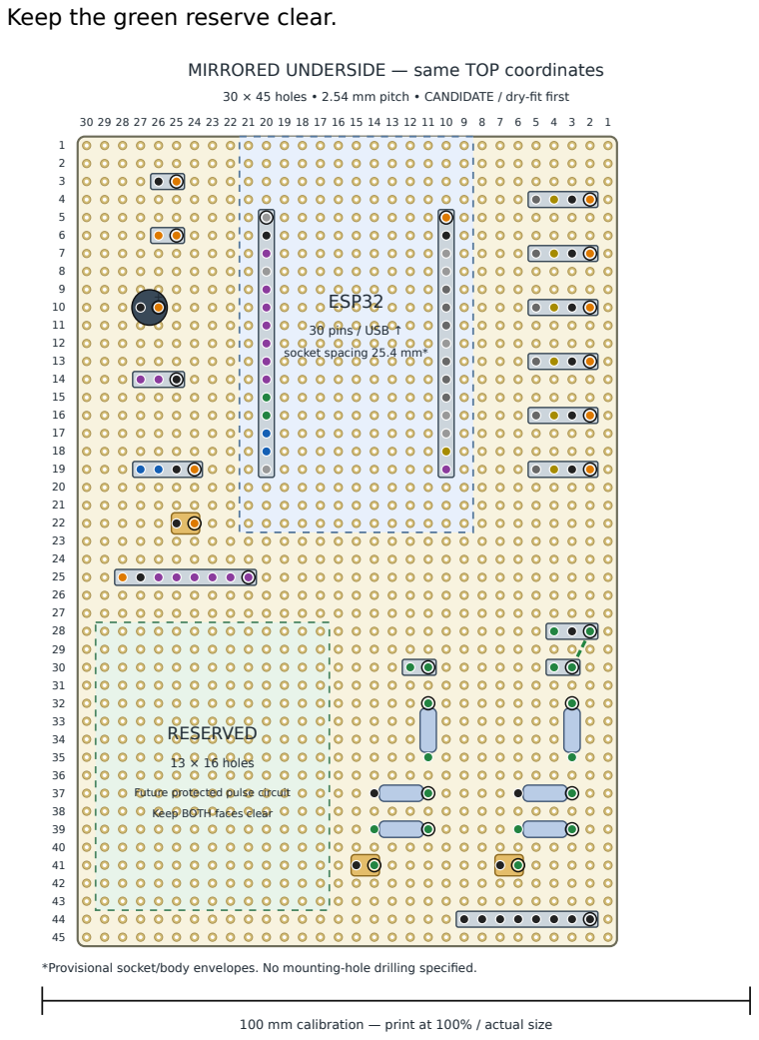
[picture p158: figure]
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

MIRRORED UNDERSIDE — same TOP coordinates

30 × 45 holes • 2.54 mm pitch • CANDIDATE / dry-fit first

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

*Provisional socket/body envelopes. No mounting-hole drilling specified.

100 mm calibration — print at 100% / actual size

Wire / net | From | To
W055 / P1_RAW | J_SENSE.1 C2, R28 | JP_SENSE1.1 C3, R30

## Wiring group 19/31: P1_IN

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

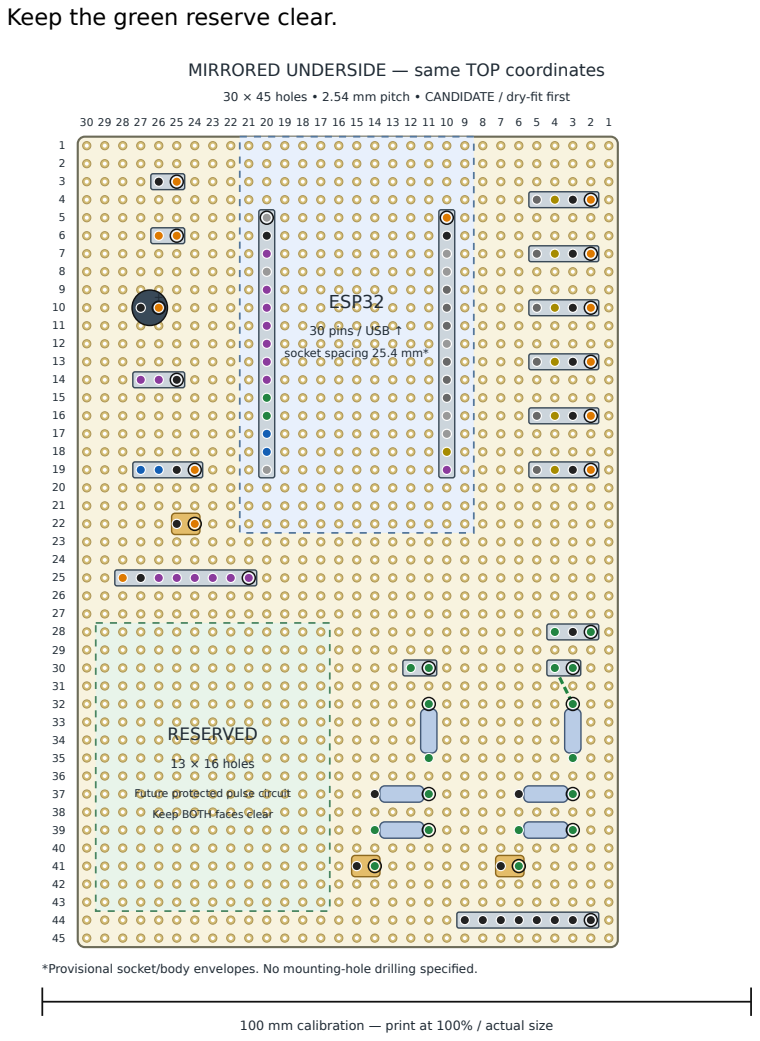
[picture p159: figure]
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

MIRRORED UNDERSIDE — same TOP coordinates

30 × 45 holes • 2.54 mm pitch • CANDIDATE / dry-fit first

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

*Provisional socket/body envelopes. No mounting-hole drilling specified.

100 mm calibration — print at 100% / actual size

Wire / net | From | To
W056 / P1_IN | JP_SENSE1.2 C4, R30 | R_P1_TOP.1 C3, R32

## Wiring group 20/31: SENSE1_DIV

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

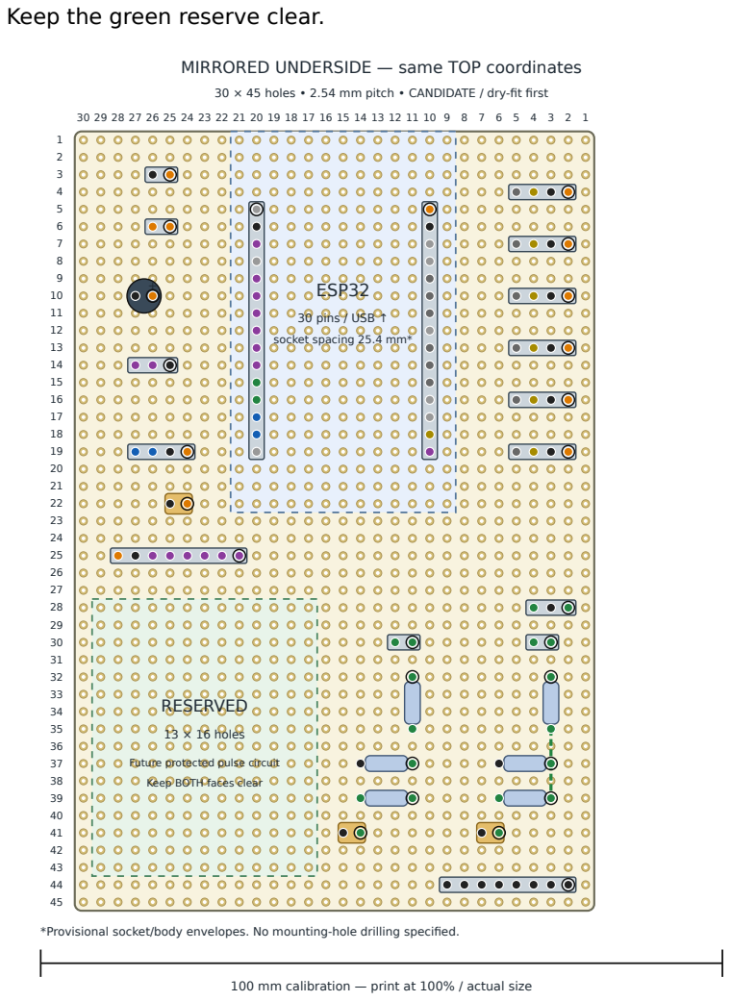
[picture p160: figure]
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

MIRRORED UNDERSIDE — same TOP coordinates

30 × 45 holes • 2.54 mm pitch • CANDIDATE / dry-fit first

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

*Provisional socket/body envelopes. No mounting-hole drilling specified.

100 mm calibration — print at 100% / actual size

Wire / net | From | To
W057 / SENSE1_DIV | R_P1_TOP.2 C3, R35 | R_P1_BOT.1 C3, R37
W058 / SENSE1_DIV | R_P1_BOT.1 C3, R37 | R_P1_SER.1 C3, R39

## Wiring group 21/31: SENSE1_ADC

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

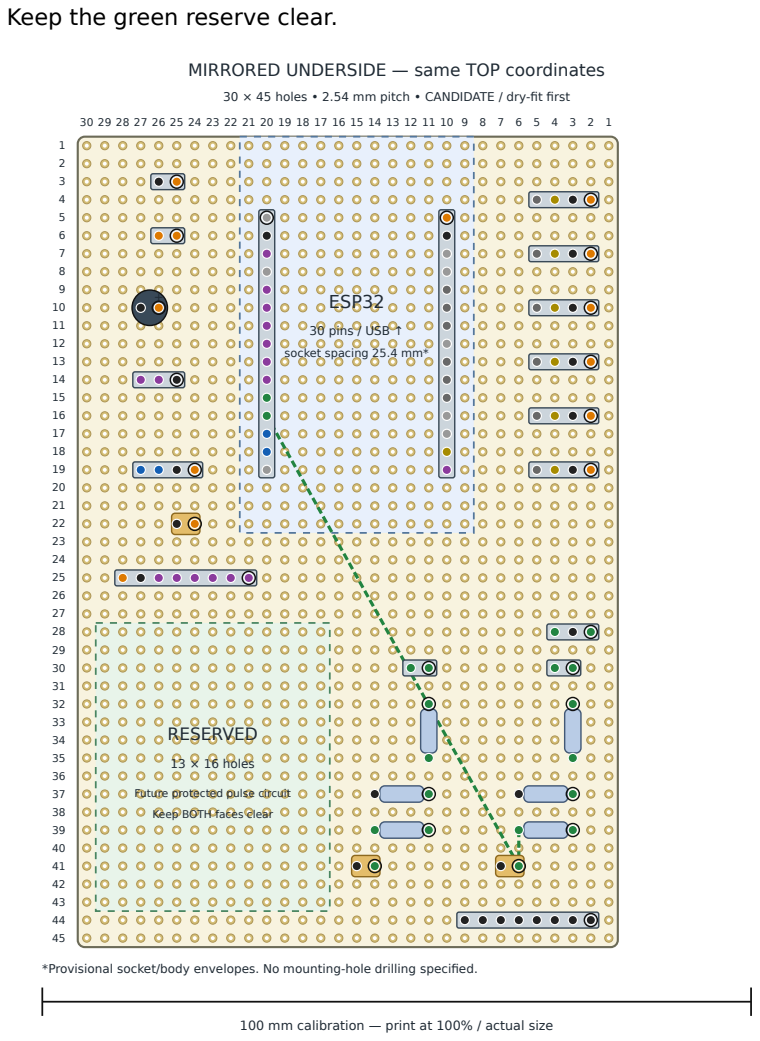
[picture p161: figure]
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

MIRRORED UNDERSIDE — same TOP coordinates

30 × 45 holes • 2.54 mm pitch • CANDIDATE / dry-fit first

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

*Provisional socket/body envelopes. No mounting-hole drilling specified.

100 mm calibration — print at 100% / actual size

Wire / net | From | To
W059 / SENSE1_ADC | R_P1_SER.2 C6, R39 | C_P1.1 C6, R41
W060 / SENSE1_ADC | C_P1.1 C6, R41 | J_ESP_R.12 C20, R16

## Wiring group 22/31: P2_RAW

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

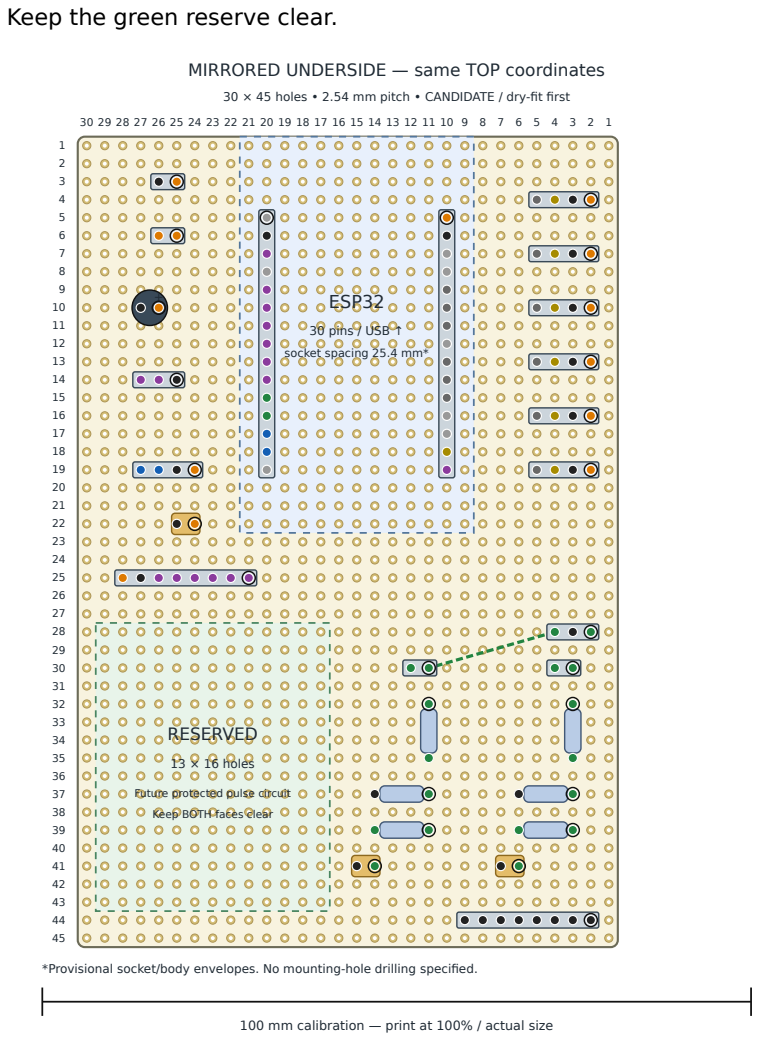
[picture p162: figure]
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

MIRRORED UNDERSIDE — same TOP coordinates

30 × 45 holes • 2.54 mm pitch • CANDIDATE / dry-fit first

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

*Provisional socket/body envelopes. No mounting-hole drilling specified.

100 mm calibration — print at 100% / actual size

Wire / net | From | To
W061 / P2_RAW | J_SENSE.3 C4, R28 | JP_SENSE2.1 C11, R30

## Wiring group 23/31: P2_IN

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

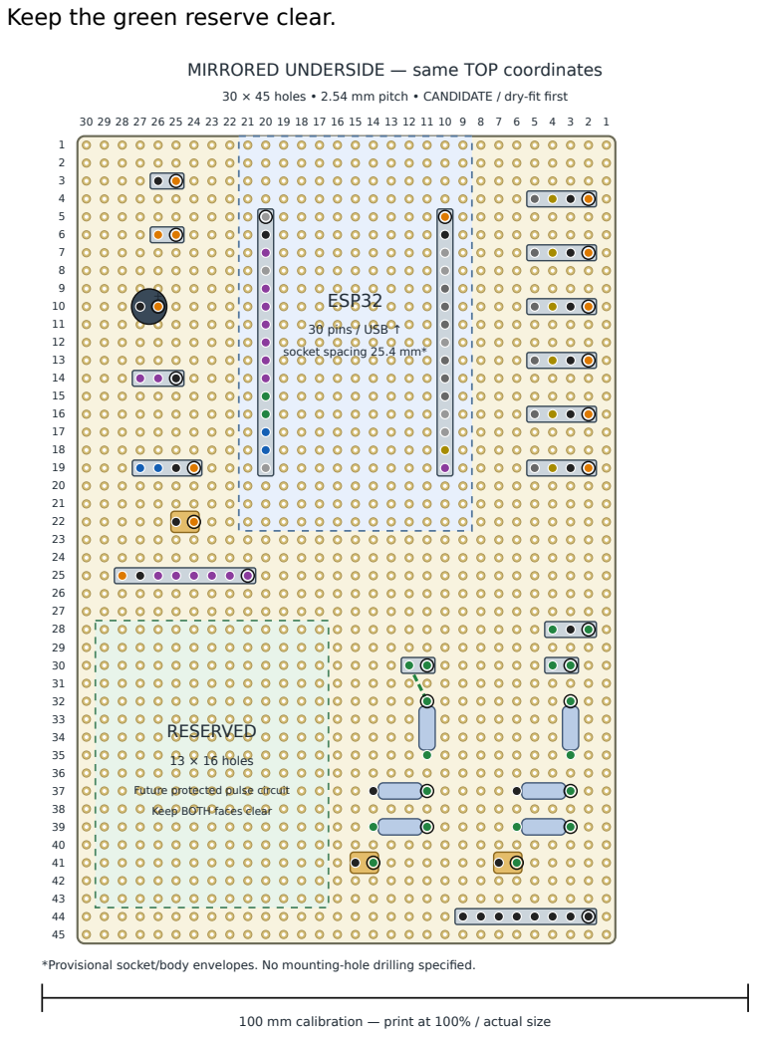
[picture p163: figure]
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

MIRRORED UNDERSIDE — same TOP coordinates

30 × 45 holes • 2.54 mm pitch • CANDIDATE / dry-fit first

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

*Provisional socket/body envelopes. No mounting-hole drilling specified.

100 mm calibration — print at 100% / actual size

Wire / net | From | To
W062 / P2_IN | JP_SENSE2.2 C12, R30 | R_P2_TOP.1 C11, R32

## Wiring group 24/31: SENSE2_DIV

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

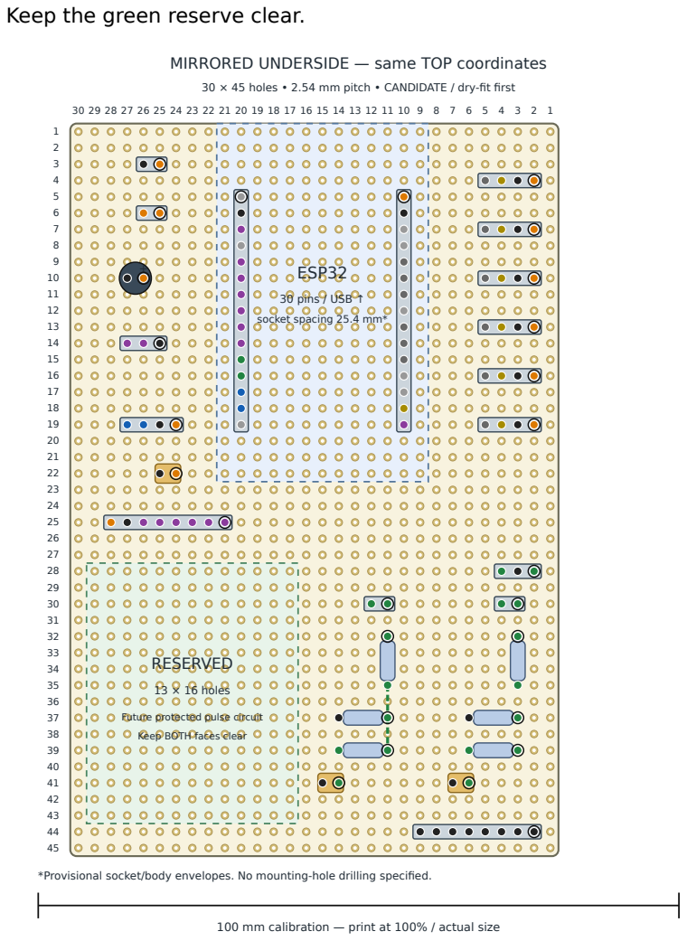
[picture p164: figure]
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

MIRRORED UNDERSIDE — same TOP coordinates

30 × 45 holes • 2.54 mm pitch • CANDIDATE / dry-fit first

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

*Provisional socket/body envelopes. No mounting-hole drilling specified.

100 mm calibration — print at 100% / actual size

Wire / net | From | To
W063 / SENSE2_DIV | R_P2_TOP.2 C11, R35 | R_P2_BOT.1 C11, R37
W064 / SENSE2_DIV | R_P2_BOT.1 C11, R37 | R_P2_SER.1 C11, R39

## Wiring group 25/31: SENSE2_ADC

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

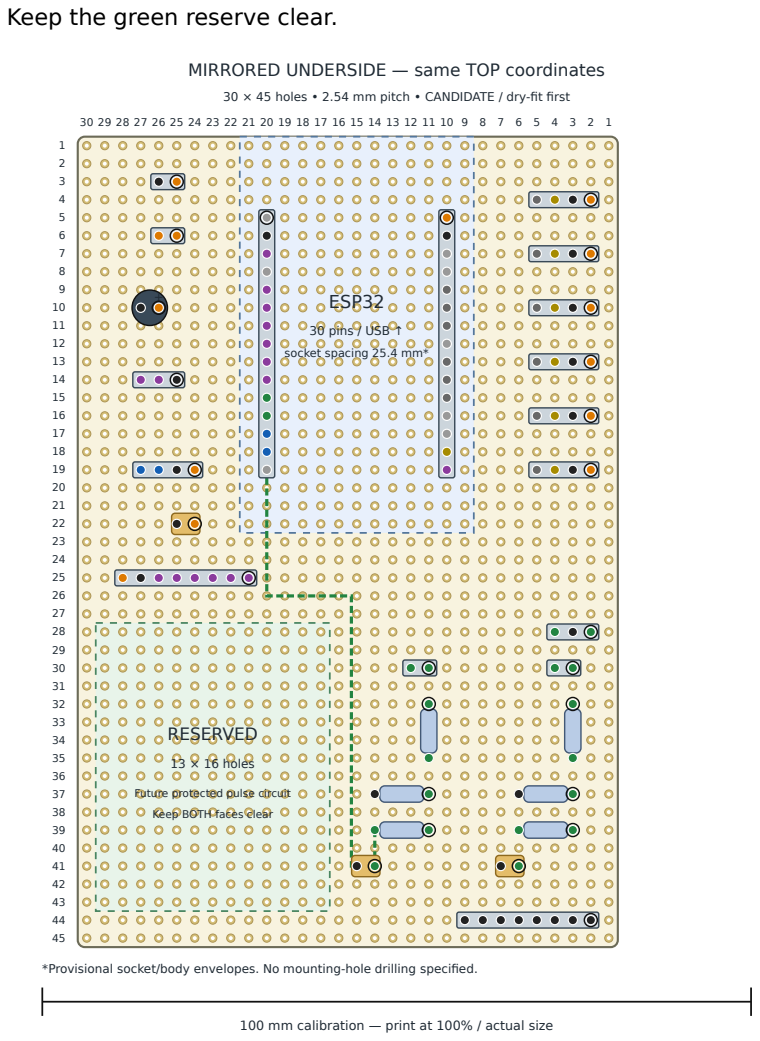
[picture p165: figure]
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

MIRRORED UNDERSIDE — same TOP coordinates

30 × 45 holes • 2.54 mm pitch • CANDIDATE / dry-fit first

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

*Provisional socket/body envelopes. No mounting-hole drilling specified.

100 mm calibration — print at 100% / actual size

Wire / net | From | To
W065 / SENSE2_ADC | R_P2_SER.2 C14, R39 | C_P2.1 C14, R41
W066 / SENSE2_ADC | C_P2.1 C14, R41 | J_ESP_R.11 C20, R15

## Wiring group 26/31: EXP_GPIO13

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

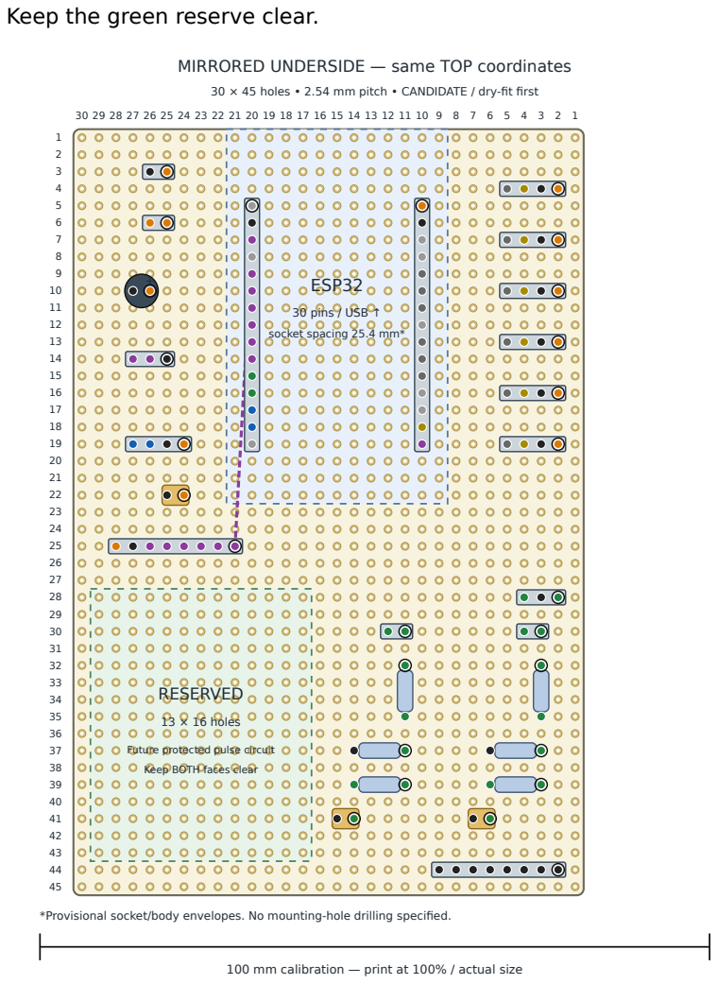
[picture p166: figure]
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

MIRRORED UNDERSIDE — same TOP coordinates

30 × 45 holes • 2.54 mm pitch • CANDIDATE / dry-fit first

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

*Provisional socket/body envelopes. No mounting-hole drilling specified.

100 mm calibration — print at 100% / actual size

Wire / net | From | To
W067 / EXP_GPIO13 | J_ESP_R.3 C20, R7 | J_EXP.1 C21, R25

## Wiring group 27/31: EXP_GPIO14

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

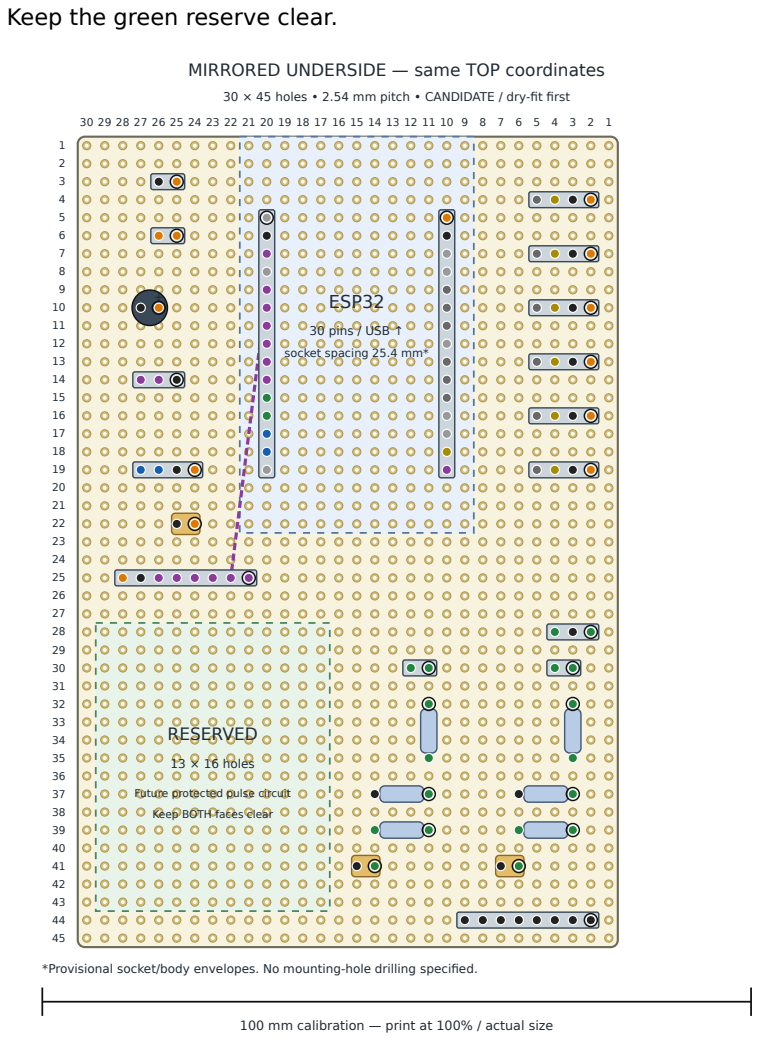
[picture p167: figure]
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

MIRRORED UNDERSIDE — same TOP coordinates

30 × 45 holes • 2.54 mm pitch • CANDIDATE / dry-fit first

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

*Provisional socket/body envelopes. No mounting-hole drilling specified.

100 mm calibration — print at 100% / actual size

Wire / net | From | To
W068 / EXP_GPIO14 | J_ESP_R.5 C20, R9 | J_EXP.2 C22, R25

## Wiring group 28/31: EXP_GPIO23

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

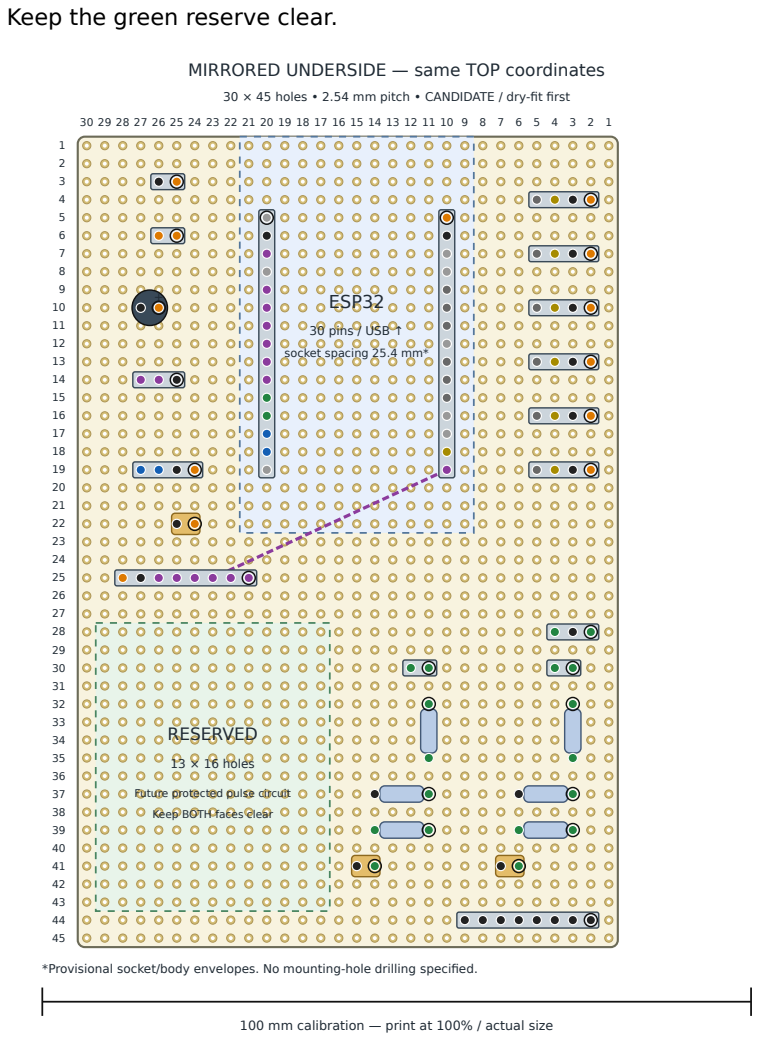
[picture p168: figure]
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

MIRRORED UNDERSIDE — same TOP coordinates

30 × 45 holes • 2.54 mm pitch • CANDIDATE / dry-fit first

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

*Provisional socket/body envelopes. No mounting-hole drilling specified.

100 mm calibration — print at 100% / actual size

Wire / net | From | To
W069 / EXP_GPIO23 | J_ESP_L.15 C10, R19 | J_EXP.3 C23, R25

## Wiring group 29/31: EXP_GPIO25

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

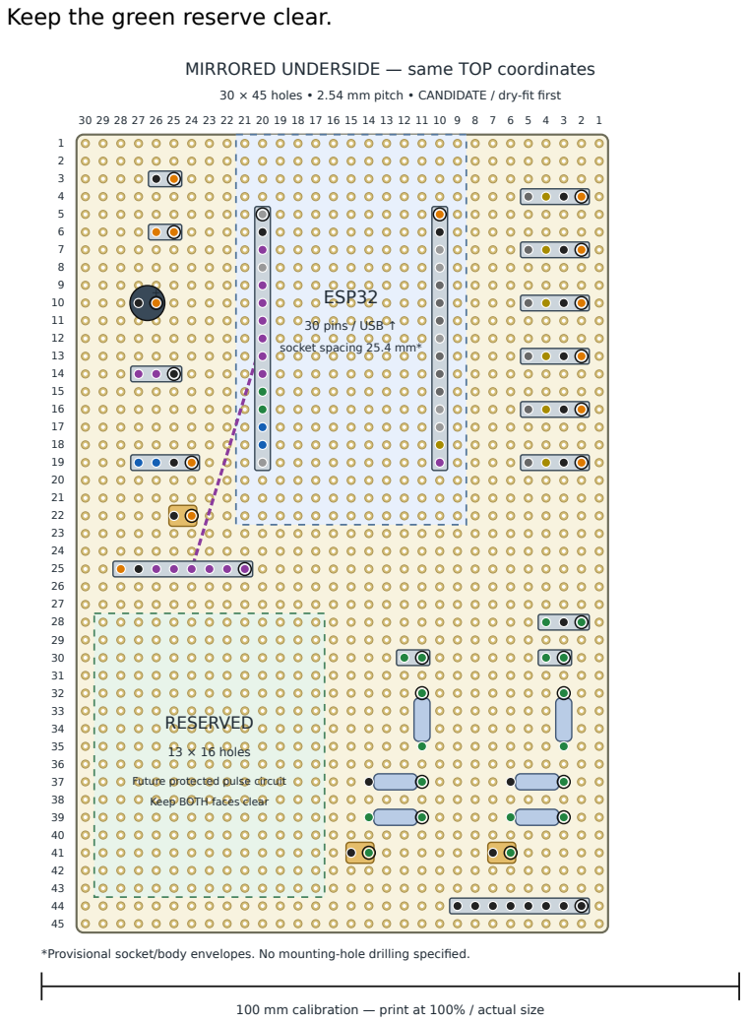
[picture p169: figure]
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

MIRRORED UNDERSIDE — same TOP coordinates

30 × 45 holes • 2.54 mm pitch • CANDIDATE / dry-fit first

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

*Provisional socket/body envelopes. No mounting-hole drilling specified.

100 mm calibration — print at 100% / actual size

Wire / net | From | To
W070 / EXP_GPIO25 | J_ESP_R.8 C20, R12 | J_EXP.4 C24, R25

## Wiring group 30/31: EXP_GPIO26

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

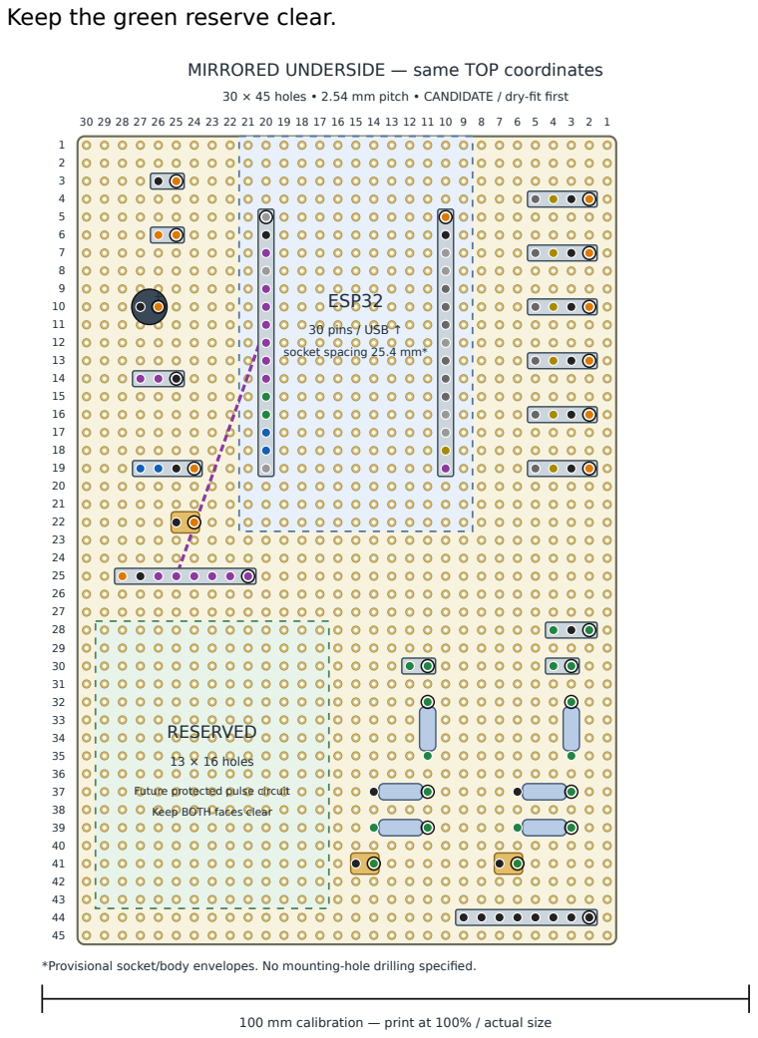
[picture p170: figure]
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

MIRRORED UNDERSIDE — same TOP coordinates

30 × 45 holes • 2.54 mm pitch • CANDIDATE / dry-fit first

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

*Provisional socket/body envelopes. No mounting-hole drilling specified.

100 mm calibration — print at 100% / actual size

Wire / net | From | To
W071 / EXP_GPIO26 | J_ESP_R.7 C20, R11 | J_EXP.5 C25, R25

## Wiring group 31/31: EXP_GPIO27

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

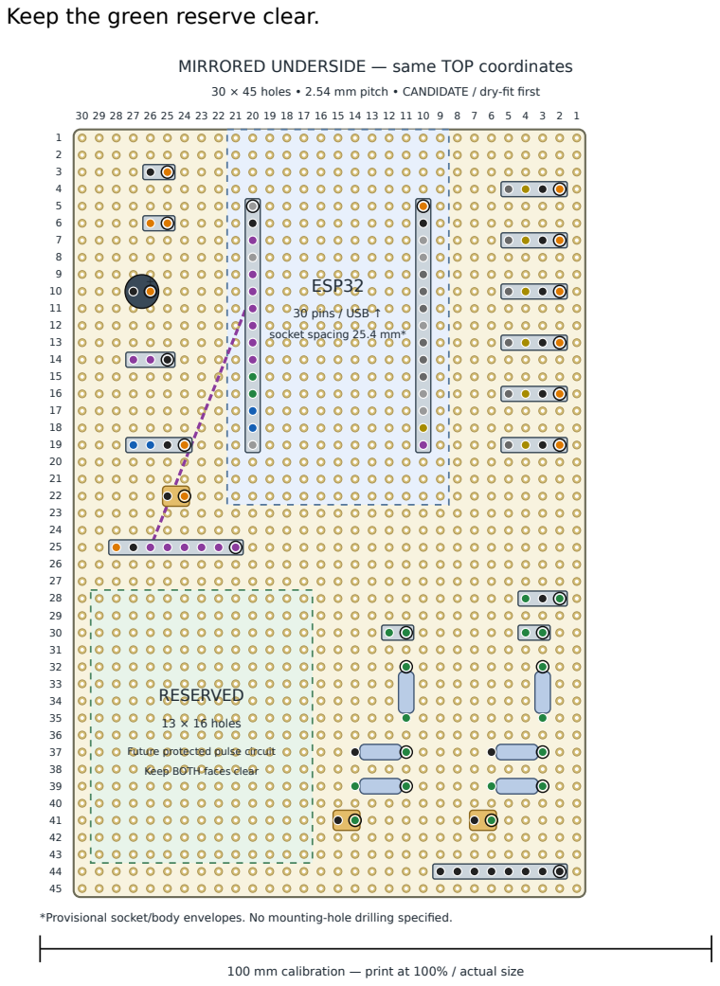
[picture p171: figure]
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

MIRRORED UNDERSIDE — same TOP coordinates

30 × 45 holes • 2.54 mm pitch • CANDIDATE / dry-fit first

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

*Provisional socket/body envelopes. No mounting-hole drilling specified.

100 mm calibration — print at 100% / actual size

Wire / net | From | To
W072 / EXP_GPIO27 | J_ESP_R.6 C20, R10 | J_EXP.6 C26, R25
