gefgu/integration-workshop-3/eletronics/perfboard/tscircuit/smart-perfboard/design-guide.pdf

## Smart-controller perfboard — TOP and mirrored underside

CANDIDATE: native software checks do not release this board for soldering. Both drawings use TOP coordinates.

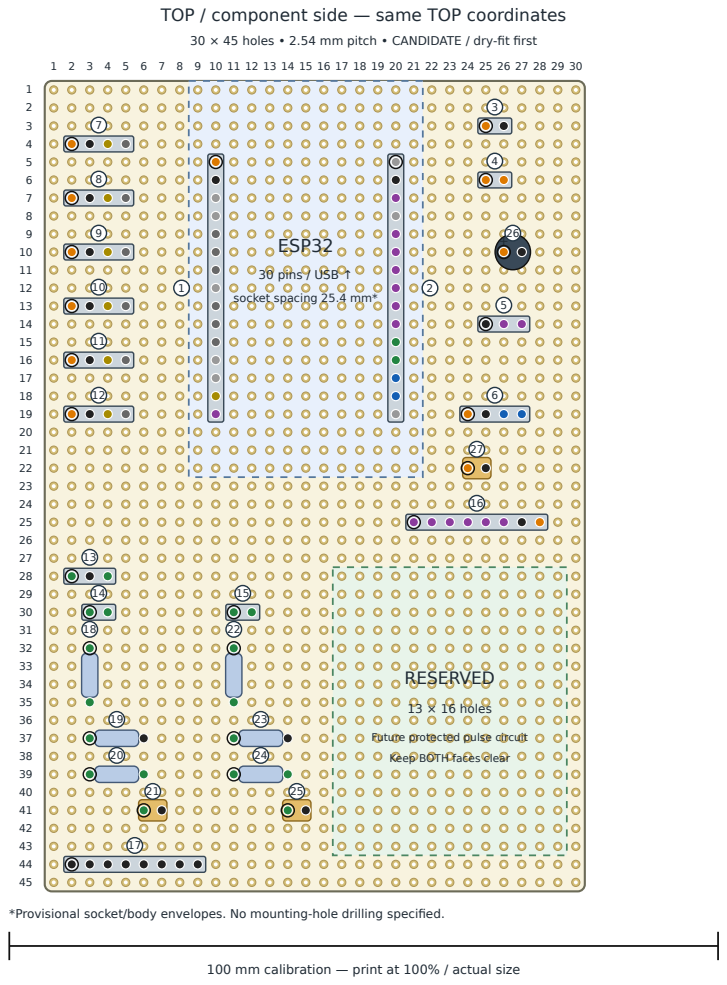
[picture p185: figure]
ESP32; 30 pins / USB ↑; socket spacing 25.4 mm*; RESERVED; 13 × 16 holes; Future protected pulse circuit; Keep BOTH faces clear

TOP / component side — same TOP coordinates

30 × 45 holes • 2.54 mm pitch • CANDIDATE / dry-fit first

1 2 3 4 5 6 7 8 9 10 11 12 13 14 15 16 17 18 19 20 21 22 23 24 25 26 27 28 29 30

*Provisional socket/body envelopes. No mounting-hole drilling specified.

100 mm calibration — print at 100% / actual size

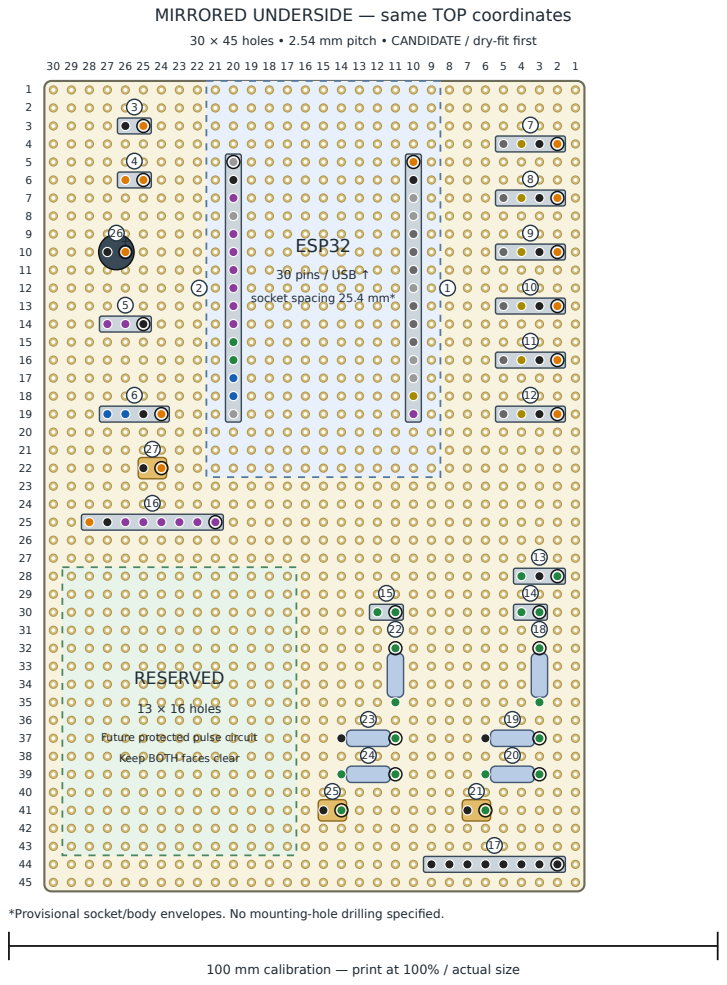
[picture p186: figure]
ESP32; 30 pins / USB ↑; socket spacing 25.4 mm*; RESERVED; 13 × 16 holes; Future protected pulse circuit; Keep BOTH faces clear

MIRRORED UNDERSIDE — same TOP coordinates

30 × 45 holes • 2.54 mm pitch • CANDIDATE / dry-fit first

30 29 28 27 26 25 24 23 22 21 20 19 18 17 16 15 14 13 12 11 10 9 8 7 6 5 4 3 2 1

*Provisional socket/body envelopes. No mounting-hole drilling specified.

100 mm calibration — print at 100% / actual size

## Placement legend

Numbers match the drawing badges. Pin 1 is ringed. Use pins.csv for every endpoint; holes are 1-based. USB faces row 1.

# | Ref | Part / function | TOP coordinate range

1 | J_ESP_L | 30-pin ESP32 left socket | C10/R5 → C10/R19
2 | J_ESP_R | 30-pin ESP32 right socket | C20/R5 → C20/R19
3 | J_POWER | Regulated 3.3 V IN | C25/R3 → C26/R3
4 | JP_EXT | REMOVE for USB programming | C25/R6 → C26/R6
5 | J_UART | Pi: cross TX/RX | C25/R14 → C27/R14
6 | J_JOY | Joystick axes ONLY | C24/R19 → C27/R19
7 | J_OLED0 | OLED slot 0 | C2/R4 → C5/R4
8 | J_OLED1 | OLED slot 1 | C2/R7 → C5/R7
9 | J_OLED2 | OLED slot 2 | C2/R10 → C5/R10
10 | J_OLED3 | OLED slot 3 | C2/R13 → C5/R13
11 | J_OLED4 | OLED slot 4 | C2/R16 → C5/R16
12 | J_OLED5 | OLED slot 5 | C2/R19 → C5/R19
13 | J_SENSE | From main matrix: no raw ADC connection | C2/R28 → C4/R28
14 | JP_SENSE1 | P1 disconnect link | C3/R30 → C4/R30
15 | JP_SENSE2 | P2 disconnect link | C11/R30 → C12/R30
16 | J_EXP | Future GPIO: NO output driver fitted | C21/R25 → C28/R25
17 | J_GND | Ground distribution: insulated links | C2/R44 → C9/R44
18 | R_P1_TOP | 10k | C3/R32 → C3/R35
19 | R_P1_BOT | 10k | C3/R37 → C6/R37
20 | R_P1_SER | 1k | C3/R39 → C6/R39
21 | C_P1 | 100nF | C6/R41 → C7/R41
22 | R_P2_TOP | 10k | C11/R32 → C11/R35
23 | R_P2_BOT | 10k | C11/R37 → C14/R37
24 | R_P2_SER | 1k | C11/R39 → C14/R39
25 | C_P2 | 100nF | C14/R41 → C15/R41
26 | C_BULK | 47uF | C26/R10 → C27/R10
27 | C_LOCAL | 100nF | C24/R22 → C25/R22

## GPIO and connector contract

Signal | GPIO | Function
SCL | 22 | Shared clock; six SDA wires remain separate
SDA_0 | 4 | OLED slot 0
SDA_1 | 21 | OLED slot 1
SDA_2 | 19 | OLED slot 2
SDA_3 | 18 | OLED slot 3
SDA_4 | 17 | OLED slot 4
SDA_5 | 16 | OLED slot 5
JOY_X | 36 | ADC1; VP
JOY_Y | 39 | ADC1; VN
SENSE1_ADC | 34 | ADC1; P1 through divider/filter
SENSE2_ADC | 35 | ADC1; P2 through divider/filter; NO joystick click pull-up
UART_RX | 32 | Pi TX GPIO14 / physical 8 -> this pin
UART_TX | 33 | This pin -> Pi RX GPIO15 / physical 10
EXP_GPIO13 | 13 | Reserved logic only; no educational output drive
EXP_GPIO14 | 14 | Reserved logic only; no educational output drive
EXP_GPIO23 | 23 | Reserved logic only; no educational output drive
EXP_GPIO25 | 25 | Reserved logic only; no educational output drive
EXP_GPIO26 | 26 | Reserved logic only; no educational output drive
EXP_GPIO27 | 27 | Reserved logic only; no educational output drive

Only 13 GPIOs are committed to current functions; six more are brought to the reserved logic header. GPIO0/2/5/12/15 boot pins and USB UART0 pins remain unused. Joystick SW is omitted; GPIO35 belongs to sense input 2. The 16-channel mux is not installed.

OLED headers are pin 1=3V3, 2=GND, 3=SCL, 4=SDA. They are NOT guaranteed to match module header order. J_UART is GND, ESP_TX(GPIO33), ESP_RX(GPIO32). J_SENSE is P1_RAW, GND, P2_RAW. J_JOY is 3V3, GND, VRx, VRy.

## Complete schematic — continuous internal signal wiring

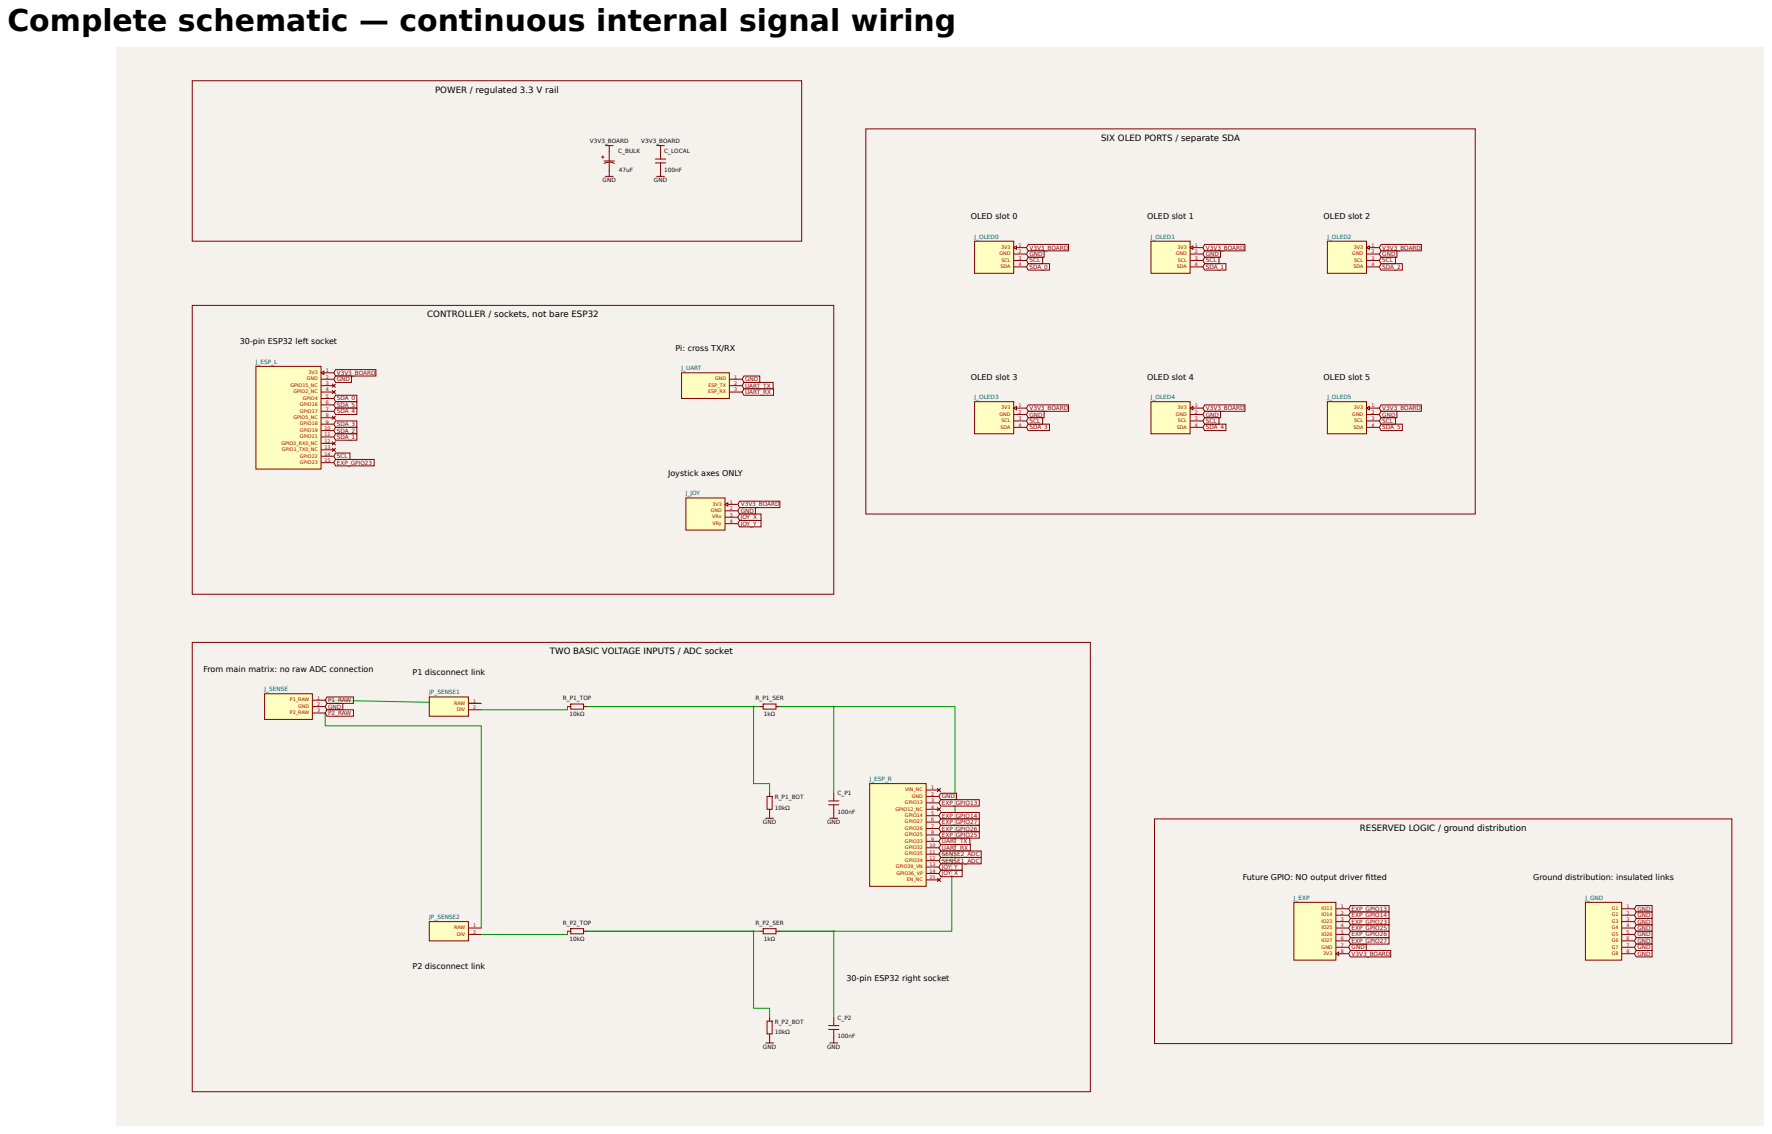
[picture p187: page 4]
J_ESP_L; 1 3V3 2 GND 3 GPIO15_NC 4 GPIO2_NC 5 GPIO4 6 GPIO16 7 GPIO17 8 GPIO5_NC 9 GPIO18 10 GPIO19 11 GPIO21 12 GPIO3_RX0_NC 13 GPIO1_TX0_NC 14 GPIO22 15 GPIO23; J_ESP_R; 1 VIN_NC 2 GND 3 GPIO13 4 GPIO12_NC 5 GPIO14 6 GPIO27 7 GPIO26 8 GPIO25 9 GPIO33 10 GPIO32 11 GPIO35 12 GPIO34 13 GPIO39_VN; 14 GPIO36_VP; J_UART; 1 GND 2 ESP_TX 3 ESP_RX; J_JOY; 1 3V3 2 GND; 3 VRx; 4 VRy; J_OLED0; 3 SCL; 4 SDA; J_OLED1; J_OLED2; J_OLED3; J_OLED4; J_OLED5; J_SENSE; 1 P1_RAW 2 GND 3 P2_RAW; JP_SENSE1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

POWER / regulated 3.3 V rail

SIX OLED PORTS / separate SDA

CONTROLLER / sockets, not bare ESP32

30-pin ESP32 left socket

Pi: cross TX/RX

Joystick axes ONLY

TWO BASIC VOLTAGE INPUTS / ADC socket

RESERVED LOGIC / ground distribution

GND GND GND GND

30-pin ESP32 right socket

## Power and source isolation

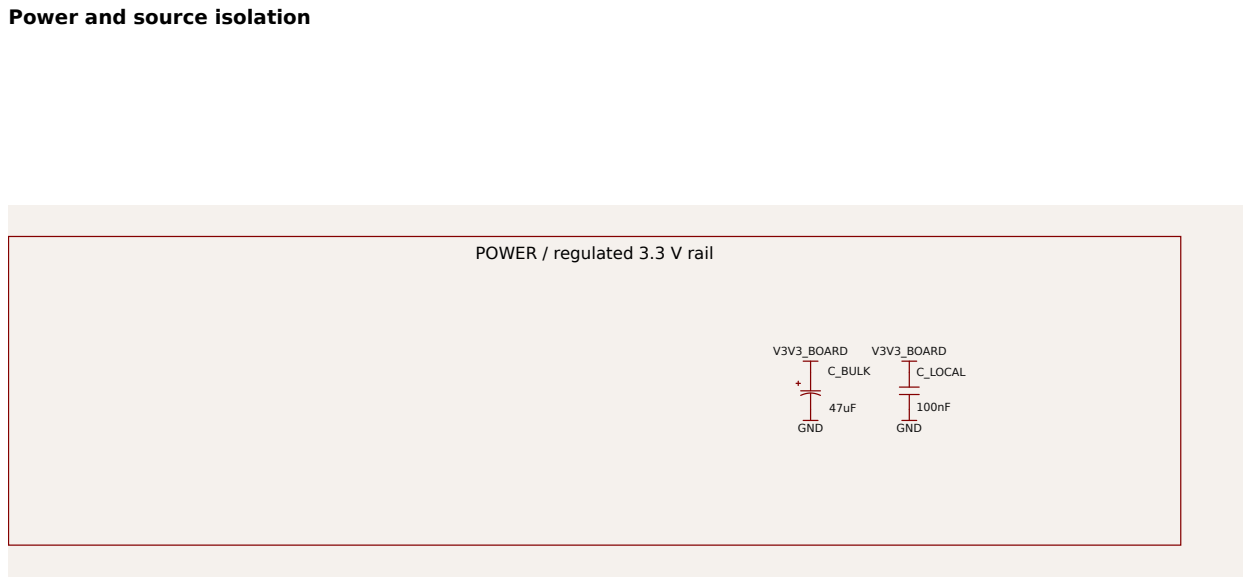
[picture p188: page 5]
C_BULK; C_LOCAL; V3V3_BOARD; GND

POWER / regulated 3.3 V rail

## ESP32 left socket, joystick and Pi UART

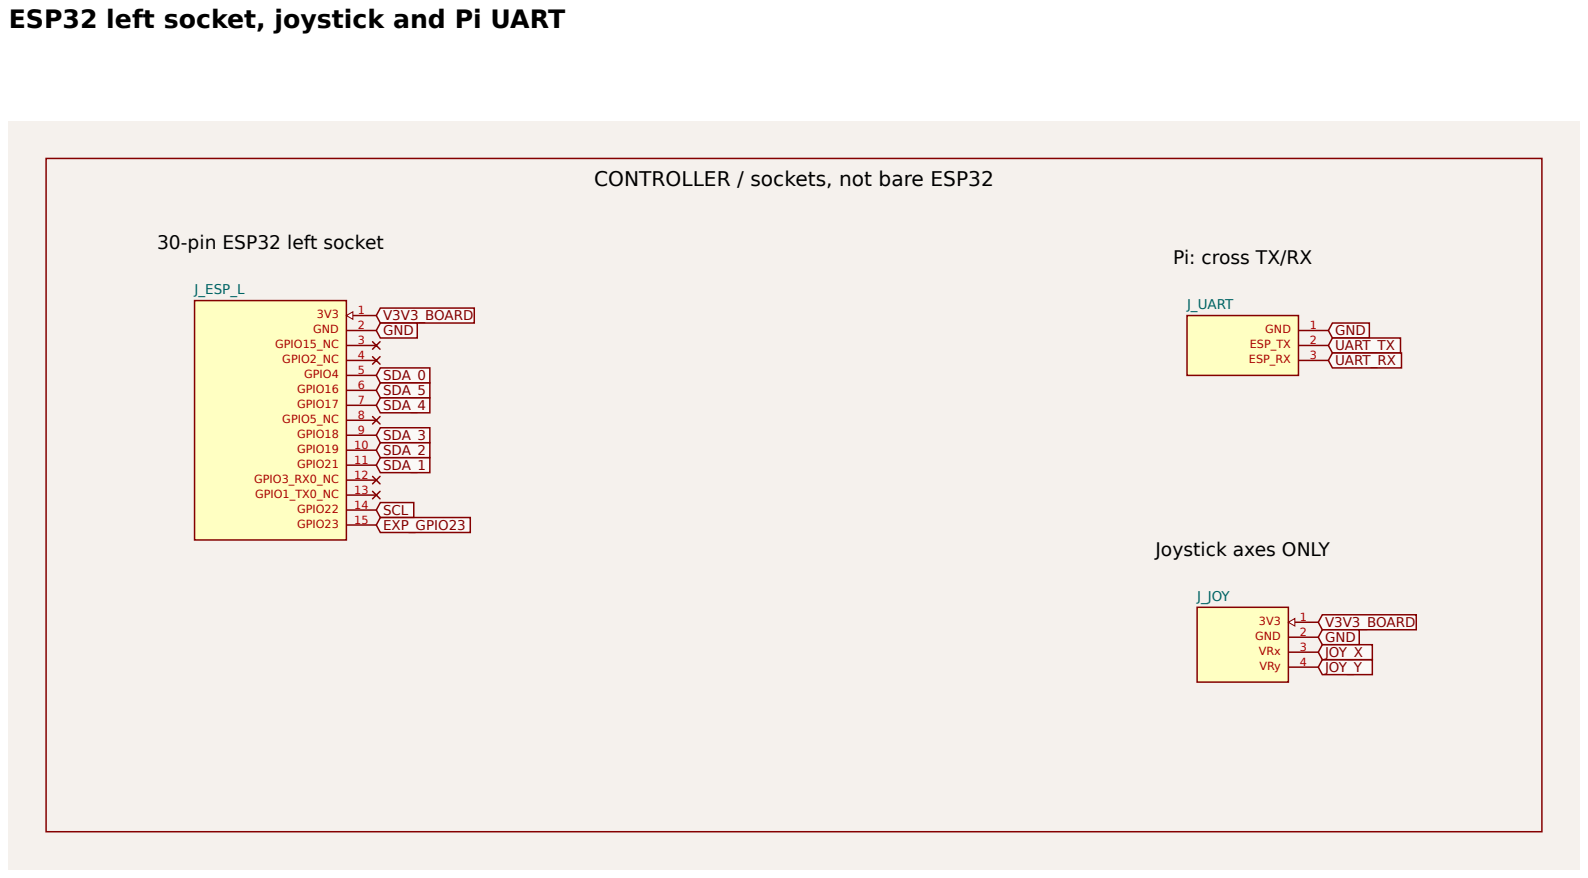
[picture p189: page 6]
J_ESP_L; 1 3V3 2 GND 3 GPIO15_NC 4 GPIO2_NC 5 GPIO4 6 GPIO16 7 GPIO17 8 GPIO5_NC 9 GPIO18 10 GPIO19 11 GPIO21 12 GPIO3_RX0_NC 13 GPIO1_TX0_NC 14 GPIO22 15 GPIO23; J_UART; 1 GND 2 ESP_TX 3 ESP_RX; J_JOY; 1 3V3 2 GND 3 VRx 4 VRy; V3V3_BOARD; GND; SDA_0 SDA_5 SDA_4; SDA_3 SDA_2 SDA_1; SCL EXP_GPIO23; UART_TX UART_RX; JOY_Y; JOY_X

CONTROLLER / sockets, not bare ESP32

30-pin ESP32 left socket

Pi: cross TX/RX

Joystick axes ONLY

## Six SSD1306 connectors; module pull-ups

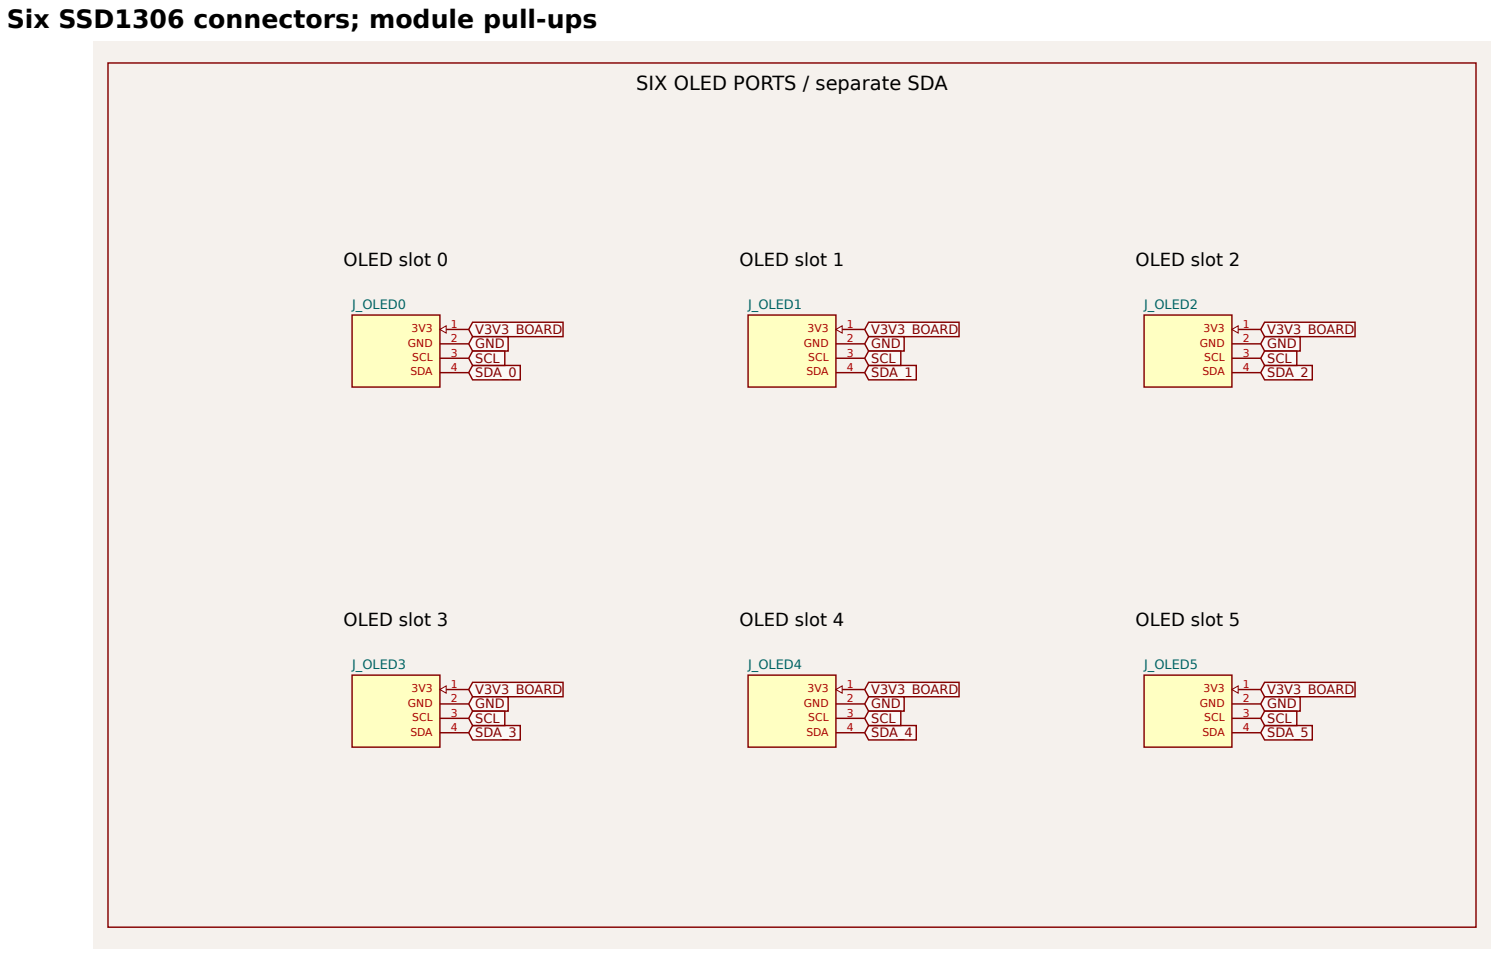
[picture p190: page 7]
J_OLED0; 1 3V3 2 GND 3 SCL 4 SDA; J_OLED1; J_OLED2; J_OLED3; J_OLED4; J_OLED5; V3V3_BOARD; GND; SDA_0; SDA_5; SDA_4; SDA_3; SDA_2; SDA_1; SCL; OLED slot 0; OLED slot 1; OLED slot 2; OLED slot 3; OLED slot 4; OLED slot 5

SIX OLED PORTS / separate SDA

## Two basic voltage channels

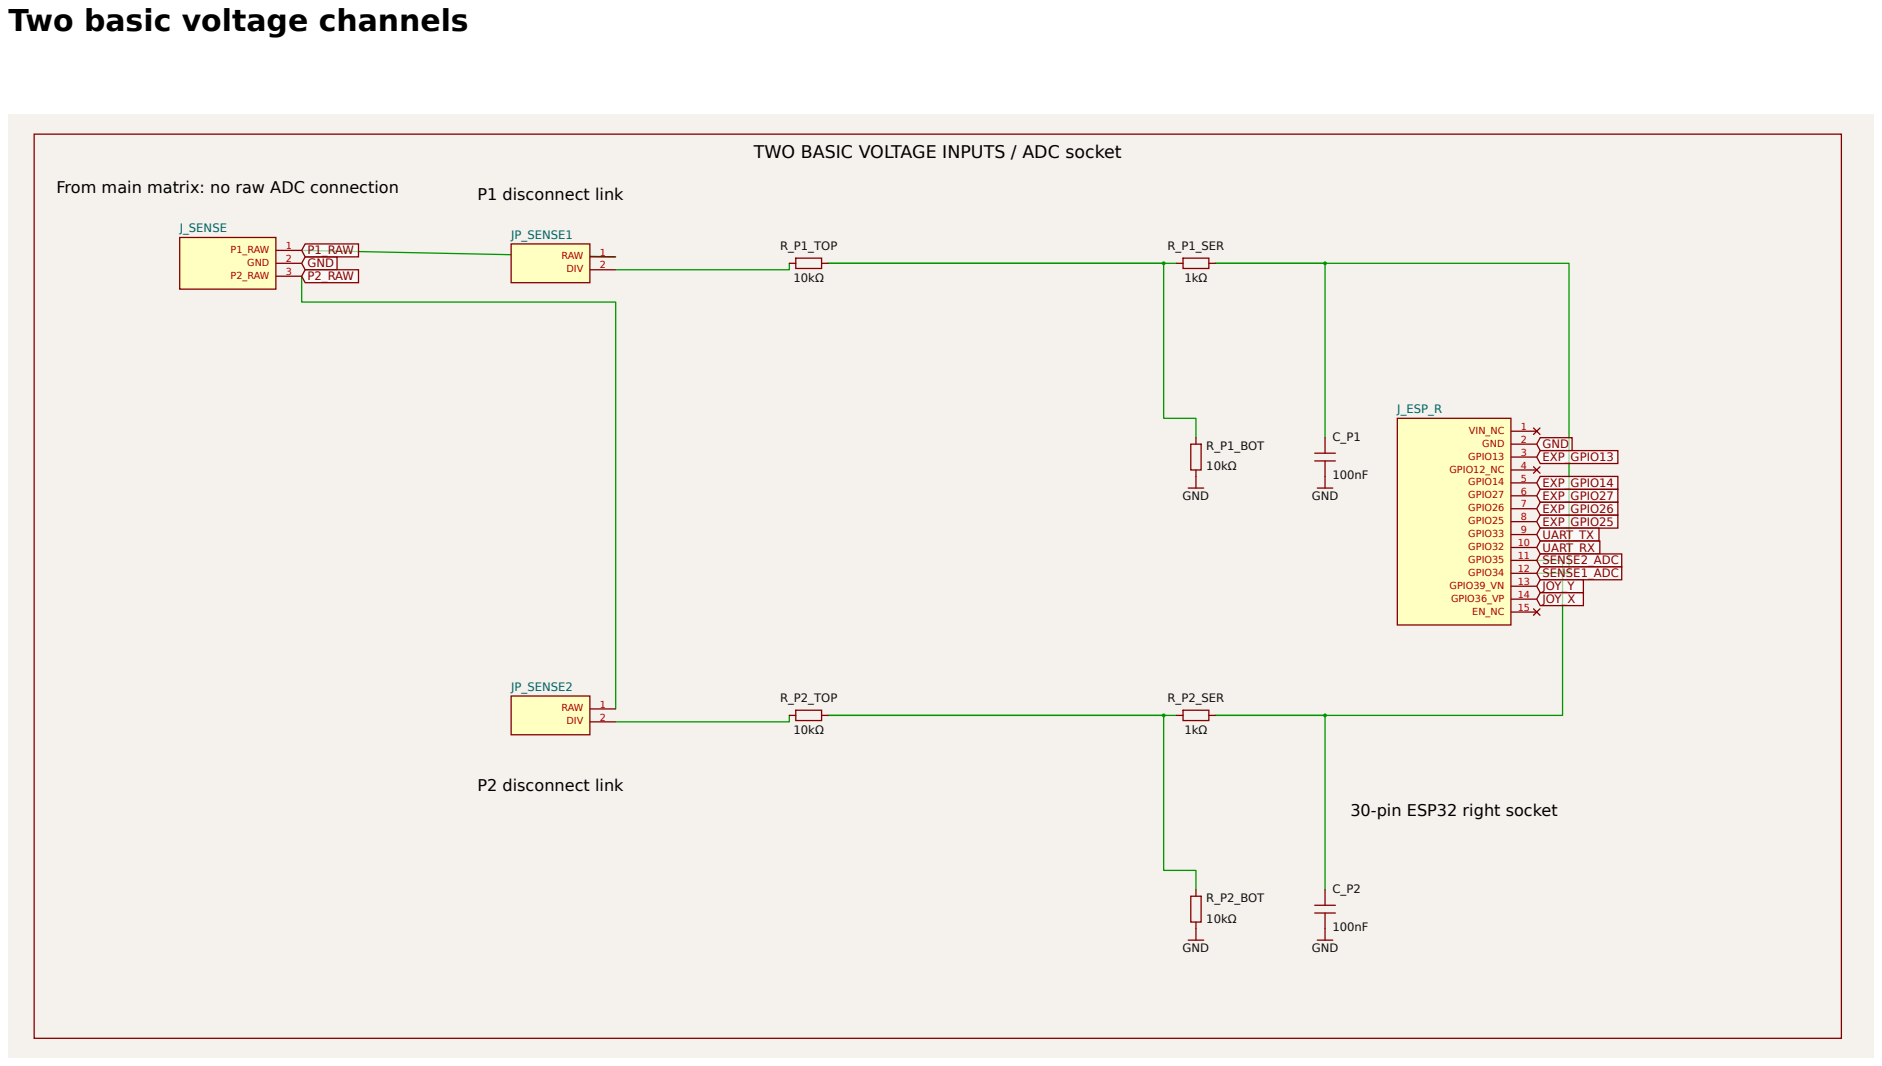
[picture p191: page 8]
J_ESP_R; 1 VIN_NC 2 GND 3 GPIO13 4 GPIO12_NC 5 GPIO14 6 GPIO27 7 GPIO26 8 GPIO25 9 GPIO33 10 GPIO32 11 GPIO35 12 GPIO34 13 GPIO39_VN 14 GPIO36_VP 15 EN_NC; J_SENSE; 1 P1_RAW 2 GND 3 P2_RAW; JP_SENSE1; 1 RAW 2 DIV; JP_SENSE2; R_P1_TOP; R_P1_BOT; R_P1_SER; R_P2_TOP; R_P2_BOT; R_P2_SER; GND; EXP_GPIO13; EXP_GPIO14 EXP_GPIO27 EXP_GPIO26 EXP_GPIO25 UART_TX UART_RX SENSE2_ADC SENSE1_ADC JOY_Y JOY_X; P1_RAW; P2_RAW; From main matrix: no raw ADC connection; P1 disconnect link; P2 disconnect link

TWO BASIC VOLTAGE INPUTS / ADC socket

30-pin ESP32 right socket

## Reserved GPIO and ground distribution

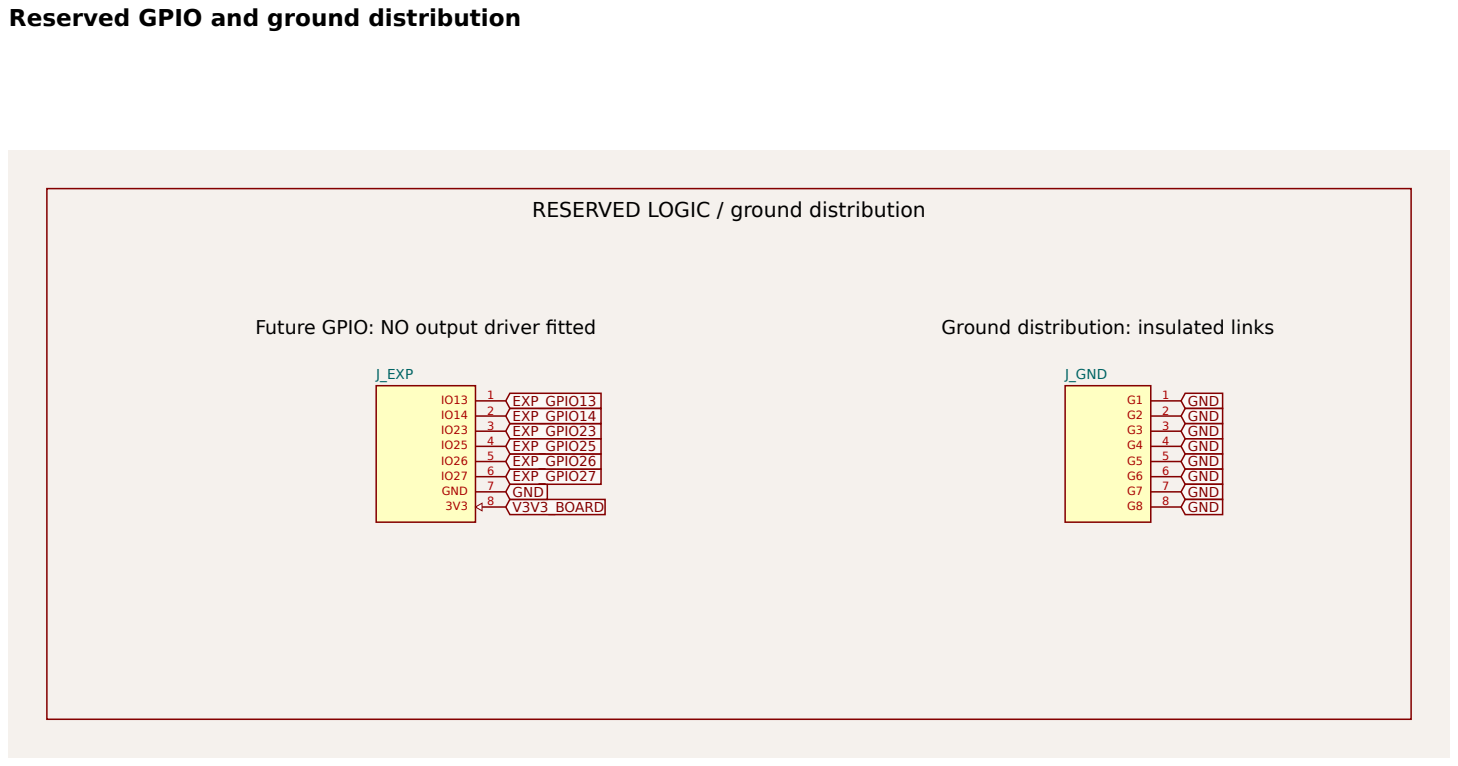
[picture p192: page 9]
J_EXP; 1 IO13 2 IO14 3 IO23 4 IO25 5 IO26 6 IO27 7 GND 8 3V3; J_GND; V3V3_BOARD; GND; GND GND GND GND GND GND GND GND; EXP_GPIO23; EXP_GPIO13 EXP_GPIO14; EXP_GPIO27; EXP_GPIO26; EXP_GPIO25; Future GPIO: NO output driver fitted; Ground distribution: insulated links

RESERVED LOGIC / ground distribution

## Power, input limits and firmware handoff

Link | External operation | USB programming
JP_EXT | FITTED | OPEN
JP_SENSE1 | FITTED only after input checks | OPEN
JP_SENSE2 | FITTED only after input checks | OPEN
- External mode: USB unplugged, regulated 3.3 V connected through JP_EXT. USB mode: physically unplug external power, remove JP_EXT and both sense links, disconnect externally driven peripherals, then plug USB. Both modes share GND only with the Pi. Never apply sense voltages to an unpowered receiver.
- Raw sense inputs are DC 0–5.25 V relative to GND only. Each 10k/10k divider scales to 0–2.625 V, followed by 1k and 100nF at the ADC. These are not overvoltage clamps. The input load is approximately 20kΩ, so the measured circuit is disturbed; original ≥1MΩ/precision requirements are not met by this simplified candidate.
- The maximum raw-to-filter time constant is roughly 1.1 ms with a high-impedance source. Start with ≥10 ms settling after an acknowledged routing change; read both ADC1 channels without changing that route. Correlate position, route generation, timestamp and validity. ADC readings are sequential, not simultaneous. Compare each channel against a meter; report signed P1−P2 only when both fresh inputs are valid.
- Start OLED communication at 100 kHz. Route the hardware I²C controller to one SDA at a time; other SDA pins stay released/high. Never tie them together. This prototype lacks the baseline TCA9517 power-off isolation: no hot insertion/unpowered modules until leakage and bus behavior are qualified. No external SDA/SCL pull-ups are fitted. Verify both module pull-ups and the combined SCL loading; disconnected SDA inputs may float.
- Target 10 updates/s for each active position only after an integrated timing test. Limit display transfers and avoid full-frame redraws in the acquisition loop; qualify 400 kHz separately. A voltage reading is not proof of capsule presence; require a fresh response from the actual OLED. Six headers do not imply six simultaneously active modes; at most three positions are active. Budget every physically powered OLED.
- GPIO32/33 are the new UART RX/TX pins. The old UART demo GPIO16/17 mapping conflicts with screens and cannot be used unchanged. The old joystick demo button handling/pull-up on GPIO35 must also be removed before this board is used.
- Expansion pins are logic only. No pulse output driver, current limiter, watchdog gate or student power connection is installed. The reserved 13×16-hole area is not a guaranteed fit for a future complete protected output circuit. No ADC result or software command bypasses the existing authorization/fault requirements.

## Pre-solder and bring-up audit

All physical rows in audit.csv begin PENDING. It is preserved across rebuilds; audit-template.csv is regenerated. Record actual measurements and reviewer/date; do not convert a generated pass into a physical pass.

Gate | Required evidence
Mechanical | Actual pitch/pads/plating; 25.4 mm DevKit row spacing; all 30 pin labels; USB access; sockets/plug/capacitor envelopes; mounting/strain relief; blank area clear on both faces.
Unpowered | Every pin and wire matches CSVs; no adjacent bridges; intended ground continuity; NC isolation; sense links/dividers and JP_EXT isolation; correct capacitor polarity.
First power | No ESP32 or modules at first; qualify voltage/current/polarity. Add removable DevKit, one OLED, joystick, UART, then remaining loads incrementally. Never change links live.
Functional | Test all OLED ports individually, both ADC channels against known voltages/meter, route changes, equal/differential readings, both UART directions, joystick directions, then three active positions together.
Negative cases | Disconnected input/screen, stale route generation, unpowered receiver, wrong serial data, reset and reconnect; outputs remain absent/off. Disconnect source before changing measurement polarity.
Release | Only the measured scope may be signed off. No CP00–CP36 acceptance, final accuracy, power-off isolation, pulse safety or manufacturing release is implied.
