gefgu/integration-workshop-3/eletronics/perfboard/tscircuit/construction-audit/endpoints.csv

id | net | phase | from_board | from_part | from_pin | from_role | from_col | from_row | to_board | to_part | to_pin | to_role | to_col | to_row | cross_board
a1:wire:NODE00:J_NODE00.1~J_NODE00.2 | NODE00 | 0 | contacts-a1 | J_NODE00 | 1 | ROW1 | 4 | 9 | contacts-a1 | J_NODE00 | 2 | ROW2 | 4 | 13 | false
a1:wire:NODE00:J_NODE00.2~J_NODE00.3 | NODE00 | 0 | contacts-a1 | J_NODE00 | 2 | ROW2 | 4 | 13 | contacts-a1 | J_NODE00 | 3 | ROW3 | 4 | 17 | false
a1:wire:NODE00:J_NODE00.3~J_NODE00.4 | NODE00 | 0 | contacts-a1 | J_NODE00 | 3 | ROW3 | 4 | 17 | contacts-a1 | J_NODE00 | 4 | ROW4 | 4 | 21 | false
a1:wire:NODE00:J_NODE00.4~J_NODE00.5 | NODE00 | 0 | contacts-a1 | J_NODE00 | 4 | ROW4 | 4 | 21 | contacts-a1 | J_NODE00 | 5 | ROW5 | 4 | 25 | false
a1:wire:NODE00:J_NODE00.5~J_NODE00.6 | NODE00 | 0 | contacts-a1 | J_NODE00 | 5 | ROW5 | 4 | 25 | contacts-a1 | J_NODE00 | 6 | ROW6 | 4 | 29 | false
a1:wire:NODE00:J_NODE.1~J_NODE00.1 | NODE00 | 0 | contacts-a1 | J_NODE00 | 1 | ROW1 | 4 | 9 | contacts-a1 | J_NODE | 1 | NODE00 | 4 | 33 | false
a1:wire:NODE00:J_NODE00.1~J_SMART.1 | NODE00 | 4 | contacts-a1 | J_NODE00 | 1 | ROW1 | 4 | 9 | contacts-a1 | J_SMART | 1 | NODE00 | 18 | 33 | false
a1:wire:NODE01:J_NODE01.1~J_NODE01.2 | NODE01 | 0 | contacts-a1 | J_NODE01 | 1 | ROW1 | 11 | 9 | contacts-a1 | J_NODE01 | 2 | ROW2 | 11 | 13 | false
a1:wire:NODE01:J_NODE01.2~J_NODE01.3 | NODE01 | 0 | contacts-a1 | J_NODE01 | 2 | ROW2 | 11 | 13 | contacts-a1 | J_NODE01 | 3 | ROW3 | 11 | 17 | false
a1:wire:NODE01:J_NODE01.3~J_NODE01.4 | NODE01 | 0 | contacts-a1 | J_NODE01 | 3 | ROW3 | 11 | 17 | contacts-a1 | J_NODE01 | 4 | ROW4 | 11 | 21 | false
a1:wire:NODE01:J_NODE01.4~J_NODE01.5 | NODE01 | 0 | contacts-a1 | J_NODE01 | 4 | ROW4 | 11 | 21 | contacts-a1 | J_NODE01 | 5 | ROW5 | 11 | 25 | false
a1:wire:NODE01:J_NODE01.5~J_NODE01.6 | NODE01 | 0 | contacts-a1 | J_NODE01 | 5 | ROW5 | 11 | 25 | contacts-a1 | J_NODE01 | 6 | ROW6 | 11 | 29 | false
a1:wire:NODE01:J_NODE.3~J_NODE01.1 | NODE01 | 0 | contacts-a1 | J_NODE01 | 1 | ROW1 | 11 | 9 | contacts-a1 | J_NODE | 3 | NODE01 | 5 | 33 | false
a1:wire:NODE01:J_NODE01.1~J_SMART.3 | NODE01 | 4 | contacts-a1 | J_NODE01 | 1 | ROW1 | 11 | 9 | contacts-a1 | J_SMART | 3 | NODE01 | 19 | 33 | false
a1:wire:NODE02:J_NODE02.1~J_NODE02.2 | NODE02 | 0 | contacts-a1 | J_NODE02 | 1 | ROW1 | 18 | 9 | contacts-a1 | J_NODE02 | 2 | ROW2 | 18 | 13 | false
a1:wire:NODE02:J_NODE02.2~J_NODE02.3 | NODE02 | 0 | contacts-a1 | J_NODE02 | 2 | ROW2 | 18 | 13 | contacts-a1 | J_NODE02 | 3 | ROW3 | 18 | 17 | false
a1:wire:NODE02:J_NODE02.3~J_NODE02.4 | NODE02 | 0 | contacts-a1 | J_NODE02 | 3 | ROW3 | 18 | 17 | contacts-a1 | J_NODE02 | 4 | ROW4 | 18 | 21 | false
a1:wire:NODE02:J_NODE02.4~J_NODE02.5 | NODE02 | 0 | contacts-a1 | J_NODE02 | 4 | ROW4 | 18 | 21 | contacts-a1 | J_NODE02 | 5 | ROW5 | 18 | 25 | false
a1:wire:NODE02:J_NODE02.5~J_NODE02.6 | NODE02 | 0 | contacts-a1 | J_NODE02 | 5 | ROW5 | 18 | 25 | contacts-a1 | J_NODE02 | 6 | ROW6 | 18 | 29 | false
a1:wire:NODE02:J_NODE.5~J_NODE02.1 | NODE02 | 0 | contacts-a1 | J_NODE02 | 1 | ROW1 | 18 | 9 | contacts-a1 | J_NODE | 5 | NODE02 | 6 | 33 | false
a1:wire:NODE02:J_NODE02.1~J_SMART.5 | NODE02 | 4 | contacts-a1 | J_NODE02 | 1 | ROW1 | 18 | 9 | contacts-a1 | J_SMART | 5 | NODE02 | 20 | 33 | false
a1:wire:NODE03:J_NODE03.1~J_NODE03.2 | NODE03 | 0 | contacts-a1 | J_NODE03 | 1 | ROW1 | 25 | 9 | contacts-a1 | J_NODE03 | 2 | ROW2 | 25 | 13 | false
a1:wire:NODE03:J_NODE03.2~J_NODE03.3 | NODE03 | 0 | contacts-a1 | J_NODE03 | 2 | ROW2 | 25 | 13 | contacts-a1 | J_NODE03 | 3 | ROW3 | 25 | 17 | false
a1:wire:NODE03:J_NODE03.3~J_NODE03.4 | NODE03 | 0 | contacts-a1 | J_NODE03 | 3 | ROW3 | 25 | 17 | contacts-a1 | J_NODE03 | 4 | ROW4 | 25 | 21 | false
a1:wire:NODE03:J_NODE03.4~J_NODE03.5 | NODE03 | 0 | contacts-a1 | J_NODE03 | 4 | ROW4 | 25 | 21 | contacts-a1 | J_NODE03 | 5 | ROW5 | 25 | 25 | false
a1:wire:NODE03:J_NODE03.5~J_NODE03.6 | NODE03 | 0 | contacts-a1 | J_NODE03 | 5 | ROW5 | 25 | 25 | contacts-a1 | J_NODE03 | 6 | ROW6 | 25 | 29 | false
a1:wire:NODE03:J_NODE.7~J_NODE03.1 | NODE03 | 0 | contacts-a1 | J_NODE03 | 1 | ROW1 | 25 | 9 | contacts-a1 | J_NODE | 7 | NODE03 | 7 | 33 | false
a1:wire:SCL_0:J_SERVICE.1~J_SMART.9 | SCL_0 | 4 | contacts-a1 | J_SERVICE | 1 | SCL | 10 | 3 | contacts-a1 | J_SMART | 9 | SCL_0 | 22 | 33 | false
a1:wire:SDA_0:J_SERVICE.2~J_SMART.7 | SDA_0 | 4 | contacts-a1 | J_SERVICE | 2 | SDA | 11 | 3 | contacts-a1 | J_SMART | 7 | SDA_0 | 21 | 33 | false
a1:wire:GND:J_SERVICE.3~J_SMART.2 | GND | 4 | contacts-a1 | J_SERVICE | 3 | GND | 12 | 3 | contacts-a1 | J_SMART | 2 | GND | 18 | 34 | false
a1:wire:GND:J_SERVICE.3~J_SMART.4 | GND | 4 | contacts-a1 | J_SERVICE | 3 | GND | 12 | 3 | contacts-a1 | J_SMART | 4 | GND | 19 | 34 | false
a1:wire:GND:J_SERVICE.3~J_SMART.6 | GND | 4 | contacts-a1 | J_SERVICE | 3 | GND | 12 | 3 | contacts-a1 | J_SMART | 6 | GND | 20 | 34 | false
a1:wire:3V3_SYS:J_SERVICE.4~J_SMART.8 | 3V3_SYS | 4 | contacts-a1 | J_SERVICE | 4 | 3V3 | 13 | 3 | contacts-a1 | J_SMART | 8 | 3V3_SYS | 21 | 34 | false
matrix:wire:USB_3V3:J_FIXTURE.1~J_PROTOTYPE.2 | USB_3V3 | 0 | esp1-carrier-1 | J_FIXTURE | 1 | USB_3V3 | 16 | 3 | esp1-carrier-1 | J_PROTOTYPE | 2 | USB_3V3 | 17 | 6 | false
matrix:wire:USB_3V3:J_FIXTURE.1~U_ESP1.1 | USB_3V3 | 0 | esp1-carrier-1 | J_FIXTURE | 1 | USB_3V3 | 16 | 3 | esp1-carrier-1 | U_ESP1 | 1 | 3V3 | 3 | 4 | false
matrix:wire:GND:J_FIXTURE.2~J_PROTOTYPE.3 | GND | 0 | esp1-carrier-1 | J_FIXTURE | 2 | GND | 17 | 3 | esp1-carrier-1 | J_PROTOTYPE | 3 | GND | 18 | 6 | false
matrix:wire:GND:J_FIXTURE.2~U_ESP1.14 | GND | 0 | esp1-carrier-1 | J_FIXTURE | 2 | GND | 17 | 3 | esp1-carrier-1 | U_ESP1 | 14 | GND_L | 3 | 17 | false
matrix:wire:GND:J_FIXTURE.2~U_ESP1.20 | GND | 0 | esp1-carrier-1 | J_FIXTURE | 2 | GND | 17 | 3 | esp1-carrier-1 | U_ESP1 | 20 | GND_R1 | 13 | 4 | false
matrix:wire:GND:J_FIXTURE.2~U_ESP1.26 | GND | 0 | esp1-carrier-1 | J_FIXTURE | 2 | GND | 17 | 3 | esp1-carrier-1 | U_ESP1 | 26 | GND_R2 | 13 | 10 | false
matrix:wire:EDU_PWR_EN:J_PROTOTYPE.4~U_ESP1.7 | EDU_PWR_EN | 0 | esp1-carrier-1 | J_PROTOTYPE | 4 | EDU_PWR_EN | 19 | 6 | esp1-carrier-1 | U_ESP1 | 7 | IO32 | 3 | 10 | false
matrix:wire:FIX_SDA:J_FIXTURE.3~U_ESP1.32 | FIX_SDA | 0 | esp1-carrier-1 | J_FIXTURE | 3 | FIX_SDA | 18 | 3 | esp1-carrier-1 | U_ESP1 | 32 | IO4 | 13 | 16 | false
matrix:wire:FIX_SCL:J_FIXTURE.4~U_ESP1.31 | FIX_SCL | 0 | esp1-carrier-1 | J_FIXTURE | 4 | FIX_SCL | 19 | 3 | esp1-carrier-1 | U_ESP1 | 31 | IO16 | 13 | 15 | false
matrix:wire:FIX_STIM:J_FIXTURE.5~U_ESP1.9 | FIX_STIM | 0 | esp1-carrier-1 | J_FIXTURE | 5 | FIX_STIM | 20 | 3 | esp1-carrier-1 | U_ESP1 | 9 | IO25 | 3 | 12 | false
matrix:wire:USB_5V:J_PROTOTYPE.1~U_ESP1.19 | USB_5V | 0 | esp1-carrier-1 | J_PROTOTYPE | 1 | USB_5V | 16 | 6 | esp1-carrier-1 | U_ESP1 | 19 | V5 | 3 | 22 | false
continuity-fixture:wire:USB_3V3:C_ADC.1~C_BUFFER.1 | USB_3V3 | 1 | continuity-1 | C_ADC | 1 | A | 9 | 21 | continuity-1 | C_BUFFER | 1 | A | 23 | 18 | false
continuity-fixture:wire:USB_3V3:C_ADC.1~D_STIM.1 | USB_3V3 | 1 | continuity-1 | C_ADC | 1 | A | 9 | 21 | continuity-1 | D_STIM | 1 | A | 10 | 6 | false
continuity-fixture:wire:USB_3V3:C_ADC.1~J_CONTROL.1 | USB_3V3 | 1 | continuity-1 | C_ADC | 1 | A | 9 | 21 | continuity-1 | J_CONTROL | 1 | USB_3V3 | 3 | 3 | false
continuity-fixture:wire:USB_3V3:C_ADC.1~R_LED.1 | USB_3V3 | 1 | continuity-1 | C_ADC | 1 | A | 9 | 21 | continuity-1 | R_LED | 1 | A | 9 | 9 | false
continuity-fixture:wire:USB_3V3:C_ADC.1~R_SCL.1 | USB_3V3 | 1 | continuity-1 | C_ADC | 1 | A | 9 | 21 | continuity-1 | R_SCL | 1 | A | 3 | 6 | false
continuity-fixture:wire:USB_3V3:C_ADC.1~R_SDA.1 | USB_3V3 | 1 | continuity-1 | C_ADC | 1 | A | 9 | 21 | continuity-1 | R_SDA | 1 | A | 18 | 3 | false
continuity-fixture:wire:USB_3V3:C_ADC.1~U_ADC.8 | USB_3V3 | 1 | continuity-1 | C_ADC | 1 | A | 9 | 21 | continuity-1 | U_ADC | 8 | VDD | 6 | 23 | false
continuity-fixture:wire:USB_3V3:C_ADC.1~U_BUFFER.8 | USB_3V3 | 1 | continuity-1 | C_ADC | 1 | A | 9 | 21 | continuity-1 | U_BUFFER | 8 | VDD | 20 | 18 | false
continuity-fixture:wire:GND:C_A.2~C_ADC.2 | GND | 1 | continuity-1 | C_A | 2 | B | 24 | 9 | continuity-1 | C_ADC | 2 | B | 10 | 21 | false
continuity-fixture:wire:GND:C_A.2~C_B.2 | GND | 1 | continuity-1 | C_A | 2 | B | 24 | 9 | continuity-1 | C_B | 2 | B | 22 | 12 | false
continuity-fixture:wire:GND:C_A.2~C_BUFFER.2 | GND | 1 | continuity-1 | C_A | 2 | B | 24 | 9 | continuity-1 | C_BUFFER | 2 | B | 24 | 18 | false
continuity-fixture:wire:GND:C_A.2~J_CONTROL.2 | GND | 1 | continuity-1 | C_A | 2 | B | 24 | 9 | continuity-1 | J_CONTROL | 2 | GND | 4 | 3 | false
continuity-fixture:wire:GND:C_A.2~JP_RETURN.2 | GND | 1 | continuity-1 | C_A | 2 | B | 24 | 9 | continuity-1 | JP_RETURN | 2 | GND | 15 | 3 | false
continuity-fixture:wire:GND:C_A.2~Q_STIM.1 | GND | 1 | continuity-1 | C_A | 2 | B | 24 | 9 | continuity-1 | Q_STIM | 1 | S | 9 | 12 | false
continuity-fixture:wire:GND:C_A.2~R_A_BOTTOM.2 | GND | 1 | continuity-1 | C_A | 2 | B | 24 | 9 | continuity-1 | R_A_BOTTOM | 2 | B | 7 | 15 | false
continuity-fixture:wire:GND:C_A.2~R_B_BOTTOM.2 | GND | 1 | continuity-1 | C_A | 2 | B | 24 | 9 | continuity-1 | R_B_BOTTOM | 2 | B | 7 | 18 | false
continuity-fixture:wire:GND:C_A.2~R_OFF.2 | GND | 1 | continuity-1 | C_A | 2 | B | 24 | 9 | continuity-1 | R_OFF | 2 | B | 20 | 9 | false
continuity-fixture:wire:GND:C_A.2~U_ADC.1 | GND | 1 | continuity-1 | C_A | 2 | B | 24 | 9 | continuity-1 | U_ADC | 1 | ADDR | 3 | 21 | false
continuity-fixture:wire:GND:C_A.2~U_ADC.3 | GND | 1 | continuity-1 | C_A | 2 | B | 24 | 9 | continuity-1 | U_ADC | 3 | GND | 3 | 23 | false
continuity-fixture:wire:GND:C_A.2~U_ADC.6 | GND | 1 | continuity-1 | C_A | 2 | B | 24 | 9 | continuity-1 | U_ADC | 6 | AIN2 | 6 | 25 | false
continuity-fixture:wire:GND:C_A.2~U_ADC.7 | GND | 1 | continuity-1 | C_A | 2 | B | 24 | 9 | continuity-1 | U_ADC | 7 | AIN3 | 6 | 24 | false
continuity-fixture:wire:GND:C_A.2~U_BUFFER.4 | GND | 1 | continuity-1 | C_A | 2 | B | 24 | 9 | continuity-1 | U_BUFFER | 4 | VSS | 17 | 21 | false
continuity-fixture:wire:FIX_SDA:J_CONTROL.3~R_SDA.2 | FIX_SDA | 1 | continuity-1 | J_CONTROL | 3 | FIX_SDA | 5 | 3 | continuity-1 | R_SDA | 2 | B | 22 | 3 | false
continuity-fixture:wire:FIX_SDA:J_CONTROL.3~U_ADC.9 | FIX_SDA | 1 | continuity-1 | J_CONTROL | 3 | FIX_SDA | 5 | 3 | continuity-1 | U_ADC | 9 | SDA | 6 | 22 | false
continuity-fixture:wire:FIX_SCL:J_CONTROL.4~R_SCL.2 | FIX_SCL | 1 | continuity-1 | J_CONTROL | 4 | FIX_SCL | 6 | 3 | continuity-1 | R_SCL | 2 | B | 7 | 6 | false
continuity-fixture:wire:FIX_SCL:J_CONTROL.4~U_ADC.10 | FIX_SCL | 1 | continuity-1 | J_CONTROL | 4 | FIX_SCL | 6 | 3 | continuity-1 | U_ADC | 10 | SCL | 6 | 21 | false
continuity-fixture:wire:FIX_STIM:J_CONTROL.5~Q_STIM.2 | FIX_STIM | 1 | continuity-1 | J_CONTROL | 5 | FIX_STIM | 7 | 3 | continuity-1 | Q_STIM | 2 | G | 10 | 12 | false
continuity-fixture:wire:FIX_STIM:J_CONTROL.5~R_OFF.1 | FIX_STIM | 1 | continuity-1 | J_CONTROL | 5 | FIX_STIM | 7 | 3 | continuity-1 | R_OFF | 1 | A | 16 | 9 | false
continuity-fixture:wire:TEST_A:J_TEST.1~K_STIM.4 | TEST_A | 1 | continuity-1 | J_TEST | 1 | TEST_A | 10 | 3 | continuity-1 | K_STIM | 4 | SW2 | 6 | 9 | false
continuity-fixture:wire:TEST_A:J_TEST.1~R_A_TOP.1 | TEST_A | 1 | continuity-1 | J_TEST | 1 | TEST_A | 10 | 3 | continuity-1 | R_A_TOP | 1 | A | 14 | 12 | false
continuity-fixture:wire:TEST_B:JP_RETURN.1~J_TEST.2 | TEST_B | 1 | continuity-1 | J_TEST | 2 | TEST_B | 11 | 3 | continuity-1 | JP_RETURN | 1 | TEST_B | 14 | 3 | false
continuity-fixture:wire:TEST_B:J_TEST.2~R_B_TOP.1 | TEST_B | 1 | continuity-1 | J_TEST | 2 | TEST_B | 11 | 3 | continuity-1 | R_B_TOP | 1 | A | 17 | 15 | false
continuity-fixture:wire:STIM_FEED:D_STIM.2~R_STIM.1 | STIM_FEED | 1 | continuity-1 | D_STIM | 2 | K | 14 | 6 | continuity-1 | R_STIM | 1 | A | 17 | 6 | false
continuity-fixture:wire:STIM_LIMIT:K_STIM.3~R_STIM.2 | STIM_LIMIT | 1 | continuity-1 | K_STIM | 3 | SW1 | 6 | 10 | continuity-1 | R_STIM | 2 | B | 21 | 6 | false
continuity-fixture:wire:STIM_LED_A:K_STIM.1~R_LED.2 | STIM_LED_A | 1 | continuity-1 | K_STIM | 1 | LED_A | 3 | 9 | continuity-1 | R_LED | 2 | B | 13 | 9 | false
continuity-fixture:wire:STIM_LED_K:K_STIM.2~Q_STIM.3 | STIM_LED_K | 1 | continuity-1 | K_STIM | 2 | LED_K | 3 | 10 | continuity-1 | Q_STIM | 3 | D | 11 | 12 | false
continuity-fixture:wire:DIV_A:C_A.1~R_A_BOTTOM.1 | DIV_A | 1 | continuity-1 | C_A | 1 | A | 23 | 9 | continuity-1 | R_A_BOTTOM | 1 | A | 3 | 15 | false
continuity-fixture:wire:DIV_A:C_A.1~R_A_TOP.2 | DIV_A | 1 | continuity-1 | C_A | 1 | A | 23 | 9 | continuity-1 | R_A_TOP | 2 | B | 18 | 12 | false
continuity-fixture:wire:DIV_A:C_A.1~U_BUFFER.3 | DIV_A | 1 | continuity-1 | C_A | 1 | A | 23 | 9 | continuity-1 | U_BUFFER | 3 | INA_P | 17 | 20 | false
continuity-fixture:wire:BUF_A:R_ADC_A.1~U_BUFFER.1 | BUF_A | 1 | continuity-1 | R_ADC_A | 1 | A | 10 | 15 | continuity-1 | U_BUFFER | 1 | OUTA | 17 | 18 | false
continuity-fixture:wire:BUF_A:R_ADC_A.1~U_BUFFER.2 | BUF_A | 1 | continuity-1 | R_ADC_A | 1 | A | 10 | 15 | continuity-1 | U_BUFFER | 2 | INA_N | 17 | 19 | false
continuity-fixture:wire:ADC_A:R_ADC_A.2~U_ADC.4 | ADC_A | 1 | continuity-1 | R_ADC_A | 2 | B | 14 | 15 | continuity-1 | U_ADC | 4 | AIN0 | 3 | 24 | false
continuity-fixture:wire:DIV_B:C_B.1~R_B_BOTTOM.1 | DIV_B | 1 | continuity-1 | C_B | 1 | A | 21 | 12 | continuity-1 | R_B_BOTTOM | 1 | A | 3 | 18 | false
continuity-fixture:wire:DIV_B:C_B.1~R_B_TOP.2 | DIV_B | 1 | continuity-1 | C_B | 1 | A | 21 | 12 | continuity-1 | R_B_TOP | 2 | B | 21 | 15 | false
continuity-fixture:wire:DIV_B:C_B.1~U_BUFFER.5 | DIV_B | 1 | continuity-1 | C_B | 1 | A | 21 | 12 | continuity-1 | U_BUFFER | 5 | INB_P | 20 | 21 | false
continuity-fixture:wire:BUF_B:R_ADC_B.1~U_BUFFER.6 | BUF_B | 1 | continuity-1 | R_ADC_B | 1 | A | 10 | 18 | continuity-1 | U_BUFFER | 6 | INB_N | 20 | 20 | false
continuity-fixture:wire:BUF_B:R_ADC_B.1~U_BUFFER.7 | BUF_B | 1 | continuity-1 | R_ADC_B | 1 | A | 10 | 18 | continuity-1 | U_BUFFER | 7 | OUTB | 20 | 19 | false
continuity-fixture:wire:ADC_B:R_ADC_B.2~U_ADC.5 | ADC_B | 1 | continuity-1 | R_ADC_B | 2 | B | 14 | 18 | continuity-1 | U_ADC | 5 | AIN1 | 3 | 25 | false
smart-channel:wire:P1_RAW:J_MODULE.1~R_P1_TOP.1 | P1_RAW | 6 | voltage-1 | J_MODULE | 1 | P1_RAW | 4 | 4 | voltage-1 | R_P1_TOP | 1 | A | 9 | 12 | false
smart-channel:wire:GND:C_ADC.2~C_BUS_A.2 | GND | 6 | voltage-1 | C_ADC | 2 | B | 24 | 18 | voltage-1 | C_BUS_A | 2 | B | 24 | 3 | false
smart-channel:wire:GND:C_ADC.2~C_BUS_B.2 | GND | 6 | voltage-1 | C_ADC | 2 | B | 24 | 18 | voltage-1 | C_BUS_B | 2 | B | 24 | 6 | false
smart-channel:wire:GND:C_ADC.2~C_P1.2 | GND | 6 | voltage-1 | C_ADC | 2 | B | 24 | 18 | voltage-1 | C_P1 | 2 | B | 24 | 9 | false
smart-channel:wire:GND:C_ADC.2~C_P2.2 | GND | 6 | voltage-1 | C_ADC | 2 | B | 24 | 18 | voltage-1 | C_P2 | 2 | B | 24 | 12 | false
smart-channel:wire:GND:C_ADC.2~C_VBUF.2 | GND | 6 | voltage-1 | C_ADC | 2 | B | 24 | 18 | voltage-1 | C_VBUF | 2 | B | 24 | 15 | false
smart-channel:wire:GND:C_ADC.2~J_CONTROL.4 | GND | 6 | voltage-1 | C_ADC | 2 | B | 24 | 18 | voltage-1 | J_CONTROL | 4 | GND | 15 | 5 | false
smart-channel:wire:GND:C_ADC.2~J_MODULE.2 | GND | 6 | voltage-1 | C_ADC | 2 | B | 24 | 18 | voltage-1 | J_MODULE | 2 | GND | 4 | 5 | false
smart-channel:wire:GND:C_ADC.2~J_MODULE.4 | GND | 6 | voltage-1 | C_ADC | 2 | B | 24 | 18 | voltage-1 | J_MODULE | 4 | GND | 5 | 5 | false
smart-channel:wire:GND:C_ADC.2~J_MODULE.6 | GND | 6 | voltage-1 | C_ADC | 2 | B | 24 | 18 | voltage-1 | J_MODULE | 6 | GND | 6 | 5 | false
smart-channel:wire:GND:C_ADC.2~R_P1_BOTTOM.2 | GND | 6 | voltage-1 | C_ADC | 2 | B | 24 | 18 | voltage-1 | R_P1_BOTTOM | 2 | B | 20 | 12 | false
smart-channel:wire:GND:C_ADC.2~R_P2_BOTTOM.2 | GND | 6 | voltage-1 | C_ADC | 2 | B | 24 | 18 | voltage-1 | R_P2_BOTTOM | 2 | B | 14 | 15 | false
smart-channel:wire:GND:C_ADC.2~U_ADC.1 | GND | 6 | voltage-1 | C_ADC | 2 | B | 24 | 18 | voltage-1 | U_ADC | 1 | ADDR | 3 | 21 | false
smart-channel:wire:GND:C_ADC.2~U_ADC.3 | GND | 6 | voltage-1 | C_ADC | 2 | B | 24 | 18 | voltage-1 | U_ADC | 3 | GND | 3 | 23 | false
smart-channel:wire:GND:C_ADC.2~U_ADC.6 | GND | 6 | voltage-1 | C_ADC | 2 | B | 24 | 18 | voltage-1 | U_ADC | 6 | AIN2 | 6 | 25 | false
smart-channel:wire:GND:C_ADC.2~U_ADC.7 | GND | 6 | voltage-1 | C_ADC | 2 | B | 24 | 18 | voltage-1 | U_ADC | 7 | AIN3 | 6 | 24 | false
smart-channel:wire:GND:C_ADC.2~U_BUS.4 | GND | 6 | voltage-1 | C_ADC | 2 | B | 24 | 18 | voltage-1 | U_BUS | 4 | GND | 3 | 12 | false
smart-channel:wire:GND:C_ADC.2~U_VBUF.4 | GND | 6 | voltage-1 | C_ADC | 2 | B | 24 | 18 | voltage-1 | U_VBUF | 4 | VSS | 17 | 18 | false
smart-channel:wire:P2_RAW:J_MODULE.3~R_P2_TOP.1 | P2_RAW | 6 | voltage-1 | J_MODULE | 3 | P2_RAW | 5 | 4 | voltage-1 | R_P2_TOP | 1 | A | 3 | 15 | false
smart-channel:wire:SDA_B:J_MODULE.7~R_SDA.1 | SDA_B | 6 | voltage-1 | J_MODULE | 7 | SDA_B | 7 | 4 | voltage-1 | R_SDA | 1 | A | 9 | 9 | false
smart-channel:wire:SDA_B:J_MODULE.7~U_ADC.9 | SDA_B | 6 | voltage-1 | J_MODULE | 7 | SDA_B | 7 | 4 | voltage-1 | U_ADC | 9 | SDA | 6 | 22 | false
smart-channel:wire:SDA_B:J_MODULE.7~U_BUS.6 | SDA_B | 6 | voltage-1 | J_MODULE | 7 | SDA_B | 7 | 4 | voltage-1 | U_BUS | 6 | SDAB | 6 | 11 | false
smart-channel:wire:3V3_SYS:C_ADC.1~C_BUS_B.1 | 3V3_SYS | 6 | voltage-1 | C_ADC | 1 | A | 23 | 18 | voltage-1 | C_BUS_B | 1 | A | 23 | 6 | false
smart-channel:wire:3V3_SYS:C_ADC.1~C_VBUF.1 | 3V3_SYS | 6 | voltage-1 | C_ADC | 1 | A | 23 | 18 | voltage-1 | C_VBUF | 1 | A | 23 | 15 | false
smart-channel:wire:3V3_SYS:C_ADC.1~J_CONTROL.6 | 3V3_SYS | 6 | voltage-1 | C_ADC | 1 | A | 23 | 18 | voltage-1 | J_CONTROL | 6 | 3V3_SYS | 16 | 5 | false
smart-channel:wire:3V3_SYS:C_ADC.1~J_MODULE.8 | 3V3_SYS | 6 | voltage-1 | C_ADC | 1 | A | 23 | 18 | voltage-1 | J_MODULE | 8 | 3V3_SYS | 7 | 5 | false
smart-channel:wire:3V3_SYS:C_ADC.1~R_SCL.2 | 3V3_SYS | 6 | voltage-1 | C_ADC | 1 | A | 23 | 18 | voltage-1 | R_SCL | 2 | B | 20 | 9 | false
smart-channel:wire:3V3_SYS:C_ADC.1~R_SDA.2 | 3V3_SYS | 6 | voltage-1 | C_ADC | 1 | A | 23 | 18 | voltage-1 | R_SDA | 2 | B | 13 | 9 | false
smart-channel:wire:3V3_SYS:C_ADC.1~U_ADC.8 | 3V3_SYS | 6 | voltage-1 | C_ADC | 1 | A | 23 | 18 | voltage-1 | U_ADC | 8 | VDD | 6 | 23 | false
smart-channel:wire:3V3_SYS:C_ADC.1~U_BUS.8 | 3V3_SYS | 6 | voltage-1 | C_ADC | 1 | A | 23 | 18 | voltage-1 | U_BUS | 8 | VCCB | 6 | 9 | false
smart-channel:wire:3V3_SYS:C_ADC.1~U_VBUF.8 | 3V3_SYS | 6 | voltage-1 | C_ADC | 1 | A | 23 | 18 | voltage-1 | U_VBUF | 8 | VDD | 20 | 15 | false
smart-channel:wire:SCL_B:J_MODULE.9~R_SCL.1 | SCL_B | 6 | voltage-1 | J_MODULE | 9 | SCL_B | 8 | 4 | voltage-1 | R_SCL | 1 | A | 16 | 9 | false
smart-channel:wire:SCL_B:J_MODULE.9~U_ADC.10 | SCL_B | 6 | voltage-1 | J_MODULE | 9 | SCL_B | 8 | 4 | voltage-1 | U_ADC | 10 | SCL | 6 | 21 | false
smart-channel:wire:SCL_B:J_MODULE.9~U_BUS.7 | SCL_B | 6 | voltage-1 | J_MODULE | 9 | SCL_B | 8 | 4 | voltage-1 | U_BUS | 7 | SCLB | 6 | 10 | false
smart-channel:wire:SDA_A:J_CONTROL.7~U_BUS.3 | SDA_A | 6 | voltage-1 | J_CONTROL | 7 | SDA_A | 17 | 4 | voltage-1 | U_BUS | 3 | SDAA | 3 | 11 | false
smart-channel:wire:USB_3V3:C_BUS_A.1~J_CONTROL.8 | USB_3V3 | 6 | voltage-1 | C_BUS_A | 1 | A | 23 | 3 | voltage-1 | J_CONTROL | 8 | USB_3V3 | 17 | 5 | false
smart-channel:wire:USB_3V3:C_BUS_A.1~U_BUS.1 | USB_3V3 | 6 | voltage-1 | C_BUS_A | 1 | A | 23 | 3 | voltage-1 | U_BUS | 1 | VCCA | 3 | 9 | false
smart-channel:wire:USB_3V3:C_BUS_A.1~U_BUS.5 | USB_3V3 | 6 | voltage-1 | C_BUS_A | 1 | A | 23 | 3 | voltage-1 | U_BUS | 5 | EN | 6 | 12 | false
smart-channel:wire:SCL_A:J_CONTROL.9~U_BUS.2 | SCL_A | 6 | voltage-1 | J_CONTROL | 9 | SCL_A | 18 | 4 | voltage-1 | U_BUS | 2 | SCLA | 3 | 10 | false
smart-channel:wire:DIV_P1:C_P1.1~R_P1_BOTTOM.1 | DIV_P1 | 6 | voltage-1 | C_P1 | 1 | A | 23 | 9 | voltage-1 | R_P1_BOTTOM | 1 | A | 16 | 12 | false
smart-channel:wire:DIV_P1:C_P1.1~R_P1_TOP.2 | DIV_P1 | 6 | voltage-1 | C_P1 | 1 | A | 23 | 9 | voltage-1 | R_P1_TOP | 2 | B | 13 | 12 | false
smart-channel:wire:DIV_P1:C_P1.1~U_VBUF.3 | DIV_P1 | 6 | voltage-1 | C_P1 | 1 | A | 23 | 9 | voltage-1 | U_VBUF | 3 | INA_P | 17 | 17 | false
smart-channel:wire:DIV_P2:C_P2.1~R_P2_BOTTOM.1 | DIV_P2 | 6 | voltage-1 | C_P2 | 1 | A | 23 | 12 | voltage-1 | R_P2_BOTTOM | 1 | A | 10 | 15 | false
smart-channel:wire:DIV_P2:C_P2.1~R_P2_TOP.2 | DIV_P2 | 6 | voltage-1 | C_P2 | 1 | A | 23 | 12 | voltage-1 | R_P2_TOP | 2 | B | 7 | 15 | false
smart-channel:wire:DIV_P2:C_P2.1~U_VBUF.5 | DIV_P2 | 6 | voltage-1 | C_P2 | 1 | A | 23 | 12 | voltage-1 | U_VBUF | 5 | INB_P | 20 | 18 | false
smart-channel:wire:BUFFER_P1:R_ADC1.1~U_VBUF.1 | BUFFER_P1 | 6 | voltage-1 | R_ADC1 | 1 | A | 3 | 18 | voltage-1 | U_VBUF | 1 | OUTA | 17 | 15 | false
smart-channel:wire:BUFFER_P1:R_ADC1.1~U_VBUF.2 | BUFFER_P1 | 6 | voltage-1 | R_ADC1 | 1 | A | 3 | 18 | voltage-1 | U_VBUF | 2 | INA_N | 17 | 16 | false
smart-channel:wire:BUFFER_P2:R_ADC2.1~U_VBUF.6 | BUFFER_P2 | 6 | voltage-1 | R_ADC2 | 1 | A | 10 | 18 | voltage-1 | U_VBUF | 6 | INB_N | 20 | 17 | false
smart-channel:wire:BUFFER_P2:R_ADC2.1~U_VBUF.7 | BUFFER_P2 | 6 | voltage-1 | R_ADC2 | 1 | A | 10 | 18 | voltage-1 | U_VBUF | 7 | OUTB | 20 | 16 | false
smart-channel:wire:ADC_P1:R_ADC1.2~U_ADC.4 | ADC_P1 | 6 | voltage-1 | R_ADC1 | 2 | B | 7 | 18 | voltage-1 | U_ADC | 4 | AIN0 | 3 | 24 | false
smart-channel:wire:ADC_P2:R_ADC2.2~U_ADC.5 | ADC_P2 | 6 | voltage-1 | R_ADC2 | 2 | B | 14 | 18 | voltage-1 | U_ADC | 5 | AIN1 | 3 | 25 | false
