gefgu/integration-workshop-3/eletronics/perfboard/tscircuit/revision7/checkpoint-guide.pdf

# CP00 — First light

Filmable win: ESP32 switches the real four-column LED loop.

Construction Add 18 parts/posts, 100 wires and 0 harness conductors. Assemblies: contact-a, router-matrix. Place one component or node column at a time; inspect it separately. Add one wire at a time. Earlier permanent components and wiring remain fixed. • Use revision7 endpoint tables and baseline-crosswalk.csv for relocated references. Legacy hole coordinates do not apply.
- Prototype source only: positive C2 / ground C1; final supply and matrix disconnected.
- OLED uses ESP1 GPIO4 SDA / GPIO16 SCL at 3.3V. Remove diagnostic probes before ordinary operation.

Firmware contract factory LED: GPIO32 defaults LOW; explicit enable/disable; GPIO25 stimulus LOW; all future routing/output controls LOW; revision5 bank acquisition, carrier interfaces and selector ownership supersede legacy ADC pin mapping; r6 preserves GPIO/net protocol; use new physical endpoint crosswalk Measured acceptance • Identify the exact classic ESP32 DevKit pinout, the USB-powered 5V output and 3V3 output. Identify actual pogo and adapter dimensions before soldering. Confirm the four kit pieces fit the selected rows.
- Unpowered A1: all six contacts within each column <1Ω; different columns >10MΩ with external links isolated. Inspect pin1 and the NODE header mapping.
- Prototype disconnected from A1: measure USB 5V ≤5.25V and 3V3 3.20–3.38V. R_LIMIT is 560Ω ±1%, ≥0.25W. With its output shorted, source current ≤9.5mA; remove short before connecting the kit.
- Place fake battery negative C1 / positive C2, 1kΩ resistor C2–C3, LED anode C3 / cathode C4, and kit jumper C4–C1. Prototype J_OUTPUT pin1→A1 J_NODE pin3 and pin2→pin1. No final-power or matrix cable connected.
- Compatible factory firmware: GPIO32 LOW/reset makes LED OFF; explicit enable lights LED; disable turns it OFF. Record USB-test-source voltage at C2 under load; it is intentionally unregulated and must not be called the final 5V rail.
Film Show first light setup with power OFF and display firmware revision. Demonstrate: ESP32 switches the real four-column LED loop. Show the documented negative test and actual recorded readings. Negative case: Disable or reset the ESP32: the LED must go dark without touching the kit.
Record serial numbers, hardware and firmware revisions, equipment, actual readings, temporary-link states and waveforms. Prototype evidence does not transfer. Failed or inconclusive tests block acceptance.

Tedtronics · revision7 · EVALUATION ONLY · 1

# CP01 — Reject an open contact

Filmable win: A lifted jumper contact is electronically rejected.

Construction Add 38 parts/posts, 66 wires and 2 harness conductors. Assemblies: measurement-a-precision. Place one component or node column at a time; inspect it separately. Add one wire at a time. Earlier permanent components and wiring remain fixed. • Use revision7 endpoint tables and baseline-crosswalk.csv for relocated references. Legacy hole coordinates do not apply.
- USB test-source positive lead unplugged; final supply and matrix leads absent.
- TEST_A→A1 C4, TEST_B→C1; JP_RETURN fitted only during diagnostic test.
- Before LED enable: stimulus OFF, JP_RETURN/probes removed, prototype positive restored with power OFF.
- Use bank-A precision input pair for TEST_A=C4 / TEST_B=C1 through removable sense leads. Its permanent NODE00/NODE01 harness is absent until CP06. Select CD4052 channel0; verify actual ADC/buffer supply before stimulus.

Firmware contract factory fixed-pair continuity: GPIO4 SDA,16 SCL,25 stimulus; ADS1115 0x48; manual source isolation; reject open/wrong/inconclusive, fresh test + explicit enable; revision5 bank acquisition, carrier interfaces and selector ownership supersede legacy ADC pin mapping; r6 preserves GPIO/net protocol; use new physical endpoint crosswalk Measured acceptance • Student supply OFF and positive fixed-battery lead unplugged. TEST_A→C4, TEST_B→C1; fit JP_RETURN only during test. Check stimulus current ≤0.34mA and educational contact voltages 0– 5.25V.
- Calibrate open, a known short and 1kΩ. Measure open stimulus voltage Vs with DMM; infer R=11k×V/(Vs−V), accounting for divider gain and input loading. Known short ≤20Ω; ≥100Ω rejected; 20–100Ω or saturated/unstable readings inconclusive and OFF. Compare inferred short with DMM continuity <1Ω.
- Test the actual four-piece scene: correct C4–C1 kit jumper passes; one lifted contact and wrong-node placements fail. Include alternate paths through LED/ resistor in calibration; no false pass through a component.
Film Show reject an open contact setup with power OFF and display firmware revision. Demonstrate: A lifted jumper contact is electronically rejected. Show the documented negative test and actual recorded readings. Negative case: Lift the return jumper while retaining its convincing visual position: the electronic test rejects it.
Record serial numbers, hardware and firmware revisions, equipment, actual readings, temporary-link states and waveforms. Prototype evidence does not transfer. Failed or inconclusive tests block acceptance.

# CP02 — Reject a wrong node

Filmable win: A convincing-looking jumper on the wrong node is rejected.

Construction Add 0 parts/posts, 0 wires and 0 harness conductors. Assemblies: . Place one component or node column at a time; inspect it separately. Add one wire at a time. Earlier permanent components and wiring remain fixed. • Use revision7 endpoint tables and baseline-crosswalk.csv for relocated references. Legacy hole coordinates do not apply.
- USB test-source positive lead unplugged; final supply and matrix leads absent.
- TEST_A→A1 C4, TEST_B→C1; JP_RETURN fitted only during diagnostic test.
- Before LED enable: stimulus OFF, JP_RETURN/probes removed, prototype positive restored with power OFF.
- Use bank-A precision input pair for TEST_A=C4 / TEST_B=C1 through removable sense leads. Its permanent NODE00/NODE01 harness is absent until CP06. Select CD4052 channel0; verify actual ADC/buffer supply before stimulus.

Firmware contract factory fixed-pair continuity: GPIO4 SDA,16 SCL,25 stimulus; ADS1115 0x48; manual source isolation; reject open/wrong/inconclusive, fresh test + explicit enable; revision5 bank acquisition, carrier interfaces and selector ownership supersede legacy ADC pin mapping; r6 preserves GPIO/net protocol; use new physical endpoint crosswalk Measured acceptance • Test the actual four-piece scene: correct C4–C1 kit jumper passes; one lifted contact and wrong-node placements fail. Include alternate paths through LED/resistor in calibration; no false pass through a component.
- Simulated camera approval + failed/inconclusive electrical result keeps student supply OFF. Correction requires a fresh electrical test and separate enable request. Film Show reject a wrong node setup with power OFF and display firmware revision. Demonstrate: A convincing-looking jumper on the wrong node is rejected. Show the documented negative test and actual recorded readings. Negative case: Connect the jumper to a different column: electronic rejection persists despite simulated camera approval.
Record serial numbers, hardware and firmware revisions, equipment, actual readings, temporary-link states and waveforms. Prototype evidence does not transfer. Failed or inconclusive tests block acceptance.

# CP03 — Correction needs a fresh test

Filmable win: Correcting the jumper requires a fresh pass and a separate enable request.

Construction Add 0 parts/posts, 0 wires and 0 harness conductors. Assemblies: . Place one component or node column at a time; inspect it separately. Add one wire
at a time. Earlier permanent components and wiring remain fixed. • Use revision7 endpoint tables and baseline-crosswalk.csv for relocated references. Legacy hole coordinates do not apply.
- USB test-source positive lead unplugged; final supply and matrix leads absent.
- TEST_A→A1 C4, TEST_B→C1; JP_RETURN fitted only during diagnostic test.
- Before LED enable: stimulus OFF, JP_RETURN/probes removed, prototype positive restored with power OFF.
- Use bank-A precision input pair for TEST_A=C4 / TEST_B=C1 through removable sense leads. Its permanent NODE00/NODE01 harness is absent until CP06. Select CD4052 channel0; verify actual ADC/buffer supply before stimulus.

Firmware contract factory fixed-pair continuity: GPIO4 SDA,16 SCL,25 stimulus; ADS1115 0x48; manual source isolation; reject open/wrong/inconclusive, fresh test + explicit enable; revision5 bank acquisition, carrier interfaces and selector ownership supersede legacy ADC pin mapping; r6 preserves GPIO/net protocol; use new physical endpoint crosswalk Measured acceptance • Before enable: stimulus OFF, JP_RETURN removed, test leads disconnected, fixed battery lead restored with power off. No automatic enable after a passing test.
- Simulated camera approval + failed/inconclusive electrical result keeps student supply OFF. Correction requires a fresh electrical test and separate enable request. Film Show correction needs a fresh test setup with power OFF and display firmware revision. Demonstrate: Correcting the jumper requires a fresh pass and a separate enable request. Show the documented negative test and actual recorded readings. Negative case: Refit the correct jumper without a new test: it must remain OFF until a fresh pass and separate enable request.
Record serial numbers, hardware and firmware revisions, equipment, actual readings, temporary-link states and waveforms. Prototype evidence does not transfer. Failed or inconclusive tests block acceptance.

# CP04 — Capsule greeting

Filmable win: One capsule displays a real pt-BR greeting.

Construction Add 0 parts/posts, 0 wires and 0 harness conductors. Assemblies: . Place one component or node column at a time; inspect it separately. Add one wire at a time. Earlier permanent components and wiring remain fixed. • Use revision7 endpoint tables and baseline-crosswalk.csv for relocated references. Legacy hole coordinates do not apply.
- Prototype source only: positive C2 / ground C1; final supply and matrix disconnected.
- OLED uses ESP1 GPIO4 SDA / GPIO16 SCL at 3.3V. Remove diagnostic probes before ordinary operation.

Firmware contract factory OLED on ESP1: GPIO4 SDA /16 SCL, 0x3C; report identity and OFF/ready; no relay requests; revision5 bank acquisition, carrier interfaces and selector ownership supersede legacy ADC pin mapping; r6 preserves GPIO/net protocol; use new physical endpoint crosswalk Measured acceptance • Connect only one OLED at 0x3C to ESP1 FIX_SDA GPIO4 / FIX_SCL GPIO16 using 3.3V logic and removable leads. Use one effective set of pull-ups; continuity fixture must be unplugged when it is not used. Confirm carrier pin labels before power.
- OLED displays greeting with educational source OFF. Display unplug/reconnect and reset do not automatically enable the source.
Film Show capsule greeting setup with power OFF and display firmware revision. Demonstrate: One capsule displays a real pt-BR greeting. Show the documented negative test and actual recorded readings. Negative case: Unplug the OLED with power OFF: report missing hardware; a simulated greeting is not a pass.
Record serial numbers, hardware and firmware revisions, equipment, actual readings, temporary-link states and waveforms. Prototype evidence does not transfer. Failed or inconclusive tests block acceptance.

# CP05 — Identity and OFF status

Filmable win: The capsule displays its identity and actual OFF/ready state.

Construction Add 0 parts/posts, 0 wires and 0 harness conductors. Assemblies: . Place one component or node column at a time; inspect it separately. Add one wire at a time. Earlier permanent components and wiring remain fixed. • Use revision7 endpoint tables and baseline-crosswalk.csv for relocated references. Legacy hole coordinates do not apply.
- Prototype source only: positive C2 / ground C1; final supply and matrix disconnected.
- OLED uses ESP1 GPIO4 SDA / GPIO16 SCL at 3.3V. Remove diagnostic probes before ordinary operation.

Firmware contract factory OLED on ESP1: GPIO4 SDA /16 SCL, 0x3C; report identity and OFF/ready; no relay requests; revision5 bank acquisition, carrier interfaces and selector ownership supersede legacy ADC pin mapping; r6 preserves GPIO/net protocol; use new physical endpoint crosswalk Measured acceptance • Display position A1, firmware revision, and Desligado/Pronto states. Never substitute a simulated GUI status for an actual hardware observation.
Film Show identity and off status setup with power OFF and display firmware revision. Demonstrate: The capsule displays its identity and actual OFF/ready state. Show the documented negative test and actual recorded readings. Negative case: Change identity or remove the capsule: retain OFF and require a new configuration. Record serial numbers, hardware and firmware revisions, equipment, actual readings, temporary-link states and waveforms. Prototype evidence does not transfer. Failed or inconclusive tests block acceptance.

# CP06 — Voltage calibration

Filmable win: The voltage input matches known zero and reference readings.

Construction Add 14 parts/posts, 25 wires and 10 harness conductors. Assemblies: contact-a, bank-a-position-0. Place one component or node column at a time; inspect it separately. Add one wire at a time. Earlier permanent components and wiring remain fixed. • Use revision7 endpoint tables and baseline-crosswalk.csv for relocated references. Legacy hole coordinates do not apply.
- Prototype source only: positive C2 / ground C1; final supply and matrix disconnected.
- OLED uses ESP1 GPIO4 SDA / GPIO16 SCL at 3.3V. Remove diagnostic probes before ordinary operation.
- Reuse bank-A ADC/buffer. Remove diagnostic probes, JP_RETURN and stimulus leads; attach permanent NODE00/NODE01 harness. Connect service position0 after inspecting pull-ups; no duplicate ADC fixture.

Firmware contract factory voltage: ESP1 OLED + local ADS1115 0x48; USB3V3 to isolated card supply via removable links; P3/ammeter disconnected; revision5 bank acquisition, carrier interfaces and selector ownership supersede legacy ADC pin mapping; r6 preserves GPIO/net protocol; use new physical endpoint crosswalk Measured acceptance • Verify ADS1115 0x48. Sweep P1/P2 within 0–5.25V; compare displayed signed difference with DMM at 0,1,2.5,5V. Error ≤0.10V+5%| reading|, impedance ≥1MΩ, update rate ≥10Hz.
- Reverse sense polarity to show a negative difference; do not apply negative absolute contact voltages. P3 remains disconnected and ammeter paths open. Film Show voltage calibration setup with power OFF and display firmware revision. Demonstrate: The voltage input matches known zero and reference readings. Show the documented negative test and actual recorded readings. Negative case: Apply a known reference outside the accepted calibration tolerance: reject the calibration. Record serial numbers, hardware and firmware revisions, equipment, actual readings, temporary-link states and waveforms. Prototype evidence does not transfer. Failed or inconclusive tests block acceptance.

# CP07 — Read real voltage

Filmable win: The capsule reading follows the multimeter as loop voltage changes.

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

Firmware contract factory voltage: ESP1 OLED + local ADS1115 0x48; USB3V3 to isolated card supply via removable links; P3/ammeter disconnected; revision5 bank acquisition, carrier interfaces and selector ownership supersede legacy ADC pin mapping; r6 preserves GPIO/net protocol; use new physical endpoint crosswalk Measured acceptance • With prototype source and diagnostic probes isolated as specified, compare capsule V(P1)−V(P2) with DMM at zero and the actual limited-source voltage. Error ≤0.10V+5%|reading|; ≥10 updates/s. All node absolute voltages 0–5.25V.
Film Show read real voltage setup with power OFF and display firmware revision. Demonstrate: The capsule reading follows the multimeter as loop voltage changes. Show the documented negative test and actual recorded readings. Negative case: Remove the measured source: display the actual near-zero voltage, not a cached reading.
Record serial numbers, hardware and firmware revisions, equipment, actual readings, temporary-link states and waveforms. Prototype evidence does not transfer. Failed or inconclusive tests block acceptance.

# CP08 — Signed voltage

Filmable win: Swapping only the measurement leads reverses the reading sign.

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

Firmware contract factory voltage: ESP1 OLED + local ADS1115 0x48; USB3V3 to isolated card supply via removable links; P3/ammeter disconnected; revision5 bank acquisition, carrier interfaces and selector ownership supersede legacy ADC pin mapping; r6 preserves GPIO/net protocol; use new physical endpoint crosswalk Measured acceptance • Power OFF before swapping P1/P2 removable measurement leads. Compare signed differential reading with DMM in both orientations; never apply a negative absolute node voltage. P3 and ammeter paths remain disconnected.
Film Show signed voltage setup with power OFF and display firmware revision. Demonstrate: Swapping only the measurement leads reverses the reading sign. Show the documented negative test and actual recorded readings. Negative case: Reverse the test leads: the sign must reverse with the same magnitude tolerance. Record serial numbers, hardware and firmware revisions, equipment, actual readings, temporary-link states and waveforms. Prototype evidence does not transfer. Failed or inconclusive tests block acceptance.

# CP09 — Regulated rails

Filmable win: The isolated final regulators produce their specified voltages.

Construction Add 30 parts/posts, 102 wires and 8 harness conductors. Assemblies: power. Place one component or node column at a time; inspect it separately. Add one wire at a time. Earlier permanent components and wiring remain fixed. • Use revision7 endpoint tables and baseline-crosswalk.csv for relocated references. Legacy hole coordinates do not apply.
- USB prototype source and prototype 3V3 links removed before final supplies connect.
- Use checkpoint-specific bounded test loads; stop and isolate power before changing any link.
- Keep JP_LOGIC and JP_3V3 open while adjusting and qualifying both purchased buck outputs. Final consumers are not connected at this checkpoint.

Firmware contract factory final-power qualification: explicit enable/reset; supervised ALIVE link only before CP13; no production authorization; revision5 bank acquisition, carrier interfaces and selector ownership supersede legacy ADC pin mapping; r6 preserves GPIO/net protocol; use new physical endpoint crosswalk Measured acceptance • Unpowered: every rail >1kΩ to GND after capacitor charging; no accidental node/service connection.
- With links open: 5V buck 4.90–5.04V; 3.3V buck 3.20–3.38V. Current-limited 12V supply, 100mA initially.
Film Show regulated rails setup with power OFF and display firmware revision. Demonstrate: The isolated final regulators produce their specified voltages. Show the documented negative test and actual recorded readings. Negative case: Apply no input: outputs remain unpowered; never invent a regulator reading.
Record serial numbers, hardware and firmware revisions, equipment, actual readings, temporary-link states and waveforms. Prototype evidence does not transfer. Failed or inconclusive tests block acceptance.

# CP10 — Overvoltage guards

Filmable win: Each supply guard rejects an out-of-range source.

Construction Add 18 parts/posts, 44 wires and 0 harness conductors. Assemblies: power. Place one component or node column at a time; inspect it separately. Add one wire at a time. Earlier permanent components and wiring remain fixed. • Use revision7 endpoint tables and baseline-crosswalk.csv for relocated references. Legacy hole coordinates do not apply.
- USB prototype source and prototype 3V3 links removed before final supplies connect.
- Use checkpoint-specific bounded test loads; stop and isolate power before changing any link.

Firmware contract factory final-power qualification: explicit enable/reset; supervised ALIVE link only before CP13; no production authorization; revision5 bank acquisition, carrier interfaces and selector ownership supersede legacy ADC pin mapping; r6 preserves GPIO/net protocol; use new physical endpoint crosswalk Measured acceptance • Independent OV disconnects: sweep 5V/3V3 buck interfaces with consumers isolated; verify actual thresholds and strict contact peak ≤5.25V during a bounded 12V failed-buck step. Test both guards separately before connecting any IC.
Film Show overvoltage guards setup with power OFF and display firmware revision. Demonstrate: Each supply guard rejects an out-of-range source. Show the documented negative test and actual recorded readings. Negative case: Raise each rail above its documented trip threshold using the bounded fixture: guard must reject.
Record serial numbers, hardware and firmware revisions, equipment, actual readings, temporary-link states and waveforms. Prototype evidence does not transfer. Failed or inconclusive tests block acceptance.

# CP11 — OFF at startup and reset

Filmable win: The final student rail remains OFF at startup and reset.

Construction Add 50 parts/posts, 133 wires and 5 harness conductors. Assemblies: power, router-matrix. Place one component or node column at a time; inspect it separately. Add one wire at a time. Earlier permanent components and wiring remain fixed. • Use revision7 endpoint tables and baseline-crosswalk.csv for relocated references. Legacy hole coordinates do not apply.
- USB prototype source and prototype 3V3 links removed before final supplies connect.
- Use checkpoint-specific bounded test loads; stop and isolate power before changing any link.
- Factory ALIVE fixture is temporary: J_PROTOTYPE pin2 USB3V3→J_POWER pin9 only during supervised load qualification. LOW/open for startup/reset; remove permanently before CP13.
- Remove the temporary USB-router-to-3V3_SYS feed before fitting qualified JP_LOGIC/JP_3V3 consumer links. Never parallel USB and buck rails.

Firmware contract factory final-power qualification: explicit enable/reset; supervised ALIVE link only before CP13; no production authorization; revision5 bank acquisition, carrier interfaces and selector ownership supersede legacy ADC pin mapping; r6 preserves GPIO/net protocol; use new physical endpoint crosswalk Measured acceptance • Prototype USB positive and 3V3 supply links are removed before connecting final consumer links. Only one educational source may be connected. Inspect all power-board blocks before enabling; the student latch must not be powered as an incomplete circuit.
- Supervised factory qualification only: ALIVE is held LOW for startup/reset tests. All consumer links remain open until voltage guards pass. USB removal, held reset and a power cycle leave 5V_EDU OFF.
Film Show off at startup and reset setup with power OFF and display firmware revision. Demonstrate: The final student rail remains OFF at startup and reset. Show the documented negative test and actual recorded readings. Negative case: Reset or reconnect USB with enable previously requested: startup remains OFF.
Record serial numbers, hardware and firmware revisions, equipment, actual readings, temporary-link states and waveforms. Prototype evidence does not transfer. Failed or inconclusive tests block acceptance.

# CP12 — Overload trip and latch

Filmable win: An overload shuts down and stays latched until a valid reset.

Construction Add 0 parts/posts, 0 wires and 0 harness conductors. Assemblies: . Place one component or node column at a time; inspect it separately. Add one wire at a time. Earlier permanent components and wiring remain fixed. • Use revision7 endpoint tables and baseline-crosswalk.csv for relocated references. Legacy hole coordinates do not apply.
- USB prototype source and prototype 3V3 links removed before final supplies connect.
- Use checkpoint-specific bounded test loads; stop and isolate power before changing any link.
- Factory ALIVE fixture is temporary: J_PROTOTYPE pin2 USB3V3→J_POWER pin9 only during supervised load qualification. LOW/open for startup/reset; remove permanently before CP13.

Firmware contract factory final-power qualification: explicit enable/reset; supervised ALIVE link only before CP13; no production authorization; revision5 bank acquisition, carrier interfaces and selector ownership supersede legacy ADC pin mapping; r6 preserves GPIO/net protocol; use new physical endpoint crosswalk Measured acceptance • 1kΩ and 470Ω rail loads remain enabled; 330Ω or 100Ω load trips and remains latched. At 10mA: 5V_EDU 4.75–5.25V.
- Sweep load: trip threshold must be >10.6mA and ≤12mA; record REF_TRIP and CURRENT_SENSE.
- Supervised factory load test only: with power OFF, USB3V3→matrix J_POWER pin9 holds ALIVE high until CP13 watchdog exists. Explicit enable applies the bounded load; reset under overload must not release the latch. Remove the factory ALIVE link or hold it LOW to simulate heartbeat loss and prove OFF. Remove this link permanently at CP13.
Film Show overload trip and latch setup with power OFF and display firmware revision. Demonstrate: An overload shuts down and stays latched until a valid reset. Show the documented negative test and actual recorded readings. Negative case: Apply the qualified overload: shutdown latches; clearing the fault does not re-enable.
Record serial numbers, hardware and firmware revisions, equipment, actual readings, temporary-link states and waveforms. Prototype evidence does not transfer. Failed or inconclusive tests block acceptance.

# CP13 — Heartbeat shutdown

Filmable win: Stopping the controller heartbeat switches the final rail OFF.

Construction Add 10 parts/posts, 27 wires and 0 harness conductors. Assemblies: router-matrix. Place one component or node column at a time; inspect it separately. Add one wire at a time. Earlier permanent components and wiring remain fixed. • Use revision7 endpoint tables and baseline-crosswalk.csv for relocated references. Legacy hole coordinates do not apply.
- USB prototype source and prototype 3V3 links removed before final supplies connect.
- Use checkpoint-specific bounded test loads; stop and isolate power before changing any link.

Firmware contract factory final-power qualification: explicit enable/reset; supervised ALIVE link only before CP13; no production authorization; revision5 bank acquisition, carrier interfaces and selector ownership supersede legacy ADC pin mapping; r6 preserves GPIO/net protocol; use new physical endpoint crosswalk Measured acceptance • Replace any supervised factory ALIVE link with the completed USB-powered hardware watchdog. Send heartbeat ≤100ms; stopping heartbeat or removing USB must switch rail OFF within 350ms and not restart automatically. Record scope timing.
Film Show heartbeat shutdown setup with power OFF and display firmware revision. Demonstrate: Stopping the controller heartbeat switches the final rail OFF. Show the documented negative test and actual recorded readings. Negative case: Hold heartbeat static HIGH or LOW: watchdog must time out and disable power.
Record serial numbers, hardware and firmware revisions, equipment, actual readings, temporary-link states and waveforms. Prototype evidence does not transfer. Failed or inconclusive tests block acceptance.

# CP14 — Cutoff timing and transients

Filmable win: Measured cutoff timing and contact peaks meet the final limits.

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

Firmware contract factory final-power qualification: explicit enable/reset; supervised ALIVE link only before CP13; no production authorization; revision5 bank acquisition, carrier interfaces and selector ownership supersede legacy ADC pin mapping; r6 preserves GPIO/net protocol; use new physical endpoint crosswalk Measured acceptance • Scope current at a switched 100Ω load: source current cut off within 1ms, including frozen controller. Do not use UART timestamps as timing evidence.
- Independent OV disconnects: sweep 5V/3V3 buck interfaces with consumers isolated; verify actual thresholds and strict contact peak ≤5.25V during a bounded 12V failed-buck step. Test both guards separately before connecting any IC.
Film Show cutoff timing and transients setup with power OFF and display firmware revision. Demonstrate: Measured cutoff timing and contact peaks meet the final limits. Show the documented negative test and actual recorded readings. Negative case: Capture the documented cutoff transient; an excessive peak or slow shutdown is a failure.
Record serial numbers, hardware and firmware revisions, equipment, actual readings, temporary-link states and waveforms. Prototype evidence does not transfer. Failed or inconclusive tests block acceptance.

# CP15 — Bounded source and sink

Filmable win: Smart output drives valid levels and limits short-circuit current.

Construction Add 124 parts/posts, 185 wires and 37 harness conductors. Assemblies: smart-core, smart-safety, measurement-a-buffers, bank-a-position-0. Place one component or node column at a time; inspect it separately. Add one wire at a time. Earlier permanent components and wiring remain fixed. • Use revision7 endpoint tables and baseline-crosswalk.csv for relocated references. Legacy hole coordinates do not apply.
- USB prototype source and prototype 3V3 links removed before final supplies connect.
- Use checkpoint-specific bounded test loads; stop and isolate power before changing any link.
- For smart-mode bench fixtures, disconnect both fixed battery leads and remove the initial kit loop. Output load: P3→1kΩ→LED anode, LED cathode→GND through removable leads. Logic inputs: HIGH=qualified3V3_SYS through1kΩ; LOW=GND through1kΩ. AND/OR exercise00,01,10,11; NOT exercise0,1. Never parallel another source with P3. Current tests use a documented series path, never an ammeter across the supply.
- Remove temporary ESP1 I2C/mux and USB-router-to-3V3_SYS links. ESP2 owns mux select and measurement; only final regulated rails supply bank electronics.

Firmware contract smart factory mode on ESP2: migrate OLED/ADC service to its isolated position bus; register outputs OFF until qualified; valid heartbeat required; revision5 bank acquisition, carrier interfaces and selector ownership supersede legacy ADC pin mapping; r6 preserves GPIO/net protocol; use new physical endpoint crosswalk Measured acceptance • P3 low ≤0.5V and high ≥3.5V with measured 2mA load. Short to GND and separately to 5.25V: ≤12mA; scope transient and regulator oscillation.
- Pulse 0.5/1/10Hz and duty 25/50/75%: frequency ±5%; duty ±5 percentage points; measure at the physical node.
Film Show bounded source and sink setup with power OFF and display firmware revision. Demonstrate: Smart output drives valid levels and limits short-circuit current. Show the documented negative test and actual recorded readings. Negative case: Use the qualified bounded short test: hardware clamps current and remains within limits.

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

# CP16 — Pulse frequency

Filmable win: The real output changes its blink frequency.

Construction Add 0 parts/posts, 0 wires and 0 harness conductors. Assemblies: . Place one component or node column at a time; inspect it separately. Add one wire at a time. Earlier permanent components and wiring remain fixed. • Use revision7 endpoint tables and baseline-crosswalk.csv for relocated references. Legacy hole coordinates do not apply.
- USB prototype source and prototype 3V3 links removed before final supplies connect.
- Use checkpoint-specific bounded test loads; stop and isolate power before changing any link.
- For smart-mode bench fixtures, disconnect both fixed battery leads and remove the initial kit loop. Output load: P3→1kΩ→LED anode, LED cathode→GND through removable leads. Logic inputs: HIGH=qualified3V3_SYS through1kΩ; LOW=GND through1kΩ. AND/OR exercise00,01,10,11; NOT exercise0,1. Never parallel another source with P3. Current tests use a documented series path, never an ammeter across the supply.

Firmware contract smart factory mode on ESP2: migrate OLED/ADC service to its isolated position bus; register outputs OFF until qualified; valid heartbeat required; revision5 bank acquisition, carrier interfaces and selector ownership supersede legacy ADC pin mapping; r6 preserves GPIO/net protocol; use new physical endpoint crosswalk Measured acceptance • Use a separately documented LED+1kΩ output fixture on P3. Do not connect the fixed battery to P3. OFF/reset/invalid state disables both output relays.
Film Show pulse frequency setup with power OFF and display firmware revision. Demonstrate: The real output changes its blink frequency. Show the documented negative test and actual recorded readings. Negative case: Request a frequency outside 0.5–10Hz: reject configuration with output OFF.

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

# CP17 — Pulse duty cycle

Filmable win: Changing duty cycle changes the real pulse waveform.

Construction Add 0 parts/posts, 0 wires and 0 harness conductors. Assemblies: . Place one component or node column at a time; inspect it separately. Add one wire at a time. Earlier permanent components and wiring remain fixed. • Use revision7 endpoint tables and baseline-crosswalk.csv for relocated references. Legacy hole coordinates do not apply.
- USB prototype source and prototype 3V3 links removed before final supplies connect.
- Use checkpoint-specific bounded test loads; stop and isolate power before changing any link.
- For smart-mode bench fixtures, disconnect both fixed battery leads and remove the initial kit loop. Output load: P3→1kΩ→LED anode, LED cathode→GND through removable leads. Logic inputs: HIGH=qualified3V3_SYS through1kΩ; LOW=GND through1kΩ. AND/OR exercise00,01,10,11; NOT exercise0,1. Never parallel another source with P3. Current tests use a documented series path, never an ammeter across the supply.

Firmware contract smart factory mode on ESP2: migrate OLED/ADC service to its isolated position bus; register outputs OFF until qualified; valid heartbeat required; revision5 bank acquisition, carrier interfaces and selector ownership supersede legacy ADC pin mapping; r6 preserves GPIO/net protocol; use new physical endpoint crosswalk Measured acceptance • Scope 25%, 50%, 75% duty at a known frequency; error ≤5 percentage points. Frequency 0.5–10Hz ±5%; ≥5ms break-before-make; changing mode first turns output OFF.
Film Show pulse duty cycle setup with power OFF and display firmware revision. Demonstrate: Changing duty cycle changes the real pulse waveform. Show the documented negative test and actual recorded readings. Negative case: Request duty outside 25–75%: reject configuration with output OFF.

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

# CP18 — AND gate

Filmable win: The LED follows the AND truth table.

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

Firmware contract smart factory mode on ESP2: migrate OLED/ADC service to its isolated position bus; register outputs OFF until qualified; valid heartbeat required; revision5 bank acquisition, carrier interfaces and selector ownership supersede legacy ADC pin mapping; r6 preserves GPIO/net protocol; use new physical endpoint crosswalk Measured acceptance • Test each selected gate truth table using protected input levels. Require 20ms stable input and ≤100ms output response. Confirm open inputs read LOW.
- Record all four AND input combinations using bounded removable links and DMM-confirmed input levels.
Film Show and gate setup with power OFF and display firmware revision. Demonstrate: The LED follows the AND truth table. Show the documented negative test and actual recorded readings. Negative case: AND inputs01,10 and00 must remain LOW; only11 may be HIGH.

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

# CP19 — OR gate

Filmable win: The LED follows the OR truth table.

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

Firmware contract smart factory mode on ESP2: migrate OLED/ADC service to its isolated position bus; register outputs OFF until qualified; valid heartbeat required; revision5 bank acquisition, carrier interfaces and selector ownership supersede legacy ADC pin mapping; r6 preserves GPIO/net protocol; use new physical endpoint crosswalk Measured acceptance • Record all four OR input combinations: input ≤1V LOW, ≥3V HIGH; 20ms stability and output response ≤100ms.
Film Show or gate setup with power OFF and display firmware revision. Demonstrate: The LED follows the OR truth table. Show the documented negative test and actual recorded readings. Negative case: OR inputs00 must remain LOW;01,10 and11 must be HIGH.

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

# CP20 — NOT gate

Filmable win: The LED follows the NOT truth table.

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

Firmware contract smart factory mode on ESP2: migrate OLED/ADC service to its isolated position bus; register outputs OFF until qualified; valid heartbeat required; revision5 bank acquisition, carrier interfaces and selector ownership supersede legacy ADC pin mapping; r6 preserves GPIO/net protocol; use new physical endpoint crosswalk Measured acceptance • Record LOW→HIGH and HIGH→LOW inversion; retain previous state in the input hysteresis band. Reset and invalid configurations leave output OFF.
Film Show not gate setup with power OFF and display firmware revision. Demonstrate: The LED follows the NOT truth table. Show the documented negative test and actual recorded readings. Negative case: NOT inputHIGH must produce LOW; inputLOW must produce HIGH.

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

# CP21 — SR memory

Filmable win: Set persists, and reset wins.

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

Firmware contract smart factory mode on ESP2: migrate OLED/ADC service to its isolated position bus; register outputs OFF until qualified; valid heartbeat required; revision5 bank acquisition, carrier interfaces and selector ownership supersede legacy ADC pin mapping; r6 preserves GPIO/net protocol; use new physical endpoint crosswalk Measured acceptance • Set output, remove the set input and verify retained state. Reset clears it. Simultaneous set/reset resolves to zero.
- Restart, rail OFF or configuration loss clears memory and leaves output disabled. Film Show sr memory setup with power OFF and display firmware revision. Demonstrate: Set persists, and reset wins. Show the documented negative test and actual recorded readings. Negative case: Assert set and reset together: reset wins; rail-off loses the stored state.

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

# CP22 — Current calibration

Filmable win: The ammeter matches known signed currents.

Construction Add 10 parts/posts, 18 wires and 3 harness conductors. Assemblies: bank-a-position-0. Place one component or node column at a time; inspect it separately. Add one wire at a time. Earlier permanent components and wiring remain fixed. • Use revision7 endpoint tables and baseline-crosswalk.csv for relocated references. Legacy hole coordinates do not apply.
- USB prototype source and prototype 3V3 links removed before final supplies connect.
- Use checkpoint-specific bounded test loads; stop and isolate power before changing any link.
- For smart-mode bench fixtures, disconnect both fixed battery leads and remove the initial kit loop. Output load: P3→1kΩ→LED anode, LED cathode→GND through removable leads. Logic inputs: HIGH=qualified3V3_SYS through1kΩ; LOW=GND through1kΩ. AND/OR exercise00,01,10,11; NOT exercise0,1. Never parallel another source with P3. Current tests use a documented series path, never an ammeter across the supply.

Firmware contract smart factory mode on ESP2: migrate OLED/ADC service to its isolated position bus; register outputs OFF until qualified; valid heartbeat required; revision5 bank acquisition, carrier interfaces and selector ownership supersede legacy ADC pin mapping; r6 preserves GPIO/net protocol; use new physical endpoint crosswalk Measured acceptance • Current mode ±0/1/5/10mA: error ≤0.20mA+5%|reading|, ≥10 updates/s; voltage modes must leave ammeter switches open.
- INA226 with external 1Ω shunt 0x40 responds. Use a documented series test arrangement and removable leads; do not assume four-column capsule geometry supports every series arrangement.
- OFF, voltage or output mode opens both ammeter terminals. Verify leakage ≤10µA with test stimulus disconnected.
Film Show current calibration setup with power OFF and display firmware revision. Demonstrate: The ammeter matches known signed currents. Show the documented negative test and actual recorded readings. Negative case: Use an incorrect current calibration: reject it rather than displaying an accepted value.
Record serial numbers, hardware and firmware revisions, equipment, actual readings, temporary-link states and waveforms. Prototype evidence does not transfer. Failed or inconclusive tests block acceptance.

# CP23 — Read loop current

Filmable win: Changing a real resistor changes measured series current.

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

Firmware contract smart factory mode on ESP2: migrate OLED/ADC service to its isolated position bus; register outputs OFF until qualified; valid heartbeat required; revision5 bank acquisition, carrier interfaces and selector ownership supersede legacy ADC pin mapping; r6 preserves GPIO/net protocol; use new physical endpoint crosswalk Measured acceptance • Power OFF to change the documented series fixture between 1kΩ and 470Ω. Compare OLED current with DMM; ≤0.20mA+5%| reading| error. Never put the ammeter directly across the supply.
Film Show read loop current setup with power OFF and display firmware revision. Demonstrate: Changing a real resistor changes measured series current. Show the documented negative test and actual recorded readings. Negative case: Exit current mode: both ammeter terminals disconnect; verify rather than shorting the supply.

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

# CP24 — Route one LED loop

Filmable win: The matrix completes one bounded LED loop.

Construction Add 55 parts/posts, 136 wires and 4 harness conductors. Assemblies: router-matrix. Place one component or node column at a time; inspect it separately. Add one wire at a time. Earlier permanent components and wiring remain fixed. • Use revision7 endpoint tables and baseline-crosswalk.csv for relocated references. Legacy hole coordinates do not apply.
- USB prototype source and prototype 3V3 links removed before final supplies connect.
- Use checkpoint-specific bounded test loads; stop and isolate power before changing any link.
- Remove all fixed source patch leads before matrix routing. Source node selection now belongs to the qualified matrix topology.

Firmware contract router+smart production interlock: final power qualified; valid topology; bounded matrix tool current; fresh ACKs; revision5 bank acquisition, carrier interfaces and selector ownership supersede legacy ADC pin mapping; r6 preserves GPIO/net protocol; use new physical endpoint crosswalk Measured acceptance • MT supply 10.0–12.6V, digital high ≥3.3V, low ≤0.8V; reset and CS active high.
- Sweep all X addresses and Y buses, proving the non-monotonic X address map. Banks share BUS2…BUS7.
- Boot/reset/watchdog expiry: all crosspoints open. Disable rail, clear, configure, precheck, then enable; never configure live.
- Scope full clear + 22-node configuration ≤50ms at the physical strobe pins; verify Ron at 0/2.5/5V.
- Calibrate with 1kΩ 0.1%; distinguish open, short, 220Ω, 1kΩ and diode polarity; resistance error ≤10% after calibration.
Film Show route one led loop setup with power OFF and display firmware revision. Demonstrate: The matrix completes one bounded LED loop. Show the documented negative test and actual recorded readings. Negative case: Remove enable or a required acknowledgement: matrix LED loop remains OFF.
Record serial numbers, hardware and firmware revisions, equipment, actual readings, temporary-link states and waveforms. Prototype evidence does not transfer. Failed or inconclusive tests block acceptance.

# CP25 — Inspect a routed jumper

Filmable win: The matrix test tools distinguish a routed short from an open.

Construction Add 0 parts/posts, 0 wires and 0 harness conductors. Assemblies: . Place one component or node column at a time; inspect it separately. Add one wire at a time. Earlier permanent components and wiring remain fixed. • Use revision7 endpoint tables and baseline-crosswalk.csv for relocated references. Legacy hole coordinates do not apply.
- USB prototype source and prototype 3V3 links removed before final supplies connect.
- Use checkpoint-specific bounded test loads; stop and isolate power before changing any link.
- Remove all fixed source patch leads before matrix routing. Source node selection now belongs to the qualified matrix topology.

Firmware contract router+smart production interlock: final power qualified; valid topology; bounded matrix tool current; fresh ACKs; revision5 bank acquisition, carrier interfaces and selector ownership supersede legacy ADC pin mapping; r6 preserves GPIO/net protocol; use new physical endpoint crosswalk Measured acceptance • Discharge 1000µF initially at 5V to <0.1V in 3s; keep total analog pin current ≤12mA.
- Any short, unknown/invalid configuration or stale routing generation prevents rail enable; the precheck itself leaves rail off.
- With all power off remove only the fixed battery patch leads; retain every soldered wire. Connect A1 NODE ribbon. In matrix mode no fixed source or fixture stimulus may remain connected.
Film Show inspect a routed jumper setup with power OFF and display firmware revision. Demonstrate: The matrix test tools distinguish a routed short from an open. Show the documented negative test and actual recorded readings. Negative case: Select a known open diagnostic path: return rejection rather than a false continuity pass.
Record serial numbers, hardware and firmware revisions, equipment, actual readings, temporary-link states and waveforms. Prototype evidence does not transfer. Failed or inconclusive tests block acceptance.

# CP26 — Reject an invalid route

Filmable win: Invalid or stale routing requests keep power OFF.

Construction Add 0 parts/posts, 0 wires and 0 harness conductors. Assemblies: . Place one component or node column at a time; inspect it separately. Add one wire at a time. Earlier permanent components and wiring remain fixed. • Use revision7 endpoint tables and baseline-crosswalk.csv for relocated references. Legacy hole coordinates do not apply.
- USB prototype source and prototype 3V3 links removed before final supplies connect.
- Use checkpoint-specific bounded test loads; stop and isolate power before changing any link.
- Remove all fixed source patch leads before matrix routing. Source node selection now belongs to the qualified matrix topology.

Firmware contract router+smart production interlock: final power qualified; valid topology; bounded matrix tool current; fresh ACKs; revision5 bank acquisition, carrier interfaces and selector ownership supersede legacy ADC pin mapping; r6 preserves GPIO/net protocol; use new physical endpoint crosswalk Measured acceptance • Show a valid second battery position and corresponding kit arrangement. Invalid topology or stale routing generation cannot enable power. Film Show reject an invalid route setup with power OFF and display firmware revision. Demonstrate: Invalid or stale routing requests keep power OFF. Show the documented negative test and actual recorded readings. Negative case: Submit the documented invalid topology: reject it without energizing.

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

# CP27 — Qualify A2

Filmable win: The same capsule works at A2 without changes.

Construction Add 68 parts/posts, 128 wires and 26 harness conductors. Assemblies: contact-a, measurement-a-buffers, bank-a-position-1. Place one component or node column at a time; inspect it separately. Add one wire at a time. Earlier permanent components and wiring remain fixed. • Use revision7 endpoint tables and baseline-crosswalk.csv for relocated references. Legacy hole coordinates do not apply.
- USB prototype source and prototype 3V3 links removed before final supplies connect.
- Use checkpoint-specific bounded test loads; stop and isolate power before changing any link.
- Remove all fixed source patch leads before matrix routing. Source node selection now belongs to the qualified matrix topology.
- Before powering U_A_BUFFERS, fit removable GND ties at noninverting inputs pin10/pin12 for the future third position. Remove these ties with power OFF at the next expansion checkpoint before attaching its divider inputs.

Firmware contract router+smart production interlock: final power qualified; valid topology; bounded matrix tool current; fresh ACKs; revision5 bank acquisition, carrier interfaces and selector ownership supersede legacy ADC pin mapping; r6 preserves GPIO/net protocol; use new physical endpoint crosswalk Measured acceptance • Repeat CP01 electrical mapping for A2/A3; test NODE00–NODE10 and positions 0/1/2.
- Three active capsules meet meter update rates and output timing concurrently; fourth active request refused.
- Repeat screen, voltage, pulse, gate, memory, current and leakage tests independently on each new card. Three active capsules meet all update/timing limits.
Film Show qualify a2 setup with power OFF and display firmware revision. Demonstrate: The same capsule works at A2 without changes. Show the documented negative test and actual recorded readings. Negative case: Move or remove the capsule from A2: power shuts down before reconfiguration.
Record serial numbers, hardware and firmware revisions, equipment, actual readings, temporary-link states and waveforms. Prototype evidence does not transfer. Failed or inconclusive tests block acceptance.

# CP28 — Qualify A3

Filmable win: Three bank-A positions operate with no address collisions.

Construction Add 61 parts/posts, 109 wires and 24 harness conductors. Assemblies: contact-a, measurement-a-buffers, bank-a-position-2. Place one component or node column at a time; inspect it separately. Add one wire at a time. Earlier permanent components and wiring remain fixed. • Use revision7 endpoint tables and baseline-crosswalk.csv for relocated references. Legacy hole coordinates do not apply.
- USB prototype source and prototype 3V3 links removed before final supplies connect.
- Use checkpoint-specific bounded test loads; stop and isolate power before changing any link.
- Remove all fixed source patch leads before matrix routing. Source node selection now belongs to the qualified matrix topology.

Firmware contract router+smart production interlock: final power qualified; valid topology; bounded matrix tool current; fresh ACKs; revision5 bank acquisition, carrier interfaces and selector ownership supersede legacy ADC pin mapping; r6 preserves GPIO/net protocol; use new physical endpoint crosswalk Measured acceptance • Repeat the single-position acceptance at A3; exercise all three bank-A capsules concurrently. Every buffer B-side remains local, and every position retains the same mode capabilities.
Film Show qualify a3 setup with power OFF and display firmware revision. Demonstrate: Three bank-A positions operate with no address collisions. Show the documented negative test and actual recorded readings. Negative case: Move or remove the capsule from A3: power shuts down before reconfiguration.

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

# CP29 — Qualify B1

Filmable win: A capsule moves to B1 without rotation or polarity changes.

Construction Add 111 parts/posts, 190 wires and 43 harness conductors. Assemblies: contact-b, measurement-b-precision, measurement-b-buffers, bank-b-position-3. Place one component or node column at a time; inspect it separately. Add one wire at a time. Earlier permanent components and wiring remain fixed. • Use revision7 endpoint tables and baseline-crosswalk.csv for relocated references. Legacy hole coordinates do not apply.
- USB prototype source and prototype 3V3 links removed before final supplies connect.
- Use checkpoint-specific bounded test loads; stop and isolate power before changing any link.
- Remove all fixed source patch leads before matrix routing. Source node selection now belongs to the qualified matrix topology.

Firmware contract router+smart production interlock: final power qualified; valid topology; bounded matrix tool current; fresh ACKs; revision5 bank acquisition, carrier interfaces and selector ownership supersede legacy ADC pin mapping; r6 preserves GPIO/net protocol; use new physical endpoint crosswalk Measured acceptance • Repeat module mapping for B1/B2/B3; verify mirrored service order without renumbering holes.
- Test NODE00–NODE21 and all six smart positions, any combination of three active; no unintended bank-to-bank connection.
Film Show qualify b1 setup with power OFF and display firmware revision. Demonstrate: A capsule moves to B1 without rotation or polarity changes. Show the documented negative test and actual recorded readings. Negative case: Move the unchanged-orientation capsule to B1: old-position authorization must not energize it.
Record serial numbers, hardware and firmware revisions, equipment, actual readings, temporary-link states and waveforms. Prototype evidence does not transfer. Failed or inconclusive tests block acceptance.

# CP30 — Qualify B2

Filmable win: The same capsule passes acceptance at B2.

Construction Add 68 parts/posts, 128 wires and 26 harness conductors. Assemblies: contact-b, measurement-b-buffers, bank-b-position-4. Place one component or node column at a time; inspect it separately. Add one wire at a time. Earlier permanent components and wiring remain fixed. • Use revision7 endpoint tables and baseline-crosswalk.csv for relocated references. Legacy hole coordinates do not apply.
- USB prototype source and prototype 3V3 links removed before final supplies connect.
- Use checkpoint-specific bounded test loads; stop and isolate power before changing any link.
- Remove all fixed source patch leads before matrix routing. Source node selection now belongs to the qualified matrix topology.
- Before powering U_B_BUFFERS, fit removable GND ties at noninverting inputs pin10/pin12 for the future third position. Remove these ties with power OFF at the next expansion checkpoint before attaching its divider inputs.

Firmware contract router+smart production interlock: final power qualified; valid topology; bounded matrix tool current; fresh ACKs; revision5 bank acquisition, carrier interfaces and selector ownership supersede legacy ADC pin mapping; r6 preserves GPIO/net protocol; use new physical endpoint crosswalk Measured acceptance • Repeat single-position voltage, output, current, OLED and movement shutdown checks at B2 with unchanged capsule orientation.
Film Show qualify b2 setup with power OFF and display firmware revision. Demonstrate: The same capsule passes acceptance at B2. Show the documented negative test and actual recorded readings. Negative case: Remove the capsule from B2: stale identity cannot keep output enabled.

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

# CP31 — Qualify B3

Filmable win: All six positions work while only three capsules are active.

Construction Add 61 parts/posts, 109 wires and 24 harness conductors. Assemblies: contact-b, measurement-b-buffers, bank-b-position-5. Place one component or node column at a time; inspect it separately. Add one wire at a time. Earlier permanent components and wiring remain fixed. • Use revision7 endpoint tables and baseline-crosswalk.csv for relocated references. Legacy hole coordinates do not apply.
- USB prototype source and prototype 3V3 links removed before final supplies connect.
- Use checkpoint-specific bounded test loads; stop and isolate power before changing any link.
- Remove all fixed source patch leads before matrix routing. Source node selection now belongs to the qualified matrix topology.

Firmware contract router+smart production interlock: final power qualified; valid topology; bounded matrix tool current; fresh ACKs; revision5 bank acquisition, carrier interfaces and selector ownership supersede legacy ADC pin mapping; r6 preserves GPIO/net protocol; use new physical endpoint crosswalk Measured acceptance • Moving a capsule drops rail before configuration; position identity is independent of capsule identity.
- Repeat single-position checks at B3; attempt a fourth active capsule and confirm rejection with power OFF.
Film Show qualify b3 setup with power OFF and display firmware revision. Demonstrate: All six positions work while only three capsules are active. Show the documented negative test and actual recorded readings. Negative case: Request a fourth active capsule: reject it and retain OFF.
Record serial numbers, hardware and firmware revisions, equipment, actual readings, temporary-link states and waveforms. Prototype evidence does not transfer. Failed or inconclusive tests block acceptance.

# CP32 — Pi communication

Filmable win: Pi commands reach the controllers with revisioned acknowledgements.

Construction Add 15 parts/posts, 31 wires and 0 harness conductors. Assemblies: router-matrix, smart-core. Place one component or node column at a time; inspect it separately. Add one wire at a time. Earlier permanent components and wiring remain fixed. • Use revision7 endpoint tables and baseline-crosswalk.csv for relocated references. Legacy hole coordinates do not apply.
- USB prototype source and prototype 3V3 links removed before final supplies connect.
- Use checkpoint-specific bounded test loads; stop and isolate power before changing any link.
- Remove all fixed source patch leads before matrix routing. Source node selection now belongs to the qualified matrix topology.

Firmware contract complete Pi/router/smart session and NFC interlock; revision5 bank acquisition, carrier interfaces and selector ownership supersede legacy ADC pin mapping; r6 preserves GPIO/net protocol; use new physical endpoint crosswalk Measured acceptance • Pi separately powered: its 5V must not connect to bench 5V. Test all four USB/bench-power combinations for backfeeding.
- Verify physical Pi pin mapping and button debounce. Readiness alone does not energize; explicit request is required. Back/reset/restart returns OFF.
Film Show pi communication setup with power OFF and display firmware revision. Demonstrate: Pi commands reach the controllers with revisioned
acknowledgements. Show the documented negative test and actual recorded readings. Negative case: Use a mismatched, expired or duplicate acknowledgement: communication cannot authorize enable.
Record serial numbers, hardware and firmware revisions, equipment, actual readings, temporary-link states and waveforms. Prototype evidence does not transfer. Failed or inconclusive tests block acceptance.

# CP33 — Session-gated enable

Filmable win: Only a valid session and fresh acknowledgements permit enable.

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

Firmware contract complete Pi/router/smart session and NFC interlock; revision5 bank acquisition, carrier interfaces and selector ownership supersede legacy ADC pin mapping; r6 preserves GPIO/net protocol; use new physical endpoint crosswalk Measured acceptance • Factory Pi demonstration uses explicit supervised approval; production mode remains blocked until NFC/full integration acceptance. Film Show session-gated enable setup with power OFF and display firmware revision. Demonstrate: Only a valid session and fresh acknowledgements permit enable. Show the documented negative test and actual recorded readings. Negative case: Expire the session or lose communication: output shuts down without autonomous restoration.

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

# CP34 — Known NFC identity

Filmable win: A known NFC identity participates in approval.

Construction Add 1 parts/posts, 7 wires and 0 harness conductors. Assemblies: router-matrix. Place one component or node column at a time; inspect it separately. Add one wire at a time. Earlier permanent components and wiring remain fixed. • Use revision7 endpoint tables and baseline-crosswalk.csv for relocated references. Legacy hole coordinates do not apply.
- USB prototype source and prototype 3V3 links removed before final supplies connect.
- Use checkpoint-specific bounded test loads; stop and isolate power before changing any link.
- Remove all fixed source patch leads before matrix routing. Source node selection now belongs to the qualified matrix topology.

Firmware contract complete Pi/router/smart session and NFC interlock; revision5 bank acquisition, carrier interfaces and selector ownership supersede legacy ADC pin mapping; r6 preserves GPIO/net protocol; use new physical endpoint crosswalk Measured acceptance • RC522 SPI mode 0, MSB-first, ≤1MHz initial clock: known/ unknown/absent tag correctly reported; NFC failure leaves session unapproved.
- Known identity, valid lesson and fresh controller ACKs permit a separate explicit enable request. NFC alone never energizes.
Film Show known nfc identity setup with power OFF and display firmware revision. Demonstrate: A known NFC identity participates in approval. Show the documented negative test and actual recorded readings. Negative case: Present a known NFC identity without a valid session: NFC alone cannot energize.
Record serial numbers, hardware and firmware revisions, equipment, actual readings, temporary-link states and waveforms. Prototype evidence does not transfer. Failed or inconclusive tests block acceptance.

# CP35 — Reject NFC failures

Filmable win: Unknown, absent or failed NFC cannot authorize power.

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

Firmware contract complete Pi/router/smart session and NFC interlock; revision5 bank acquisition, carrier interfaces and selector ownership supersede legacy ADC pin mapping; r6 preserves GPIO/net protocol; use new physical endpoint crosswalk Measured acceptance • Known tag allows the subsequent readiness checks; unknown/absent/error clears approval. Explicit Energizar is still required after a successful tag.
Film Show reject nfc failures setup with power OFF and display firmware revision. Demonstrate: Unknown, absent or failed NFC cannot authorize power. Show the documented negative test and actual recorded readings. Negative case: Present unknown, absent or failed NFC: authorization is denied and power stays OFF.

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

# CP36 — Complete lesson

Filmable win: An enclosed full lesson completes with its fault cases demonstrated.

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

Firmware contract complete Pi/router/smart session and NFC interlock; revision5 bank acquisition, carrier interfaces and selector ownership supersede legacy ADC pin mapping; r6 preserves GPIO/net protocol; use new physical endpoint crosswalk Measured acceptance • Graph, recognition, predicted current, routing and all active capsule acknowledgements must pass before enable.
- USB unplug/reset or missed heartbeat disables rail and smart outputs within 1s; every restart begins OFF.
- 30-minute repeated lessons with no reset, incorrect route or false trip. Series-circuit tests use explicitly documented removable leads where geometry requires them.
- Repeat hardware cutoff ≤1ms, strict transient contact peaks ≤5.25V, 30-minute operation, no backfeed, leakage ≤10µA and every six-position mode. Record oscilloscope readings as text; screenshots remain external.
- Verify enclosure inaccessibility, cable strain relief and all purchased-part fit gates. Production release remains pending until actual evidence is recorded.
Film Show complete lesson setup with power OFF and display firmware revision. Demonstrate: An enclosed full lesson completes with its fault cases demonstrated. Show the documented negative test and actual recorded readings. Negative case: Run the complete lesson fault cases, including communication loss and invalid topology: each disables power.
Record serial numbers, hardware and firmware revisions, equipment, actual readings, temporary-link states and waveforms. Prototype evidence does not transfer. Failed or inconclusive tests block acceptance.
