gefgu/integration-workshop-3/docs/d5-figuras/bancada-08-montagem-certa.png

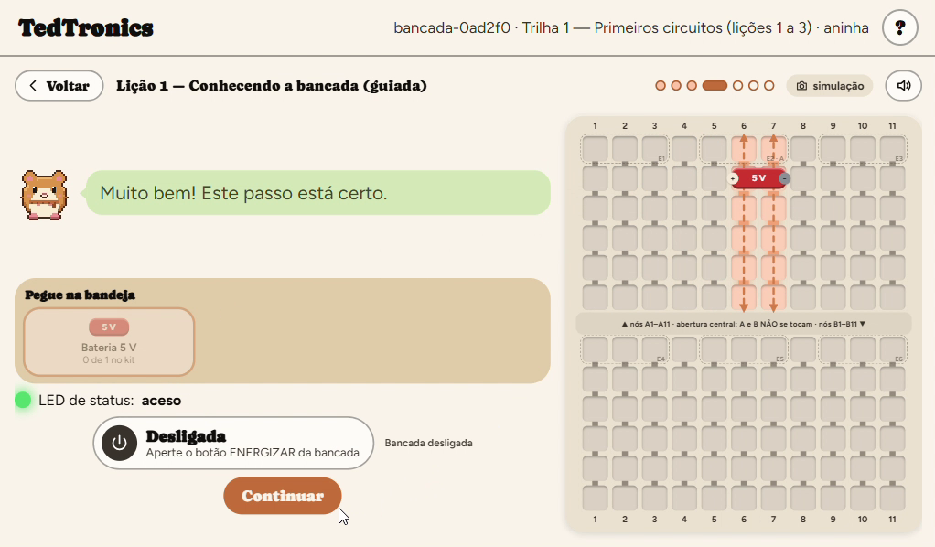
docs/d5-figuras/bancada-08-montagem-certa.png
