gefgu/integration-workshop-3/docs/deliverables/d3/mechanic_images/assembled-enclosure-overhead.jpeg

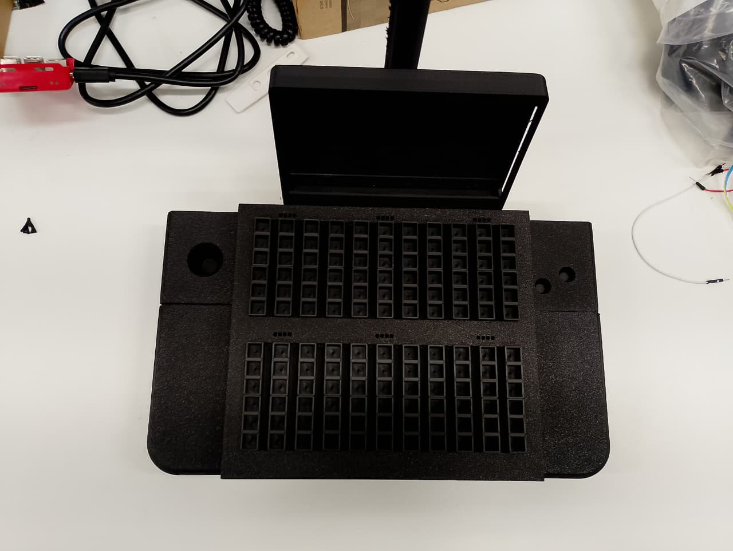
docs/deliverables/d3/mechanic_images/assembled-enclosure-overhead.jpeg
