gefgu/integration-workshop-3/docs/images/guided_module_prototype.png

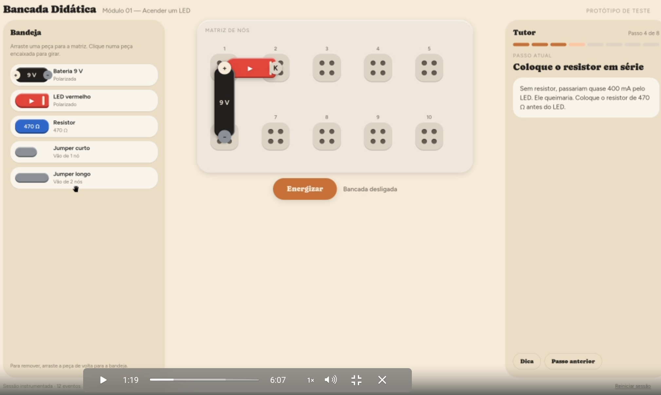
docs/images/guided_module_prototype.png
