gefgu/integration-workshop-3/eletronics/perfboard/tscircuit/assembly/a3-3d.png

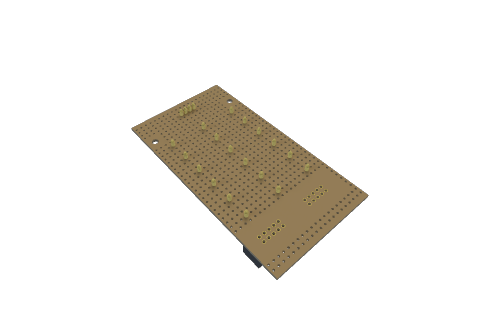
eletronics/perfboard/tscircuit/assembly/a3-3d.png
