gefgu/integration-workshop-3/eletronics/perfboard/tscircuit/revision6/measurement-b-buffers-wires.csv

wire | net | from | to | phase | description | path
W1 | GND | C_B_REFHI.2 | C_B_REFLO.2 | 29 | Common electrical reference and return; keep student, USB and service ground identities consistent. | [[5,17],[5,16.5],[6.5,16.5],[6.5,20.5],[9,20.5],[9,20]]
W2 | GND | C_B_REFLO.2 | J_BOUNDARY_1.1 | 29 | Common electrical reference and return; keep student, USB and service ground identities consistent. | [[9,20],[9,19.5],[4.5,19.5],[4.5,4.5],[1,4.5],[1,4]]
W3 | GND | J_BOUNDARY_1.1 | R_B_HI_BOTTOM.2 | 29 | Common electrical reference and return; keep student, USB and service ground identities consistent. | [[1,4],[1,3.5],[4.5,3.5],[4.5,14.5],[8,14.5],[8,14]]
W4 | GND | R_B_HI_BOTTOM.2 | R_B_LO_BOTTOM.2 | 29 | Common electrical reference and return; keep student, USB and service ground identities consistent. | [[8,14],[8,13.5],[14.5,13.5],[14.5,16.5],[22,16.5],[22,16]]
W5 | GND | R_B_LO_BOTTOM.2 | U_B_LED_DRIVER_0.8 | 29 | Common electrical reference and return; keep student, USB and service ground identities consistent. | [[22,16],[22,15.5],[13.5,15.5],[13.5,11.5],[5,11.5],[5,11]]
W6 | GND | U_B_LED_DRIVER_0.8 | U_B_LED_DRIVER_1.3 | 29 | Common electrical reference and return; keep student, USB and service ground identities consistent. | [[5,11],[5,10.5],[7.5,10.5],[7.5,6.5],[11,6.5],[11,6]]
W7 | GND | U_B_LED_DRIVER_1.3 | U_B_LED_DRIVER_1.4 | 29 | Common electrical reference and return; keep student, USB and service ground identities consistent. | [[11,6],[11,5.5],[10.5,5.5],[10.5,7.5],[11,7.5],[11,7]]
W8 | GND | U_B_LED_DRIVER_1.4 | U_B_LED_DRIVER_1.5 | 29 | Common electrical reference and return; keep student, USB and service ground identities consistent. | [[11,7],[11,6.5],[10.5,6.5],[10.5,8.5],[11,8.5],[11,8]]
W9 | GND | U_B_LED_DRIVER_1.5 | U_B_LED_DRIVER_1.6 | 29 | Common electrical reference and return; keep student, USB and service ground identities consistent. | [[11,8],[11,7.5],[10.5,7.5],[10.5,9.5],[11,9.5],[11,9]]
W10 | GND | U_B_LED_DRIVER_1.6 | U_B_LED_DRIVER_1.7 | 29 | Common electrical reference and return; keep student, USB and service ground identities consistent. | [[11,9],[11,8.5],[10.5,8.5],[10.5,10.5],[11,10.5],[11,10]]
W11 | GND | U_B_LED_DRIVER_1.7 | U_B_LED_DRIVER_1.8 | 29 | Common electrical reference and return; keep student, USB and service ground identities consistent. | [[11,10],[11,9.5],[10.5,9.5],[10.5,11.5],[11,11.5],[11,11]]
W12 | GND | U_B_LED_DRIVER_1.8 | C_B_BUFFERS.2 | 30 | Common electrical reference and return; keep student, USB and service ground identities consistent. | [[11,11],[11,10.5],[13.5,10.5],[13.5,29.5],[16,29.5],[16,29]]
W13 | GND | C_B_BUFFERS.2 | C_B_GENERAL_BIAS.2 | 30 | Common electrical reference and return; keep student, USB and service ground identities consistent. | [[16,29],[16,28.5],[13.5,28.5],[13.5,29.5],[12,29.5],[12,29]]
W14 | GND | C_B_GENERAL_BIAS.2 | C_P4_1.2 | 30 | Common electrical reference and return; keep student, USB and service ground identities consistent. | [[12,29],[12,28.5],[8.5,28.5],[8.5,21.5],[5,21.5],[5,21]]
W15 | GND | C_P4_1.2 | C_P4_2.2 | 30 | Common electrical reference and return; keep student, USB and service ground identities consistent. | [[5,21],[5,20.5],[13.5,20.5],[13.5,23.5],[23,23.5],[23,23]]
W16 | GND | C_P4_2.2 | R_B_GENERAL_BIAS_BOTTOM.2 | 30 | Common electrical reference and return; keep student, USB and service ground identities consistent. | [[23,23],[23,22.5],[15.5,22.5],[15.5,29.5],[8,29.5],[8,29]]
W17 | GND | R_B_GENERAL_BIAS_BOTTOM.2 | U_B_BUFFERS.11 | 30 | Common electrical reference and return; keep student, USB and service ground identities consistent. | [[8,29],[8,28.5],[13.5,28.5],[13.5,7.5],[20,7.5],[20,7]]
W18 | GND | U_B_BUFFERS.11 | C_P5_1.2 | 31 | Common electrical reference and return; keep student, USB and service ground identities consistent. | [[20,7],[20,6.5],[15.5,6.5],[15.5,32.5],[12,32.5],[12,32]]
W19 | GND | C_P5_1.2 | C_P5_2.2 | 31 | Common electrical reference and return; keep student, USB and service ground identities consistent. | [[12,32],[12,31.5],[17.5,31.5],[17.5,32.5],[23,32.5],[23,32]]
W20 | 5V_SYS | J_BOUNDARY_8.1 | U_B_LED_DRIVER_0.9 | 29 | Logic supply or current-protection path; verify the named supply domain and current direction. | [[26,7],[26,6.5],[17,6.5],[17,11.5],[8,11.5],[8,11]]
W21 | 5V_SYS | U_B_LED_DRIVER_0.9 | U_B_LED_DRIVER_1.9 | 29 | Logic supply or current-protection path; verify the named supply domain and current direction. | [[8,11],[8,10.5],[11,10.5],[11,11.5],[14,11.5],[14,11]]
W22 | RELAY_9 | J_BOUNDARY_9.1 | U_B_LED_DRIVER_0.1 | 29 | Output switching or current-limiting control; default OFF and mutually exclusive source/sink states are required. | [[1,8],[1,7.5],[3.5,7.5],[3.5,4.5],[5,4.5],[5,4]]
W23 | P3_K_HIGH_CATHODE | J_BOUNDARY_22.1 | U_B_LED_DRIVER_0.16 | 29 | Named control/interconnect for p3 k high cathode. Verify both pin functions against the schematic before soldering. | [[26,14],[26,13.5],[16.5,13.5],[16.5,4.5],[8,4.5],[8,4]]
W24 | RELAY_10 | J_BOUNDARY_10.1 | U_B_LED_DRIVER_0.2 | 29 | Output switching or current-limiting control; default OFF and mutually exclusive source/sink states are required. | [[26,8],[26,7.5],[16,7.5],[16,5.5],[5,5.5],[5,5]]
W25 | P3_K_LOW_CATHODE | J_BOUNDARY_23.1 | U_B_LED_DRIVER_0.15 | 29 | Named control/interconnect for p3 k low cathode. Verify both pin functions against the schematic before soldering. | [[1,15],[1,14.5],[5.5,14.5],[5.5,5.5],[8,5.5],[8,5]]
W26 | RELAY_11 | J_BOUNDARY_11.1 | U_B_LED_DRIVER_0.3 | 29 | Output switching or current-limiting control; default OFF and mutually exclusive source/sink states are required. | [[1,9],[1,8.5],[2.5,8.5],[2.5,6.5],[5,6.5],[5,6]]
W27 | P3_AMM_CATHODE | J_BOUNDARY_24.1 | U_B_LED_DRIVER_0.14 | 29 | Output switching or current-limiting control; default OFF and mutually exclusive source/sink states are required. | [[26,15],[26,14.5],[17,14.5],[17,6.5],[8,6.5],[8,6]]
W28 | RELAY_12 | J_BOUNDARY_12.1 | U_B_LED_DRIVER_0.4 | 29 | Output switching or current-limiting control; default OFF and mutually exclusive source/sink states are required. | [[26,9],[26,8.5],[16.5,8.5],[16.5,7.5],[5,7.5],[5,7]]
W29 | P4_K_HIGH_CATHODE | J_BOUNDARY_25.1 | U_B_LED_DRIVER_0.13 | 29 | Named control/interconnect for p4 k high cathode. Verify both pin functions against the schematic before soldering. | [[1,16],[1,15.5],[4.5,15.5],[4.5,7.5],[8,7.5],[8,7]]
W30 | RELAY_13 | J_BOUNDARY_13.1 | U_B_LED_DRIVER_0.5 | 29 | Output switching or current-limiting control; default OFF and mutually exclusive source/sink states are required. | [[1,10],[1,9.5],[3,9.5],[3,8.5],[5,8.5],[5,8]]
W31 | P4_K_LOW_CATHODE | J_BOUNDARY_26.1 | U_B_LED_DRIVER_0.12 | 29 | Named control/interconnect for p4 k low cathode. Verify both pin functions against the schematic before soldering. | [[26,16],[26,15.5],[17.5,15.5],[17.5,8.5],[8,8.5],[8,8]]
W32 | RELAY_14 | J_BOUNDARY_14.1 | U_B_LED_DRIVER_0.6 | 29 | Output switching or current-limiting control; default OFF and mutually exclusive source/sink states are required. | [[26,10],[26,9.5],[15.5,9.5],[5,9.5],[5,9]]
W33 | P4_AMM_CATHODE | J_BOUNDARY_27.1 | U_B_LED_DRIVER_0.11 | 29 | Output switching or current-limiting control; default OFF and mutually exclusive source/sink states are required. | [[1,17],[1,16.5],[5,16.5],[5,9.5],[8,9.5],[8,9]]
W34 | RELAY_15 | J_BOUNDARY_15.1 | U_B_LED_DRIVER_0.7 | 29 | Output switching or current-limiting control; default OFF and mutually exclusive source/sink states are required. | [[1,11],[1,10.5],[3.5,10.5],[5,10.5],[5,10]]
W35 | P5_K_HIGH_CATHODE | J_BOUNDARY_28.1 | U_B_LED_DRIVER_0.10 | 29 | Named control/interconnect for p5 k high cathode. Verify both pin functions against the schematic before soldering. | [[26,17],[26,16.5],[16.5,16.5],[16.5,10.5],[8,10.5],[8,10]]
W36 | RELAY_16 | J_BOUNDARY_16.1 | U_B_LED_DRIVER_1.1 | 29 | Output switching or current-limiting control; default OFF and mutually exclusive source/sink states are required. | [[26,11],[26,10.5],[19,10.5],[19,4.5],[11,4.5],[11,4]]
W37 | P5_K_LOW_CATHODE | J_BOUNDARY_29.1 | U_B_LED_DRIVER_1.16 | 29 | Named control/interconnect for p5 k low cathode. Verify both pin functions against the schematic before soldering. | [[1,18],[1,17.5],[8.5,17.5],[8.5,4.5],[14,4.5],[14,4]]
W38 | RELAY_17 | J_BOUNDARY_17.1 | U_B_LED_DRIVER_1.2 | 29 | Output switching or current-limiting control; default OFF and mutually exclusive source/sink states are required. | [[1,12],[1,11.5],[5.5,11.5],[5.5,5.5],[11,5.5],[11,5]]
W39 | P5_AMM_CATHODE | J_BOUNDARY_30.1 | U_B_LED_DRIVER_1.15 | 29 | Output switching or current-limiting control; default OFF and mutually exclusive source/sink states are required. | [[26,18],[26,17.5],[20,17.5],[20,5.5],[14,5.5],[14,5]]
W40 | 3V3_SYS | C_B_BUFFERS.1 | J_BOUNDARY_2.1 | 30 | 3.3-V electronics supply. USB and bench supply domains must not be bridged. | [[15,29],[15,28.5],[21.5,28.5],[21.5,4.5],[26,4.5],[26,4]]
W41 | 3V3_SYS | J_BOUNDARY_2.1 | R_B_GENERAL_BIAS_TOP.1 | 30 | 3.3-V electronics supply. USB and bench supply domains must not be bridged. | [[26,4],[26,3.5],[22.5,3.5],[22.5,26.5],[18,26.5],[18,26]]
W42 | 3V3_SYS | R_B_GENERAL_BIAS_TOP.1 | U_B_BUFFERS.4 | 30 | 3.3-V electronics supply. USB and bench supply domains must not be bridged. | [[18,26],[18,25.5],[18.5,25.5],[18.5,7.5],[17,7.5],[17,7]]
W43 | P4_1_BUF | R_P4_1_ADC.1 | U_B_BUFFERS.1 | 30 | Analog measurement, feedback or reference path; inspect polarity and compare with the specified calibration. | [[8,23],[8,4],[17,4]]
W44 | P4_1_BUF | U_B_BUFFERS.1 | U_B_BUFFERS.2 | 30 | Analog measurement, feedback or reference path; inspect polarity and compare with the specified calibration. | [[17,4],[17,5]]
W45 | P4_1_DIV | C_P4_1.1 | R_P4_1_BOTTOM.1 | 30 | Analog measurement, feedback or reference path; inspect polarity and compare with the specified calibration. | [[4,21],[4,20],[19,20]]
W46 | P4_1_DIV | R_P4_1_BOTTOM.1 | R_P4_1_TOP.2 | 30 | Analog measurement, feedback or reference path; inspect polarity and compare with the specified calibration. | [[19,20],[16,20]]
W47 | P4_1_DIV | R_P4_1_TOP.2 | U_B_BUFFERS.3 | 30 | Analog measurement, feedback or reference path; inspect polarity and compare with the specified calibration. | [[16,20],[16,6],[17,6]]
W48 | P4_2_BUF | R_P4_2_ADC.1 | U_B_BUFFERS.6 | 30 | Analog measurement, feedback or reference path; inspect polarity and compare with the specified calibration. | [[11,26],[11,9],[17,9]]
W49 | P4_2_BUF | U_B_BUFFERS.6 | U_B_BUFFERS.7 | 30 | Analog measurement, feedback or reference path; inspect polarity and compare with the specified calibration. | [[17,9],[17,10]]
W50 | P4_2_DIV | C_P4_2.1 | R_P4_2_BOTTOM.1 | 30 | Analog measurement, feedback or reference path; inspect polarity and compare with the specified calibration. | [[22,23],[22,26],[4,26]]
W51 | P4_2_DIV | R_P4_2_BOTTOM.1 | R_P4_2_TOP.2 | 30 | Analog measurement, feedback or reference path; inspect polarity and compare with the specified calibration. | [[4,26],[4,23],[19,23]]
W52 | P4_2_DIV | R_P4_2_TOP.2 | U_B_BUFFERS.5 | 30 | Analog measurement, feedback or reference path; inspect polarity and compare with the specified calibration. | [[19,23],[19,8],[17,8]]
W53 | P5_1_BUF | U_B_BUFFERS.8 | U_B_BUFFERS.9 | 30 | Analog measurement, feedback or reference path; inspect polarity and compare with the specified calibration. | [[20,10],[20,9]]
W54 | P5_1_BUF | U_B_BUFFERS.9 | R_P5_1_ADC.1 | 31 | Analog measurement, feedback or reference path; inspect polarity and compare with the specified calibration. | [[20,9],[20,32],[15,32]]
W55 | P5_1_DIV | U_B_BUFFERS.10 | C_P5_1.1 | 31 | Analog measurement, feedback or reference path; inspect polarity and compare with the specified calibration. | [[20,8],[20,32],[11,32]]
W56 | P5_1_DIV | C_P5_1.1 | R_P5_1_BOTTOM.1 | 31 | Analog measurement, feedback or reference path; inspect polarity and compare with the specified calibration. | [[11,32],[4,32]]
W57 | P5_1_DIV | R_P5_1_BOTTOM.1 | R_P5_1_TOP.2 | 31 | Analog measurement, feedback or reference path; inspect polarity and compare with the specified calibration. | [[4,32],[4,29],[23,29]]
W58 | P5_2_BUF | U_B_BUFFERS.13 | U_B_BUFFERS.14 | 30 | Analog measurement, feedback or reference path; inspect polarity and compare with the specified calibration. | [[20,5],[20,4]]
W59 | P5_2_BUF | U_B_BUFFERS.14 | R_P5_2_ADC.1 | 31 | Analog measurement, feedback or reference path; inspect polarity and compare with the specified calibration. | [[20,4],[20,35],[18,35]]
W60 | P5_2_DIV | U_B_BUFFERS.12 | C_P5_2.1 | 31 | Analog measurement, feedback or reference path; inspect polarity and compare with the specified calibration. | [[20,6],[20,32],[22,32]]
W61 | P5_2_DIV | C_P5_2.1 | R_P5_2_BOTTOM.1 | 31 | Analog measurement, feedback or reference path; inspect polarity and compare with the specified calibration. | [[22,32],[22,35],[11,35]]
W62 | P5_2_DIV | R_P5_2_BOTTOM.1 | R_P5_2_TOP.2 | 31 | Analog measurement, feedback or reference path; inspect polarity and compare with the specified calibration. | [[11,35],[8,35]]
W63 | 5V_EDU | J_BOUNDARY_7.1 | R_B_HI_TOP.1 | 29 | Protected student supply, enabled only by the fault latch, watchdog and an explicit valid request. | [[1,7],[1,6.5],[9.5,6.5],[9.5,13.5],[17,13.5],[17,13]]
W64 | 5V_EDU | R_B_HI_TOP.1 | R_B_LO_TOP.1 | 29 | Protected student supply, enabled only by the fault latch, watchdog and an explicit valid request. | [[17,13],[17,12.5],[14.5,12.5],[14.5,16.5],[11,16.5],[11,16]]
W65 | B_REF_HI | C_B_REFHI.1 | J_BOUNDARY_31.1 | 29 | Analog measurement, feedback or reference path; inspect polarity and compare with the specified calibration. | [[4,17],[4,19],[1,19]]
W66 | B_REF_HI | J_BOUNDARY_31.1 | R_B_HI_BOTTOM.1 | 29 | Analog measurement, feedback or reference path; inspect polarity and compare with the specified calibration. | [[1,19],[1,14],[4,14]]
W67 | B_REF_HI | R_B_HI_BOTTOM.1 | R_B_HI_TOP.2 | 29 | Analog measurement, feedback or reference path; inspect polarity and compare with the specified calibration. | [[4,14],[4,13],[21,13]]
W68 | B_REF_LO | C_B_REFLO.1 | J_BOUNDARY_32.1 | 29 | Analog measurement, feedback or reference path; inspect polarity and compare with the specified calibration. | [[8,20],[8,19],[26,19]]
W69 | B_REF_LO | J_BOUNDARY_32.1 | R_B_LO_BOTTOM.1 | 29 | Analog measurement, feedback or reference path; inspect polarity and compare with the specified calibration. | [[26,19],[26,16],[18,16]]
W70 | B_REF_LO | R_B_LO_BOTTOM.1 | R_B_LO_TOP.2 | 29 | Analog measurement, feedback or reference path; inspect polarity and compare with the specified calibration. | [[18,16],[15,16]]
W71 | NODE15 | J_BOUNDARY_3.1 | R_P4_1_TOP.1 | 30 | Educational contact or routing bus; the wire joins only its listed terminals, not crossing wires. | [[1,5],[1,4.5],[7.5,4.5],[7.5,20.5],[12,20.5],[12,20]]
W72 | B_GENERAL_BIAS | C_B_GENERAL_BIAS.1 | R_B_GENERAL_BIAS_BOTTOM.1 | 30 | Protection, reset or readiness control; its defined polarity must preserve OFF at startup and on faults. | [[11,29],[11,28.5],[7.5,28.5],[7.5,29.5],[4,29.5],[4,29]]
W73 | B_GENERAL_BIAS | R_B_GENERAL_BIAS_BOTTOM.1 | R_B_GENERAL_BIAS_TOP.2 | 30 | Protection, reset or readiness control; its defined polarity must preserve OFF at startup and on faults. | [[4,29],[4,28.5],[12.5,28.5],[12.5,26.5],[22,26.5],[22,26]]
W74 | B_GENERAL_BIAS | R_B_GENERAL_BIAS_TOP.2 | R_P4_1_BOTTOM.2 | 30 | Protection, reset or readiness control; its defined polarity must preserve OFF at startup and on faults. | [[22,26],[22,25.5],[22.5,25.5],[22.5,20.5],[23,20.5],[23,20]]
W75 | B_GENERAL_BIAS | R_P4_1_BOTTOM.2 | R_P4_2_BOTTOM.2 | 30 | Protection, reset or readiness control; its defined polarity must preserve OFF at startup and on faults. | [[23,20],[23,19.5],[15.5,19.5],[15.5,26.5],[8,26.5],[8,26]]
W76 | B_GENERAL_BIAS | R_P4_2_BOTTOM.2 | R_P5_1_BOTTOM.2 | 31 | Protection, reset or readiness control; its defined polarity must preserve OFF at startup and on faults. | [[8,26],[8,25.5],[7.5,25.5],[7.5,32.5],[8,32.5],[8,32]]
W77 | B_GENERAL_BIAS | R_P5_1_BOTTOM.2 | R_P5_2_BOTTOM.2 | 31 | Protection, reset or readiness control; its defined polarity must preserve OFF at startup and on faults. | [[8,32],[8,31.5],[11.5,31.5],[11.5,35.5],[15,35.5],[15,35]]
W78 | P4_1_MUX | J_BOUNDARY_18.1 | R_P4_1_ADC.2 | 30 | Named control/interconnect for p4 1 mux. Verify both pin functions against the schematic before soldering. | [[26,12],[26,11.5],[19,11.5],[19,23.5],[12,23.5],[12,23]]
W79 | NODE16 | J_BOUNDARY_4.1 | R_P4_2_TOP.1 | 30 | Educational contact or routing bus; the wire joins only its listed terminals, not crossing wires. | [[26,5],[26,4.5],[21.5,4.5],[21.5,23.5],[15,23.5],[15,23]]
W80 | P4_2_MUX | J_BOUNDARY_19.1 | R_P4_2_ADC.2 | 30 | Named control/interconnect for p4 2 mux. Verify both pin functions against the schematic before soldering. | [[1,13],[1,12.5],[7.5,12.5],[7.5,26.5],[15,26.5],[15,26]]
W81 | NODE19 | J_BOUNDARY_5.1 | R_P5_1_TOP.1 | 31 | Educational contact or routing bus; the wire joins only its listed terminals, not crossing wires. | [[1,6],[1,5.5],[10,5.5],[10,29.5],[19,29.5],[19,29]]
W82 | P5_1_MUX | J_BOUNDARY_20.1 | R_P5_1_ADC.2 | 31 | Named control/interconnect for p5 1 mux. Verify both pin functions against the schematic before soldering. | [[26,13],[26,12.5],[23.5,12.5],[23.5,32.5],[19,32.5],[19,32]]
W83 | NODE20 | J_BOUNDARY_6.1 | R_P5_2_TOP.1 | 31 | Educational contact or routing bus; the wire joins only its listed terminals, not crossing wires. | [[26,6],[26,5.5],[14.5,5.5],[14.5,35.5],[4,35.5],[4,35]]
W84 | P5_2_MUX | J_BOUNDARY_21.1 | R_P5_2_ADC.2 | 31 | Named control/interconnect for p5 2 mux. Verify both pin functions against the schematic before soldering. | [[1,14],[1,13.5],[12,13.5],[12,35.5],[22,35.5],[22,35]]
