gefgu/integration-workshop-3/eletronics/perfboard/tscircuit/revision7/measurement-a-buffers-wires.csv

wire | net | from | to | phase | description | path | kind | sleeve over bar wires
W1 | GND | C_A_REFHI.2 | R_A_HI_BOTTOM.2 | 15 | Common electrical reference and return; keep student, USB and service ground identities consistent. | [[5,17],[5,16.5],[6.5,16.5],[6.5,14.5],[8,14.5],[8,14]] | insulated
W2 | GND | C_A_REFHI.2 | U_A_LED_DRIVER_0.8 | 15 | Common electrical reference and return; keep student, USB and service ground identities consistent. | [[5,17],[5,16.5],[4.5,16.5],[4.5,11.5],[5,11.5],[5,11]] | insulated
W3 | GND | R_A_HI_BOTTOM.2 | U_A_LED_DRIVER_1.8 | 15 | Common electrical reference and return; keep student, USB and service ground identities consistent. | [[8,14],[8,13.5],[9.5,13.5],[9.5,11.5],[11,11.5],[11,11]] | insulated
W4 | GND | U_A_LED_DRIVER_1.8 | U_A_LED_DRIVER_1.7 | 15 | Common electrical reference and return; keep student, USB and service ground identities consistent. | [[11,11],[11,10.5],[10.5,10.5],[11,10.5],[11,10]] | insulated
W5 | GND | U_A_LED_DRIVER_1.7 | U_A_LED_DRIVER_1.6 | 15 | Common electrical reference and return; keep student, USB and service ground identities consistent. | [[11,10],[11,9.5],[10.5,9.5],[11,9.5],[11,9]] | insulated
W6 | GND | U_A_LED_DRIVER_1.6 | U_A_LED_DRIVER_1.5 | 15 | Common electrical reference and return; keep student, USB and service ground identities consistent. | [[11,9],[11,8.5],[10.5,8.5],[11,8.5],[11,8]] | insulated
W7 | GND | U_A_LED_DRIVER_1.5 | U_A_LED_DRIVER_1.4 | 15 | Common electrical reference and return; keep student, USB and service ground identities consistent. | [[11,8],[11,7.5],[10.5,7.5],[11,7.5],[11,7]] | insulated
W8 | GND | U_A_LED_DRIVER_1.4 | U_A_LED_DRIVER_1.3 | 15 | Common electrical reference and return; keep student, USB and service ground identities consistent. | [[11,7],[11,6.5],[10.5,6.5],[11,6.5],[11,6]] | insulated
W9 | GND | U_A_LED_DRIVER_0.8 | J_BOUNDARY_1.1 | 15 | Common electrical reference and return; keep student, USB and service ground identities consistent. | [[5,11],[5,10.5],[2.5,10.5],[2.5,4.5],[1,4.5],[1,4]] | insulated
W10 | GND | U_A_LED_DRIVER_1.3 | C_A_REFLO.2 | 15 | Common electrical reference and return; keep student, USB and service ground identities consistent. | [[11,6],[11,5.5],[9.5,5.5],[9.5,20.5],[9,20.5],[9,20]] | insulated
W11 | GND | C_A_REFLO.2 | R_A_LO_BOTTOM.2 | 15 | Common electrical reference and return; keep student, USB and service ground identities consistent. | [[9,20],[9,19.5],[15.5,19.5],[15.5,16.5],[22,16.5],[22,16]] | insulated
W12 | GND | R_A_LO_BOTTOM.2 | C_P1_2.2 | 27 | Common electrical reference and return; keep student, USB and service ground identities consistent. | [[22,16],[22,15.5],[22.5,15.5],[22.5,23.5],[23,23.5],[23,23]] | insulated
W13 | GND | C_P1_2.2 | C_A_BUFFERS.2 | 27 | Common electrical reference and return; keep student, USB and service ground identities consistent. | [[23,23],[23,22.5],[19.5,22.5],[19.5,29.5],[16,29.5],[16,29]] | insulated
W14 | GND | C_A_BUFFERS.2 | C_A_GENERAL_BIAS.2 | 27 | Common electrical reference and return; keep student, USB and service ground identities consistent. | [[16,29],[16,28.5],[13.5,28.5],[13.5,29.5],[12,29.5],[12,29]] | insulated
W15 | GND | C_A_GENERAL_BIAS.2 | R_A_GENERAL_BIAS_BOTTOM.2 | 27 | Common electrical reference and return; keep student, USB and service ground identities consistent. | [[12,29],[12,28.5],[9.5,28.5],[9.5,29.5],[8,29.5],[8,29]] | insulated
W16 | GND | R_A_GENERAL_BIAS_BOTTOM.2 | C_P1_1.2 | 27 | Common electrical reference and return; keep student, USB and service ground identities consistent. | [[8,29],[8,28.5],[6.5,28.5],[6.5,21.5],[5,21.5],[5,21]] | insulated
W17 | GND | J_BOUNDARY_1.1 | U_A_BUFFERS.11 | 27 | Common electrical reference and return; keep student, USB and service ground identities consistent. | [[1,4],[1,3.5],[10.5,3.5],[10.5,7.5],[20,7.5],[20,7]] | insulated
W18 | GND | C_P1_1.2 | C_P2_1.2 | 28 | Common electrical reference and return; keep student, USB and service ground identities consistent. | [[5,21],[5,20.5],[8.5,20.5],[8.5,32.5],[12,32.5],[12,32]] | insulated
W19 | GND | C_P2_1.2 | C_P2_2.2 | 28 | Common electrical reference and return; keep student, USB and service ground identities consistent. | [[12,32],[12,31.5],[17.5,31.5],[17.5,32.5],[23,32.5],[23,32]] | insulated
W20 | 5V_SYS | J_BOUNDARY_8.1 | U_A_LED_DRIVER_1.9 | 15 | Logic supply or current-protection path; verify the named supply domain and current direction. | [[26,7],[26,6.5],[20,6.5],[20,11.5],[14,11.5],[14,11]] | insulated
W21 | 5V_SYS | U_A_LED_DRIVER_1.9 | U_A_LED_DRIVER_0.9 | 15 | Logic supply or current-protection path; verify the named supply domain and current direction. | [[14,11],[14,10.5],[11,10.5],[11,11.5],[8,11.5],[8,11]] | insulated
W22 | RELAY_0 | J_BOUNDARY_9.1 | U_A_LED_DRIVER_0.1 | 15 | Output switching or current-limiting control; default OFF and mutually exclusive source/sink states are required. | [[1,8],[1,7.5],[3.5,7.5],[3.5,4.5],[5,4.5],[5,4]] | insulated
W23 | P0_K_HIGH_CATHODE | J_BOUNDARY_22.1 | U_A_LED_DRIVER_0.16 | 15 | Named control/interconnect for p0 k high cathode. Verify both pin functions against the schematic before soldering. | [[26,14],[26,13.5],[16.5,13.5],[16.5,4.5],[8,4.5],[8,4]] | insulated
W24 | RELAY_1 | J_BOUNDARY_10.1 | U_A_LED_DRIVER_0.2 | 15 | Output switching or current-limiting control; default OFF and mutually exclusive source/sink states are required. | [[26,8],[26,7.5],[16,7.5],[16,5.5],[5,5.5],[5,5]] | insulated
W25 | P0_K_LOW_CATHODE | J_BOUNDARY_23.1 | U_A_LED_DRIVER_0.15 | 15 | Named control/interconnect for p0 k low cathode. Verify both pin functions against the schematic before soldering. | [[1,15],[1,14.5],[5.5,14.5],[5.5,5.5],[8,5.5],[8,5]] | insulated
W26 | RELAY_2 | J_BOUNDARY_11.1 | U_A_LED_DRIVER_0.3 | 15 | Output switching or current-limiting control; default OFF and mutually exclusive source/sink states are required. | [[1,9],[1,8.5],[2.5,8.5],[2.5,6.5],[5,6.5],[5,6]] | insulated
W27 | P0_AMM_CATHODE | J_BOUNDARY_24.1 | U_A_LED_DRIVER_0.14 | 15 | Output switching or current-limiting control; default OFF and mutually exclusive source/sink states are required. | [[26,15],[26,14.5],[17,14.5],[17,6.5],[8,6.5],[8,6]] | insulated
W28 | RELAY_3 | J_BOUNDARY_12.1 | U_A_LED_DRIVER_0.4 | 15 | Output switching or current-limiting control; default OFF and mutually exclusive source/sink states are required. | [[26,9],[26,8.5],[16.5,8.5],[16.5,7.5],[5,7.5],[5,7]] | insulated
W29 | P1_K_HIGH_CATHODE | J_BOUNDARY_25.1 | U_A_LED_DRIVER_0.13 | 15 | Named control/interconnect for p1 k high cathode. Verify both pin functions against the schematic before soldering. | [[1,16],[1,15.5],[4.5,15.5],[4.5,7.5],[8,7.5],[8,7]] | insulated
W30 | RELAY_4 | J_BOUNDARY_13.1 | U_A_LED_DRIVER_0.5 | 15 | Output switching or current-limiting control; default OFF and mutually exclusive source/sink states are required. | [[1,10],[1,9.5],[3,9.5],[3,8.5],[5,8.5],[5,8]] | insulated
W31 | P1_K_LOW_CATHODE | J_BOUNDARY_26.1 | U_A_LED_DRIVER_0.12 | 15 | Named control/interconnect for p1 k low cathode. Verify both pin functions against the schematic before soldering. | [[26,16],[26,15.5],[17.5,15.5],[17.5,8.5],[8,8.5],[8,8]] | insulated
W32 | RELAY_5 | J_BOUNDARY_14.1 | U_A_LED_DRIVER_0.6 | 15 | Output switching or current-limiting control; default OFF and mutually exclusive source/sink states are required. | [[26,10],[26,9.5],[15.5,9.5],[5,9.5],[5,9]] | insulated
W33 | P1_AMM_CATHODE | J_BOUNDARY_27.1 | U_A_LED_DRIVER_0.11 | 15 | Output switching or current-limiting control; default OFF and mutually exclusive source/sink states are required. | [[1,17],[1,16.5],[5,16.5],[5,9.5],[8,9.5],[8,9]] | insulated
W34 | RELAY_6 | J_BOUNDARY_15.1 | U_A_LED_DRIVER_0.7 | 15 | Output switching or current-limiting control; default OFF and mutually exclusive source/sink states are required. | [[1,11],[1,10.5],[3.5,10.5],[5,10.5],[5,10]] | insulated
W35 | P2_K_HIGH_CATHODE | J_BOUNDARY_28.1 | U_A_LED_DRIVER_0.10 | 15 | Named control/interconnect for p2 k high cathode. Verify both pin functions against the schematic before soldering. | [[26,17],[26,16.5],[16.5,16.5],[16.5,10.5],[8,10.5],[8,10]] | insulated
W36 | RELAY_7 | J_BOUNDARY_16.1 | U_A_LED_DRIVER_1.1 | 15 | Output switching or current-limiting control; default OFF and mutually exclusive source/sink states are required. | [[26,11],[26,10.5],[19,10.5],[19,4.5],[11,4.5],[11,4]] | insulated
W37 | P2_K_LOW_CATHODE | J_BOUNDARY_29.1 | U_A_LED_DRIVER_1.16 | 15 | Named control/interconnect for p2 k low cathode. Verify both pin functions against the schematic before soldering. | [[1,18],[1,17.5],[8.5,17.5],[8.5,4.5],[14,4.5],[14,4]] | insulated
W38 | RELAY_8 | J_BOUNDARY_17.1 | U_A_LED_DRIVER_1.2 | 15 | Output switching or current-limiting control; default OFF and mutually exclusive source/sink states are required. | [[1,12],[1,11.5],[5.5,11.5],[5.5,5.5],[11,5.5],[11,5]] | insulated
W39 | P2_AMM_CATHODE | J_BOUNDARY_30.1 | U_A_LED_DRIVER_1.15 | 15 | Output switching or current-limiting control; default OFF and mutually exclusive source/sink states are required. | [[26,18],[26,17.5],[20,17.5],[20,5.5],[14,5.5],[14,5]] | insulated
W40 | 3V3_SYS | C_A_BUFFERS.1 | R_A_GENERAL_BIAS_TOP.1 | 27 | 3.3-V electronics supply. USB and bench supply domains must not be bridged. | [[15,29],[15,28.5],[17.5,28.5],[17.5,26.5],[18,26.5],[18,26]] | insulated
W41 | 3V3_SYS | R_A_GENERAL_BIAS_TOP.1 | U_A_BUFFERS.4 | 27 | 3.3-V electronics supply. USB and bench supply domains must not be bridged. | [[18,26],[18,25.5],[18.5,25.5],[18.5,7.5],[17,7.5],[17,7]] | insulated
W42 | 3V3_SYS | U_A_BUFFERS.4 | J_BOUNDARY_2.1 | 27 | 3.3-V electronics supply. USB and bench supply domains must not be bridged. | [[17,7],[17,6.5],[22.5,6.5],[22.5,4.5],[26,4.5],[26,4]] | insulated
W43 | P1_1_BUF | R_P1_1_ADC.1 | U_A_BUFFERS.2 | 27 | Analog measurement, feedback or reference path; inspect polarity and compare with the specified calibration. | [[8,23],[8,5],[17,5]] | insulated
W44 | P1_1_BUF | U_A_BUFFERS.2 | U_A_BUFFERS.1 | 27 | Analog measurement, feedback or reference path; inspect polarity and compare with the specified calibration. | [[17,5],[17,4]] | insulated
W45 | P1_1_DIV | C_P1_1.1 | R_P1_1_TOP.2 | 27 | Analog measurement, feedback or reference path; inspect polarity and compare with the specified calibration. | [[4,21],[4,20],[16,20]] | insulated
W46 | P1_1_DIV | R_P1_1_TOP.2 | R_P1_1_BOTTOM.1 | 27 | Analog measurement, feedback or reference path; inspect polarity and compare with the specified calibration. | [[16,20],[19,20]] | insulated
W47 | P1_1_DIV | R_P1_1_BOTTOM.1 | U_A_BUFFERS.3 | 27 | Analog measurement, feedback or reference path; inspect polarity and compare with the specified calibration. | [[19,20],[19,6],[17,6]] | insulated
W48 | P1_2_BUF | R_P1_2_ADC.1 | U_A_BUFFERS.7 | 27 | Analog measurement, feedback or reference path; inspect polarity and compare with the specified calibration. | [[11,26],[11,10],[17,10]] | insulated
W49 | P1_2_BUF | U_A_BUFFERS.7 | U_A_BUFFERS.6 | 27 | Analog measurement, feedback or reference path; inspect polarity and compare with the specified calibration. | [[17,10],[17,9]] | insulated
W50 | P1_2_DIV | C_P1_2.1 | R_P1_2_TOP.2 | 27 | Analog measurement, feedback or reference path; inspect polarity and compare with the specified calibration. | [[22,23],[19,23]] | insulated
W51 | P1_2_DIV | R_P1_2_TOP.2 | U_A_BUFFERS.5 | 27 | Analog measurement, feedback or reference path; inspect polarity and compare with the specified calibration. | [[19,23],[19,8],[17,8]] | insulated
W52 | P1_2_DIV | C_P1_2.1 | R_P1_2_BOTTOM.1 | 27 | Analog measurement, feedback or reference path; inspect polarity and compare with the specified calibration. | [[22,23],[22,26],[4,26]] | insulated
W53 | P2_1_BUF | U_A_BUFFERS.8 | U_A_BUFFERS.9 | 27 | Analog measurement, feedback or reference path; inspect polarity and compare with the specified calibration. | [[20,10],[20,9]] | insulated
W54 | P2_1_BUF | U_A_BUFFERS.8 | R_P2_1_ADC.1 | 28 | Analog measurement, feedback or reference path; inspect polarity and compare with the specified calibration. | [[20,10],[20,32],[15,32]] | insulated
W55 | P2_1_DIV | U_A_BUFFERS.10 | R_P2_1_TOP.2 | 28 | Analog measurement, feedback or reference path; inspect polarity and compare with the specified calibration. | [[20,8],[20,29],[23,29]] | insulated
W56 | P2_1_DIV | R_P2_1_TOP.2 | C_P2_1.1 | 28 | Analog measurement, feedback or reference path; inspect polarity and compare with the specified calibration. | [[23,29],[23,32],[11,32]] | insulated
W57 | P2_1_DIV | C_P2_1.1 | R_P2_1_BOTTOM.1 | 28 | Analog measurement, feedback or reference path; inspect polarity and compare with the specified calibration. | [[11,32],[4,32]] | insulated
W58 | P2_2_BUF | U_A_BUFFERS.13 | U_A_BUFFERS.14 | 27 | Analog measurement, feedback or reference path; inspect polarity and compare with the specified calibration. | [[20,5],[20,4]] | insulated
W59 | P2_2_BUF | U_A_BUFFERS.13 | R_P2_2_ADC.1 | 28 | Analog measurement, feedback or reference path; inspect polarity and compare with the specified calibration. | [[20,5],[20,35],[18,35]] | insulated
W60 | P2_2_DIV | U_A_BUFFERS.12 | C_P2_2.1 | 28 | Analog measurement, feedback or reference path; inspect polarity and compare with the specified calibration. | [[20,6],[20,32],[22,32]] | insulated
W61 | P2_2_DIV | C_P2_2.1 | R_P2_2_BOTTOM.1 | 28 | Analog measurement, feedback or reference path; inspect polarity and compare with the specified calibration. | [[22,32],[22,35],[11,35]] | insulated
W62 | P2_2_DIV | R_P2_2_BOTTOM.1 | R_P2_2_TOP.2 | 28 | Analog measurement, feedback or reference path; inspect polarity and compare with the specified calibration. | [[11,35],[8,35]] | insulated
W63 | 5V_EDU | J_BOUNDARY_7.1 | R_A_LO_TOP.1 | 15 | Protected student supply, enabled only by the fault latch, watchdog and an explicit valid request. | [[1,7],[1,6.5],[6.5,6.5],[6.5,16.5],[11,16.5],[11,16]] | insulated
W64 | 5V_EDU | R_A_LO_TOP.1 | R_A_HI_TOP.1 | 15 | Protected student supply, enabled only by the fault latch, watchdog and an explicit valid request. | [[11,16],[11,15.5],[14.5,15.5],[14.5,13.5],[17,13.5],[17,13]] | insulated
W65 | A_REF_HI | C_A_REFHI.1 | R_A_HI_BOTTOM.1 | 15 | Analog measurement, feedback or reference path; inspect polarity and compare with the specified calibration. | [[4,17],[4,14]] | insulated
W66 | A_REF_HI | C_A_REFHI.1 | J_BOUNDARY_31.1 | 15 | Analog measurement, feedback or reference path; inspect polarity and compare with the specified calibration. | [[4,17],[4,19],[1,19]] | insulated
W67 | A_REF_HI | R_A_HI_BOTTOM.1 | R_A_HI_TOP.2 | 15 | Analog measurement, feedback or reference path; inspect polarity and compare with the specified calibration. | [[4,14],[4,13],[21,13]] | insulated
W68 | A_REF_LO | C_A_REFLO.1 | R_A_LO_TOP.2 | 15 | Analog measurement, feedback or reference path; inspect polarity and compare with the specified calibration. | [[8,20],[8,16],[15,16]] | insulated
W69 | A_REF_LO | R_A_LO_TOP.2 | R_A_LO_BOTTOM.1 | 15 | Analog measurement, feedback or reference path; inspect polarity and compare with the specified calibration. | [[15,16],[18,16]] | insulated
W70 | A_REF_LO | R_A_LO_BOTTOM.1 | J_BOUNDARY_32.1 | 15 | Analog measurement, feedback or reference path; inspect polarity and compare with the specified calibration. | [[18,16],[18,19],[26,19]] | insulated
W71 | NODE04 | J_BOUNDARY_3.1 | R_P1_1_TOP.1 | 27 | Educational contact or routing bus; the wire joins only its listed terminals, not crossing wires. | [[1,5],[1,4.5],[7.5,4.5],[7.5,20.5],[12,20.5],[12,20]] | insulated
W72 | A_GENERAL_BIAS | C_A_GENERAL_BIAS.1 | R_P1_2_BOTTOM.2 | 27 | Protection, reset or readiness control; its defined polarity must preserve OFF at startup and on faults. | [[11,29],[11,28.5],[9.5,28.5],[9.5,26.5],[8,26.5],[8,26]] | insulated
W73 | A_GENERAL_BIAS | C_A_GENERAL_BIAS.1 | R_A_GENERAL_BIAS_BOTTOM.1 | 27 | Protection, reset or readiness control; its defined polarity must preserve OFF at startup and on faults. | [[11,29],[11,28.5],[7.5,28.5],[7.5,29.5],[4,29.5],[4,29]] | insulated
W74 | A_GENERAL_BIAS | R_P1_2_BOTTOM.2 | R_A_GENERAL_BIAS_TOP.2 | 27 | Protection, reset or readiness control; its defined polarity must preserve OFF at startup and on faults. | [[8,26],[8,25.5],[14.5,25.5],[14.5,26.5],[22,26.5],[22,26]] | insulated
W75 | A_GENERAL_BIAS | R_A_GENERAL_BIAS_TOP.2 | R_P1_1_BOTTOM.2 | 27 | Protection, reset or readiness control; its defined polarity must preserve OFF at startup and on faults. | [[22,26],[22,25.5],[22.5,25.5],[22.5,20.5],[23,20.5],[23,20]] | insulated
W76 | A_GENERAL_BIAS | R_A_GENERAL_BIAS_BOTTOM.1 | R_P2_1_BOTTOM.2 | 28 | Protection, reset or readiness control; its defined polarity must preserve OFF at startup and on faults. | [[4,29],[4,28.5],[5.5,28.5],[5.5,32.5],[8,32.5],[8,32]] | insulated
W77 | A_GENERAL_BIAS | R_P2_1_BOTTOM.2 | R_P2_2_BOTTOM.2 | 28 | Protection, reset or readiness control; its defined polarity must preserve OFF at startup and on faults. | [[8,32],[8,31.5],[11.5,31.5],[11.5,35.5],[15,35.5],[15,35]] | insulated
W78 | P1_1_MUX | J_BOUNDARY_18.1 | R_P1_1_ADC.2 | 27 | Named control/interconnect for p1 1 mux. Verify both pin functions against the schematic before soldering. | [[26,12],[26,11.5],[19,11.5],[19,23.5],[12,23.5],[12,23]] | insulated
W79 | NODE05 | J_BOUNDARY_4.1 | R_P1_2_TOP.1 | 27 | Educational contact or routing bus; the wire joins only its listed terminals, not crossing wires. | [[26,5],[26,4.5],[21.5,4.5],[21.5,23.5],[15,23.5],[15,23]] | insulated
W80 | P1_2_MUX | J_BOUNDARY_19.1 | R_P1_2_ADC.2 | 27 | Named control/interconnect for p1 2 mux. Verify both pin functions against the schematic before soldering. | [[1,13],[1,12.5],[7.5,12.5],[7.5,26.5],[15,26.5],[15,26]] | insulated
W81 | NODE08 | J_BOUNDARY_5.1 | R_P2_1_TOP.1 | 28 | Educational contact or routing bus; the wire joins only its listed terminals, not crossing wires. | [[1,6],[1,5.5],[10,5.5],[10,29.5],[19,29.5],[19,29]] | insulated
W82 | P2_1_MUX | J_BOUNDARY_20.1 | R_P2_1_ADC.2 | 28 | Named control/interconnect for p2 1 mux. Verify both pin functions against the schematic before soldering. | [[26,13],[26,12.5],[23.5,12.5],[23.5,32.5],[19,32.5],[19,32]] | insulated
W83 | NODE09 | J_BOUNDARY_6.1 | R_P2_2_TOP.1 | 28 | Educational contact or routing bus; the wire joins only its listed terminals, not crossing wires. | [[26,6],[26,5.5],[14.5,5.5],[14.5,35.5],[4,35.5],[4,35]] | insulated
W84 | P2_2_MUX | J_BOUNDARY_21.1 | R_P2_2_ADC.2 | 28 | Named control/interconnect for p2 2 mux. Verify both pin functions against the schematic before soldering. | [[1,14],[1,13.5],[12,13.5],[12,35.5],[22,35.5],[22,35]] | insulated
