gefgu/integration-workshop-3/camera/bancada_teste_trh.jpeg

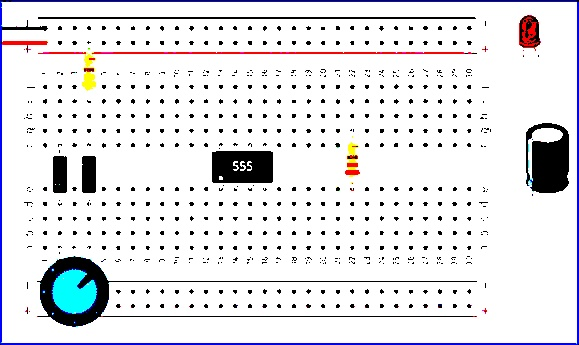
camera/bancada_teste_trh.jpeg
