gefgu/integration-workshop-3/docs/d5-figuras/bancada-09-experimento.png

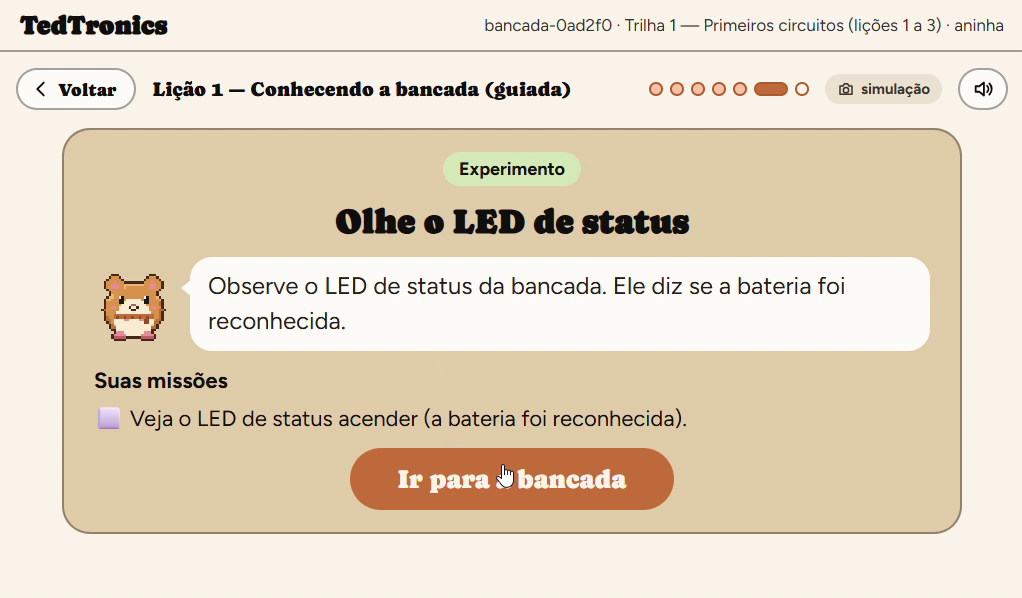
docs/d5-figuras/bancada-09-experimento.png
