gefgu/integration-workshop-3/docs/deliverables/d3/eletronic_images/first_oled_test.jpeg

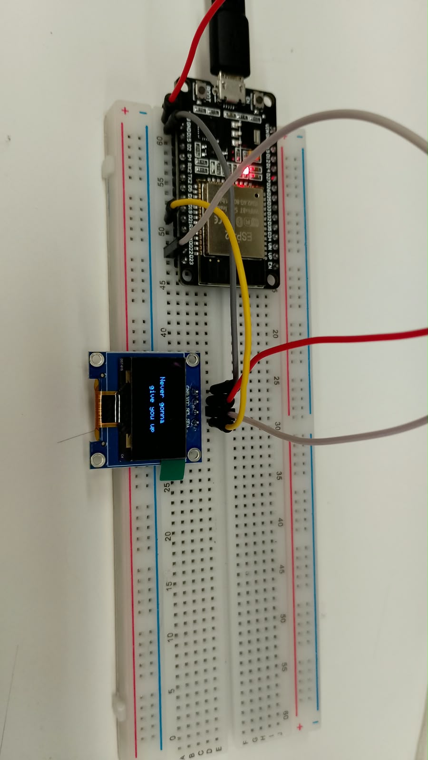
docs/deliverables/d3/eletronic_images/first_oled_test.jpeg
