gefgu/integration-workshop-3/visao/fixtures/current/kit-test-moved-2026-11-10.jpg

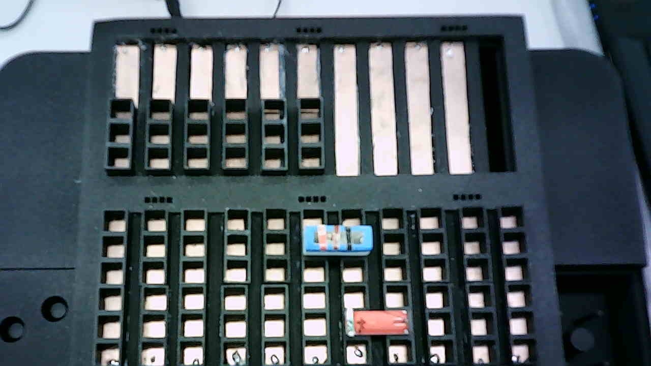
visao/fixtures/current/kit-test-moved-2026-11-10.jpg
