gefgu/integration-workshop-3/visao/fixtures/current/marked-test-still-1.jpg

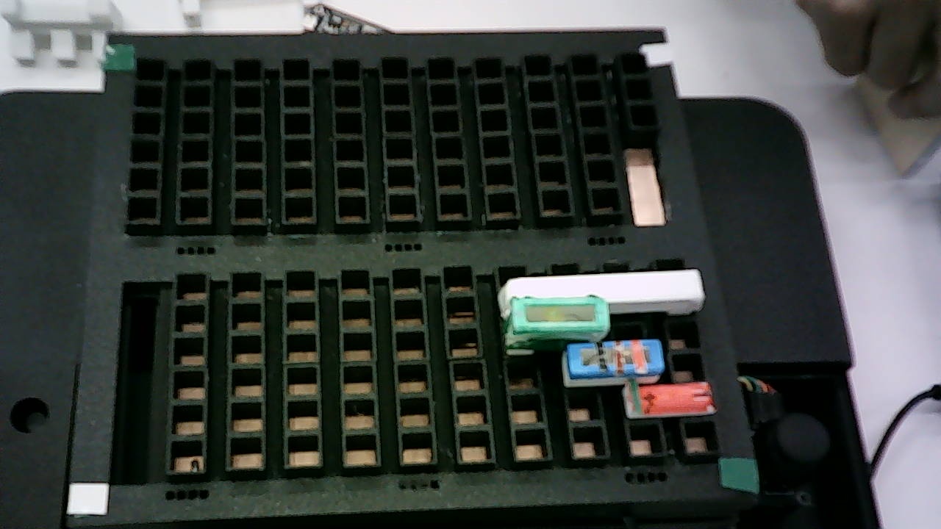
visao/fixtures/current/marked-test-still-1.jpg
