gefgu/integration-workshop-3/docs/ProjectRisks.md

| ID | Risk Name | Impact (1–5) | Probability (1–5) | I × P (1–25) | Risk Response Plan | Re-evaluated Impact (Ir) | Re-evaluated Probability (Pr) | Ir × Pr (1–25) |
|---|---|---|---|---|---|---|---|---|
| R01  | PCB manufacturing delay or design mistake | 4 | 4 | 16 | [See Plan](./risk_response_plans/RiskID1.pdf) | 2 | 2 | 4 |
| R02  | Team member leaving the project | 5 | 3 | 15 | [See Plan](./risk_response_plans/RiskID2.pdf) | 3 | 2 | 6 |
| R03  | Physical structure does not fit or align correctly (holes, webcam stand) | 3 | 4 | 12 | [See Plan](./risk_response_plans/RiskID3.pdf) | 3 | 2 | 6 |
| R04  | Failure in color recognition due to lighting or quality issues | 4 | 3 | 12 | [See Plan](./risk_response_plans/RiskID4.pdf) | 3 | 2 | 6 |
| R05  | Problems with Raspberry Pi performance (lag or overheating) | 3 | 3 | 9  | [See Plan](./risk_response_plans/RiskID5.pdf) | 2 | 1 | 2 |
| R06  | Bad communication between the hardware components | 3 | 3 | 9  | [See Plan](./risk_response_plans/RiskID6.pdf) | 2 | 3 | 6 |
| R07  | Power supply is unstable or insufficient | 3 | 3 | 9  | [See Plan](./risk_response_plans/RiskID7.pdf) | 2 | 2 | 4 |
| R08  | Wifi doesn't work in the UTFPR | 2 | 4 | 8  | [See Plan](./risk_response_plans/RiskID8.pdf) | 1 | 4 | 4 |
| R09  | Hardware component burns out (e.g., LEDs, speaker) | 4 | 2 | 8  | [See Plan](./risk_response_plans/RiskID9.pdf) | 2 | 2 | 4 |
| R10  | Camera wobbling | 4 | 2 | 8  | [See Plan](./risk_response_plans/RiskID10.pdf) | 3 | 2 | 6 |
| R11  | Electronic design error | 3 | 2 | 6  | - | - | - | - |
| R12  | One or more modes fail to work as expected | 3 | 2 | 6  | - | - | - | - |
| R13  | Three members or more leave the project| 5 | 1 | 5  | - | - | - | - |
| R14  | Webcam image quality is insufficient for note detection | 4 | 1 | 4  | - | - | - | - |
| R15  | Fire at the university | 3 | 1 | 3  | - | - | - | - |
| R16  | Delays in delivery of components | 1 | 2 | 2  | - | - | - | - |
