gefgu/integration-workshop-3/docs/risk_response_plans/RiskID3.pdf

## Risk Response Plan Form

### Project: Melody

1st Step: Risk Identification
Name of the Risk:
Physical structure does not fit or align correctly (holes, webcam stand)

ID N°
3
Risk Description:
Misalignment or incorrect dimensions in the physical components (e.g., note holes, LED placement, webcam mount).

2nd Step: Risk Evaluation
Impact: 1(Very Low) 2(Low) X3(Average) 4(High) 5(Very High)

Explanation:
If the physical structure does not fit or align correctly, it may get harder to implement all requirements.

Probability:1(Very Low) 2(Low) 3(Average) X4(High) 5(Very High)

Explanation:
The team members are not used to projecting mechanical structures, it’s likely that the projects have some mistakes.

3rd Step: Risk Response Plan
Task, Who will do it, When it will be done! Strategies and Tasks that should be performed in order to reduce the “Impact”/“Probability” of this risk: Prevention Tasks:
Double-check all measurements and spacing (Double the time).
Mark drilling points carefully and test positioning before committing to permanent modifications. Involve more than one team member in reviewing and validating the design.

Mitigation Tasks:
Adjust or re-drill components if misalignment is minor and can be corrected.
Keep extra materials on hand for fast rework if needed, buy extra before working.

Transfer* (use in last case, avoid if possible):

Acceptance Tasks (avoid at all costs!):

(* At Integration Workshop 3, it would not be possible to “transfer” the Risk outside of the team!)
Re-evaluated Impact (1~5): 3 | Re-evaluated Probability (1-5): 2
Elaborated by: Bruno | Date: 23/04/2025

Form based on Gasnier, 2000 (IMAN Editor), adjusted by Wille(UTFPR), translated to English by Fabro(UTFPR).
