gefgu/integration-workshop-3/debug_diagnostico/auto_sockets.csv

metade | linha | coluna | x | y | furo_detectado | cor
C | 0 | 0 | 243.4 | 58.5 | True
C | 0 | 1 | 314.2 | 58.6 | True
C | 0 | 2 | 385.2 | 58.8 | True
C | 0 | 3 | 456.4 | 58.9 | False | azul
C | 0 | 4 | 527.9 | 59.0 | False | azul
C | 0 | 5 | 599.6 | 59.1 | True
C | 0 | 6 | 671.5 | 59.2 | True
C | 0 | 7 | 743.7 | 59.3 | True
C | 0 | 8 | 816.2 | 59.4 | True
C | 0 | 9 | 888.8 | 59.6 | True
C | 0 | 10 | 961.8 | 59.7 | False
C | 1 | 0 | 239.4 | 101.6 | False | branco
C | 1 | 1 | 310.7 | 101.7 | False | branco
C | 1 | 2 | 382.3 | 101.9 | True
C | 1 | 3 | 454.1 | 102.1 | True
C | 1 | 4 | 526.1 | 102.3 | True
C | 1 | 5 | 598.4 | 102.5 | True
C | 1 | 6 | 670.9 | 102.7 | True
C | 1 | 7 | 743.7 | 102.9 | True
C | 1 | 8 | 816.7 | 103.1 | True
C | 1 | 9 | 890.0 | 103.3 | True
C | 1 | 10 | 963.5 | 103.4 | False
C | 2 | 0 | 235.4 | 145.3 | False
C | 2 | 1 | 307.2 | 145.5 | False
C | 2 | 2 | 379.3 | 145.8 | True
C | 2 | 3 | 451.7 | 146.1 | True
C | 2 | 4 | 524.3 | 146.3 | True
C | 2 | 5 | 597.2 | 146.6 | True
C | 2 | 6 | 670.3 | 146.9 | True
C | 2 | 7 | 743.6 | 147.1 | True
C | 2 | 8 | 817.2 | 147.4 | True
C | 2 | 9 | 891.1 | 147.7 | True
C | 2 | 10 | 965.2 | 147.9 | False
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
