gefgu/integration-workshop-3/debug_diagnostico/camera_sockets.csv

metade | linha | coluna | x | y | furo_detectado | cor
C | 0 | 0 | 107.5 | 12.6 | False
C | 0 | 1 | 154.0 | 12.3 | False
C | 0 | 2 | 200.8 | 12.0 | False | azul
C | 0 | 3 | 247.9 | 11.8 | False | azul
C | 0 | 4 | 295.3 | 11.5 | False
C | 0 | 5 | 343.0 | 11.2 | False
C | 0 | 6 | 391.0 | 11.0 | False
C | 0 | 7 | 439.2 | 10.7 | False
C | 0 | 8 | 487.8 | 10.4 | False
C | 0 | 9 | 536.6 | 10.1 | False
C | 0 | 10 | 585.8 | 9.9 | False | branco
C | 1 | 0 | 105.1 | 40.6 | True
C | 1 | 1 | 152.0 | 40.4 | True
C | 1 | 2 | 199.2 | 40.2 | False | azul
C | 1 | 3 | 246.7 | 40.1 | False | azul
C | 1 | 4 | 294.5 | 39.9 | True
C | 1 | 5 | 342.5 | 39.7 | True
C | 1 | 6 | 390.9 | 39.5 | True
C | 1 | 7 | 439.5 | 39.3 | True
C | 1 | 8 | 488.5 | 39.1 | True
C | 1 | 9 | 537.7 | 38.9 | False
C | 1 | 10 | 587.3 | 38.7 | False | branco
C | 2 | 0 | 102.8 | 69.1 | False | branco
C | 2 | 1 | 150.0 | 69.0 | True
C | 2 | 2 | 197.6 | 68.9 | True
C | 2 | 3 | 245.5 | 68.8 | False
C | 2 | 4 | 293.6 | 68.7 | True
C | 2 | 5 | 342.1 | 68.6 | True
C | 2 | 6 | 390.8 | 68.5 | True
C | 2 | 7 | 439.8 | 68.4 | True
C | 2 | 8 | 489.2 | 68.3 | True
C | 2 | 9 | 538.9 | 68.2 | False
C | 2 | 10 | 588.8 | 68.1 | False | branco
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
