gefgu/integration-workshop-3/debug_diagnostico/auto_bruto.jpg

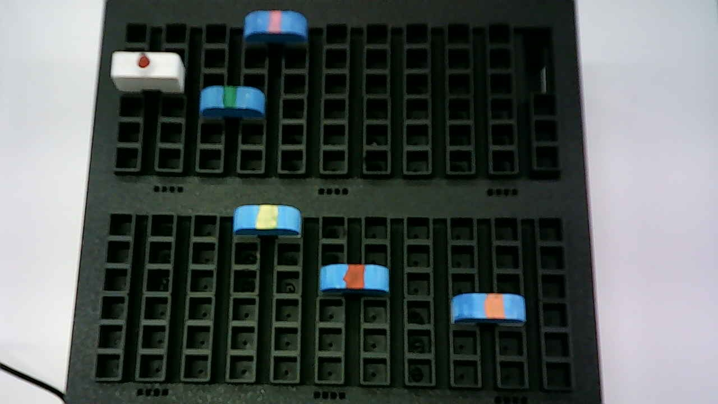
debug_diagnostico/auto_bruto.jpg
