gefgu/integration-workshop-3/debug_diagnostico/auto_placa.png

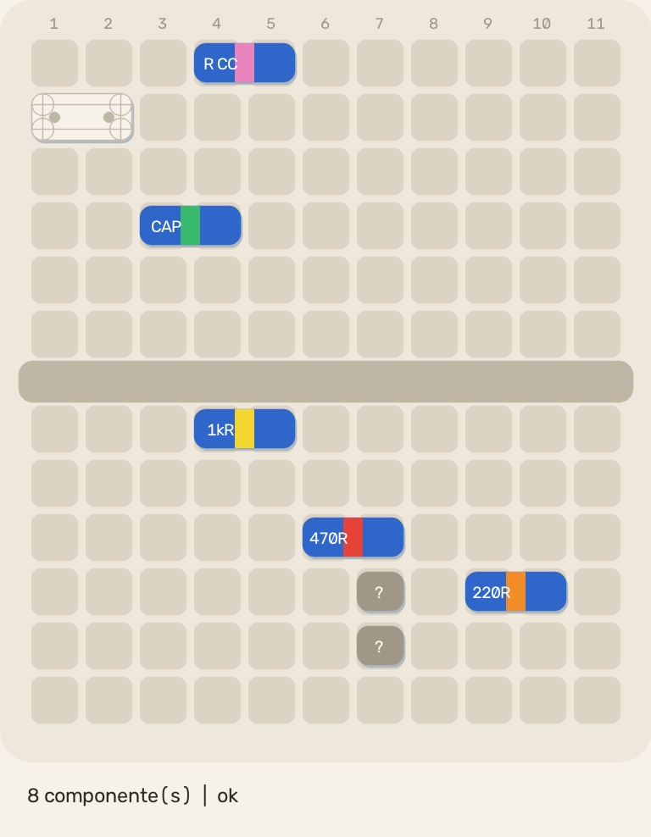
debug_diagnostico/auto_placa.png
