gefgu/integration-workshop-3/debug_diagnostico/auto_retificada.jpg

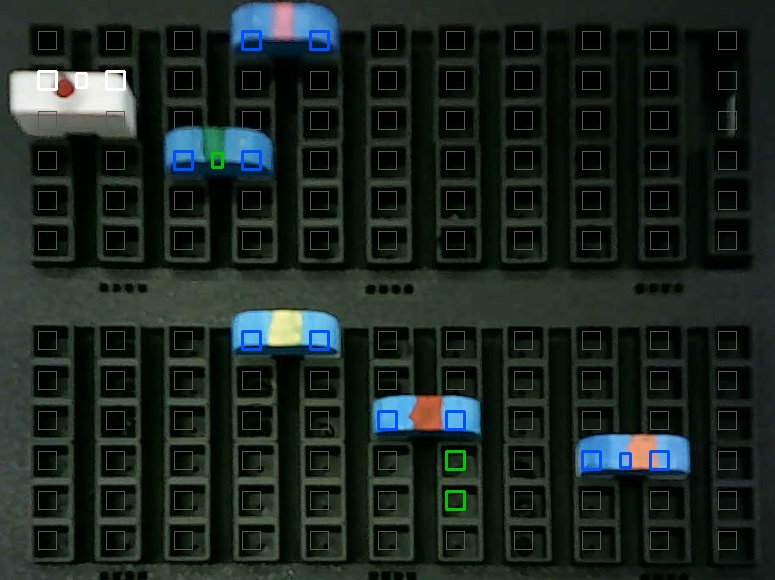
debug_diagnostico/auto_retificada.jpg
