gefgu/integration-workshop-3/debug_diagnostico/camera_placa.png

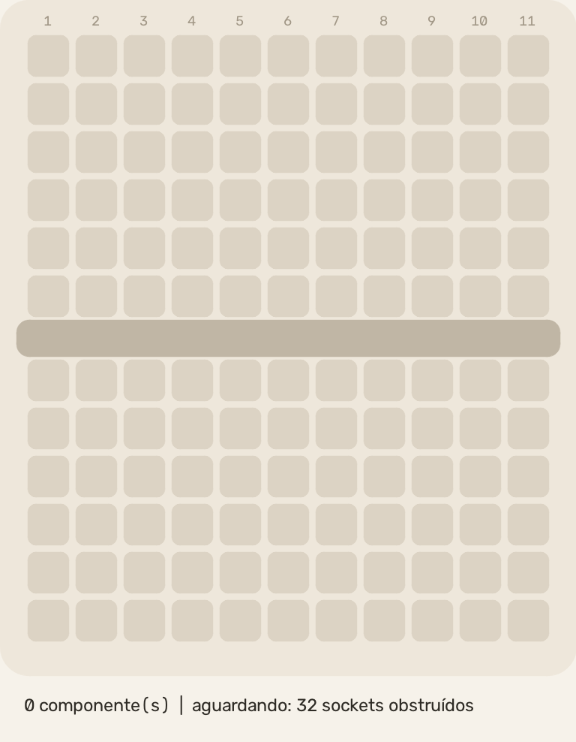
debug_diagnostico/camera_placa.png
