gefgu/integration-workshop-3/debug_diagnostico/camera_retificada.jpg

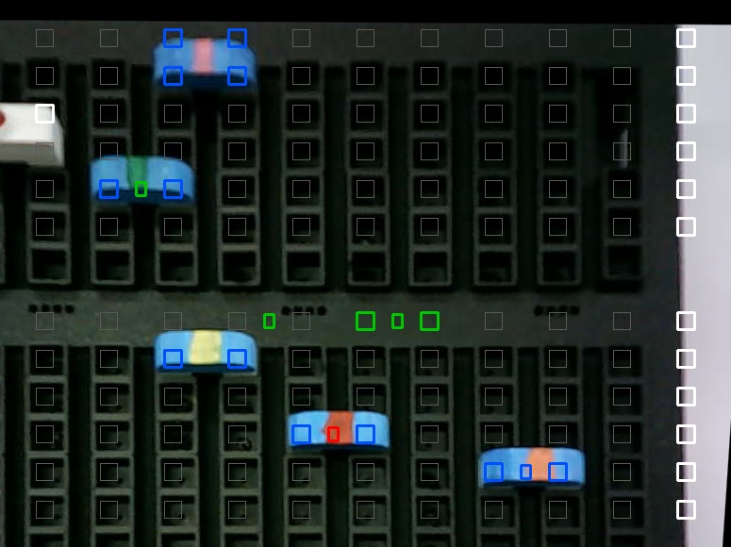
debug_diagnostico/camera_retificada.jpg
