gefgu/integration-workshop-3/debug_diagnostico/camera_sockets.jpg

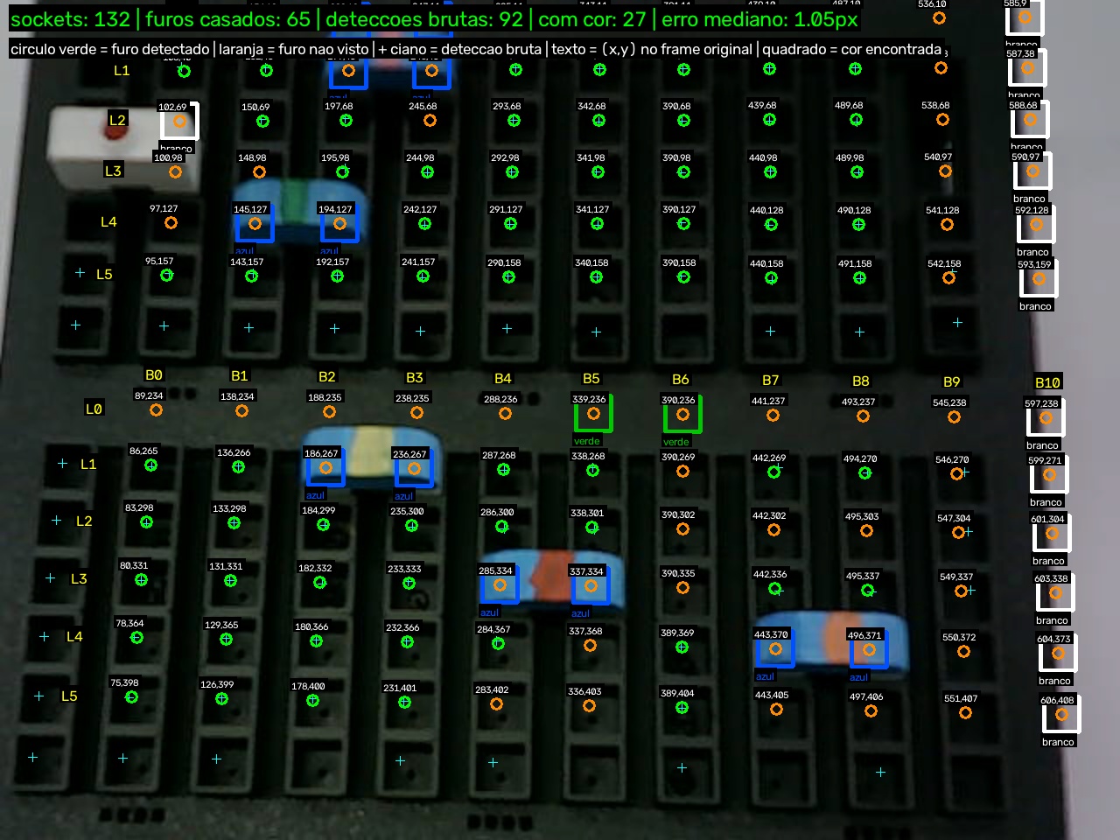
debug_diagnostico/camera_sockets.jpg
