gefgu/integration-workshop-3/debug_diagnostico/travada_sockets.jpg

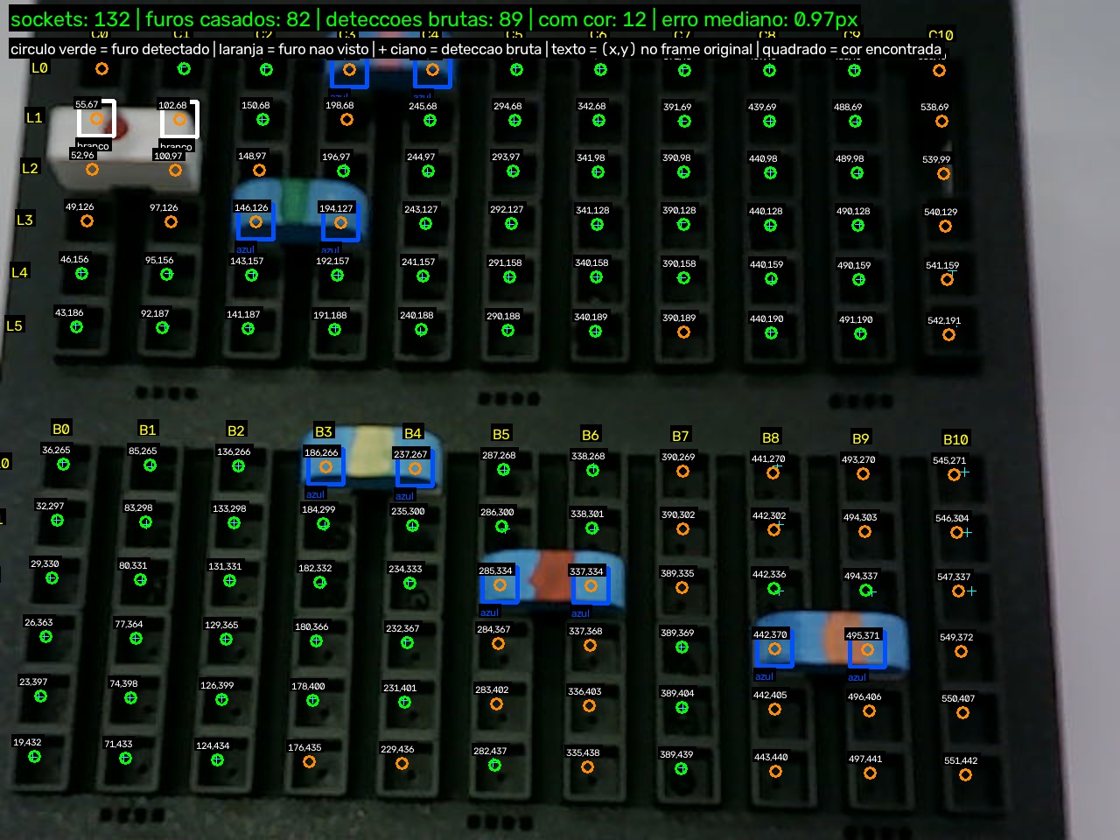
debug_diagnostico/travada_sockets.jpg
