gefgu/integration-workshop-3/debug_visao/foto1_sockets.jpg

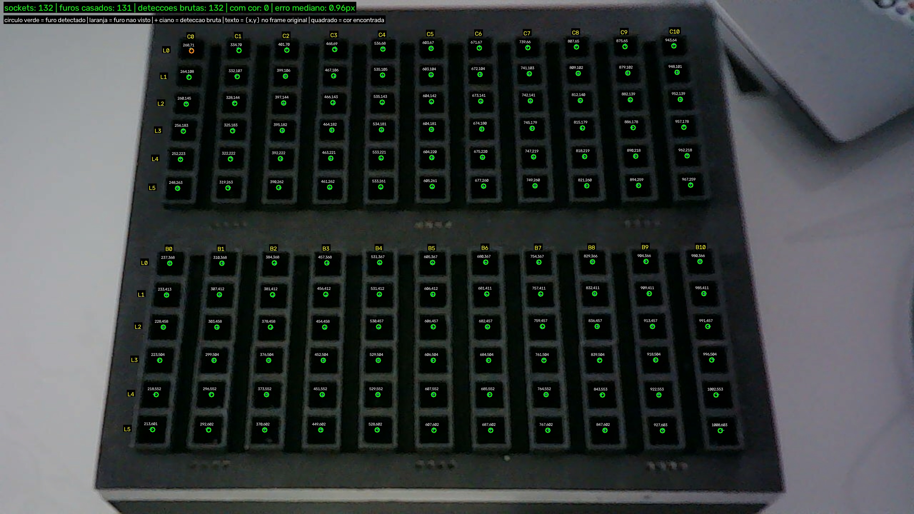
debug_visao/foto1_sockets.jpg
