gefgu/integration-workshop-3/debug_visao/pecas_retificada.jpg

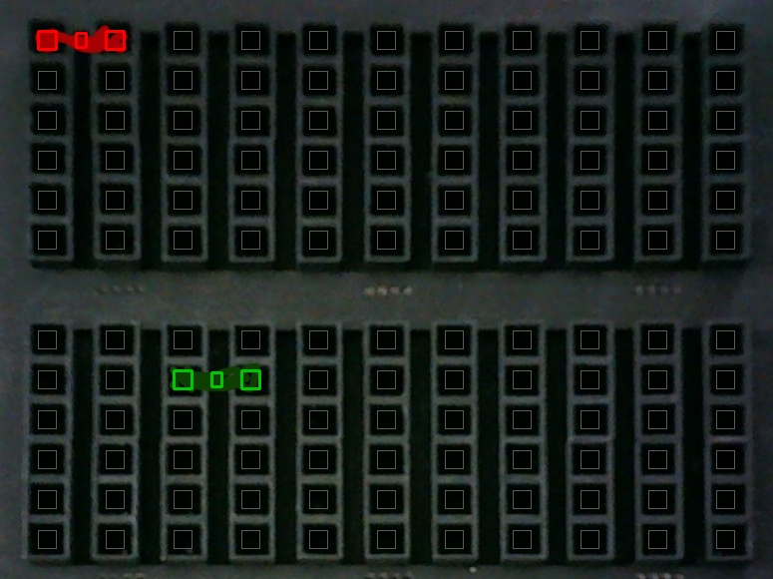
debug_visao/pecas_retificada.jpg
