gefgu/integration-workshop-3/electronics/melody/melody.pdf

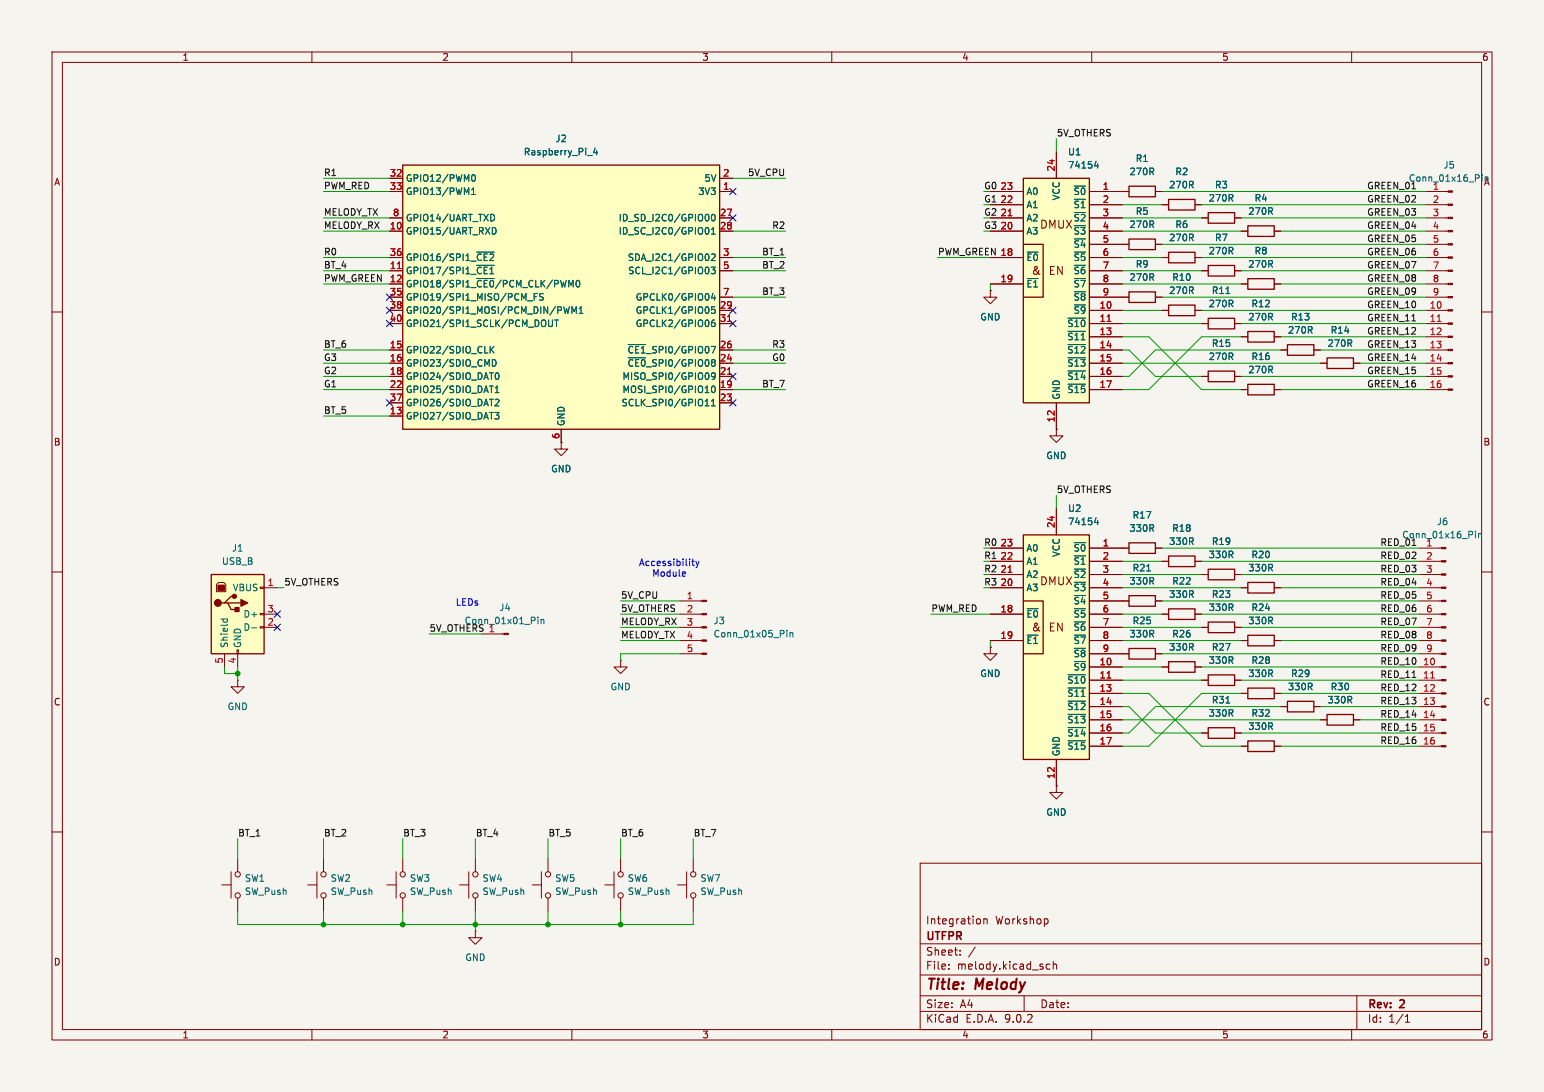
[picture p244: page 1]

File: melody.kicad_sch Sheet: / UTFPR
