gefgu/integration-workshop-3/eletronics/perfboard/tscircuit/smart-perfboard/stage1/compact/schematic-4x3.pdf

# ESP32 — etapa 1 / conexões diretas

## 30-pin ESP32 left socket

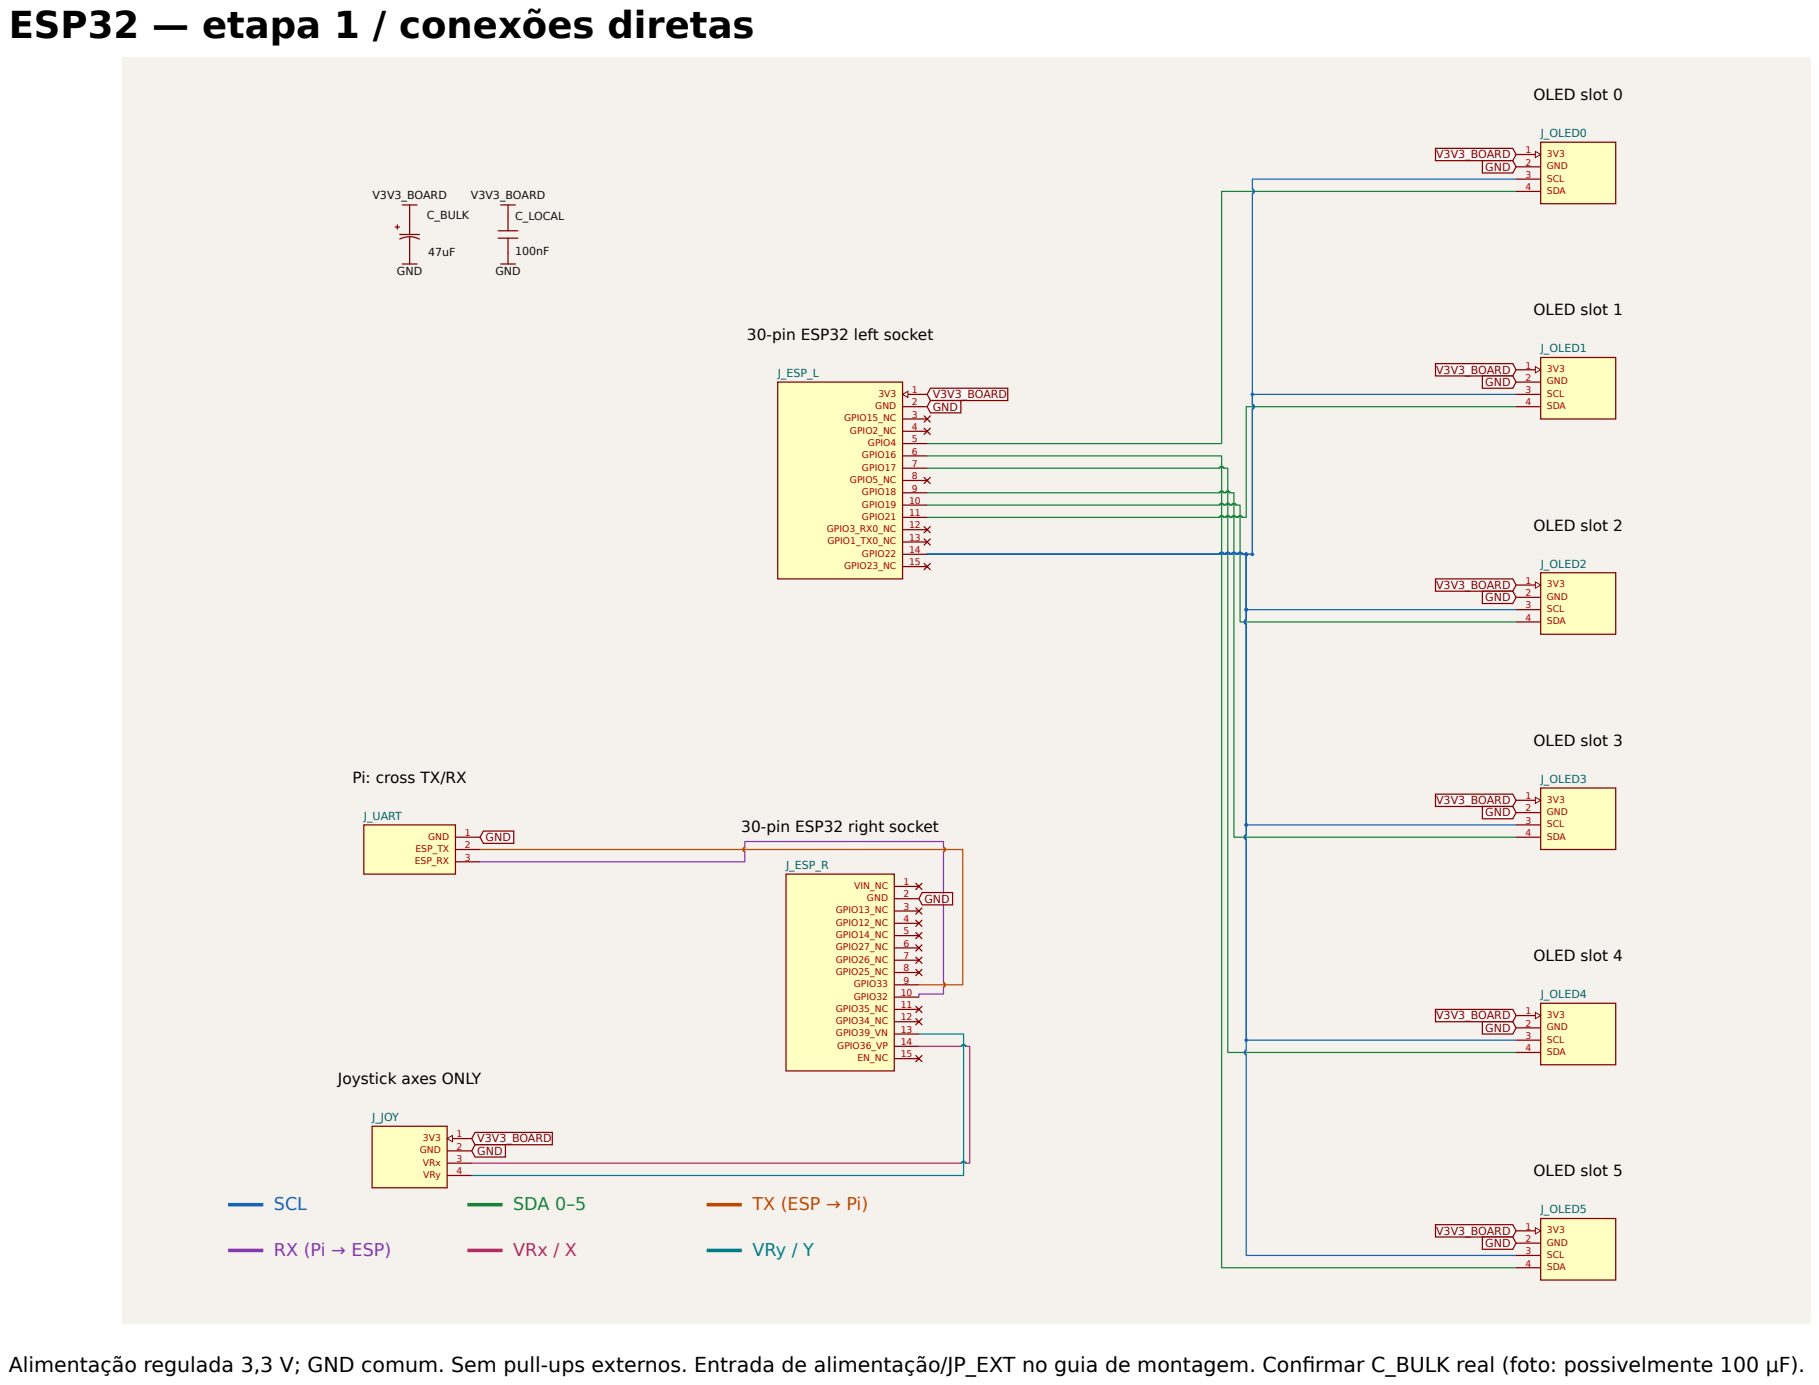
[picture p245: page 1]
J_ESP_L; 1 3V3 2 GND 3 GPIO15_NC 4 GPIO2_NC 5 GPIO4 6 GPIO16 7 GPIO17 8 GPIO5_NC 9 GPIO18 10 GPIO19 11 GPIO21 12 GPIO3_RX0_NC 13 GPIO1_TX0_NC 14 GPIO22 15 GPIO23_NC; J_ESP_R; 1 VIN_NC 2 GND 3 GPIO13_NC 4 GPIO12_NC 5 GPIO14_NC 6 GPIO27_NC 7 GPIO26_NC 8 GPIO25_NC 9 GPIO33 10 GPIO32 11 GPIO35_NC 12 GPIO34_NC 13 GPIO39_VN; 14 GPIO36_VP; J_UART; 1 GND 2 ESP_TX 3 ESP_RX; J_JOY; 1 3V3 2 GND; 3 VRx; 4 VRy; J_OLED0; GND; SCL 4; SDA; J_OLED1; J_OLED2; J_OLED3; J_OLED4; J_OLED5; C_BULK; C_LOCAL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

Pi: cross TX/RX

30-pin ESP32 right socket

Joystick axes ONLY

Alimentação regulada 3,3 V; GND comum. Sem pull-ups externos. Entrada de alimentação/JP_EXT no guia de montagem. Confirmar C_BULK real (foto: possivelmente 100 µF).
