gefgu/integration-workshop-3/docs/deliverables/d1_images/Capacitor.pdf

25 ²⁸.75 | 9 | 3.5 3.5 2

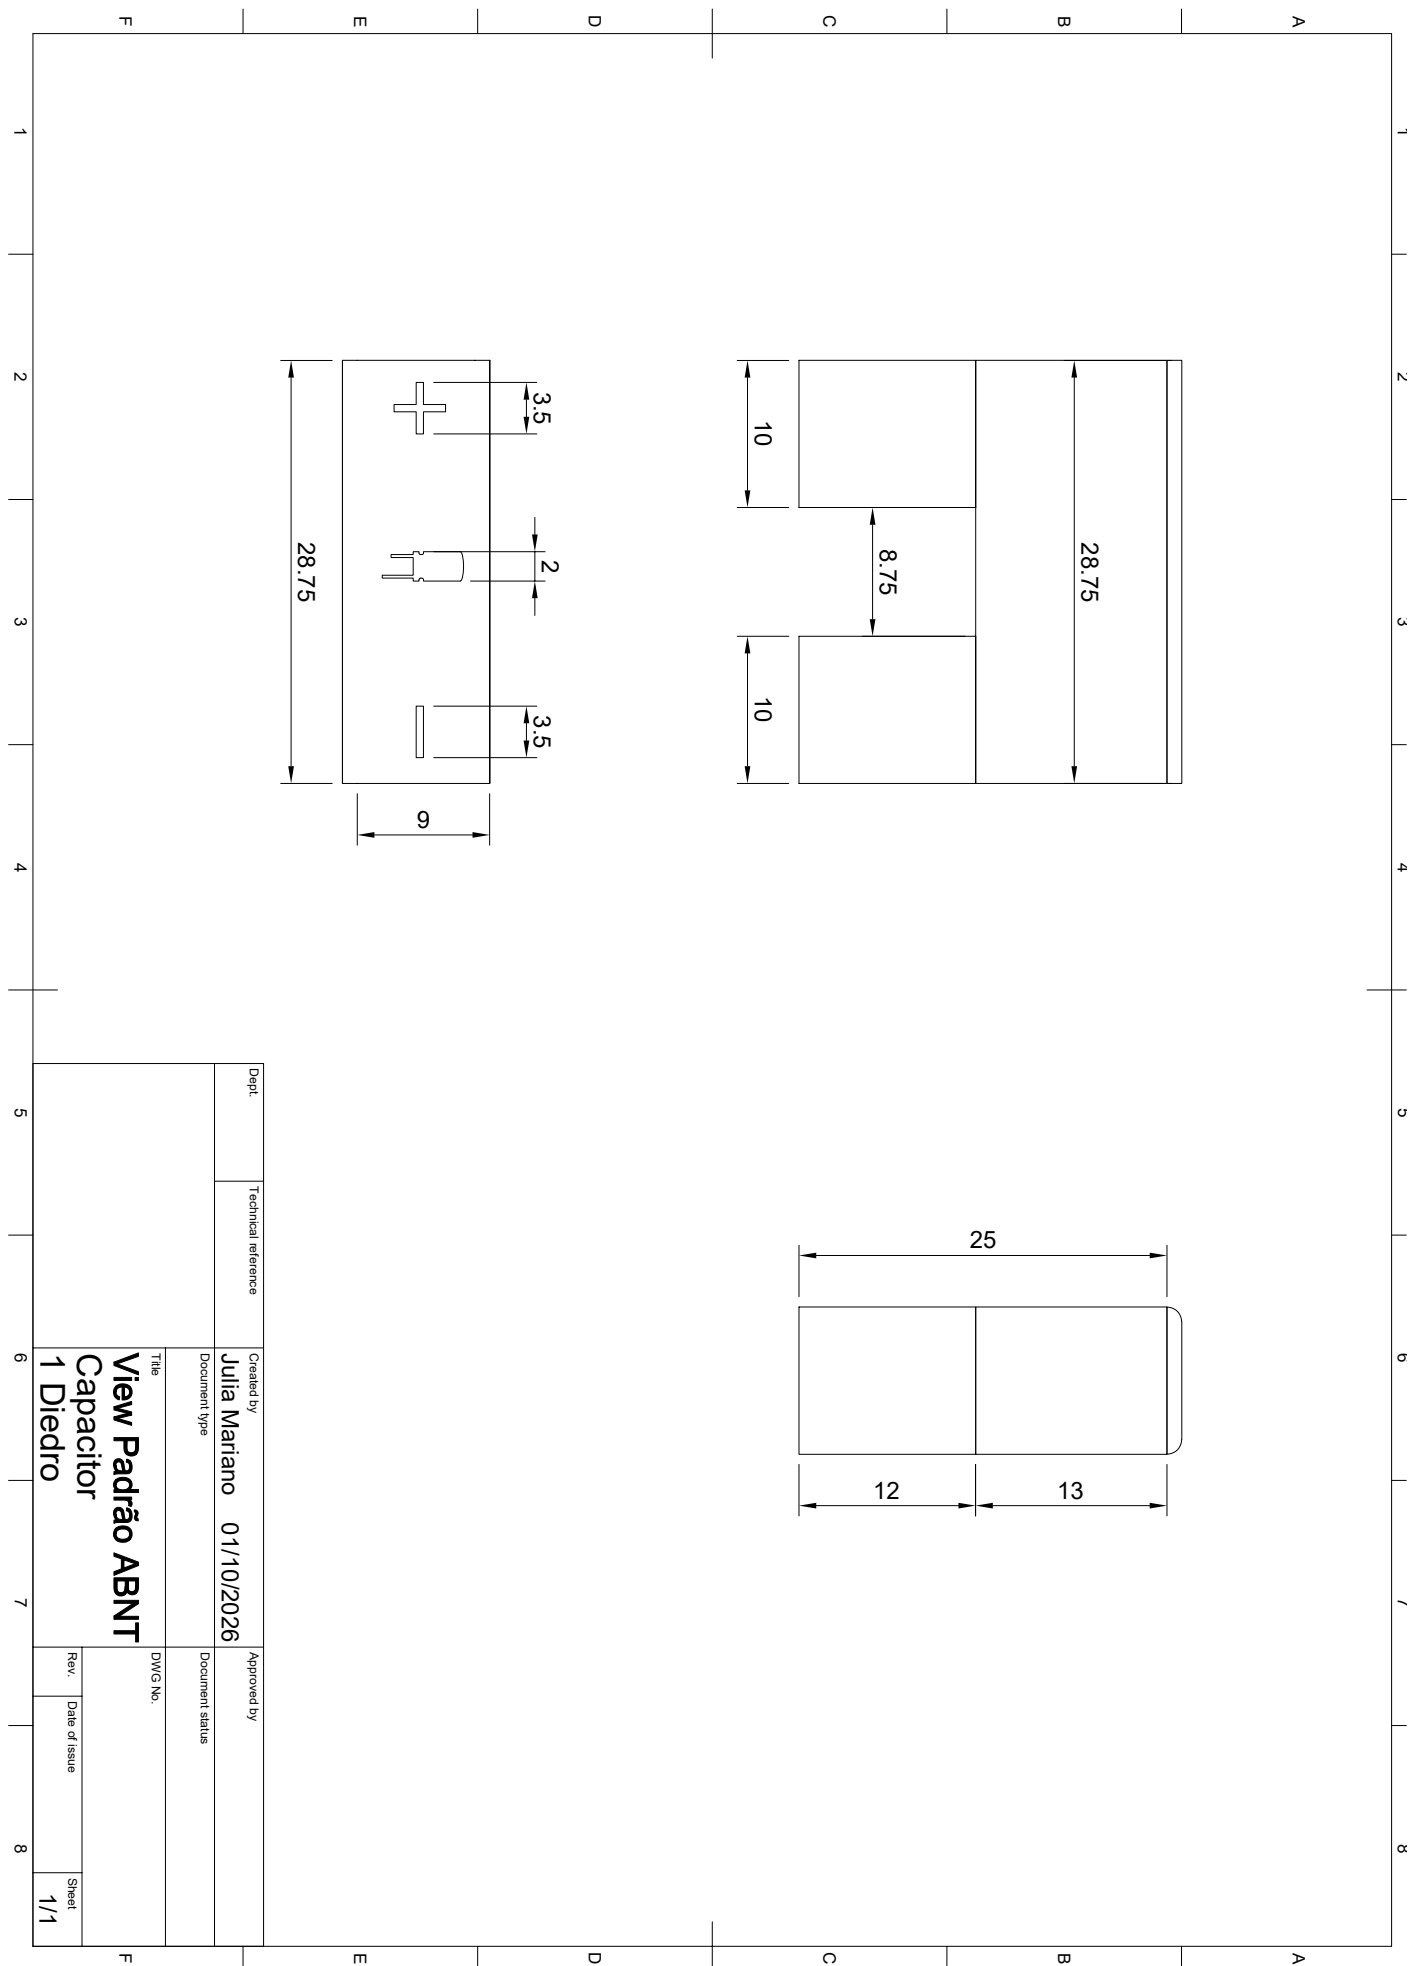
[picture p246: page 1]

1 A 2 3 4 5 6 7 8 1 2 3 4 5 6 7 8 FEDCB FEDCBA Dept. Technical reference Created by Approved by Title DWG No. Document type Document status Rev. Date of issue Sheet 1 Diedro 01/10/2026 1/1 Capacitor Julia Mariano 28.75 10 10 8.75
