gefgu/integration-workshop-3/docs/deliverables/d1_images/LED.pdf

10 | 5 28.75 | 5

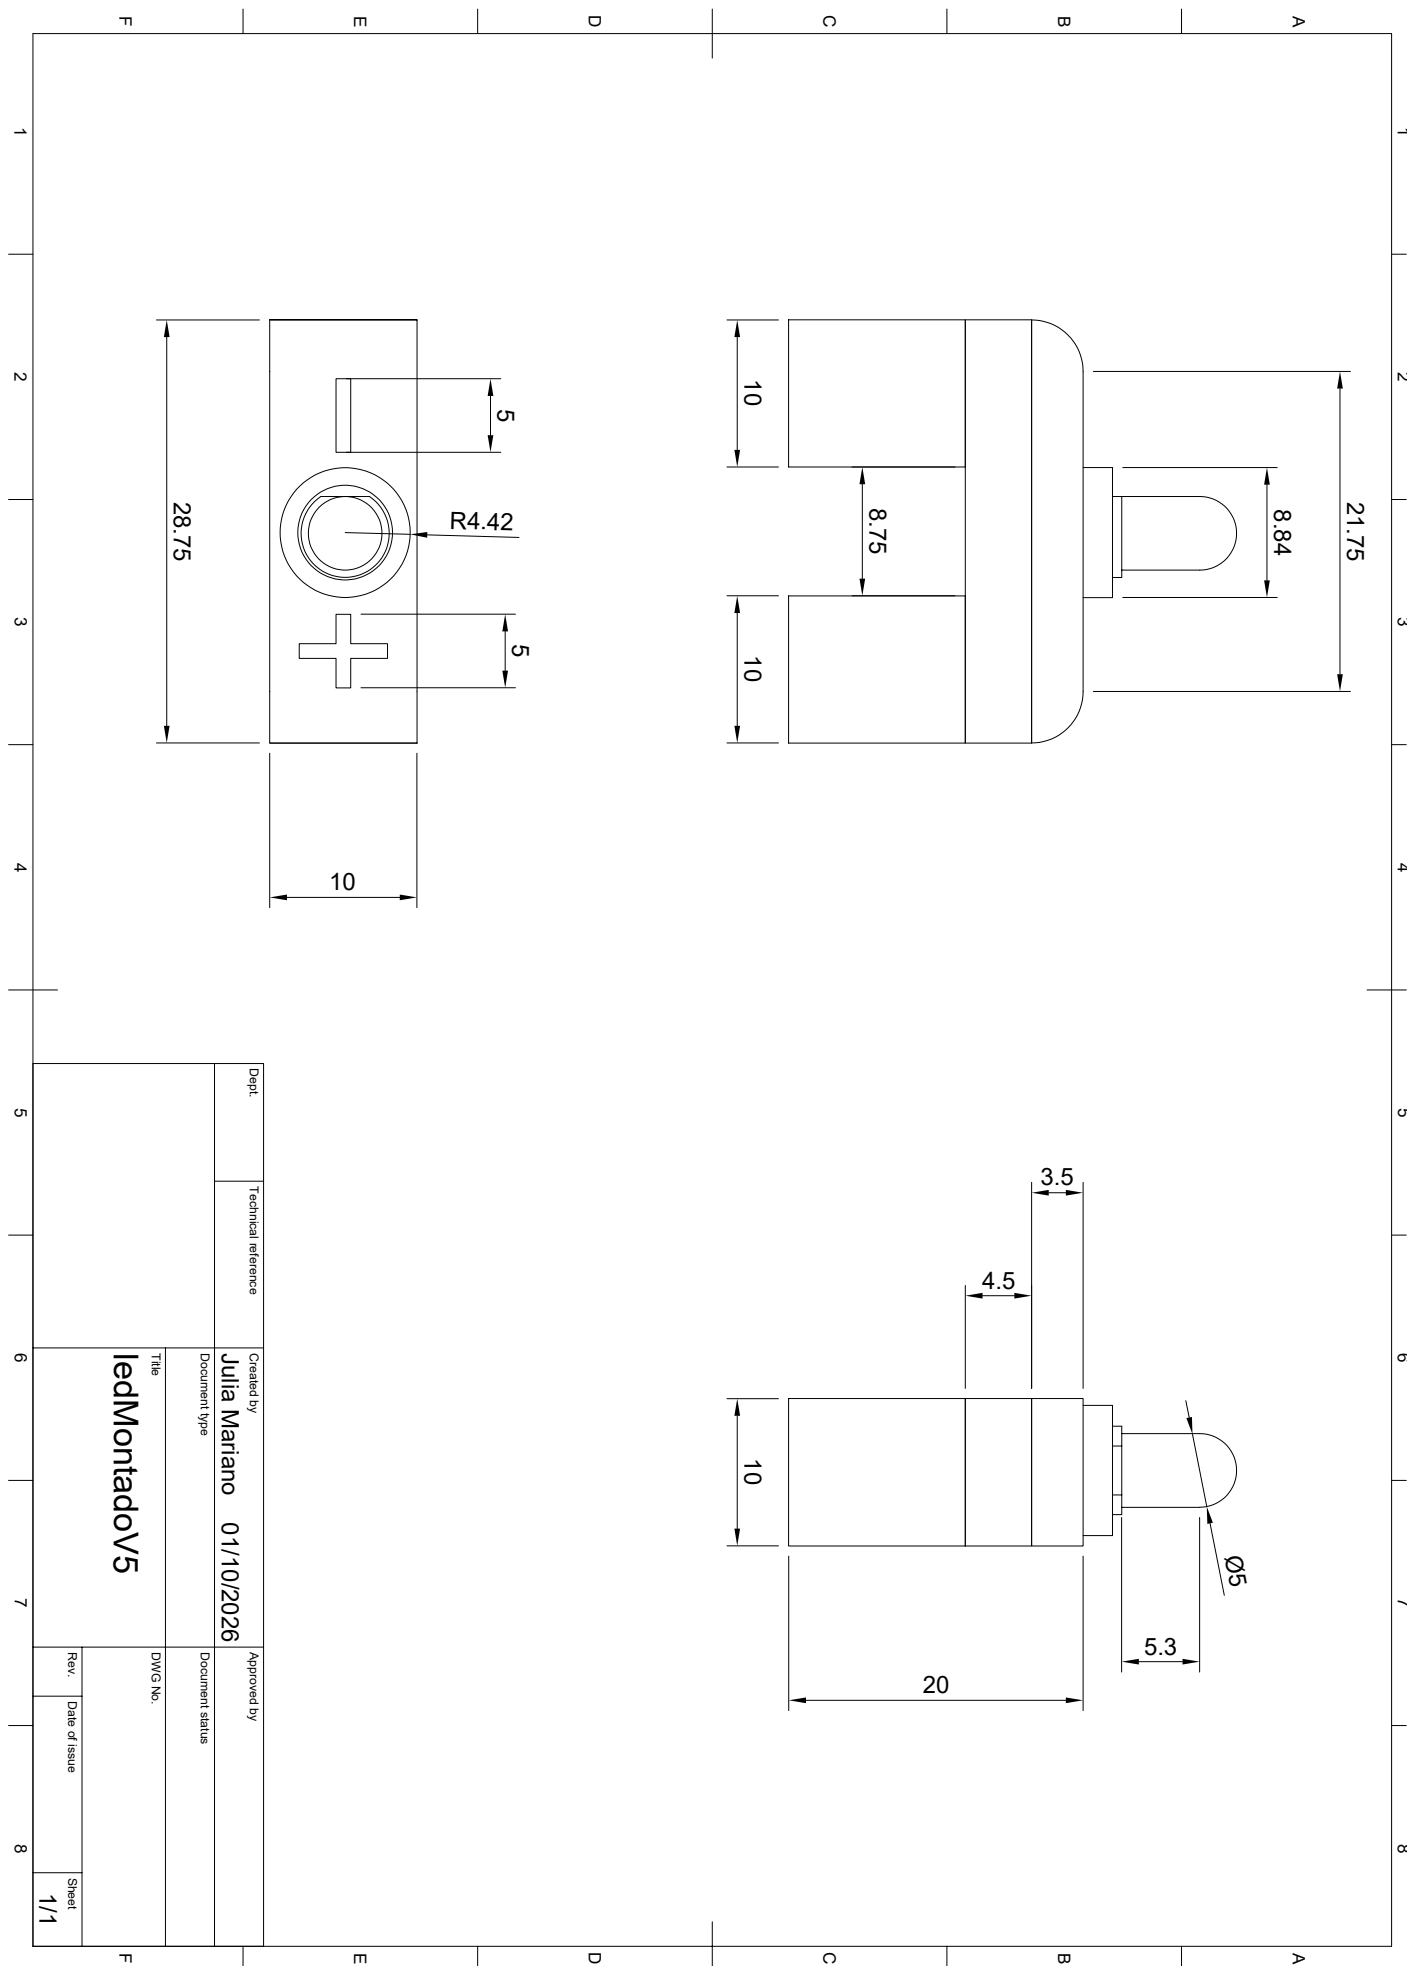
[picture p247: page 1]

1 A 2 3 4 5 6 7 8 1 2 3 4 5 6 7 8 FEDCB FEDCBA Dept. Technical reference Created by Approved by Title DWG No. Document type Document status Rev. Date of issue Sheet 01/10/2026 1/1 ledMontadoV5 Julia Mariano 10 10
