gefgu/integration-workshop-3/electronics/accessibility_module/accessibility_module-schematic.pdf

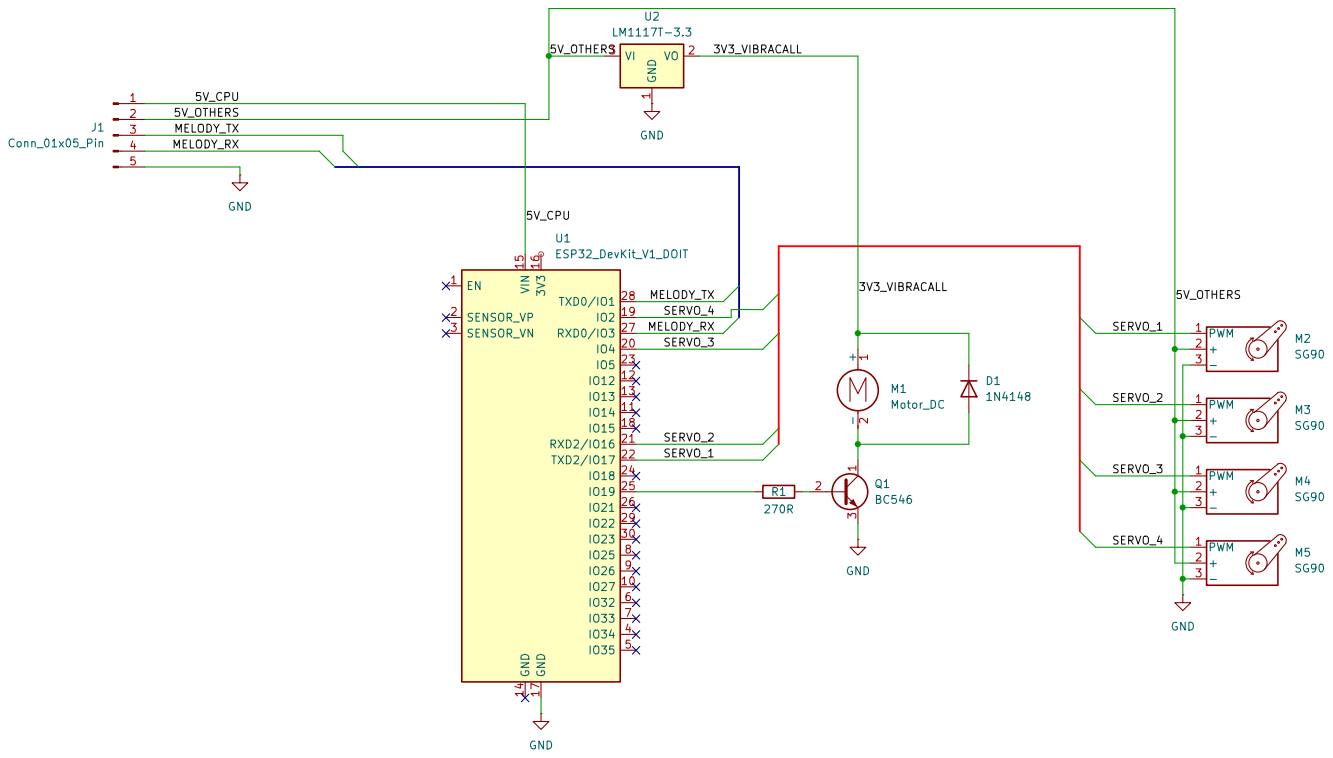
[picture p280: page 1]
