gefgu/integration-workshop-3/electronics/accessibility_module/accessibility_module.pdf

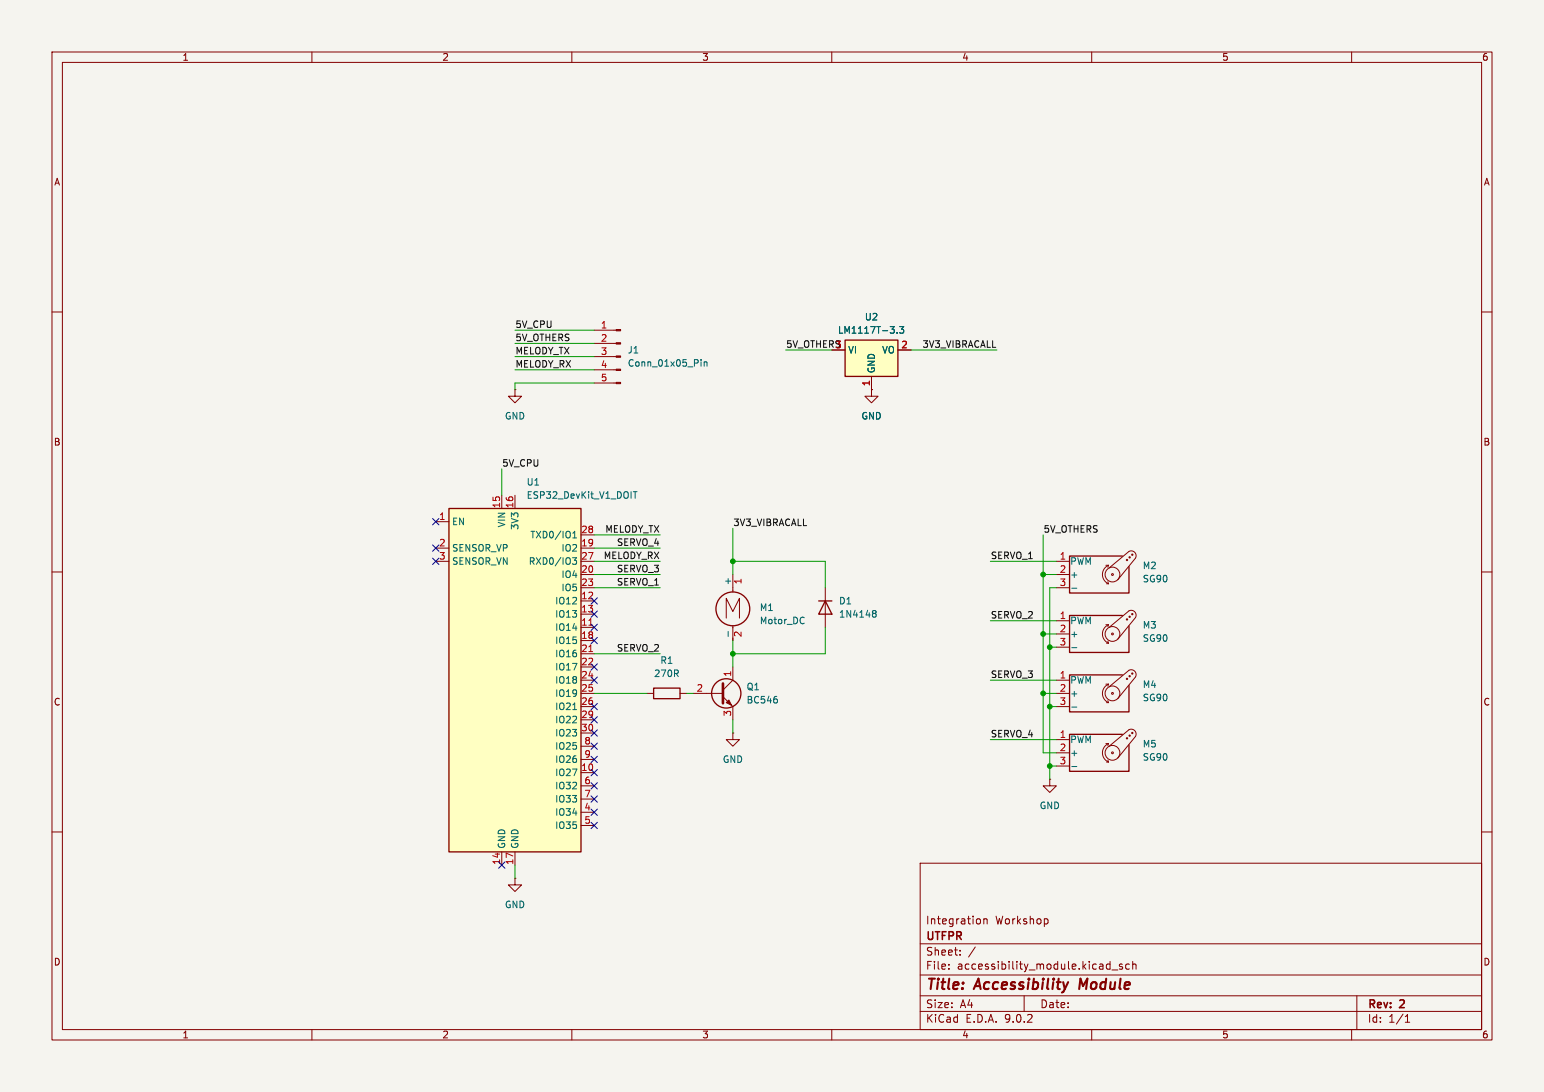
[picture p281: page 1]

Id: 1/1 Title: Accessibility Module
