gefgu/integration-workshop-3/electronics/melody/melodyschematic.pdf

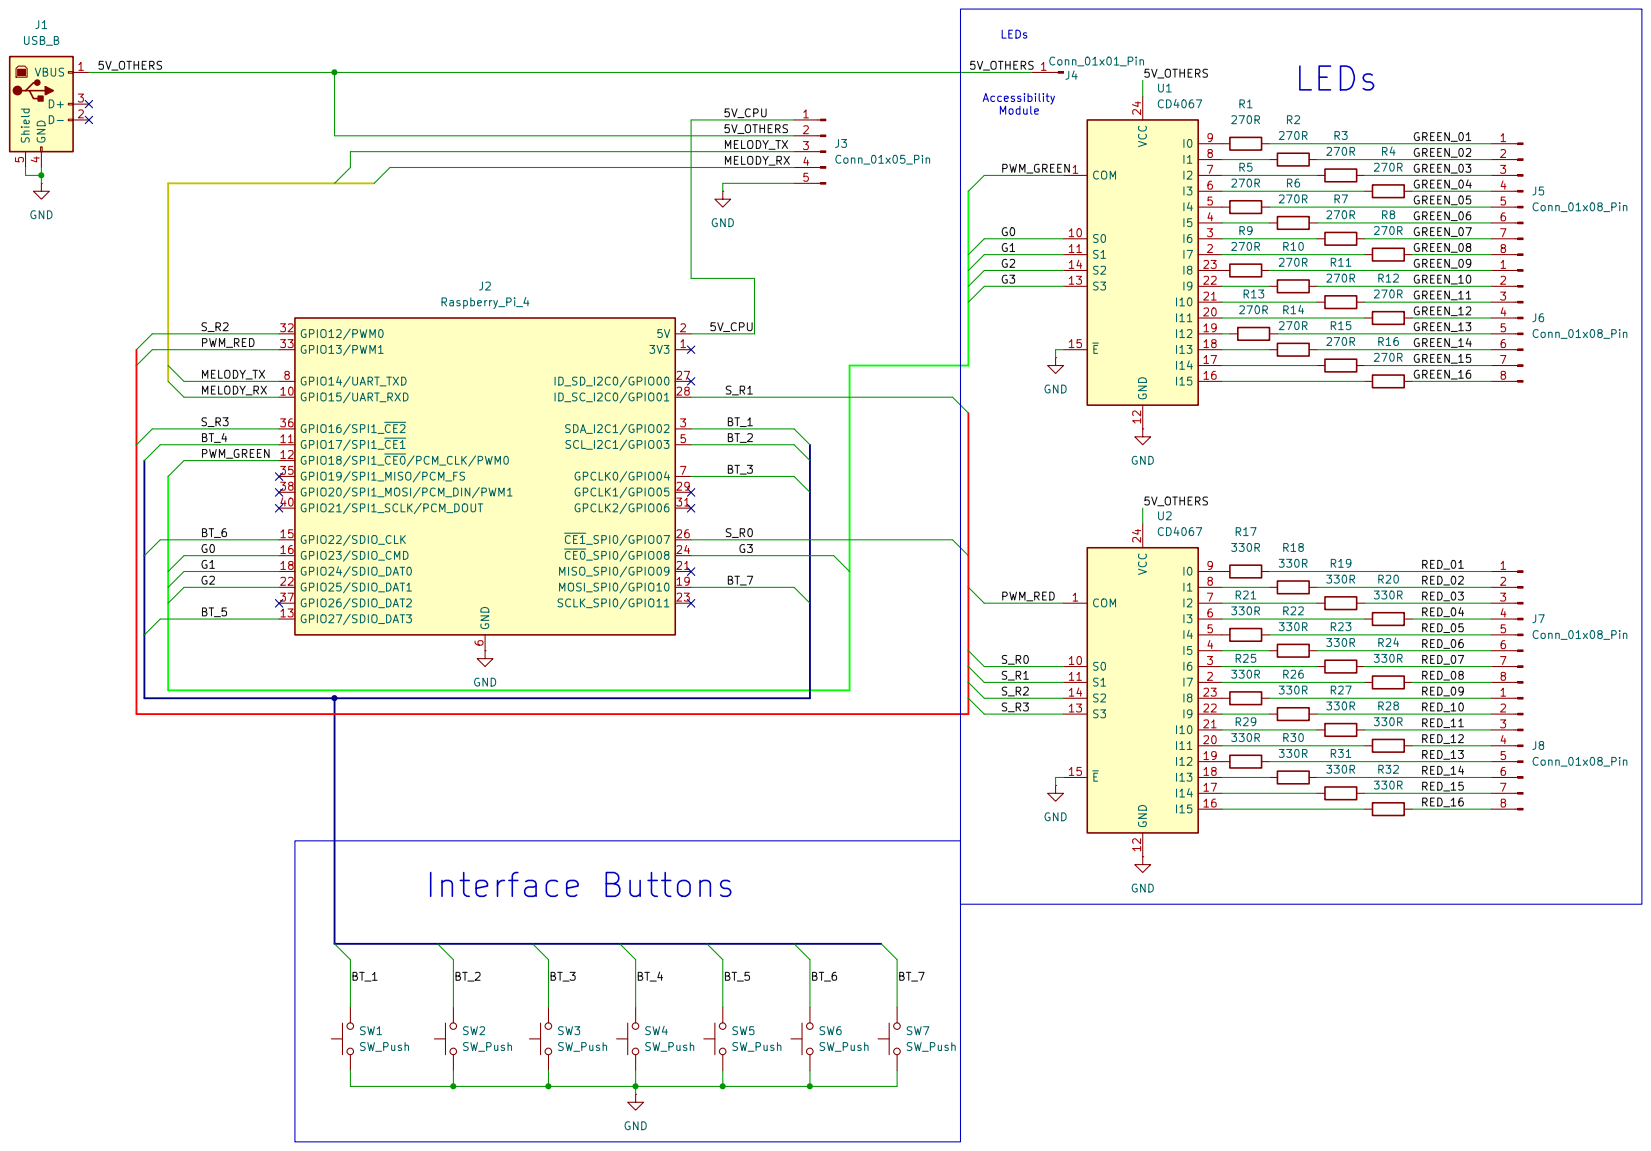
[picture p282: page 1]
