gefgu/integration-workshop-3/docs/deliverables/d1_images/cotaComponentes2Desenho.pdf

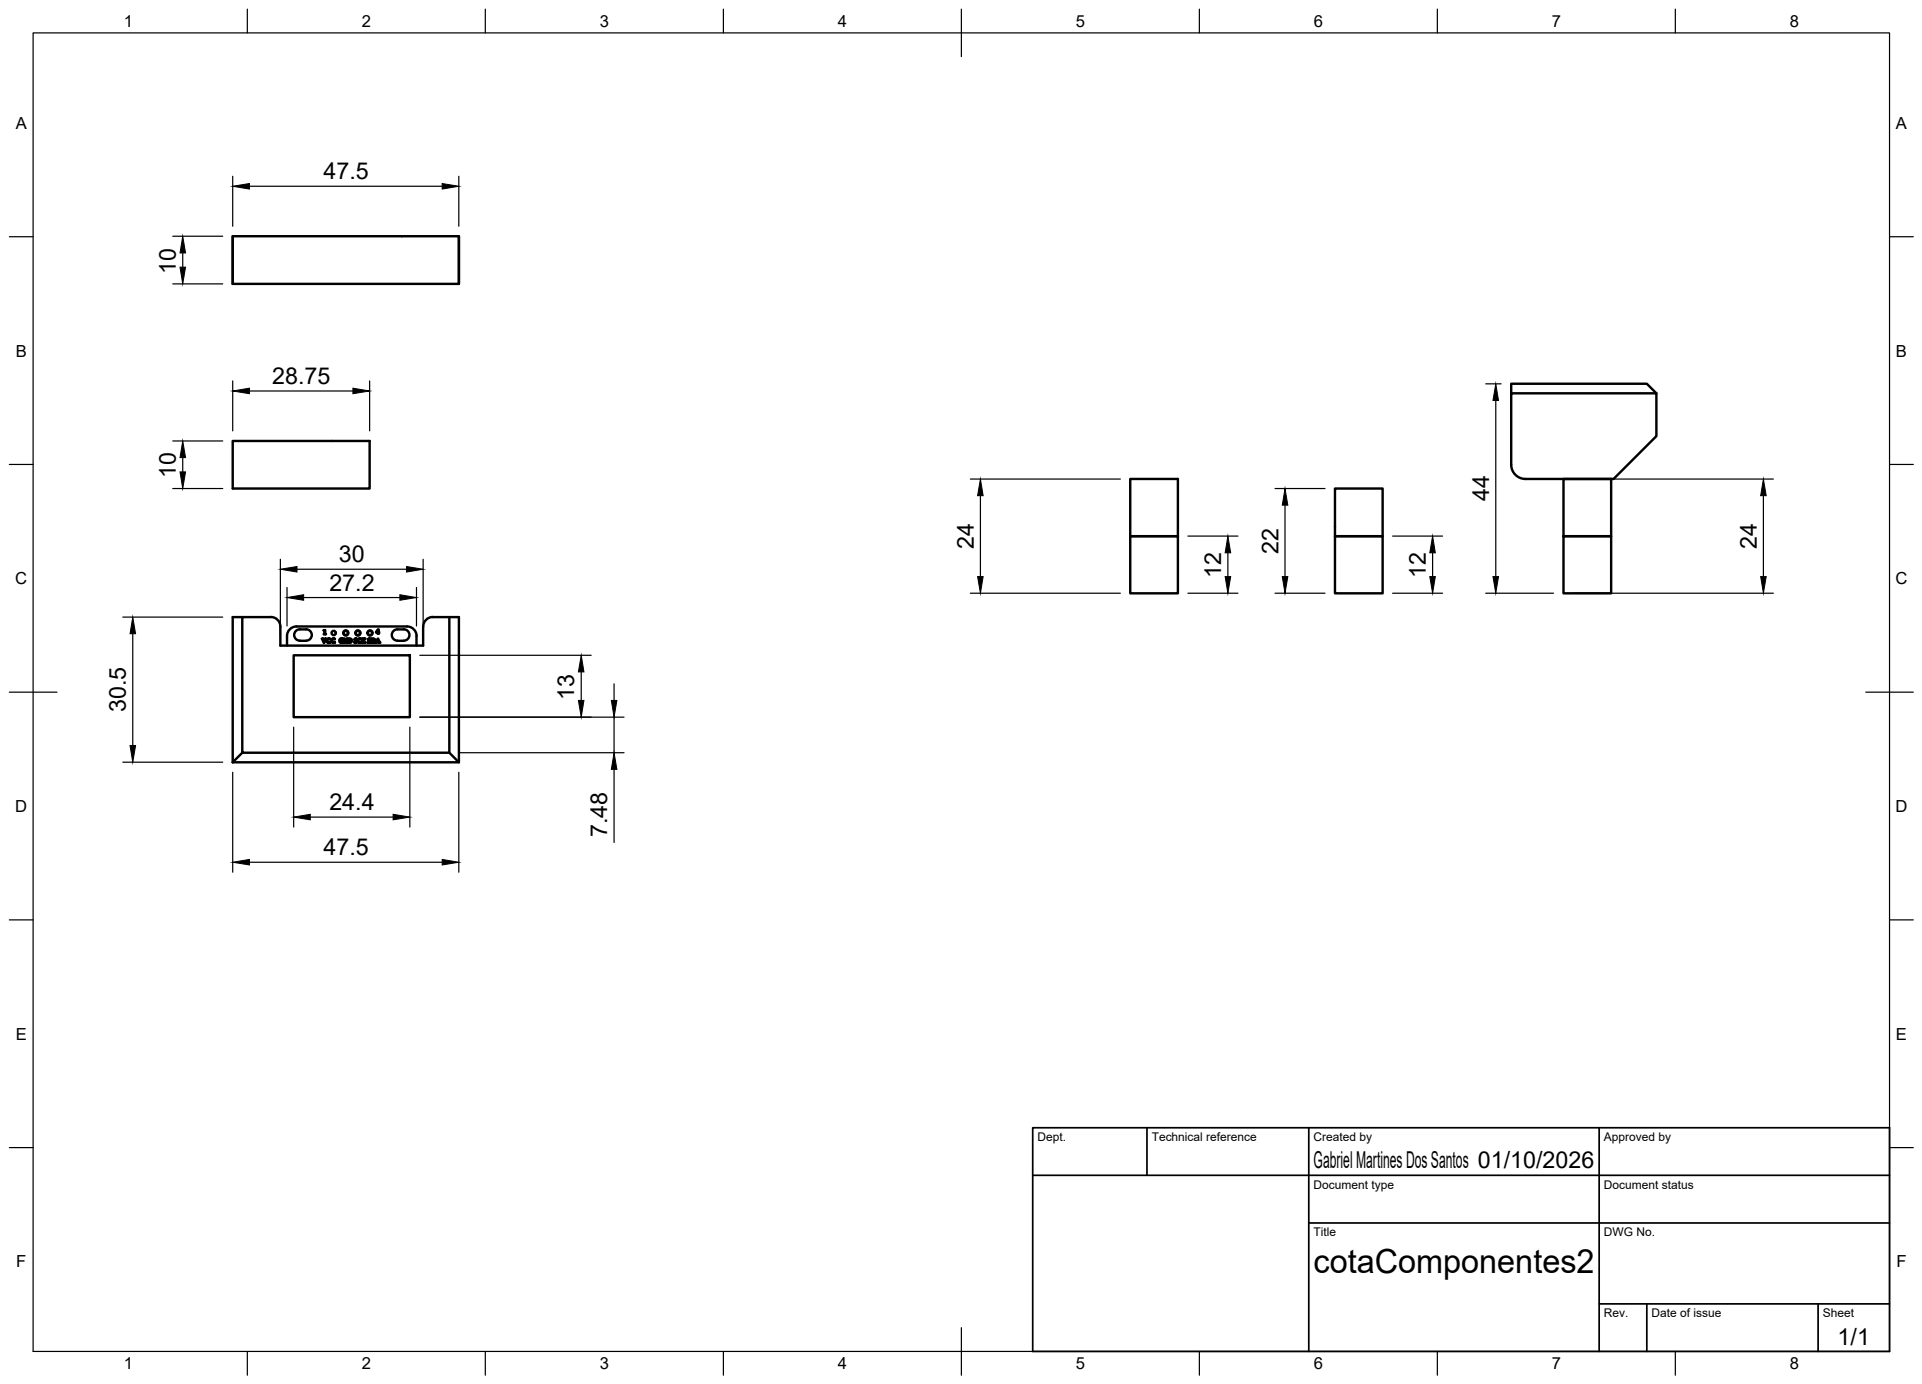
[picture p283: page 1]
Title; DWG No.; Rev.; Date of issue; Sheet

Dept. | Technical reference | Created by Gabriel Martines Dos Santos 01/10/2026 | Approved by

Document type | Document status
