gefgu/integration-workshop-3/docs/deliverables/d1_images/Smart Component.pdf

12 8.75 8.75

30.5 10 7.5

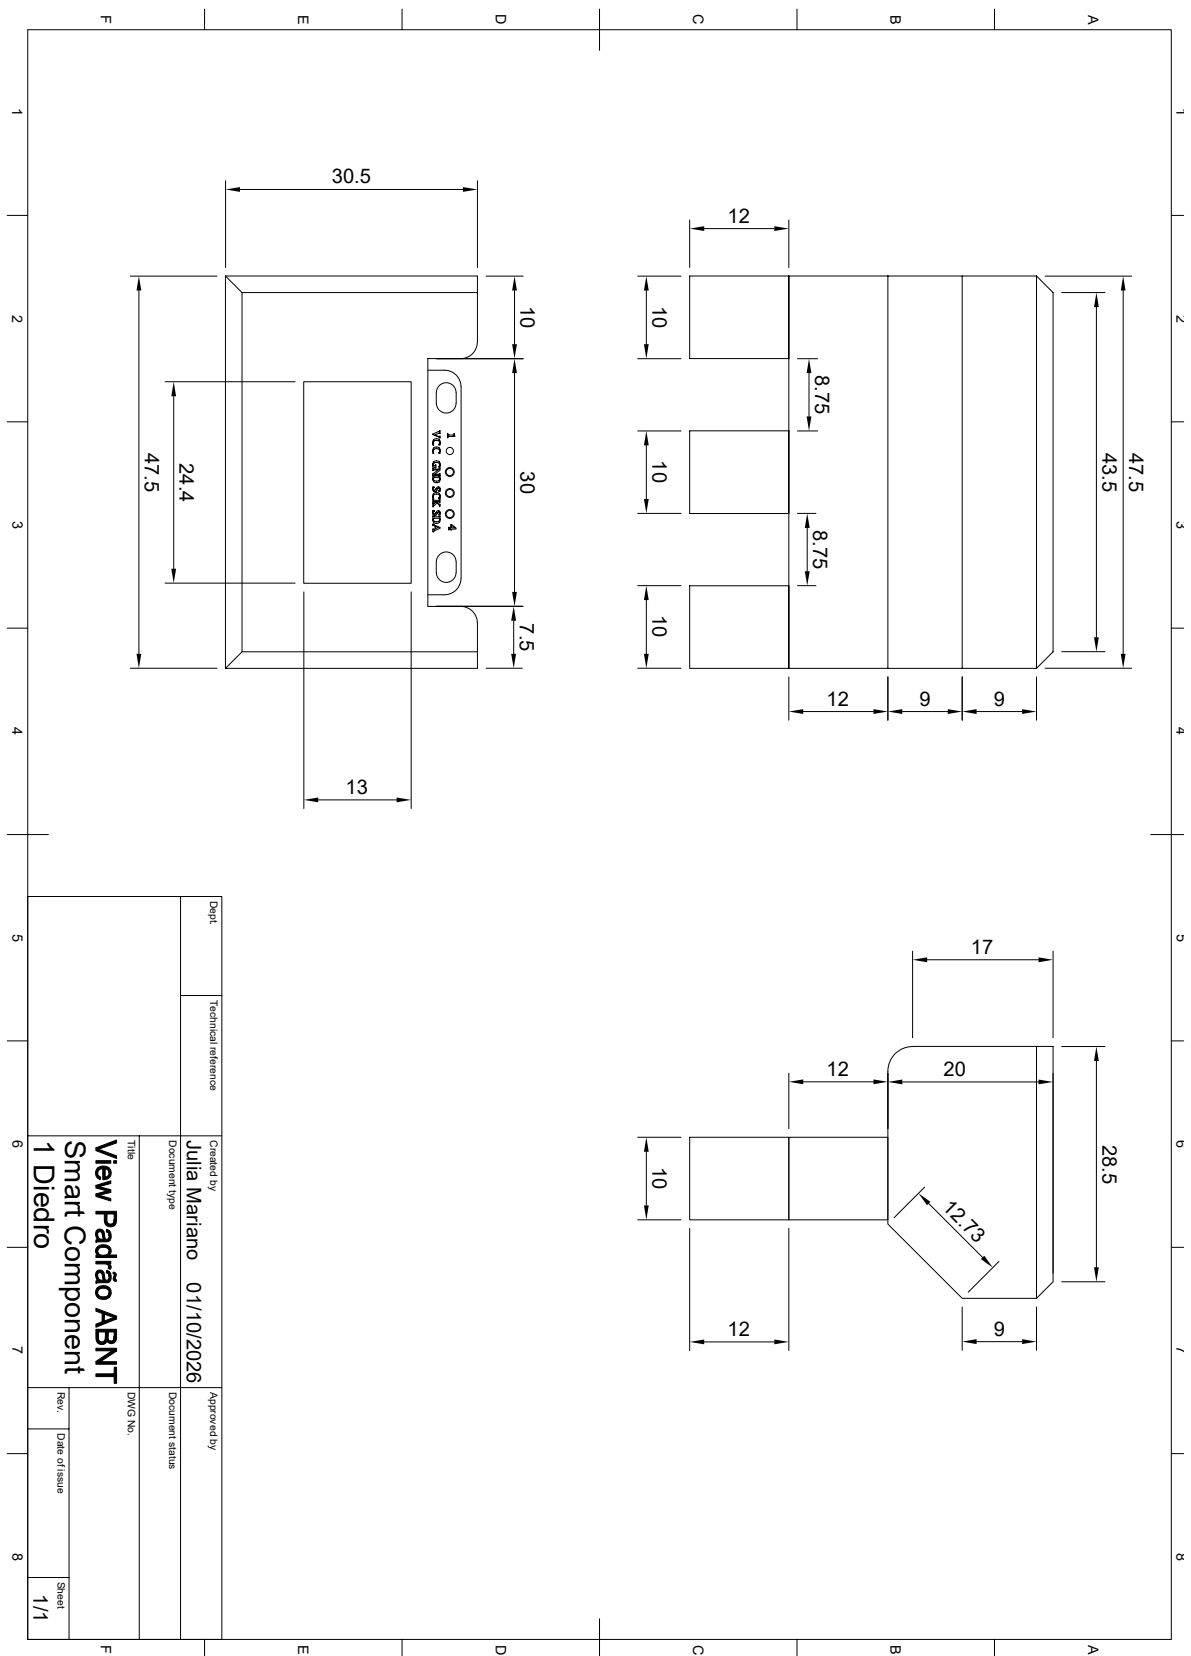
[picture p284: page 1]

1 A 2 3 4 5 6 7 8 1 2 3 4 5 6 7 8 FEDCB FEDCBA Dept. Technical reference Created by Approved by Title DWG No. Document type Document status Rev. Date of issue Sheet 1 Diedro 01/10/2026 1/1 Smart Component Julia Mariano 10 10 10
