gefgu/integration-workshop-3/docs/deliverables/d1_images/componentesbasicosDesenho.pdf

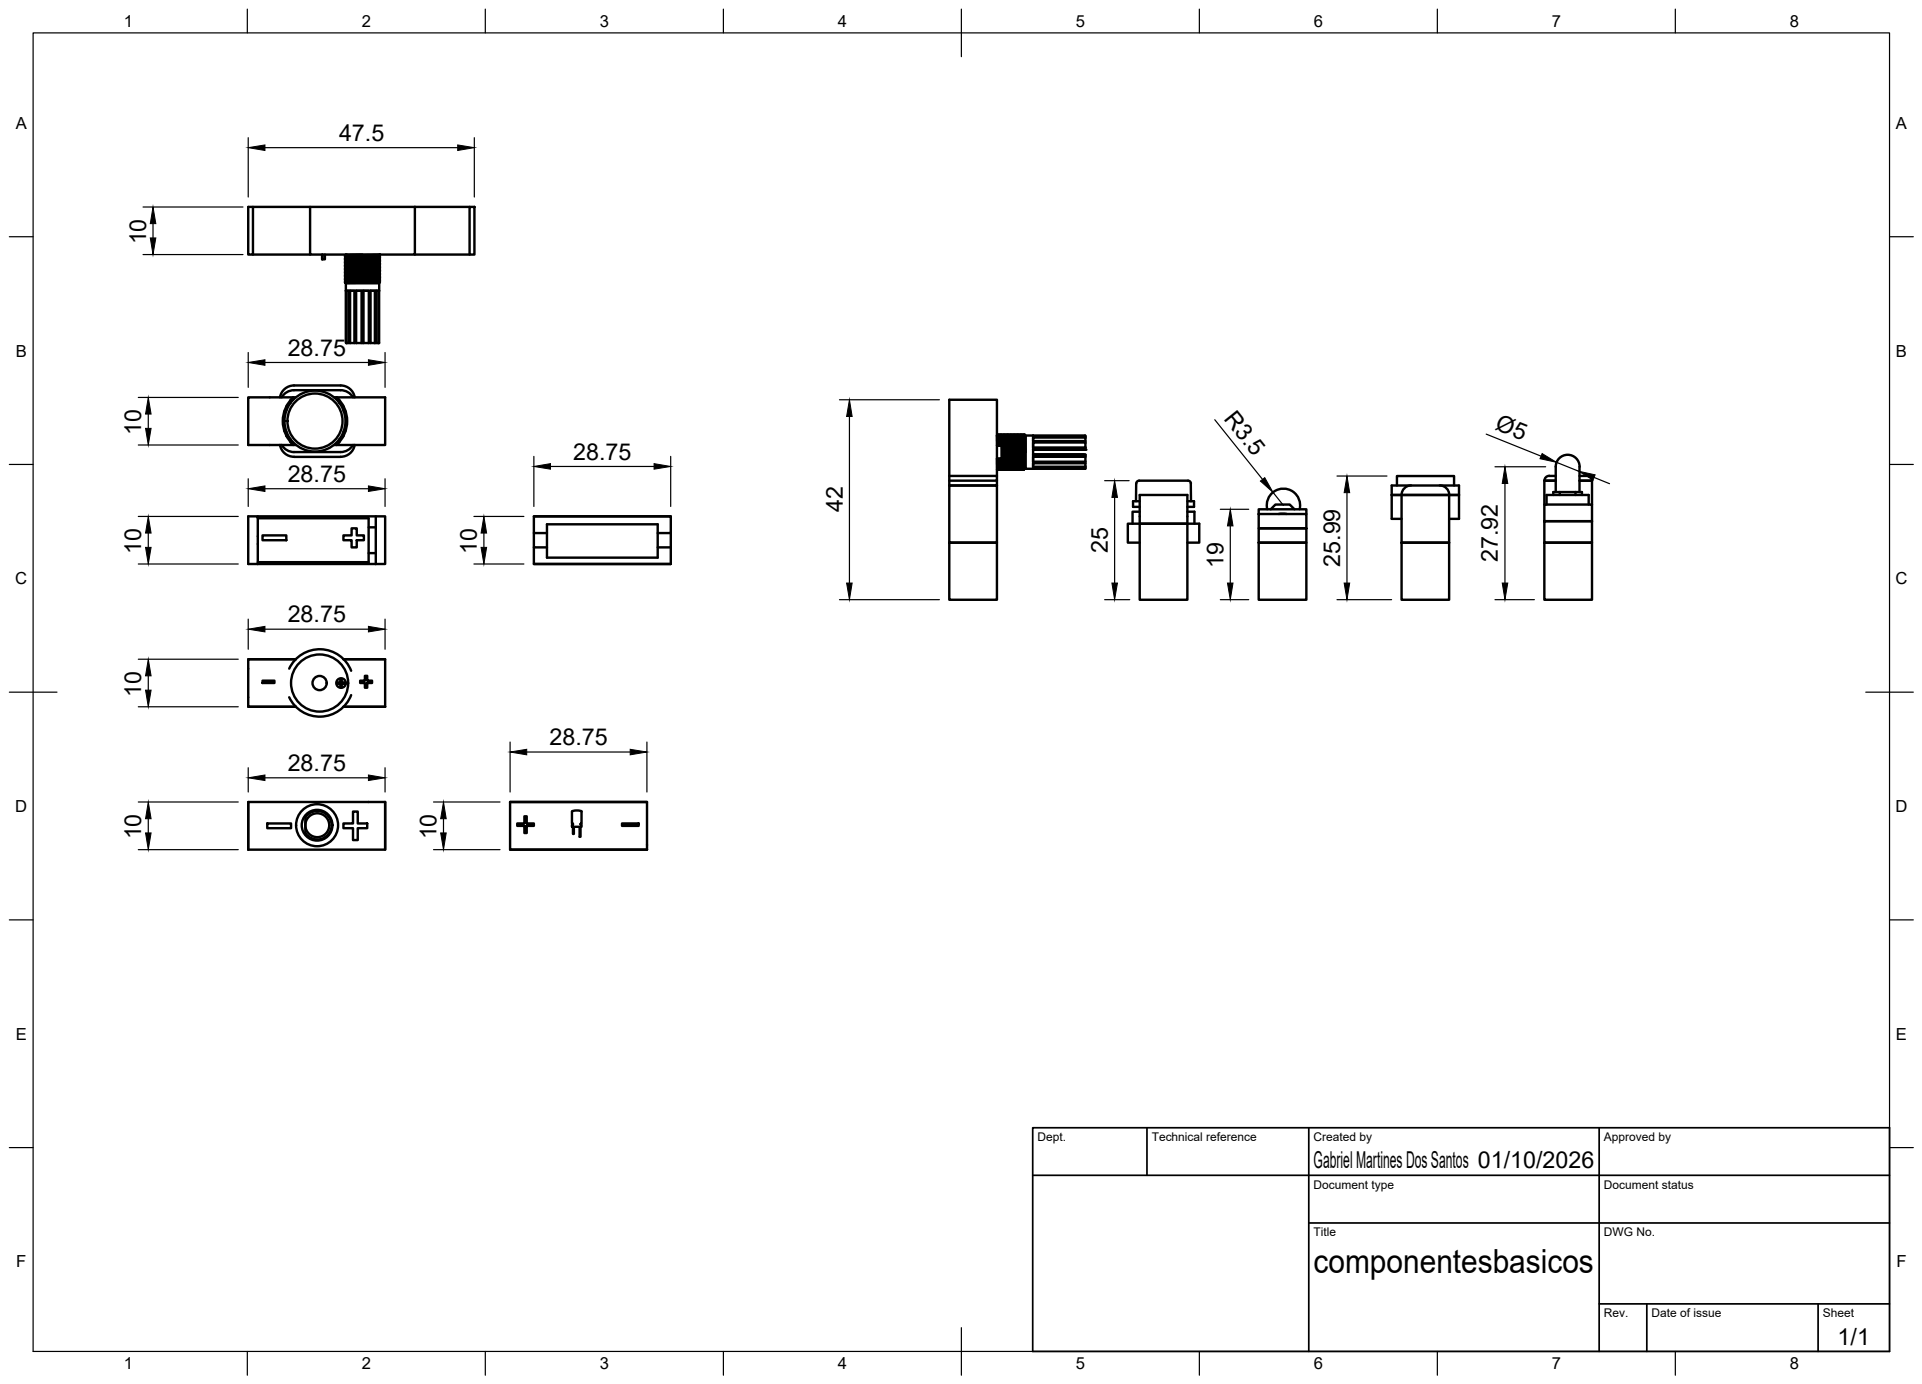
[picture p285: page 1]
Title; DWG No.; Rev.; Date of issue; Sheet; Gabriel Martines Dos Santos 10 10 10 10 10

Dept. | Technical reference | Created by 01/10/2026 | Approved by

Document type | Document status
