gefgu/integration-workshop-3/eletronics/perfboard/tscircuit/revision8/overall-schematic.pdf

A | B | C | D | E | F | G | H

1

2

3

4

5

# Complete system — overview

## Four functional sections • explicit interfaces • detailed circuits on sheets 2–16

# Terminal contacts

### Contact A + contact B

### 22 independent NODE nets

### Six OLED service interfaces

### Grouped NODE + SMART cables

### Detail: sheet 2

# Smart components

### ESP2 + independent watchdog

### Voltage sensing in both banks

### Six protected P3 / current paths

### Six isolated B-side service buses

### At most three active capsules

### Details: sheets 5–16

| 22 NODEs · six 4-pin cables
Power board 12 V input and buck modules Independent 5 V / 3V3 guards Current trip and fault latch Protected student supply Detail: sheet 3 | | Routing matrix ESP1 and watchdog Two MT8816 analog matrices Diagnostic and peripheral I/O Pi separately powered Detail: sheet 4

P1/P2/P3 + six independent service buses

10-pin power/control

GND / 3V3

5V_SYS · 3V3_SYS · GND · EDU_ON → smart power

NODE taps / diagnostic fixture

Bundle lines contain separate conductors. Exact pins and nets are shown on detailed sheets.

## POWER red • GND black • NODE blue • ANALOG green • CONTROL ochre • I²C grey/white

Junction dot = connected. Named pins and flags identify continuations; see net index. Modules show interface pins.

# TedTronics — electrical schematic

## Revision8 candidate • circuit consistency checks; hardware qualification pending A2 landscape

# Terminal contacts

## Bank A and bank B • 22 independent NODEs • six OLED service interfaces

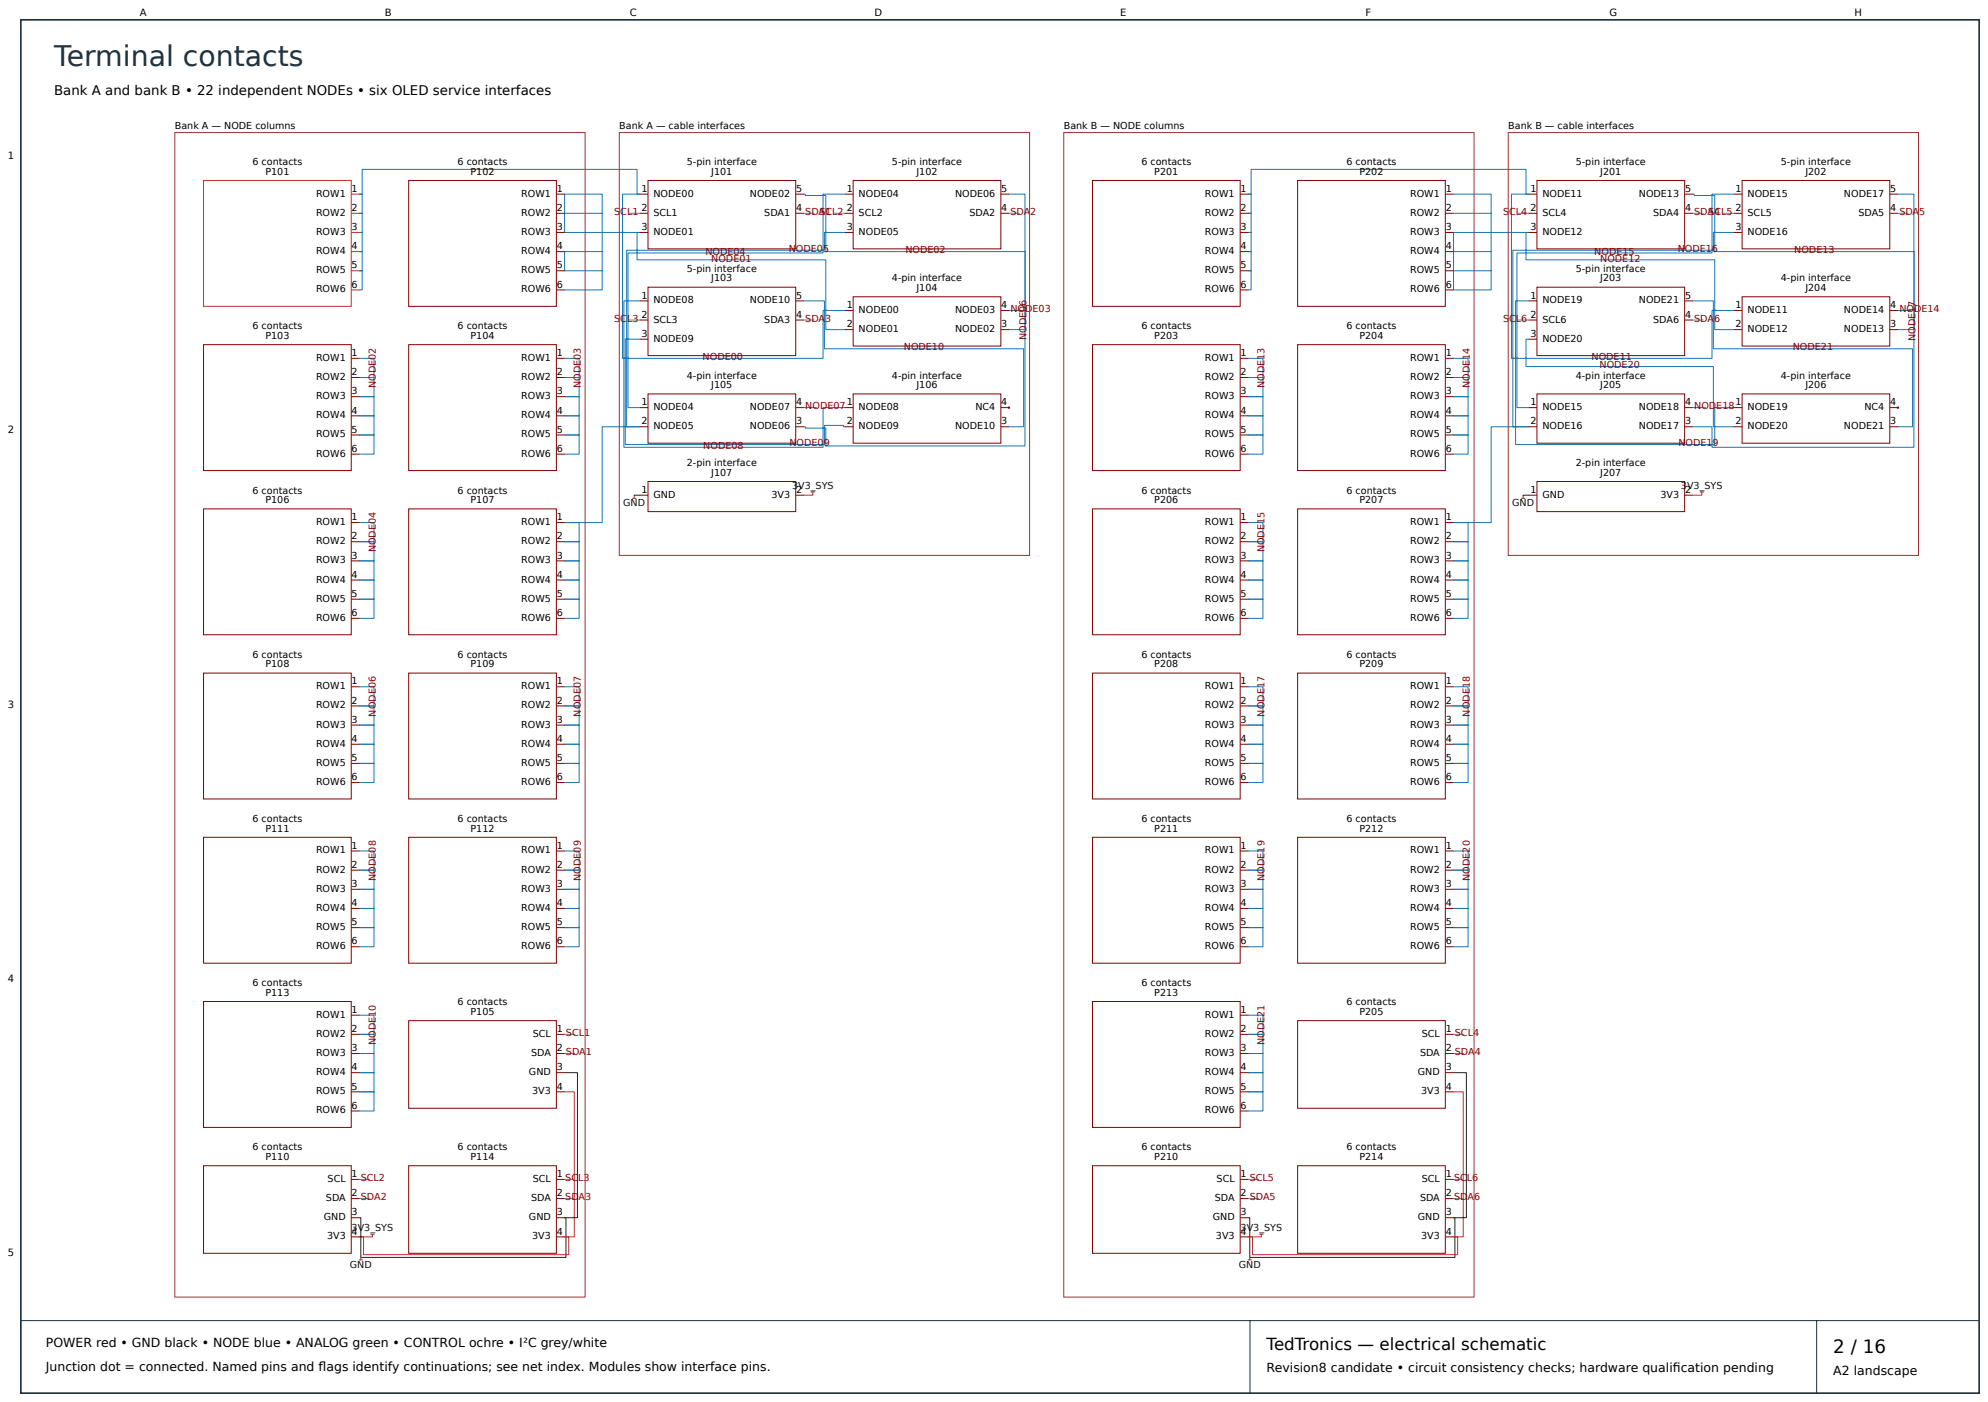
[picture p286: page 2]

# Power board

## Input → independent voltage guards → current trip → protected student output

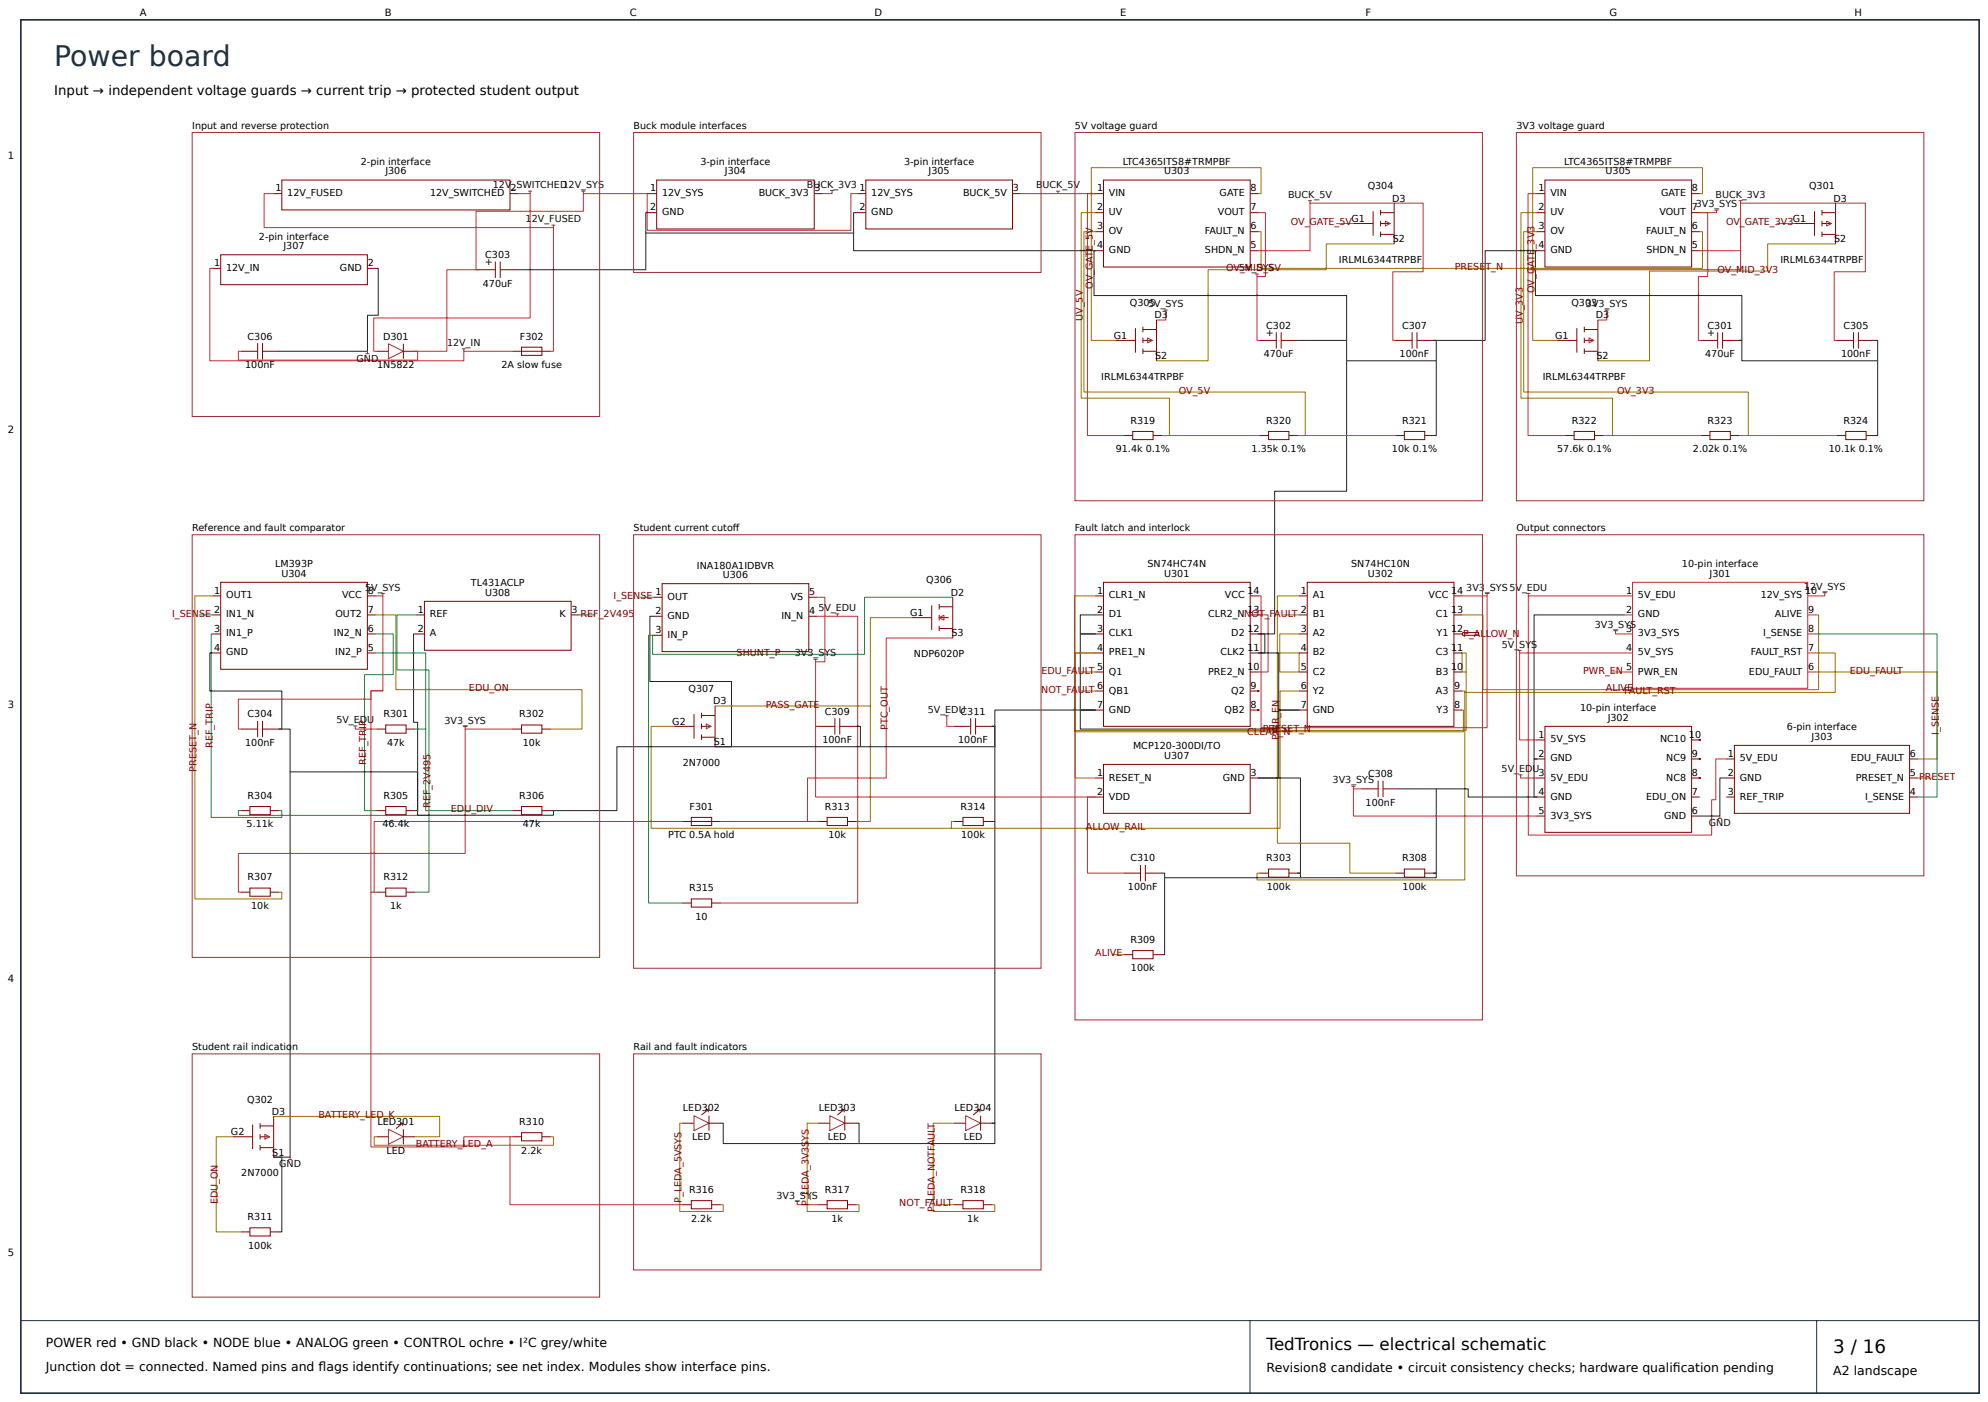
[picture p287: page 3]

# Routing matrix and peripherals

## ESP1 • watchdog • two MT8816 matrices • Pi and RFID interfaces

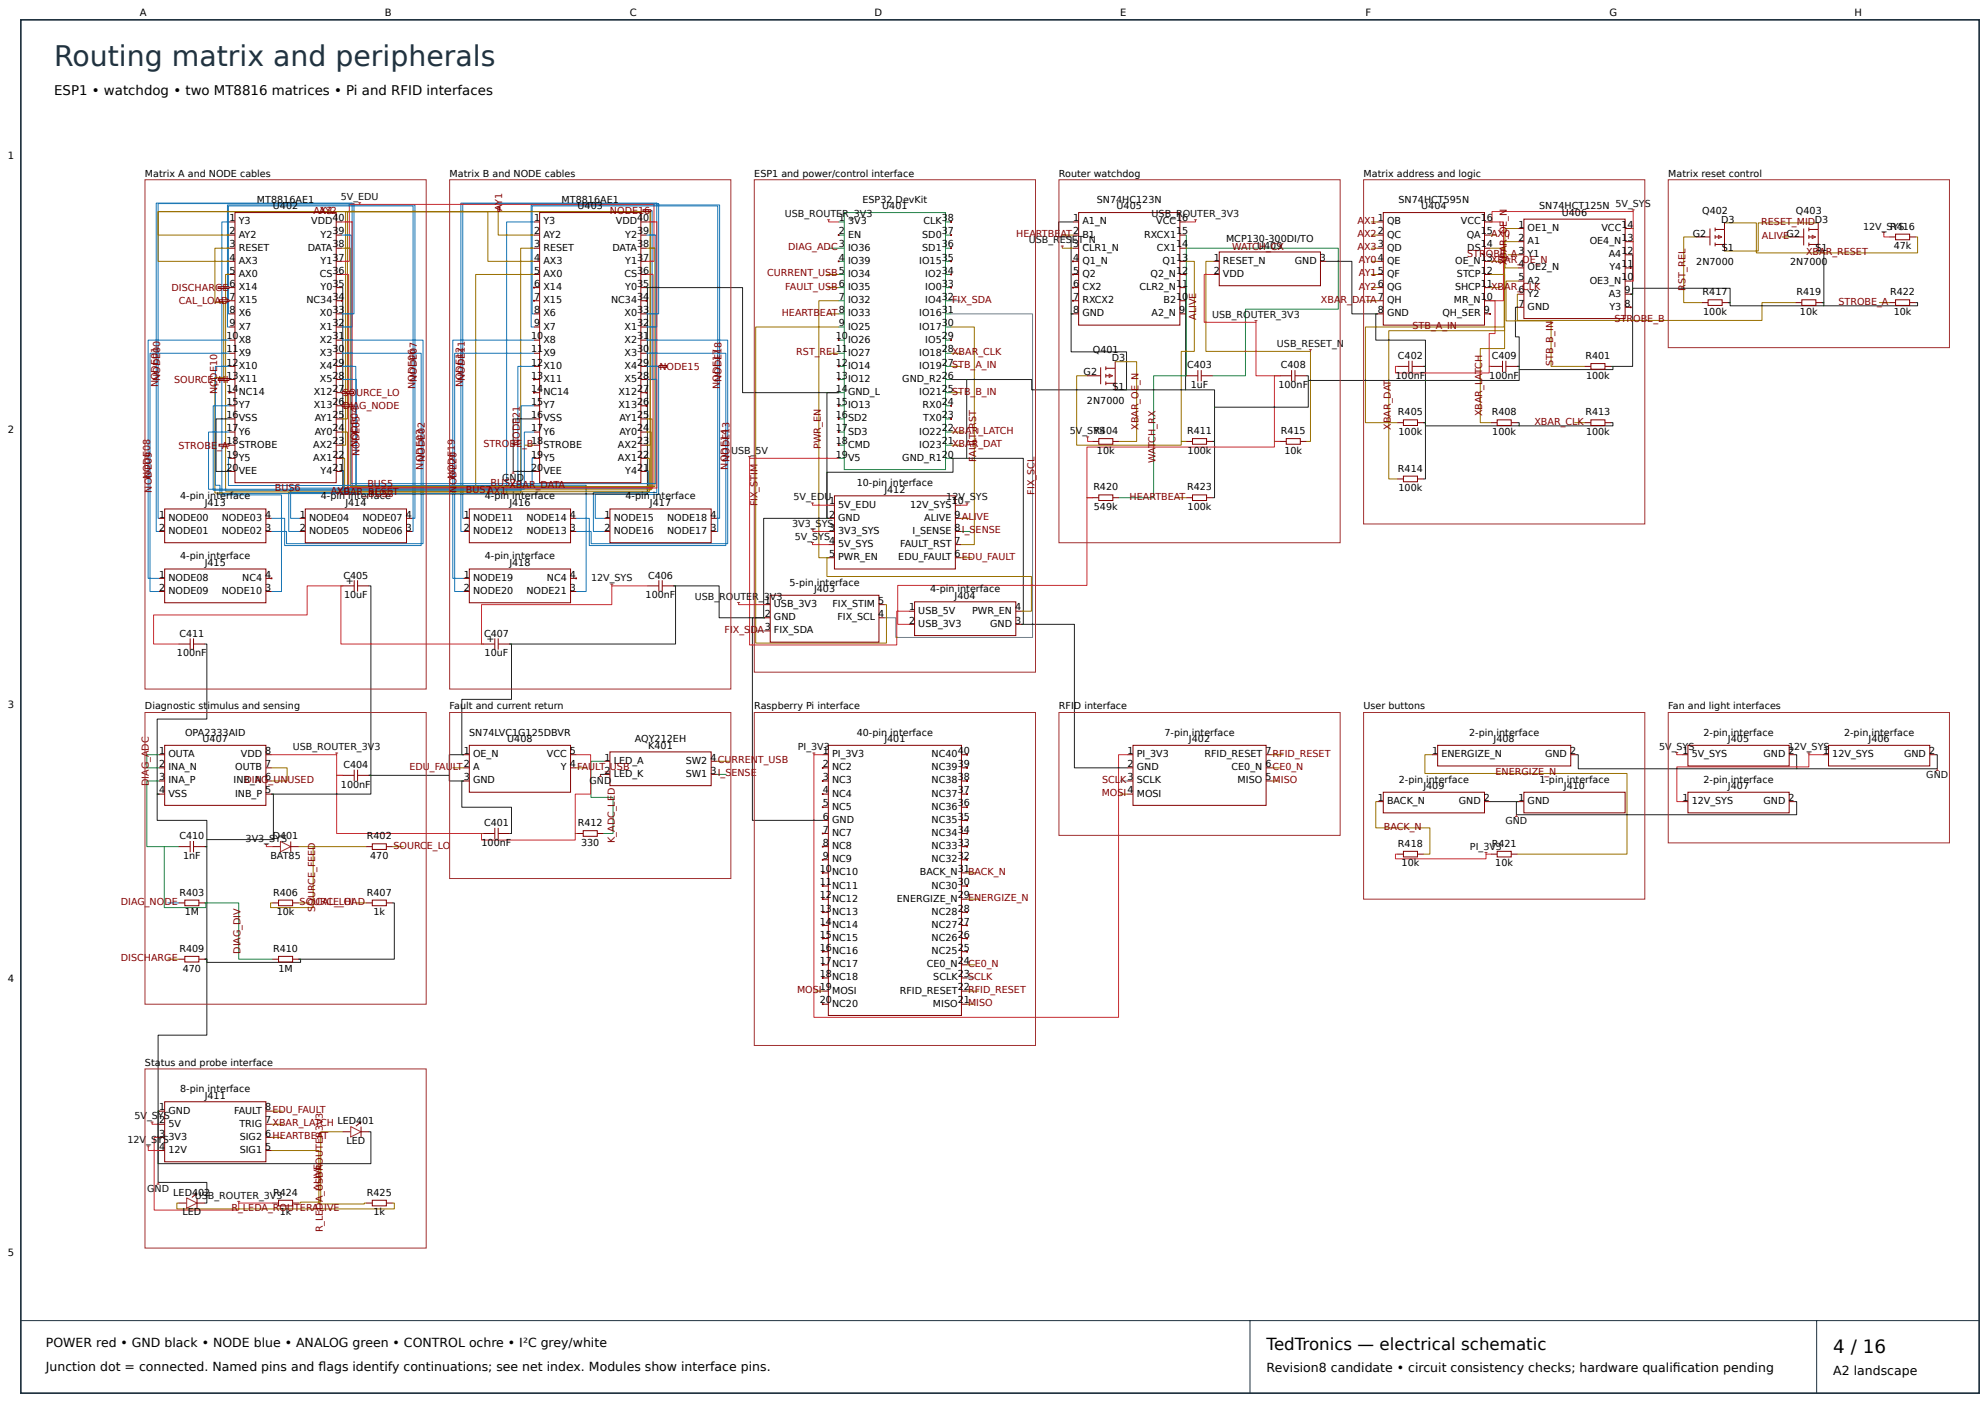
[picture p288: page 4]

BUS6 | AX0 | BUS7 | AX1 | XBAR_DATA

Status and probe interface

# Smart controller

## ESP2 • six SDA channels • shared A-side SCL • bank selection • joystick

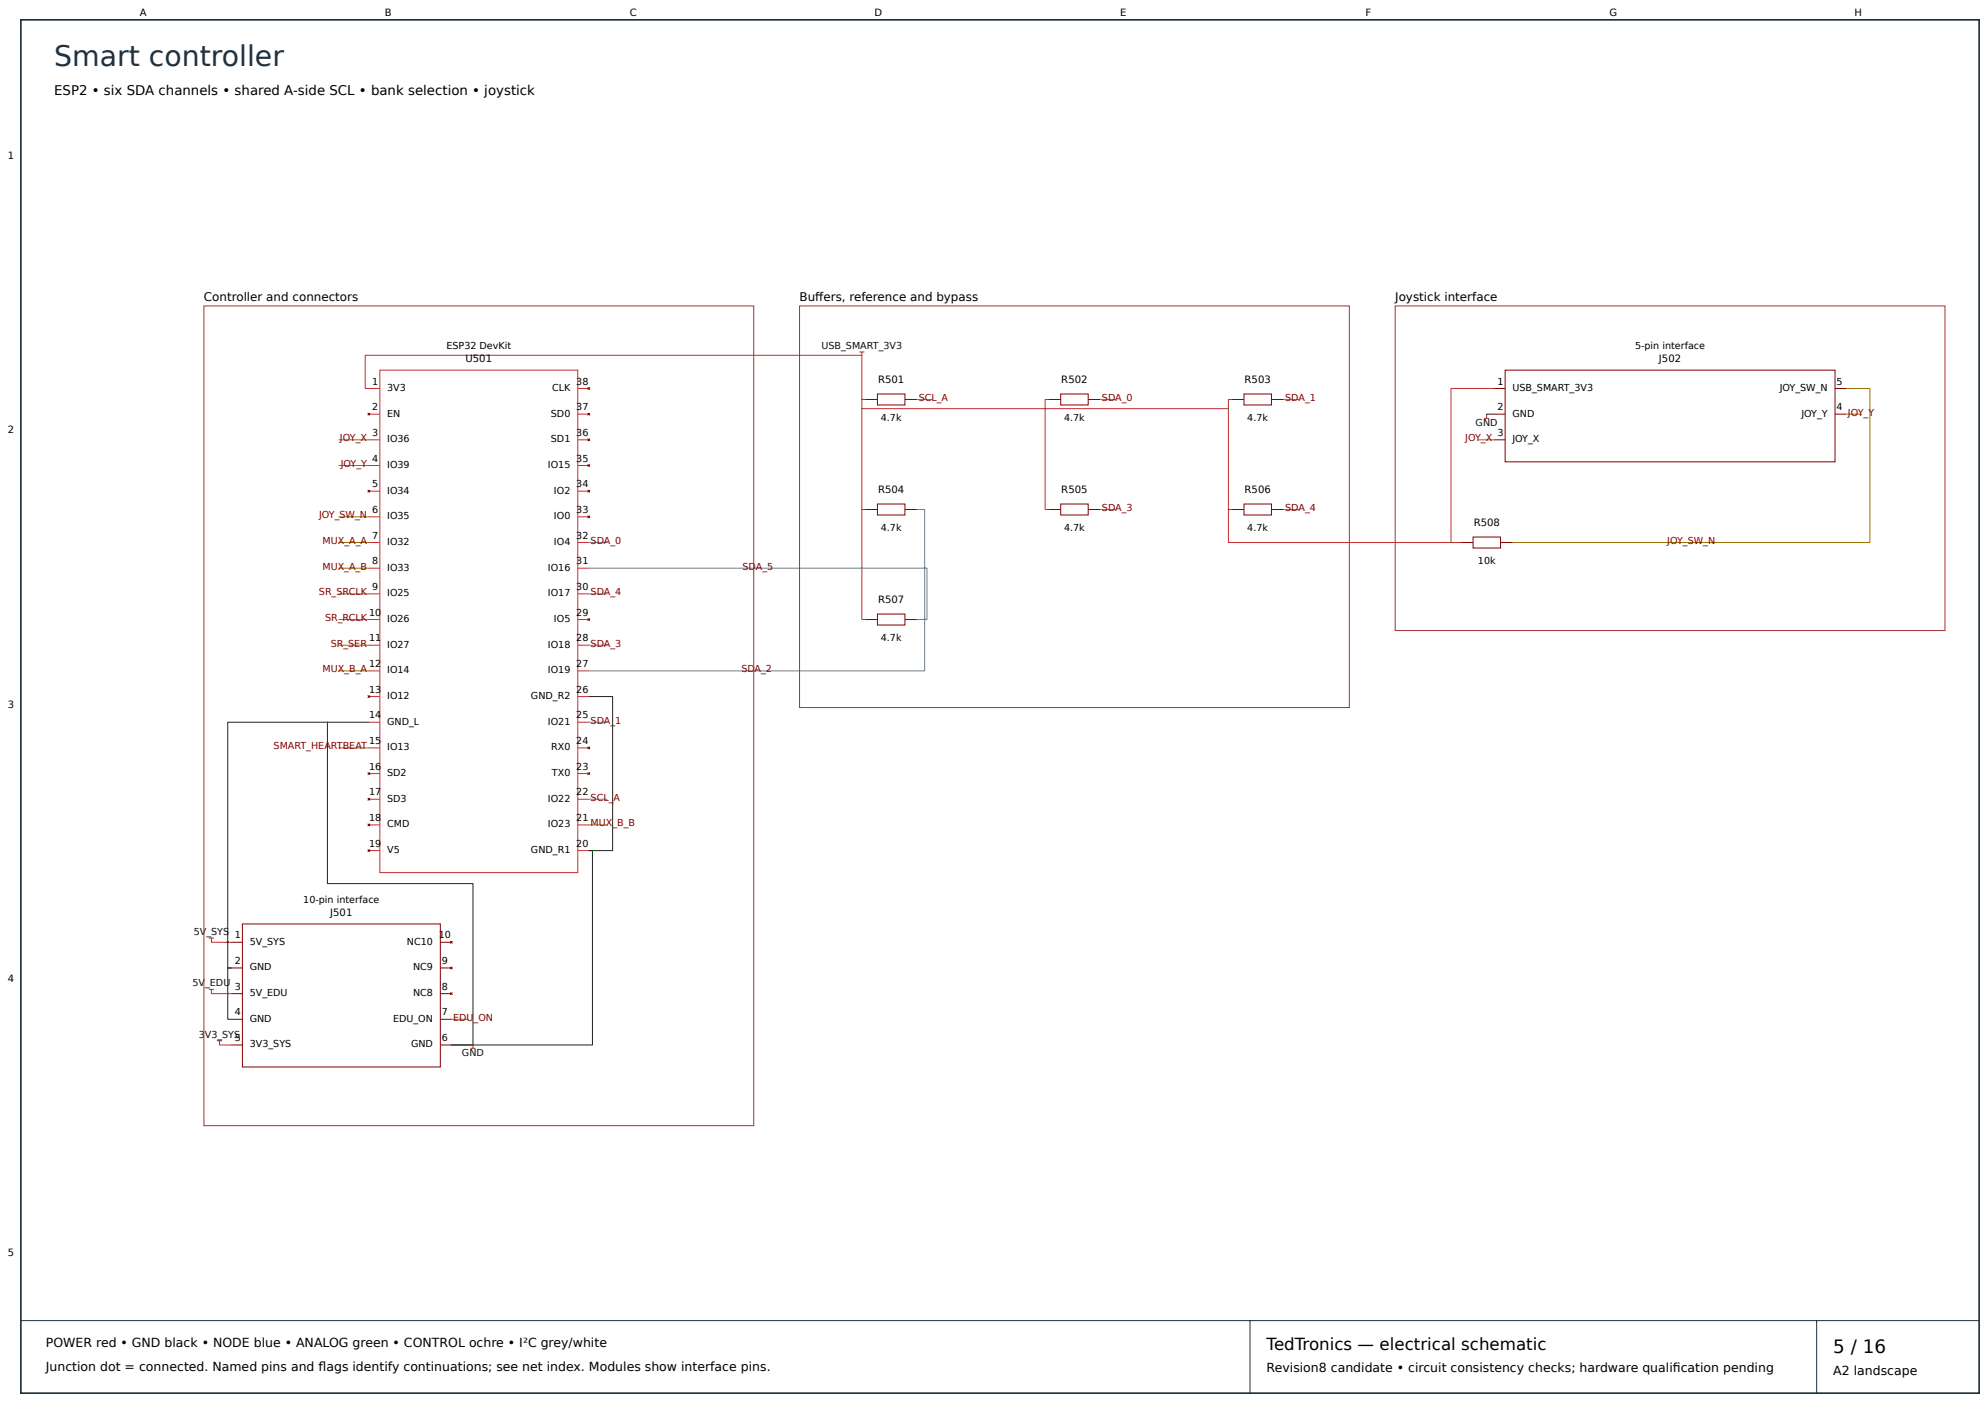
[picture p289: page 5]

# Smart safety and register control

## Independent watchdog • default-off output enable • three cascaded registers

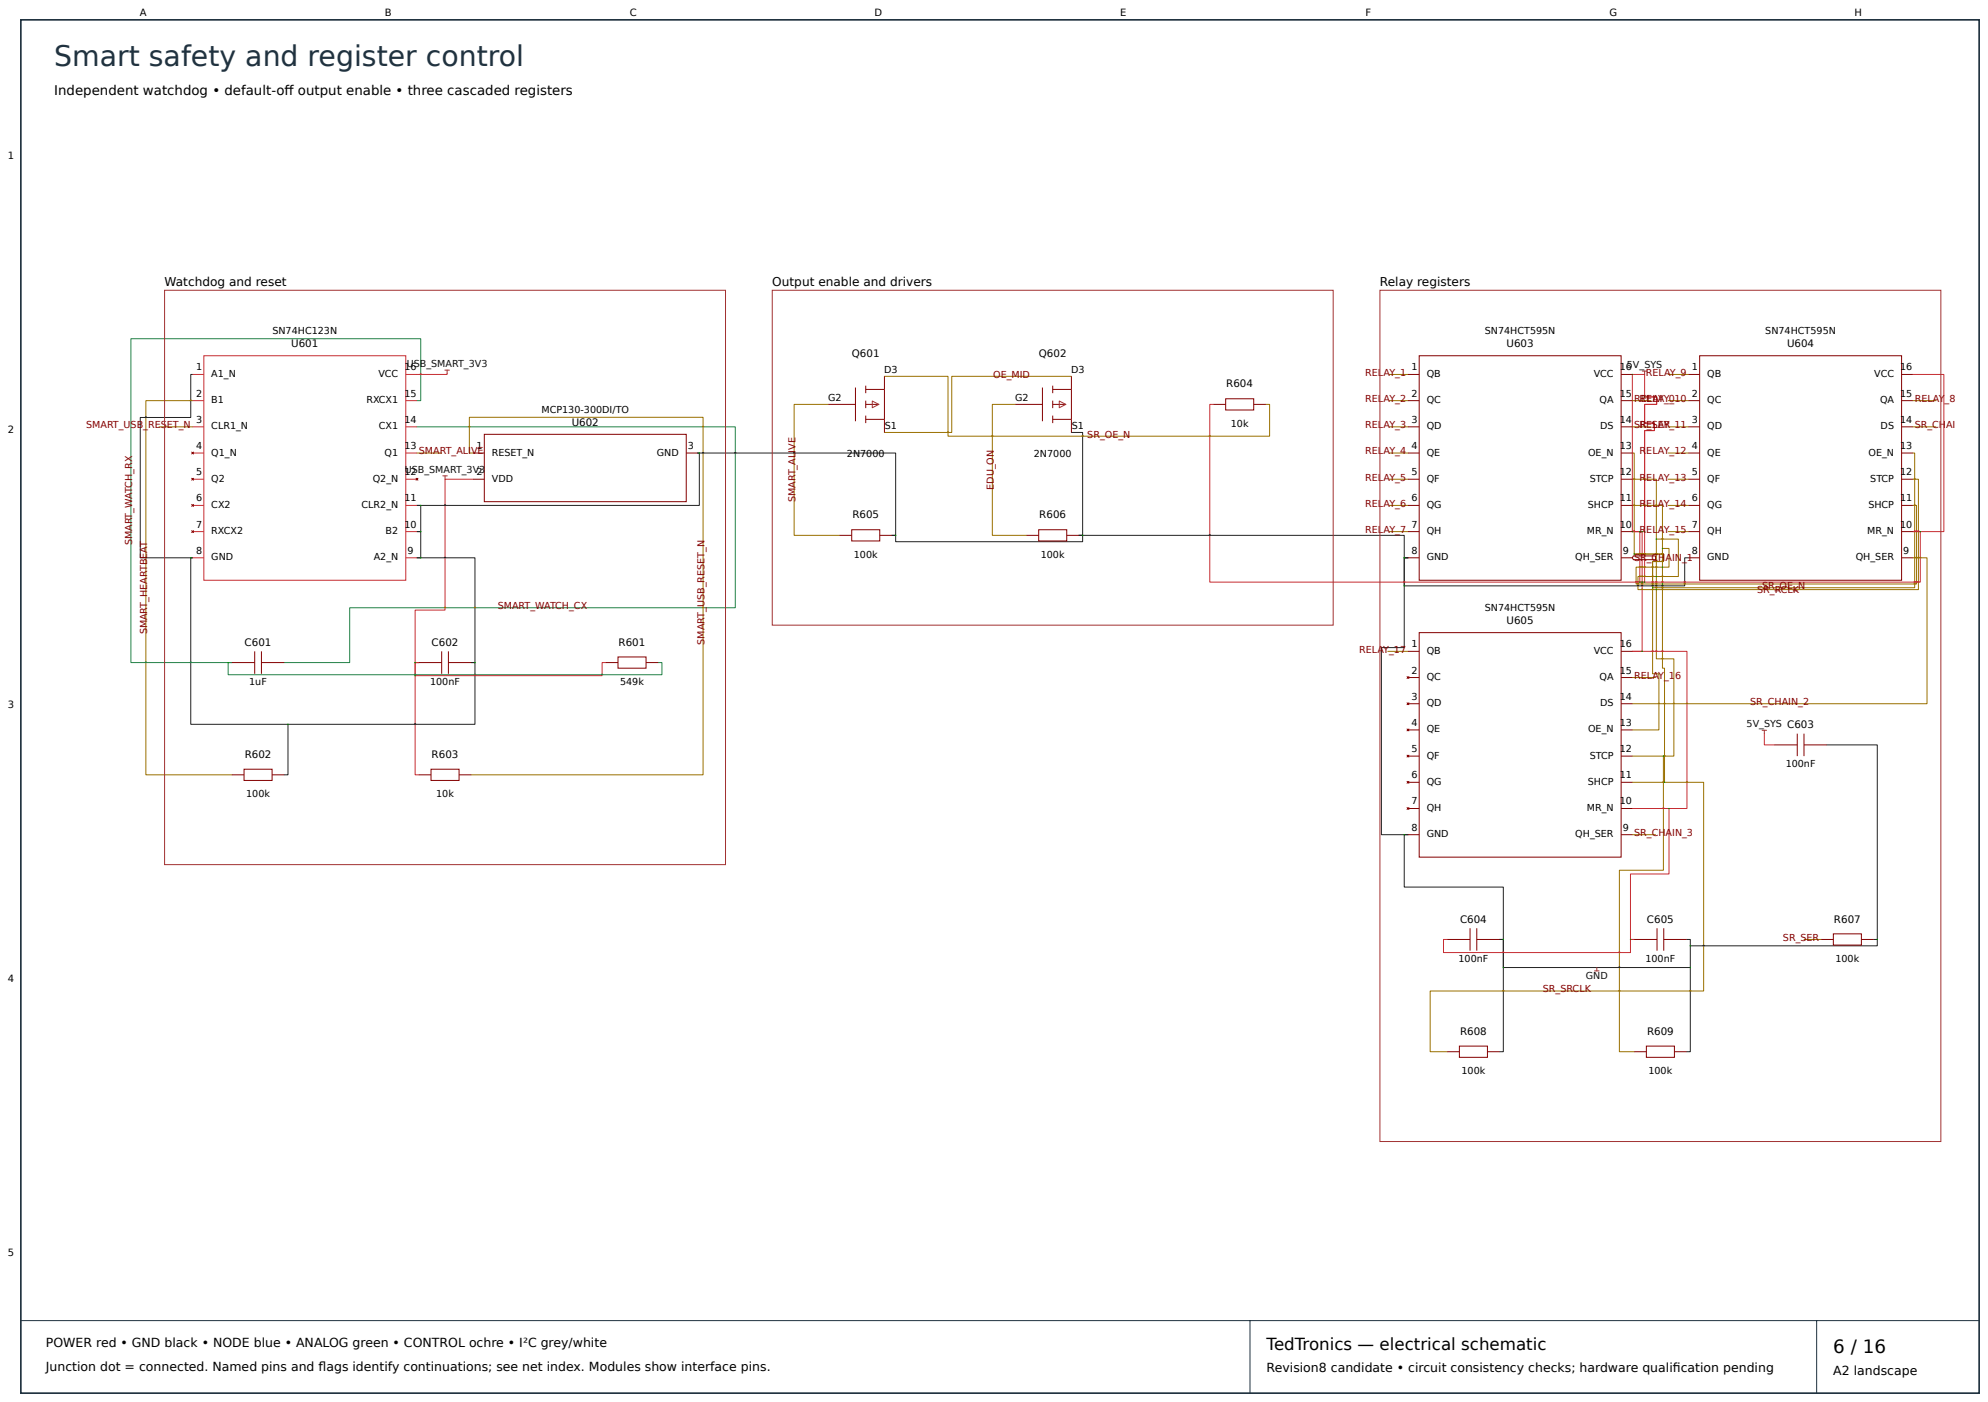
[picture p290: page 6]

# Measurement bank A — Precision sensing and bank selector

Buffered voltage sensing • ADS1115 interfaces • named continuations to the smart positions

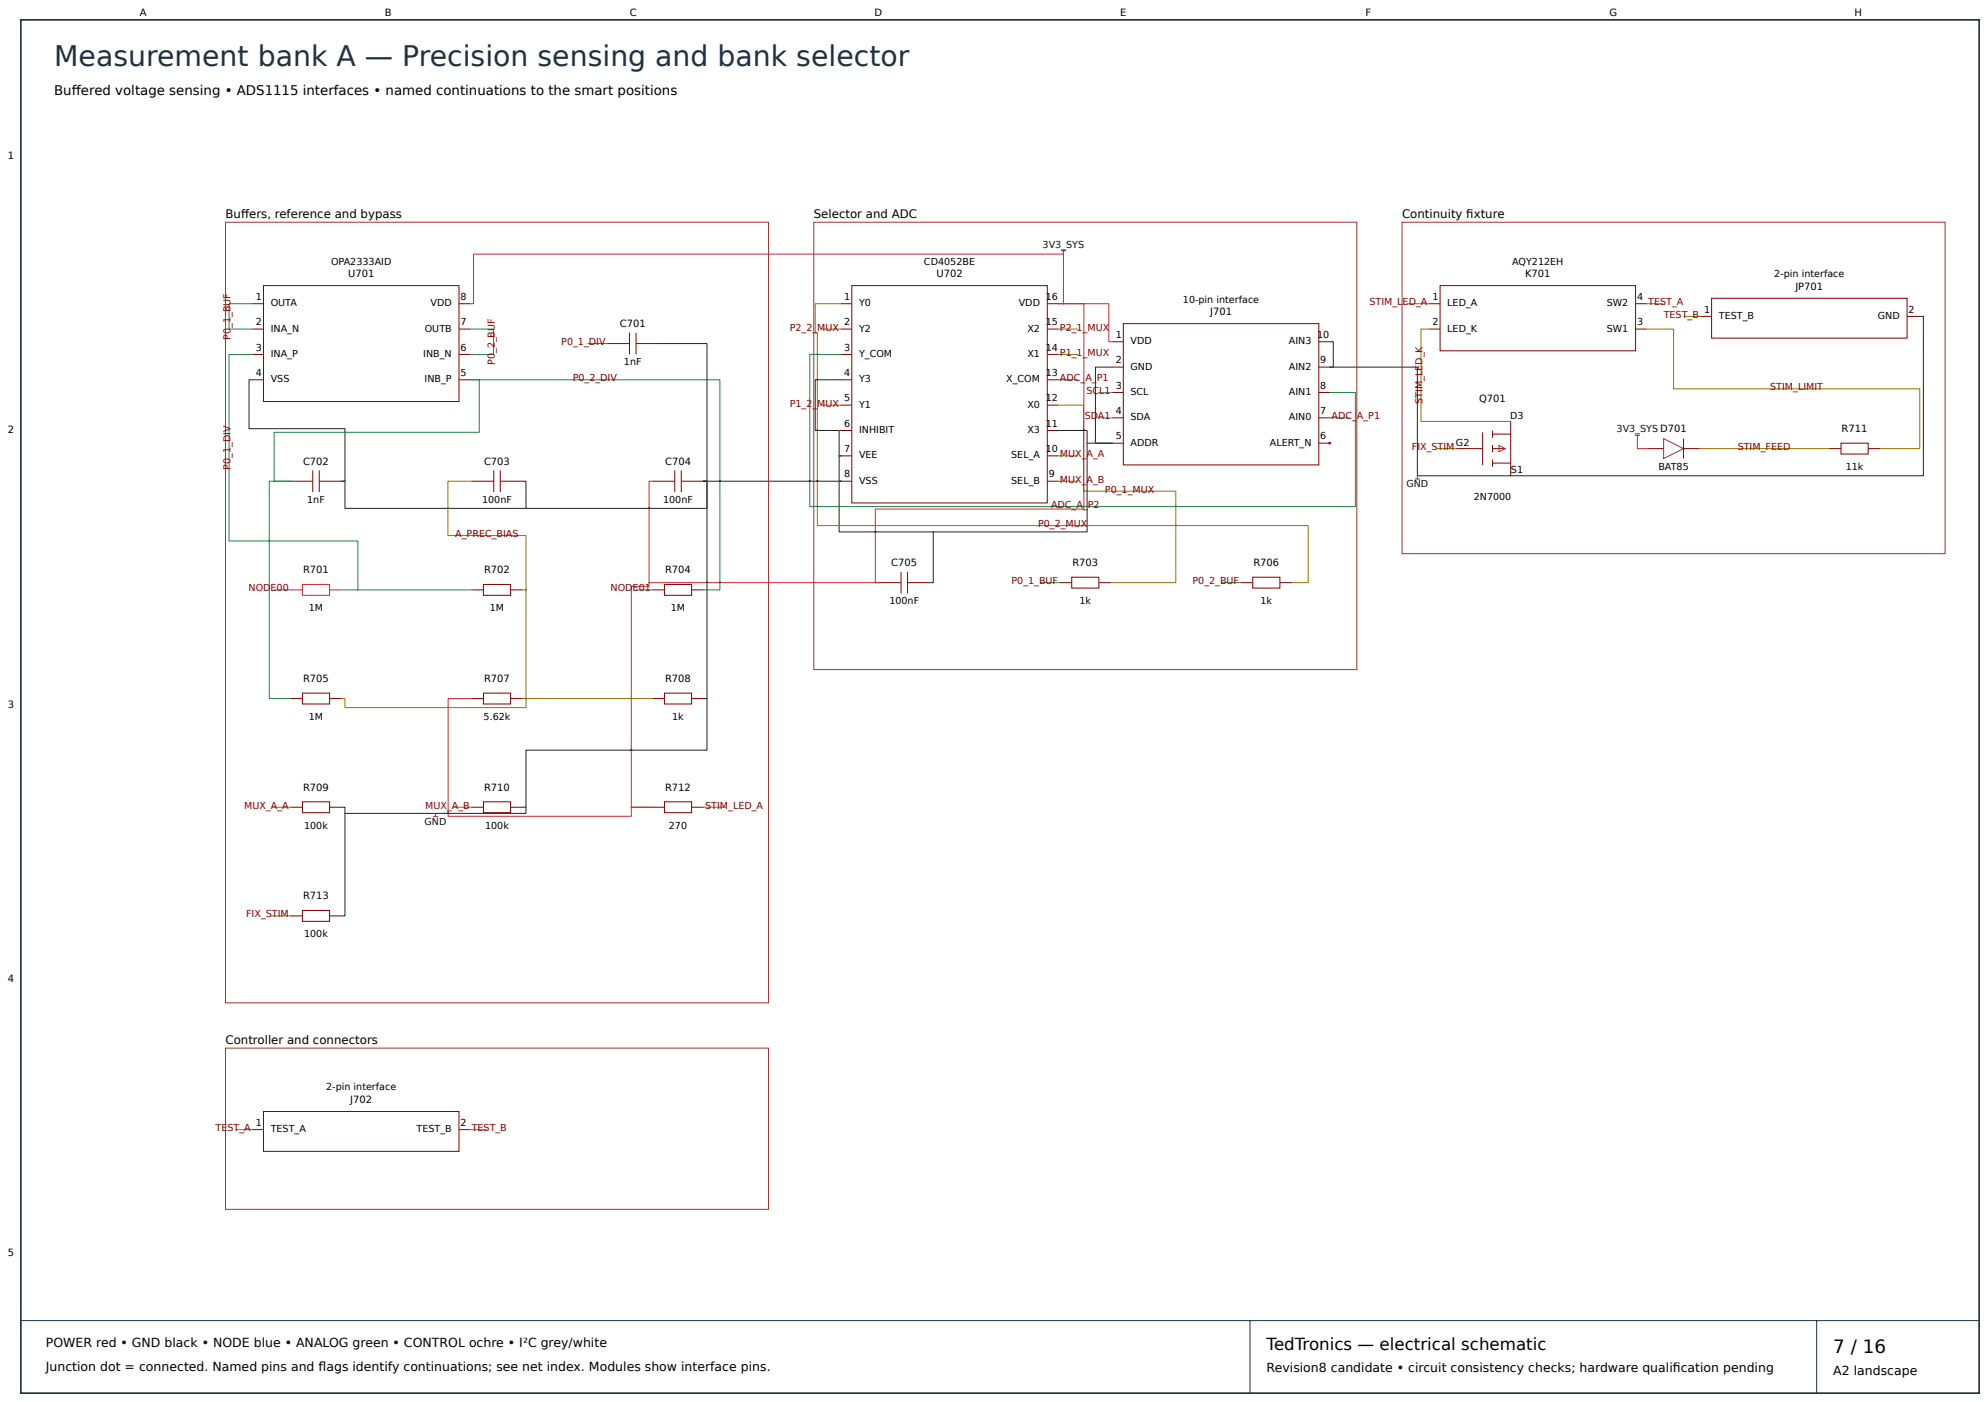
[picture p291: page 7]

# Measurement bank A — Buffered inputs and references

Buffered voltage sensing • ADS1115 interfaces • named continuations to the smart positions

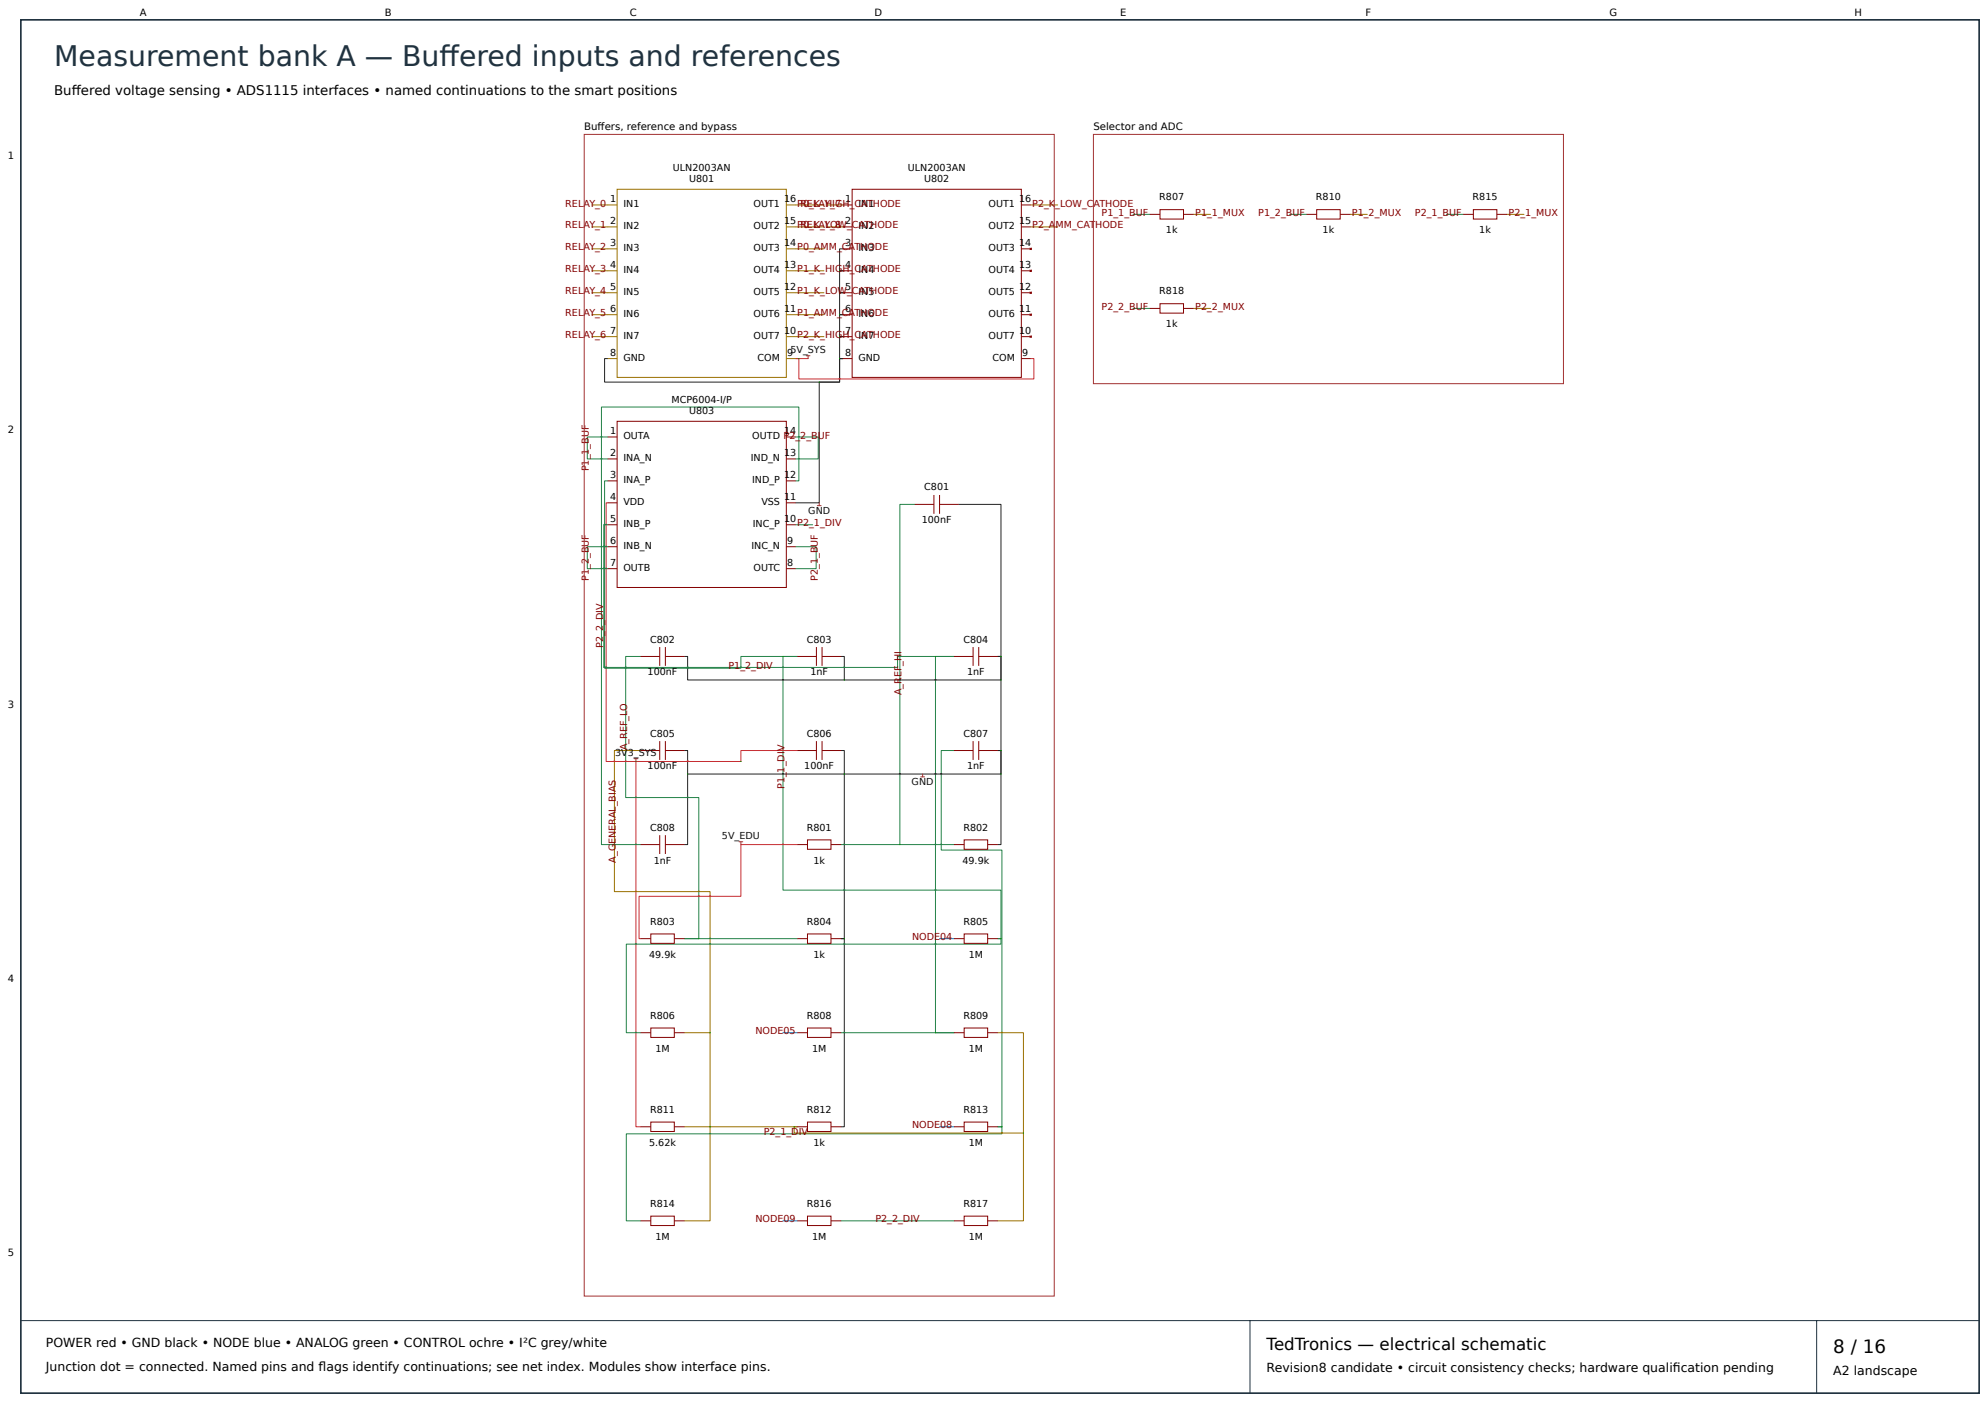
[picture p292: page 8]

3V3_SYS

# Measurement bank B — Precision sensing and bank selector

Buffered voltage sensing • ADS1115 interfaces • named continuations to the smart positions

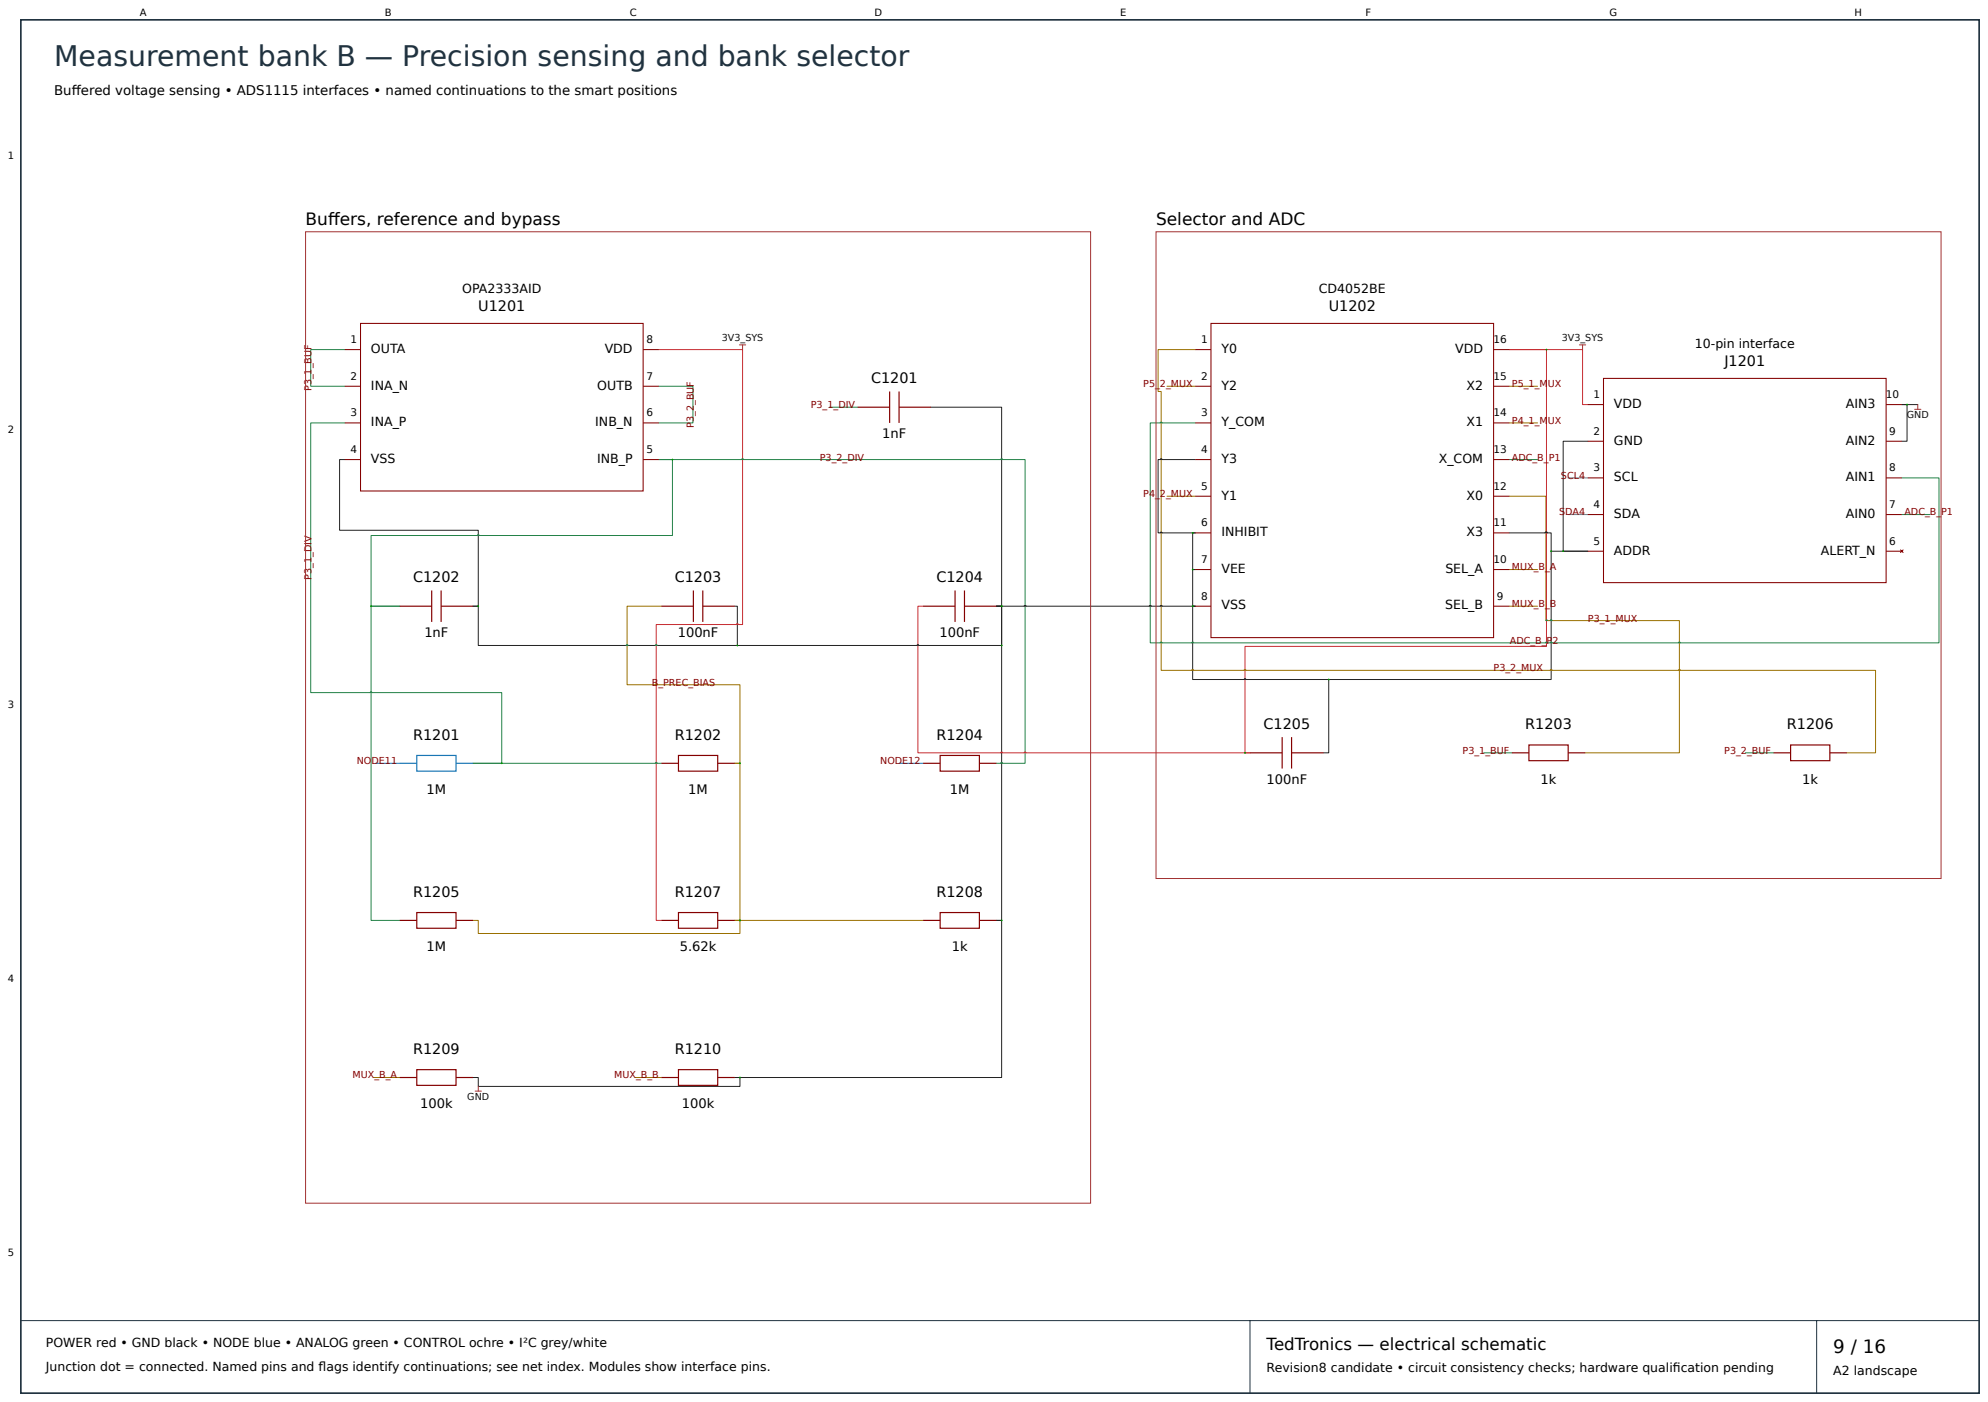
[picture p293: page 9]

# Measurement bank B — Buffered inputs and references

Buffered voltage sensing • ADS1115 interfaces • named continuations to the smart positions

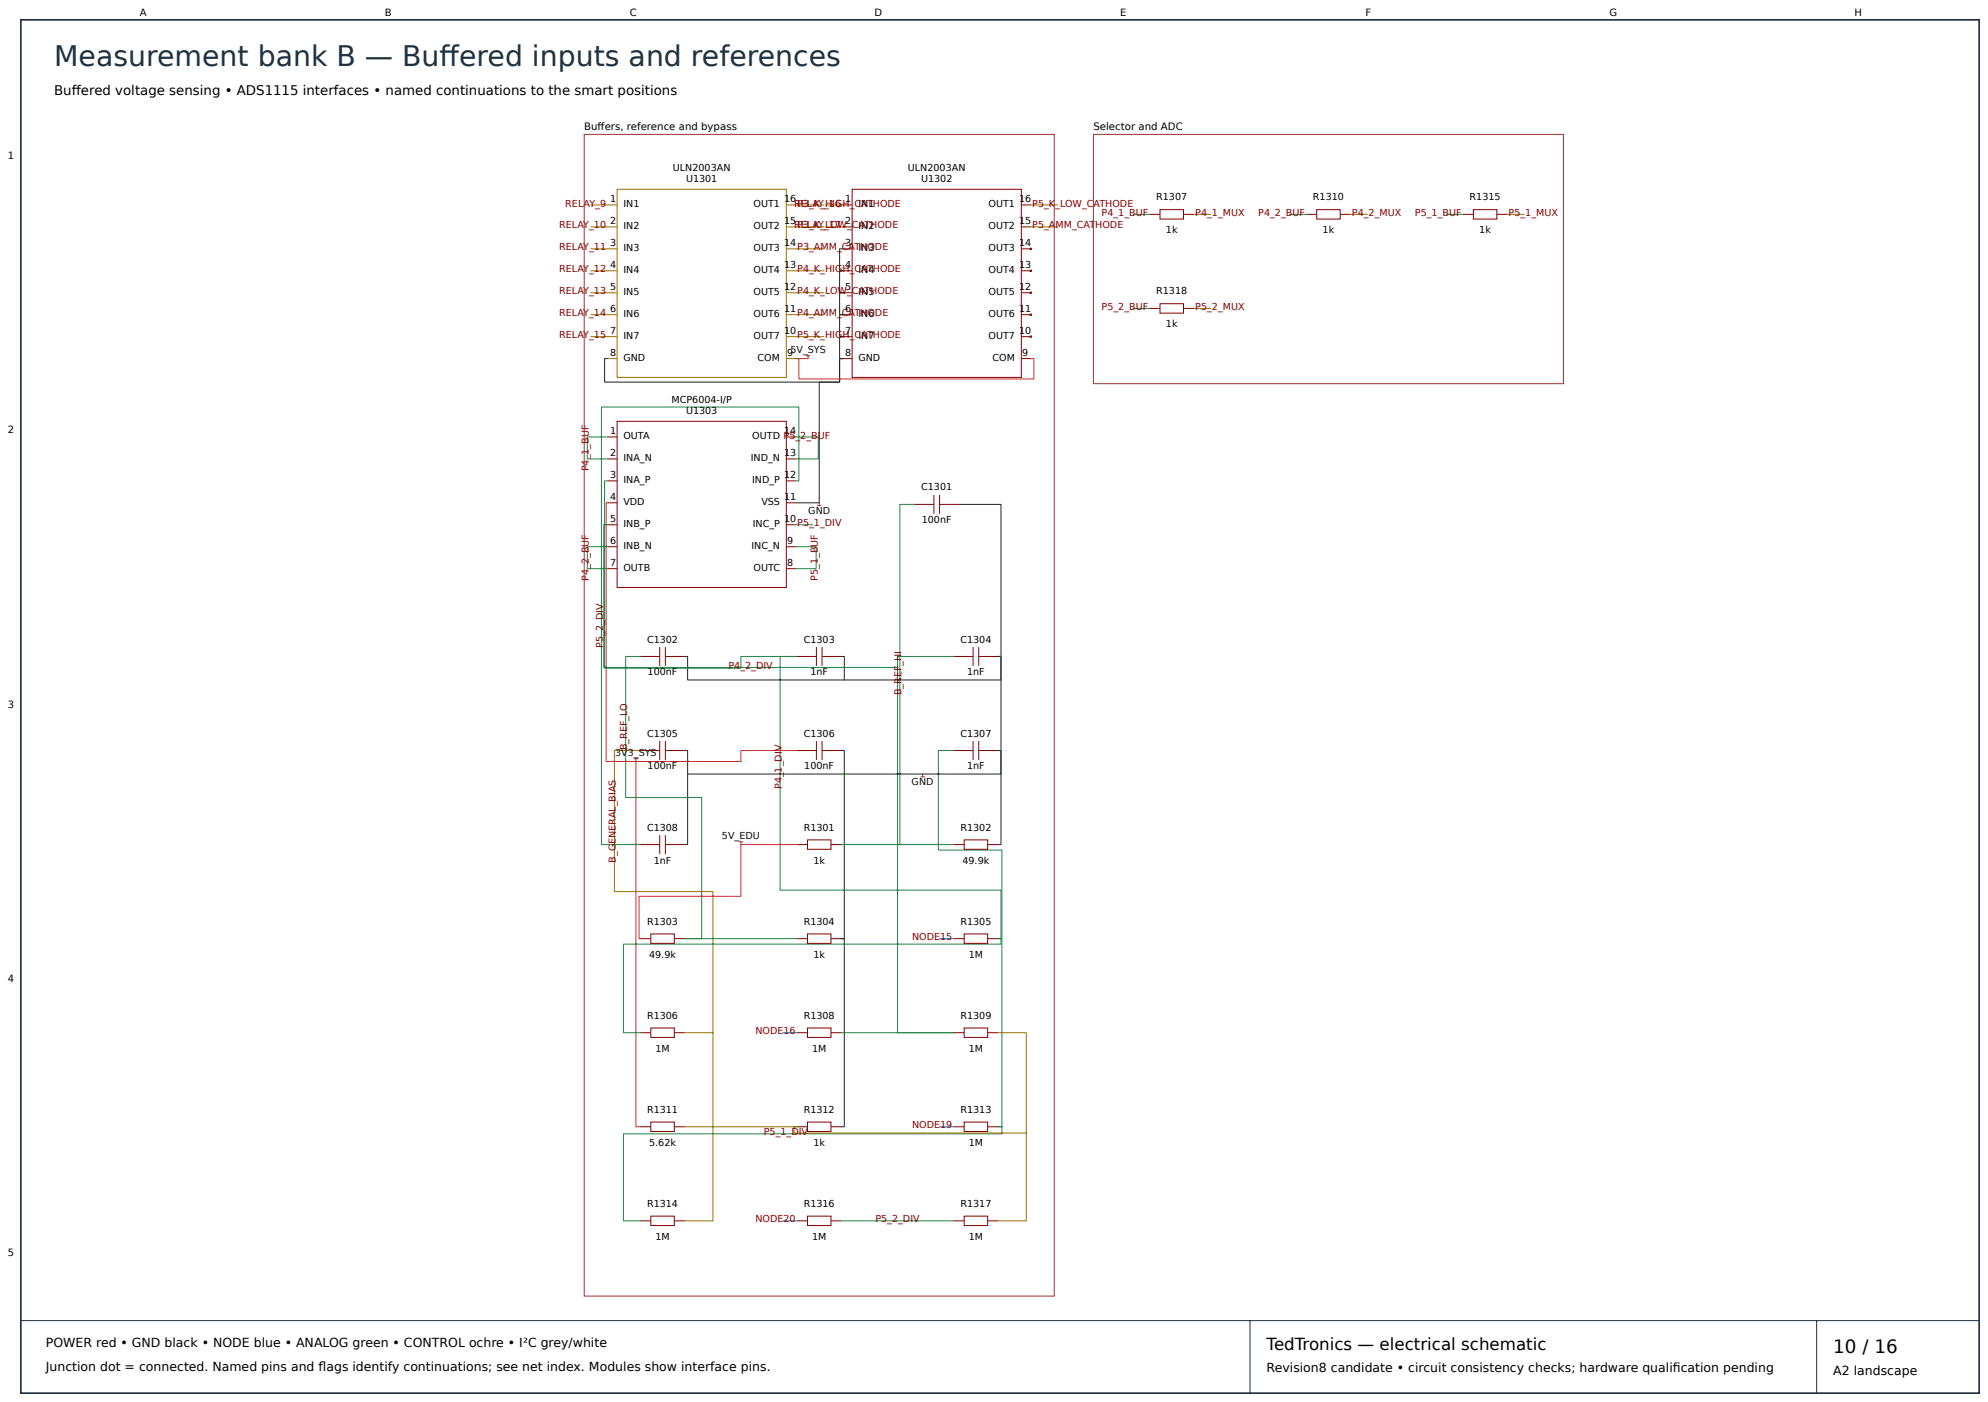
[picture p294: page 10]

3V3_SYS

# Smart position 1 — bank A

Isolated service bus • protected P3 source/sink • isolated current path • OLED capsule interface

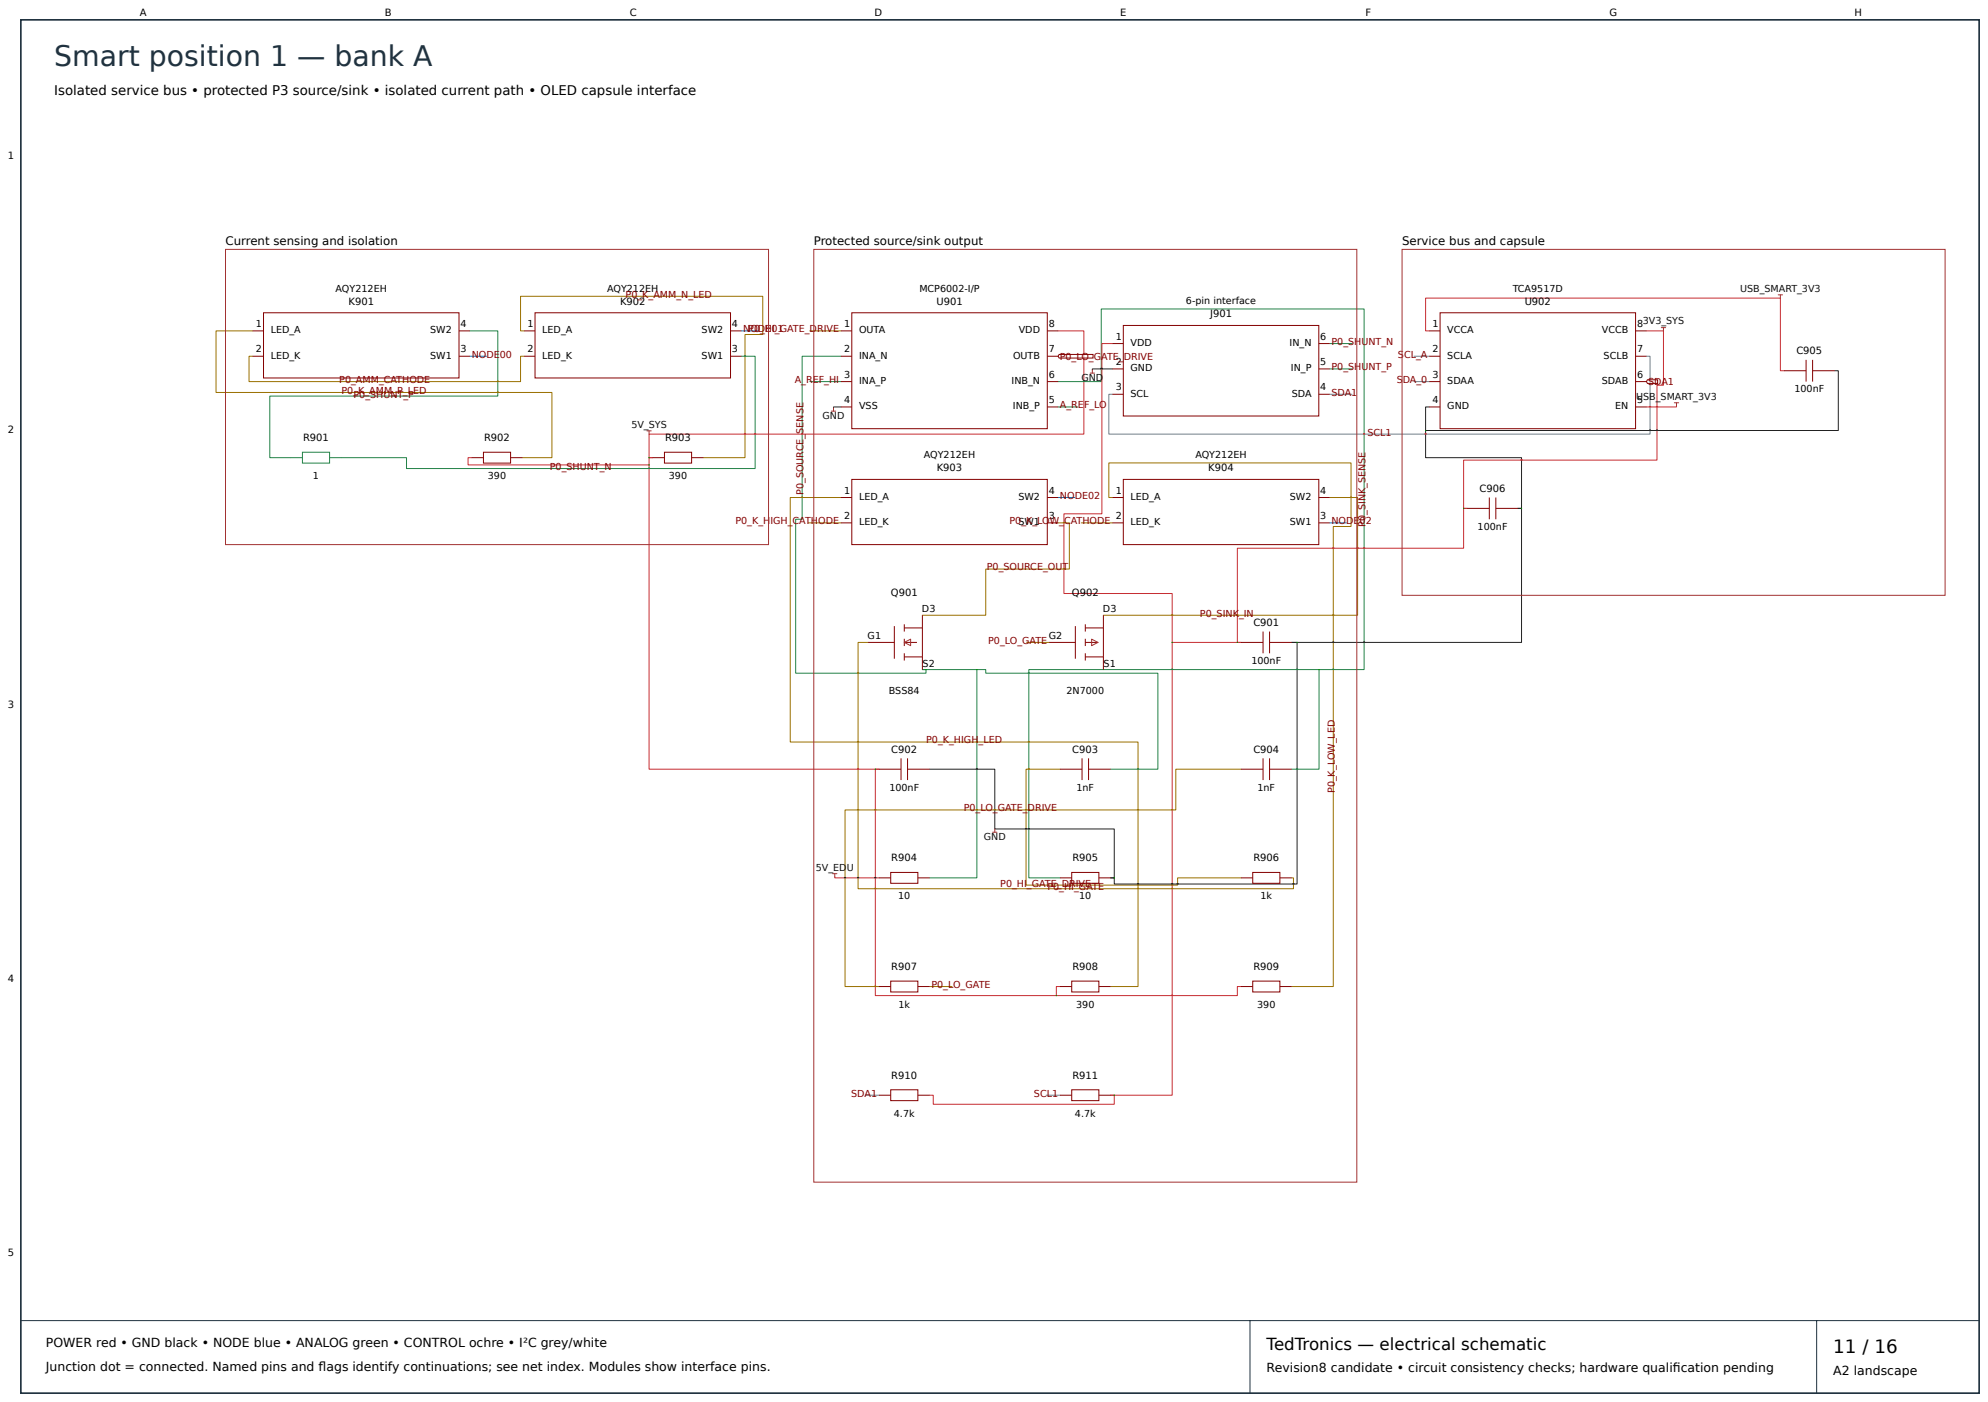
[picture p295: page 11]

# Smart position 2 — bank A

Isolated service bus • protected P3 source/sink • isolated current path • OLED capsule interface

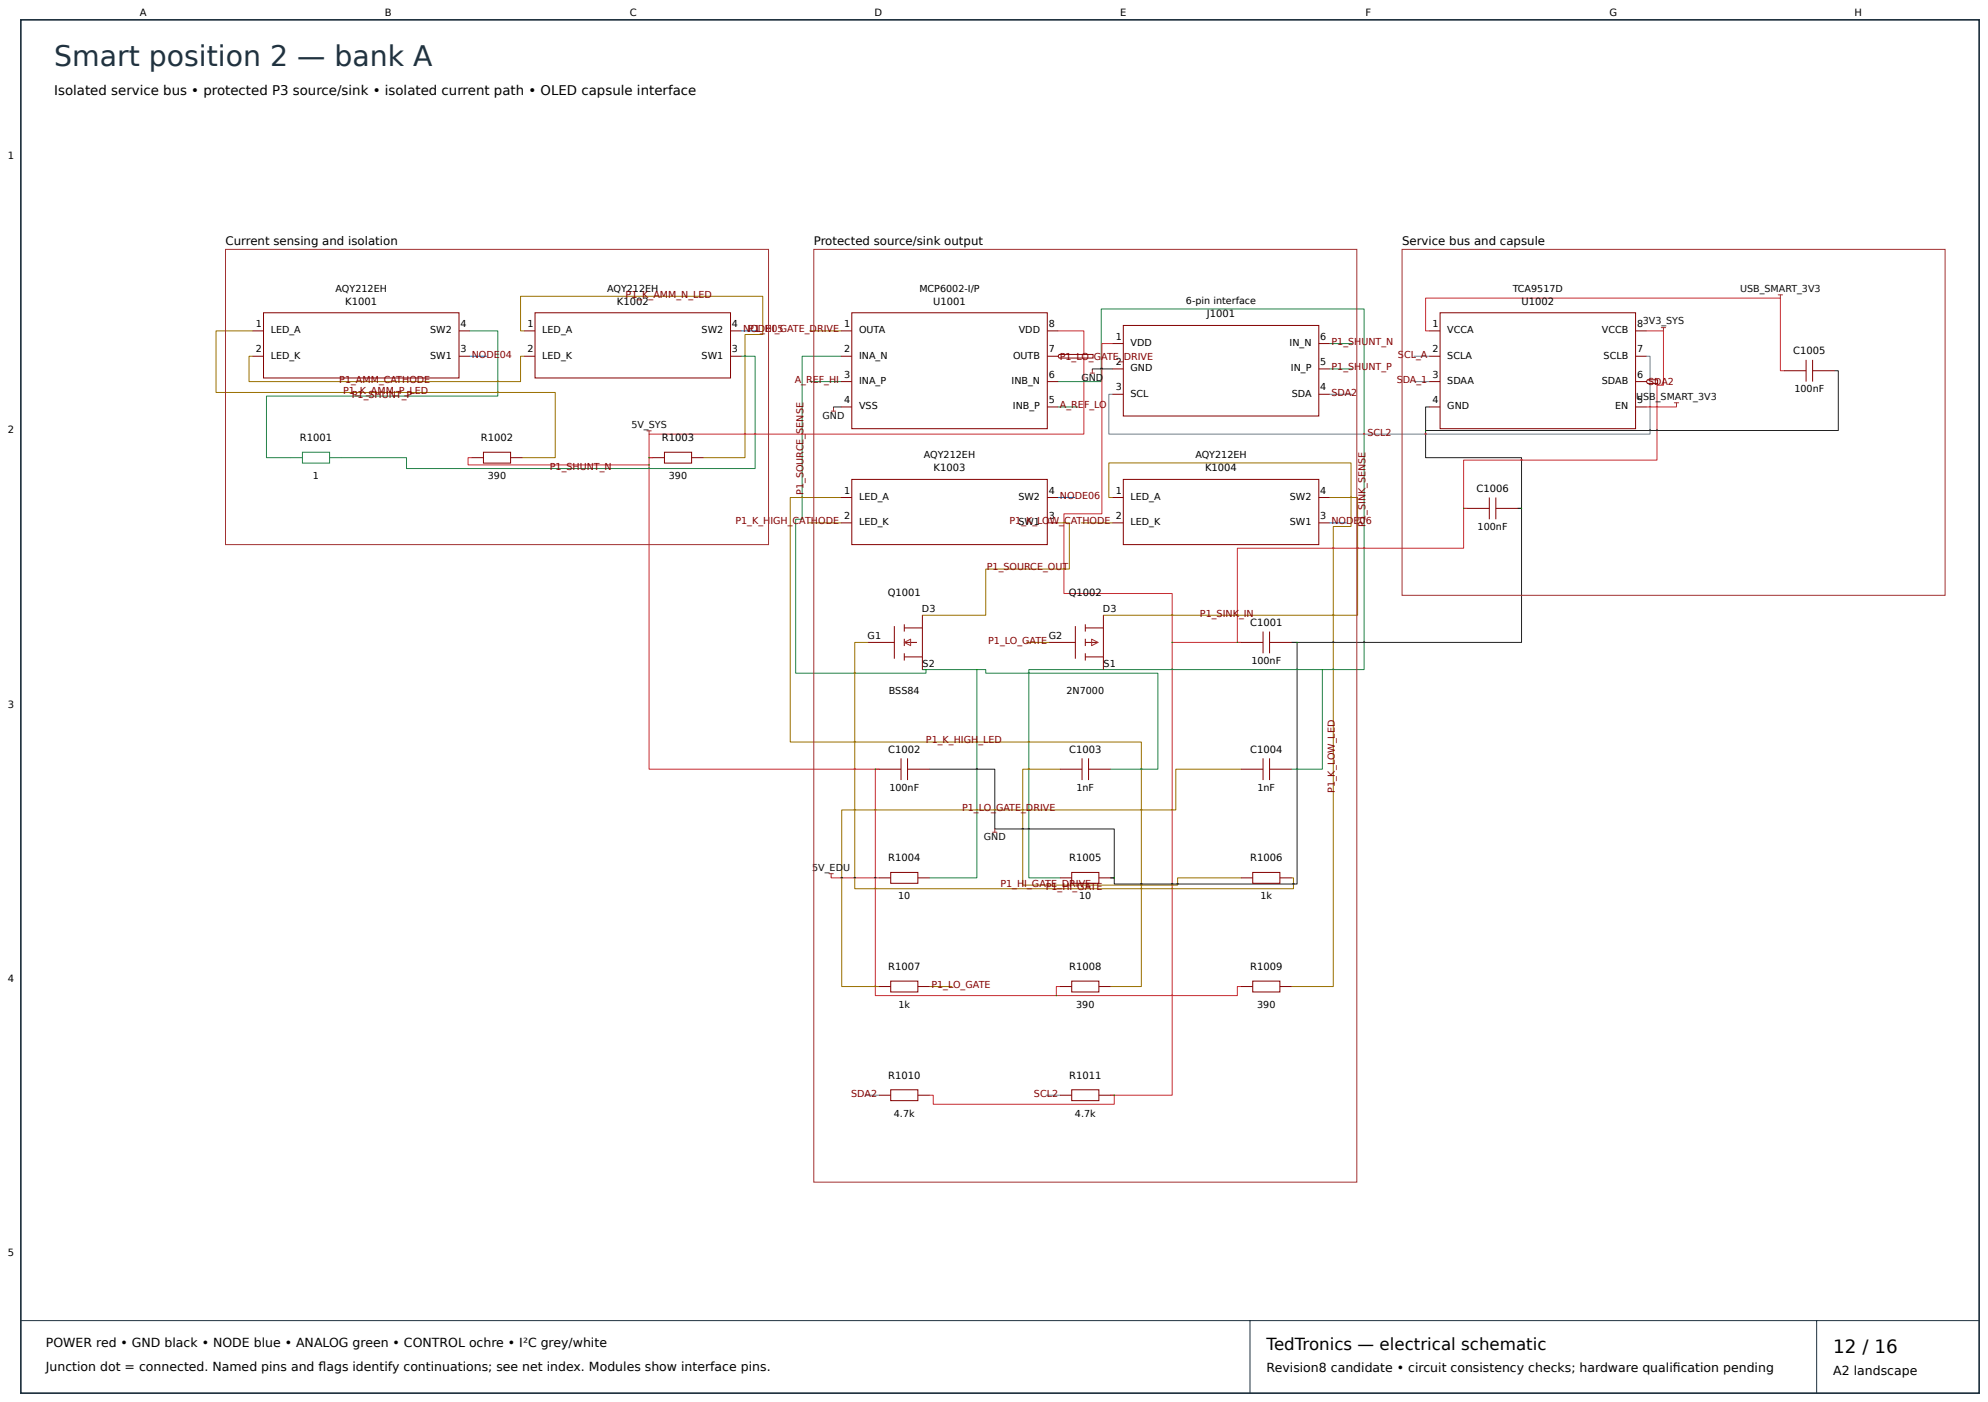
[picture p296: page 12]

# Smart position 3 — bank A

Isolated service bus • protected P3 source/sink • isolated current path • OLED capsule interface

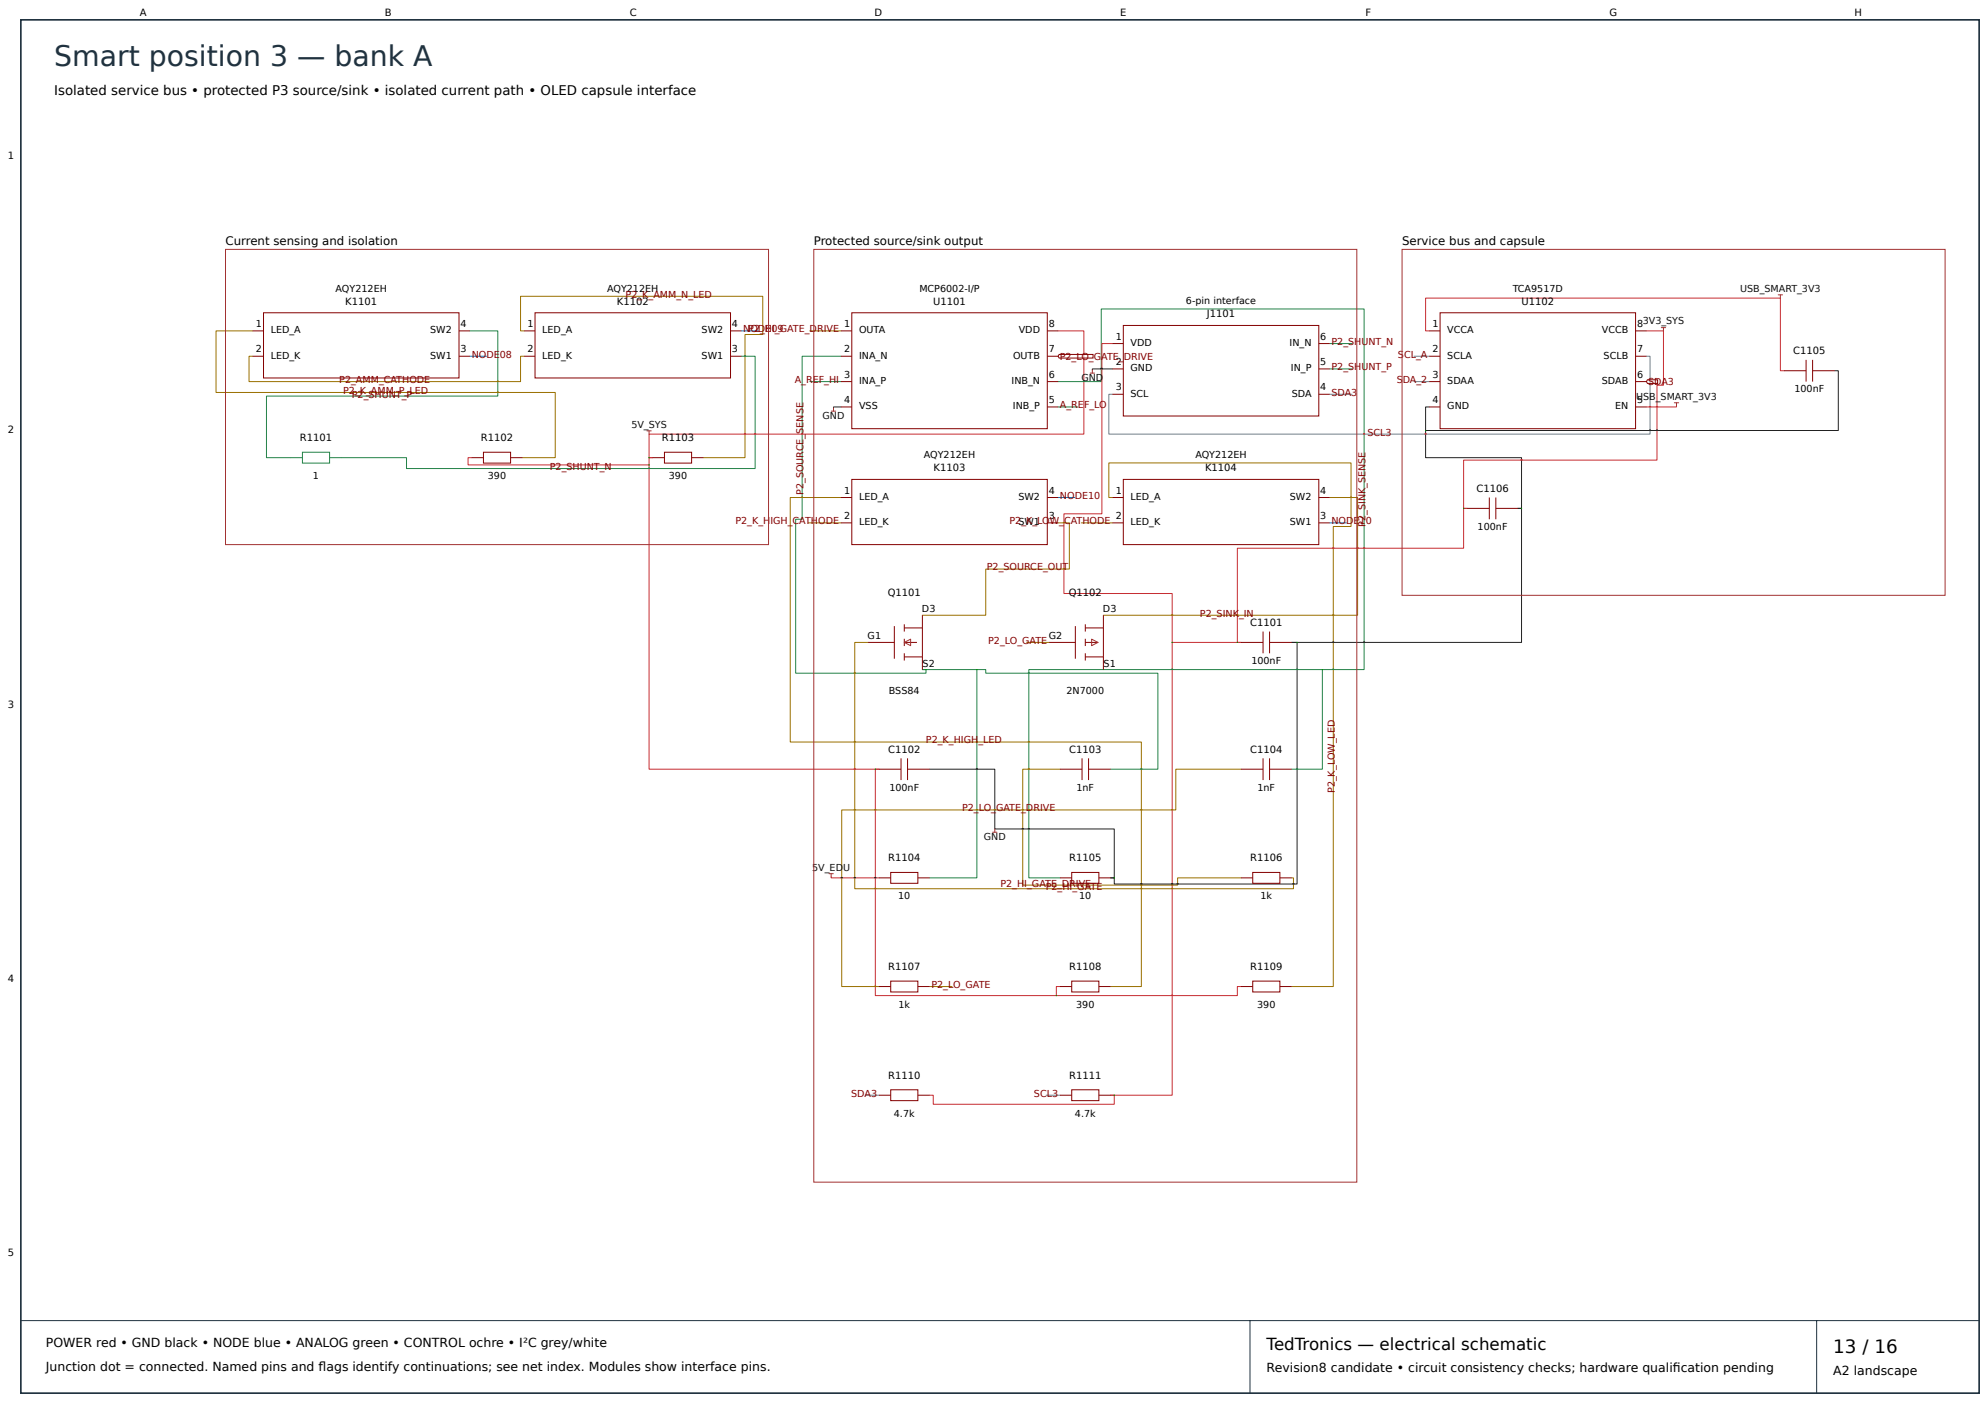
[picture p297: page 13]

# Smart position 4 — bank B

Isolated service bus • protected P3 source/sink • isolated current path • OLED capsule interface

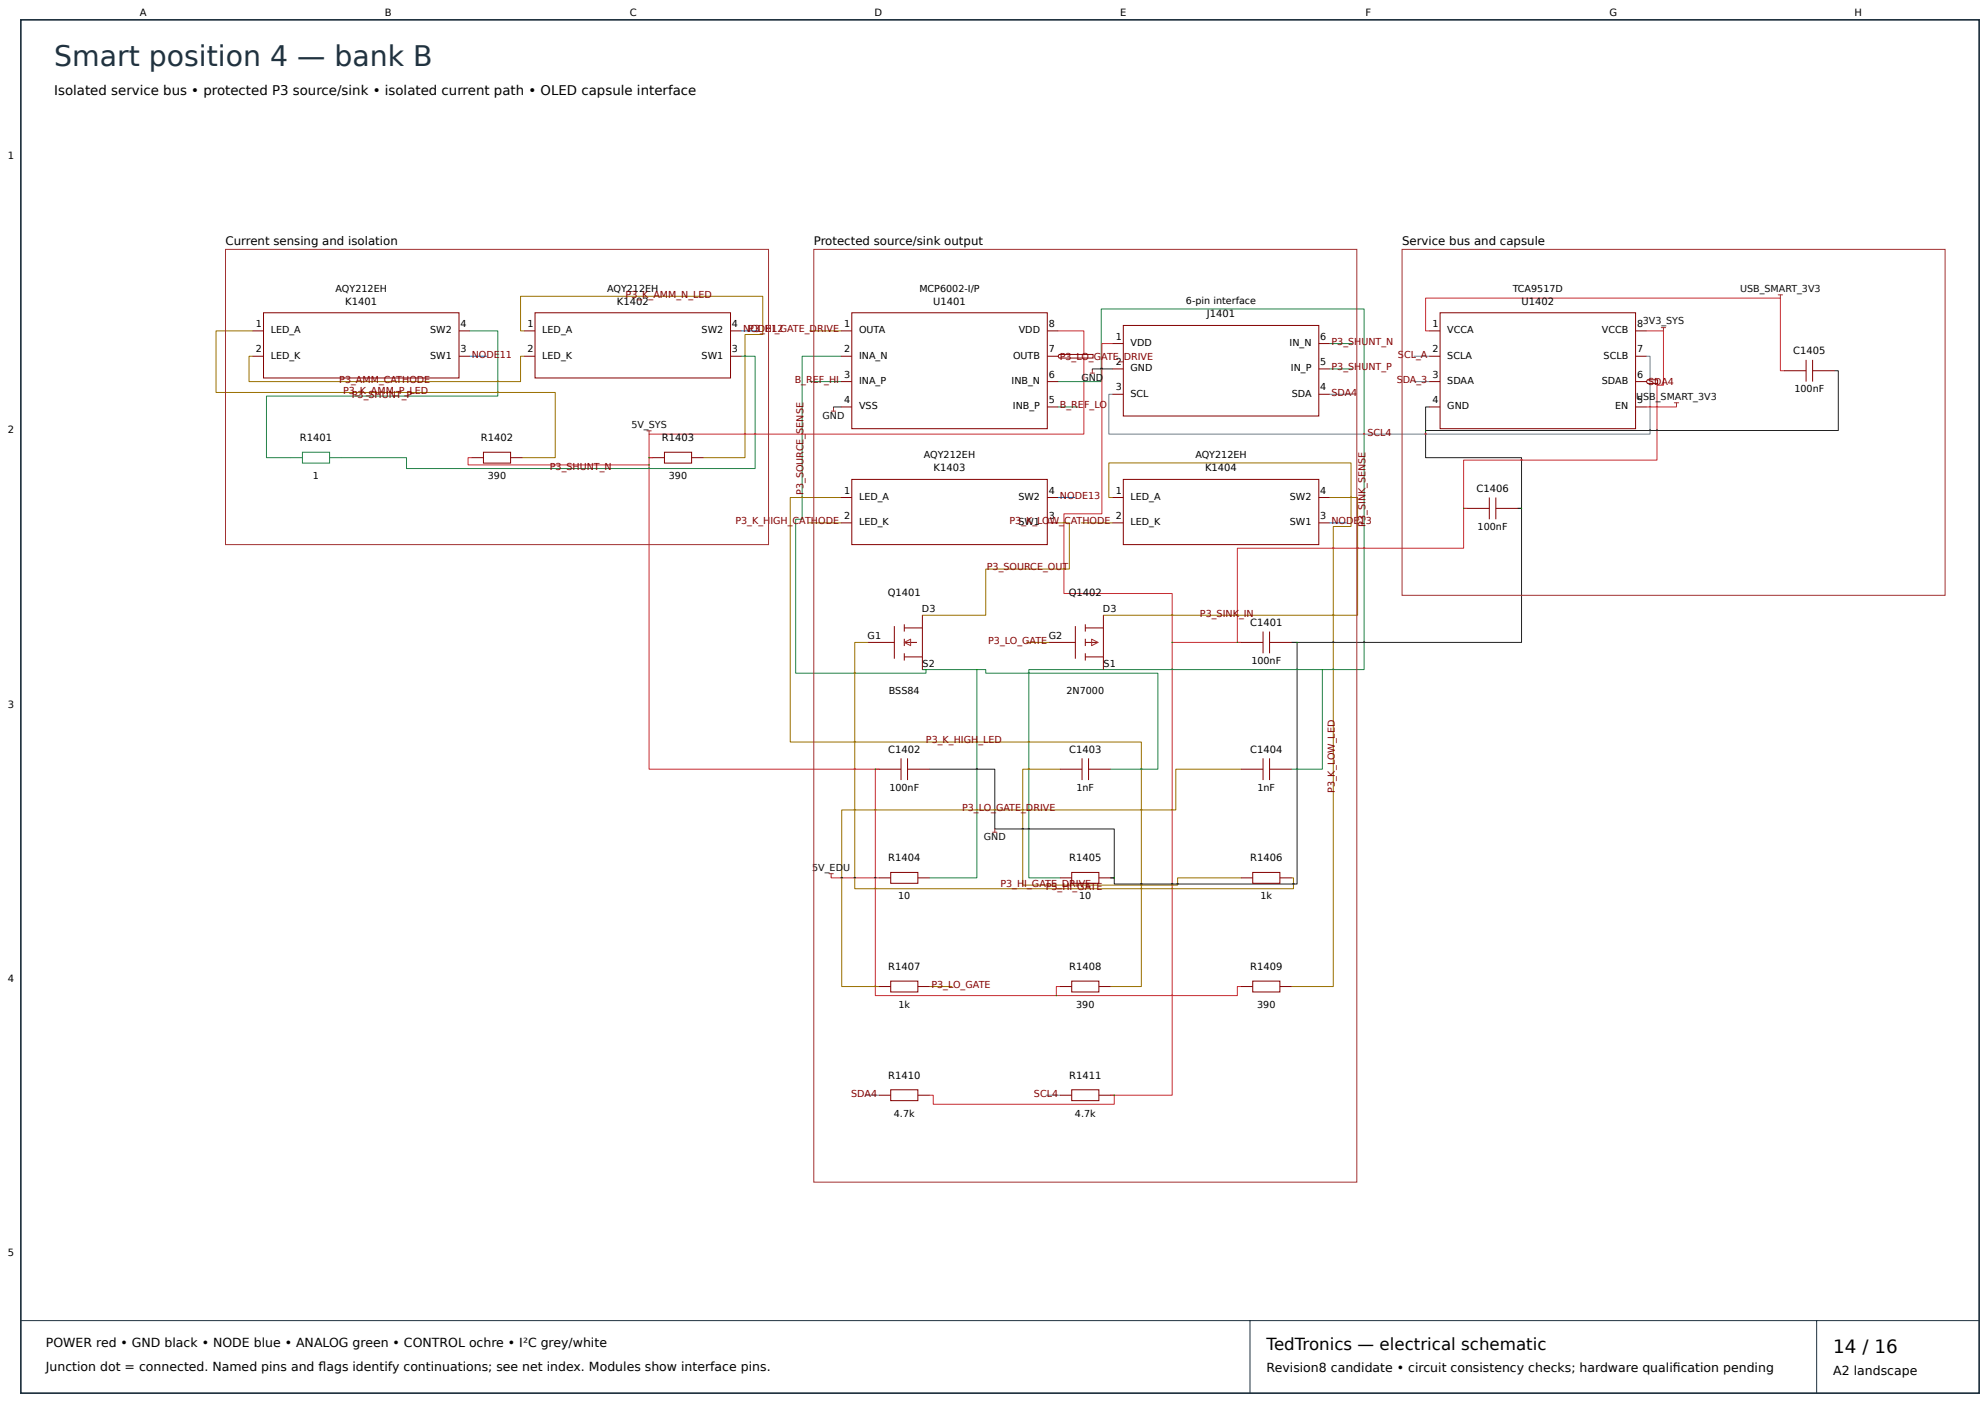
[picture p298: page 14]

# Smart position 5 — bank B

Isolated service bus • protected P3 source/sink • isolated current path • OLED capsule interface

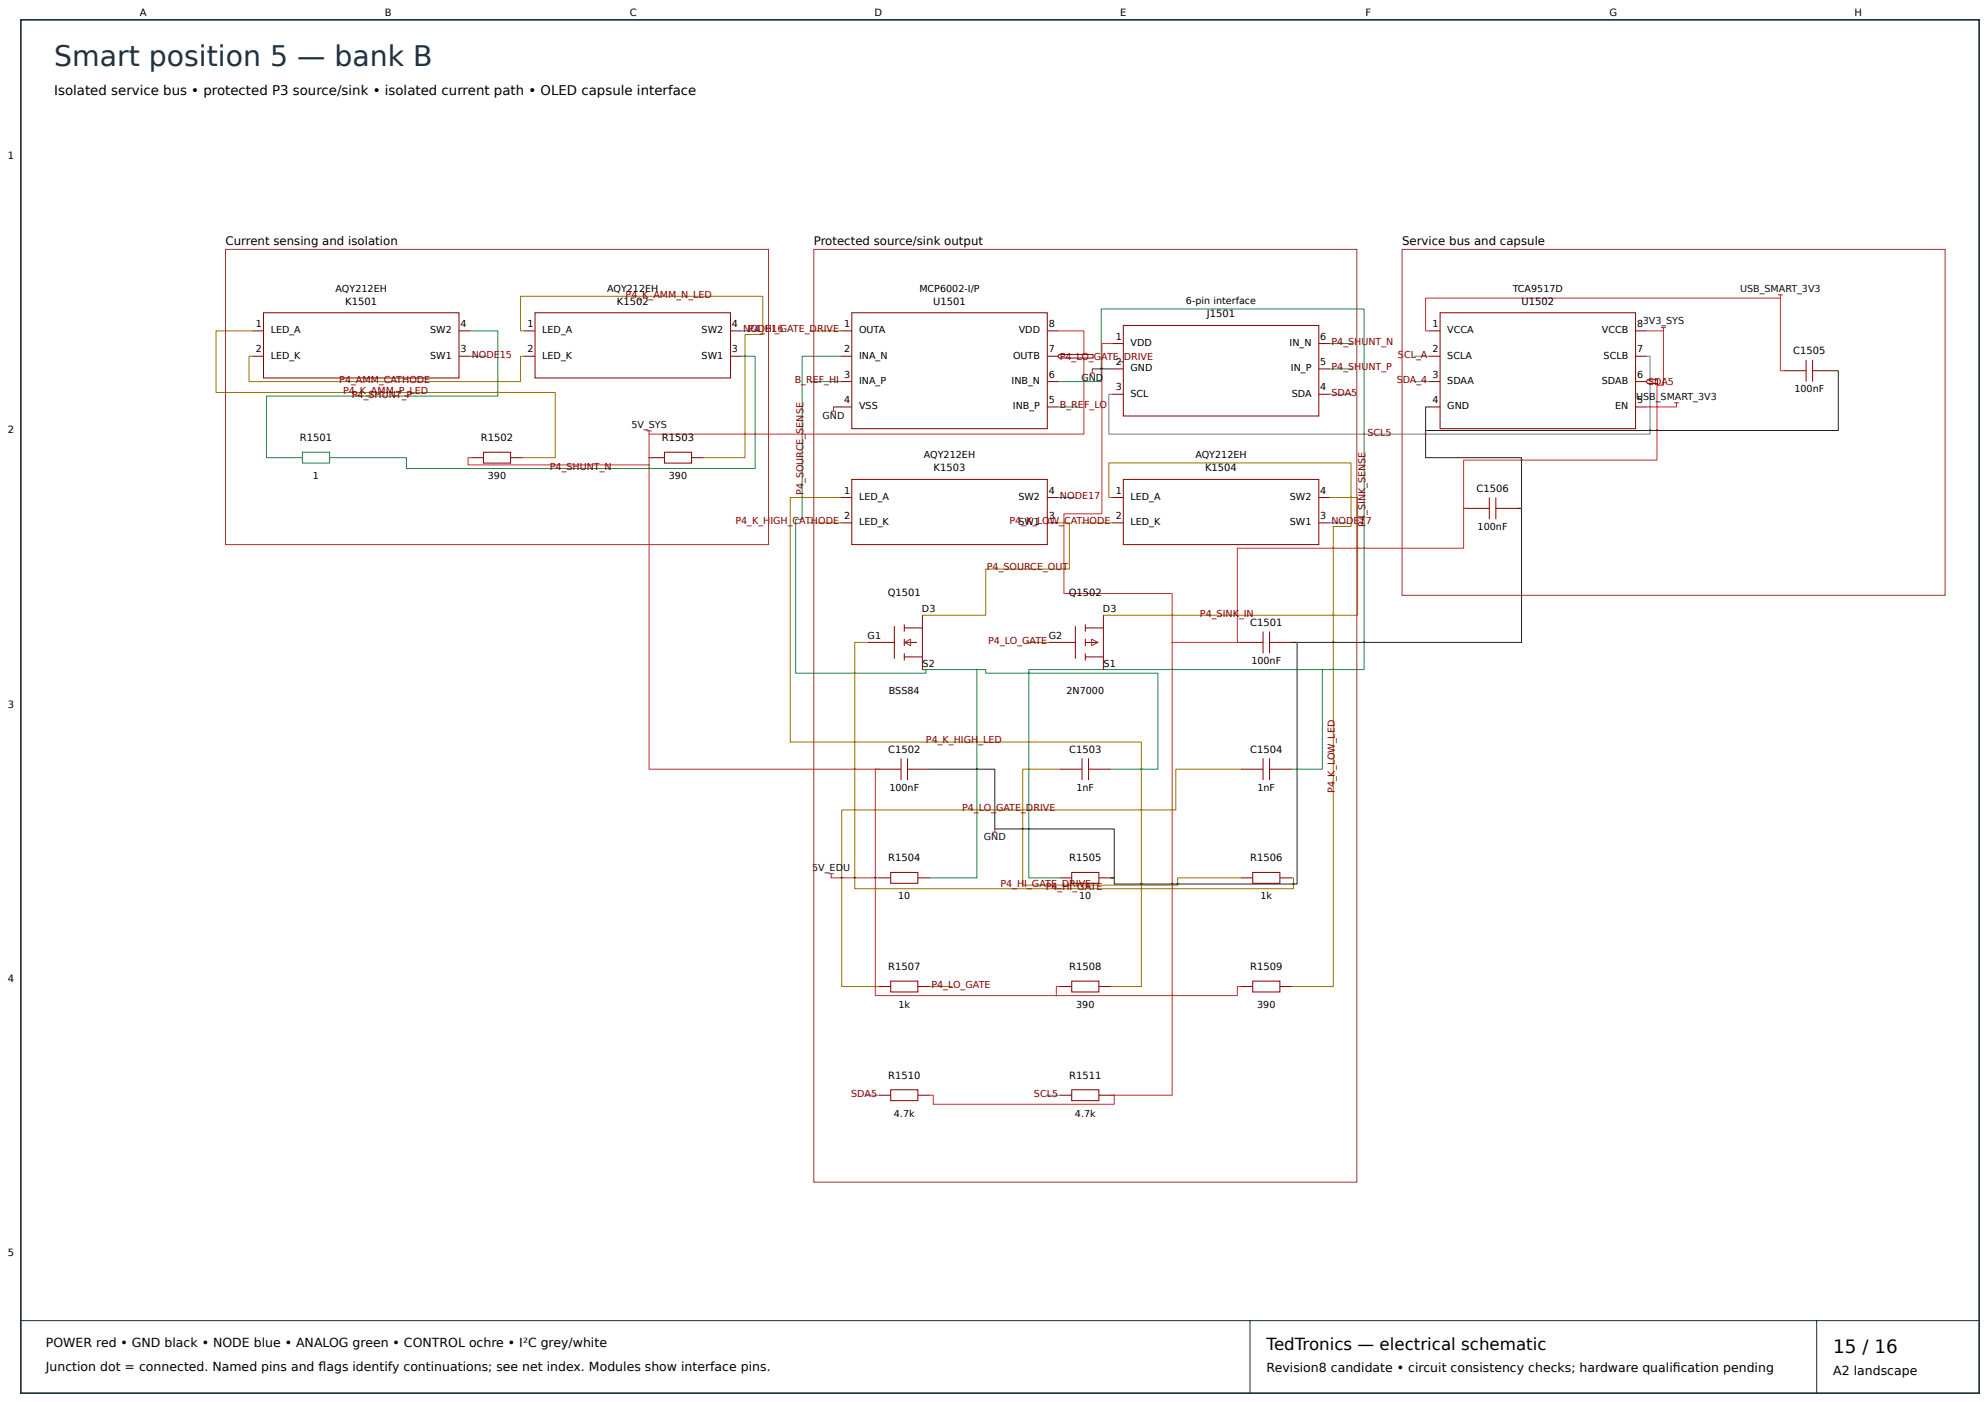
[picture p299: page 15]

# Smart position 6 — bank B

Isolated service bus • protected P3 source/sink • isolated current path • OLED capsule interface

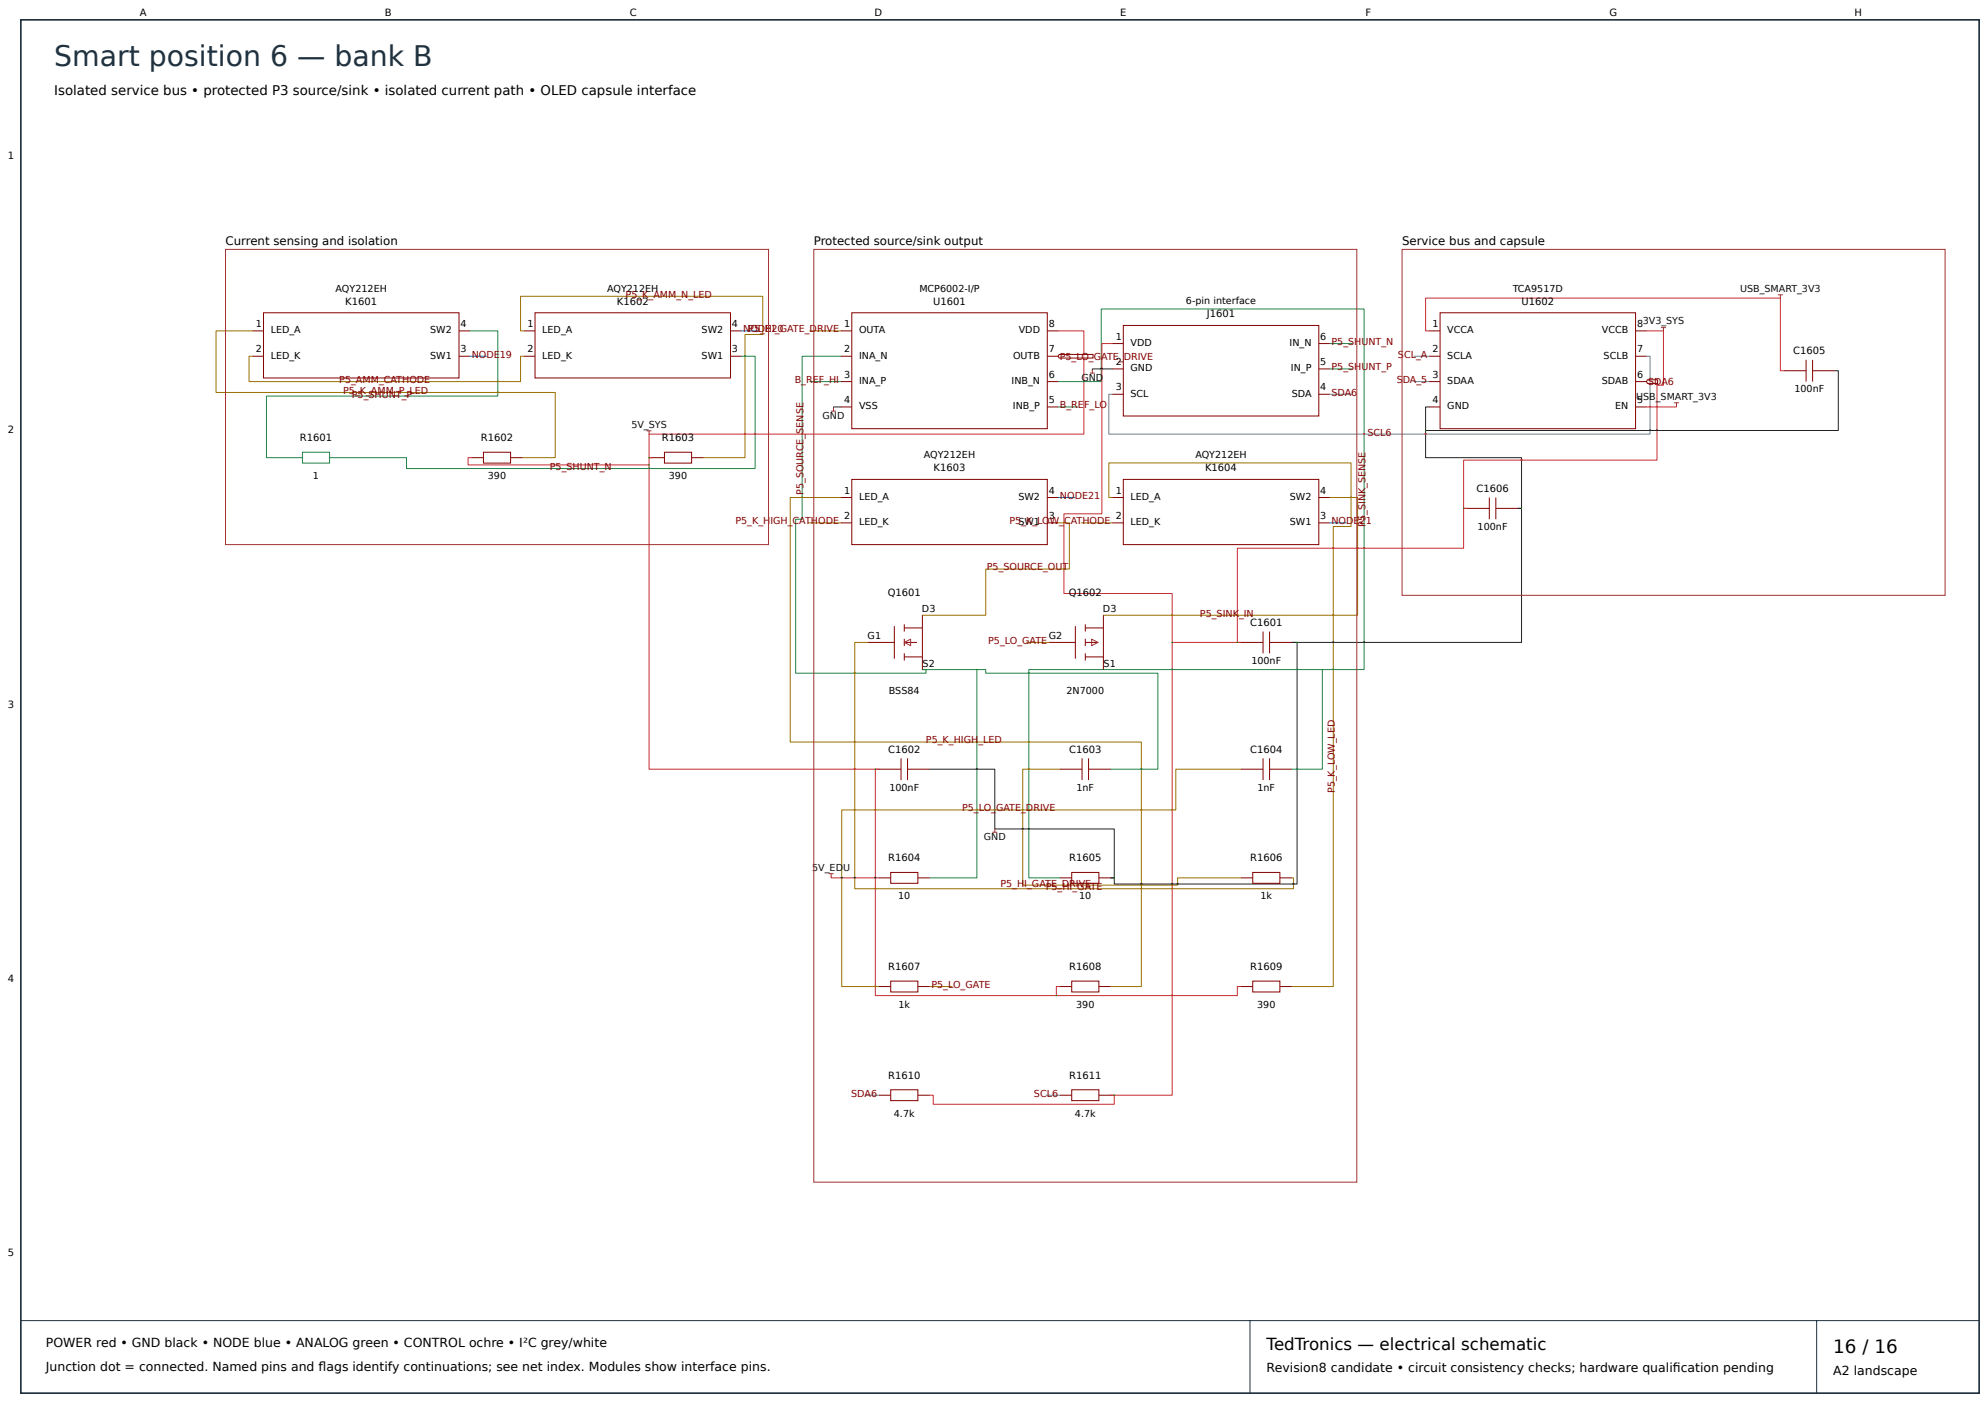
[picture p300: page 16]
