gefgu/integration-workshop-3/eletronics/perfboard/tscircuit/revision6/scale-templates.pdf

# contact-a — actual-size pad template

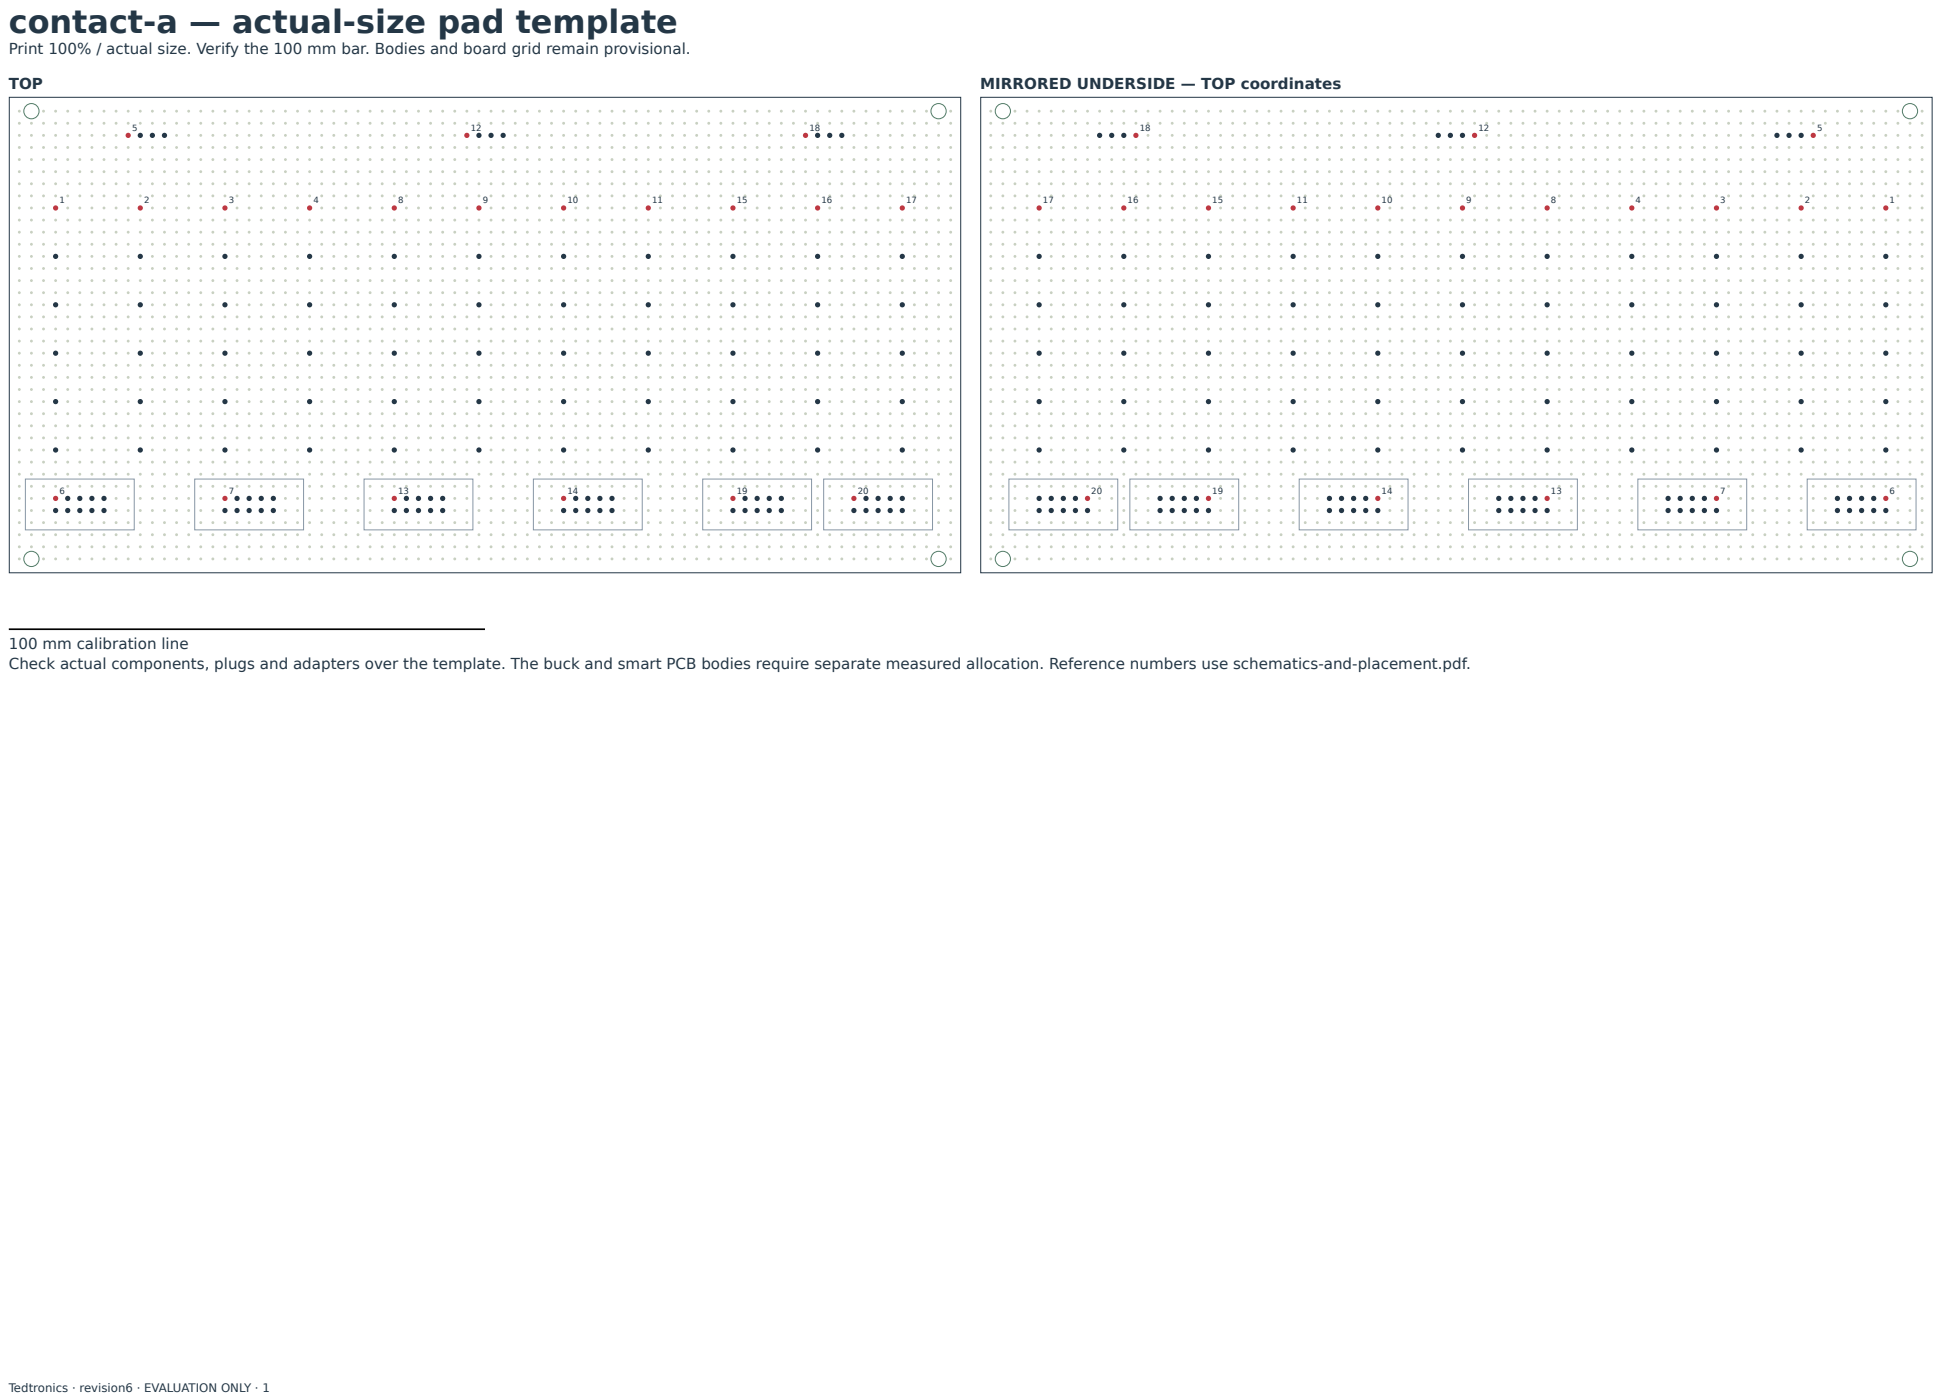
[picture p306: page 1]
TOP

Print 100% / actual size. Verify the 100 mm bar. Bodies and board grid remain provisional.

MIRRORED UNDERSIDE — TOP coordinates

100 mm calibration line
Check actual components, plugs and adapters over the template. The buck and smart PCB bodies require separate measured allocation. Reference numbers use schematics-and-placement.pdf.

Tedtronics · revision6 · EVALUATION ONLY · 1

# contact-b — actual-size pad template

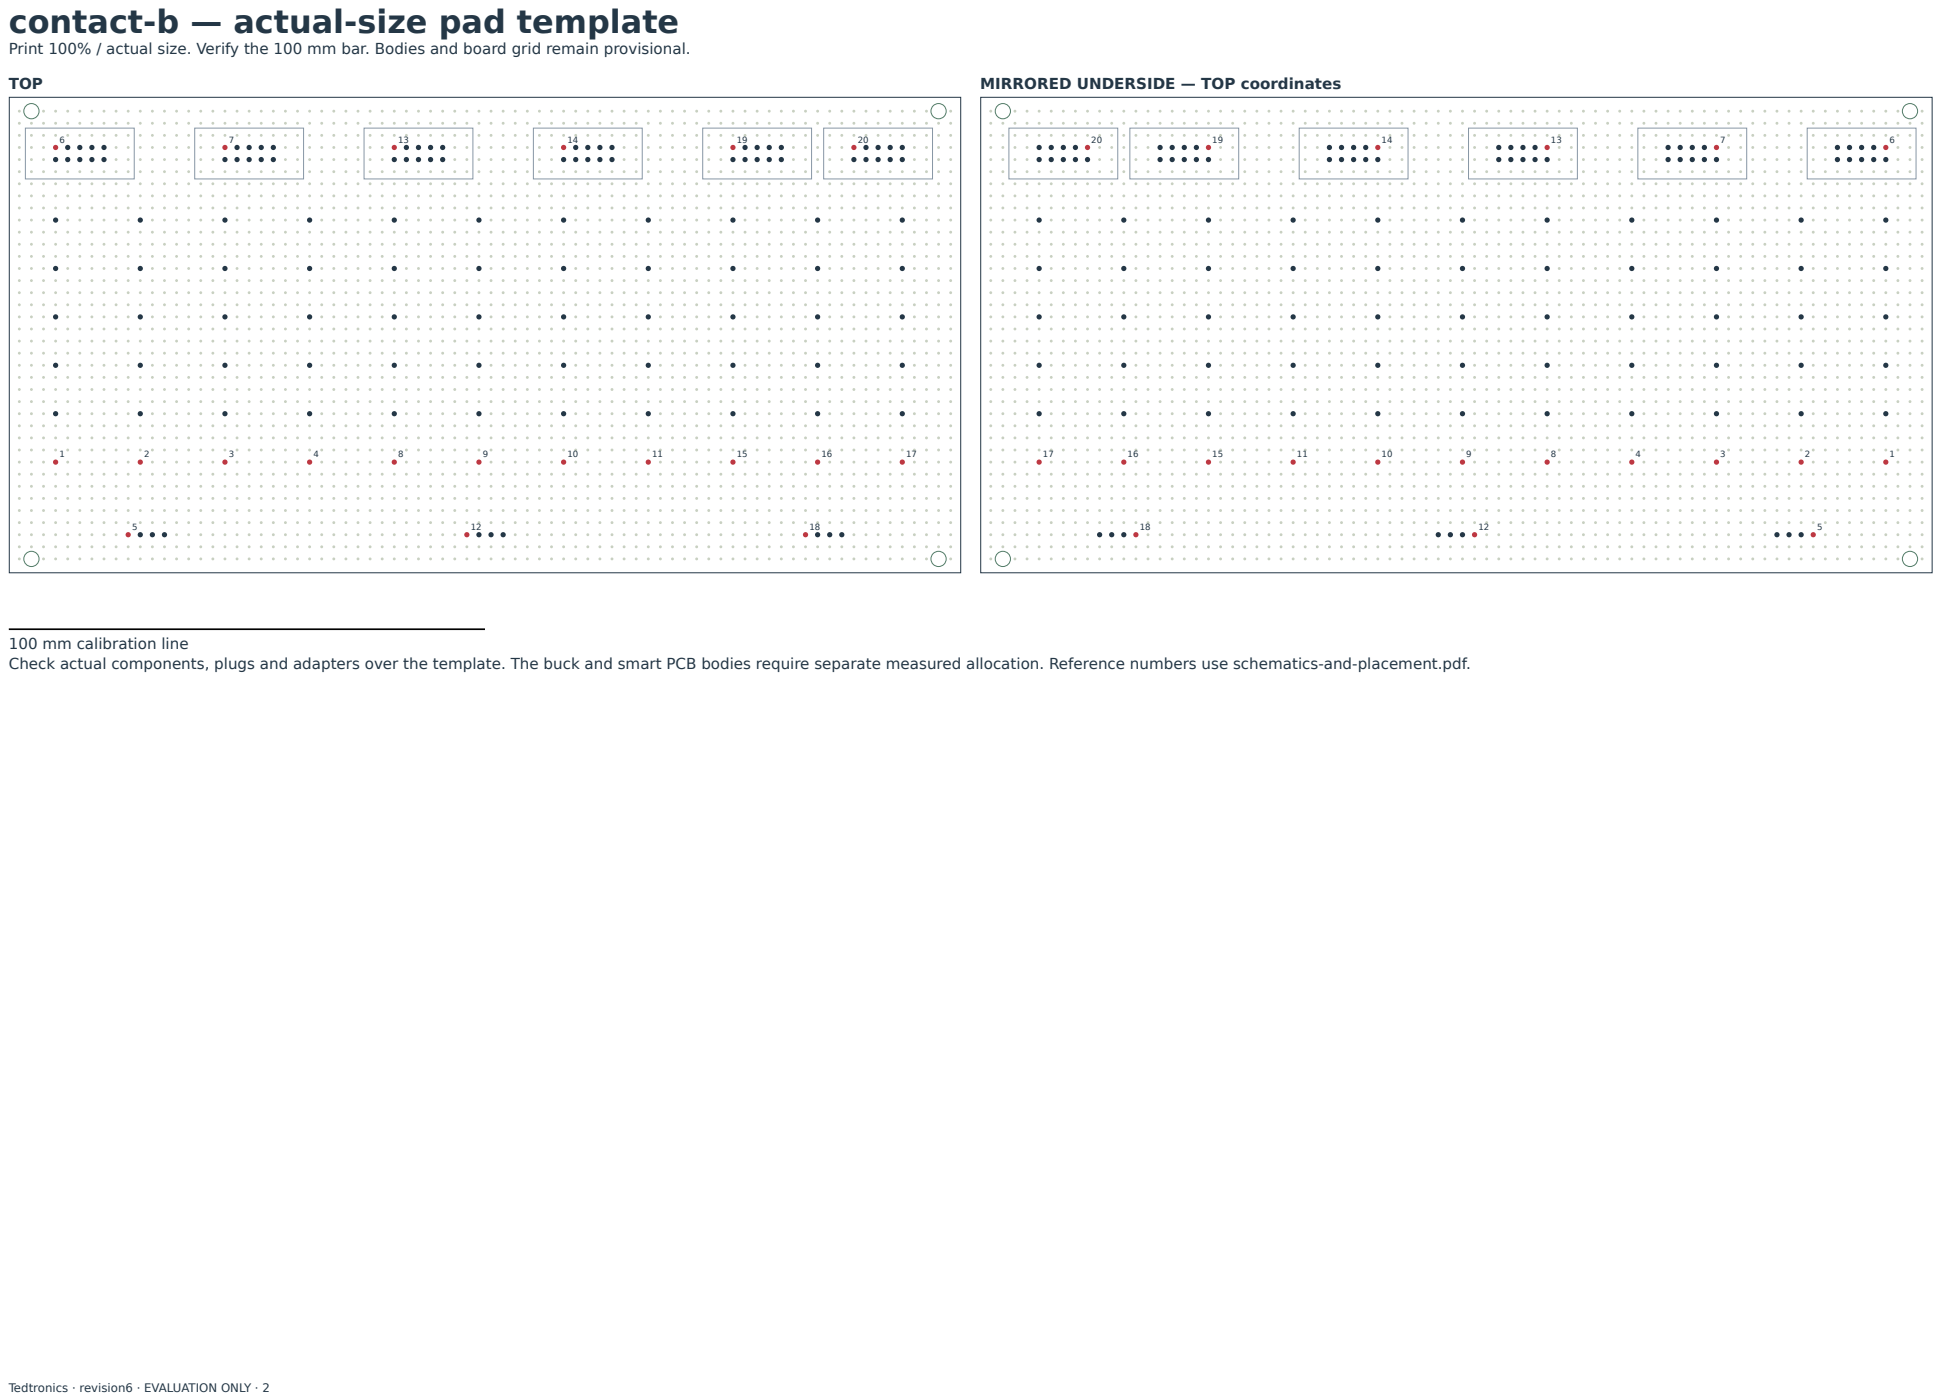
[picture p307: page 2]
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

# power — actual-size pad template

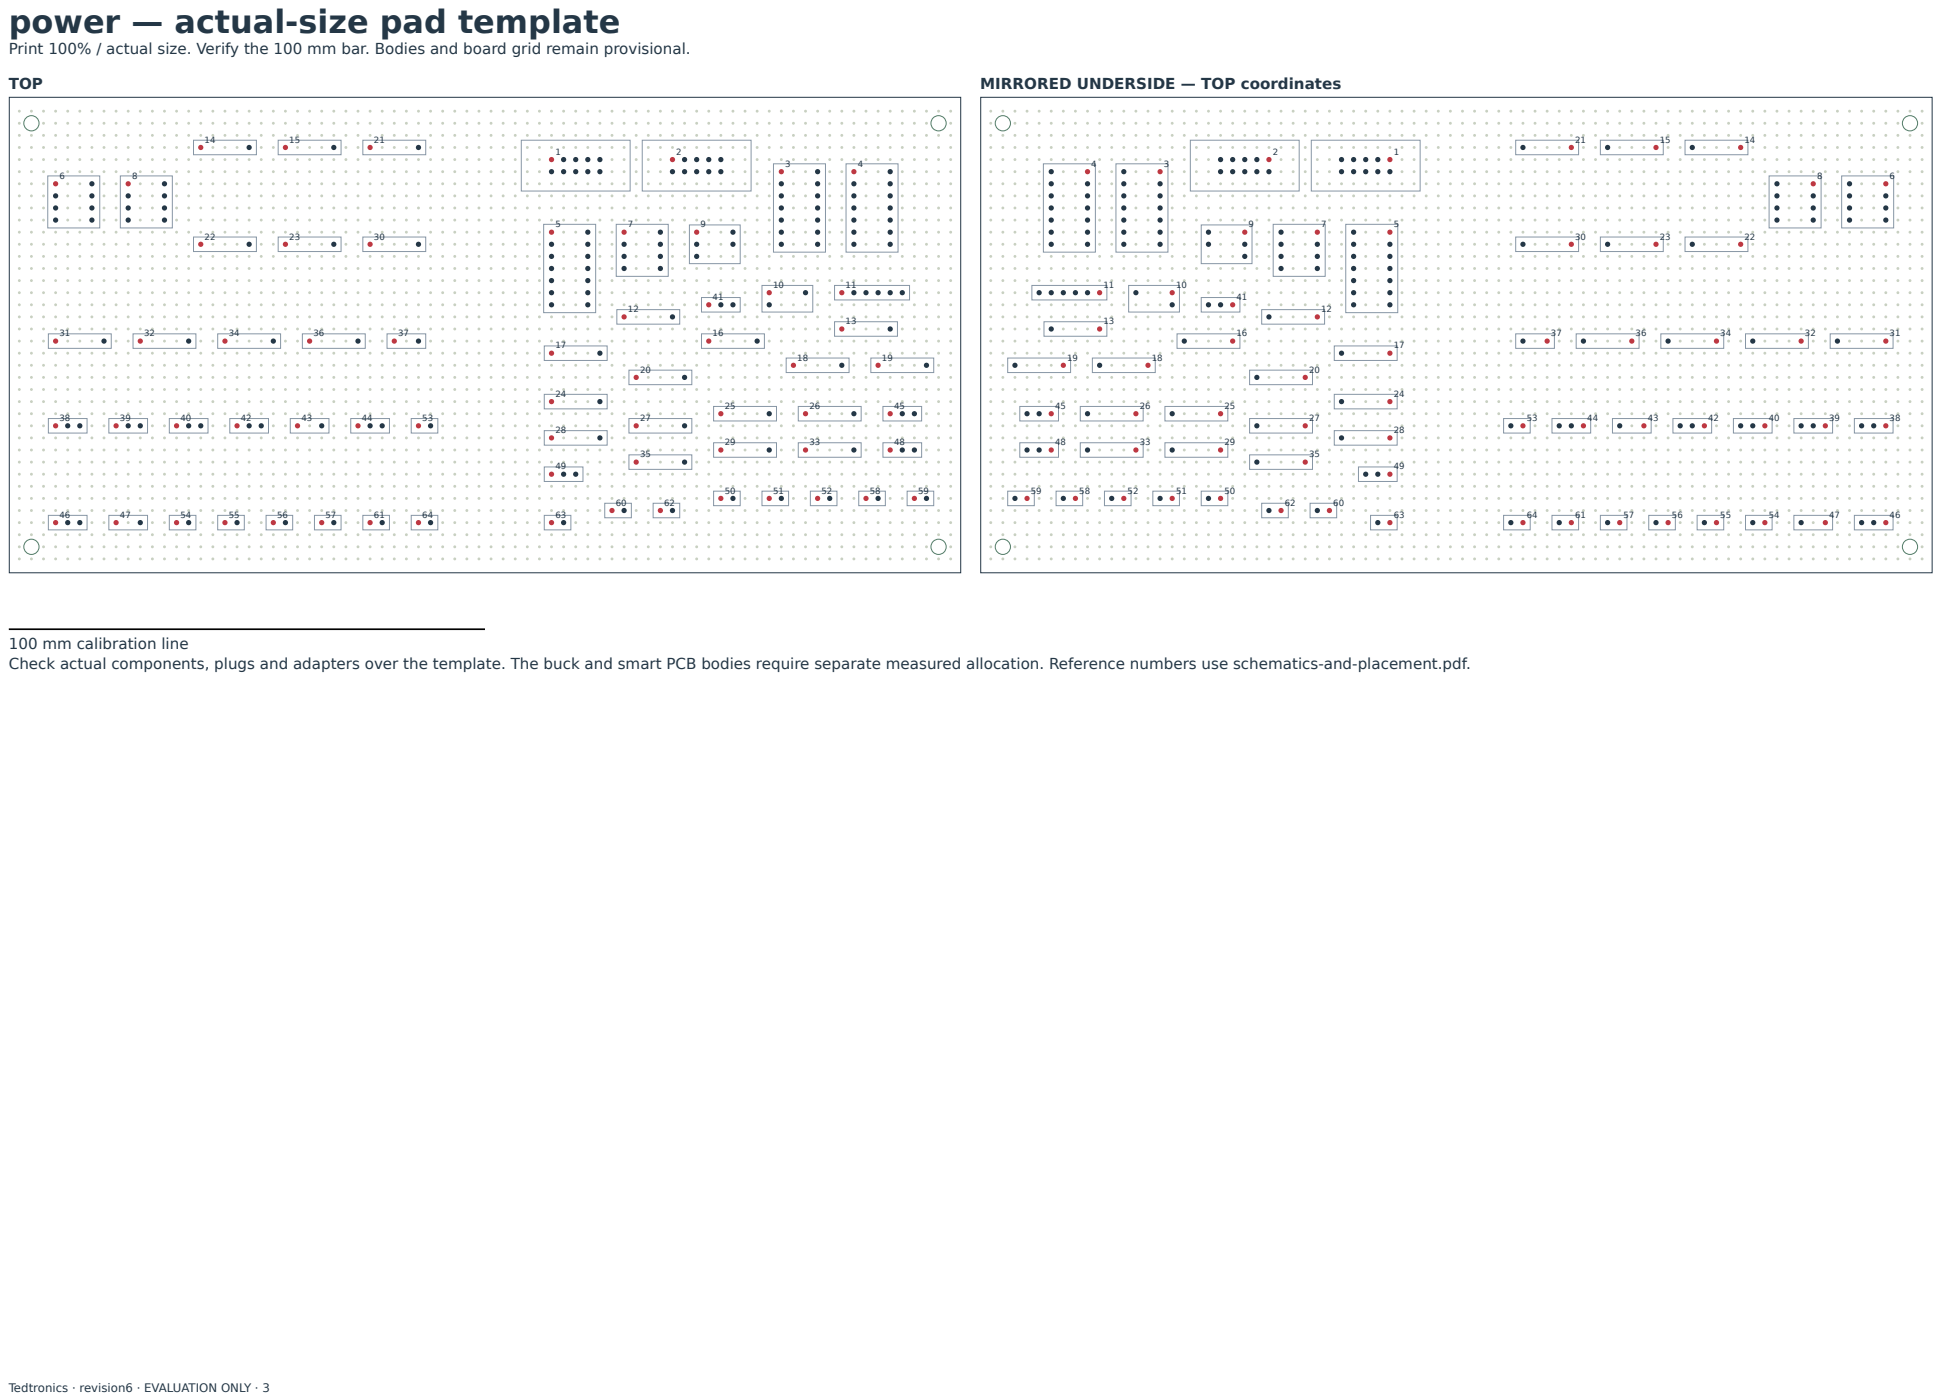
[picture p308: page 3]
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

# router-matrix — actual-size pad template

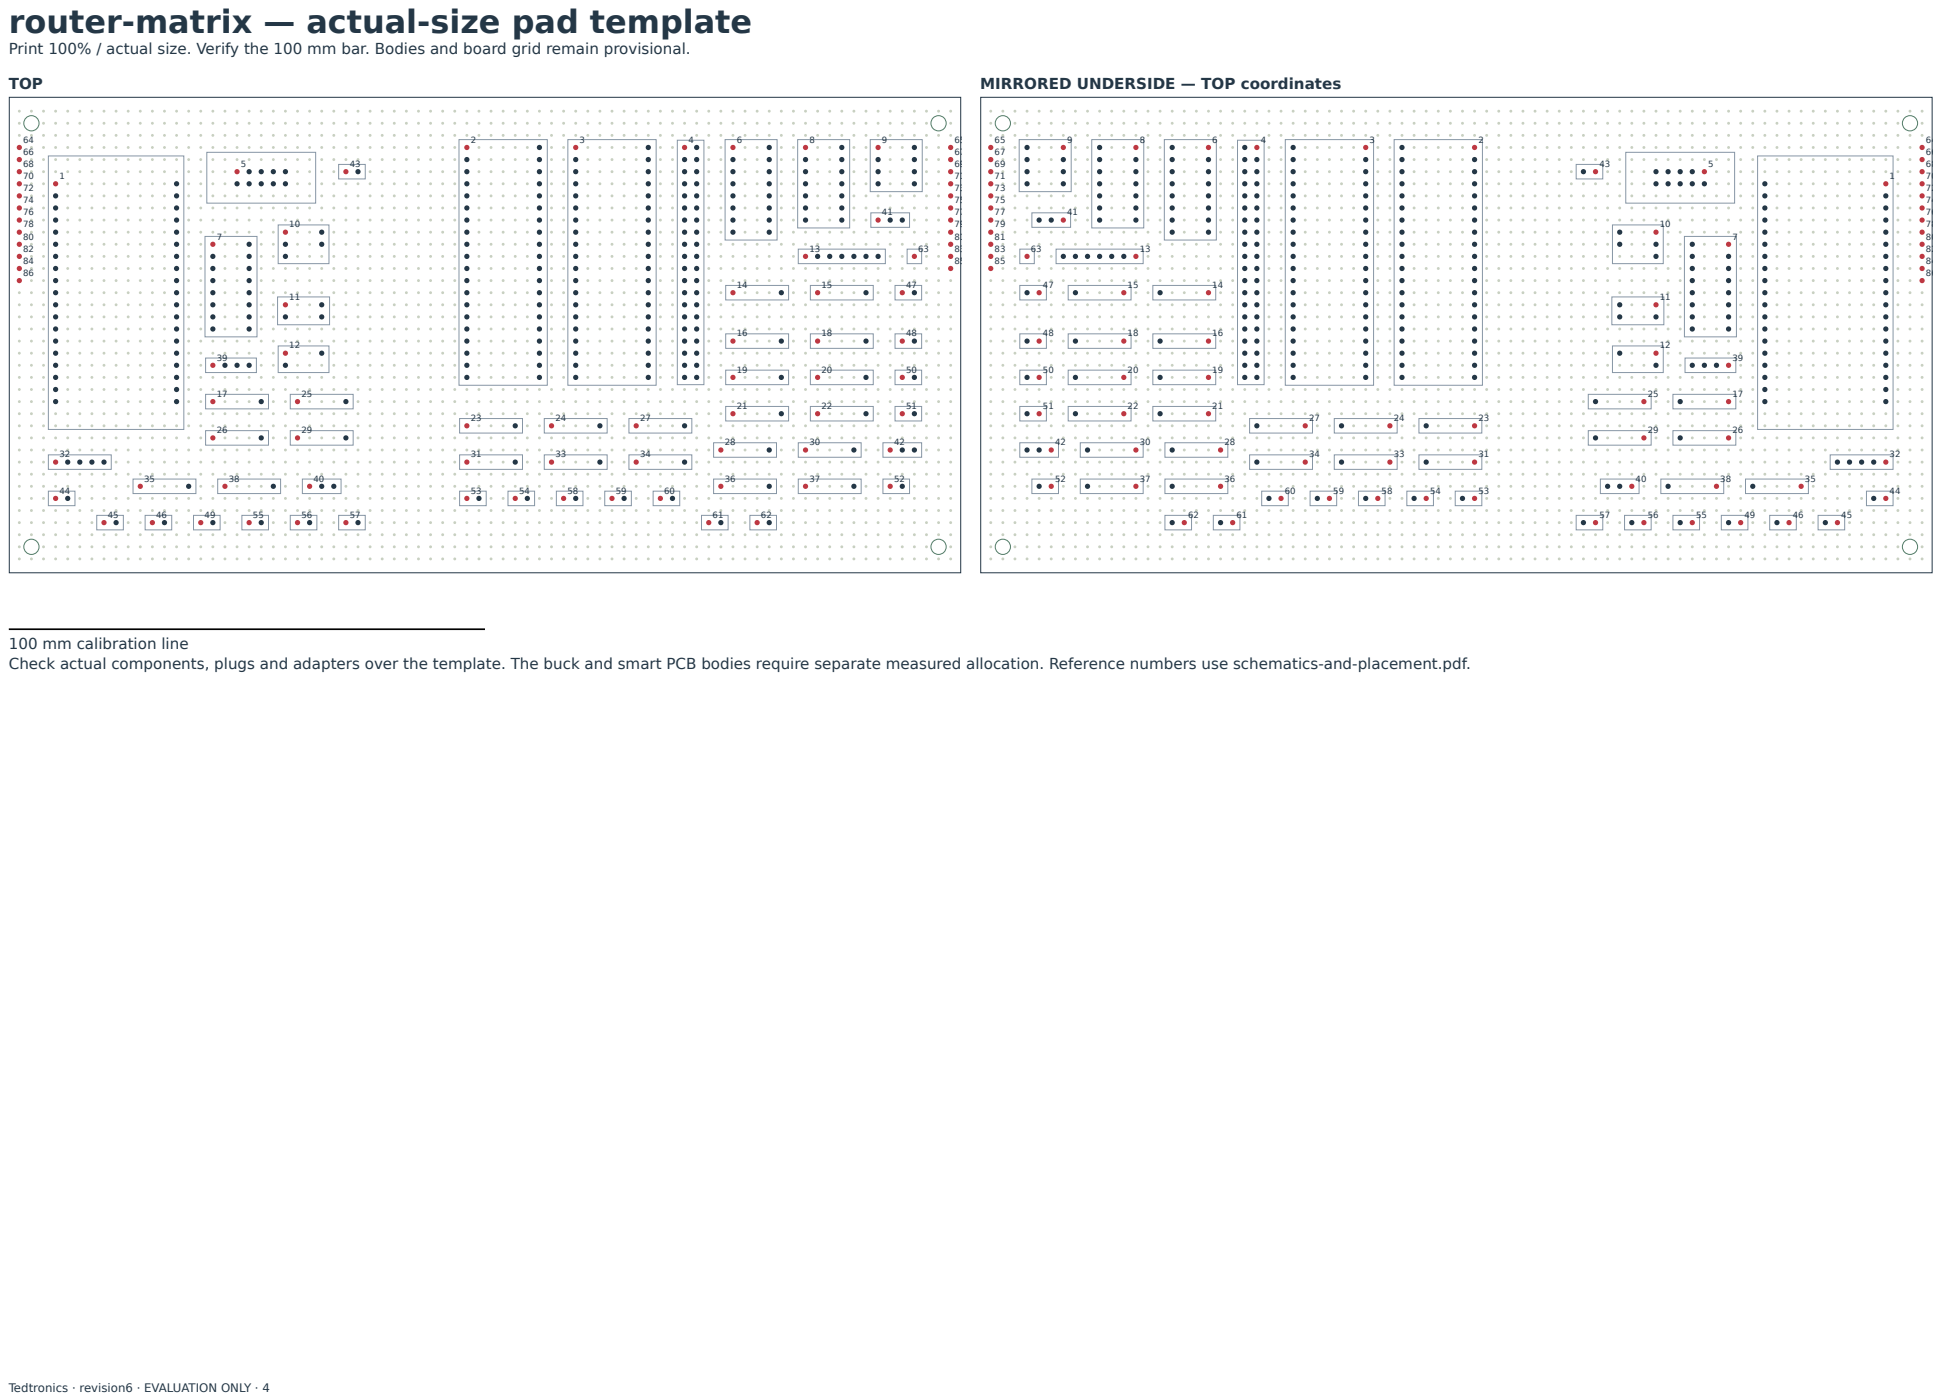
[picture p309: page 4]
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

# Early smart reference — actual-size pad template

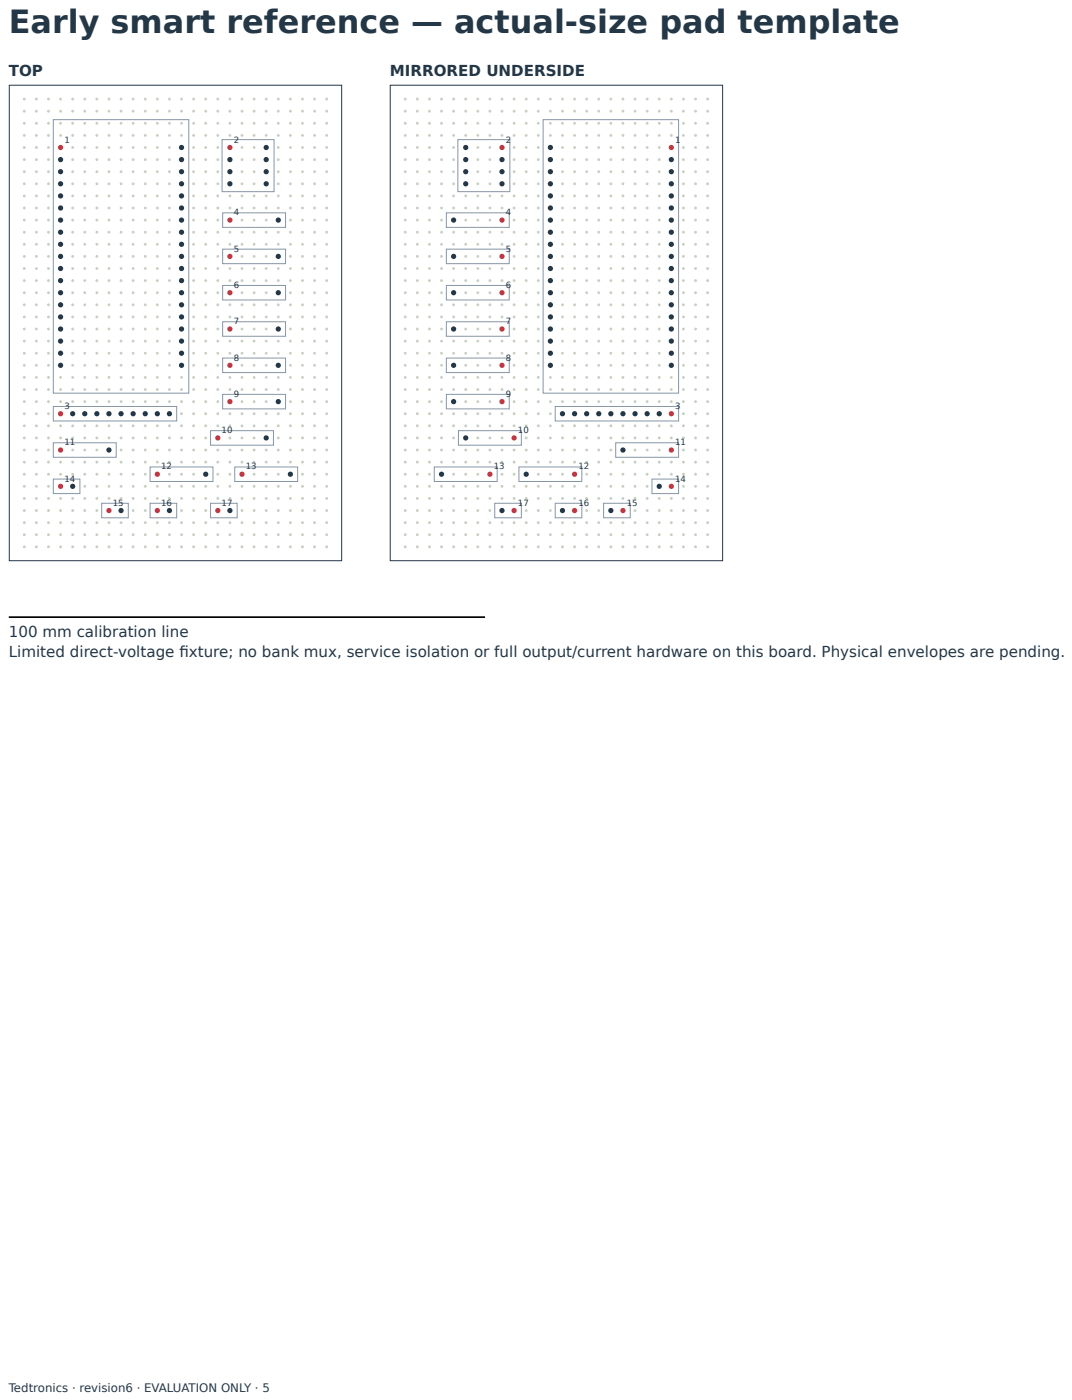
[picture p310: page 5]
MIRRORED UNDERSIDE

100 mm calibration line
Limited direct-voltage fixture; no bank mux, service isolation or full output/current hardware on this board. Physical envelopes are pending.
