gefgu/integration-workshop-3/(list of files, drawings)

Other design files:
eletronics/perfboard/tscircuit/revision8/schematic/easyeda-source.json
eletronics/perfboard/tscircuit/revision9/schematic-checks.json
