gefgu/integration-workshop-3/(commit log)

2026-09-08 Remove target schematic from module 2
    Removed the target schematic section from the module description.
2026-09-08 Document current TedThunder requirements
2026-09-08 feat: added bonus module - resistor color code
2026-09-09 feat: add missing variable resistor
2026-09-09 Update FR-GRAPH-11 requirement for electrical nodes
    Removed the mention of power rail forming an electrical node from FR-GRAPH-11.
2026-09-09 feat: attribute actions are performed, not sensed
    Rework how the bench handles button presses and potentiometer turns. It
    does not measure them at all: the real component sits in the real powered
    path, so the action simply works. A step targeting an attribute opens an
    interaction window lasting as long as the step's animation, and is
    approved by the student's answer to a confirmation question rather than
    by any electrical observation.
    Consequences of removing the sensing:
    - FR-GRAPH-05 narrowed to camera-visible attributes only
    - FR-GRAPH-14 added for confirmation-question approval
    - FR-PWR-06 rewritten, FR-PWR-12 added for the interaction window
    - FR-HW-01 loses its attribute re-reading cl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
2026-09-09 docs: drop the traceability table from the requirements
    The mapping from the original exported requirement IDs to the current
    per-area ones has served its purpose; the old IDs are no longer cited
    anywhere. Removing it keeps the document to what is actually being
    built.
2026-09-09 docs: add a side-by-side figure at the top of TedThunder.md
    Lead with two pictures: the bench itself and the guided-mode interface
    showing the assembled graph checked against the step's target.
    Uses an HTML table rather than markdown image syntax, since markdown has
    no way to place two images on one row. Only tags and attributes on
    GitHub's allowlist are used, and both images are sized to the width of
    their cell so the pair scales down together on a phone.
    The mechanical render is no longer embedded a second time further down;
    it is now the left half of this figure.
2026-09-09 Revise audience age and update interaction details
    Updated the target audience age from 6th to 8th grade to 7th to 8th grade. Revised descriptions for the Energizar button and clarified the interaction window process.
2026-09-09 feat: adopt the electronics team's spec and drop to 5 V
    Reconcile the electronics team's requirements and risk analysis into our
    own documents.
    Voltage moves from 9 V to 5 V, which their rail design and switch
    validation already assumed: AR-04, NFR-SAFE-02, FR-HW-06, TedThunder.md
    and all eleven mentions in modules.md.
    The color-code capsule is re-picked for 5 V, because their 15 mA branch
    limit rules out the old 100 and 170 ohm rungs. The discs are now
    red/yellow, red/violet and brown/red, giving 220, 270, 420, 470 ohm and
    2.2, 2.7, 4.2, 4.7 kohm - every value under 15 mA, and black drops out
    of the palette.
    New FR-ELEC and NFR-ELEC areas carry the electronics requirements, with
    requirem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
2026-09-09 docs: add the course blog
    Weekly blog following the format used by the previous team, with posts
    in reverse chronological order and a links block pointing at the project
    documents.
    Covers the first four weeks of the course: team formation and PMBOK
    (20/08), the first three proposals (27/08), the detailed proposals and
    the requirements talk (03/09), and the enhanced plans A and B due before
    class on 10/09. The 10/09 post carries the current state of TedThunder
    as plan A.
    The names of the other proposals are left as placeholders, since they
    are not recorded anywhere in this repository.
    Linked from the README.
2026-09-10 Update blog.md with Plan A prototype details
    Added details about Plan A's prototype and its focus on education.
2026-09-10 feat: add prototype figure
2026-09-10 Revise BOM with updated pricing and availability notes
    Removed placeholder values and detailed notes on Raspberry Pi 3 B availability.
2026-10-04 feat: teacher authoring web app for lessons on the 11x6 board
    Vite + React app (SFR22/SFR22.1) based on the prototipo_design engine:
    - two-bank 11x6 board with square sockets, drag/drop/flip/remove of the
    basic components (5 V battery, LED, 220/470/1k resistors, jumpers)
    - placement limited to the kit contents from MFR8
    - multiple-choice quizzes before/after the build
    - lessons saved to localStorage and exported/imported as .json
    - "Testar" runs the lesson as a student (quizzes, build, Energizar)
    - node --test unit tests for engine, board rules and lesson model
2026-10-05 feat(teacher-app): add buzzer, capacitor, button, potentiometer and MFR10 colors
    - capsule colors per MFR10 (battery red, LED/buzzer green, resistor/capacitor
    blue, button/potentiometer yellow, jumpers white); MFR11 dots on the blue pair
    - simulation: buzzer load, capacitor blocks DC, button closes only while held,
    potentiometer adjustable 100 Ω–10 kΩ (value saved in the .json)
    - kit limits for the new parts (MFR8); tray shown in two columns
2026-10-05 feat(teacher-app): jumpers fill the whole socket squares on the board
2026-10-05 feat: graph_validator Python library and service for circuit graph validation
    Builds the terminal graph (SFR1), matches it to step targets by isomorphism
    (SFR5/6/8), classifies feedback with pt-BR messages and per-component
    overrides (SFR12/15), lints one-action guided steps (SFR4) and exposes it
    through a FastAPI service and CLI.
2026-10-06 Add routed screens and lesson circuit cards
2026-10-06 feat(validator): compare circuits by electrical equivalence, not columns
    "Conectar circuito" now treats jumper-joined columns as one net and reduces
    the circuit to a canonical series/parallel form, so reordering parts in
    series or parallel (and moving the build) is accepted while LED and battery
    polarity still matter. Non-reducible circuits fall back to part/net graph
    isomorphism. "Posições fixas" keeps the old terminal-graph match.
    Failures are explained by nets (reversed polarity, wrong branch, new
    open_circuit / short_circuit categories) instead of column positions. The
    debug panel lists nets and the reduced circuit. Drop the unused
    column-based matchesTarget.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
2026-10-06 feat(validator): support longer jumpers and empty boards
2026-10-06 feat(editor): add live IEC circuit schematic preview
2026-10-06 feat(firmware): add ESP32 smart component controller
2026-10-06 feat: smart capsules in fixed slots, with separate bank nodes
    Add the five passive smart capsules (pulse, voltmeter, ammeter, logic gate,
    1-bit memory) to the teacher app and the validator. A capsule is a 3-pin
    piece (P1/P2/P3 on columns a..a+2) with a config, and only fits the six PCB
    slots (columns 1-3/5-7/9-11 of row 1 of bank A and row 12 of bank B); the
    ammeter works in slot 2 only.
    The validator matches capsule wiring and config and reports wrong_config.
    The app simulates readings, gates, memory and P3-driven loads (static DC).
    Bank A and bank B are now separate nodes, as in PCB v0.4.
2026-10-07 feat(tests): enhance test coverage for lesson steps and board validation
2026-10-07 Improve circuit editor workflow
2026-10-07 feat(app): lesson validator URL and mascot mouth synced to the tutor voice
    "Testar" opens /sandbox/licao/<lesson id>, so the lesson validator can be
    linked and reloaded; the sandbox modes are routes. The player only mounts on
    that tab, so it no longer validates or talks while hidden. The mascot's mouth
    moves while the voice is playing, falling back to the length timer without audio.
2026-10-07 fix(app): tutor voice no longer plays every line twice under StrictMode
    say() returns a cancel function used as the useSay effect cleanup, so the
    throwaway first mount in dev drops its lines before the queue is built.
2026-10-10 docs(electronics): perfboard fallback build plan with checkpoints
    Modular 22-node perfboard version of the bench (6 node modules, power,
    smart and matrix boards), built in checkpoints CP00-CP09 without rework.
    Adds the MAIN PCBv2 schematic and the netlist extractor used as reference.
2026-10-10 feat(electronics): tscircuit drawing of checkpoint 1 (module A1)
    Code-drawn module A1: 28 x 38-hole board, 4 nodes x 6 pogo pins with
    straps, capsule service contacts, smart-position resistors and the two
    IDC 2x5 cable headers, plus schematic/PCB/3D snapshots.
2026-10-10 docs(electronics): record CP01 product decisions
    Flat capsule pads on pogo pins, modules screwed on standoffs, central
    boards inside the bench, pogo size still open.
2026-10-10 feat(electronics): CP00 first-light checkpoint and drawing guidelines
    - eletronics/guidelines.md: 100 x 100 mm default perfboard, cut before
    soldering, wires-not-labels inside a board, perfboard-like drawings.
    - CP00: module A1 columns + ESP32 carrier from one board; the ESP32
    powers the battery columns through Dupont jumpers.
    - Shared tscircuit perfboard helpers (hole grid, coloured wires, IDC).
    - Canvas renderer patch for the PCB viewer.
    - Notes that series circuits can't fit the column geometry.
2026-10-10 docs(electronics): first draft of perfboard fallback plan and PCBv2 analysis
2026-10-11 feat(electronics): CP00 field guide PDFs in Typst (phone and desktop)
    Phone (92 mm, one tall page per group) and desktop (16:9) guides built from
    the assembly catalog: top and mirrored-bottom perfboard views with lane-offset
    wires and non-overlapping labels, breadboard view, full schematic per group,
    component types, pin maps, cut lists, and step checklists.
2026-10-11 feat(electronics): perfboard assembly redesign, per-checkpoint docs and cleaner schematics
    Adds the CP00-CP36 checkpoint docs, the tscircuit assembly app and design
    catalog, and schematic cleanup: net-label stubs instead of routed wires,
    per-phase local schematics, wider card layout, and stripping of connector
    part numbers from every generated schematic.
2026-10-11 feat(electronics): evaluate four-board hybrid perfboard design
2026-10-12 feat(electronics): revision 7 testable perfboards
    Same four boards, functional parts, nets and phases as revision 6; wiring and
    test aids only. Spatial wire chains, ground bus bars with sleeve flags, a
    standard 1x8 probe header, status LEDs, designated test pads, seven fail-safe
    removable links, crossing budgets, a firmware self-test contract and
    bring-up pass-table PDFs. Revision 5/6 and the shared model are untouched.
2026-10-12 Add revision 8 contact board simplification preview
2026-10-12 Improve revision 8 contact board preview
2026-10-12 Arrange revision8 protected rail loads
2026-10-12 Add revision8 complete system schematic package
2026-10-12 Add revision8 power board layouts and editor
2026-10-12 feat(electronics): revision 9 minimal power board on stripboard
    One 12 V input, two buck modules and a switched, current-limited student
    rail on stripboard: 23 parts, 64 joints, 7 cuts, 3 links, no crossings.
    tscircuit schematic, top/underside drawings, build order, BOM and cut/link
    tables, with netlist, connectivity and fault-injection checks. Gives up the
    voltage guards, the 12 mA trip and the fault latch (see README). Software
    checks only; nothing built or measured.
2026-10-20 feat(stripboard): enhance connectivity and SVG rendering for revision 9
    - Updated connectivity logic to utilize copper groups for union operations.
    - Removed redundant cut checks and improved design validation.
    - Enhanced SVG rendering to include off-board component guides and improved layout.
    - Adjusted color definitions and part fill styles for better visual representation.
    feat(oled_tests): add multiple OLED testing sketches
    - Introduced tests for two, three, and shared-SCL OLED configurations.
    - Implemented phrase swapping and animation features across multiple screens.
    - Provided detailed wiring instructions and setup guidance for each test.
    - Ensured compatibility with ESP32 and incl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
2026-10-21 feat: add D3 deliverable media, smart-perfboard and pi-controls designs, firmware tests
    - docs/deliverables/d3: electronics, mechanics, software and Notion media
    - tscircuit: smart-perfboard and pi-controls designs with build scripts
    - firmware/component_testing: joystick, perfboard stage 1, UART Pi and voltage pogo tests
    - .gitignore: ignore d3 planning PDFs
2026-10-26 Add D3 evidence and compact smart-perfboard schematic
2026-10-29 feat(bench): hamster mascot and camera board view
    - Pixel-art hamster tutor (scripts/draw-hamster.py) replaces the fox on the
    bench, the lesson player and the sandbox; the fox sprite stays available.
    - Camera board view screen (SFR17.1) in the single-screen manager: live
    camera picture with the 11x6 bench grid and four corner marks, camera
    picker, pt-BR error messages; opened from home and the student screen,
    Esc returns to the previous screen.
2026-10-29 docs: consolidate simplified routing board proposal
2026-10-30 Add guided-lesson curriculum and teacher authoring upgrades; remove the color-coded resistor
    Curriculum: 20 lessons (1-10, guided and challenge versions) and 5 modules, with explanations,
    illustrations, predict/observe steps, simulated labs, faulty starting benches and teacher notes.
    A repeatable, non-destructive seed script and an end-to-end bench-delivery check ship with it.
    App: lesson v4 (explain/experiment steps, start/settings/notes/tags), a simulated lab (loose
    contact, short-circuit cut-out, capacitor fade, buzzer), node explorer, editor support for the new
    step types, unsaved-change warnings, duplicate that drops example tags, curriculum-ordered library.
    Validator: potentiometer s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
2026-11-05 feat(site): schematic mode, bench-fit screens, curriculum sync and UI polish
    - Schematic mode: draw and wire symbols and the protoboard follows
    (SchematicEditor, schematicPlace + tests). Available in the editor and
    the sandbox through the Protoboard/Esquema tabs.
    - Bench: every screen fits the 1024x600 LCD without scrolling (FitStage,
    lab-step grid).
    - Lesson validator: shows the bench's own screens, scaled inside a monitor
    frame, with a step carousel and the teacher's controls outside.
    - Sandbox: the protoboard stays fixed on the left half; the tutor, power
    switch, checks and parts are on the right and scroll on their own.
    - Curriculum modules are imported automatically for every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
2026-11-05 feat(teacher-app): tabs, dashboard home, guided send flow and class progress
    - Bottom tabs (Início, Turmas, Módulos, Bancada) with icons (@expo/vector-icons).
    - Início is a dashboard:
    - the bench's state and loaded module;
    - progress waiting to be synced, with one button to fetch and send it;
    - the main action, "Levar aula à bancada".
    - "Levar aula à bancada" is a guided flow: connect the bench → class → module
    → review and send, then a success screen.
    - Turma shows a summary (students, average progress and score) and each
    student's tag, progress and best score. It uses /dashboard on the server
    and progress_events through Neon; migration 0004 grants the phone read
    ac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
2026-11-05 feat(bench): board follows the camera, step-aware tray and physical controls
    Vision (brought from f596c8f on frontend_ted_tronics):
    - bench_service/vision.py runs the visao pipeline (a camera or a looped photo).
    - New routes: /vision/state, /vision/frame.jpg and /vision/recalibrate.
    - New CLI flags --camera and --vision-image, and a `vision` extra.
    - Tests cover the mapping, the routes and a real photo.
    Bench lesson screens:
    - With the camera on, the screen board mirrors the real protoboard
    (read-only). The lesson bar shows the camera status; without a camera the
    board falls back to on-screen dragging (demo).
    - The tray lists the parts the current step asks for and greys out the rest.
    -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
2026-11-05 feat: guided tours on the site, the bench and the teacher app
    Each screen has a guided tour. It dims the page, highlights one control at a time
    and explains it in a card with Pular / Voltar / Próximo. It opens once on the
    first visit and again from a ? button in the top corner.
    - Site:
    - one tour per page (Lições, Módulos, Turmas, Turma, Alunos, Painel,
    Editor, Sandbox, Validador);
    - the ? sits in the header;
    - arrows, Enter and Esc work.
    - Bench:
    - tours for the tag screen, the student's home and the first board step;
    - the joystick drives them (arrows/OK; Voltar skips) and can also reach
    the ? in the header;
    - the lesson tour waits for the first build screen.
    - Tea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
2026-11-08 feat(bench): game-style controls over the ESP32 serial link
    - ESP32 firmware (firmware/esp32/bench_controls): KY-023 joystick on GPIO34/35/27 and an
    optional Energizar button; one KEY line per steady push over UART2 and USB, PING/PONG link check
    - Bench service reads the controls serial port (--controls COM4 or /dev/serial0) and streams
    presses to the screen on ws://<bench>:8765/controls; overall ranking endpoint
    - Bench screen played like a game (pad.ts): screen-drawn selection, up/right forward,
    down/left back, joystick click confirms, Enter energizes, long press opens a game menu
    (sound, help, ranking, camera, leave)
    - Student title screen (Comecar / Continuar / Sair), browsable l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
2026-11-09 feat(bench): Bluetooth module send that survives the Pi's link and clearer bench errors
    Teacher app (BLE):
    - Frames sized to the negotiated MTU (requests 517) and high connection priority.
    - Reply timeout starts after the last frame; BLE write errors become Portuguese messages.
    - A stalled write (8 s) reconnects and rewrites the same frame; the bench keeps the partial
    message and the unlock across connections, so the send resumes where it stopped.
    - When PACKAGE_OK is lost, STATUS confirms whether the bench loaded the version.
    - Send screen shows progress: download, percent sent, reconnecting, waiting for the bench.
    Bench:
    - HELLO refusals say why: missing secret, secret different from th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
2026-11-09 feat(vision): current-board profile with manual calibration, wired into the bench service
    visao: PipelineAtual reads the half-populated kit board conservatively
    (unrecognised positions are unknown, not empty), with corner calibration,
    white 3-mark resistor and blue-body detection, JSON heartbeat output and
    fixtures. Bench service: VisionSource defaults to the current profile
    (--vision-profile legacy for the full board, --calibration FILE), reports
    untyped pieces as unrecognised and exposes profile/partial in /vision/state.
2026-11-09 feat(curriculum): guided lesson with battery, 1 kΩ resistor and LED
2026-11-09 fix(vision): throttle failed auto-calibration retries and show recalibration progress
2026-11-09 feat(camera): diagnostics panel with frame rate, freshness, calibration and stability; fix recalibrating flag never clearing
2026-11-09 feat(vision): reference-photo calibration and more tolerant piece detectors for live frames
    Camera updates made after testing with live frames (visao/fixtures/current/live-2026-11-09).
    Calibration (visao/calibracao.py):
    - New calibra_por_referencia(): when the four-edge lattice fit cannot number the
    grid (an edge is hidden), match SIFT features of the frame against the reference
    photo fixtures/current/frame-00.jpg, take a RANSAC homography and compose it with
    the known reference grid homography. The result is only a proposal: it needs >=20
    inliers spread over >=5.5 columns and >=4 rows (a cluster on one movable piece
    cannot anchor the board), a convex projected quad, and must stil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
2026-11-09 feat(bench): standalone /camera-debug page for the Raspberry Pi service
    GET /camera-debug serves a self-contained diagnostics page (no dependency on the built
    bench UI, no external resources, Cache-Control: no-store) that polls the service:
    - /vision/frame.jpg every 0.5 s (processed frame with the grid overlay) with
    success/failure status;
    - /vision/state every 1 s: reason, running, recalibrating, profile, fps, frame age,
    frame size, calibration (manual/automatic), frames to confirm, pieces confirming,
    version, recognised and unrecognised pieces, and the raw JSON;
    - a Recalibrar button (POST /vision/recalibrate).
    Values are written with textContent, never as HTML. Test added in
    bench/s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
2026-11-09 feat(firmware): OLED SDA map for the soldered board, diagnostic and standalone sketches
    Soldered-board map: the OLED0..5 SDA pins are GPIO 4,16,18,17,19,21 (D4, RX2, D18, TX2,
    D19, D21), replacing the old order 4,21,19,18,17,16 in perfboard_stage1_test. The
    README documents the table and warns that older PDFs/sketches show the previous
    order; the startup message and the status command now print the map the code uses
    (printPinMap). The line reader moved to LineReader.h.
    New sketches:
    - perfboard_oled_debug: OLED-only diagnostic over USB for blank screens (no joystick,
    NFC, UART or pulse outputs).
    - perfboard_standalone_test: standalone board test sketch with its README.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
2026-11-09 docs(electronics): perfboard wiring guide, single-face PCB V2 candidate and D4 media
    - routing-next/guia-perfboard: perfboard wiring guide (generated PDF plus generate.py,
    parts.csv, pins.csv, assets and per-path experiments).
    - routing-next/pcb-singleface-v2: single-face PCB candidate V2 (30/10/2026), 100 x 200 mm,
    two horizontal MT8816, two 74HC595, HCT14 and 59 insulated wire bridges on dedicated
    islands. README, review PDF, assembly audit and verification.json. It is a complete
    software candidate: physical proof and energised acceptance are still pending, and it
    is not a bridge-free board.
    - routing-next/README.md links the V2 candidate.
    - docs/deliverables/d4_images: Deliverab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
2026-11-09 docs: AI review round 2 notes, PCB style check and curriculum count
    - AI/codex-fix-brief.md and AI/reviews/round2-{student,teacher}.md: briefs and reports
    for the second review round of the teacher app and curriculum.
    - AI/_common-environment.md: round-2 rules (append findings as you go, never use
    pkill/killall, re-check round-1 Major findings as FIXED/NOT FIXED) and the list of
    changes since round 1.
    - checks/check-pcb-style/pcb.svg: sample used by the PCB drawing-style check.
    - CLAUDE.md: the curriculum now has 21 lessons (new guided lesson 03-guiada-1k:
    battery + 1 kΩ resistor + LED).
2026-11-10 fix(bench): load modules sent over Bluetooth even when frames arrive as long writes
    The bench answered STATUS but never loaded the module: frames bigger than the link's
    real MTU went out as long (prepared) writes, and bless hands each piece to the bench as a
    whole value, ignoring the offset, so the message was never rebuilt and nothing was logged.
    - Bench (BLE only): a piece without a frame header is appended to the previous frame, and
    a message whose JSON is still cut waits for the next piece. Logs joined pieces and
    invalid frames. Checked with the 20 real lessons of a module cut in 182/100/20-byte pieces.
    - App: frames capped at DEFAULT_CHUNK (150) and shrunk to a smaller negotiated M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
2026-11-10 fix(bench): joystick adjusts the potentiometer bar; quiz answers no longer flash red
    - With the resistance slider selected, joystick ← / → move it one notch (10 presses end to end)
    instead of changing step; the bar's label tells how on the bench. React hears the change through
    the native value setter plus an input event.
    - A quiz answer checked by the validator showed the error color while the verdict was pending,
    then turned green. While checking, the pick is neutral and the options are locked.
2026-11-10 test(vision): save current bench camera fixtures
2026-11-11 wip: live bench vision, Raspberry Pi update script, firmware tests and app changes
    Commits the working-tree changes that were in progress on main: marker-based
    calibration and clipped-grid rejection, buzzer/smart/LED kit detectors, bench
    controls and service updates, Raspberry Pi bundle/update script, perfboard
    firmware test sketches, teacher app and graph validator changes, and the saved
    camera fixtures. Some tests (tests/test_resistor_atual.py) were already failing
    on HEAD before this commit.
2026-11-11 wip(vision): read resistor bands at a lower exposure; remove the 1 kΩ assumption
    Adds visao/bandas_resistor.py (decoder for 220 Ω / 470 Ω / 1 kΩ from colour bands),
    band values and body signatures in PipelineAtual, and a service-side exposure
    switch in bench_service/vision.py. Unread blue bodies stay unknown. Removes the
    outdated Nov 9 white-resistor tests and adds decoder, pipeline and exposure tests.
    Saves bench stills (normal frames and exposure series) under
    visao/fixtures/current/bench-2026-11-11.
    NOT yet reliable live: the exposure restore after a band read does not return to
    the normal exposure on this camera, and buzzer/LED/1 kΩ are missing in live state.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
2026-11-11 test(vision): add offline service replay baseline
    Record the initial Nov 11 normal-frame publication snapshot and score saved-picture replays without opening a camera.
2026-11-11 fix(vision): leave unread resistor values unknown
    Keep generic resistor detections as unknown instead of assigning 220 ohms without band evidence.
2026-11-11 fix(vision): restore commanded camera exposure
    Use the stored provisional exposure rather than stale camera readback, and fail closed when restoration does not match the reference frame. Verify with fake cameras and saved-picture replay.
2026-11-11 fix(vision): confirm removals by frame count
    Require six consecutive fresh empty observations and sort published held pieces. Update the normal snapshot for the intentional ordering change.
2026-11-11 fix(vision): count frames for band state
    Make band retry, re-verification, body expiry and stale observations independent of processing speed. Update the replay snapshot for the intentional retry schedule.
2026-11-11 fix(vision): keep timeout view out of processing
    Compare new pieces against stored state so frame processing speed cannot trigger the public stale-frame timeout during version updates.
2026-11-11 feat(vision): record original MJPEG frames for replay
    Add an opt-in recorder with per-frame commanded controls, reject decoded or overwritten recordings, and replay recorded exposure sequences. Exercise with fake captures and saved JPEGs only.
2026-11-11 test(vision): expect unread resistor to remain unknown
    Update the service integration test to match the band-evidence requirement and validate the remaining known pieces.
2026-11-11 feat(vision): configure camera controls explicitly
    Load explicit controls from JSON and add a future on-bench exposure sweep. Test control commands and calibration with fakes; live settings remain unverified.
2026-11-11 test(vision): compare replay bytes across processes
    Add 20-run in-process and independent-process checks with distinct hash seeds. The full 35-frame check remains a separately runnable long test.
2026-11-11 fix(vision): normalize white jumper brightness
    Use neutral socket brightness for the white mask and retain valid-height silhouettes. Verify both saved exposure series and preserve the normal snapshot.
2026-11-11 test(vision): evaluate stationary board reference
    Add an independently validated stationary-feature grid proposal and reject clipped, rotated, and blank saved pictures. The proposal is not yet used by the pipeline.
2026-11-11 fix(vision): revalidate stationary reference tracking
    Use the distributed stationary-feature proposal with existing socket and clipping validation, falling back when the anchor fails. Update the snapshot for the confirming-count change.
2026-11-11 fix(vision): use anchored distributed socket support
    Permit independently revalidated stationary references to support occluded pieces only with distributed socket matches and at least 17 inliers. Update the normal replay snapshot for newly supported pieces.
2026-11-11 fix(vision): invalidate held unread resistor values
    A fresh unknown body supersedes a held resistor value, preventing an old reading from being attributed to an unverified replacement.
2026-11-12 fix(vision): detect the black smart housing instead of the blue strip
    smart_kit anchored on the blue OLED strip, whose width and brightness change with exposure and whose glass reflection gave a false row-4 detection. It now matches the black housing as a template at each grid position: 0.80-0.87 on every normal-exposure picture with the module (row 5, columns 4-6), 0.27 or less on every other saved picture.
    Correct expected.json to row 5, regenerate the normal replay snapshot, add detector tests, keep the signature crop fix, and add the 30-frame replay target as an expected failure (25 of 50 frames today).
2026-11-12 fix(vision): tolerate a camera with no auto white-balance switch
    The bench's USB camera reports CAP_PROP_AUTO_WB as unsupported (readback -1, set refused), so the explicit-settings code refused to start the service at all. Treat a refused auto-WB or autofocus switch as non-fatal only when its readback is -1; every other refused control, and a refused supported switch, still fails closed.
2026-11-12 fix(vision): record original MJPEG with CONVERT_RGB=0; add live frames 2026-11-12
    OpenCV 5.0 on the bench USB camera refuses CAP_PROP_FORMAT=-1 but returns the original MJPEG packet with CAP_PROP_CONVERT_RGB=0 (verified live). Add 32 evenly spaced frames of the first live recording (normal 1300 and band exposures 1000/1100, 1280x720) with their manifest, and an expected.json assumed equal to the Nov 11 arrangement.
2026-11-12 fix(vision): normal exposure 1600, no band exposure switch, dim-frame blue bodies
    Live sweep of the bench camera (2026-11-12, 1280x720, 21 frames saved): at the previous normal exposure 1300 the frame is dark (mean 59) and one resistor misreads; at 1600 (mean 68.5) all three resistors decode from a normal frame; from 1900 the bands blow out. Set DEFAULT_EXPOSURE to 1600 and read bands from consecutive normal frames (BAND_EXPOSURES empty; the switching path is kept and tested). The replay camera follows the default and a replay folder can declare its band exposures (the Nov 11 folder declares 1000/1100).
    The blue holder detectors also run a relaxed brightness pass (union with the strict one)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
2026-11-12 test(vision): raw live frames of a 1 kohm resistor at C3:8-9 that does not decode
    Eight original MJPEG frames at exposure 1600 on a cleaned board with only the battery and the resistor. The band reader finds two warm bands 41 px apart (a 1 kohm expects two 100+ px apart with a dark middle band) and refuses; the physical band colours are still to be confirmed.
2026-11-12 fix(vision): reverse lesson rows and constrain six smart slots
    Intentionally reverse publication snapshots within each bank. Keep physical calibration coordinates and convert removal checks back to them. Require housing and socket evidence at allowed smart footprints.
2026-11-12 fix(bench): reconnect the same persistent USB camera
    Pin numeric selections to udev identity or port links. Clear stale vision state and reapply camera settings on reconnect; split recording segments safely. Cover recovery with fake cameras and document measured limits.
2026-11-12 feat(vision): log why a read resistor value is held back or lost
    Warning-level, once per change of reason per position: appearance signature below the threshold, body unseen for more than 3 frames, re-read that did not decode in two frames or conflicted, and a value kept but not published because too few sockets are visible around it.
2026-11-12 fix(bench): confirm component removal in two frames
2026-11-12 fix(vision): confirm observations in two frames
    Intentionally update the saved-picture publication snapshot for earlier component and empty-socket confirmation.
2026-11-12 fix(curriculum): one name for the battery + 1 kΩ + LED test lesson and its module
    The lesson was "Lição 3 — Bateria, resistor de 1 kΩ e LED (guiada)" on the site while its module,
    which the phone app and the bench show, was "Teste — Bateria, resistor de 1 kΩ e LED". Both are now
    "Teste — Bateria, resistor de 1 kΩ e LED" (also in Trilha 1). The copies already on Neon were renamed.
2026-11-14 feat(board): light the energized path like powered dust, only between the legs
    The protoboard used to glow a whole track green and draw arrows end to end. Now the
    simulator passes the direction of the current through each piece (CircuitTrail.flow),
    and the board lights only the stretch from the leg the current enters by to the leg
    it leaves by: a glowing red line with a spark running toward −. Joined tracks without
    power get arrows only between their legs; a lone leg no longer gets an arrow.
    Shared by the bench screen and the teacher site (editor, sandbox, player).
